tfsvh69-blip/Nav2_car/README.md

# carcar 四轮麦克纳姆导航巡检小车

ROS 2 Humble / Ubuntu 22.04项目。当前使用小泽WiFi覆盖内的平板随行建图：开机自动登录后网页待命，平板新建/续建、摇杆遥控、成对保存和结束任务；RGB为可选辅助，地图使用激光＋纯轮式里程计。相机到平板短时通路已有现场确认；新流程触控、真实场地建图、停车距离、重启自启及完整深度导航仍待验收。

长期目标是单层巡检：导航时固定相机角度，停车后俯仰拍RGB、本地保存并排队上传。第一版不做门状态或危险识别；[巡检应用](src/carcar_inspection/README.md)已新增网页点位示教、固定单角度采集、车端任务与最终停车代码，APP-001-R1先离线验证、默认配置模式，尚未实机验收，云端协议与上传程序待实现。

## 当前入口

| 入口 | 唯一职责 |
|---|---|
| [文档索引](docs/文档索引.md) | 当前与历史入口 |
| [项目现状与路线](docs/项目现状与路线.md) | 最新架构、开发阶段、关键决策与下一步 |
| [操作手册](docs/操作手册.md) | 有效构建、启动、观察、停止和恢复；历史专题保留编号索引 |
| [硬件台账](docs/硬件台账.md) | 实物、接线、尺度/标定与待确认事实 |
| [测试记录](docs/测试记录.md) | 当前结论与稳定编号、历史原始证据链接 |
| [工业级优化建议与学习路线](docs/工业级优化建议与学习路线.md) | 长期取舍与学习验收 |
| [归档索引](docs/archive/README.md) | 历史专题、失败过程、停用草稿与整理原文 |

平板建图使用[手册33节](docs/操作手册.md#33-平板随行建图nav-017)，深度/STVL使用[31节](docs/操作手册.md#31-stvl-深度导航主线nav-016)，主机RViz使用[19节](docs/操作手册.md#19-ubuntu-主机-rviz-联调)。完整命令不在README重复维护。

网页巡检与分步舵机确认使用[手册35节](docs/操作手册.md#35-网页巡检与逐步舵机示教app-001-r1)，独立端口8081，不替换8080建图入口。默认不启动或控制硬件；软件测试和现场结果分别登记。

## 维护

[项目清理技能](.agents/skills/project-cleanup/SKILL.md)默认先检查点和报告，再按已批准范围小批整理。2026-10-14[执行结果](docs/archive/2026-10-14-瘦身执行结果.md)记录前后指标与测试。现有功能、底层资产、地图/参数/标定和原始实验日志保留；瘦身批次没有自动提交或修改系统配置。平板用户服务变更另行登记。

系统级Ubuntu/Jetson变更登记桌面`/home/jetson/Desktop/系统配置维护记录.md`；瘦身阶段只整理项目文档与小缓存，后续平板用户服务独立登记。原README内容保留于[整理原文](docs/archive/项目README原文_20261014.md)。
