tfsvh69-blip/Nav2_car/docs/操作手册.md

# 操作手册

最后更新：2026-10-14。当前优先使用[第33节：小泽WiFi平板建图](#33-平板随行建图nav-017)。机器/地址以现场读回为准；无新移动或停车验收结论。

当前完整流程：19节主机RViz、31节有效STVL、33节平板建图、34节维护。其余底层/旧实验专题保留原编号入口，完整命令和安全条件迁入[操作专题归档](archive/操作专题原文_20261014.md)，不要把历史候选当当前默认。测试结果只见[测试记录](测试记录.md)。

## 1. 四路编码器 A/B 对调后的连续键盘控制（MOTOR-015）

完整专题与安全/停止步骤：[归档原文](archive/操作专题原文_20261014.md#1-四路编码器-ab-对调后的连续键盘控制motor-015)。原测试资产和参数保留；是否适用当前实车以路线和台账为准。

## 2. D435 低负载预览

完整专题与安全/停止步骤：[归档原文](archive/操作专题原文_20261014.md#2-d435-低负载预览)。原测试资产和参数保留；是否适用当前实车以路线和台账为准。

## 3. 整车模型离线检查

完整专题与安全/停止步骤：[归档原文](archive/操作专题原文_20261014.md#3-整车模型离线检查)。原测试资产和参数保留；是否适用当前实车以路线和台账为准。

## 4. 雷达

完整专题与安全/停止步骤：[归档原文](archive/操作专题原文_20261014.md#4-雷达)。原测试资产和参数保留；是否适用当前实车以路线和台账为准。

## 5. IMU 静止与人工旋转检查（IMU-001/IMU-002）

完整专题与安全/停止步骤：[归档原文](archive/操作专题原文_20261014.md#5-imu-静止与人工旋转检查imu-001imu-002)。原测试资产和参数保留；是否适用当前实车以路线和台账为准。

## 6. SLAM Toolbox 建图链路冒烟验证（NAV-001）

完整专题与安全/停止步骤：[归档原文](archive/操作专题原文_20261014.md#6-slam-toolbox-建图链路冒烟验证nav-001)。原测试资产和参数保留；是否适用当前实车以路线和台账为准。

## 7. 低速受控运动建图、回访一致性与地图保存验证（NAV-002）

完整专题与安全/停止步骤：[归档原文](archive/操作专题原文_20261014.md#7-低速受控运动建图回访一致性与地图保存验证nav-002)。原测试资产和参数保留；是否适用当前实车以路线和台账为准。

## 8. 静态地图定位与低速单点导航（NAV-003）

完整专题与安全/停止步骤：[归档原文](archive/操作专题原文_20261014.md#8-静态地图定位与低速单点导航nav-003)。原测试资产和参数保留；是否适用当前实车以路线和台账为准。

## 9. NAV-004：扩大建图与新地图重载

完整专题与安全/停止步骤：[归档原文](archive/操作专题原文_20261014.md#9-nav-004扩大建图与新地图重载)。原测试资产和参数保留；是否适用当前实车以路线和台账为准。

## 10. NAV-005：全局膨胀对照与雷达错位诊断

完整专题与安全/停止步骤：[归档原文](archive/操作专题原文_20261014.md#10-nav-005全局膨胀对照与雷达错位诊断)。原测试资产和参数保留；是否适用当前实车以路线和台账为准。

## 11. NAV-006：Groot BT 日志桥接与状态观察

完整专题与安全/停止步骤：[归档原文](archive/操作专题原文_20261014.md#11-nav-006groot-bt-日志桥接与状态观察)。原测试资产和参数保留；是否适用当前实车以路线和台账为准。

## 12. NAV-007/NAV-010/NAV-011：实验定位恢复、垃圾桶绕障与终端状态会话录包

完整专题与安全/停止步骤：[归档原文](archive/操作专题原文_20261014.md#12-nav-007nav-010nav-011实验定位恢复垃圾桶绕障与终端状态会话录包)。原测试资产和参数保留；是否适用当前实车以路线和台账为准。

## 13. 导航受阻目标排查与提取命令 (NAV-008 / NAV-011 诊断工具)

完整专题与安全/停止步骤：[归档原文](archive/操作专题原文_20261014.md#13-导航受阻目标排查与提取命令-nav-008--nav-011-诊断工具)。原测试资产和参数保留；是否适用当前实车以路线和台账为准。

## 14. NAV-012：墙角绕行、进展停滞识别与有序脱困实验 (套餐 B + 进阶恢复)

完整专题与安全/停止步骤：[归档原文](archive/操作专题原文_20261014.md#14-nav-012墙角绕行进展停滞识别与有序脱困实验-套餐-b--进阶恢复)。原测试资产和参数保留；是否适用当前实车以路线和台账为准。

## 15. Rosmaster 板载声光指示器测试（DRV-004）

完整专题与安全/停止步骤：[归档原文](archive/操作专题原文_20261014.md#15-rosmaster-板载声光指示器测试drv-004)。原测试资产和参数保留；是否适用当前实车以路线和台账为准。

## 16. 导航状态观测与多维停车阻断归因诊断（NAV-013）

完整专题与安全/停止步骤：[归档原文](archive/操作专题原文_20261014.md#16-导航状态观测与多维停车阻断归因诊断nav-013)。原测试资产和参数保留；是否适用当前实车以路线和台账为准。

## 17. 导航声光提示与停车原因诊断系统（NAV-014）

完整专题与安全/停止步骤：[归档原文](archive/操作专题原文_20261014.md#17-导航声光提示与停车原因诊断系统nav-014)。原测试资产和参数保留；是否适用当前实车以路线和台账为准。

## 18. NAV-012 回调、恢复监督与速度联锁修复

完整专题与安全/停止步骤：[归档原文](archive/操作专题原文_20261014.md#18-nav-012-回调恢复监督与速度联锁修复)。原测试资产和参数保留；是否适用当前实车以路线和台账为准。

## 19. Ubuntu 主机 RViz 联调

用途：车上继续跑底盘、雷达、定位和导航；Ubuntu 22.04 电脑只显示地图并点初始位姿/目标。不改固件、不改串口、不在 Jetson 上启动 `rviz2`。V2.0 是主机改为 Ubuntu 开发之前的最后一次快照；此后按本节联调。

RViz 配置可依据当前话题、QoS、性能和诊断需求直接优化，无需在每次修改前逐项征求确认；每次交付必须列出实际显示组件、话题、`Fixed Frame`、QoS 和关键视觉参数，便于现场核对。项目内 `navigation_lite.rviz` 是当前配置真源，Hao 的 `~/navigation_lite.rviz` 是同步副本。

### 19.0 两台机器与终端分工（2026-10-07 当前台式机已核对）

2026-10-07：用户确认有两台电脑，笔记本hao@bao在公司，当前使用台式机luhao@Hao；本地输出确认hostname=Hao、wlp4s0f0=192.168.5.17/24。此前bao地址192.168.5.36不可达不代表台式机不可用；旧文档将Hao标为Windows/历史入口的说法不适用于当前现场。切换电脑或DHCP变化时，以下在眼前Ubuntu电脑本地终端执行，不先SSH；只查看机器名和IPv4地址，不修改网络或小车硬件。预期看到当前主机名及局域网地址，忽略lo及Docker网桥；多地址时保留完整输出供核对。命令立即退出，异常Ctrl+C，无需回滚。

```bash
cd "$HOME"
hostname
ip -4 -br address
```

Cursor的项目工作区和车上节点在 **Jetson**，用户当前坐在台式机 **Hao** 前面。不要把Hao本机终端当成已经登录上车。

| 角色 | 用户 / 主机名 | 当前地址 | 日常干什么 |
|---|---|---|---|
| 车 | `jetson@xiaozhu` | `192.168.5.11` | 底盘、雷达、定位、导航；不要开 `rviz2` |
| 当前联调台式机 | `luhao@Hao` | `192.168.5.17/24`（2026-10-07本地读取） | 当前Ubuntu开发/RViz主机，DHCP变化时重新核对 |
| 笔记本（本轮不在现场） | `hao@bao` | 历史 `192.168.5.36`，当前未核对 | 用户确认在公司，不使用旧地址推断当前显示状态 |
| 图形会话 | `Hao` 本地X11桌面 | 本轮读到 `DISPLAY=:1`、`XAUTHORITY=/run/user/1000/gdm/Xauthority` | RViz在用户已登录桌面运行，不在Jetson启动；不要沿用bao的:0 |
| 车上→当前电脑 | 本轮免密SSH已连通 | `ssh -i /home/jetson/.ssh/id_ed25519 luhao@192.168.5.17` | 只读核对hostname/IP/RViz，旧渲染结论不代表当前状态 |

Hao 本机要跑车上节点时，每个窗口先：

```bash
ssh jetson@192.168.5.11
```

登录后再 `cd /home/jetson/luhao/my_nav_carcar` 并按第 12.4 / 18.3 节启动。RViz 窗口**不要** SSH。

| Hao 本机窗口 | 先做什么 | 再跑什么 |
|---|---|---|
| 1～5 | `ssh jetson@192.168.5.11` | 第 12.4 节终端 1～5（底盘、雷达、实验定位、实验导航、诊断） |
| 6 | 不要 SSH | [第 19.4 节](#194-电脑上确认连通并打开轻量-rviz) 本机轻量 RViz |

### 19.1 必须对齐的环境

| 项目 | 车上现在的值 | 电脑上也要一样 |
|---|---|---|
| 系统 | Ubuntu 22.04 | Ubuntu 22.04 |
| ROS | Humble | Humble |
| Wi‑Fi | `小泽` | 同一 Wi‑Fi，不要用手机热点另一张网 |
| 地址 | `192.168.5.11`（`xiaozhu`） | `192.168.5.36`（`bao`，以当时 `ip a` 为准） |
| ROS 域 | `ROS_DOMAIN_ID=31` | `export ROS_DOMAIN_ID=31` |
| 本机隔离 | `ROS_LOCALHOST_ONLY=0` | 同样设为 0，或干脆不设 |
| DDS | 默认 Fast DDS | 先不要改 `RMW_IMPLEMENTATION` |

车上 `~/.bashrc` 已写入域号 31 和 `ROS_LOCALHOST_ONLY=0`，无需再改系统服务。电脑每个新终端先：

```bash
source /opt/ros/humble/setup.bash
export ROS_DOMAIN_ID=31
export ROS_LOCALHOST_ONLY=0
```

可写进电脑的 `~/.bashrc`，避免忘。域号不一致时，`ros2 topic list` 是空的。

### 19.2 电脑上最少安装

不要一上来克隆整车工程。先装桌面版 Humble 和 RViz：

```bash
sudo apt update
sudo apt install ros-humble-desktop ros-humble-rviz2 ros-humble-nav2-msgs
```

`ros-humble-desktop` 已含 RViz、常用消息和 TF。点目标和看地图够用。

若 `apt` 提示锁被 `unattended-upgr` 占用，等它自己结束后再装。不要删 `/var/lib/dpkg/lock-frontend`，也不要 `kill -9`。车上代理没有 Hao 的 sudo，装包由 Hao 本机执行。

### 19.3 车上怎么开（不要再起 RViz）

底盘、雷达、实验导航仍按[第 12.3～12.4 节](archive/操作专题原文_20261014.md#123-实车启动前安全检查)和[第 18.3 节](archive/操作专题原文_20261014.md#183-启动与只读观察)。定位必须显式关闭板上 RViz：

```bash
cd /home/jetson/luhao/my_nav_carcar
source /opt/ros/humble/setup.bash && source install/setup.bash
export ROS_DOMAIN_ID=31
export ROS_LOCALHOST_ONLY=0
ros2 launch carcar_navigation localization_experimental.launch.xml \
  map:=$(pwd)/src/carcar_navigation/maps/nav004_20260914_093032.yaml \
  use_rviz:=false
```

Jetson 上不要再开 `rviz2`，也不要用 VNC 看三维窗口。声光、倒车、联锁仍在车上；终端 4 的一行中文摘要仍可在车上或 SSH 里看。

### 19.4 电脑上确认连通并打开轻量 RViz

电脑和车都上电、导航起来后，Hao 上先写 Fast DDS 单播发现（Wi‑Fi 组播对 Nav2 多进程经常只发现到一部分节点）。地址按当时 `ip a` 改；车上仍是 `192.168.5.11`，域 31 对应端口 `15150`：

```bash
cat > ~/fastdds_wifi.xml << 'EOF'
<?xml version="1.0" encoding="UTF-8" ?>
<profiles xmlns="http://www.eprosima.com/XMLSchemas/fastRTPS_Profiles">
  <participant profile_name="wifi_peer" is_default_profile="true">
    <rtps>
      <builtin>
        <initialPeersList>
          <locator>
            <udpv4>
              <address>192.168.5.11</address>
              <port>15150</port>
            </udpv4>
          </locator>
        </initialPeersList>
      </builtin>
    </rtps>
  </participant>
</profiles>
EOF
```

同一台电脑只开一个 `rviz2`。若已经有窗口，先关掉再开。旧的 `ros2` 守护进程会缓存半截图，开之前停掉：

```bash
source /opt/ros/humble/setup.bash
export ROS_DOMAIN_ID=31
export ROS_LOCALHOST_ONLY=0
export FASTRTPS_DEFAULT_PROFILES_FILE=$HOME/fastdds_wifi.xml
ros2 daemon stop
ros2 topic info /map -v
```

这里要看 **Publisher count 是否为 1**（`map_server`）。只看 `ros2 topic list` 不够：本机 RViz 订阅 `/map` 后，列表里也会出现这个名字。再：

```bash
ros2 topic echo /localization_monitor/ready --qos-durability transient_local --once
```

`data: true` 后再点目标。未给 **2D Pose Estimate** 时这里是 `false`，属正常。

首次使用或车模文件缺失时，把轻量配置和车模实体文件拷到电脑。以下命令在 Hao 本机执行，读取 Jetson 工作区并写入 Hao 的 `~/navigation_lite.rviz` 和 `~/ros_overlay/carcar_description/`，不改车上文件、不启动硬件；再次执行会用车上同名文件更新本地副本。异常可按 Ctrl+C 停止，删除这两个本地副本即可恢复到执行前无覆盖的状态：

```bash
mkdir -p ~/ros_overlay/carcar_description
scp jetson@192.168.5.11:/home/jetson/luhao/my_nav_carcar/src/carcar_navigation/rviz/navigation_lite.rviz ~/navigation_lite.rviz
rsync -aL jetson@192.168.5.11:/home/jetson/luhao/my_nav_carcar/install/carcar_description/ ~/ros_overlay/carcar_description/
find ~/ros_overlay/carcar_description/share/carcar_description/meshes -type f -name '*.stl'
```

当前构建产物实测有 10 个 STL，其中包含 `mecanum_wheel_left.stl` 和 `mecanum_wheel_right.stl`；没有列出时不要启动 RViz，先检查复制错误。然后在同一 Hao 本机终端启动 RViz：

```bash
source /opt/ros/humble/setup.bash
export AMENT_PREFIX_PATH=$HOME/ros_overlay/carcar_description:/opt/ros/humble
export FASTRTPS_DEFAULT_PROFILES_FILE=$HOME/fastdds_wifi.xml
export ROS_DOMAIN_ID=31
export ROS_LOCALHOST_ONLY=0
export QT_QPA_PLATFORM=xcb
rviz2 -d ~/navigation_lite.rviz
```

Fixed Frame 为 `map`。预置显示：Grid、Map（`/map`，Reliable + Transient Local）、Global/Local Costmap（Reliable + Transient Local）、LaserScan（`/scan`，Best Effort）、AMCL Pose（Reliable）、Odometry（`/wheel/odometry`，Best Effort）、Global/Local Plan（Reliable）、Footprint、RobotModel（`/robot_description`，Reliable + Transient Local）、精简 TF（不展开全部连杆）。全局路径 `/plan` 使用青色 Billboard、宽 0.04 m；局部路径 `/local_plan` 使用亮黄色 Billboard、宽 0.07 m、`Z=0.08 m`，并只保留最新轨迹。帧率保持 15。车模网格在 Hao 上还需本机有 `carcar_description`（可把车上 `install/carcar_description` 拷到 `~/ros_overlay/carcar_description` 并加入 `AMENT_PREFIX_PATH`）。用 **2D Pose Estimate**（`/initialpose`）和 **2D Goal Pose**（`/goal_pose`）。不要改用完整 `navigation.rviz`。

2026-09-30 当前 `hao@bao` 已用硬件 OpenGL 4.6 短时打开 RViz，无需强制 Mesa 软件渲染；真实 OccupancyGrid 着色仍待实际地图画面确认。2026-09-18 旧 `luhao@Hao` 上的 `llvmpipe` 曾能收到 `259×230` 的 `/map`，但 `indexed_8bit_image` 链接失败，Map / Costmap 橙灯、主视图只剩格子；这是旧电脑的历史显示问题，不能据此判断新电脑地图为空。若新电脑出现相同着色错误，先查话题发布者与消息，再单独处理显卡显示。

### 19.5 若电脑上看不到话题

按这个顺序查：

1. 电脑 `ip a` 是否也是 `192.168.5.x`，能否 `ping 192.168.5.11`
2. 两边 `echo $ROS_DOMAIN_ID` 都是 `31`
3. Hao 是否已加载 `FASTRTPS_DEFAULT_PROFILES_FILE=$HOME/fastdds_wifi.xml`，且 XML 里车上地址、端口与第 19.4 节一致
4. 暂时关掉两边防火墙：`sudo ufw disable`（通了再按需打开）
5. 电脑不要开 VPN
6. 车上 `ros2 node list` 里应有 `/amcl`、`/bt_navigator`，且 **只有一个** `/rviz`；Hao 上 `ps -C rviz2` 只能有一行
7. Map 橙灯且日志有 `GLSL link result`：先核对地图话题有发布者和消息，再按第 19.4 节检查渲染；不能仅凭橙灯判断地图为空

`ros2 topic info /map -v` 的 Publisher count 仍为 0 时，把电脑 IP、该命令输出和 `ps -C rviz2` 发回即可。

### 19.6 远程桌面还能否连车上 GNOME

可以。车上 `x11vnc.service` 仍在监听 `192.168.5.11:5901`，开机自启，密码见桌面文档 [`/home/jetson/Desktop/系统配置维护记录.md`](file:///home/jetson/Desktop/系统配置维护记录.md)。电脑换成 Ubuntu 22.04 后：

```bash
sudo apt install tigervnc-viewer
xtigervncviewer 192.168.5.11:5901
```

或打开自带的 Remmina，协议选 VNC，服务器填 `192.168.5.11:5901`。这只用来看板上桌面、终端或紧急操作。日常点目标用本节的本机轻量 RViz，不要经 VNC 画三维窗口。

### 19.7 旧 `luhao@Hao` 的软件渲染记录（历史，不作当前入口）

以下命令仅记录 2026-09-18 旧 `luhao@Hao` 的实际操作；该地址当前不是 `hao@bao`，不要在新电脑上执行本节旧的远程打开命令。新电脑的静止深度画面用第 19.11 节，常规轻量 RViz 用第 19.4 节。旧机曾因 NVIDIA 内核与用户态不一致而需 Mesa `llvmpipe`，且 OccupancyGrid 着色失败；新电脑已用硬件 OpenGL 4.6 短时打开 RViz，真实栅格着色待现场验证。

从车上检查 Hao 是否能看见车上的地图发布者：

```bash
ssh -o BatchMode=yes -i /home/jetson/.ssh/id_ed25519 luhao@192.168.5.17 \
  'source /opt/ros/humble/setup.bash
   export ROS_DOMAIN_ID=31 ROS_LOCALHOST_ONLY=0
   export FASTRTPS_DEFAULT_PROFILES_FILE=$HOME/fastdds_wifi.xml
   ros2 daemon stop >/dev/null
   ros2 topic info /map -v'
```

Publisher count 应为 1。从车上在 Hao 桌面用软件渲染打开轻量 RViz（会占用 Hao 屏幕；先杀掉旧窗口，只留一个）：

```bash
ssh -o BatchMode=yes -i /home/jetson/.ssh/id_ed25519 luhao@192.168.5.17 \
  'export DISPLAY=:1 XAUTHORITY=/run/user/1000/gdm/Xauthority
   source /opt/ros/humble/setup.bash
   export AMENT_PREFIX_PATH=$HOME/ros_overlay/carcar_description:/opt/ros/humble
   export FASTRTPS_DEFAULT_PROFILES_FILE=$HOME/fastdds_wifi.xml
   export ROS_DOMAIN_ID=31 ROS_LOCALHOST_ONLY=0
   export QT_QPA_PLATFORM=xcb __GLX_VENDOR_LIBRARY_NAME=mesa
   export LIBGL_ALWAYS_SOFTWARE=1 GALLIUM_DRIVER=llvmpipe
   killall -q rviz2 || true
   sleep 1
   nohup rviz2 -d $HOME/navigation_lite.rviz >/tmp/rviz2_lite.log 2>&1 &
   disown'
```

覆盖目录缺失时统一按[第 19.4 节](#194-电脑上确认连通并打开轻量-rviz)从 Hao 本机复制，避免维护第二套复制命令。Hao 本机自己开 RViz 仍用第 19.4 节那组环境变量。重启 Hao 后若 `glxinfo -B` 已是 NVIDIA，可去掉 `LIBGL_*` 四行再试。

### 19.8 日常六终端开发与导航复测（2026-09-20 实测入口）

这是后续开发本车的固定入口：Hao 的 1～5 号终端分别 SSH 到 Jetson，运行底盘、雷达、实验定位、实验导航和只读诊断；6 号终端留在 Hao 本机运行轻量 RViz。2026-09-20 用户现场确认，这套跨机启动、DDS 通信和实体车模加载流程可以完整走通。该结论只确认开发环境与启动链路，不代表 NAV-012-R6 突发障碍绕行已经实车通过。

终端 1 会打开控制板串口，终端 2 会启动雷达电机，终端 4 收到目标后会驱动车轮。开始前清空车周围区域，保持 12 V 电机开关可立即触及；异常运动先断开 12 V，再停止终端。所有 Launch 正常停止均使用一次 `Ctrl+C`，不要直接关闭 SSH 窗口。

#### 19.8.0 代码更新后的构建（仅在代码发生变化时）

用途：在启动硬件前编译当前导航、底盘和 Bringup，并运行导航 C++ 回归。它只写 Jetson 工作区的 `build/`、`install/`、`log/`，不打开串口、不启动雷达和电机。执行前先正常停止旧导航和底盘；异常按 `Ctrl+C`，保留输出排查，构建或测试失败时不要进入实车启动。

先在 Hao 任意终端登录 Jetson：

```bash
ssh jetson@192.168.5.11
```

确认提示符变为 `jetson@xiaozhu` 后执行：

```bash
cd /home/jetson/luhao/my_nav_carcar
conda deactivate 2>/dev/null || true
source /opt/ros/humble/setup.bash
CMAKE_BUILD_PARALLEL_LEVEL=2 colcon build --symlink-install \
  --packages-select carcar_description carcar_navigation carcar_bt_monitor carcar_base carcar_bringup \
  --executor sequential
source install/setup.bash
ROS_DOMAIN_ID=211 ROS_LOCALHOST_ONLY=1 colcon test \
  --packages-select carcar_description carcar_navigation carcar_bt_monitor \
  --executor sequential --event-handlers console_direct+
colcon test-result --test-result-base build/carcar_navigation --verbose
colcon test-result --test-result-base build/carcar_description --verbose
```

预期所有包构建成功且测试无失败。测试域 211 仅作用于该条命令，不用于实车。

#### 19.8.1 第 1～5 号终端共同的 SSH 步骤

Hao 的第 1～5 号终端都先分别执行下面一行，等待登录完成后再复制各自章节的车上命令：

```bash
ssh jetson@192.168.5.11
```

每个终端都必须看到 `jetson@xiaozhu`，不能在 `luhao@Hao` 提示符下执行车上 Launch。第 6 号终端禁止 SSH。

#### 19.8.2 终端 1：底盘、轮式里程计和模型 TF

用途：确认控制板串口存在且未被旧驱动占用，然后打开真实底盘串口并发布启动零速度、轮式里程计、整车描述和 TF。它会连接电机控制板；异常运动先断 12 V，再按 `Ctrl+C`。预期无串口占用错误，静止时速度为零。

```bash
cd /home/jetson/luhao/my_nav_carcar
conda deactivate 2>/dev/null || true
source /opt/ros/humble/setup.bash
source install/setup.bash
export ROS_DOMAIN_ID=31
export ROS_LOCALHOST_ONLY=0
test -e /dev/myserial || { echo '控制板串口不存在，停止启动'; exit 1; }
if fuser /dev/myserial >/dev/null 2>&1; then
  echo '控制板串口已被其他进程占用，停止启动'
  fuser -v /dev/myserial
  exit 1
fi
ros2 launch carcar_bringup robot.launch.xml
```

#### 19.8.3 终端 2：RPLIDAR A1

用途：打开雷达串口、启动雷达电机并发布 `/scan`，不主动驱动车轮。确认终端 1 正常后执行；预期雷达持续旋转且没有串口反复重连，停止使用 `Ctrl+C`。

```bash
cd /home/jetson/luhao/my_nav_carcar
conda deactivate 2>/dev/null || true
source /opt/ros/humble/setup.bash
source install/setup.bash
export ROS_DOMAIN_ID=31
export ROS_LOCALHOST_ONLY=0
ros2 launch carcar_lidar lidar.launch.xml
```

#### 19.8.4 终端 3：实验定位

用途：加载当前地图、AMCL 和只读定位健康门控，不在 Jetson 打开 RViz。未在 Hao RViz 给出初始位姿时 `/localization_monitor/ready=false` 属正常；停止使用 `Ctrl+C`。

```bash
cd /home/jetson/luhao/my_nav_carcar
conda deactivate 2>/dev/null || true
source /opt/ros/humble/setup.bash
source install/setup.bash
export ROS_DOMAIN_ID=31
export ROS_LOCALHOST_ONLY=0
ros2 launch carcar_navigation localization_experimental.launch.xml \
  map:=/home/jetson/luhao/my_nav_carcar/src/carcar_navigation/maps/nav004_20260914_093032.yaml \
  use_rviz:=false
```

#### 19.8.5 终端 4：实验导航、联锁和会话记录

用途：启动 Smac 2D、DWB、恢复监督、最终速度联锁和导航日志。当前实验上限为 `0.30 m/s`，前进预测 1.7 s；旧任务失败后，新目标会先确认旧动作结束、车辆停稳和输入健康，再获得新的有限恢复额度。发送目标后会真实驱动车轮；必须在空旷区域操作，异常运动先断 12 V。专项复测开启持续原始录包，每 1 GiB 分卷，磁盘低于 2 GiB 时只停止录包；日常不需还原路径几何时可把最后一项改为 `false`。

```bash
cd /home/jetson/luhao/my_nav_carcar
conda deactivate 2>/dev/null || true
source /opt/ros/humble/setup.bash
source install/setup.bash
export ROS_DOMAIN_ID=31
export ROS_LOCALHOST_ONLY=0
ros2 launch carcar_navigation navigation_experimental.launch.xml \
  record_raw_bag:=true
```

预期联锁初始保持关闭、最终速度为零，并显示会话日志和原始 rosbag 正在记录。完成终端 5 和 RViz 检查前不要发送目标。

#### 19.8.6 终端 5：只读链路与恢复诊断

用途：只读检查生命周期、雷达、轮式里程计、定位门控、最终速度发布者和当前会话配置，然后持续观察恢复事件；不会发布运动指令。`ros2 topic echo` 按 `Ctrl+C` 只会停止观察，不会停止导航。

```bash
cd /home/jetson/luhao/my_nav_carcar
conda deactivate 2>/dev/null || true
source /opt/ros/humble/setup.bash
source install/setup.bash
export ROS_DOMAIN_ID=31
export ROS_LOCALHOST_ONLY=0
ros2 run carcar_navigation check_nav_link
CARCAR_LATEST_SESSION=$(find log/nav_sessions -mindepth 1 -maxdepth 1 -type d | sort | tail -1)
echo "$CARCAR_LATEST_SESSION"
grep -nE 'SmacPlanner2D|max_observe_replans' "$CARCAR_LATEST_SESSION/active_config.yaml"
ros2 param get /rosmaster_base max_linear_x
ros2 param get /controller_server FollowPath.max_vel_x
ros2 param get /controller_server FollowPath.sim_time
ros2 param get /velocity_smoother max_velocity
ros2 topic info /cmd_vel --verbose
ros2 topic echo /recovery/status
```

预期配置包含 `nav2_smac_planner/SmacPlanner2D` 和 `recovery.max_observe_replans: 1`；未加底盘速度覆盖时，四项参数查询依次得到 `0.18`、`0.30`、`1.7` 和含 `0.30` 的数组；实际前进速度受底盘 `0.18 m/s` 限制；`/cmd_vel` 只有 `navigation_motion_gate` 一个发布者。用 Hao RViz 给出初始位姿后，先按 `Ctrl+C` 停止 echo，再重新执行 `ros2 run carcar_navigation check_nav_link`；只有 `/localization_monitor/ready=TRUE` 才能发送目标。

#### 19.8.7 终端 6：Hao 本机轻量 RViz

本终端始终保留在 `luhao@Hao`，不要 SSH。车模首次使用、模型更新或 `ros2 pkg prefix carcar_description` 报 `Package not found` 时，先执行下面的同步命令。它读取 Jetson 安装目录，写入 Hao 用户目录，不改车上文件、不启动硬件；中途可按 `Ctrl+C`，重新执行即可恢复完整副本。

```bash
mkdir -p /home/luhao/ros_overlay/carcar_description
scp jetson@192.168.5.11:/home/jetson/luhao/my_nav_carcar/src/carcar_navigation/rviz/navigation_lite.rviz \
  /home/luhao/navigation_lite.rviz
rsync -aL --info=progress2 \
  jetson@192.168.5.11:/home/jetson/luhao/my_nav_carcar/install/carcar_description/ \
  /home/luhao/ros_overlay/carcar_description/
find /home/luhao/ros_overlay/carcar_description/share/carcar_description/meshes \
  -type f -name '*.stl'
```

预期列出实体 STL，包含左右麦克纳姆轮、新相机支架和两件舵机固定脚；不再以旧模型的 7 个文件作为验收数量。日常启动 RViz 执行：

```bash
source /opt/ros/humble/setup.bash
export AMENT_PREFIX_PATH=/home/luhao/ros_overlay/carcar_description:/opt/ros/humble
export FASTRTPS_DEFAULT_PROFILES_FILE=/home/luhao/fastdds_wifi.xml
export ROS_DOMAIN_ID=31
export ROS_LOCALHOST_ONLY=0
export QT_QPA_PLATFORM=xcb
export __GLX_VENDOR_LIBRARY_NAME=mesa
export LIBGL_ALWAYS_SOFTWARE=1
export GALLIUM_DRIVER=llvmpipe
ros2 daemon stop
ros2 pkg prefix carcar_description
ros2 topic info /map -v
rviz2 -d /home/luhao/navigation_lite.rviz
```

模型包前缀应为 `/home/luhao/ros_overlay/carcar_description`，`/map` 的 Publisher count 应为 1。刚停止 daemon 后若短暂出现 `Unknown topic '/map'`，等待发现完成再检查；RViz 后来收到 `259×230` 地图也可证明跨机通信已建立。配置文件名必须是 `navigation_lite.rviz`，不能写成 `navigation_lite.rvizion`。Hao 当前使用 llvmpipe 时，`indexed_8bit_image` 报错属于已知栅格着色问题；它与 `Package [carcar_description] does not exist` 是两个独立故障，后者必须通过实体覆盖目录解决。

RViz 打开后先用 **2D Pose Estimate** 给出真实位置和车头方向，等终端 5 确认定位门控为 TRUE，再用 **2D Goal Pose**。实车突发障碍复测使用能达到雷达扫描平面的纸箱，从侧面在车前约 0.8～1.0 m 放入；人员和手不得进入车道。

轻量配置中的 Global Plan 为青色 `0.04 m` Billboard；Local Plan 为亮黄色 `0.07 m` Billboard，并抬高 `0.08 m` 避免被车模和地图遮住。`/local_plan` 保持 Reliable、Volatile、Depth 1，只显示最新局部轨迹。正常行驶时 1.7 s 预测在 `0.30 m/s` 上限下最长约 0.51 m；低速、停车和原地旋转时自然更短。

#### 19.8.8 正常停止和异常恢复

正常停止：不再发送目标并确认车辆停住；终端 4 `Ctrl+C` 停导航和速度联锁，终端 3 停定位，终端 2 停雷达，终端 1 最后停底盘；终端 5 停只读 echo，终端 6 关闭 RViz。异常运动：先物理断开 12 V 电机电源，再停止终端 4，最后依次停止其余终端。SSH 意外断开时底盘既有 0.30 秒命令看门狗应停车，但不能用它代替物理急停。

### 19.9 Hao 到 Jetson 的专用免密 SSH

用途：让 Hao 的新终端通过别名 `jetson` 或地址 `192.168.5.11` 直接登录车上。下面只读写两端用户目录中的 `~/.ssh/config`、专用 Ed25519 密钥和 `authorized_keys`，不保存登录密码，不修改 `/etc/ssh/` 或 SSH 服务，也不启动硬件。首次备份车上密钥清单和送入公钥时会在终端交互询问现有密码；输入内容不回显。中途异常可按 `Ctrl+C`，按末尾回滚步骤恢复备份。

**当前状态（2026-09-30）**：新电脑 `hao@bao` 已完成安装。`~/.ssh/config` 使用专用 `/home/hao/.ssh/id_ed25519_jetson`，并设置 `IdentitiesOnly yes`；Jetson 的 `authorized_keys.bao_20260930.backup` 保留了安装前完整内容。`ssh -o BatchMode=yes jetson` 与 `ssh -o BatchMode=yes 192.168.5.11` 都已返回 `jetson@xiaozhu`，没有密码交互。反向 `jetson → hao@bao` 的密钥登录也已实测。日常只需在 `bao` 新终端执行 `ssh jetson`，不需要重复运行下面的首次安装命令。旧 `luhao@Hao` 的授权键保留。

首次安装在 Hao 本机执行：

```bash
set -e
umask 077
mkdir -p /home/hao/.ssh
test -e /home/hao/.ssh/config.backup || \
  cp -p /home/hao/.ssh/config /home/hao/.ssh/config.backup
test -e /home/hao/.ssh/id_ed25519_jetson || \
  ssh-keygen -t ed25519 -N '' \
    -C 'hao@bao to jetson@xiaozhu' \
    -f /home/hao/.ssh/id_ed25519_jetson
ssh jetson@192.168.5.11 \
  'umask 077; mkdir -p ~/.ssh; test -e ~/.ssh/authorized_keys.bao_20260930.backup || cp -p ~/.ssh/authorized_keys ~/.ssh/authorized_keys.bao_20260930.backup'
ssh-copy-id -i /home/hao/.ssh/id_ed25519_jetson.pub jetson@192.168.5.11
awk '
  /^Host[[:space:]]/ {
    skip=($0=="Host jetson" || $0=="Host jetson 192.168.5.11")
  }
  !skip {print}
' /home/hao/.ssh/config > /home/hao/.ssh/config.new
cat >> /home/hao/.ssh/config.new <<'EOF'
Host jetson 192.168.5.11
    HostName 192.168.5.11
    User jetson
    IdentityFile /home/hao/.ssh/id_ed25519_jetson
    IdentitiesOnly yes
EOF
mv /home/hao/.ssh/config.new /home/hao/.ssh/config
chmod 600 /home/hao/.ssh/config /home/hao/.ssh/id_ed25519_jetson
chmod 644 /home/hao/.ssh/id_ed25519_jetson.pub
```

验证命令禁止密码交互，只读取远端用户名和主机名，不改任何文件。两行都应输出 `jetson@xiaozhu`；任何一行提示 `Permission denied` 都表示免密配置尚未成功：

```bash
ssh -o BatchMode=yes jetson 'printf "%s@%s\n" "$USER" "$(hostname)"'
ssh -o BatchMode=yes 192.168.5.11 'printf "%s@%s\n" "$USER" "$(hostname)"'
```

回滚会在同一条仍有效的 SSH 连接中恢复 Jetson 的 `authorized_keys`，随后恢复 Hao 配置并删除这把专用私钥；不会影响项目代码或硬件。若备份原本为空，回滚后 Jetson 将不再接受这把密钥，后续连接会重新要求密码：

```bash
set -e
ssh -i /home/hao/.ssh/id_ed25519_jetson jetson@192.168.5.11 \
  'cp -p ~/.ssh/authorized_keys.bao_20260930.backup ~/.ssh/authorized_keys && chmod 600 ~/.ssh/authorized_keys'
cp -p /home/hao/.ssh/config.backup /home/hao/.ssh/config
rm -f /home/hao/.ssh/id_ed25519_jetson \
  /home/hao/.ssh/id_ed25519_jetson.pub
```

### 19.10 Hao 查看 D435 静止 TF

本组只在 **Hao 本机**执行，不 SSH。先按第 19.4 节准备 `~/fastdds_wifi.xml`，并关闭旧 RViz；本轮没有地图、定位和导航，不执行该节的 `/map` 或定位就绪检查。先按第 27 节启动模型、相机与独立雷达。

下面从 Jetson 读取专用配置和已构建的车模，更新 Hao 的本地副本，不改变车上配置、不启动执行器。重复运行会覆盖同名本地副本，先备份已有专用 RViz。预期车模 STL 可列出；复制失败 Ctrl+C，保留本地备份，先解决网络或路径问题。IP 变更时按第 19.0 节核对，不另改域号。

```bash
cd "$HOME"
mkdir -p ~/ros_overlay/carcar_description
if test -f ~/camera_tf_verify.rviz; then cp ~/camera_tf_verify.rviz ~/camera_tf_verify.rviz.backup; fi
scp jetson@192.168.5.11:/home/jetson/luhao/my_nav_carcar/src/carcar_camera/rviz/camera_tf_verify.rviz ~/camera_tf_verify.rviz
rsync -aL jetson@192.168.5.11:/home/jetson/luhao/my_nav_carcar/install/carcar_description/ ~/ros_overlay/carcar_description/
find ~/ros_overlay/carcar_description/share/carcar_description/meshes -type f -name '*.stl'
```

下面只设置本终端 ROS/图形环境并启动本机查看。`ros2 daemon stop` 清本机发现缓存，不停车上节点；当前 `hao@bao` 默认使用硬件 OpenGL。相机与雷达按第 27 节完整启动时，预期主画面有半透明车模、零高度网格、原始深度点云、红色激光，RGB 面板有场景；Fixed Frame 为 `base_footprint`。网络或 OpenGL 异常 Ctrl+C，按第 19.5 节排查；关闭窗口即停止显示，不控制车体。

```bash
cd "$HOME"
source /opt/ros/humble/setup.bash
export AMENT_PREFIX_PATH=$HOME/ros_overlay/carcar_description:/opt/ros/humble
export FASTRTPS_DEFAULT_PROFILES_FILE=$HOME/fastdds_wifi.xml
export ROS_DOMAIN_ID=31
export ROS_LOCALHOST_ONLY=0
export QT_QPA_PLATFORM=xcb
ros2 daemon stop
rviz2 -d ~/camera_tf_verify.rviz
```

专用配置：RobotModel `/robot_description` 为 Reliable + Transient Local；原始点云 `/camera/depth/points`、LaserScan `/scan`、Image `/camera/camera/color/image_raw` 均 Best Effort + Volatile，队列深度 1；TF 只显示车体、相机、雷达关键帧。网格格距 0.02 m，点云按转换后的 Z 高度着色（-0.05～0.35 m），帧率 10。Views 预存 `Top XY`、`Side XZ`、`Front YZ`，另保留 Select 与 Measure 工具。本配置没有导航目标工具。

### 19.11 Hao 查看静止深度 Costmap

查看此前验证的 B 候选时，先按第 30.2 节确认/启动 Jetson 深度单流，再按第 30.6 节显式启动 `depth_costmap_native_clearing_candidate.yaml`；不要用第 28 节的 A 默认参数代替。关闭 Hao 上已有 RViz 后，在当前 `hao@bao` 本机运行以下命令，不 SSH；网络配置和车模覆盖沿用第 19.10 节，新电脑默认使用硬件 OpenGL。它读取车上 RViz 配置并保存本地备份，不改车上文件或硬件；再次执行更新本地副本。复制失败 Ctrl+C，先排查网络；窗口报错关闭即可恢复，已有 TF 专用配置保留。本节用于目视确认实时显示，不替代 Costmap CSV/健康审计，也不证明已经接入真实 Nav2 `local_costmap` 或可以移动避障。

```bash
cd "$HOME"
if test -f ~/depth_costmap_static.rviz; then
  cp -p ~/depth_costmap_static.rviz ~/depth_costmap_static.rviz.backup_$(date +%Y%m%d_%H%M%S)
fi
scp jetson@192.168.5.11:/home/jetson/luhao/my_nav_carcar/src/carcar_navigation/rviz/depth_costmap_static.rviz ~/depth_costmap_static.rviz
source /opt/ros/humble/setup.bash
export AMENT_PREFIX_PATH=$HOME/ros_overlay/carcar_description:/opt/ros/humble
export FASTRTPS_DEFAULT_PROFILES_FILE=$HOME/fastdds_wifi.xml
export ROS_DOMAIN_ID=31
export ROS_LOCALHOST_ONLY=0
export QT_QPA_PLATFORM=xcb
ros2 daemon stop
rviz2 -d ~/depth_costmap_static.rviz
```

当前 `hao@bao` 已在本地 X11 用硬件 OpenGL 4.6 短时打开此配置，故本节不强制软件渲染；真实 Costmap 栅格能否着色仍需现场确认。预期出现半透明车模、蓝色深度障碍输入及黄色已标记体素；只有独立雷达已运行时才有红色 `/scan`。B 深度层应为 active，有障碍时应有黄色体素。Fixed Frame `base_footprint`；PointCloud2 障碍输入 Best Effort/Volatile、Depth 1，黄色体素 Reliable/Volatile、Depth 1，RobotModel Reliable/Transient Local。原始点云默认隐藏，体素转换仅显示已标记格，无膨胀圈。可选 Map `/costmap/costmap` Reliable/Transient Local 默认关闭；若 OccupancyGrid 着色器失败并显示橙色状态，不能凭 RViz 栅格颜色判断地图为空，应另查 Costmap 话题/审计结果。保存 Top XY、Side XZ、Front YZ 和测量工具，不带导航目标工具。

图像默认使用 `Depth Image Reference`：`/camera/camera/depth/image_rect_raw`，Best Effort/Volatile、Depth 1、raw 传输、Normalize Range 开启，显示深度距离灰度图。`RGB Scene Reference` 保留但默认关闭，话题为 `/camera/camera/color/image_raw`、相同 QoS。第 30.2 节的 `enable_color: false` 不产生 RGB，所以旧 RGB 面板的 `No Image` 不代表深度断流；不要为消除该提示直接启用曾有 UVC 异常的彩色联合流。更新配置后按本节复制并重新打开 RViz；若没有启动深度驱动，深度面板也会无图。深度图用于对照物体轮廓和无效深度区域，不能替代彩色实物辨认。

静止入口下保持车体与相机不动。关于手动转车、孤立黄点以及二维/三维判据，见第 30.4 节；在 RViz 里拖动观察视角不影响实体车体姿态。

### 19.12 当前Ubuntu主机查看低带宽地面侧视

配合第30.15节。先关闭其他RViz，车模覆盖沿用第19.10节。2026-10-07现场为台式机luhao@Hao/192.168.5.17，笔记本bao在公司；以下在当前主机本地桌面执行：读取车上专用配置、备份并更新本地同名文件，随后仅显示限流预览，不驱动硬件。预期侧视地面、半透明车模和零高度网格可见；复制失败保留备份，显示异常关闭窗口。关闭窗口或Ctrl+C只停止显示。

```bash
cd "$HOME"
if test -f ~/camera_floor_current_20261007.rviz; then
  cp -p ~/camera_floor_current_20261007.rviz ~/camera_floor_current_20261007.rviz.backup_$(date +%Y%m%d_%H%M%S)
fi
scp jetson@192.168.5.11:/home/jetson/luhao/my_nav_carcar/src/carcar_camera/rviz/camera_floor_current_20261007.rviz ~/camera_floor_current_20261007.rviz
source /opt/ros/humble/setup.bash
export AMENT_PREFIX_PATH=$HOME/ros_overlay/carcar_description:/opt/ros/humble
export FASTRTPS_DEFAULT_PROFILES_FILE=$HOME/fastdds_wifi.xml
export ROS_DOMAIN_ID=31 ROS_LOCALHOST_ONLY=0 QT_QPA_PLATFORM=xcb
rviz2 -d ~/camera_floor_current_20261007.rviz --ros-args -r __node:=camera_floor_current_rviz
```

配置使用`base_footprint`，`/camera/debug/points`为Best Effort/Volatile/队列1、Z着色、默认Side XZ，保留Top XY与Front YZ；机器人模型Reliable/Transient Local。今天的独立配置关闭了旧体素显示，原`camera_floor_check.rviz`保留；不订阅原生深度图、RGB、全量点云或地图。预览最高1 Hz、最多8000点，仅用于看方向；测量继续读取全量原始点。2026-10-07本轮无地图/原生图像/RGB/录包/构建，加入此跨机显示后完整600秒健康PASS，详见NAV-016-R2；其他显示负载另行验收。调角期间零旋转TF仅作计算参考，显示的地面斜率不能直接当成实体角度或标定结论。

### 19.13 当前台式机深度图负载单变量对照（NAV-016-R2）

仅用于定位跨机显示负载，不作为日常导航配置。先在Jetson停止独立静态地图，保持相机与过滤器不重启；关闭主机旧RViz，核对深度图和标障点云均0订阅，按30.17完成无头健康窗口并保留失败数据。只有该窗口完成后再增加本组显示订阅；不要在600秒窗口中途改变负载，构建/录包亦分开。

下面在当前台式机luhao@Hao的本地终端执行，读取Jetson专用RViz候选并保存本地副本，随后只订阅深度图；不修改系统/网络文件、不打开串口或动作接口。若同名候选已存在，先保存时间戳备份，避免覆盖旧资产。预期Image组件接收深度灰度图；必须同时由Jetson另一个终端按30.17运行相同健康窗口，图像可见不算健康通过。先做60秒复现，最终通过必须600秒；异常关闭窗口或Ctrl+C，恢复为无显示订阅，然后按原STVL配置另行验证恢复显示。

```bash
cd "$HOME"
if test -f ~/depth_image_load_candidate.rviz; then
  cp -p ~/depth_image_load_candidate.rviz ~/depth_image_load_candidate.rviz.backup_$(TZ=Asia/Shanghai date +%Y%m%d_%H%M%S)
fi
scp jetson@192.168.5.11:/home/jetson/luhao/my_nav_carcar/src/carcar_camera/rviz/depth_image_load_candidate.rviz ~/depth_image_load_candidate.rviz
source /opt/ros/humble/setup.bash
export ROS_DOMAIN_ID=31 ROS_LOCALHOST_ONLY=0 RMW_IMPLEMENTATION=rmw_fastrtps_cpp
export FASTRTPS_DEFAULT_PROFILES_FILE=$HOME/fastdds_wifi.xml
export QT_QPA_PLATFORM=xcb
rviz2 -d ~/depth_image_load_candidate.rviz
```

候选仅启用`Depth Image Load Probe`，话题`/camera/camera/depth/image_rect_raw`，Best Effort/Volatile/Keep Last 1、raw传输、Queue Size 1、帧率6、Fixed Frame `camera_depth_optical_frame`。不订阅原始/标障点云、三维体素和二维地图，蓝/黄色点不在本组观察范围。退出候选后，恢复原STVL显示的完整入口见31.3，当前台式机地址以19.0为准。

## 20. NAV-012-R8：持续录包、自适应恢复、State Lattice 与 EKF 对照

完整专题与安全/停止步骤：[归档原文](archive/操作专题原文_20261014.md#20-nav-012-r8持续录包自适应恢复state-lattice-与-ekf-对照)。原测试资产和参数保留；是否适用当前实车以路线和台账为准。

## 21. D435 外参标定与深度避障实验

完整专题与安全/停止步骤：[归档原文](archive/操作专题原文_20261014.md#21-d435-外参标定与深度避障实验)。原测试资产和参数保留；是否适用当前实车以路线和台账为准。

## 22. DRV-005：S1 PWM 舵机 0°～270° 连续往返（实机已停用）

完整专题与安全/停止步骤：[归档原文](archive/操作专题原文_20261014.md#22-drv-005s1-pwm-舵机-0270-连续往返实机已停用)。原测试资产和参数保留；是否适用当前实车以路线和台账为准。

## 23. DRV-006：S1 舵机中位键盘调角

完整专题与安全/停止步骤：[归档原文](archive/操作专题原文_20261014.md#23-drv-006s1-舵机中位键盘调角)。原测试资产和参数保留；是否适用当前实车以路线和台账为准。

## 24. 新舵机相机结构模型与 TF 离线检查

完整专题与安全/停止步骤：[归档原文](archive/操作专题原文_20261014.md#24-新舵机相机结构模型与-tf-离线检查)。原测试资产和参数保留；是否适用当前实车以路线和台账为准。

## 25. description 更新后的纯激光导航回归（2026-09-26）

完整专题与安全/停止步骤：[归档原文](archive/操作专题原文_20261014.md#25-description-更新后的纯激光导航回归2026-09-26)。原测试资产和参数保留；是否适用当前实车以路线和台账为准。

## 26. NAV-012-R10 数据恢复与直角弯净空对照

完整专题与安全/停止步骤：[归档原文](archive/操作专题原文_20261014.md#26-nav-012-r10-数据恢复与直角弯净空对照)。原测试资产和参数保留；是否适用当前实车以路线和台账为准。

## 27. D435 不用标定板的静止 TF 粗校验（TF-006）

完整专题与安全/停止步骤：[归档原文](archive/操作专题原文_20261014.md#27-d435-不用标定板的静止-tf-粗校验tf-006)。原测试资产和参数保留；是否适用当前实车以路线和台账为准。

## 28. D435 静止深度 Costmap 标障与清障（NAV-015-P2A）

完整专题与安全/停止步骤：[归档原文](archive/操作专题原文_20261014.md#28-d435-静止深度-costmap-标障与清障nav-015-p2a)。原测试资产和参数保留；是否适用当前实车以路线和台账为准。

## 29. S1 启动平视命令与相机支架同步调试（DRV-006-R1）

完整专题与安全/停止步骤：[归档原文](archive/操作专题原文_20261014.md#29-s1-启动平视命令与相机支架同步调试drv-006-r1)。原测试资产和参数保留；是否适用当前实车以路线和台账为准。

## 30. D435 平视后静止体素复测续测入口

完整专题与安全/停止步骤：[归档原文](archive/操作专题原文_20261014.md#30-d435-平视后静止体素复测续测入口)。原测试资产和参数保留；是否适用当前实车以路线和台账为准。

## 31. STVL 深度导航主线（NAV-016）

### 31.1 依赖与构建

本节是新的 STVL 入口，旧第28～30节保留作原生 VoxelLayer 对照。所有车上命令在Jetson执行；当前Hao台式机本地终端先按第19节登录Jetson，笔记本bao本轮不在现场。先停止旧相机、地图和导航，避免重复设备与速度发布者。本轮部署的是实验参数，不代表相机外参或移动避障已通过。

下面只下载固定版本官方 ARM64 包并解包到用户目录，不运行安装脚本、不修改 `/etc`、不升级系统 Nav2、不接触硬件。代理已完成这一组；只有迁移或依赖丢失时才重跑。预期两个库存在且 SHA256 核验通过；下载失败 Ctrl+C，修复网络后重试。恢复时关闭使用该前缀的节点、在新终端只加载原有 ROS 工作区即可，旧测试入口不依赖这套新插件。

```bash
cd /home/jetson/luhao/my_nav_carcar
mkdir -p /home/jetson/.local/share/carcar_stvl_humble/debs
cd /home/jetson/.local/share/carcar_stvl_humble/debs
apt-get download ros-humble-spatio-temporal-voxel-layer=2.3.4-1jammy.20260910.011906 ros-humble-openvdb-vendor=2.3.4-1jammy.20260307.134715
sha256sum --check <<'SUMS'
e3f12d02ebf22dada9c990f1fc572ff0921f566e9e8ffa68c869bcdfc538cba9  ros-humble-spatio-temporal-voxel-layer_2.3.4-1jammy.20260910.011906_arm64.deb
160b4adff4c7c705b109880df65a3a6dc4e97912c9ecd5205d88edd28ec58e0f  ros-humble-openvdb-vendor_2.3.4-1jammy.20260307.134715_arm64.deb
SUMS
# 仅在上面两个文件都显示 OK 后继续。
dpkg-deb -x ros-humble-spatio-temporal-voxel-layer_2.3.4-1jammy.20260910.011906_arm64.deb /home/jetson/.local/share/carcar_stvl_humble
dpkg-deb -x ros-humble-openvdb-vendor_2.3.4-1jammy.20260307.134715_arm64.deb /home/jetson/.local/share/carcar_stvl_humble
```

下面读取源码、写入工作区构建/安装/测试产物，不启动相机或执行器。预期两包构建成功、测试无失败。集成测试使用隔离域211/212/213/215和 localhost，合成点云、地图和速度不进入实车域31。编译失败停止，不进入启动步骤；按 Ctrl+C 中断后可修正并重建。用户目录前缀没有顶层 `local_setup`，colcon 的相关警告不代表库加载失败。

```bash
cd /home/jetson/luhao/my_nav_carcar
conda deactivate 2>/dev/null || true
source /opt/ros/humble/setup.bash
source install/setup.bash
STVL_PREFIX=/home/jetson/.local/share/carcar_stvl_humble/opt/ros/humble
export AMENT_PREFIX_PATH="$STVL_PREFIX:$AMENT_PREFIX_PATH"
export CMAKE_PREFIX_PATH="$STVL_PREFIX:$CMAKE_PREFIX_PATH"
export LD_LIBRARY_PATH="$STVL_PREFIX/lib:$STVL_PREFIX/opt/openvdb_vendor/lib:$LD_LIBRARY_PATH"
export CMAKE_BUILD_PARALLEL_LEVEL=2 MAKEFLAGS=-j2
colcon build --packages-select carcar_camera carcar_navigation --parallel-workers 1 --cmake-args -DBUILD_TESTING=ON
source install/setup.bash
colcon test --packages-select carcar_camera carcar_navigation --executor sequential --return-code-on-test-failure --event-handlers console_direct+
colcon test-result --test-result-base build/carcar_camera --verbose
colcon test-result --test-result-base build/carcar_navigation --verbose
```

首轮值：线性衰减，本地2 s／全局5 s，体素2 cm，阈值1；近源0.85 m／最低1.5 cm，普通源2 m／最低5 cm，高度上限26 cm。二维导航网格沿用原有5 cm，独立静态网格2 cm。参数都是实验值，修改体素、衰减或启用设置后重启；不要通过运行时 enabled 切换旧监督流程。

### 31.2 静止相机与独立地图

**2026-10-07 前提更新：**用户回答相机姿态“调过，或目前不确定”。下面10月5日固定外参不能作为当前有效标定，先按30.15～30.16节重新测量并保存当前姿态的独立候选；未完成前仅可静止查看数据及清除时序，不能据旧TF验收地面高度、2 cm目标或启动移动导航。RGB参照与衰减候选见31.6节。

车体落地并保持不动，轮子动力隔离，相机保持当前已测姿态。先按[30.17节](archive/操作专题原文_20261014.md#3017-相机独占点云超时定位与十分钟健康窗口)确认相机独占及旧服务状态；永久停用并验证成功后只需检查，不必每次临时stop，再确认不存在其他 RealSense 和 robot_state_publisher；本组读取USB相机并发布模型、TF、点云，不打开底盘串口、不驱动轮子或舵机。显式使用10月5日的独立地面候选，只适用于保持当时实际姿态的静止实验；固定 TF 不会锁住真实舵机。预期过滤器 HEALTHY、原始时间持续推进；姿态改变、TF或USB异常时先停地图，再 Ctrl+C 退出相机，至少等5秒后重启。

沿用CAM-003-R1已测的16 MiB共享内存配置，显式加载仅影响本终端新ROS进程；不改变系统配置或点云采样。如需恢复，停止本组进程并在未加载该环境变量的新终端启动旧入口。

Jetson 终端A：

```bash
cd /home/jetson/luhao/my_nav_carcar
conda deactivate 2>/dev/null || true
source /opt/ros/humble/setup.bash
source install/setup.bash
export ROS_DOMAIN_ID=31 ROS_LOCALHOST_ONLY=0
export FASTRTPS_DEFAULT_PROFILES_FILE=$PWD/src/carcar_camera/config/fastdds_camera_shm_candidate.xml
ros2 launch carcar_camera camera_tf_verify.launch.xml \
  camera_tilt_dynamic:=false use_rviz:=false \
  camera_extrinsics_file:=$PWD/src/carcar_description/config/camera_extrinsics_floor_candidate_20261005.yaml \
  driver_params_file:=$PWD/src/carcar_camera/config/d435_navigation.yaml \
  filter_params_file:=$PWD/src/carcar_camera/config/depth_filter_stvl_experimental.yaml
```

下面只读取点云/TF并更新独立地图，不启动导航或发布速度。预期 `/costmap/costmap`、原生 PointCloud2 `/costmap/voxel_grid` 和 `/costmap/depth_stvl/diagnostics` 持续发布；不启动旧 VoxelGrid 转换器。异常按 Ctrl+C 停止本入口，保留相机诊断后退出A。

Jetson 终端B：

```bash
cd /home/jetson/luhao/my_nav_carcar
source /opt/ros/humble/setup.bash
source install/setup.bash
STVL_PREFIX=/home/jetson/.local/share/carcar_stvl_humble/opt/ros/humble
export AMENT_PREFIX_PATH="$STVL_PREFIX:$AMENT_PREFIX_PATH"
export LD_LIBRARY_PATH="$STVL_PREFIX/lib:$STVL_PREFIX/opt/openvdb_vendor/lib:$LD_LIBRARY_PATH"
export ROS_DOMAIN_ID=31 ROS_LOCALHOST_ONLY=0
ros2 launch carcar_navigation depth_costmap_stvl_static.launch.xml use_rviz:=false
```

下面只查看软件状态，不改参数或硬件；预期 active、体素尺寸0.02、衰减2.0、`source_current=true` 且序号推进。两条诊断各观察8秒后自动结束，检查输入健康与地图序号推进；查询不符合预期时停止B，不继续摆物验收。

Jetson 终端C：

```bash
cd /home/jetson/luhao/my_nav_carcar
source /opt/ros/humble/setup.bash
source install/setup.bash
export ROS_DOMAIN_ID=31 ROS_LOCALHOST_ONLY=0
ros2 lifecycle get /costmap/costmap
ros2 param get /costmap/costmap depth_stvl.voxel_size
ros2 param get /costmap/costmap depth_stvl.voxel_decay
timeout --foreground --signal=INT 8s ros2 topic echo /costmap/depth_stvl/diagnostics
timeout --foreground --signal=INT 8s ros2 topic echo /camera/navigation/diagnostics
```

### 31.3 bao 查看与静止验收

下面在当前Ubuntu电脑的**本地桌面**执行，不进入Jetson SSH。电脑IP可能变化，先按[第19节](#194-电脑上确认连通并打开轻量-rviz)确认同网和SSH可达；若连接不上，先恢复网络，不把无显示判为清障失败。它读取车上已构建车模和两个 RViz 配置，更新本地副本，并加载项目内固定的Fast DDS单播发现配置（车地址192.168.5.11、域31），不改变车上文件或驱动执行器。该配置只影响本终端的新ROS进程，不覆盖旧 `~/fastdds_wifi.xml`；恢复时关闭本窗口并在新终端加载旧配置。同名旧 RViz 先备份；网络/复制异常会停止本组，也可Ctrl+C，再检查第19节网络；旧显示配置和DDS文件可用同名.backup恢复，车模只是安装副本，可重新复制。静止配置默认蓝色过滤点、黄色三维体素及二维地图同时可见；未用于本轮的雷达/深度图显示默认关闭；导航配置以二维为主，三维点默认关闭。

```bash
(
set -e
cd "$HOME"
mkdir -p ~/ros_overlay/carcar_description
if test -f ~/carcar_stvl_fastdds_wifi.xml; then cp -p ~/carcar_stvl_fastdds_wifi.xml ~/carcar_stvl_fastdds_wifi.xml.backup; fi
if test -f ~/depth_costmap_stvl_static.rviz; then cp -p ~/depth_costmap_stvl_static.rviz ~/depth_costmap_stvl_static.rviz.backup; fi
if test -f ~/navigation_stvl_lite.rviz; then cp -p ~/navigation_stvl_lite.rviz ~/navigation_stvl_lite.rviz.backup; fi
scp jetson@192.168.5.11:/home/jetson/luhao/my_nav_carcar/src/carcar_navigation/config/fastdds_rviz_wifi.xml ~/carcar_stvl_fastdds_wifi.xml
scp jetson@192.168.5.11:/home/jetson/luhao/my_nav_carcar/src/carcar_navigation/rviz/depth_costmap_stvl_static.rviz ~/depth_costmap_stvl_static.rviz
scp jetson@192.168.5.11:/home/jetson/luhao/my_nav_carcar/src/carcar_navigation/rviz/navigation_stvl_lite.rviz ~/navigation_stvl_lite.rviz
rsync -aL jetson@192.168.5.11:/home/jetson/luhao/my_nav_carcar/install/carcar_description/ ~/ros_overlay/carcar_description/
source /opt/ros/humble/setup.bash
export AMENT_PREFIX_PATH=$HOME/ros_overlay/carcar_description:/opt/ros/humble
export FASTRTPS_DEFAULT_PROFILES_FILE=$HOME/carcar_stvl_fastdds_wifi.xml
export ROS_DOMAIN_ID=31 ROS_LOCALHOST_ONLY=0 QT_QPA_PLATFORM=xcb
rviz2 -d ~/depth_costmap_stvl_static.rviz
)
```

静止验收：后方有墙和空旷各测移除；持续可见障碍保持60秒，空场观察120秒。2×2×2 cm物体先测0.5 m，再测0.8 m，并记录相对于光心的实际斜距；不得外推到2 m。记录摆稳和完全移走时刻，手部进出不计稳定区间。移走后本地三维点、二维致命格及膨胀区域应在3秒内恢复基线；家具仍在相机内时应保持。遮挡试验应记录“多久失去观测、多久过期”，不能把过期解释为空闲证明。

下面读取静态点云、地图、健康诊断并写入新的录包目录，不驱动硬件；预期能复核移除时间和对应区域。`timeout` 10分钟后结束录包，也可 Ctrl+C 提前停止；磁盘不足立即停止，不删除历史包。RViz保持运行，以覆盖多订阅者工况。

Jetson 终端C：

```bash
cd /home/jetson/luhao/my_nav_carcar
source /opt/ros/humble/setup.bash
source install/setup.bash
export ROS_DOMAIN_ID=31 ROS_LOCALHOST_ONLY=0
mkdir -p log/stvl_acceptance
STVL_BAG_DIR="$PWD/log/stvl_acceptance/static_$(date +%Y%m%d_%H%M%S)"
df -h "$PWD"
timeout --signal=INT --kill-after=10s 600s ros2 bag record -o "$STVL_BAG_DIR" \
  /camera/navigation/obstacles /camera/navigation/healthy /camera/navigation/diagnostics \
  /costmap/costmap /costmap/voxel_grid /costmap/depth_stvl/diagnostics /tf /tf_static
```

预期10分钟诊断无失效；记录更新耗时、序号间隔和进程内存变化，不只看颜色。静止显示QoS：输入 Best Effort/Volatile/队列1；STVL点云 Reliable/Volatile/队列1；二维图 Reliable/Transient Local/队列1，Decay Time（显示衰减时间）为0，由真实地图决定消失。

### 31.4 导航链路与低速移动（静止及外参验收后）

先结束31.2的地图和相机，关闭旧导航。底盘启动会发送S1平视命令，可能改变之前相机姿态；必须在启动后按第30.15节复核相机平面、光心和固定TF，若不一致，停止导航并修订独立外参后重测，不直接沿用静止候选。首次仅在轮子动力隔离时验证软件链路。下列底盘入口独占串口，可能驱动舵机；启动零轮速、命令超时停车和退出停车沿用底盘保护，紧急情况现场断电。只有对应外参、停车距离与视野盲区验收完成才接通轮子动力并发送目标。

以下四个终端均在 Jetson。底盘、雷达、定位用现有稳定实现；没有加入IMU融合。预期串口单一占用、轮式odom/TF、scan、map及AMCL正常；异常先取消导航目标并停D，随后按逆序 Ctrl+C，保持电机动力隔离后排查。

终端A（此处默认外参需要在启动姿态下实测通过后才能移动）：

```bash
cd /home/jetson/luhao/my_nav_carcar
source /opt/ros/humble/setup.bash
source install/setup.bash
export ROS_DOMAIN_ID=31 ROS_LOCALHOST_ONLY=0
fuser -v /dev/myserial || true
ros2 launch carcar_bringup robot.launch.xml \
  speed_params_file:=$PWD/src/carcar_base/config/navigation_depth_experimental.yaml \
  camera_tilt_dynamic:=false
```

终端B，仅读取激光串口并发布扫描，不发送运动：

```bash
cd /home/jetson/luhao/my_nav_carcar
source /opt/ros/humble/setup.bash
source install/setup.bash
export ROS_DOMAIN_ID=31 ROS_LOCALHOST_ONLY=0
ros2 launch carcar_lidar lidar.launch.xml
```

终端C，读取地图/雷达/里程计，启动定位，不产生运动目标：

```bash
cd /home/jetson/luhao/my_nav_carcar
source /opt/ros/humble/setup.bash
source install/setup.bash
export ROS_DOMAIN_ID=31 ROS_LOCALHOST_ONLY=0
ros2 launch carcar_navigation localization_experimental.launch.xml \
  map:=$PWD/src/carcar_navigation/maps/nav004_20260914_093032.yaml use_rviz:=false
```

终端D，启动相机、双STVL地图、规划控制及速度联锁。它会响应随后由操作者发送的导航目标，并启用声光提示；限速0.10 m/s，启动无目标时输出零速。健康恢复只恢复仍有效的导航任务，已经取消/失败的任务不会自动重新提交。行为树启用 `recovery.require_perception_health`，故障取消当前控制动作并等待停稳，保持导航任务；等待不消耗普通输入/运动恢复预算，健康恢复后重新规划。取消动作或停稳确认失败仍锁停。相机沿用同一16 MiB共享内存候选。

```bash
cd /home/jetson/luhao/my_nav_carcar
source /opt/ros/humble/setup.bash
source install/setup.bash
STVL_PREFIX=/home/jetson/.local/share/carcar_stvl_humble/opt/ros/humble
export AMENT_PREFIX_PATH="$STVL_PREFIX:$AMENT_PREFIX_PATH"
export LD_LIBRARY_PATH="$STVL_PREFIX/lib:$STVL_PREFIX/opt/openvdb_vendor/lib:$LD_LIBRARY_PATH"
export ROS_DOMAIN_ID=31 ROS_LOCALHOST_ONLY=0
export FASTRTPS_DEFAULT_PROFILES_FILE=$PWD/src/carcar_camera/config/fastdds_camera_shm_candidate.xml
ros2 launch carcar_navigation navigation_depth_stvl.launch.xml
```

bao打开导航配置的命令只读取车上可视化话题，本身不发目标；RViz的目标工具由操作者点击后会驱动车体，因此首次链路检查禁止点击目标。先设置初始位姿、检查定位，再在移动验收条件齐备后发送目标。异常在RViz取消目标并现场停车，关闭窗口只停止显示，不代替取消导航。

```bash
cd "$HOME"
source /opt/ros/humble/setup.bash
export AMENT_PREFIX_PATH=$HOME/ros_overlay/carcar_description:/opt/ros/humble
export FASTRTPS_DEFAULT_PROFILES_FILE=$HOME/fastdds_wifi.xml
export ROS_DOMAIN_ID=31 ROS_LOCALHOST_ONLY=0 QT_QPA_PLATFORM=xcb
rviz2 -d ~/navigation_stvl_lite.rviz
```

下面在Jetson新终端只读核对实际参数和健康状态，不改硬件；预期本地2.0、全局5.0、required_stvl、联锁要求健康。持续echo按Ctrl+C退出后看下一项；异常不发目标，按31.5停止。

```bash
cd /home/jetson/luhao/my_nav_carcar
source /opt/ros/humble/setup.bash
source install/setup.bash
export ROS_DOMAIN_ID=31 ROS_LOCALHOST_ONLY=0
ros2 param get /local_costmap/local_costmap depth_stvl.voxel_decay
ros2 param get /global_costmap/global_costmap depth_stvl.voxel_decay
ros2 param get /depth_layer_supervisor mode
ros2 param get /bt_navigator recovery.require_perception_health
ros2 param get /navigation_motion_gate require_perception_health
ros2 topic echo /camera/navigation/fusion_status
ros2 topic echo /local_costmap/depth_stvl/diagnostics
ros2 topic echo /global_costmap/depth_stvl/diagnostics
```

故障试验先保持轮子动力隔离：分别模拟相机/过滤器退出、源订阅停止、TF缺失、重复/过期时间戳、地图停止和监督器退出，测最终速度话题归零。代理离线故障测试命令统一在31.1，实车拔USB或杀节点需另行现场安排，不自动执行。输入/地图异常目标≤1.1 s，监督器心跳丢失≤0.4 s；这是软件零速输出门槛，真实制动距离须独立测量。恢复要求连续健康3 s、两图各至少两轮更新、重新收到BT授权和新速度。

### 31.5 停止与恢复

先在RViz取消目标，确认车轮停止；紧急情况直接现场断开电机动力。再Ctrl+C停止导航D、定位C、雷达B、底盘A；独立静态试验先停录包/C和地图B，再停相机A。联锁退出发布零速，底盘既有命令超时保护继续兜底；监督器停止不会导致切换为仅激光继续行驶。至少等5秒再重新启动RealSense。下面只检查节点、USB/串口占用，不修改系统或驱动硬件；预期本次节点退出且设备无本次进程占用，异常保留日志并关闭残留入口，不盲目重启。

```bash
cd /home/jetson/luhao/my_nav_carcar
source /opt/ros/humble/setup.bash
source install/setup.bash
export ROS_DOMAIN_ID=31 ROS_LOCALHOST_ONLY=0
ros2 node list
fuser -v /dev/myserial /dev/video0 /dev/video1 /dev/video2 /dev/video3 /dev/video4 /dev/video5 2>&1 || true
```

恢复旧对照入口时关闭所有STVL节点，在新终端按第28～30节启动原配置；不更改已保留的低层测试资产。不要同时启用两个相机驱动、两个代价地图测试或两个最终速度发布者。

### 31.6 RGB 参照、安装角与更快衰减对照（NAV-016-R2）

本轮用户反馈完全移除物体后已经正常消失，但没有提供逐帧耗时和重复次数，不能登记3秒量化验收通过。RGB `No Image` 的实读原因是 `enable_color=false`、彩色话题0发布者；临时开启640×480/6 Hz后已收到带光学坐标与新时间戳的彩色图像。随后健康检查失败，已恢复深度单流及原RGB配置；不把图像可见当成导航健康。当前深度单流短窗也重现超时/时间戳过期，需先恢复30.17节的健康验收。本轮部分检查与工作区构建同时进行，不能用这些窗口给RGB定因。

**安装角先测实际光轴，不能凭舵机命令猜。**主流工程依据与几何推算见[安装角和响应调研](archive/2026-10-07-D435安装角与STVL响应调研.md)。当前模式实读fy=385.1489、cy=237.7028、height=480，垂直视场推算约63.86°；163 mm是历史粗量光心高度，当前姿态改变后重新量测。先比较实际平视与下俯约5°，不把它直接换算成140.5°加5°舵机命令。每个姿态独立测地面与TF，再测试0.5/0.8 m的2 cm正方体及左右边缘；地面工具仅覆盖中央0.5～3 m，0.3～0.5 m另补。角度调整只按第29节执行器安全流程，本节不发送舵机命令；停止地图后调角，机械停稳、测量完成后再启动全新地图。正式导航仍须解决底盘启动S1复位与实体姿态不一致的问题。

**可选RGB只作静止场景参照。**下面在Jetson已有相机运行的终端执行，读取相机并临时启用6 Hz彩色流，可能短暂重配置传感器、增加USB/网络负载，不改系统文件、不动舵机或轮子。车轮动力隔离、未启动导航时才执行；预期彩色话题有1发布者并收到新图像。先确认深度单流健康，再开启；健康检查失败会恢复关闭RGB。Ctrl+C可停止观察，若提前中断，执行下一组恢复命令。Ubuntu主机RViz启用现有 `RGB Scene Reference`：话题 `/camera/camera/color/image_raw`、Best Effort、Volatile、队列1；不另开第二个相机驱动或SDK Viewer。

```bash
cd /home/jetson/luhao/my_nav_carcar
source /opt/ros/humble/setup.bash
source install/setup.bash
export ROS_DOMAIN_ID=31 ROS_LOCALHOST_ONLY=0
export FASTRTPS_DEFAULT_PROFILES_FILE=$PWD/src/carcar_camera/config/fastdds_camera_shm_candidate.xml
ros2 param set /camera/camera rgb_camera.color_profile 640x480x6
ros2 param set /camera/camera enable_color true
ros2 topic info /camera/camera/color/image_raw
timeout --foreground --signal=INT 10s ros2 topic echo /camera/camera/color/image_raw --once --field header
rgb_health_dir="$PWD/log/stvl_rgb_health_$(TZ=Asia/Shanghai date +%Y%m%d_%H%M%S)"
ros2 run carcar_camera depth_health_window --ros-args -p duration_s:=600.0 -p output_dir:="$rgb_health_dir" || ros2 param set /camera/camera enable_color false
```

下面关闭RGB并恢复本轮开启前读到的640×480/30配置，释放彩色流负载，不关闭深度、不修改持久配置。预期enable_color为false、彩色话题发布者消失；相机配置重启后仍取原YAML。恢复时可以重新执行上组，但要重新验收。候选 `d435_navigation_rgb_reference_candidate.yaml` 将6 Hz RGB保存为可选启动参数；通过验收后，31.2相机入口的 `driver_params_file` 才可显式选择它，深度单流默认保留。

```bash
cd /home/jetson/luhao/my_nav_carcar
source /opt/ros/humble/setup.bash
source install/setup.bash
export ROS_DOMAIN_ID=31 ROS_LOCALHOST_ONLY=0
ros2 param set /camera/camera enable_color false
ros2 param set /camera/camera rgb_camera.color_profile 640x480x30
ros2 param get /camera/camera enable_color
```

**衰减先2.0→1.5→1.0秒比较。**新增两份静止候选仅修改 `voxel_decay`，不改近距阈值、采样、体素、地图频率、健康联锁或导航参数。缩短的是旧障碍记忆，不提高首次发现障碍能力；无回波与遮挡不能当作自由空间。当前仍不启用视锥加速清除。待当前姿态TF与数据健康满足静止测试前提后，先在原终端B Ctrl+C停止2秒地图，下组启动全新1.5秒地图，不重启相机、不打开串口或发布速度。预期地图衰减为1.5秒；异常Ctrl+C停止B。进一步测1秒时，先停止B，把同一命令中的候选文件换成 `depth_costmap_stvl_fast_candidate.yaml`；不能靠运行时param set切换STVL。

```bash
cd /home/jetson/luhao/my_nav_carcar
source /opt/ros/humble/setup.bash
source install/setup.bash
STVL_PREFIX=/home/jetson/.local/share/carcar_stvl_humble/opt/ros/humble
export AMENT_PREFIX_PATH="$STVL_PREFIX:$AMENT_PREFIX_PATH"
export LD_LIBRARY_PATH="$STVL_PREFIX/lib:$STVL_PREFIX/opt/openvdb_vendor/lib:$LD_LIBRARY_PATH"
export ROS_DOMAIN_ID=31 ROS_LOCALHOST_ONLY=0
ros2 launch carcar_navigation depth_costmap_stvl_static.launch.xml use_rviz:=false \
  params_file:=$PWD/src/carcar_navigation/config/depth_costmap_stvl_moderate_candidate.yaml
```

另一个Jetson终端只读取本轮地图参数，确认启动值；不改硬件或配置。预期分别为1.5或1.0，错误时Ctrl+C停止B并核对选择文件。

```bash
cd /home/jetson/luhao/my_nav_carcar
source /opt/ros/humble/setup.bash
source install/setup.bash
export ROS_DOMAIN_ID=31 ROS_LOCALHOST_ONLY=0
ros2 param get /costmap/costmap depth_stvl.voxel_decay
```

用31.3相同RViz、记录入口及场景比较，每档至少10次撤障，记录最后有效观测、手完全离开视野和三维/二维/膨胀各自恢复基线的时刻，统计P50/P95/最大值。1.5秒候选目标2秒内、1秒候选目标1.5秒内（待实测，包含5 Hz地图、消息传输和显示延迟）；持续可见障碍保持60秒、空场120秒，不能以平均清除快掩盖丢障。遮挡或离开视野的真实障碍也可能到期，单列记录，不能解读成可安全通行。恢复2秒基线：Ctrl+C停止B，再按31.2原命令启动；旧配置及历史证据保留。全局地图5秒与导航本地2秒本轮未变，静止候选通过后再决定移动候选。

下面只构建工作区并在域212/localhost测试真实插件，不连接D435、底盘或舵机。测试覆盖1.0/1.5秒候选的三维、二维、膨胀过期、同格持续观测保留、激光/静态层保留、输入超时与运行时参数拒绝；预期10个用例通过。失败Ctrl+C停止并保留日志，不进入现场验收。构建步骤复用31.1，不重复维护。

```bash
cd /home/jetson/luhao/my_nav_carcar
source /opt/ros/humble/setup.bash
source install/setup.bash
STVL_PREFIX=/home/jetson/.local/share/carcar_stvl_humble/opt/ros/humble
export AMENT_PREFIX_PATH="$STVL_PREFIX:$AMENT_PREFIX_PATH"
export LD_LIBRARY_PATH="$STVL_PREFIX/lib:$STVL_PREFIX/opt/openvdb_vendor/lib:$LD_LIBRARY_PATH"
export ROS_DOMAIN_ID=212 ROS_LOCALHOST_ONLY=1
build/carcar_navigation/test_stvl_integration --gtest_filter='FastStaticCandidate/*'
```

### 31.7 当前98档普通盒静止验收与显示负载隔离（NAV-016-R2）

**当前显示入口更新：**用户已反馈旧2000点/1 Hz预览稀疏且RViz间歇卡住。新的显示域桥、10000点/1 Hz与域32桌面完整操作改由[31.8](#318-stvl-独立显示域与稠密预览nav-016-r2)维护；本节终端G保留作直接域31失败对照，不再是本轮显示推荐入口。车上相机/过滤/地图仍域31，只有该RViz改域32，其他电脑或车上节点不跟着修改域号。

**当前用户选择：直接人工看图，不进行10次反复反馈。**本轮时间确认候选已完成无显示600秒健康/空场及普通盒60秒保持。车上感知/2秒STVL/预览已运行，台式机Hao轻量RViz已启动；不要重复启动A/B/C/H或重新初始化舵机。直接将盒子放稳、手离开，观察黄色三维体素和二维致命/膨胀区域持续存在；完全移走盒子和手，观察恢复原空场背景，再看是否反复出现无实物新格。三维预览1 Hz会比真实地图晚最多一个刷新周期，肉眼不用于精确P95计时。用户未报告实际效果前不登记人工通过；本次演示完成后可推进轮动力隔离的Nav2静止地图融合，2 cm/边缘/遮挡、跨机600秒与移动验收仍分别保留待验。下方10次流程作为可选量化方法保留，**不再是本轮用户人工观察的前置要求**。

只有窗口需要重新打开时，使用下方终端G完整命令，在Hao本地桌面运行；配置已包括显示和QoS，不需逐项勾选。关闭RViz窗口或Ctrl+C即可结束显示，车上静止环境继续；图像卡住或健康失败时，关闭G，按D留存恢复窗口，不将迟到画面当成正常效果。车上全部环境需要重建时再用A/B/C：A的过滤配置选择下方时间确认候选；不重开已经运行的进程。命令都在本节各终端维护。

目的：用普通盒验证STVL识别、持续保持和自然过期。现场已报告正面15.5×15.5 cm、离相机镜面约1 m，厚度/材质未确认；不要求2 cm方块，但本轮不能替代2 cm最低障碍验收。原始深度定位后固定车体ROI：x=1.07～1.24 m、y=−0.07～0.12 m，周边margin=0.20 m；以后若移至其他位置须重新定义并记录ROI，不用整幅地图是否全空作为目标撤障判据。

前提：四轮落地静止、轮动力隔离、保持本次98档实际姿态。只使用`camera_extrinsics_ground98_reapproach_candidate_20261007.yaml`独立候选，仍verified=false；不启动底盘/键盘或发送舵机指令。启动底盘会复位S1到94，不能带着98档TF直接运动。本组仅读取D435及ROS、写日志/录包，CPU/磁盘/局域网负载会改变，串口和运动接口不参与。异常先停新增显示/录包并保留失败数据，不通过重启或放宽0.50秒门槛获取通过。

本轮同步地图+录包+跨机显示未通过；异步候选已停用，保留文件及失败。先关闭主机RViz，维持无原生图像、同步模式、SHM16 MiB，完成地图+录包健康；之后分别增加STVL低带宽预览和二维显示，每种负载用独立窗口。只变显示/QoS没有通过也要保留。构建不能与健康取证重叠。

**终端A（Jetson，构建及相机）：**先结束旧相机Launch并等待退出，确认没有其他相机程序；原XML会自动重启相机，不能只杀相机子进程。下组构建仅相机包、运行隔离的真实进程预览回归；预期测试通过，有效空帧能转发而畸形缓冲拒绝。失败停在测试步骤，不启动硬件；Ctrl+C终止构建，旧测试资产不删。随后启动固定模型/深度/过滤，原生RGB关闭，不访问串口。相机启动占用USB；Ctrl+C结束整个A并等待设备释放，恢复用相同同步入口及当前实体有效候选，不能用初始化94恢复。

```bash
cd /home/jetson/luhao/my_nav_carcar
source /opt/ros/humble/setup.bash
CMAKE_BUILD_PARALLEL_LEVEL=2 colcon build --symlink-install --packages-select carcar_camera --executor sequential
ctest --test-dir build/carcar_camera -R '^(test_depth_cloud_preview|test_stvl_roi)$' --output-on-failure
source install/setup.bash
export ROS_DOMAIN_ID=31 ROS_LOCALHOST_ONLY=0 RMW_IMPLEMENTATION=rmw_fastrtps_cpp
export FASTRTPS_DEFAULT_PROFILES_FILE="$PWD/src/carcar_camera/config/fastdds_camera_shm_candidate.xml"
export RMW_FASTRTPS_PUBLICATION_MODE=SYNCHRONOUS
ros2 launch carcar_camera camera_floor_check.launch.xml use_rviz:=false \
  camera_extrinsics_file:="$PWD/src/carcar_description/config/camera_extrinsics_ground98_reapproach_candidate_20261007.yaml" \
  filter_params_file:="$PWD/src/carcar_camera/config/depth_filter_stvl_experimental.yaml"
```

**终端B（Jetson，静态STVL）：**STVL依赖和导航包构建复用31.1，构建完成后才开始本组取证。下组只启动独立4×4 m静止地图，5 Hz更新/发布、2 cm体素、2秒线性衰减；不启动导航/底盘。预期地图active、插件source_current=true；异常Ctrl+C停止B。1.5/1秒待本基线通过后按31.6独立重启地图，不运行时改TTL，不周期清图。

```bash
cd /home/jetson/luhao/my_nav_carcar
source /opt/ros/humble/setup.bash
source install/setup.bash
STVL_PREFIX=/home/jetson/.local/share/carcar_stvl_humble/opt/ros/humble
export AMENT_PREFIX_PATH="$STVL_PREFIX:$AMENT_PREFIX_PATH"
export LD_LIBRARY_PATH="$STVL_PREFIX/lib:$STVL_PREFIX/opt/openvdb_vendor/lib:$LD_LIBRARY_PATH"
export ROS_DOMAIN_ID=31 ROS_LOCALHOST_ONLY=0 RMW_IMPLEMENTATION=rmw_fastrtps_cpp
export FASTRTPS_DEFAULT_PROFILES_FILE="$PWD/src/carcar_camera/config/fastdds_camera_shm_candidate.xml"
export RMW_FASTRTPS_PUBLICATION_MODE=SYNCHRONOUS
ros2 launch carcar_navigation depth_costmap_stvl_static.launch.xml use_rviz:=false
```

**终端C（Jetson，限流显示）：**只将完整STVL点云抽样到独立显示话题，最多2000点/1 Hz，不改变地图、过滤或录包源。预览QoS为Best Effort/Volatile/队列1，保留坐标系/时间戳及有效空帧。抽样图不能用来计检测率/体素数。异常Ctrl+C结束C，原STVL继续发布。

```bash
cd /home/jetson/luhao/my_nav_carcar
source /opt/ros/humble/setup.bash
source install/setup.bash
export ROS_DOMAIN_ID=31 ROS_LOCALHOST_ONLY=0 RMW_IMPLEMENTATION=rmw_fastrtps_cpp
export FASTRTPS_DEFAULT_PROFILES_FILE="$PWD/src/carcar_camera/config/fastdds_camera_shm_candidate.xml"
export RMW_FASTRTPS_PUBLICATION_MODE=SYNCHRONOUS
ros2 run carcar_camera depth_cloud_preview --ros-args -r __node:=stvl_voxel_preview \
  -p input_topic:=/costmap/voxel_grid -p output_topic:=/costmap/debug/stvl_voxels \
  -p max_points:=2000 -p max_fps:=1.0
```

**终端D（Jetson，健康）：**完整监控入口30.17。本组只读原始点云时间信息及过滤诊断、保存CSV。保持同一窗口的显示/地图/录包负载不变；预期完整600秒、0异常、整体及每分钟≥5 Hz、接收间隔/采样年龄≤0.50秒。短复现可显式60秒但不能替代600；Ctrl+C中断为未完成/FAIL，不刷新窗口到通过。

```bash
cd /home/jetson/luhao/my_nav_carcar
source /opt/ros/humble/setup.bash
source install/setup.bash
export ROS_DOMAIN_ID=31 ROS_LOCALHOST_ONLY=0 RMW_IMPLEMENTATION=rmw_fastrtps_cpp
export FASTRTPS_DEFAULT_PROFILES_FILE="$PWD/src/carcar_camera/config/fastdds_camera_shm_candidate.xml"
export RMW_FASTRTPS_PUBLICATION_MODE=SYNCHRONOUS
health_window_dir="$PWD/log/stvl_field_health_$(date +%Y%m%d_%H%M%S)"
ros2 run carcar_camera depth_health_window --ros-args \
  -p output_dir:="$health_window_dir" -p duration_s:=600.0
cat "$health_window_dir/summary.txt"
```

**终端E（Jetson，原始地图取证）：**只录过滤点云、STVL真实体素、完整二维代价、诊断及TF，不录原始大点云；有磁盘/ROS负载，须在该负载下验健康。预期8话题持续到达，撤障/空场全部覆盖。Ctrl+C停止并等待metadata生成，禁止删失败包；恢复另用新目录。

```bash
cd /home/jetson/luhao/my_nav_carcar
source /opt/ros/humble/setup.bash
source install/setup.bash
export ROS_DOMAIN_ID=31 ROS_LOCALHOST_ONLY=0 RMW_IMPLEMENTATION=rmw_fastrtps_cpp
export FASTRTPS_DEFAULT_PROFILES_FILE="$PWD/src/carcar_camera/config/fastdds_camera_shm_candidate.xml"
export RMW_FASTRTPS_PUBLICATION_MODE=SYNCHRONOUS
field_bag="$PWD/log/stvl_field_bag_$(date +%Y%m%d_%H%M%S)"
ros2 bag record -o "$field_bag" /camera/navigation/obstacles /camera/navigation/healthy \
  /camera/navigation/diagnostics /costmap/costmap /costmap/voxel_grid \
  /costmap/depth_stvl/diagnostics /tf /tf_static
```

**终端F（Jetson，ROI只读观察）：**盒子放稳后，读取原始/过滤60秒，后者必须持续有目标且时间有效。输入计数为正方形x1.055～1.255、y−0.075～0.125 m，比地图审计ROI稍大，用于记录目标输入，不说成同一裁剪。预期summary measurement_valid=1；frames_ge3只作计数，不能单独判STVL保持。Ctrl+C提前终止无效。撤障记录显式将duration_s设为300，覆盖在场→撤除→空场120秒；相机健康D同时设置300秒，前述完整600秒基线仍独立保留。STVL5 Hz有限窗口不适合原始相机工具的频率门槛，真实体素统一用下方离线depth_stvl_audit，不重映射后靠放宽门槛获取通过。STVL体素话题类型是sensor_msgs/PointCloud2，不使用旧VoxelGrid审计。

```bash
cd /home/jetson/luhao/my_nav_carcar
source /opt/ros/humble/setup.bash
source install/setup.bash
export ROS_DOMAIN_ID=31 ROS_LOCALHOST_ONLY=0 RMW_IMPLEMENTATION=rmw_fastrtps_cpp
export FASTRTPS_DEFAULT_PROFILES_FILE="$PWD/src/carcar_camera/config/fastdds_camera_shm_candidate.xml"
target_window_dir="$PWD/log/stvl_box_hold_$(date +%Y%m%d_%H%M%S)"
ros2 run carcar_camera depth_target_window --ros-args \
  -p output_dir:="$target_window_dir" -p duration_s:=60.0 \
  -p center_x:=1.155 -p center_y:=0.025 -p half_width:=0.10 \
  -p min_z:=0.05 -p max_z:=0.26
cat "$target_window_dir/summary.txt"
```

**终端G（当前台式机Hao本地桌面，单独显示）：**下面读取Jetson配置到主机用户目录并启动本地图形程序，仅增加显示订阅、无线网络和相机发布负载，不在Jetson开RViz。当前地址192.168.5.17须先按19节核对；包资源/桌面环境复用19.12。先关闭旧RViz；已有同名配置先备份，避免覆盖底层资产。该候选关闭原始/过滤点云、RGB和雷达，只显示STVL限流预览及二维地图，Best Effort/Volatile；显示负载验收未通过，不能称默认可用。异常关闭窗口或Ctrl+C，恢复无显示窗口并保留同期失败；不要在健康窗口内开关组件。

先分离三维显示时，将本组远端及本地文件名均替换为`depth_costmap_stvl_voxels_only_candidate.rviz`，它仅关闭二维Map组件，其他设置保持；先做独立60秒复现，再做600秒，不在计时中切换。三维窗口完成并退出后，再使用下方组合配置做独立对照。两份配置均保留，三维抽样用于查看，不作为真实体素计数。

```bash
cd "$HOME"
source /opt/ros/humble/setup.bash
export ROS_DOMAIN_ID=31 ROS_LOCALHOST_ONLY=0 RMW_IMPLEMENTATION=rmw_fastrtps_cpp
test ! -f "$HOME/depth_costmap_stvl_acceptance_lite.rviz" || cp -a "$HOME/depth_costmap_stvl_acceptance_lite.rviz" "$HOME/depth_costmap_stvl_acceptance_lite.rviz.$(date +%Y%m%d_%H%M%S).backup"
scp jetson@192.168.5.11:/home/jetson/luhao/my_nav_carcar/src/carcar_navigation/rviz/depth_costmap_stvl_acceptance_lite.rviz "$HOME/depth_costmap_stvl_acceptance_lite.rviz"
scp jetson@192.168.5.11:/home/jetson/luhao/my_nav_carcar/src/carcar_navigation/config/fastdds_rviz_wifi.xml "$HOME/carcar_stvl_acceptance_fastdds_wifi.xml"
export FASTRTPS_DEFAULT_PROFILES_FILE="$HOME/carcar_stvl_acceptance_fastdds_wifi.xml"
export AMENT_PREFIX_PATH="$HOME/ros_overlay/carcar_description:$AMENT_PREFIX_PATH"
rviz2 -d "$HOME/depth_costmap_stvl_acceptance_lite.rviz" --ros-args -r __node:=stvl_acceptance_lite_rviz
```

**封包后的二维离线审计（E终端）：**只读已封存包，写新CSV及占用格坐标，不接硬件。预期每帧输出ROI致命格、周边膨胀及原始时间；异常Ctrl+C保留输入包，另用新输出名。下组依赖E的field_bag变量，换终端须设为实际包绝对路径。

```bash
cd /home/jetson/luhao/my_nav_carcar
source /opt/ros/humble/setup.bash
source install/setup.bash
audit_csv="$PWD/log/stvl_box_map_audit_$(date +%Y%m%d_%H%M%S).csv"
ros2 run carcar_camera depth_map_audit "$field_bag" "$audit_csv" 1.07 1.24 -0.07 0.12 0.20
```

同一已封存、未压缩包的完整三维体素由新增C++离线入口读取，固定base_footprint及同一ROI、高度0.05～0.26 m，输出每帧体素数、header时间和接收时间。只读bag并写新CSV、不连接ROS或硬件；预期有效空消息计0，旧VoxelGrid类型/错误帧/畸形数据直接失败。Ctrl+C停止，失败CSV只作原始失败证据，保留输入包；恢复使用新文件名。拒绝用显示抽样计数或降低健康门槛替代此入口。

工具同时输出同前缀`_roi_voxels.csv`，逐体素保存原生XYZ及时间，两文件均禁止覆盖。核对卷尺等周边低障碍时，可用同一完整命令明确改ROI为x0.97～1.01、y0.07～0.13、z0～0.05 m，并另用新文件名；此为诊断裁剪，不改STVL或正式过滤阈值。用户后来补充卷尺曾留在地上，旧“空场”前提须修订、旧证据保留；卷尺和盒子移开后重新记录120秒，不能删除卷尺相关帧再把旧空场写通过。

```bash
cd /home/jetson/luhao/my_nav_carcar
source /opt/ros/humble/setup.bash
source install/setup.bash
stvl_audit_csv="$PWD/log/stvl_box_voxel_audit_$(date +%Y%m%d_%H%M%S).csv"
ros2 run carcar_camera depth_stvl_audit "$field_bag" "$stvl_audit_csv" 1.07 1.24 -0.07 0.12 0.05 0.26
```

**时间确认独立对照：**卷尺撤后空场仍出现单帧低点，因此先固定2秒TTL、当前TF与15 mm高度下限，仅对标障输入比较时间确认；不要同时换1.5/1秒TTL。新增`depth_temporal_audit`只读未压缩静止包的`/tf_static`及未启用确认的`/camera/navigation/obstacles`，复用已有`TemporalConfirmation`（2 cm格、最近3帧至少2次命中），输出ROI确认前/后点数与全云点数。它不回放、不发布、不连接相机/串口；仅为离线候选对照，不代表STVL地图或实机健康通过。固定TF才适用，缺TF、畸形点云或时间戳非递增直接失败。不能用于已确认输入，也不能用来证明移动目标保留。Ctrl+C停审计、保留原包，恢复用新的CSV。

```bash
cd /home/jetson/luhao/my_nav_carcar
source /opt/ros/humble/setup.bash
CMAKE_BUILD_PARALLEL_LEVEL=2 colcon build --symlink-install --packages-select carcar_camera --executor sequential
ctest --test-dir build/carcar_camera -R '^(test_temporal_confirmation|test_depth_cloud_preview|test_stvl_roi)$' --output-on-failure
source install/setup.bash
shadow_bag="$PWD/log/stvl_withdraw_actual_20261007_01/tape_removed_empty_bag"
shadow_csv="$PWD/log/stvl_temporal_shadow_$(date +%Y%m%d_%H%M%S).csv"
ros2 run carcar_camera depth_temporal_audit "$shadow_bag" "$shadow_csv" 0.95 1.03 0.06 0.14 0.015 0.05
```

实测入口复用A，将`filter_params_file`改为`depth_filter_stvl_temporal_candidate.yaml`；完整相机重启不应混入参数对照。在A仍运行且原过滤子进程尚在时，可只停止该过滤器，再以独立终端H启动候选，保持相机及模型不变。下面先读取进程参数，核对唯一过滤PID后手填；没有唯一进程就先停止核查，不用广泛`pkill`。停止过滤期间地图输入会失效，静止条件下等候恢复，不发送清图/舵机/车轮命令。候选默认不转正；真实障碍增加确认延迟，2 cm、边缘、遮挡与运动仍须另验。

**终端H（Jetson，只替换过滤器）：**以下启停只影响感知输入，不重开USB、不改实体姿态。构建及离线对照先完成，再启动D/E/F的新固定窗口；本段不能在健康计时中执行。异常Ctrl+C结束H，用末尾基线命令恢复过滤，再另记新窗口，不覆盖失败。

```bash
cd /home/jetson/luhao/my_nav_carcar
source /opt/ros/humble/setup.bash
source install/setup.bash
export ROS_DOMAIN_ID=31 ROS_LOCALHOST_ONLY=0 RMW_IMPLEMENTATION=rmw_fastrtps_cpp
export FASTRTPS_DEFAULT_PROFILES_FILE="$PWD/src/carcar_camera/config/fastdds_camera_shm_candidate.xml"
export RMW_FASTRTPS_PUBLICATION_MODE=SYNCHRONOUS
pgrep -af '/lib/carcar_camera/depth_cloud_filter'
read -r -p '输入刚核对的唯一旧过滤器PID：' old_filter_pid
kill -INT "$old_filter_pid"
while kill -0 "$old_filter_pid" 2>/dev/null; do sleep 1; done
ros2 run carcar_camera depth_cloud_filter --ros-args \
  --params-file "$PWD/src/carcar_camera/config/depth_filter_stvl_temporal_candidate.yaml"
```

H启动后，另一个Jetson终端读取实际参数，并复用D/E/F记录600秒健康及空场；F此时诊断低点，可显式改`center_x:=0.99 center_y:=0.10 half_width:=0.04 min_z:=0.015 max_z:=0.05 duration_s:=600.0`。这组不会更改参数；预期确认开启、2次命中、15 mm和0.5秒保持，后续以完整3D/2D审计判断空场，不能仅看输入零点。Ctrl+C停止读取，H继续运行。

```bash
cd /home/jetson/luhao/my_nav_carcar
source /opt/ros/humble/setup.bash
source install/setup.bash
export ROS_DOMAIN_ID=31 ROS_LOCALHOST_ONLY=0 RMW_IMPLEMENTATION=rmw_fastrtps_cpp
ros2 param get /depth_cloud_filter temporal_confirm_enable
ros2 param get /depth_cloud_filter temporal_confirm_min_hits
ros2 param get /depth_cloud_filter min_obstacle_height
ros2 param get /depth_cloud_filter max_stamp_age_s
```

**H异常后的基线恢复（先Ctrl+C退出候选，等唯一进程结束）：**以下只恢复原过滤参数，不重启相机/模型/地图、不初始化舵机。用D另记恢复健康窗口，不能据恢复修改候选失败；Ctrl+C停止本过滤进程。

```bash
cd /home/jetson/luhao/my_nav_carcar
source /opt/ros/humble/setup.bash
source install/setup.bash
export ROS_DOMAIN_ID=31 ROS_LOCALHOST_ONLY=0 RMW_IMPLEMENTATION=rmw_fastrtps_cpp
export FASTRTPS_DEFAULT_PROFILES_FILE="$PWD/src/carcar_camera/config/fastdds_camera_shm_candidate.xml"
export RMW_FASTRTPS_PUBLICATION_MODE=SYNCHRONOUS
ros2 run carcar_camera depth_cloud_filter --ros-args \
  --params-file "$PWD/src/carcar_camera/config/depth_filter_stvl_experimental.yaml"
```

**可选量化通过范围及门槛（原方案保留，本轮用户已取消重复统计）：**先2秒基线，健康完整600秒通过；普通盒持续可见60秒，ROI中STVL体素及二维致命格持续存在；移走后空场120秒无新假障碍；至少10次撤障，三维、二维致命格、膨胀恢复各自基线均≤3秒，并报告P50/P95/最大值。分别记录最后有效观测时间和现场“物体与手完全离开”事件；聊天到达时刻不能冒充物理动作精确时间。保持/撤障期间出现健康异常的样本保留但不计成功，不反复挑选好帧。若启用时间确认，需在该候选下重新验保持和撤障，不能沿用关闭确认的样本拼成通过。

候选保持通过后可批量记录10次。D/F duration均设600秒，E记录全段；确认8话题订阅及健康开始计时后才通知现场。盒子起始在原位置，第1次完全移走盒子和手并留空15秒，再放回原位置、手离开后放稳15秒；循环到总计移走10次，第10次之后保持空场120秒。先判断各在场段持续标记及各空场段连续清空，再按最后有效目标输入header和各地图自身时间计算；现场须报告实际次数/结束状态，不根据软件跳变自行假定10次实体动作完成。若操作超过窗口或次数不足，保留未完成记录，另开新窗口，不将取证结束后的动作估算到旧包。此操作只移动盒子，车辆/舵机不动作；异常停止摆盒并报告，不用重启相机或清图补救。

普通盒通过只允许推进到轮动力隔离的Nav2地图融合验收，不能宣称2 cm、边缘/遮挡或移动安全通过。真实障碍暂时看不见也会随TTL被遗忘，必须单列遮挡试验；空点云不等于前方可通行。轮式里程计/启动姿态TF/停车联锁未满足时不移动，也不加入IMU融合。停止顺序：先关闭G，再Ctrl+C结束F/D/E等待封包，结束C/B；若启用了独立H也Ctrl+C退出，最后结束A；不发清图或执行器恢复命令。

### 31.8 STVL 独立显示域与稠密预览（NAV-016-R2）

用途：车上相机/过滤/STVL仍在域31，桌面RViz改为域32，通过ROS 2 `domain_bridge`单向转发5个显示话题。这样远端RViz不会直接加入相机所在的DDS域；仅桥接预览、二维地图、TF和车模，不桥接原始深度、过滤大点云、速度、目标、参数调用或导航动作。无线网络本身仍可能丢包，不能把桥接当作网络修复；以车上完整600秒健康与桌面实际接收分别验证。本轮新预览仍1 Hz，最多10000点；当前约3400体素时无抽样，高于上限仍会均匀抽样，不用预览计检测率或精确清除耗时。地面不属于标障体素、同一个2 cm体素合并多点，黄色图不应等同原始稠密点云。

复用官方C++ `domain_bridge` **0.5.0**（ROS Humble二进制0.5.0-1jammy.20260910.004028，arm64，Apache-2.0），来源：[固定版本](https://github.com/ros2/domain_bridge/tree/0.5.0)。原包不改；本项目只新增单向YAML/QoS与XML启动封装。TF动态/静态使用Reliable，以匹配Humble TF监听器；点云及二维用Best Effort/Volatile/depth1。依赖下载到用户目录解包，不用sudo、不改`/etc`或系统默认，原2000点/直接域31显示资产和失败日志保留。完整数据见NAV-016-R2。

前提：按31.7运行车上当前姿态候选、时间确认过滤及独立2秒地图，不能重复启动；轮动力隔离、相机静止，不启动底盘或舵机。以下新增负载仅用于显示，Ctrl+C能停止；构建/解包先完成，再开始健康窗口。当前代理已启动本组，用户只看Hao现有窗口即可，需要重建时再执行以下步骤。

**终端I（Jetson，依赖及只读显示桥）：**下载固定官方二进制、核对SHA256并解包到`~/.local/share/carcar_domain_bridge_humble`，随后构建导航包以安装新增配置/XML。预期哈希核对成功、构建成功、域桥持续运行；下载/构建失败就停在此处，不覆盖既有包或启动硬件。Ctrl+C退出桥，源相机/地图继续，域32显示停止更新；恢复用同一命令，不清图。哈希不符不能继续解包。

```bash
cd /home/jetson/luhao/my_nav_carcar
source /opt/ros/humble/setup.bash
bridge_download_dir="$PWD/log/domain_bridge_dependency_$(date +%Y%m%d_%H%M%S)"
mkdir -p "$bridge_download_dir"
cd "$bridge_download_dir"
apt download ros-humble-domain-bridge=0.5.0-1jammy.20260910.004028
echo '9b2ec177d8c59d5d679d59433a9b3b094667f88b779304846095785e6aeea38c  ros-humble-domain-bridge_0.5.0-1jammy.20260910.004028_arm64.deb' | sha256sum -c -
test "$(sha256sum ros-humble-domain-bridge_0.5.0-1jammy.20260910.004028_arm64.deb | cut -d ' ' -f 1)" = 9b2ec177d8c59d5d679d59433a9b3b094667f88b779304846095785e6aeea38c || exit 1
mkdir -p "$HOME/.local/share/carcar_domain_bridge_humble"
dpkg-deb -x ros-humble-domain-bridge_0.5.0-1jammy.20260910.004028_arm64.deb "$HOME/.local/share/carcar_domain_bridge_humble"
cd /home/jetson/luhao/my_nav_carcar
source install/setup.bash
STVL_PREFIX="$HOME/.local/share/carcar_stvl_humble/opt/ros/humble"
export AMENT_PREFIX_PATH="$STVL_PREFIX:$AMENT_PREFIX_PATH"
export LD_LIBRARY_PATH="$STVL_PREFIX/lib:$STVL_PREFIX/opt/openvdb_vendor/lib:$LD_LIBRARY_PATH"
CMAKE_BUILD_PARALLEL_LEVEL=2 colcon build --symlink-install --packages-select carcar_navigation --executor sequential
source install/setup.bash
BRIDGE_PREFIX="$HOME/.local/share/carcar_domain_bridge_humble/opt/ros/humble"
export AMENT_PREFIX_PATH="$BRIDGE_PREFIX:$AMENT_PREFIX_PATH"
export LD_LIBRARY_PATH="$BRIDGE_PREFIX/lib:$LD_LIBRARY_PATH"
export ROS_DOMAIN_ID=31 ROS_LOCALHOST_ONLY=0 RMW_IMPLEMENTATION=rmw_fastrtps_cpp
export FASTRTPS_DEFAULT_PROFILES_FILE="$PWD/src/carcar_camera/config/fastdds_camera_shm_candidate.xml"
export RMW_FASTRTPS_PUBLICATION_MODE=SYNCHRONOUS
display_bridge_config="$PWD/src/carcar_navigation/config/stvl_display_domain_bridge_candidate.yaml"
# 需要31.9的两路参照图时，启用下面这一行；普通体素/二维对照保持上一行。
# display_bridge_config="$PWD/src/carcar_navigation/config/stvl_display_image_bridge_candidate.yaml"
# 三窗配准参照（31.11）：
# display_bridge_config="$PWD/src/carcar_navigation/config/stvl_display_aligned_image_bridge_candidate.yaml"
# 三窗与原生深度点云预览（31.14）：
# display_bridge_config="$PWD/src/carcar_navigation/config/stvl_display_depth_cloud_bridge_candidate.yaml"
ros2 launch carcar_navigation stvl_display_bridge_candidate.launch.xml config_file:="$display_bridge_config"
```

**终端J（Jetson，仅显示预览）：**先Ctrl+C退出31.7的旧终端C，核对旧预览进程已结束；不停止相机/过滤/地图。同名预览只能有一个。下组以10000点/1 Hz替换2000点候选，其余不变，保留字段、时间和有效空帧。预期黄色体素更完整，地图本身不改变；Ctrl+C退出J。异常保留数据，恢复旧C（2000点）作对照，不能提高超时门槛。

```bash
cd /home/jetson/luhao/my_nav_carcar
source /opt/ros/humble/setup.bash
source install/setup.bash
export ROS_DOMAIN_ID=31 ROS_LOCALHOST_ONLY=0 RMW_IMPLEMENTATION=rmw_fastrtps_cpp
export FASTRTPS_DEFAULT_PROFILES_FILE="$PWD/src/carcar_camera/config/fastdds_camera_shm_candidate.xml"
export RMW_FASTRTPS_PUBLICATION_MODE=SYNCHRONOUS
ros2 run carcar_camera depth_cloud_preview --ros-args -r __node:=stvl_voxel_preview \
  -p input_topic:=/costmap/voxel_grid -p output_topic:=/costmap/debug/stvl_voxels \
  -p max_points:=10000 -p max_fps:=1.0
```

**终端K（Hao本地桌面，仅显示）：**先关闭旧域31 RViz。本组读取项目配置到当前主机用户目录，已有同名文件先备份；增加Wi-Fi/显示负载，不在Jetson运行RViz、不启动执行器。当前Hao=192.168.5.17，改变地址先核对19节。RViz配置复用31.7已保存的轻量显示，QoS不需逐项调整；只有该进程域32。异常关闭窗口或Ctrl+C，车上地图继续；恢复时重新运行本组，回退旧直接域31仅作31.7失败对照。

```bash
cd "$HOME"
source /opt/ros/humble/setup.bash
for display_file in depth_costmap_stvl_acceptance_lite.rviz carcar_stvl_display_domain32_candidate.xml; do
  test ! -f "$HOME/$display_file" || cp -a "$HOME/$display_file" "$HOME/$display_file.$(date +%Y%m%d_%H%M%S).backup"
done
scp jetson@192.168.5.11:/home/jetson/luhao/my_nav_carcar/src/carcar_navigation/rviz/depth_costmap_stvl_acceptance_lite.rviz "$HOME/depth_costmap_stvl_acceptance_lite.rviz"
scp jetson@192.168.5.11:/home/jetson/luhao/my_nav_carcar/src/carcar_navigation/config/fastdds_rviz_domain32_candidate.xml "$HOME/carcar_stvl_display_domain32_candidate.xml"
export ROS_DOMAIN_ID=32 ROS_LOCALHOST_ONLY=0 RMW_IMPLEMENTATION=rmw_fastrtps_cpp
export FASTRTPS_DEFAULT_PROFILES_FILE="$HOME/carcar_stvl_display_domain32_candidate.xml"
export AMENT_PREFIX_PATH="$HOME/ros_overlay/carcar_description:$AMENT_PREFIX_PATH"
rviz2 -d "$HOME/depth_costmap_stvl_acceptance_lite.rviz" --ros-args -r __node:=stvl_domain32_rviz
```

**观察/停止：**车上继续用31.7终端D的完整600秒健康命令，域31保持原值；整个窗口保持I/J/K，不并行构建、不录原生图像、不刷新到通过。桌面可看黄色体素及二维障碍的放/撤变化；出现红色状态时看具体Display错误，不把地图卡住当作SSH掉线。关闭K→Ctrl+C退出I/J→停止D；如果还需结束车上环境，按31.7结束B/H/A。关闭显示不会恢复或改变任何实体舵机角度；移动导航仍等待启动姿态TF与原有运动前提。

### 31.9 RGB 与深度压缩参照窗口（NAV-016-R2）

用途：用户需要认出现场实物并与黄色体素/二维障碍对应。深度及RGB各输出320×240/1 Hz显示参照，经显示域32单向桥接；不把原生640×480图像全帧跨Wi-Fi发送。新增小型C++`image_reference_preview`使用现有OpenCV压缩和标准`CompressedImage`协议，弥补原生图像压缩入口未在编码前限流/缩小的显示负载需求，不实现感知算法。深度16UC1毫米映射为0～3 m的8位灰度PNG（近亮、远暗、无效0也为黑），RGB为BGR8/JPEG质量70；原始测距、CameraInfo、点云和TF不改变。两路保留各自采样时间，不做RGB/深度配准或同步，不可据此量取毫米高度或逐像素证明同一表面；黄色体素仍是2 cm地图格，与稠密深度像素不同。

当前显示依赖：[image_transport_plugins Humble](https://github.com/ros-perception/image_transport_plugins/tree/humble)。Hao缺少`compressed_image_transport`时，RViz不能解码，命令行能收到压缩消息仍会“No Image”。本轮补齐官方Humble包**2.5.5-1jammy.20260908.002726/amd64**，BSD许可证，不改插件代码。Humble RViz从话题`/compressed`后缀推断传输，配置必须填完整`/camera/debug/{depth,rgb}_reference/compressed`；旧的独立`Transport Hint`字段无效。失败基础话题配置保存在原证据目录，不改写为成功。

前提：31.7相机/固定候选/时间确认过滤/2秒地图和31.8稠密预览已运行。原生RGB初始关闭，当前操作只新增RGB采集和显示，不涉及串口/执行器。**先构建及部署全部依赖，再计时**；新窗口必须在实际RViz两路订阅建立后开始，不能把仅发布/命令行接收的窗口称为两图渲染验收。当前代理已启动各组件，用户只看现有RViz，不需要重复启动。

**终端L（Jetson，构建及两路预览）：**构建相机/导航包、检查真实像素压缩/尺寸/颜色/无效缓冲单测，再启动两个只读显示节点。原图会在本地ROS中增加发布负载，须独立验健康。预期测试PASS、两个输出存在；Ctrl+C退出L即可结束显示预览，相机及STVL继续。旧独立深度/RGB预览进程须先结束，不能与该Launch重复启动。

```bash
cd /home/jetson/luhao/my_nav_carcar
source /opt/ros/humble/setup.bash
source install/setup.bash
STVL_PREFIX="$HOME/.local/share/carcar_stvl_humble/opt/ros/humble"
export AMENT_PREFIX_PATH="$STVL_PREFIX:$AMENT_PREFIX_PATH"
export LD_LIBRARY_PATH="$STVL_PREFIX/lib:$STVL_PREFIX/opt/openvdb_vendor/lib:$LD_LIBRARY_PATH"
CMAKE_BUILD_PARALLEL_LEVEL=2 colcon build --symlink-install --packages-select carcar_camera carcar_navigation --executor sequential
ctest --test-dir build/carcar_camera -R '^test_image_reference$' --output-on-failure
source install/setup.bash
export ROS_DOMAIN_ID=31 ROS_LOCALHOST_ONLY=0 RMW_IMPLEMENTATION=rmw_fastrtps_cpp
export FASTRTPS_DEFAULT_PROFILES_FILE="$PWD/src/carcar_camera/config/fastdds_camera_shm_candidate.xml"
export RMW_FASTRTPS_PUBLICATION_MODE=SYNCHRONOUS
ros2 launch carcar_camera image_reference_preview.launch.xml
```

终端I的桥接完整命令只维护在31.8，将其中`display_bridge_config`选为`stvl_display_image_bridge_candidate.yaml`。先Ctrl+C退出旧5话题桥再启动7话题桥；车上域31和其他参数不变。深度参照先单独建立订阅并做D的60秒对照，RGB尚未开启时相应窗口No Image是正常状态，不算RGB已通过。

**RGB采集开启（另一个Jetson终端）：**只在当前RGB关闭时改为640×480/6 Hz，再启用RGB；不重启整个相机进程、不改深度模式/滤波、相机姿态或导航参数。会占用额外USB/CPU并启动RGB传感器，预期参数实读成功和真实彩色图像到达。失败执行下方恢复，保留失败，不提高0.5秒门槛。不要开启原640×480/30 Hz配置。

```bash
cd /home/jetson/luhao/my_nav_carcar
source /opt/ros/humble/setup.bash
source install/setup.bash
export ROS_DOMAIN_ID=31 ROS_LOCALHOST_ONLY=0 RMW_IMPLEMENTATION=rmw_fastrtps_cpp
export FASTRTPS_DEFAULT_PROFILES_FILE="$PWD/src/carcar_camera/config/fastdds_camera_shm_candidate.xml"
ros2 param get /camera/camera enable_color
ros2 param get /camera/camera rgb_camera.color_profile
ros2 param set /camera/camera rgb_camera.color_profile 640x480x6
ros2 param set /camera/camera enable_color true
ros2 param get /camera/camera enable_color
ros2 param get /camera/camera rgb_camera.color_profile
```

需要全部退出后恢复同样RGB配置时，31.7终端A的`camera_floor_check.launch.xml`已支持`driver_params_file`参数，选择`src/carcar_camera/config/d435_navigation_rgb_reference_candidate.yaml`；默认仍是原深度单流配置。该Launch只读相机/模型，不初始化94舵机，不覆盖正式默认。

**终端M（Hao本地桌面，补齐插件并打开两图）：**固定包只解到用户目录，所需cv_bridge/OpenCV已在本机核对存在；不sudo安装、不改系统文件。先关闭31.8窗口，已有同名候选先备份。预期ROS找到用户目录插件、RViz两路压缩订阅建立；依赖缺失/哈希不符就停止，不把白窗算成功。关闭窗口或Ctrl+C停止显示，车上地图继续；恢复用本组重开。

```bash
cd "$HOME"
source /opt/ros/humble/setup.bash
image_plugin_download_dir="$HOME/stvl_image_plugin_$(date +%Y%m%d_%H%M%S)"
mkdir -p "$image_plugin_download_dir"
cd "$image_plugin_download_dir"
apt download ros-humble-compressed-image-transport=2.5.5-1jammy.20260908.002726
test "$(sha256sum ros-humble-compressed-image-transport_2.5.5-1jammy.20260908.002726_amd64.deb | cut -d ' ' -f 1)" = af9a9f7f87bc2e0d1b72809ddd39d627ee3a5611aa148571815cd63267ba27a1 || exit 1
mkdir -p "$HOME/.local/share/carcar_image_transport_humble"
dpkg-deb -x ros-humble-compressed-image-transport_2.5.5-1jammy.20260908.002726_amd64.deb "$HOME/.local/share/carcar_image_transport_humble"
cd "$HOME"
test ! -f "$HOME/depth_costmap_stvl_image_reference_candidate.rviz" || cp -a "$HOME/depth_costmap_stvl_image_reference_candidate.rviz" "$HOME/depth_costmap_stvl_image_reference_candidate.rviz.$(date +%Y%m%d_%H%M%S).backup"
scp jetson@192.168.5.11:/home/jetson/luhao/my_nav_carcar/src/carcar_navigation/rviz/depth_costmap_stvl_image_reference_candidate.rviz "$HOME/depth_costmap_stvl_image_reference_candidate.rviz"
scp jetson@192.168.5.11:/home/jetson/luhao/my_nav_carcar/src/carcar_navigation/config/fastdds_rviz_domain32_candidate.xml "$HOME/carcar_stvl_display_domain32_candidate.xml"
IMAGE_PREFIX="$HOME/.local/share/carcar_image_transport_humble/opt/ros/humble"
export AMENT_PREFIX_PATH="$IMAGE_PREFIX:$HOME/ros_overlay/carcar_description:$AMENT_PREFIX_PATH"
export LD_LIBRARY_PATH="$IMAGE_PREFIX/lib:$LD_LIBRARY_PATH"
export ROS_DOMAIN_ID=32 ROS_LOCALHOST_ONLY=0 RMW_IMPLEMENTATION=rmw_fastrtps_cpp
export FASTRTPS_DEFAULT_PROFILES_FILE="$HOME/carcar_stvl_display_domain32_candidate.xml"
ros2 pkg prefix compressed_image_transport
rviz2 -d "$HOME/depth_costmap_stvl_image_reference_candidate.rviz" --ros-args -r __node:=stvl_image_reference_rviz
```

**订阅核对（Jetson只读，显示域32）：**预期两份输出均有发布者`stvl_display_bridge_32`及订阅者`stvl_image_reference_rviz`、Best Effort匹配；没有RViz订阅不能宣布窗口开启成功。只读检查不动硬件，Ctrl+C停止；实际屏幕仍以用户观察为准。随后车上域31复用31.7 D完整600秒健康命令，不在计时中修改组件。

```bash
cd /home/jetson/luhao/my_nav_carcar
source /opt/ros/humble/setup.bash
export ROS_DOMAIN_ID=32 ROS_LOCALHOST_ONLY=0 RMW_IMPLEMENTATION=rmw_fastrtps_cpp
ros2 topic info -v /camera/debug/depth_reference/compressed
ros2 topic info -v /camera/debug/rgb_reference/compressed
```

**恢复深度单流（Jetson）：**先关闭M、Ctrl+C结束L的参照图节点，再关闭RGB采集并恢复原640×480/30 Hz关闭状态；RGB传感器会停止，可能短暂改变SDK调度，另用D记录恢复健康，不把该变化混入原窗口。深度/模型/TF/STVL及舵机保持，普通体素显示恢复31.8。整车环境若全部结束，再按31.8停止I/J和31.7 B/H/A，不发送执行器恢复命令。

```bash
cd /home/jetson/luhao/my_nav_carcar
source /opt/ros/humble/setup.bash
source install/setup.bash
export ROS_DOMAIN_ID=31 ROS_LOCALHOST_ONLY=0 RMW_IMPLEMENTATION=rmw_fastrtps_cpp
export FASTRTPS_DEFAULT_PROFILES_FILE="$PWD/src/carcar_camera/config/fastdds_camera_shm_candidate.xml"
ros2 param set /camera/camera enable_color false
ros2 param set /camera/camera rgb_camera.color_profile 640x480x30
ros2 param get /camera/camera enable_color
ros2 param get /camera/camera rgb_camera.color_profile
```

### 31.10 深度噪点定位与高置信度测距候选（NAV-016-R2）

当前使用官方SDK High Accuracy（预设3）与既有3帧至少2帧时间确认，TTL仍2秒；不叠加空间/SDK时域/补洞/降采样。官方预设提高匹配置信度，代价是深度覆盖降低。未观测不等于空闲，当前只供静止观察；小目标、遮挡和移动仍需另验。空间滤波候选保留用于独立比较，不能同时启用后把效果归给其中一项。当前深度与RGB视场不同，侧边深度观测可能超出RGB画面；不依据RGB缺物删除体素。

**终端N（Jetson，构建、备份、在现有唯一相机上切换）：**读取指定序列号的高级测距设置，先保存完整JSON，再改变测距预设；不启动第二路采集，不动串口、车轮、舵机，不切换高级模式或复位USB。SDK配置会影响实际测距结果，因此必须保留备份。已有候选在运行时不重复执行切换；异常先停止试验，按下方终端R恢复。构建期间不把健康窗口作验收，构建完成后再开始记录。备份失败时停止，不继续改预设。

```bash
cd /home/jetson/luhao/my_nav_carcar
source /opt/ros/humble/setup.bash
export CMAKE_BUILD_PARALLEL_LEVEL=1
colcon build --packages-select carcar_camera --executor sequential --parallel-workers 1
source install/setup.bash
export ROS_DOMAIN_ID=31 ROS_LOCALHOST_ONLY=0 RMW_IMPLEMENTATION=rmw_fastrtps_cpp
export FASTRTPS_DEFAULT_PROFILES_FILE="$PWD/src/carcar_camera/config/fastdds_camera_shm_candidate.xml"
export RMW_FASTRTPS_PUBLICATION_MODE=SYNCHRONOUS
noise_session="$PWD/log/stvl_noise_filter_manual_$(date +%Y%m%d_%H%M%S)"
mkdir -p "$noise_session"
ros2 param dump /camera/camera > "$noise_session/camera_before.yaml"
ros2 run carcar_camera depth_device_settings save 213222078719 "$noise_session/device_before.json" && {
  ros2 param set /camera/camera spatial_filter.enable false
  ros2 param set /camera/camera depth_module.visual_preset 3
  ros2 param get /camera/camera depth_module.visual_preset
}
```

**终端O（Jetson，健康及边缘只读取证）：**读取原始深度、过滤诊断，记录600秒；不发布控制。异常不会清零重计，Ctrl+C为未完成，保留结果。边缘快照扩大只读CSV范围，不扩大导航接受范围。两个盒子在场时不要把整片CSV拟合成地面；原地面工具仍按中央窗口解释。每次转向或移物后须另存新场景，不能沿用旧坐标ROI声称滤波改进。

```bash
cd /home/jetson/luhao/my_nav_carcar
source /opt/ros/humble/setup.bash
source install/setup.bash
export ROS_DOMAIN_ID=31 ROS_LOCALHOST_ONLY=0 RMW_IMPLEMENTATION=rmw_fastrtps_cpp
export FASTRTPS_DEFAULT_PROFILES_FILE="$PWD/src/carcar_camera/config/fastdds_camera_shm_candidate.xml"
export RMW_FASTRTPS_PUBLICATION_MODE=SYNCHRONOUS
noise_observation="$PWD/log/stvl_noise_observe_$(date +%Y%m%d_%H%M%S)"
ros2 run carcar_camera depth_health_window --ros-args -p duration_s:=600.0 -p output_dir:="$noise_observation/health600"
ros2 run carcar_camera depth_snapshot --ros-args -p output_dir:="$noise_observation/edge_snapshot" -p require_color:=true -p central_half_width:=0.9 -p sample_frames:=3 -p sample_interval_ms:=1000
```

**终端P（Jetson，保存同场景120秒，结束后离线审计）：**记录静态TF、输入、原生体素、二维地图和低带宽参照。只在车体停稳、相机固定且待判区域经现场确认后比较；转向片段不得作为单变量去噪证据。录包约数百MiB，磁盘不足或场景变化时Ctrl+C封包保留。示例ROI仅对应本轮转向前左侧样本，不作为后来场景的通用区域。timeout返回124表示定时停止录包，不是判定测试失败；以metadata和审计内容为准。完整体素和二维效果分别审计，不能只看RViz预览。

```bash
cd /home/jetson/luhao/my_nav_carcar
source /opt/ros/humble/setup.bash
source install/setup.bash
export ROS_DOMAIN_ID=31 ROS_LOCALHOST_ONLY=0 RMW_IMPLEMENTATION=rmw_fastrtps_cpp
export FASTRTPS_DEFAULT_PROFILES_FILE="$PWD/src/carcar_camera/config/fastdds_camera_shm_candidate.xml"
export RMW_FASTRTPS_PUBLICATION_MODE=SYNCHRONOUS
noise_bag_root="$PWD/log/stvl_noise_bag_$(date +%Y%m%d_%H%M%S)"
mkdir -p "$noise_bag_root"
timeout --signal=INT --kill-after=10s 120s ros2 bag record -o "$noise_bag_root/bag" --max-cache-size 10000000 /tf_static /camera/navigation/obstacles /camera/navigation/diagnostics /costmap/voxel_grid /costmap/costmap /camera/debug/rgb_reference/compressed /camera/debug/depth_reference/compressed
ros2 run carcar_camera depth_stvl_audit "$noise_bag_root/bag" "$noise_bag_root/left_voxels.csv" 0.98 1.08 0.60 0.73 0.0 0.26
ros2 run carcar_camera depth_map_audit "$noise_bag_root/bag" "$noise_bag_root/left_map.csv" 0.98 1.08 0.60 0.73 0.0
```

**终端R（Jetson，恢复已备份Custom）：**恢复会改变相机深度高级参数，必须使用本机同序列号的切换前JSON。仅把visual_preset设回0不会恢复原Custom参数。以下是本轮实际回滚备份，保留不覆盖；恢复后另读回JSON并比较。若恢复报错，保留报错停止对照，勿反复复位；不以默认配置替代备份。Ctrl+C只停止命令/采集，不能撤销已经写入的测距设置。关闭图像/域桥/地图和恢复RGB按31.8～31.9各终端Ctrl+C及RGB恢复段操作；不停止或启动执行器。

```bash
cd /home/jetson/luhao/my_nav_carcar
source /opt/ros/humble/setup.bash
source install/setup.bash
export ROS_DOMAIN_ID=31 ROS_LOCALHOST_ONLY=0 RMW_IMPLEMENTATION=rmw_fastrtps_cpp
export FASTRTPS_DEFAULT_PROFILES_FILE="$PWD/src/carcar_camera/config/fastdds_camera_shm_candidate.xml"
export RMW_FASTRTPS_PUBLICATION_MODE=SYNCHRONOUS
noise_restore_json="$PWD/log/stvl_noise_filter_20261007_01/device_custom_before.json"
ros2 param set /camera/camera spatial_filter.enable false
ros2 param set /camera/camera depth_module.visual_preset 0
ros2 run carcar_camera depth_device_settings restore 213222078719 "$noise_restore_json"
noise_readback="$PWD/log/device_restore_readback_$(date +%Y%m%d_%H%M%S).json"
ros2 run carcar_camera depth_device_settings save 213222078719 "$noise_readback"
cmp "$noise_restore_json" "$noise_readback"
ros2 param get /camera/camera depth_module.visual_preset
```

**终端A冷启动替换（只在旧相机完整退出后执行）：**独立High Accuracy YAML保存了当前流与测距配置，通过现有XML加载；不会隐式启动执行器。现有相机运行时不重复启动；旧终端A先Ctrl+C，确认驱动退出且释放视频设备，至少等5秒。下列启动后还需按31.7开启唯一静止地图、31.8～31.9开启图像与显示桥；不新增导航运动入口。Ctrl+C关闭本终端节点，恢复测距设置仍使用终端R。

```bash
cd /home/jetson/luhao/my_nav_carcar
source /opt/ros/humble/setup.bash
source install/setup.bash
export ROS_DOMAIN_ID=31 ROS_LOCALHOST_ONLY=0 RMW_IMPLEMENTATION=rmw_fastrtps_cpp
export FASTRTPS_DEFAULT_PROFILES_FILE="$PWD/src/carcar_camera/config/fastdds_camera_shm_candidate.xml"
export RMW_FASTRTPS_PUBLICATION_MODE=SYNCHRONOUS
ros2 launch carcar_camera camera_floor_check.launch.xml use_rviz:=false driver_params_file:="$PWD/src/carcar_camera/config/d435_navigation_high_accuracy_rgb_candidate.yaml" filter_params_file:="$PWD/src/carcar_camera/config/depth_filter_stvl_temporal_candidate.yaml" camera_extrinsics_file:="$PWD/src/carcar_description/config/camera_extrinsics_ground98_reapproach_candidate_20261007.yaml"
```

### 31.11 深度配准到 RGB 的显示参照（NAV-016-R2）

用途：原生深度视场约79.44°，RGB约55.56°，31.9两路原生参照不能逐像素对照。新增第三窗`Depth Aligned To RGB`，复用已安装的ROS Humble `depth_image_proc` 3.0.9 C++ RegisterNode（BSD），按原生深度内参、RGB内参和两光心之间的厂内TF投影；本项目只适配显示目标网格，`reference_camera_info`以标准CameraInfo binning指定320×240，保留K/P和采样时间，避免先投到640×480再缩小造成规则空洞。来源与实现：[RegisterNode固定版本](https://github.com/ros-perception/image_pipeline/blob/3.0.9/depth_image_proc/src/register.cpp)、[image_geometry 3.2.1](https://github.com/ros-perception/vision_opencv/blob/3.2.1/image_geometry/src/pinhole_camera_model.cpp)。不复制算法，不改变导航原生深度/点云，不把导航视场裁成RGB范围，不填充无回波深度。

**三窗视场与用途（2026-10-08修订）：**用户已接受原生深度比RGB视野更宽的解释。三窗等大布局只统一屏幕显示尺寸，不能让不同镜头具有相同视场。

| 窗口 | 图像坐标与范围 | 应怎样使用 |
|---|---|---|
| 左：`Depth Wide FOV Reference` | 深度光学坐标系，保留原生宽视场，仅缩小显示 | 与STVL体素观察对应实物；侧边可能有RGB看不到的有效深度，不据RGB缺物删除障碍 |
| 中：`Depth Aligned To RGB` | 把有效深度按两镜头内参和光心TF重投影到RGB网格，超出目标图像边界的深度不显示 | 对照右图中停稳物体的有效轮廓；仅用于显示，不作为导航点云来源 |
| 右：`RGB Scene Reference` | 独立RGB镜头，当前视场较窄 | 认物和配准参照；以后做RGB识别时再匹配相应网格的深度 |

当前导航实验层是 **STVL 2.3.4**，原生 Nav2 `VoxelLayer` 是保留的旧对照入口。导航输入继续来自原生深度生成的 `/camera/depth/points`，经现有过滤成为 `/camera/navigation/obstacles`，保留宽视场但仍执行原有距离、高度和自体过滤；不为了RGB显示裁窄导航视场。配准并非把图片简单拉伸或中心裁剪，原生深度与RGB范围差异本身不能说明TF错误，也不能据此认定整套安装TF已标定。不调整舵机/安装TF来消除镜头视场差异。

[D435官方规格](https://www.realsenseai.com/products/stereo-depth-camera-d435/)列出深度87°×58°、RGB69°×42°，是型号/HD参考；本项目当前深度与RGB均640×480/6 Hz，不直接套用这组参考值。按已保存CameraInfo用 `2×atan(尺寸/(2×焦距))` 估算当前覆盖角：

| 当前原生流 | 尺寸 | fx / fy（像素） | 水平 / 垂直覆盖角（约） |
|---|---|---|---|
| 深度 | 640×480 | 385.1489 / 385.1489 | 79.4° / 63.9° |
| RGB | 640×480 | 607.5086 / 606.4273 | 55.6° / 43.2° |

这是本机内参推算，不是机械测角或完整标定验收；改变流模式后要重新读取CameraInfo。原始证据及官方版本区别见[显示比例与配准依据](archive/2026-10-08-D435图像显示比例与配准依据.md)。

三路显示均320×240/1 Hz，配准窗保留深度采样时间，RGB仍为各自最近帧，并非严格同步；不拿移动物体的两张最近帧测配准误差。当前灰度预览把无效深度0和达到/超过3 m显示上限的值均映射为黑色，不能从黑色证明故障、空闲或导航过滤成功；导航高度/距离过滤不直接作用于这张原生图。需要区分时读取对应原生16UC1深度值及健康诊断，取证入口仍见31.10，不另写一套命令。纹理、阴影不应在深度中复现；High Accuracy会保留真实缺测，不为画面美观开启补洞。配准CameraInfo含binning，旧depth_snapshot不支持此显示网格，不将其用于安装外参拟合。

前提：31.7静止相机/地图、31.9原生深度与RGB压缩参照已启动，RGB有真实输入；31.8域桥依赖与31.9桌面解码插件已部署。先Ctrl+C退出旧配准/配准预览，不能启动两个同话题发布者。无需结束相机或地图，不动舵机、车轮、系统文件。

**终端S（Jetson，构建、验证与配准显示）：**构建新增C++适配和XML；测试在独立域91用合成内参、已知TF与深度点驱动真实RegisterNode，检验输出尺寸和投影位置，是离线回归，不是实机几何验收。发行版配准组件单独进程运行，避免与项目OpenCV4.10混用ABI。预期构建和测试通过，Launch启动三个只读显示节点。错误时Ctrl+C退出本终端，原生两图及地图继续；修复后重新启动本入口，勿重启相机以掩盖失败。

```bash
cd /home/jetson/luhao/my_nav_carcar
source /opt/ros/humble/setup.bash
export CMAKE_BUILD_PARALLEL_LEVEL=1
colcon build --packages-select carcar_camera --executor sequential --parallel-workers 1
source install/setup.bash
ctest --test-dir build/carcar_camera -R '^(test_reference_camera_info|test_image_reference)$' --output-on-failure
export ROS_DOMAIN_ID=31 ROS_LOCALHOST_ONLY=0 RMW_IMPLEMENTATION=rmw_fastrtps_cpp
export FASTRTPS_DEFAULT_PROFILES_FILE="$PWD/src/carcar_camera/config/fastdds_camera_shm_candidate.xml"
export RMW_FASTRTPS_PUBLICATION_MODE=SYNCHRONOUS
ros2 launch carcar_camera image_reference_alignment.launch.xml max_width:=320 max_fps:=1.0
```

**终端I显示桥替换：**桥接完整启动命令只维护在31.8终端I。先Ctrl+C结束旧桥，将`display_bridge_config`选择为`stvl_display_aligned_image_bridge_candidate.yaml`后启动（8个显示话题）。它新增第三路压缩预览，导航数据域31不变；退出桥停止域32更新，不结束地图。不要让旧7话题桥与新桥并行。

**终端T（Hao本地桌面）：**先关闭旧RViz窗口；读取新增配置到主机用户目录，已有同名配置备份。只启动本机图形显示、增加Wi-Fi负载，不在Jetson启动RViz。当前主机为用户确认的`luhao@Hao/192.168.5.17`；不沿用不在现场的bao。预期原生宽视场、RGB配准深度、RGB三窗都有图，体素和二维地图继续显示。异常关闭窗口或Ctrl+C；退回31.9双图入口，原有资产保留。

```bash
cd "$HOME"
source /opt/ros/humble/setup.bash
test ! -f "$HOME/depth_costmap_stvl_aligned_image_reference_candidate.rviz" || cp -a "$HOME/depth_costmap_stvl_aligned_image_reference_candidate.rviz" "$HOME/depth_costmap_stvl_aligned_image_reference_candidate.rviz.$(date +%Y%m%d_%H%M%S).backup"
scp jetson@192.168.5.11:/home/jetson/luhao/my_nav_carcar/src/carcar_navigation/rviz/depth_costmap_stvl_aligned_image_reference_candidate.rviz "$HOME/depth_costmap_stvl_aligned_image_reference_candidate.rviz"
scp jetson@192.168.5.11:/home/jetson/luhao/my_nav_carcar/src/carcar_navigation/config/fastdds_rviz_domain32_candidate.xml "$HOME/carcar_stvl_display_domain32_candidate.xml"
IMAGE_PREFIX="$HOME/.local/share/carcar_image_transport_humble/opt/ros/humble"
export AMENT_PREFIX_PATH="$IMAGE_PREFIX:$HOME/ros_overlay/carcar_description:$AMENT_PREFIX_PATH"
export LD_LIBRARY_PATH="$IMAGE_PREFIX/lib:$LD_LIBRARY_PATH"
export ROS_DOMAIN_ID=32 ROS_LOCALHOST_ONLY=0 RMW_IMPLEMENTATION=rmw_fastrtps_cpp
export FASTRTPS_DEFAULT_PROFILES_FILE="$HOME/carcar_stvl_display_domain32_candidate.xml"
rviz2 -d "$HOME/depth_costmap_stvl_aligned_image_reference_candidate.rviz" --ros-args -r __node:=stvl_aligned_image_reference_rviz
```

**终端U（Jetson，只读核对）：**检查配准输入元数据和实际输出尺寸、frame；核对相机TF。预期目标内参binning=2，输出320×240且frame为camera_color_optical_frame。tf2_echo持续打印，Ctrl+C退出；这些命令不控制硬件。正式健康使用30.17已有完整600秒命令，构建结束且实际三窗订阅建立后计时，不在窗口内改设置。停止顺序T→I→S；只需恢复旧双图时按31.9重新启动显示桥与RViz，不清地图。

```bash
cd /home/jetson/luhao/my_nav_carcar
source /opt/ros/humble/setup.bash
source install/setup.bash
export ROS_DOMAIN_ID=31 ROS_LOCALHOST_ONLY=0 RMW_IMPLEMENTATION=rmw_fastrtps_cpp
export FASTRTPS_DEFAULT_PROFILES_FILE="$PWD/src/carcar_camera/config/fastdds_camera_shm_candidate.xml"
export RMW_FASTRTPS_PUBLICATION_MODE=SYNCHRONOUS
ros2 topic echo /camera/debug/rgb_reference/camera_info --once
ros2 topic echo /camera/debug/depth_rgb_registered/image_rect --once --field width
ros2 topic echo /camera/debug/depth_rgb_registered/image_rect --once --field height
ros2 topic echo /camera/debug/depth_rgb_registered/image_rect --once --field header
ros2 run tf2_ros tf2_echo camera_color_optical_frame camera_depth_optical_frame
```

### 31.12 三个图像窗口等大显示

用途（NAV-016-R2，2026-10-08）：用户已明确误解来自三个窗口大小不同。新增 `depth_costmap_stvl_equal_image_panels_candidate.rviz`，将原生深度、RGB配准深度、RGB固定在底部同一行；使用Qt 5.15.3生成的 `QMainWindow State` 保存窗格布局，复用RViz官方恢复接口。只修改显示布局，相机内参、测距、导航点云、TF和STVL算法保持。三路仍为320×240/1 Hz、Best Effort、Volatile、队列2；体素仍是10000点/1 Hz预览，固定坐标系 `base_footprint`，三维刷新15 Hz，主窗口默认1920×1080。

旧RViz图像渲染区高度实读212、80、146像素，图片等比缩放后屏幕大小仍不同。新配置在Hao恢复后为613×351、614×351、613×351；等分造成1像素宽差，三幅4:3图像均由相同高度限制，显示缩放一致。留边用于保持宽高比，不能拉伸原图填满窗格。原生深度的视场仍比RGB宽，只有中间配准深度与右侧RGB适合比较停稳物体的有效轮廓。原生宽视场与黄色体素继续用于判断RGB范围之外的障碍。

前提：先核对唯一静止相机/模型/过滤/STVL进程。全部退出时按31.7 A/B恢复，A选择31.10的 `d435_navigation_high_accuracy_rgb_candidate.yaml` 与31.7的 `depth_filter_stvl_temporal_candidate.yaml`，外参仍为 `camera_extrinsics_ground98_reapproach_candidate_20261007.yaml`；SDK备份/恢复按31.10。三路图像分别按31.9 L、31.11 S恢复，320目标网格不变；31.8 I选择8话题 `stvl_display_aligned_image_bridge_candidate.yaml`，J保持10000点/1 Hz。不重复启动或沿用旧PID，不开启底盘/舵机。

**终端V（Jetson，安装新增RViz资产）：**读取源码并构建导航包、安装配置，不启动硬件或修改系统文件。构建期间不计健康验收；预期构建成功且安装目录有新配置。失败时Ctrl+C停止构建，旧资产保留；修复后再计健康窗口。

```bash
cd /home/jetson/luhao/my_nav_carcar
source /opt/ros/humble/setup.bash
source install/setup.bash
STVL_PREFIX="$HOME/.local/share/carcar_stvl_humble/opt/ros/humble"
export AMENT_PREFIX_PATH="$STVL_PREFIX:$AMENT_PREFIX_PATH"
export LD_LIBRARY_PATH="$STVL_PREFIX/lib:$STVL_PREFIX/opt/openvdb_vendor/lib:$LD_LIBRARY_PATH"
CMAKE_BUILD_PARALLEL_LEVEL=1 colcon build --packages-select carcar_navigation --executor sequential --parallel-workers 1
test -f install/carcar_navigation/share/carcar_navigation/rviz/depth_costmap_stvl_equal_image_panels_candidate.rviz
```

**终端W（Hao本地桌面，替换显示）：**先关闭旧RViz窗口。下组下载新增配置，已有同名文件先备份；只在用户目录写入RViz与本进程DDS配置，读取ROS和既有图像插件，增加显示负载，不访问串口/执行器。预期底部三窗等大、三路持续更新、中央体素/二维地图可见。No Image、订阅缺失或健康失败时关闭窗口/Ctrl+C并保留证据，车上静止数据继续；旧31.11入口可恢复。显示组件名字参与Qt布局恢复，不随意改名；拖乱后关闭，用同一命令重开。

```bash
cd "$HOME"
source /opt/ros/humble/setup.bash
equal_display_backup_stamp="$(date +%Y%m%d_%H%M%S)"
for display_file in depth_costmap_stvl_equal_image_panels_candidate.rviz carcar_stvl_equal_images_domain32.xml; do
  test ! -f "$HOME/$display_file" || cp -a "$HOME/$display_file" "$HOME/$display_file.$equal_display_backup_stamp.backup"
done
scp jetson@192.168.5.11:/home/jetson/luhao/my_nav_carcar/src/carcar_navigation/rviz/depth_costmap_stvl_equal_image_panels_candidate.rviz "$HOME/depth_costmap_stvl_equal_image_panels_candidate.rviz"
scp jetson@192.168.5.11:/home/jetson/luhao/my_nav_carcar/src/carcar_navigation/config/fastdds_rviz_domain32_candidate.xml "$HOME/carcar_stvl_equal_images_domain32.xml"
IMAGE_PREFIX="$HOME/.local/share/carcar_image_transport_humble/opt/ros/humble"
export AMENT_PREFIX_PATH="$IMAGE_PREFIX:$HOME/ros_overlay/carcar_description:$AMENT_PREFIX_PATH"
export LD_LIBRARY_PATH="$IMAGE_PREFIX/lib:$LD_LIBRARY_PATH"
export ROS_DOMAIN_ID=32 ROS_LOCALHOST_ONLY=0 RMW_IMPLEMENTATION=rmw_fastrtps_cpp
export FASTRTPS_DEFAULT_PROFILES_FILE="$HOME/carcar_stvl_equal_images_domain32.xml"
rviz2 -d "$HOME/depth_costmap_stvl_equal_image_panels_candidate.rviz" --ros-args -r __node:=stvl_equal_image_panels_rviz
```

观察：三窗的有效图像区域应等大，视场及颜色内容差异不等于窗口比例错误。订阅核对复用31.9只读命令，新增配准话题为 `/camera/debug/depth_rgb_reference/compressed`，三路订阅者均应为 `stvl_equal_image_panels_rviz`。健康完整命令复用30.17/31.10，本次60秒只算短窗，不能替代新320配准模式600秒验收。无需重复摆盒或10次撤障。

停止/恢复：关闭W或Ctrl+C先结束显示，恢复旧布局按31.11 T重开；需要全部结束时按31.8、31.7依次退出桥、预览/配准、地图、相机/模型，不发布执行器复位。停止相机不会自动恢复SDK高级测距设置；需要回退测距候选时才按31.10 R完整恢复JSON。若要恢复本组覆盖的用户目录文件，下组只将本终端留存时间戳的完整备份复制回原文件，不影响硬件；先结束W，预期原文件恢复，复制失败就停止，不改用其他未知备份。之后重新运行相应显示启动入口。

```bash
cd "$HOME"
for display_file in depth_costmap_stvl_equal_image_panels_candidate.rviz carcar_stvl_equal_images_domain32.xml; do
  test ! -f "$HOME/$display_file.$equal_display_backup_stamp.backup" || cp -a "$HOME/$display_file.$equal_display_backup_stamp.backup" "$HOME/$display_file"
done
```

官方依据与适用版本见[显示比例与配准依据](archive/2026-10-08-D435图像显示比例与配准依据.md)，结果统一登记NAV-016-R2。

### 31.13 D435 到 Nav2 的数据链路与必要知识

本节按2026-10-08当前源码、候选参数与已有现场记录解释数据用途，不新增启动命令；构建/静止启停沿用31.7～31.12，移动入口只在31.4既有验收前提满足后使用。最初只读核对未见相机、过滤、独立STVL地图或Nav2规划/控制进程，不推断退出原因。随后用户请求打开点云，按31.14恢复静止相机/过滤/STVL及显示；没有启动规划、控制或底盘运动。

#### 静止链路与完整导航的区别

已进行现场观察的是独立静止地图：相机、TF模型、点云过滤、STVL和RViz；没有规划/控制/底盘运动。`/costmap/costmap` 是独立测试地图，不会自动转接给后来启动的导航服务器。完整导航入口 `navigation_depth_stvl.launch.xml` 已实现，让局部/全局地图各自订阅相同深度障碍输入，但移动避障还未验收。

```mermaid
flowchart LR
  A["D435 原生深度 + 内参"] --> B["SDK 原生点云 /camera/depth/points"]
  B --> C["C++过滤：TF检查、范围/高度/自体过滤、时间确认"]
  C --> D["障碍点云 /camera/navigation/obstacles"]
  D --> E["STVL 三维体素 + 时间衰减"]
  E --> F["二维障碍地图 + 膨胀层"]
  F --> G["独立静止地图 /costmap/costmap"]
  D -. "完整导航入口，实车待验" .-> H["局部/全局STVL与融合地图"]
  H -.-> I["规划 → 控制 → 平滑 → 运动联锁 → 底盘"]
```

1. **从深度图片变成点云。** 原生16UC1深度图存毫米深度，CameraInfo内参说明像素如何对应相机射线，SDK据此输出XYZ三维测量点。当前静止候选深度640×480/6 Hz、High Accuracy=3；SDK空间/时域/补洞关闭。RGB和彩色配准图是旁路显示，不作为导航点云来源。输入话题由相机XML remap为 `/camera/depth/points`，保留深度光学坐标与采样时间。
2. **先判断哪些点像障碍。** `depth_cloud_filter` 用采样时刻的TF，把点换算到 `base_footprint` 判断离地高度、自体包络与时间确认；拒绝无效/过期输入。当前静止候选源光心斜距0.3～2 m、离地1.5～26 cm、排除车身，2 cm格内最近3帧至少2帧命中才标障。原始XYZ/header仍以光学坐标发布，后续STVL依据TF放进地图；不能把“用车体坐标筛选”误解为输出已改成车体坐标。
3. **STVL保存带时间的三维障碍。** `carcar_navigation::MonitoredStvlLayer` 动态链接上游STVL 2.3.4，本项目只加消费健康诊断。静止图体素2 cm、线性衰减2秒，近源0.85 m内接收1.5～26 cm、普通源2 m内接收5～26 cm。因此2 cm小目标只有近源配置适用，不是整个2 m范围都已保证检出。本轮源均 `marking:true, clearing:false`，不启视锥加速；移物后没有新点继续更新，旧观测靠时间衰减退出。过滤器仍发布 `/camera/navigation/clearing`，但本轮STVL未使用它，不应套用旧VoxelLayer逐射线清除的解释。
4. **三维障碍变成二维导航代价。** 体素按配置的柱门槛产生地面XY障碍位置，二维地图标为不可通行；膨胀层在周围生成逐渐减小的代价，帮助路径保持距离。黄色盒块是RViz三维体素显示；二维致命/膨胀颜色由costmap显示色表决定，膨胀区域不是实物尺寸。静止图4×4 m、二维格2 cm、更新/发布5 Hz，膨胀半径0.20 m。格子尺寸表示记录分辨率，不证明同尺寸物体可可靠探测。
5. **进入完整导航后地图各有职责。** 当前代码局部地图以odom为坐标系、二维格5 cm、更新5 Hz，深度体素2 cm/衰减2秒；全局以map为坐标系、二维格5 cm、更新3 Hz，深度体素2 cm/衰减5秒。全局融合静态地图、激光ObstacleLayer、STVL及膨胀层供规划器选路径；局部融合激光、STVL及膨胀供DWB控制器检查短时轨迹、生成速度。深度接入的是避障代价，不是把RGB送入AMCL，也不修改原静态地图文件。
6. **数据健康控制能否运动。** 完整入口启用 `depth_layer_supervisor` 的 `required_stvl` 模式：既看相机新鲜度，又看局部/全局STVL确实消费新数据、推进更新序号。经连续3秒健康恢复才允许 `/navigation/perception_motion_allowed`；运动联锁要求0.30秒内持续允许心跳，异常/失联锁停，BT感知等待中保留有效任务，取消任务不会自动重发。正常控制速度经 `/cmd_vel_nav` → 平滑器 `/cmd_vel_smoothed_raw` → 联锁 `/cmd_vel` → 底盘。仅RViz能显示或点云话题有发布者不能证明这个运动联锁已实车验收。

#### 当前必须分清的知识点

- **TF与像素配准负责不同问题。** 深度/RGB光心之间的TF用于两镜头像素对照；车体与相机的安装TF用于判断一个点离地多高、在车前还是车侧。前者画面对应不证明后者已标定。只考虑角误差，距离1 m处1°偏差约造成1.7 cm高度误差，已接近本项目2 cm目标高度。
- **深度光学轴与车体轴不同。** 光学系通常X右、Y下、Z前；车体系X前、Y左、Z上。先通过TF再判断离地高度，不能直接把原深度点的Z当作离地高度。
- **测量、过滤、记忆、显示有不同频率与用途。** 相机6 Hz采样、地图3/5 Hz更新、域桥预览1 Hz限流，预览/压缩图只供人看。导航在车上域31消费完整输入；域32只接显示桥，RViz不是避障算法，也不能按1 Hz截图精确计撤障耗时。
- **黑色缺测、过滤掉的点与衰减掉的体素都不直接证明空闲。** 黑色判读见31.11；过滤有具体范围和高度门槛；衰减表示观测变旧，遮挡中的真实物体也会被遗忘。必须结合健康、有效观测与场景解释。

#### 舵机角度的证据层级

当前姿态的权威记录是硬件台账及测试记录NAV-016-R2，软件候选为 `src/carcar_description/config/camera_extrinsics_ground98_reapproach_candidate_20261007.yaml`。截至上次有效测量，最后发送命令98档；2026-10-07近距水平地面30帧拟合下俯约4.7217°，退出后6帧约4.7232°，软件pitch设0.082409473941 rad。98是控制板命令值，不是相对平视98°；估计的是光轴相对水平面的姿态，不是舵机输出轴机械角反馈。

该候选仍 `verified:false`、`servo_position_feedback:false`、`command_angle_repeatability_verified:false`，且高度为地面一致性补偿，x/y/roll/yaw未完整标定。一轮98往返接近不能抵消94同档曾变化的失败。相机/车体实体姿态、供电或初始化改变后，旧角度不能自动沿用。最初核对时相机未运行，后续为点云显示恢复静止相机，但没有重新做角度拟合，所以只能回答“有约下俯4.72°的历史数据推算，尚无当前精确机械角确认”。可以保持当前实体位置用于静止候选联调，不称避障最优。重新核对角度应优先保持舵机不动做只读近距水平地面拟合，按29.7/30.15已有完整操作及安全前提执行，不启动键盘或底盘制造新姿态。

`navigation_depth_stvl.launch.xml` 不会自动选择本次安装候选；移动前须显式加载与实物姿态相符的TF并验证。底盘启动可能发送S1=94，必须核对启动后实体姿态，不能把静止98候选直接用于已复位姿态。完整导航仍受31.4既有验收门槛约束。

源码入口：`src/carcar_camera/src/depth_cloud_filter.cpp`、`src/carcar_camera/config/depth_filter_stvl_temporal_candidate.yaml`、`src/carcar_navigation/config/depth_costmap_stvl_static.yaml`、`src/carcar_navigation/config/nav2_depth_stvl_experimental.yaml`、`src/carcar_camera/src/depth_layer_supervisor.cpp`、`src/carcar_navigation/include/carcar_navigation/navigation_motion_gate.hpp`。成熟框架来源及固定版本见[STVL接入依据](archive/D435_STVL接入依据_20261006.md)；本轮重读[固定STVL衰减实现](https://github.com/SteveMacenski/spatio_temporal_voxel_layer/blob/92896fe9ea994260bf34f1fa7b7735f3804cfc6f/spatio_temporal_voxel_layer/src/spatio_temporal_voxel_grid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)及[Nav2 Humble膨胀层接口](https://api.nav2.org/nav2-humble/html/classnav2__costmap__2d_1_1InflationLayer.html)，未照搬其他发行版参数或新增算法。

### 31.14 打开原生深度点云预览

用途：应用户要求，在Hao的RViz中央三维窗显示相机原生测量点，保留底部等大的三幅图像、黄色STVL体素和二维地图。点云是测量到的表面点；体素是算法保存的离散障碍记忆，两者不能混看为同一数据。新增 `depth_costmap_stvl_depth_cloud_preview_candidate.rviz` 与9话题 `stvl_display_depth_cloud_bridge_candidate.yaml`，原配置保留。

**怎么看：**左侧Displays勾选 **Depth Cloud Preview 1Hz**，取消勾选即可隐藏。它订阅 `/camera/debug/points`，是 `/camera/depth/points` 的最多8000点/1 Hz均匀抽样旁路，不是经过导航高度过滤的障碍输入。XYZ仍为深度光学系，RViz通过TF放到 `base_footprint`；颜色按该固定坐标系的Z高度着色，固定范围−0.05～0.35 m，超范围颜色饱和，不是RGB实物颜色。点大小2像素、透明度0.75、Decay Time=0不累积历史帧；黄色方块 **STVL Timed Voxels** 是另一显示项。窗口透视缩放不是距离测量，三张图像仍320×240/1 Hz；每路最新帧不保证严格同步。

前提：相机与车体保持固定、轮动力隔离。31.7 A已经自带唯一 `depth_cloud_preview` 原生旁路，不重复启动它。若车上静止进程全部退出，SDK先按31.10备份，再按31.12前提恢复相机/模型/过滤、STVL、三路图像及10000点体素预览。沿用当前候选安装TF，不启动底盘/舵机；无重新角度拟合，不新增实物角度确认。构建复用31.12 V；显示桥完整命令只在31.8 I，将其选择为本节9话题配置，先Ctrl+C结束旧桥，保持一个桥实例。车上域31不变，域32仅增加抽样点云，不桥接全量原始点云或控制接口。

**终端X（Hao本地桌面，打开点云配置）：**先关闭旧RViz窗口。下组读取项目配置、ROS环境和既有显示插件，只在主机用户目录写入备份与显示配置；增加Wi-Fi/图形显示负载，不访问串口或驱动执行器。预期中央彩色测量点、黄色体素和底部三图可见。异常关闭窗口/Ctrl+C停止显示，保留报错，按31.12 W恢复三图布局；车上静止数据继续运行。已有同名文件先完整备份，不覆盖唯一历史副本。

```bash
cd "$HOME"
source /opt/ros/humble/setup.bash
cloud_display_backup_stamp="$(date +%Y%m%d_%H%M%S)"
for display_file in depth_costmap_stvl_depth_cloud_preview_candidate.rviz carcar_stvl_cloud_domain32.xml; do
  test ! -f "$HOME/$display_file" || cp -a "$HOME/$display_file" "$HOME/$display_file.$cloud_display_backup_stamp.backup"
done
scp jetson@192.168.5.11:/home/jetson/luhao/my_nav_carcar/src/carcar_navigation/rviz/depth_costmap_stvl_depth_cloud_preview_candidate.rviz "$HOME/depth_costmap_stvl_depth_cloud_preview_candidate.rviz"
scp jetson@192.168.5.11:/home/jetson/luhao/my_nav_carcar/src/carcar_navigation/config/fastdds_rviz_domain32_candidate.xml "$HOME/carcar_stvl_cloud_domain32.xml"
IMAGE_PREFIX="$HOME/.local/share/carcar_image_transport_humble/opt/ros/humble"
export AMENT_PREFIX_PATH="$IMAGE_PREFIX:$HOME/ros_overlay/carcar_description:$AMENT_PREFIX_PATH"
export LD_LIBRARY_PATH="$IMAGE_PREFIX/lib:$LD_LIBRARY_PATH"
export ROS_DOMAIN_ID=32 ROS_LOCALHOST_ONLY=0 RMW_IMPLEMENTATION=rmw_fastrtps_cpp
export FASTRTPS_DEFAULT_PROFILES_FILE="$HOME/carcar_stvl_cloud_domain32.xml"
rviz2 -d "$HOME/depth_costmap_stvl_depth_cloud_preview_candidate.rviz" --ros-args -r __node:=stvl_depth_cloud_preview_rviz
```

**终端Y（Hao，只读观察）：**下组读取点云发布/订阅QoS、采样坐标及预览点数，帮助区分没桥接、QoS不匹配和缺TF；不修改硬件或参数。预期域32一个桥发布者、一个RViz订阅者均Best Effort/Volatile，frame为 `camera_depth_optical_frame`，height=1且width不超过8000。只有抽样点数，不能据此计算完整目标检出率。命令完成自动退出，等待过久Ctrl+C停止，检查31.8的桥配置和RViz状态，勿启动底盘排错。

```bash
cd "$HOME"
source /opt/ros/humble/setup.bash
export ROS_DOMAIN_ID=32 ROS_LOCALHOST_ONLY=0 RMW_IMPLEMENTATION=rmw_fastrtps_cpp
export FASTRTPS_DEFAULT_PROFILES_FILE="$HOME/carcar_stvl_cloud_domain32.xml"
ros2 topic info -v /camera/debug/points
ros2 topic echo /camera/debug/points --once --field header
ros2 topic echo /camera/debug/points --once --field width
ros2 topic echo /camera/debug/points --once --field height
```

健康取证完整命令仍维护在30.17，实际点云订阅建立后计时；60秒只算新增显示负载短窗，不替代600秒或目标避障验收。停止X即可停止主机订阅；全部停止沿用31.12顺序，不发送舵机复位。仅回到三图时先关X，将31.8 I改回8话题桥并按31.12 W重开；配置回退保持原资产。需要恢复本节覆盖的用户目录文件时，下组仅复制本终端留存时间戳的备份，先关X；预期恢复旧内容，备份不存在或失败时停下保留当前文件，不选未知备份。

```bash
cd "$HOME"
for display_file in depth_costmap_stvl_depth_cloud_preview_candidate.rviz carcar_stvl_cloud_domain32.xml; do
  test ! -f "$HOME/$display_file.$cloud_display_backup_stamp.backup" || cp -a "$HOME/$display_file.$cloud_display_backup_stamp.backup" "$HOME/$display_file"
done
```

实际画面、QoS与短窗健康结果统一登记NAV-016-R2。

### 31.15 断电或硬件移动后重新核对平视角

2026-10-08用户反馈发生断电/重启或不确定硬件动了哪里，确认四轮落在水平瓷砖、轮动力隔离，要求重启相关进程并重新确定相机平视角。历史键盘最后目标 **146.5°**，实际板端命令 **98**（原始日志 `log/stvl_ground_angle_20261007_01/keyboard.log` 与 `reapproach_step5_command.txt`）。这两个数是程序目标和完整下发值；无位置反馈，断电/重启后不能把它们当当前位置。旧相机光轴下俯约4.72°是另一项历史地面估算。

**为何换显示参考：**原安装候选已补偿俯仰，倾斜相机看到的地面也会在RViz中摆平。因此本次使用 `camera_extrinsics_floor_reference_20261007.yaml` 的零roll/pitch/yaw参考，而非旧4.72°补偿。参考高度165 mm仍是历史粗量，只影响地面相对网格的上下偏移，不把地面与网格重合作为验收；观察的是地面是否平行以及数值斜率。该参考不是当前已标定TF，车模相机在软件中画成水平也不代表实物水平。

当前显示使用 `camera_floor_zero_pitch_reference_20261008.rviz`，默认侧视XZ；可在Views选择保存的 **Side XZ**，避免透视旋转误导。灰网格为 `base_footprint` 的Z=0参考、格宽2 cm；彩色散点来自原生深度8000点/1 Hz抽样，按固定坐标系Z高度着色（−0.05～0.35 m），不是RGB颜色。测量继续用原始数据。零参考下 `atan(slope_x)` 给近距地面推算俯仰；仅在水平、空净地面且拟合偏差小、连续帧一致时才解释为相机角。沿左右方向的斜率另检查横滚，地面无法确认yaw及完整x/y安装位置。

前提：停止旧相机/模型、图像预览、STVL、显示桥与RViz，等待USB释放，禁止只杀会自动重启的相机子进程；保留原日志。断电后查看当前进程，不沿用旧PID。相机/支架保持停稳，水平地面前方约0.5～1.2 m中央无盒、卷尺、脚或手。正常步骤不发舵机/车轮命令，不启动底盘或键盘。当前代理恢复的是相机/模型/过滤/抽样点云与4话题显示桥；过滤输出不供导航使用，STVL/导航暂关。

**终端A（Jetson，零旋转参考相机）：**构建按31.7 A在采样之前完成，SDK高级设置备份/回退仅按31.10执行，不重复维护命令。以下读取候选驱动、USB和参考TF，启动静止模型与相机，不占控制串口；预期640×480/6 Hz点云与唯一模型持续发布。启动异常Ctrl+C停止整个Launch，保留日志和未完成采样，不放宽健康门槛，不用底盘初始化恢复。再启动前确认USB无人占用。

```bash
cd /home/jetson/luhao/my_nav_carcar
source /opt/ros/humble/setup.bash
source install/setup.bash
export ROS_DOMAIN_ID=31 ROS_LOCALHOST_ONLY=0 RMW_IMPLEMENTATION=rmw_fastrtps_cpp
export FASTRTPS_DEFAULT_PROFILES_FILE="$PWD/src/carcar_camera/config/fastdds_camera_shm_candidate.xml"
export RMW_FASTRTPS_PUBLICATION_MODE=SYNCHRONOUS
ros2 launch carcar_camera camera_floor_check.launch.xml use_rviz:=false \
  camera_extrinsics_file:="$PWD/src/carcar_description/config/camera_extrinsics_floor_reference_20261007.yaml" \
  filter_params_file:="$PWD/src/carcar_camera/config/depth_filter_stvl_temporal_candidate.yaml" \
  driver_params_file:="$PWD/src/carcar_camera/config/d435_navigation_high_accuracy_rgb_candidate.yaml"
```

**终端B（Jetson，仅显示桥）：**官方domain_bridge0.5.0用户目录依赖按31.8部署。下组仅桥接抽样点云、TF/静态TF和车模四个话题，域31→32；不桥接地图、控制接口或全量点云。增加局域网负载，不驱动执行器。预期主机可订阅 `/camera/debug/points`；Ctrl+C停止B只停止显示转发。异常保留报错并检查唯一桥实例，原显示桥不并行运行。

```bash
cd /home/jetson/luhao/my_nav_carcar
source /opt/ros/humble/setup.bash
source install/setup.bash
BRIDGE_PREFIX="$HOME/.local/share/carcar_domain_bridge_humble/opt/ros/humble"
export AMENT_PREFIX_PATH="$BRIDGE_PREFIX:$AMENT_PREFIX_PATH"
export LD_LIBRARY_PATH="$BRIDGE_PREFIX/lib:$LD_LIBRARY_PATH"
export ROS_DOMAIN_ID=31 ROS_LOCALHOST_ONLY=0 RMW_IMPLEMENTATION=rmw_fastrtps_cpp
export FASTRTPS_DEFAULT_PROFILES_FILE="$PWD/src/carcar_camera/config/fastdds_camera_shm_candidate.xml"
export RMW_FASTRTPS_PUBLICATION_MODE=SYNCHRONOUS
ros2 launch carcar_navigation stvl_display_bridge_candidate.launch.xml \
  config_file:="$PWD/src/carcar_camera/config/floor_reference_display_bridge_candidate.yaml"
```

**终端C（Hao本地桌面，零俯仰参考显示）：**先关旧RViz；下组只在主机用户目录备份/下载显示配置，读取ROS和既有车模覆盖，运行本机图形显示。预期Preview Depth Height状态OK、侧视可对照地面斜率；当前不显示旧地图或三张图像。异常关闭窗口/Ctrl+C，车上相机继续；旧三图资产保留，姿态重新确认之前不恢复其旧补偿TF。

```bash
cd "$HOME"
source /opt/ros/humble/setup.bash
level_display_backup_stamp="$(date +%Y%m%d_%H%M%S)"
for display_file in camera_floor_zero_pitch_reference_20261008.rviz carcar_floor_reference_domain32.xml; do
  test ! -f "$HOME/$display_file" || cp -a "$HOME/$display_file" "$HOME/$display_file.$level_display_backup_stamp.backup"
done
scp jetson@192.168.5.11:/home/jetson/luhao/my_nav_carcar/src/carcar_camera/rviz/camera_floor_zero_pitch_reference_20261008.rviz "$HOME/camera_floor_zero_pitch_reference_20261008.rviz"
scp jetson@192.168.5.11:/home/jetson/luhao/my_nav_carcar/src/carcar_navigation/config/fastdds_rviz_domain32_candidate.xml "$HOME/carcar_floor_reference_domain32.xml"
export AMENT_PREFIX_PATH="$HOME/ros_overlay/carcar_description:$AMENT_PREFIX_PATH"
export ROS_DOMAIN_ID=32 ROS_LOCALHOST_ONLY=0 RMW_IMPLEMENTATION=rmw_fastrtps_cpp
export FASTRTPS_DEFAULT_PROFILES_FILE="$HOME/carcar_floor_reference_domain32.xml"
rviz2 -d "$HOME/camera_floor_zero_pitch_reference_20261008.rviz" --ros-args -r __node:=floor_zero_pitch_reference_rviz
```

**定量观察：**TF只读核对复用31.11 U，将两个frame改为 `base_link camera_link`，预期RPY全0；图中物理角仍由深度拟合推算。采样/拟合完整命令只维护29.5 E，先清场，sample_frames=30且保持参考TF，输出新目录；同时用30.17健康命令，duration_s=60作配套短窗。采样失败、RMS明显高于原近距约1 mm水平、场景不净或帧间不一致时保留结果，不给可靠角度、不裁掉异常高度来制造成功。短窗健康不能代替角度、重复性或600秒验收。

若当前角度接近平视且地面拟合可靠，先记录当前姿态，不为取得一个“已下发档位”而重新初始化。若需要实际调舵机，使用29.5已有C++入口及安全前提，明确它启动会下发平视默认目标140.5°／板端94，并刷新底盘零运动；执行器可能突然转动，现场保持扫掠无遮挡、可立即切断舵机实际电源，异常先断电再q/Ctrl+C。每次只变一个板端档，停稳后重新测量；调角期间不启STVL。回到相同命令仍需检查角度是否重复，最后记录键盘目标、板端命令、地面推算和现场反馈四项。

2026-10-08用户随后明确授权逐步试探并逐步记录下发值。清场后重启当前姿态30帧估计下俯约6.21°、当前命令未知；使用既有C++键盘初始化第一步140.5°／板端94后，6帧估计约0.10°，保持该档30帧复测约0.094°，作为本次近平视基线。用户确认相机转动停稳、无碰撞/异响、车轮未动；键盘正常q退出、不追加S1命令。每步在独立目录保存完整下发话题缓存、键盘目标日志、原始点CSV、地面拟合与配套健康；汇总 `log/stvl_level_recheck_20261008_01/servo_steps/angle_log.csv`。日期与现场条件、可靠角度范围和退出后复测状态以测试记录NAV-016-R2为准；不得用旧档位线性角度模型代替实际测量。

停止/恢复：先关C，再Ctrl+C B、采样/健康，最后A；当前代理运行的Launch可按下面检查并结束，它只匹配零参考相机与本节4话题桥。它会释放USB并停止点云，舵机实体保持，不发复位；无匹配则不执行kill。若异常退出保留日志，恢复按A/B/C重开，不启动底盘。姿态通过后另存新安装候选再恢复31.14显示/静止地图，不能无条件加载旧4.72°候选。用户目录配置覆盖回退按31.14相同备份复制方式执行，文件名使用本节两个文件和 `level_display_backup_stamp`。

```bash
cd /home/jetson/luhao/my_nav_carcar
source /opt/ros/humble/setup.bash
level_camera_pid="$(pgrep -f '^/usr/bin/python3 /opt/ros/humble/bin/ros2 launch carcar_camera camera_floor_check.launch.xml .*camera_extrinsics_floor_reference_20261007.yaml' || true)"
level_bridge_pid="$(pgrep -f '^/usr/bin/python3 /opt/ros/humble/bin/ros2 launch carcar_navigation stvl_display_bridge_candidate.launch.xml .*floor_reference_display_bridge_candidate.yaml' || true)"
test -z "$level_bridge_pid" || kill -INT $level_bridge_pid
test -z "$level_camera_pid" || kill -INT $level_camera_pid
```

剩余验收按顺序推进：当前姿态/保持与重启重复性 → 正确TF下的地面误标与2 cm小障碍/边缘/遮挡 → 轮动力隔离的Nav2全局/局部地图与感知失联联锁 → 低速移动停车。RViz画面认可作为定性现场反馈，不替代这些不同测试；不恢复用户取消的10次逐次撤障反馈要求。历史失败和本次全部原始证据统一见NAV-016-R2。

### 31.16 94档近平视与100刷新率的静止STVL验收

范围：2026-10-08用户指定RViz的 **Global Options → Frame Rate=100**，选择只验静止STVL的标障、撤障、空地误标和数据健康，不启动Nav2运动链路。它是RViz尝试渲染的刷新率，相机仍640×480/6 Hz、三张压缩图与抽样点云仍1 Hz、地图仍5 Hz；官方Humble实现见[VisualizationManager](https://github.com/ros2/rviz/blob/humble/rviz_common/src/rviz_common/visualization_manager.cpp)。新配置 `depth_costmap_stvl_level94_acceptance_100fps_candidate.rviz` 固定保存100；项目AGENTS记录后续新/修改配置同样保存100，旧低刷新测试资产与失败保留，不将100误用为舵机目标。

本轮保持键盘目标140.5°／板端94，不再打开串口。新 `camera_extrinsics_level94_ground_candidate_20261008.yaml` 根据本次30帧中央近距地面平面计算roll/pitch与高度一致性补偿：roll约0.291386°、pitch约0.093673°、光心参考补偿高度158.830166 mm，base_link下z128.830166 mm。x/y/yaw沿用参考，verified=false，重复性与完整安装标定仍待。高度不是尺量，补偿不改变实物角度；旧98档候选不用于当前94姿态。独立C++证据工具与原始30帧全部保留，无高度删点；离线校验只算离线，实时复核结果见NAV-016-R2。

**怎么看：**固定系 `base_footprint`，灰网格参考地面；Depth Cloud Preview 1Hz为最多8000点的原生测量，颜色按固定系Z高度、无历史累积，不是RGB颜色。STVL Timed Voxels黄色立体方块为最多10000点/1 Hz障碍记忆；2 cm体素合并多点，不要求逐点一致。二维致命格与周围膨胀代价是规划障碍投影，膨胀不是盒子实物尺寸。底部原生宽视场、RGB配准深度、RGB均320×240/1 Hz，等高布局保持原图比例；近帧不严格同步，黑色不等于可通行。不能把原生彩色散点、真实墙体或墙原有膨胀当盒子撤走后的残留。

| 部分 | 现场操作及观察 | 本轮通过判据 | 不算通过的情况 |
|---|---|---|---|
| 安装参考 | 相机/车体固定，读取新候选下干净水平地面 | 中央近场高度接近0、拟合稳定，确认当前板端94有记录 | 靠旧98补偿或只看车模水平；近场结果外推边缘/2 m |
| 空地基线 | 保持盒子、人、手、卷尺离开已确认空地120秒 | 所验证区域无持续/反复新体素或二维致命格；原始低地面点允许存在 | 墙体也要求清空；原生散点当标障；未确认实物就判假障碍 |
| 普通盒保持 | 此前约15.5 cm正面盒子，镜头前约0.7 m放稳，手退出60秒 | 原始/过滤输入持续有效，目标三维体素及二维致命格持续存在，位置与实物相符 | 仅膨胀区域存在、盒子未动却持续掉标、TF位置明显错开 |
| 自然撤障 | 完全移走盒子和手，保持该区域空净120秒 | 目标体素、二维致命格及新增膨胀恢复原基线；真实原生地图数据量化目标≤3秒 | 用1 Hz截图精确计时、关闭显示/清图/重启冒充清除、消失后反复重生 |
| 组合健康 | 当前固定显示组合及录包600秒，不在窗口改参数/重启 | 原生点云≥5 Hz，接收间隔≤0.5秒，诊断0异常；STVL source_current持续true、更新序号持续推进 | 仅RViz状态OK、只有发布者、短窗冒充600秒、失败后只留好帧 |

STVL仍2秒线性衰减、clearing=false，旧观测的时间衰减机制来自[固定2.3.4实现](https://github.com/SteveMacenski/spatio_temporal_voxel_layer/blob/92896fe9ea994260bf34f1fa7b7735f3804cfc6f/spatio_temporal_voxel_layer/src/spatio_temporal_voxel_grid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)。3秒为本项目静止目标的验收门槛，需考虑过滤确认、地图更新时间并用原生header审计；聊天反馈到达时间不作为实物撤除精确时间，不从单次观测给P95。遮挡时真实障碍也可能过期，不据自然衰减通过判遮挡安全。此轮普通盒不替代2 cm、边缘、材质/盲区及低速移动验收，不恢复用户取消的10次逐次反馈。

前提：四轮落地、水平地面、轮动力隔离、当前94姿态固定；相机/过滤/唯一模型及显示桥不重复启动。源相机与过滤沿用31.15参数，新模型必须使用本节94候选。当前代理已切换唯一模型并恢复地图/显示，用户直接观察现有Hao窗口。若冷启动，按31.7 A构建/安全说明后用下组新姿态入口；依赖安装按31.1/31.8。SDK备份/恢复只按31.10，模型标定和健康取证不与构建同时进行。

**终端A（Jetson，仅静止感知）：**读取USB、发布模型/点云，保留既有候选测距与时间确认过滤，不访问控制串口。预期唯一模型加载94新候选，原生/过滤持续更新；启动异常Ctrl+C退出整个Launch，保留日志，不能启动底盘初始化来恢复姿态。此处不加载旧98候选。

```bash
cd /home/jetson/luhao/my_nav_carcar
source /opt/ros/humble/setup.bash
source install/setup.bash
export ROS_DOMAIN_ID=31 ROS_LOCALHOST_ONLY=0 RMW_IMPLEMENTATION=rmw_fastrtps_cpp
export FASTRTPS_DEFAULT_PROFILES_FILE="$PWD/src/carcar_camera/config/fastdds_camera_shm_candidate.xml"
export RMW_FASTRTPS_PUBLICATION_MODE=SYNCHRONOUS
ros2 launch carcar_camera camera_floor_check.launch.xml use_rviz:=false \
  camera_extrinsics_file:="$PWD/src/carcar_description/config/camera_extrinsics_level94_ground_candidate_20261008.yaml" \
  filter_params_file:="$PWD/src/carcar_camera/config/depth_filter_stvl_temporal_candidate.yaml" \
  driver_params_file:="$PWD/src/carcar_camera/config/d435_navigation_high_accuracy_rgb_candidate.yaml"
```

地图完整命令只维护31.7 B，体素预览31.8 J、9话题桥31.8 I选择31.14候选，图像预览31.9 L与配准31.11 S。使用这些入口的实际参数，不更改体素TTL、高度或健康门槛。先启动各源并确认订阅，再开始600秒计时。

**终端C（Hao本地桌面，100刷新配置）：**先关旧RViz。以下只下载用户目录显示/DDS配置，已有文件完整备份；读取ROS和现有图像插件、车模覆盖，增加主机GPU/网络负载，不访问串口或驱动硬件。预期Frame Rate显示100、三图和地图持续更新；实际fps可低于设定值。异常关闭窗口/Ctrl+C，保留失败，本轮不擅自把100降低；源数据继续，恢复使用同一入口。旧显示资产保留。

```bash
cd "$HOME"
source /opt/ros/humble/setup.bash
stvl100_backup_stamp="$(date +%Y%m%d_%H%M%S)"
for display_file in depth_costmap_stvl_level94_acceptance_100fps_candidate.rviz carcar_stvl100_domain32.xml; do
  test ! -f "$HOME/$display_file" || cp -a "$HOME/$display_file" "$HOME/$display_file.$stvl100_backup_stamp.backup"
done
scp jetson@192.168.5.11:/home/jetson/luhao/my_nav_carcar/src/carcar_navigation/rviz/depth_costmap_stvl_level94_acceptance_100fps_candidate.rviz "$HOME/depth_costmap_stvl_level94_acceptance_100fps_candidate.rviz"
scp jetson@192.168.5.11:/home/jetson/luhao/my_nav_carcar/src/carcar_navigation/config/fastdds_rviz_domain32_candidate.xml "$HOME/carcar_stvl100_domain32.xml"
IMAGE_PREFIX="$HOME/.local/share/carcar_image_transport_humble/opt/ros/humble"
export AMENT_PREFIX_PATH="$IMAGE_PREFIX:$HOME/ros_overlay/carcar_description:$AMENT_PREFIX_PATH"
export LD_LIBRARY_PATH="$IMAGE_PREFIX/lib:$LD_LIBRARY_PATH"
export ROS_DOMAIN_ID=32 ROS_LOCALHOST_ONLY=0 RMW_IMPLEMENTATION=rmw_fastrtps_cpp
export FASTRTPS_DEFAULT_PROFILES_FILE="$HOME/carcar_stvl100_domain32.xml"
rviz2 -d "$HOME/depth_costmap_stvl_level94_acceptance_100fps_candidate.rviz" --ros-args -r __node:=stvl_level94_acceptance_rviz
```

**取证与停止：**健康600秒完整命令复用30.17、录包复用31.7 E。当前空场输入窗口120秒复用31.7 F，取center_x=0.8、center_y=0、half_width=0.15、min_z=0.015、max_z=0.26；工具半宽上限0.2 m，不以扩大工具限制代替地图全视场审计。盒子放置后按真实位置选择ROI，标明点云输入裁剪与地图裁剪区别，固定后再采保持/撤障；二维/三维审计只使用封存原生bag，完整命令31.7审计段。异常保留失败/未完成包，不选好帧覆盖。

先关闭C，Ctrl+C结束健康/输入窗口与录包，等待封包，再退出桥、预览/配准、STVL，最后相机/模型；停止不发送S1复位。用户目录配置回退按31.14备份复制方法，用本节两文件及 `stvl100_backup_stamp`。需要退回测角时退出地图并按31.15加载零旋转参考；使用新增 `camera_floor_zero_pitch_reference_100fps_candidate.rviz` 保持100，旧10刷新文件作为历史保留。测距设置回退仅按31.10完整JSON恢复，姿态不确定时不恢复旧98候选。

现场反馈、原生数据审计与未通过项统一登记NAV-016-R2。静止各项通过后只能推进轮动力隔离的完整Nav2地图/失联联锁验收；移动仍有独立门槛。

**连续图层诊断补证（Jetson，单独终端）：**源点云健康PASS还不能证明地图持续更新。若更换录包留下时间空档，保留原包，新增整段图层诊断包并与30.17的600秒健康窗配对。以下仅读取诊断、增加少量磁盘负载，不改变感知参数或访问控制串口；预期所有source_current=true、update_seq推进。开始录包后再启健康窗，窗完成再Ctrl+C正常封包；异常原样保留，不能拼接不同启动周期或重置计时。目录使用新时间戳，不覆盖历史失败。

```bash
cd /home/jetson/luhao/my_nav_carcar
source /opt/ros/humble/setup.bash
source install/setup.bash
export ROS_DOMAIN_ID=31 ROS_LOCALHOST_ONLY=0 RMW_IMPLEMENTATION=rmw_fastrtps_cpp
export FASTRTPS_DEFAULT_PROFILES_FILE="$PWD/src/carcar_camera/config/fastdds_camera_shm_candidate.xml"
export RMW_FASTRTPS_PUBLICATION_MODE=SYNCHRONOUS
diagnostic_bag_dir="$PWD/log/stvl_diag600_$(date +%Y%m%d_%H%M%S)"
ros2 bag record -o "$diagnostic_bag_dir" /costmap/depth_stvl/diagnostics \
  /camera/navigation/diagnostics /camera/navigation/healthy
```

本次固定证据目录中C++离线审计的完整复核如下。先确保健康窗/录包均已结束，不在健康窗期间编译；仅读封存包和CSV，写全新审计目录，不回放、不发布、不控制硬件。预期复现60秒保持与撤障约2.54/2.74秒的原生计数及图层诊断；结果只复核该场景，不扩大为完整外参/移动通过。异常Ctrl+C停止，保留输出；重新执行使用新的目录，原始数据不修改。

```bash
cd /home/jetson/luhao/my_nav_carcar
source /opt/ros/humble/setup.bash
source install/setup.bash
evidence_root="$PWD/log/stvl_level94_acceptance_20261008_01"
audit_out="$evidence_root/review_$(date +%Y%m%d_%H%M%S)"
mkdir "$audit_out"
g++ -std=c++17 -O2 "$evidence_root/summarize_hold.cpp" -o "$audit_out/summarize_hold"
g++ -std=c++17 -O2 "$evidence_root/audit_withdraw.cpp" -o "$audit_out/audit_withdraw"
g++ -std=c++17 -O2 \
  $(sed -n 's/^CXX_INCLUDES = //p' build/carcar_camera/CMakeFiles/depth_stvl_audit.dir/flags.make) \
  -isystem /opt/ros/humble/include/diagnostic_msgs "$evidence_root/audit_layer.cpp" \
  -L/opt/ros/humble/lib -Wl,-rpath,/opt/ros/humble/lib \
  -lrosbag2_cpp -lrosbag2_storage -lrclcpp -lrcutils -lrmw \
  -ldiagnostic_msgs__rosidl_typesupport_cpp -o "$audit_out/audit_layer"
ros2 run carcar_camera depth_stvl_audit "$evidence_root/post_reboot_withdraw_bag" \
  "$audit_out/withdraw_stvl.csv" 0.7 1.0 -0.1325 0.1675 0.0 0.26
ros2 run carcar_camera depth_map_audit "$evidence_root/post_reboot_withdraw_bag" \
  "$audit_out/withdraw_map.csv" 0.7 1.0 -0.1325 0.1675 0.2
"$audit_out/summarize_hold" "$evidence_root/box_hold60/frames.csv" \
  "$evidence_root/box_pre_reboot_stvl.csv" "$evidence_root/box_pre_reboot_map.csv"
"$audit_out/audit_withdraw" "$evidence_root/post_reboot_withdraw300/frames.csv" \
  "$evidence_root/post_reboot_empty120/frames.csv" "$audit_out/withdraw_stvl.csv" "$audit_out/withdraw_map.csv"
"$audit_out/audit_layer" "$evidence_root/final_health_diagnostics_bag" "$audit_out/layer.csv"
```

ROI统计是已记录坐标边界内的样本；原生地图列margin为目标区域外围0.2 m环带，不含focus，外围没有致命格不能冒充focus已经清除。清除耗时基准为过滤输入ROI的最后正点header，不是聊天反馈时间或肉眼1 Hz截图。本次重启后只保留窄范围地面一致性复核，SDK/空间过滤的后续取舍见[安装角与STVL依据补充](archive/2026-10-07-D435安装角与STVL响应调研.md#2026-10-08补充低高度误标与过滤方案边界)，运行参数不据调研自动改变。

### 31.17 旧地图加D435导航的分终端复测（2026-10-12）

本节整合今天的入口，历史31.4、31.16命令及失败保留。使用旧地图`nav004_20260914_093032`，纯轮式里程计、差速禁横移、STVL导航限速0.10 m/s。用户反馈：不能确认相机是否被手动挪过，车轮动力可以独立断开；尚未确认已经断开。先执行第一阶段，不直接发导航目标。

相机输入是深度点云，经TF换算到车身坐标、过滤后进入STVL障碍记忆，再投影到Nav2全局/局部代价地图。RGB只作观察，不参与当前避障或定位。旧地图是历史二维环境；AMCL用激光定位。相机不会自动修正旧地图，也不会因为打开RGB窗口就接入导航。

**第一阶段：恢复命令位置并检查实际姿态。**必须现场先断开轮子动力、保留控制板/舵机/Jetson/相机供电；若供电结构不能做到，停止此步骤。四轮放水平地面，支架活动区无人手、线缆拉扯或碰撞，前方0.5～1.2 m中央清空。不要手掰带电舵机。历史目标140.5°/板端94只作为起点，历史近场俯仰0.094°不是当前读回。底盘启动会发送S1=94，随后保持固定，不启动键盘调角。串口同一时间只能一个进程使用。

准备终端（Ubuntu电脑本地）：以下仅远程登录车上，不启动硬件；每个车上终端均先执行这条登录命令。失败检查网络；`exit`退出SSH。RViz终端保留在电脑本地，不SSH。

```bash
ssh jetson@192.168.5.11
```

准备终端（已登录Jetson）：以下读取源码和依赖，更新工作区构建/安装文件，不启动硬件、不修改系统文件。预期构建成功；失败或Ctrl+C中断后修正再构建，不继续启动。插件依赖已部署，不重新下载安装；缺失时按31.1处理。

```bash
cd /home/jetson/luhao/my_nav_carcar
conda deactivate 2>/dev/null || true
source /opt/ros/humble/setup.bash
source install/setup.bash
STVL_PREFIX=/home/jetson/.local/share/carcar_stvl_humble/opt/ros/humble
export AMENT_PREFIX_PATH="$STVL_PREFIX:$AMENT_PREFIX_PATH"
export CMAKE_PREFIX_PATH="$STVL_PREFIX:$CMAKE_PREFIX_PATH"
export LD_LIBRARY_PATH="$STVL_PREFIX/lib:$STVL_PREFIX/opt/openvdb_vendor/lib:$LD_LIBRARY_PATH"
export CMAKE_BUILD_PARALLEL_LEVEL=2 MAKEFLAGS=-j2
colcon build --packages-select carcar_description carcar_base carcar_bringup carcar_lidar carcar_camera carcar_navigation --parallel-workers 1
source install/setup.bash
```

终端1（Jetson）：先只读查看设备使用者和旧进程；预期串口/相机没有旧驱动，不能把`fuser`检查与实际独占混为一谈。若有旧节点，在原启动终端Ctrl+C退出整个Launch，RealSense退出至少等5秒；不要杀会被自动重启的子进程。此组不驱动硬件，Ctrl+C可中止检查。

```bash
cd /home/jetson/luhao/my_nav_carcar
fuser -v /dev/myserial /dev/video0 /dev/video1 /dev/video2 /dev/video3 /dev/video4 /dev/video5 2>&1 || true
pgrep -af 'ros2 launch|rosmaster_node|realsense2_camera_node|depth_cloud_filter|robot_state_publisher' || true
systemctl show ruicom.service -p ActiveState -p SubState -p UnitFileState
```

确认无争用后，终端1执行下组：打开底盘串口、发零轮速并发送S1=94，可能立即转动相机；零运动、0.3秒命令超时停车和退出停车不能代替轮动力隔离。预期相机转动停稳、无异响/碰撞、轮子不动。软件加载零旋转参考用于测角，不用于导航。异常先现场断开相关执行器电源，再Ctrl+C，禁止盲目重启复位。

```bash
cd /home/jetson/luhao/my_nav_carcar
source /opt/ros/humble/setup.bash
source install/setup.bash
export ROS_DOMAIN_ID=31 ROS_LOCALHOST_ONLY=0 RMW_IMPLEMENTATION=rmw_fastrtps_cpp
ros2 launch carcar_bringup robot.launch.xml \
  speed_params_file:="$PWD/src/carcar_base/config/navigation_depth_experimental.yaml" \
  camera_tilt_dynamic:=false \
  camera_extrinsics_file:="$PWD/src/carcar_description/config/camera_extrinsics_floor_reference_20261007.yaml"
```

终端2（Jetson）：只打开唯一D435、发布深度/RGB/过滤数据，不打开控制串口、不发布第二份模型。此时过滤使用测角参考，不能用于导航验收。预期相机持续出数据；异常Ctrl+C退出整个Launch，至少等5秒后再试。High Accuracy候选及SDK备份恢复边界沿用31.10，不同时打开RealSense Viewer。

```bash
cd /home/jetson/luhao/my_nav_carcar
source /opt/ros/humble/setup.bash
source install/setup.bash
export ROS_DOMAIN_ID=31 ROS_LOCALHOST_ONLY=0 RMW_IMPLEMENTATION=rmw_fastrtps_cpp
export FASTRTPS_DEFAULT_PROFILES_FILE="$PWD/src/carcar_camera/config/fastdds_camera_shm_candidate.xml"
export RMW_FASTRTPS_PUBLICATION_MODE=SYNCHRONOUS
ros2 launch carcar_camera camera_navigation.launch.xml start_supervisor:=false \
  driver_params_file:="$PWD/src/carcar_camera/config/d435_navigation_high_accuracy_rgb_candidate.yaml" \
  filter_params_file:="$PWD/src/carcar_camera/config/depth_filter_stvl_temporal_candidate.yaml"
```

终端3（Jetson）：相机停稳、中央空地清净后，仅订阅下发档位和深度/TF，采30帧并写入新证据目录，不调角、不驱动轮子。预期档位94、30帧有效地面、拟合残差低且帧间稳定；约半分钟以上，可Ctrl+C中止，保留失败目录，不删异常帧。`slope_x`是前后地面斜率，零旋转参考下俯仰估算为`atan(slope_x)`；`slope_y`检查左右倾斜，`intercept_m`含参考高度误差，`rms_m`是拟合残差（米）。不能用高度偏移代替俯仰调整。先把本组输出用于现场判读，再决定第二阶段；不自动扫角。

```bash
cd /home/jetson/luhao/my_nav_carcar
source /opt/ros/humble/setup.bash
source install/setup.bash
export ROS_DOMAIN_ID=31 ROS_LOCALHOST_ONLY=0 RMW_IMPLEMENTATION=rmw_fastrtps_cpp
export FASTRTPS_DEFAULT_PROFILES_FILE="$PWD/src/carcar_camera/config/fastdds_camera_shm_candidate.xml"
export RMW_FASTRTPS_PUBLICATION_MODE=SYNCHRONOUS
servo_pose_dir="$PWD/log/nav016_pose_$(TZ=Asia/Shanghai date +%Y%m%d_%H%M%S)"
mkdir -p "$servo_pose_dir"
timeout --signal=INT 6s ros2 topic echo /hardware/camera_servo/board_command_sent \
  std_msgs/msg/Int32 --once --qos-durability transient_local \
  --qos-reliability reliable --qos-depth 1 | tee "$servo_pose_dir/command.txt"
ros2 run carcar_camera depth_snapshot --ros-args \
  -p require_color:=false -p sample_frames:=30 -p sample_interval_ms:=1000 \
  -p central_max_x:=1.4 -p floor_min_row:=0 -p floor_max_row:=479 \
  -p output_dir:="$servo_pose_dir/snapshot"
ros2 run carcar_camera depth_floor_profile "$servo_pose_dir/profile" \
  "$servo_pose_dir"/snapshot/sample_*_central_points.csv
cat "$servo_pose_dir/profile/near_plane.csv"
awk -F, '$1=="ALL" {print}' "$servo_pose_dir/profile/distance_stats.csv"
```

**第二阶段：旧地图加真实Nav2地图消费，仍先隔离轮动力。**前提是第一阶段与94候选安装关系相符，实物支架未发生位置变化；地面拟合不能独立证明x/y/yaw安装不变。若不相符，先按31.15重新检查/建立独立候选，本组外参路径也须替换，不能靠发送94或只改TF使画面好看。先Ctrl+C退出第一阶段终端2、再退出终端1，等待USB释放至少5秒；不同时保留测角模型和导航模型。

终端1（Jetson）：仍有S1=94动作，安全与停车要求同第一阶段；此处显式换成94候选TF，避免旧默认安装参数。它是实验参考，不转正正式外参。每次重启后的实体姿态仍需复核，不能把同档命令当位置反馈。

```bash
cd /home/jetson/luhao/my_nav_carcar
source /opt/ros/humble/setup.bash
source install/setup.bash
export ROS_DOMAIN_ID=31 ROS_LOCALHOST_ONLY=0 RMW_IMPLEMENTATION=rmw_fastrtps_cpp
ros2 launch carcar_bringup robot.launch.xml \
  speed_params_file:="$PWD/src/carcar_base/config/navigation_depth_experimental.yaml" \
  camera_tilt_dynamic:=false \
  camera_extrinsics_file:="$PWD/src/carcar_description/config/camera_extrinsics_level94_ground_candidate_20261008.yaml"
```

终端2（Jetson）：读取雷达串口并发布扫描，不发送运动；预期`/scan`持续更新。串口异常Ctrl+C退出，先查独占，不启动第二份雷达。

```bash
cd /home/jetson/luhao/my_nav_carcar
source /opt/ros/humble/setup.bash
source install/setup.bash
export ROS_DOMAIN_ID=31 ROS_LOCALHOST_ONLY=0 RMW_IMPLEMENTATION=rmw_fastrtps_cpp
ros2 launch carcar_lidar lidar.launch.xml
```

终端3（Jetson）：读取旧地图、激光和里程计，运行AMCL定位，不发送运动目标。预期地图加载成功；异常Ctrl+C退出。先确认现场墙体与旧地图相符，不同时启动建图。

```bash
cd /home/jetson/luhao/my_nav_carcar
source /opt/ros/humble/setup.bash
source install/setup.bash
export ROS_DOMAIN_ID=31 ROS_LOCALHOST_ONLY=0 RMW_IMPLEMENTATION=rmw_fastrtps_cpp
ros2 launch carcar_navigation localization_experimental.launch.xml \
  map:="$PWD/src/carcar_navigation/maps/nav004_20260914_093032.yaml" use_rviz:=false
```

终端4（Jetson）：唯一相机、时间确认过滤、感知监督、Nav2双STVL地图及规划控制一起启动；不再另开相机/独立静止地图。相机参数显式沿用94静止候选，不误用Launch旧默认过滤配置。会控制声光，收到目标后可能驱动车体，故此时轮动力仍隔离、禁止点目标。预期两图及感知状态健康；异常退出整个终端4入口，不绕过联锁继续激光导航。

```bash
cd /home/jetson/luhao/my_nav_carcar
source /opt/ros/humble/setup.bash
source install/setup.bash
STVL_PREFIX=/home/jetson/.local/share/carcar_stvl_humble/opt/ros/humble
export AMENT_PREFIX_PATH="$STVL_PREFIX:$AMENT_PREFIX_PATH"
export LD_LIBRARY_PATH="$STVL_PREFIX/lib:$STVL_PREFIX/opt/openvdb_vendor/lib:$LD_LIBRARY_PATH"
export ROS_DOMAIN_ID=31 ROS_LOCALHOST_ONLY=0 RMW_IMPLEMENTATION=rmw_fastrtps_cpp
export FASTRTPS_DEFAULT_PROFILES_FILE="$PWD/src/carcar_camera/config/fastdds_camera_shm_candidate.xml"
export RMW_FASTRTPS_PUBLICATION_MODE=SYNCHRONOUS
ros2 launch carcar_navigation navigation_depth_stvl.launch.xml \
  driver_params_file:="$PWD/src/carcar_camera/config/d435_navigation_high_accuracy_rgb_candidate.yaml" \
  filter_params_file:="$PWD/src/carcar_camera/config/depth_filter_stvl_temporal_candidate.yaml"
```

终端5（Ubuntu电脑本地桌面）：IP/域号与车模覆盖按第19节核对，使用31.3已有DDS配置及同步车模。本组只下载一个新增显示文件、打开RViz，备份已有同名文件，不改车端系统或硬件；复制失败停止。预期轻量二维地图/激光/橙色D435标障点显示，Frame Rate=100；关闭窗口/Ctrl+C仅停止显示，不能代替取消目标。回退可用同名时间戳backup。若DDS/车模本地文件尚不存在，先按31.3完成配置同步；同一电脑只开一个RViz。

```bash
(
set -e
cd "$HOME"
test -f "$HOME/carcar_stvl_fastdds_wifi.xml"
test -d "$HOME/ros_overlay/carcar_description/share/carcar_description"
nav_rviz=nav016_navigation_100fps.rviz
test ! -f "$HOME/$nav_rviz" || cp -a "$HOME/$nav_rviz" "$HOME/$nav_rviz.$(date +%Y%m%d_%H%M%S).backup"
scp jetson@192.168.5.11:/home/jetson/luhao/my_nav_carcar/src/carcar_navigation/rviz/navigation_stvl_lite_100fps_candidate.rviz "$HOME/$nav_rviz"
source /opt/ros/humble/setup.bash
export AMENT_PREFIX_PATH="$HOME/ros_overlay/carcar_description:$AMENT_PREFIX_PATH"
export FASTRTPS_DEFAULT_PROFILES_FILE="$HOME/carcar_stvl_fastdds_wifi.xml"
export ROS_DOMAIN_ID=31 ROS_LOCALHOST_ONLY=0 RMW_IMPLEMENTATION=rmw_fastrtps_cpp QT_QPA_PLATFORM=xcb
rviz2 -d "$HOME/$nav_rviz"
)
```

配置固定坐标系`map`，灰网格1 m，旧地图黑色为墙/占据、白色为空闲、灰色为未知；代价地图按costmap配色显示致命格及膨胀区，橙色点是过滤后的D435障碍，三维STVL默认关闭。地图是历史数据，激光/相机/代价地图是运行时数据，经TF换算后才能对照；图层并非严格同步。RGB640×480/6 Hz与深度640×480/6 Hz是采集分辨率/频率，镜头视场不同；窗口像素大小不等于物理范围。100是RViz刷新上限，双导航网格5 cm、体素2 cm，不能从窗口放大倍数判断箱子尺寸。话题与QoS沿用轻量STVL配置：`/map`与双地图Reliable/Transient Local，`/scan`与障碍点Best Effort/Volatile；历史15刷新配置原样保留。

终端6（Jetson）：本组只读取实际参数、发布者及健康状态，不改参数或驱动执行器。预期S1命令94、模型唯一、地图active、本地衰减2秒/全局5秒、required_stvl、两项感知联锁为true；每个诊断观察8秒自动结束，timeout返回124是到时退出。异常不要发目标，保留输出并逆序停止。

```bash
cd /home/jetson/luhao/my_nav_carcar
source /opt/ros/humble/setup.bash
source install/setup.bash
export ROS_DOMAIN_ID=31 ROS_LOCALHOST_ONLY=0 RMW_IMPLEMENTATION=rmw_fastrtps_cpp
ros2 topic info /robot_description -v
ros2 topic info /cmd_vel -v
ros2 lifecycle get /local_costmap/local_costmap
ros2 lifecycle get /global_costmap/global_costmap
ros2 param get /local_costmap/local_costmap depth_stvl.voxel_decay
ros2 param get /global_costmap/global_costmap depth_stvl.voxel_decay
ros2 param get /depth_layer_supervisor mode
ros2 param get /bt_navigator recovery.require_perception_health
ros2 param get /navigation_motion_gate require_perception_health
timeout --foreground --signal=INT 8s ros2 topic echo /camera/navigation/fusion_status
timeout --foreground --signal=INT 8s ros2 topic echo /local_costmap/depth_stvl/diagnostics
timeout --foreground --signal=INT 8s ros2 topic echo /global_costmap/depth_stvl/diagnostics
```

先用RViz的`2D Pose Estimate`在旧地图实际所在位置拖出朝向，这只设置定位初值。激光墙边应与旧地图对齐，定位就绪后，现场放稳约15 cm高盒子于前方约0.7 m，手离开，观察真实全局/局部地图新增障碍，再移走核对清除。普通盒同时被雷达看到时，二维格子存在不能单独证明相机贡献，还需对应深度图层诊断、点云及体素证据。相机地面复核、空场120秒、保持60秒、健康600秒取证完整命令沿用29.5、31.7、30.17，目录换成新时间戳；这些工具只有静止地图路径的部分需改为本轮真实双地图话题，不把独立`/costmap`通过当双地图通过。局部2秒/全局5秒TTL不同，不把静止2秒地图的3秒清除门槛直接套给全局。

**运动边界与停止：**外参/地图消费、取消/失联联锁、视野与停车距离前提未通过前，保持轮动力隔离。齐备后先确认无挂起目标，现场看护接通轮动力，点击`Nav2 Goal`发送前方空旷0.5～1 m短目标（0.10 m/s上限），先测试取消停车，再逐步测障碍；禁止人站前方充当障碍。未看见障碍、空地假标、方向不对或定位跳动立即取消并停车；紧急情况直接断开轮子动力。感知恢复可能继续尚有效任务，不能当取消使用。本轮不自动安排拔USB或杀节点的动态故障实验。

正常停止：先RViz导航面板取消任务、确认车轮停止并隔离轮动力，再Ctrl+C退出终端4→3→2→1，最后关闭RViz；不要通过关RViz替代取消。底盘退出零速、0.3秒超时停车是软件保护，真实制动距离仍待现场验证；舵机退出可能保持力矩。设备占用与恢复按31.5，重启相机至少等5秒。当前空地假障碍历史失败保留，本节仅是复测方案，不是实机通过记录。

### 31.18 深度导航行驶速度乘1.8的实验配置（2026-10-12）

用户明确要求将当前转向、前进及相关行驶速度乘1.8，授权本轮速度调整；采用独立候选，不修改31.17的0.10 m/s对照或正式默认。相机实际使用深度点云接入两张STVL地图，RGB只作参照；当前登记舵机目标140.5°/板端94，底盘启动会发送94，没有位置反馈。

| 速度设置 | 原生效值 | 本轮候选 |
|---|---|---|
| 前进上限：DWB/平滑器/底盘 | 0.10 m/s | 0.18 m/s |
| DWB最小平移速度 | 0.05 m/s | 0.09 m/s |
| 原地对准角速度/平滑器转向上限 | 0.45 rad/s | 0.81 rad/s |
| DWB角速度采样上限/底盘角速度上限 | 0.80 rad/s | 1.44 rad/s；最终仍受0.81平滑器限制 |
| 平滑器允许倒车下限 | −0.05 m/s | −0.09 m/s |
| 行为服务器最大/最小旋转速度 | 0.45/0.10 rad/s | 0.81/0.18 rad/s |
| ProtectedBackUp实际保护性倒车 | 0.05 m/s | 保持0.05，源码保护限值，不等于平滑器下限 |

加减速度、禁横移、停车判据、数据新鲜度、目标容差和感知联锁保持原值。速度上限不等于实物速度，定位/感知失联或障碍可能让输出减速或归零；提高上限不能修复数据超时。当前完整链路已出现POINTCLOUD_TIMEOUT，历史/本轮失败保留，不登记提速后移动或停车距离通过。

下面操作必须先取消活动任务并确认最终零速、轮式里程计静止。它会停止/重启导航及底盘，重新打开控制串口并发S1=94；轮动力若接通，不能同时发目标或开键盘/舵机测试。启动零速、0.3秒命令超时和退出停车继续生效，异常现场断开轮动力，再Ctrl+C逆序停机。相机退出至少等5秒。构建沿用31.17准备步骤（新增两份YAML随原config目录安装）；代理可用源码绝对路径加载，无需为了参数文件并行重建正在运行的导航。

底盘与导航只替换为下列两组，雷达、旧地图定位、主机RViz及只读诊断复用31.17第二阶段，不另开重复进程。底盘只在启动时读取限速，不能用运行时param set冒充已生效；导航同样冷启动读入候选。重启底盘会重置轮式odom，须保存重启前有效map→base_footprint估计并在重启后重新初始化AMCL；这是复用软件定位估计，不是实物位置确认。若定位已经失效，则由现场在RViz设置实际初值，禁止猜坐标放行。

终端1（已SSH进入Jetson）：读取新底盘候选并初始化控制板；预期参数为0.18/1.44，轮子静止。异常Ctrl+C并隔离轮动力，回退时停车后换回31.17原入口。

```bash
cd /home/jetson/luhao/my_nav_carcar
source /opt/ros/humble/setup.bash
source install/setup.bash
export ROS_DOMAIN_ID=31 ROS_LOCALHOST_ONLY=0 RMW_IMPLEMENTATION=rmw_fastrtps_cpp
ros2 launch carcar_bringup robot.launch.xml \
  speed_params_file:="$PWD/src/carcar_base/config/navigation_depth_speed180_candidate.yaml" \
  camera_tilt_dynamic:=false \
  camera_extrinsics_file:="$PWD/src/carcar_description/config/camera_extrinsics_level94_ground_candidate_20261008.yaml"
```

终端4（已SSH进入Jetson）：读取相机、过滤与新速度候选，一起启动导航；保留原STVL地图配置和感知门控。预期全链路active且速度参数读回对应表格；未核对前不发目标。异常先取消任务并停车，再Ctrl+C退出整个入口；回退为31.17终端4原命令，不删除本候选或日志。

```bash
cd /home/jetson/luhao/my_nav_carcar
source /opt/ros/humble/setup.bash
source install/setup.bash
STVL_PREFIX=/home/jetson/.local/share/carcar_stvl_humble/opt/ros/humble
export AMENT_PREFIX_PATH="$STVL_PREFIX:$AMENT_PREFIX_PATH"
export LD_LIBRARY_PATH="$STVL_PREFIX/lib:$STVL_PREFIX/opt/openvdb_vendor/lib:$LD_LIBRARY_PATH"
export ROS_DOMAIN_ID=31 ROS_LOCALHOST_ONLY=0 RMW_IMPLEMENTATION=rmw_fastrtps_cpp
export FASTRTPS_DEFAULT_PROFILES_FILE="$PWD/src/carcar_camera/config/fastdds_camera_shm_candidate.xml"
export RMW_FASTRTPS_PUBLICATION_MODE=SYNCHRONOUS
ros2 launch carcar_navigation navigation_depth_stvl.launch.xml \
  driver_params_file:="$PWD/src/carcar_camera/config/d435_navigation_high_accuracy_rgb_candidate.yaml" \
  filter_params_file:="$PWD/src/carcar_camera/config/depth_filter_stvl_temporal_candidate.yaml" \
  depth_params_file:="$PWD/src/carcar_navigation/config/nav2_depth_stvl_speed180_candidate.yaml"
```

只读核对（Jetson新终端）：查看实际限值和两项感知联锁，不改硬件；预期0.18、1.44、0.18、0.81、[0.18,0,0.81]及两项true。异常不发目标，按31.17停止。只读查询可Ctrl+C中断，不需恢复。

```bash
cd /home/jetson/luhao/my_nav_carcar
source /opt/ros/humble/setup.bash
source install/setup.bash
export ROS_DOMAIN_ID=31 ROS_LOCALHOST_ONLY=0
ros2 param get /rosmaster_base max_linear_x
ros2 param get /rosmaster_base max_angular_z
ros2 param get /controller_server FollowPath.max_vel_x
ros2 param get /controller_server FollowPath.rotate_to_heading_angular_vel
ros2 param get /velocity_smoother max_velocity
ros2 param get /navigation_motion_gate require_perception_health
ros2 param get /bt_navigator recovery.require_perception_health
```

## 32. 巡检设计与停用草稿归档的离线复核

完整专题与安全/停止步骤：[归档原文](archive/操作专题原文_20261014.md#32-巡检设计与停用草稿归档的离线复核)。原测试资产和参数保留；是否适用当前实车以路线和台账为准。

## 33. 平板随行建图（NAV-017）

2026-10-14确认的日常流程：小车开机并完成现有桌面自动登录后，网页待命；小米平板6连接“小泽WiFi”，全程通过网页新建、续建、遥控、保存、结束和故障重试。仅在该WiFi覆盖内的同层房间、走廊、大厅使用，操作者随车并始终看得见实物。热点不启用。导航实车验证留到下一阶段。

本次软件交付不等于实车通过：触屏摇杆持续操作、三档带载起步/停车、弱网/锁屏、20～30分钟场地建图和任意位置续建仍需现场反馈。现有底层历史验收不能替代本入口验收。测试结论只见[测试记录](测试记录.md)。旧终端启动和严格视频联锁入口保留，旧版完整流程见[本次修订前原文](archive/2026-10-14-平板建图旧流程原文.md)；不要与常驻网页并行启动。

用户已确认使用安卓平板Chrome（具体Android/Chrome版本待记录）。摇杆区域禁止浏览器滚动/缩放，手指拖出圆盘后仍由原指针控制；第二根手指不接管摇杆。正常松手只归零并保留使能；系统取消触控、锁屏、切到其他应用或页面时停车锁定，返回页面后需重新使能。设计行为与离线模拟不替代本机实测。

### 33.1 先理解页面与保护边界

地图输入为激光雷达、纯轮式里程计和TF（传感器/车体坐标之间的变换），RGB不参与建图。俯视图统一使用`map`坐标：黑色占据、白色空闲、灰色未知，当前配置5厘米/格；双指缩放只改变屏幕显示比例。红点为当前雷达在地图坐标中的投影，蓝色为估计车位与朝向示意、不按真实车身外廓比例绘制，黄色为人工续建初值。它们都不是实物位置真值；白色只反映激光扫描平面，不保证其他高度无障碍。

可选RGB窗口为相机前方透视画面，640×480是像素数，不是米数或镜头物理视场；窗口大小不改变镜头视场，不能与俯视图逐像素比较。视频显示关闭/过期时不影响目视遥控。地图约3秒更新，激光预览约5Hz，视频目标5～6FPS；各数据年龄分别显示，动画流畅不能证明匹配正确。

网页速度是命令上限：慢档0.05m/s、0.10rad/s，常档0.10m/s、0.20rad/s，新增快速档0.18m/s、0.36rad/s；默认仍为慢档，快速档是待现场验收的命令候选。切档停车并重新使能。摇杆连续调节并约束组合输入，不提供横移。实际速度、能否低速起步和物理停车距离由编码器与现场测量确认。当前没有自动避障，雷达数据新鲜也不代表前方安全。

NAV-017-R3将运动与前台心跳统一为车端签发后0.30秒授权：原0.20秒窗口包含状态下行和指令上行，现场已记录到176.59毫秒令牌年龄加47.40毫秒请求间隔，正常推杆也会在两条请求之间锁停。窗口增加0.10秒用于覆盖当前通信时延；截止时间仍从车端签发计算，迟到/重复消息不能从收包时重新计时。心跳只保留使能，不续租旧运动请求；网页收到新控制状态立即回应，前台本地新鲜度也与车端窗口一致。网关0.30秒、雷达/里程计0.50秒和底盘既有0.30秒命令超时保留。以上是软件时限，不是物理刹停时间或硬实时保证；增加窗口也增加旧动作可能持续的时间，物理停车距离须复测。Jetson卡死时控制板独立停车仍待实测，紧急情况切断轮动力，不能用人挡车。

NAV-017-R4补齐使能确认过程：即使页面尚未收到“已使能”，也及时回应新挑战；新令牌不被上一条旧消息的30ms节流挡住，否则每方向100ms延迟仍可能锁停。车端只在已使能时接受心跳，心跳本身不能使能或驱动车辆。同一会话的连接重试不再重置使能/档位；真正的新连接仍停车、恢复默认慢档并要求重新使能。网页重连立即清空旧控制状态，初始使能按钮默认禁用，待真实输入就绪后开放。

**当前R10规则覆盖上述静止心跳要求：**静止/松手后保持使能就绪，不再要求操纵心跳；运动仍按签发后300ms截止。`idle_heartbeat_required=false`为新门控能力标记，窗口失焦仅在仍推杆时停车；新网页遇到旧门控继续兼容旧心跳规则。日常操作与完整边界见[33.15](#mapping-idle-r10)，R3/R4历史与失败不改写。

NAV-017-R6超时判读：先查最近撤销事件的`reason`与`timing`，再判断对应链路。下表均为软件配置或程序读数，不是实物停车反馈。2026-10-14曾尝试500ms收包续租及800ms网关阈值，导致挂起停车与迟到请求回归失败，已撤回；失败源码与结果保留于测试记录R6。

| 检查 | 输入、截止规则与作用 | 现场应观察什么 |
|---|---|---|
| 运动授权 | 门控签发挑战→网页回声；签发后300ms截止 | `操纵授权超时/过期`、`challenge_age_ms`和`lease_remaining_ms`；递增序号不能让旧挑战重新计时 |
| 静止就绪 | R10不再靠操纵心跳续期；连接仍由唯一操作者持有，恢复运动必须是新鲜挑战和新按压 | 旧`presence_remaining_ms`仅为兼容回声诊断，不再是静止锁停条件；旧门控仍可能报`浏览器前台心跳超时`，先检查`idle_heartbeat_required` |
| 会话连接回收 | R11的WebSocket空闲期限10秒，约5秒发协议ping、总10秒无接收回收；UDP活跃不会自动刷新它 | `transport.session_idle_timeout_ms`、`last_disconnect`和WS ping/pong；只判断会话失联，不延长300ms运动许可 |
| 门控检查网关 | `/mapping/session/state`约100ms发布；未就绪或接收年龄超过300ms锁停 | `建图会话未就绪`及`gateway_age_ms`；原因也可能是ready=false，不能仅凭名称断言定时器卡顿 |
| 网关检查门控 | `/mapping/control/state`接收年龄小于300ms时允许启动转RUNNING或重发连接确认 | `control_age`和任务状态；与门控侧的`gateway_age_ms`是相反方向的数据 |
| 网页控制新鲜度 | 专用WebSocket状态间隔小于门控报告值（当前300ms）；旧版本缺字段回退200ms | `control_gap_ms`、`control_stale`、`script_delay`；此值是浏览器收消息间隔，不是挑战完整往返年龄 |
| 保存前静止等待 | 控制状态年龄小于300ms、未使能且里程计速度满足静止条件，连续保持300ms | 保存锁停/静止判定；不作为行驶通信容错参数修改 |

`token`是车端为某次控制状态签发的挑战标记，存留或匹配成功不等于消息新鲜。停车快照中的`challenge_age_ms`是最近一次处理请求时测得的年龄，`request_gap_ms`是此前两次请求的间隔；它们不会在等待下一条消息期间自行增长。应结合快照的剩余许可与事件时间判断，不能把它们当作停车时完整断流时长。地图PNG已由独立编码线程生成，传输也有异步路径；没有相应时序证据，不能直接认定编码阻塞了网关心跳。

### 33.2 一次性构建与离线检查

终端属于车上Jetson；电脑终端先按第19节SSH进入车端。以下构建项目包并在隔离ROS域运行替身/合成数据测试，写入build/install/log，不打开真实串口、雷达或相机，不发送实物运动命令。预期构建、C++回归、Python检查、JS/XML语法通过；失败Ctrl+C停止并保留日志，不继续启动硬件。Python缓存放在临时目录，不污染源码。

```bash
cd /home/jetson/luhao/my_nav_carcar
source /opt/ros/humble/setup.bash
source install/setup.bash
CMAKE_BUILD_PARALLEL_LEVEL=2 colcon build --symlink-install --packages-select carcar_base carcar_camera carcar_mapping_console --executor sequential
source install/setup.bash
export ROS_DOMAIN_ID=219 ROS_LOCALHOST_ONLY=1 RMW_IMPLEMENTATION=rmw_fastrtps_cpp
ctest --test-dir build/carcar_mapping_console --output-on-failure
PYTHONDONTWRITEBYTECODE=1 python3 -m pytest src/carcar_base/test -q -p no:cacheprovider
PYTHONPYCACHEPREFIX=/tmp/carcar_mapping_pycache python3 -m compileall -q src/carcar_base/carcar_base
node --check src/carcar_mapping_console/web/app.js
xmllint --noout src/carcar_mapping_console/launch/tablet.launch.xml src/carcar_mapping_console/launch/mapping.launch.xml
```

### 33.3 常驻网页、网络与开机配置

日常只打开网页。Jetson当前WiFi历史读回地址为`192.168.5.11`，访问`http://192.168.5.11:8080`；DHCP变化时读回新地址，不把历史地址当固定分配。页首可以在「建图」和「巡检」之间切换。巡检页面由 8080 转到车端本机 8081，平板不用再记第二个地址。建图任务还在跑时，巡检不能遥控或开始自动任务；巡检还在跑时，建图不能使能。先结束一边并确认车停着，再开另一边。平板不参加ROS发现，所有ROS留在localhost。网页不需要互联网，也不需要安装Android应用。一次只保留一个操控页，其他浏览器不能抢占控制。

下组只读取车端WiFi地址、用户服务和网页状态，不改网络、不打开硬件。预期待命状态`STANDBY`、无运行中的底盘/SLAM任务；查询失败Ctrl+C，检查服务日志。平板打不开而本地HTTP正常时，核对同一局域网及无线客户端隔离，不直接关闭防火墙或切热点。

```bash
cd /home/jetson/luhao/my_nav_carcar
nmcli -t -f NAME,DEVICE connection show --active
ip -4 -brief address show wlP1p1s0
systemctl --user status mapping-tablet.service --no-pager
curl --max-time 3 -sS http://127.0.0.1:8080/api/state
journalctl --user -u mapping-tablet.service -n 50 --no-pager
tablet_gateway_pid="$(systemctl --user show mapping-tablet.service -p MainPID --value)"
if [ "$tablet_gateway_pid" -gt 0 ]; then
  journalctl "_PID=$tablet_gateway_pid" -n 80 --no-pager
fi
```

R5实机发现按用户服务名查询可能返回No entries，而实际网关PID日志存在；以上PID查询用于当前运行的网关，跨重载历史同时查看任务日志/已导出诊断。原查询与修订前完整步骤保留于[修订前原文](archive/2026-10-14-平板建图R5日志查询修订前原文.md)，不把空查询当成没有故障。

当前采用用户服务，利用已存在的GDM自动登录启动；不修改GDM、不要求sudo、不启用linger。自动登录失败或退出用户会话时网页可能不可用，下次真实重启后的自动入口需要另行确认；不得把当前手动启动验证写成重启验收。

首次安装或更新常驻服务时，先结束旧软件预览及本次硬件任务，不能同时占用8080。以下会修改`/home/jetson/.config/systemd/user/mapping-tablet.service`及用户启用链接；先在同目录备份旧文件或记录原文件不存在，再安装模板。启动的是网页待命，不启动硬件。它会追加桌面维护记录；异常用33.11禁用服务，旧文件按备份恢复。已有服务正常时不要重复安装。

```bash
cd /home/jetson/luhao/my_nav_carcar
mapping_unit=/home/jetson/.config/systemd/user/mapping-tablet.service
mapping_stamp=$(date +%Y%m%d_%H%M%S_%N)
mapping_original=absent
mkdir -p /home/jetson/.config/systemd/user
if test -f "$mapping_unit"; then
  mapping_original=present
  cp -a -- "$mapping_unit" "$mapping_unit.$mapping_stamp.backup"
else
  cp -a src/carcar_mapping_console/config/mapping-tablet.service "$mapping_unit.$mapping_stamp.backup"
fi
install -m 0644 src/carcar_mapping_console/config/mapping-tablet.service "$mapping_unit"
{
  printf '\n### 平板建图用户服务维护 %s\n路径：%s；原文件状态：%s；同目录完整备份：%s.%s.backup。原文件不存在时备份为新增定义副本，不能当作旧内容恢复。\n目的：自动登录后仅网页待命，硬件按平板请求启动。\n修改前：\n' "$mapping_stamp" "$mapping_unit" "$mapping_original" "$mapping_unit" "$mapping_stamp"
  if test "$mapping_original" = present; then cat "$mapping_unit.$mapping_stamp.backup"; else printf '%s\n' '原文件不存在'; fi
  printf '\n修改后：\n'
  cat "$mapping_unit"
  printf '\n验证：重启实机待验。回滚先systemctl --user disable --now mapping-tablet.service；原文件存在时恢复对应备份并daemon-reload，原文件不存在时将新增定义移为.rollback.backup并daemon-reload。\n'
} >> /home/jetson/Desktop/系统配置维护记录.md
systemctl --user daemon-reload
systemctl --user enable --now mapping-tablet.service
```

### 33.4 小泽WiFi下的真实传感器静止检查

本节从平板操作，不需电脑启动ROS。首次先让轮子可靠架空或隔离轮动力，保持Jetson供电；确认电源线/电池和接头状态正常。电池型号、容量、低电阈值仍待确认，网页不虚构电量百分比或低电停车阈值。检查相机支架扫掠区无干涉：**启动底盘会发送S1=94，这是控制板命令值，不是已反馈的实物角度**。

1. 平板连接“小泽”，打开当前网页。预期显示“网页待命，硬件未启动”；地图/视频空白、遥控不可使能是正常状态。
2. 选择“新建地图”，点“检查并启动硬件”，阅读并确认现场前提。预检拒绝串口占用或已有地图/速度发布者，不杀其他程序。
3. 等待雷达、轮式里程计、地图及门控就绪。启动或输入长时间失败会锁停，查看诊断；不以反复点击绕过检查。
4. 静止观察地图、红点和车位；需视频时点“开启辅助视频”，相机只开RGB。视频自然断流只提示，不撤销行驶许可；手动切换视频属于操作切换，会先停车并要求重新使能。
5. 在不使车移动的前提下，先检查锁屏、后台、断WiFi再恢复；预期重连后仍未使能，没有恢复旧动作。

停止或异常：点“停车并锁定”；出现失控迹象立即隔离轮动力。随后从网页结束或按33.11停止服务。串口同一时刻一个所有者，不能并行打开旧驱动或底层串口测试。

### 33.5 摇杆与停车验收

完成静止/架空阶段后，现场看护在空地接通轮动力。先慢档，确认使能后按住摇杆短距离前进，松手立即请求零速，保持使能；再推摇杆可继续。上/下为前进/后退，左/右为原地左/右转，斜推为前后与转向组合；回中死区请求零速。重复的方块方向按钮已移除，先沿摇杆纵向验证前后、横向验证转向，再验证斜向组合。顶栏独立“停车并锁定”撤销使能；松手仅归零。横屏采用左地图、右摇杆与保存操作，辅助功能折叠。

按前进、后退、原地左右转、组合转弯顺序确认实物方向，再验常档。松手、停车锁定、锁屏、后台、关页、断WiFi、网关退出和雷达/里程计中断分别验收；后三类故障测试先用离线替身，再由现场在安全空地进行。不得以人作障碍，也不直接在行驶中拔串口。记录最终零速命令、编码器停稳和尺量停车距离；软件时限不能替代这些数据。

换档、后台、断线、传感器故障、保存和重启后需重新使能；松手本身不撤销使能。视频关闭/过期不锁停这一条必须单独核对，不能沿用旧版“视频断流停车”验收结论。视频可选不改变人随车目视的前提。

**无视频对照：**为区分视频负载与控制链路问题，在8080建图网页保持辅助视频关闭（按钮应为“开启辅助视频”），固定同一设备、WiFi、位置和慢档，网页保持前台，不同时换传输方式或改超时。若视频原本开启，先停车再关闭；这一操作切换会主动停车，随后重新使能一次再开始计对照，不能把关闭视频当下的停车算作故障。现场人在车旁、空旷区域短距离重复原来会失效的推杆／松手动作，观察是否又必须重新使能并记录时刻。异常点“停车并锁定”，有失控迹象立即隔离轮动力；保持视频关闭并保留诊断。开关视频会同时改变传输、编码和相机负载，改善只能说明视频相关负载值得进一步拆分验证，不能直接认定WiFi带宽不足；没有推杆操作的静止观察不能当作对照通过。

### 33.6 途中保存与结束

网页显示本次运行时间、距上次成功保存时间和最近版本；每5分钟提醒，不会突然停车或自动保存。选择安全位置点“停车并保存地图与工程”，系统锁停、确认轮式里程计与门控持续停稳，再暂时关扫描门、等待地图刷新并保存。

每次新建独立目录，保留`map.yaml/map.pgm`导航栅格与`graph.posegraph/graph.data`续建工程、参数/版本与SHA256清单。四文件和参数读取完整才标记成功，不覆盖旧工程；部分失败版本不能续建。仅有历史YAML/PGM的nav002/nav004不能作为续建工程。

成功后保持停车，重新使能才可继续。失败显示原因，保留当前任务并锁停；可重试保存，不能以重新使能绕过失败。结束时点“保存并结束建图”：成功后本次底盘、雷达、SLAM、门控及可选相机退出，网页回到待命，Jetson保持开机。失败不自动结束。明确选择“放弃未保存进度并结束”才跳过保存；旧工程仍保留。

### 33.7 旧图内任意位置续建

待命页选择“继续旧工程”，工程按保存ID由新到旧列出，校验失败/不完整项不可选。选定工程后启动硬件，只预览历史栅格，不向SLAM连续送扫描，也不允许行驶。

把车放在旧图覆盖的空闲位置，点“选择续建位置与朝向”，在图上按车体中心、拖出车头方向；黄色箭头是人工初值。点“试匹配”后仅放行一次新扫描，检查候选车位、实物朝向及多个方向的墙/门框；正确才点“墙体与朝向已对齐”。重复走廊容易匹配到相似位置，单看一面墙或接口成功不够。确认前禁止移动。

候选错误可重新给初值再试；服务超时/SLAM错误会锁停，从平板查看诊断并重启。恢复后仍需重新指定和确认位置、使能。继续扩图保存为新目录，原工程内容不改。

### 33.8 故障查看、重连与任务重启

展开“辅助与故障处理”，点“查看诊断”查看最近锁停快照、客户端/车端事件和任务/相机日志；随后点“导出诊断”保留JSON，再重连或重试。客户端记录按下、松手、触屏取消/捕获丢失、后台/失焦、脚本卡顿、HTTP延迟和控制消息间隔；车端记录授权撤销原因、传感器年龄、挑战年龄、请求/定时器间隔与剩余许可。WebSocket断线和“连接仍在但授权撤销”分别显示，最近锁停原因不随断线提示丢失。

遥控新鲜度由专用WebSocket状态判断；HTTP状态/地图查询延迟不会单独锁停。真实控制消息过期、后台及车端0.30/0.50秒保护仍会锁停。诊断中的`request_result`区分心跳/运动接受与过期，`accepted_sequence`是实际接受的请求序号，`ack_sequence`只表示看到了该序号，不能证明授权已续上；`rejected_requests`统计过期令牌拒绝次数，重新连接后重置。事件缓存各保留最近128条；门控事件同时写入本次任务日志，网关事件写入用户服务journal。客户端时间与车端单调时间不能直接相减，往返毫秒数在同一浏览器时钟上测量。页面渲染上限约30Hz，地图/激光源频率保持原值。

“重连网页”只重建控制连接，不重启硬件，也不恢复旧动作。更新车端程序前先“保存并结束建图”回到待命，再按33.11重载服务；刷新网页只更新浏览器资源，不能替代车端重载。快速档仅在门控报告支持时可选。

“重启建图任务”先锁停并退出本工具进程组，再预检启动。若本次已有成功保存版本，从最近版本续建；否则回到原续建工程或新建状态。重启前明确提示未保存进度可能丢失和支架可能转动；必须确认实物已停及扫掠区安全。不会自动重启硬件、抢占未知串口进程或把错误登记成通过。

网页完全不可达时才使用33.11的车端诊断与停止入口。突然断电或程序异常退出仍可能丢失最近一次保存之后的数据；定时提醒不等于自动备份或原始传感器录包。

### 33.9 保存地图供现有导航加载

本轮只验收导航地图格式可加载，不启动实车导航。下面在车端隔离域220运行现有定位入口，只读取所选`map.yaml/map.pgm`并启动map_server/AMCL/监控，不启动底盘、雷达、相机或RViz；无真实扫描时定位健康不通过是预期，不说明地图文件坏。替换`实际保存ID`为网页已报告成功的工程ID。预期map_server成功加载；失败Ctrl+C退出并保留日志，旧工程不改。

```bash
cd /home/jetson/luhao/my_nav_carcar
source /opt/ros/humble/setup.bash
source install/setup.bash
export ROS_DOMAIN_ID=220 ROS_LOCALHOST_ONLY=1 RMW_IMPLEMENTATION=rmw_fastrtps_cpp
ros2 launch carcar_navigation localization_experimental.launch.xml map:="$PWD/src/carcar_navigation/maps/mapping_sessions/实际保存ID/map.yaml" use_rviz:=false
```

在另一个车端终端查看同一隔离域中的地图元数据，只读检查尺寸/分辨率，不发速度。预期有非零宽高和约0.05m分辨率；读取结束Ctrl+C，最后在定位启动终端Ctrl+C退出。地图加载成功不证明AMCL位置正确或导航能到达。

```bash
cd /home/jetson/luhao/my_nav_carcar
source /opt/ros/humble/setup.bash
source install/setup.bash
export ROS_DOMAIN_ID=220 ROS_LOCALHOST_ONLY=1 RMW_IMPLEMENTATION=rmw_fastrtps_cpp
ros2 topic echo /map nav_msgs/msg/OccupancyGrid --once --field info --qos-durability transient_local --qos-reliability reliable
```

### 33.10 首轮20～30分钟场地验收

停车测试和供电检查先通过。固定位置出发，逐段经过多个房间、走廊和大厅，回访已建区并回到起点。回环指新扫描重新对应旧区域以修正累计误差；回到起点不自动等于回环成功。每完成一段尽量回访可识别的门口/墙角，形成多个小回环，减少只走一大圈时误差累积的风险。慢速过弯，给雷达足够重复观测，发现墙体持续重影/位置跳变先停车检查，不用加速或开IMU掩盖问题。

当前软件仅使用雷达0.10～3.00m距离，这是一帧周围参与建图的范围，不是地图最大长宽。大厅要沿能观察到边界的路线分段覆盖，超过3m的墙不会因屏幕缩放而进入该帧观测；本轮不未经实测扩大雷达范围。

本次要求：目标区域完整覆盖、无明显墙体重影；途中至少保存一次；结束保存并退出硬件；重新选择旧工程，在旧图内另一处指定位置、核对后续建并另存；原工程保持；保存栅格可由现有导航入口加载。不加入尺寸精度门槛，不把这些结果写成导航实车通过。记录路线、时长、保存ID、失联/停车现象和异常截图，按NAV-017-R1追加真实反馈。

### 33.11 车端应急停止与回滚

**故障重启前保留现场地图：**若网页已FAULT、无法走正常保存流程，但SLAM服务仍响应，可先用下面命令做应急备份。先现场停车、保持未使能；它只读取域31的SLAM续建数据和地图，写入新建的独立日志目录，不发送车轮／舵机命令、不覆盖已有工程、不重启硬件。预期序列化返回result=0并生成graph.posegraph／graph.data，栅格保存成功生成map.yaml／map.pgm。超时会在10秒后结束客户端；失败停止并保留输出，不能据备份文件存在认定可续建。此备份未生成正式工程清单和版本哈希，网页不会自动把它识别为有效工程；恢复前另行校验。它也不替代33.6正常保存的一致性流程。

```bash
cd /home/jetson/luhao/my_nav_carcar
source /opt/ros/humble/setup.bash
source install/setup.bash
mkdir -p log
recovery_dir="$(mktemp -d "$PWD/log/mapping_restart_XXXXXX")"
ROS_DOMAIN_ID=31 ROS_LOCALHOST_ONLY=1 timeout --signal=INT 10s \
  ros2 service call /slam_toolbox/serialize_map slam_toolbox/srv/SerializePoseGraph \
  "{filename: $recovery_dir/graph}"
ROS_DOMAIN_ID=31 ROS_LOCALHOST_ONLY=1 timeout --signal=INT 10s \
  ros2 run nav2_map_server map_saver_cli -f "$recovery_dir/map" \
  --ros-args -p save_map_timeout:=5.0
```

下组会停止常驻网页及它管理的全部硬件子任务，影响正在进行的建图；先现场停车并尽可能保存，异常直接隔离轮动力。停止后的网页暂不可达；重新启动只回到网页待命，不恢复动作或未保存工程。诊断日志保留，失败不重复开旧入口。

```bash
cd /home/jetson/luhao/my_nav_carcar
tablet_gateway_pid="$(systemctl --user show mapping-tablet.service -p MainPID --value)"
systemctl --user stop mapping-tablet.service
systemctl --user status mapping-tablet.service --no-pager
journalctl --user -u mapping-tablet.service -n 80 --no-pager
if [ "$tablet_gateway_pid" -gt 0 ]; then
  journalctl "_PID=$tablet_gateway_pid" -n 80 --no-pager
fi
systemctl --user start mapping-tablet.service
```

若需撤销开机自启，下组停止并禁用本服务，保留定义和备份，不影响原网络或旧工程。恢复时执行最后两行，仍仅网页待命；本次新增文件原本不存在时，如需完整恢复文件状态，先禁用，再将新增定义移为同目录`.rollback.backup`并daemon-reload。原本存在文件则从对应完整备份恢复。原文件不存在时，同目录备份是新增定义的完整副本，回滚应保持原文件不存在。

```bash
cd /home/jetson/luhao/my_nav_carcar
systemctl --user disable --now mapping-tablet.service
systemctl --user daemon-reload
systemctl --user enable mapping-tablet.service
systemctl --user start mapping-tablet.service
```

备用热点工具的串口检查已修正，仍未启用。它与硬件启动预检共用检查：只读查询解析后的绝对路径，仅退出码1且stdout/stderr完全为空才放行；串口占用、检查报错或工具缺失均拒绝继续。遇到拒绝时保留原因，不绕过检查或直接杀未知进程；正常关闭已知底盘入口后再检查。查询不发送停车命令，实物停稳仍须确认。其原流程完整保留在[旧流程33.8/33.9](archive/2026-10-14-平板建图旧流程原文.md)，本阶段不要执行热点创建、切换或sudo操作。

### 33.12 停车状态无线省电对照（NAV-017-R7-PS1，已临时验证）

适用前提：任务RUNNING/CURRENT，轮动力已隔离或车辆可靠架空，保持未使能、不拖动摇杆；平板始终在前台，同一位置、同一WiFi、同一300ms保护。2026-10-14只读基线为车端无线省电on、平板控制间隔多次超过300ms；省电仅是候选原因，不能由on直接断言。`iw`支持查询/设置无线省电，实际效果仍取决于本机驱动，不能把mac80211的机制直接套给当前RTL驱动。[Linux Wireless官方说明](https://wireless.docs.kernel.org/en/latest/en/users/documentation/iw.html#power-save)

2026-10-14执行结果：用户要求直接执行后，代理复核发现现有docker组权限可用，使用本地已有镜像、只读挂载宿主机工具/库，并仅为运行中省电工具添加NET_ADMIN完成临时对照；未新增权限或改sudoers。实际off窗口仍出现7次控制断流，恢复on后仍出现断流/重连，未消除问题；最终恢复on、不永久关闭。首轮采样晚于off窗口，按恢复后的on数据保留，未冒作off结果；第二轮将切换和采样统一执行，详情只见测试记录R7-PS1。下面的sudo流程仍是常规手动入口，Docker独立恢复入口见本节末尾。

下组在车端Jetson执行；电脑终端须先按19节SSH进入车端。不涉及ROS构建或硬件重启。它先在原目录完整备份当前“小泽”连接配置（备份含网络凭据，0600保留，不打印内容），记录当前状态并追加桌面维护记录，然后仅把运行中的无线省电临时改为off，采样约一分钟，最后恢复原on。连接配置内容、SSID/IP和路由不修改，不重新连接WiFi、不重启NetworkManager。预期保持RUNNING/未使能，比较控制间隔、断开/重连与TCP；功耗可能增加，远程通信可能短时受影响。Ctrl+C会触发恢复；SSH断开时在车端本地终端执行后面的独立回滚。sudo密码只在终端输入，不发聊天。权限、备份、状态或恢复失败都保留日志并停止，不继续移动。

```bash
cd /home/jetson/luhao/my_nav_carcar
(
  set -e
  test "$(nmcli -g GENERAL.CONNECTION device show wlP1p1s0)" = '小泽'
  test "$(/usr/sbin/iw dev wlP1p1s0 get power_save)" = 'Power save: on'
  curl --max-time 3 -fsS http://127.0.0.1:8080/api/state | jq -e '.task_state=="RUNNING" and .control.armed==false and .control.x==0 and .control.yaw==0' > /dev/null
  carcar_wifi_ab_dir="$(mktemp -d "$PWD/log/wifi_ps_ab_20261014_XXXXXX")"
  carcar_wifi_profile_backup="$(sudo mktemp '/etc/NetworkManager/system-connections/小泽.nmconnection.NAV017R7.XXXXXXXX.backup')"
  sudo cp --preserve=all -- '/etc/NetworkManager/system-connections/小泽.nmconnection' "$carcar_wifi_profile_backup"
  /usr/sbin/iw dev wlP1p1s0 get power_save > "$carcar_wifi_ab_dir/power_save_before.backup"
  printf '%s\n' "$carcar_wifi_profile_backup" > "$carcar_wifi_ab_dir/profile_backup_path.txt"
  {
    printf '\n## 2026-10-14 NAV-017-R7：临时无线省电对照 %s\n' "$carcar_wifi_ab_dir"
    printf '运行状态路径：/sys/class/net/wlP1p1s0；完整备份：%s。\n' "$carcar_wifi_profile_backup"
    printf '%s\n' '目的：只关闭本次无线省电并比较停车状态通信；配置文件内容不变，运行值计划on→off→on。功耗可能增加，未验收为故障根因。' '回滚：sudo /usr/sbin/iw dev wlP1p1s0 set power_save on；用get power_save确认on。'
  } >> /home/jetson/Desktop/系统配置维护记录.md
  carcar_wifi_restore() {
    if sudo -n /usr/sbin/iw dev wlP1p1s0 set power_save on; then
      /usr/sbin/iw dev wlP1p1s0 get power_save | tee "$carcar_wifi_ab_dir/power_save_restored.txt"
      printf '%s\n' '运行值已恢复on，原连接文件未修改；对照结果待按证据判读。' >> /home/jetson/Desktop/系统配置维护记录.md
    else
      printf '%s\n' '自动恢复失败：在车端本地终端执行手册33.12独立回滚。' >&2
      return 1
    fi
  }
  trap carcar_wifi_restore EXIT
  trap 'exit 130' INT TERM HUP
  sudo /usr/sbin/iw dev wlP1p1s0 set power_save off
  /usr/sbin/iw dev wlP1p1s0 get power_save | tee "$carcar_wifi_ab_dir/power_save_during.txt"
  test "$(cat "$carcar_wifi_ab_dir/power_save_during.txt")" = 'Power save: off'
  ss -tinp '( sport = :8080 )' > "$carcar_wifi_ab_dir/tcp_before.txt"
  for carcar_wifi_sample in {1..60}; do
    curl --max-time 3 -fsS http://127.0.0.1:8080/api/diagnostics | jq -c 'del(.control.challenge) | .sample_unix_ms=(now*1000|floor)' >> "$carcar_wifi_ab_dir/trace.jsonl"
    tail -1 "$carcar_wifi_ab_dir/trace.jsonl" | jq -e '.control.armed==false and .control.x==0 and .control.yaw==0' > /dev/null
    sleep 1
  done
  ss -tinp '( sport = :8080 )' > "$carcar_wifi_ab_dir/tcp_after.txt"
  printf '证据目录：%s\n' "$carcar_wifi_ab_dir"
)
```

完成或异常后预期读回`Power save: on`。下组是独立恢复入口，只把运行值恢复到本次试验前的on，不启动硬件或改连接文件；需要时在车端本地终端执行。成功返回on后再做诊断，不因短时改善直接永久关闭省电。

```bash
cd /home/jetson/luhao/my_nav_carcar
sudo /usr/sbin/iw dev wlP1p1s0 set power_save on
/usr/sbin/iw dev wlP1p1s0 get power_save
```

判读：只统计off采样时间窗内新到事件，不能把缓存里的旧断流计为本轮。与同位置基线的每分钟控制间隔>300ms次数、断开/重连、脚本卡顿和TCP积压比较；恢复on后再观察有无复现，必要时重复同条件对照。未使能时车端不接受心跳续租，不能用`accepted_sequence=0`判为链路故障。省电关闭无效时保留失败并恢复，下一步分别对照平板/其他客户端与网络路径，不同时改变多个设置。

本次代理用现有Docker权限执行，依据[Docker组权限说明](https://docs.docker.com/engine/install/linux-postinstall/#manage-docker-as-a-non-root-user)及[运行权限/能力说明](https://docs.docker.com/engine/containers/run/#runtime-privilege-and-linux-capabilities)。试验代码为证据目录中的临时C++工具，固定只操作`wlP1p1s0/power_save`，主工具60秒恢复，另有150秒独立恢复兜底；不是正式bringup入口。原连接完整备份为`/etc/NetworkManager/system-connections/小泽.nmconnection.NAV017R7.pV49S6.backup`（root:root/0600），原件与备份逐字节一致，桌面维护记录2026-10-14-02已追加。临时容器均已退出清理，既有容器与镜像保留。

下组是在sudo仍需密码、当前账号已有Docker管理权限时的独立恢复入口。仅使用本机已有且固定ID的arm64镜像，覆盖其入口运行宿主机iw；把运行值恢复on并读回，不下载镜像、不启动ROS应用或重启网络。该能力会改变宿主机无线运行状态，须保持车辆未使能；预期读回on，失败保留错误并用前面的本地sudo恢复入口，不改权限配置。

```bash
cd /home/jetson/luhao/my_nav_carcar
carcar_wifi_image='sha256:e065879588687681f8f9c785f473a85ffcba0c41b02941c9a9bbe999caaf4606'
carcar_wifi_docker=(docker run --rm --pull=never --read-only --network=host
  --user=0:0 --cap-drop=ALL --cap-add=NET_ADMIN --security-opt=no-new-privileges
  --pids-limit=16 --memory=64m --env=LD_PRELOAD= --env=LD_AUDIT=
  --mount type=bind,src=/usr/lib/aarch64-linux-gnu,dst=/carcar-host-libs,readonly
  --mount type=bind,src=/usr/lib/aarch64-linux-gnu/ld-linux-aarch64.so.1,dst=/carcar-host-loader,readonly
  --mount type=bind,src=/usr/sbin/iw,dst=/carcar-host-iw,readonly
  --entrypoint=/carcar-host-loader)
"${carcar_wifi_docker[@]}" "$carcar_wifi_image" --library-path /carcar-host-libs /carcar-host-iw dev wlP1p1s0 set power_save on
/usr/sbin/iw dev wlP1p1s0 get power_save
```

### 33.13 数据流修订与通信验收（NAV-017-R8，2026-10-15）

本轮保留现有C++网关、独立门控、旧接口和全部历史失败。方案依据见[调研归档](archive/2026-10-15-网页建图数据流方案调研.md)，结果只维护测试记录R8；不把通用桥接或WebRTC等同可靠停车。本轮不修改WiFi/systemd定义，不改变300ms签发截止、雷达/里程计新鲜度、松手序号屏障和重新使能规则。

新网页将数据按用途分流：`/api/status`约250ms读取轻量任务状态；`/api/scan`约200ms读取map坐标激光预览，带`version/frame_id/valid/source_age_ms/points`，同版本返回204空体；地图仍按版本下载，RGB仍按需开启。浏览器只保留一个预览请求在途，进入新任务时丢弃旧请求结果，预览源年龄与本地等待合计超过500ms不继续画旧红点。源年龄包含激光时间戳在接收时的ROS年龄，再以车端单调时钟累计；浏览器另加入本次HTTP往返作保守显示估计，不修改SLAM输入、TF、传感器频率或运动授权。

控制WebSocket握手报告`transport_protocol=1`后，新网页协商`compact`确认，先回应挑战再更新显示；详细timing/last_stop通过诊断按需读取。旧客户端未协商仍收到完整确认；旧网关无轻量接口时新网页回退旧状态接口。普通HTTP处理使用独立串行工作线程，HTTP连接可复用；控制socket显式TCP_NODELAY，应用待发状态最多一条、已过期状态不再新写入TCP，仍不能撤回已经进入TCP的数据。客户端诊断队列最多8条、每250ms发送一条，页面仍保留128条历史；诊断流不能代替可靠停车指令。

构建和隔离验证使用33.2完整步骤；源码和旧二进制检查点为`log/mapping_dataflow_r8_20261015_HZd85l/before/`。下组在Jetson运行，只读取HTTP状态/诊断，不取得控制权、不打开串口或使能、不修改文件/系统/硬件。预期轻量状态没有scan数组，诊断版本2可见传输时序；Ctrl+C即可停止，无需恢复。即使返回200，也只证明接口可读，不能证明现场控制已稳定。

```bash
cd /home/jetson/luhao/my_nav_carcar
curl --max-time 3 -fsS http://127.0.0.1:8080/api/status | jq '{task_state,phase,dataflow_protocol,scan_version,control,scan_age,odom_age}'
curl --max-time 3 -fsS http://127.0.0.1:8080/api/scan | jq '{version,frame_id,valid,source_age_ms,point_count:(.points|length)}'
curl --max-time 3 -fsS http://127.0.0.1:8080/api/diagnostics | jq '{diagnostics_version,dataflow,transport,reply_timing,control:{armed:.control.armed,reason:.control.reason,health:.control.health,last_stop:.control.last_stop}}'
```

诊断判读：`control_revision`标记一次车端签发，`issued_steady_ms`只在车端单调时钟内计算；`reply_timing.matched=true`时的`reply_age_ms`包含签发→网页→网关的总年龄，尚不等于门控已接受，应对照`accepted_sequence/request_result`。`client_response_delay_ms`为浏览器报告的回调后等待，不能当成可信安全输入，也不能单独排除网络/浏览器事件调度停顿。

`last/max_queue_wait_ms`、`pending_replaced`、`states_expired_before_write`表示应用等待/覆盖/过期丢弃；`last/max_write_ms`为本地异步写耗时，不代表浏览器已经收到。`tcp_send_queue_bytes/tcp_notsent_bytes/tcp_unacked/tcp_rtt_ms/tcp_retransmits`为控制socket的TCP快照，应结合`connected/tcp_sample_valid`使用；`connection_generation`变化后，不跨连接相减累计重传。计数与最大值为本次网关生命周期累计。无客户端时不得将旧快照当作当前通信，未使能时accepted_sequence不增长也不等于断流。

现场验收先按33.4检查真实输入，保持未使能、浏览器前台观察10分钟；记录新到的控制间隔、脚本卡顿、回应年龄和TCP积压。通过后按33.5分别测试持续推杆、松手、后台、断网、恢复与重新使能，再按33.10做场地建图。网络确实中断超过许可时仍须停车；不能只用平均ping、画面流畅或离线通过判定现场通过。

部署重载会结束当前硬件任务，因此先完成保存并确认未使能/速度零；重载后网页待命，硬件仍须在页面显式启动，启动的轮动力与S1支架风险仍按33.3～33.5处理。下组仅用于本轮失败回滚：停止用户服务后恢复检查点中的旧网页、网关和门控二进制，再启动待命服务；会覆盖这三份本轮产物、关闭当前硬件任务，未保存进度须提前保存。地图工程和系统配置不覆盖。任一步失败立即停止，不启动硬件，保留终端输出；需要恢复本轮新版时按33.2重新构建安装后再启动服务。

```bash
cd /home/jetson/luhao/my_nav_carcar
carcar_r8_checkpoint="$PWD/log/mapping_dataflow_r8_20261015_HZd85l/before"
bash -e -s -- "$carcar_r8_checkpoint" <<'ROLLBACK'
systemctl --user stop mapping-tablet.service
tar -xOf "$1/source_and_docs.tar.gz" src/carcar_mapping_console/web/app.js > src/carcar_mapping_console/web/app.js
cp -p "$1/mapping_web_gateway" build/carcar_mapping_console/mapping_web_gateway
cp -p "$1/mapping_teleop_guard" build/carcar_mapping_console/mapping_teleop_guard
systemctl --user start mapping-tablet.service
ROLLBACK
```

**真实浏览器验收边界：**默认57项C++回归中的网页协议测试运行真实app.js、HTTP/WebSocket和门控，但DOM为替身。另行尝试本机Chromium触屏回归时，浏览器可渲染data URL，仍无法访问独立最小HTTP页，应用导航未通过；失败命令与临时副本恢复说明移入[环境尝试归档](archive/2026-10-15-网页建图R8浏览器环境尝试.md)，不作为当前有效入口。真实平板的前台、推杆与停车仍按本节现场流程独立验收。

### 33.14 WebRTC控制通道与旧通道对照（NAV-017-R9，2026-10-15）

R8后电脑与平板仍出现同类超时，不能仅归因于某平台。R9新增局域网WebRTC数据通道，旧WebSocket和HTTP方案保留。信令是建立通道时交换SDP/候选地址的少量消息，经原`/ws/control`可靠发送；周期操纵走SCTP/DTLS/UDP，设置无序、零次重传，减小旧包阻挡新包的机会。原始来源、固定版本与许可证见[专项调研](archive/2026-10-15-网页建图WebRTC控制通道调研.md)，结果只维护测试记录R9。

车端运动仍按挑战签发后300ms截止；传输不授权运动、不从迟到收包重新计时。R9使能后每次新挑战最多回应一次，运动与心跳共用，约17～20Hz，不额外周期重发旧挑战；R10进一步停止静止操纵心跳，具体见33.15。松手与停车立即同时发往新旧通道。应用拒绝乱序旧状态和旧序号，门控重启按签发代次隔离；数据通道缓冲非空不继续追加周期包，仍不能撤回库/内核已经排入的数据。

**网页操作：**刷新网页后，顶部应显示“控制已连接 · WebRTC”。辅助与故障处理里的“控制通道”可选“WebSocket旧通道对照”；每次切换会停车、撤销使能并重连，需要另行使能。若显示“WebSocket（新通道未连接）”，本次使用的是回退通道，不能登记为WebRTC验收通过。普通HTTP页面可尝试纯数据通道，不打开摄像头/麦克风；浏览器策略、UDP限制、mDNS或AP隔离可能导致建连失败。无需改系统/路由器设置先试，未连接时保持停车，保留诊断。

新通道关闭、WebSocket所有权断开、页面后台/挂起、指令过期和传感器异常均锁停，恢复通信不恢复旧按压。当前是LAN host候选，不使用外部STUN/TURN，也不提供穿透或公网远控；网络真正中断超过300ms仍须停车。连续推杆和物理停车验收仍按33.4～33.5，通道比较应使用同一设备/网络、同一预览负载、同一速度和相同观察时长，先未使能观察10分钟，不能由画面流畅判定控制合格。

**构建与离线验证：**下组只修改项目构建/安装产物、证据文件与临时测试资源；第一次启用可能联网下载约54MB官方固定源码并校验SHA256。安装静态链接的新网关不会自动重载旧进程；测试采用ROS域219、localhost和替身底盘，不打开真实串口或发实车运动。预期目标包、完整回归及旧通道兼容检查通过；Ctrl+C停止并保留日志，失败不要重载正在使用的服务。运行无需这些下载源在线，依赖缓存与第三方许可证保留。

```bash
cd /home/jetson/luhao/my_nav_carcar
source /opt/ros/humble/setup.bash
source install/setup.bash
colcon build --packages-select carcar_mapping_console --symlink-install --cmake-args -DCMAKE_BUILD_TYPE=Release -DMAPPING_ENABLE_WEBRTC=ON
ctest --test-dir build/carcar_mapping_console --output-on-failure
```

**真实Chromium隔离测试：**项目的测试专用C++入口`mapping_test_chromium`用bubblewrap只读挂载现有core24/Chromium/GNOME/Mesa运行库，提供隔离的最小`/dev`、PID和临时用户配置；不修改snap原件、系统库、用户浏览器配置或硬件。页面只连接测试18089，UDP绑定loopback。下组将真实DOM/CSS触屏结果单独保存；预期检查实际新通道、拖动/松手/挂起与恢复，测试注入的延迟和浏览器调度合计若耗尽300ms应停车，稳定操控是否通过以测试记录为准。该入口要求本机已有上述snap和bwrap，不是其他电脑的通用安装脚本；Ctrl+C后等夹具清理，不启动实车。100ms单程的失败边界已保留，不用默认DOM协议回归代替它。

```bash
cd /home/jetson/luhao/my_nav_carcar
source /opt/ros/humble/setup.bash
source install/setup.bash
ROS_DOMAIN_ID=219 ROS_LOCALHOST_ONLY=1 \
  MAPPING_TEST_CHROME="$PWD/build/carcar_mapping_console/mapping_test_chromium" MAPPING_TEST_EXPECT_RTC=1 \
  build/carcar_mapping_console/test_mapping_integration \
  --gtest_filter=BrowserIntegration.ActualBrowserEnableJoystickAndBoundedStallWithTabletLatency
```

下组只读车端诊断，不取得控制权或修改硬件。预期`control_transport=webrtc_udp`且`rtc.active=true`；同时确认候选UDP地址、缓冲/丢弃计数、回应年龄和门控last_stop。`tcp_*`现在描述所有权/信令连接，不能当成UDP的RTT/丢包率；`rtc.sent`表示库接受的发送调用，不能证明浏览器已收到。Ctrl+C即可停止，无需恢复。

```bash
cd /home/jetson/luhao/my_nav_carcar
curl --max-time 3 -fsS http://127.0.0.1:8080/api/diagnostics | jq '{phase,task_state,transport:{control_transport:.transport.control_transport,rtc:.transport.rtc,connected:.transport.connected},reply_timing,control:{armed:.control.armed,reason:.control.reason,health:.control.health,last_stop:.control.last_stop}}'
```

**回退：**优先用网页选择旧通道，只改本页连接方式并锁停，不重启底盘/支架。若需完全回退旧软件，先保存当前工程、确认未使能与零命令、关闭网页；下组会结束硬件任务，恢复检查点中的完整网页及两个旧二进制，再启动待命服务。地图和系统配置不覆盖，不自动启动硬件；任一步失败停止，保留输出。恢复R9可用本节构建后重载原服务；若新依赖不可取得，可设`MAPPING_ENABLE_WEBRTC=OFF`独立构建旧通道。

```bash
cd /home/jetson/luhao/my_nav_carcar
carcar_r9_checkpoint="$PWD/log/mapping_webrtc_r9_20261015_zkQjZK/before"
bash -e -s -- "$carcar_r9_checkpoint" <<'ROLLBACK_R9'
systemctl --user stop mapping-tablet.service
tar -xzf "$1/source_and_docs.tar.gz" src/carcar_mapping_console/web
cp -p "$1/mapping_web_gateway" build/carcar_mapping_console/mapping_web_gateway
cp -p "$1/mapping_teleop_guard" build/carcar_mapping_console/mapping_teleop_guard
systemctl --user start mapping-tablet.service
ROLLBACK_R9
```

### 33.15 静止就绪与运动截止分开（NAV-017-R10，2026-10-15）

本轮按用户明确需求收敛为“网页遥控小车建图”。R9现场已连通WebRTC，但首次使能仍曾在没有首次心跳时撤销；另一次window_blur撤销发生在松手静止、有效心跳尚余约289.55ms时。前者暴露静止使能与运动被同一时限绑定，后者是浏览器窗口失焦事件被无条件当作锁停，不能都解释成网络超时。来源与本项目取舍见[专项调研R10段](archive/2026-10-15-网页建图WebRTC控制通道调研.md#6-r10-静止就绪与运动截止)，原始失败、验证和部署状态统一测试记录R9/R10。

日常流程仍为：打开网页→启动建图→使能→按住摇杆行驶→松手停车→保存/结束。静止及松手后的使能代表等待下一次按压，新门控不要求这时高频发送操纵心跳；页面显示的新鲜控制状态仍决定能否开始推杆。没有新鲜状态时保持零输出并等通信恢复，不自动生成按压。首次使能等待确认也没有旧的300ms静止心跳锁停。

首次按压先等待下一条新挑战再开始运动，避免拿静止时已等待过的旧挑战建立短剩余许可；通常增加约一个状态周期，松手/停车不等待。只要正在运动，后续挑战/回应未能在原期限内接续仍会停车；100ms单程注入下持续操控未通过的记录保留，不作高延迟稳定性承诺。

| 情况 | R10行为 |
|---|---|
| 静止或已经松手，点击聊天/其他窗口 | `blur`不撤销就绪，不发送停车请求；通信恢复也不会产生运动 |
| 仍按住摇杆，窗口失焦/触控取消 | 立即清除按压并发送停车，须重新使能；松手后的自然pointercapture释放不重复停车 |
| 正在推杆，运动消息没有及时更新 | 仍在该挑战车端签发后300ms截止时停车/撤销使能，约20ms门控检查周期；未增加运动容错时间 |
| 页面隐藏/关闭、控制连接关闭或通道切换 | 撤销使能，恢复后不重放旧动作 |
| 雷达/里程计过期、建图会话未就绪或速度出口拓扑异常 | 仍停车，相关阈值和硬件参数不变 |

兼容：新门控报告`idle_heartbeat_required=false`，新网页停止空闲操纵心跳；旧门控缺此字段时仍按旧规则回应。旧网页发送的兼容心跳可记录序号/回声年龄，但不能触发运动或续租旧运动；`presence_remaining_ms`为历史兼容诊断，负数不代表R10静止故障。`accepted_sequence`停车时不持续增加也是正常的；不能用这个计数不变判断断流。实际通道仍在顶部显示，辅助区旧WebSocket只供故障对照，日常无需选择。

R12补齐HTTP异常分支：状态查询失败且控制暂时过期时，静止只记录超时，不主动撤销就绪；尚未释放按压时仍清按压并停车。保持松手停车后刷新网页即可取得修正，不重启底盘/建图或重发S1；刷新会重建连接、撤销使能，需要另行使能。诊断ui_version应为20261015-r12，车端可看到client_ui_r12；只核对服务端文件不能证明已打开页面加载了新版。查询失败/控制停顿的原因仍须独立调查，结果见测试记录R12。

构建、隔离域回归、真实Chromium、只读诊断沿用[33.14](#mapping-webrtc-r9)的完整命令。需确认诊断`control.idle_heartbeat_required=false`后才按本节验收；先在未使能时刷新，不要求重启底盘或重发S1。真实车上验证应分别观察静止等候、松手停顿后再次推杆、推杆失焦/断网的零命令及实际停车，不能仅凭不再出现静止心跳错误宣布行驶通信通过。300ms软件期限不等于实物停车时间。

**R10回退：**下面用于明确需要恢复R9时；先保存需要的工程、确认物理停稳/软件未使能并关闭网页。命令结束当前任务，恢复R10前完整网页与两个旧二进制，重启到待命；不覆盖地图或系统，不自动启动硬件。任一步失败停止保留输出，Ctrl+C退出后检查服务状态。重新构建R10并重载原服务可恢复本节版本。

```bash
cd /home/jetson/luhao/my_nav_carcar
carcar_r10_checkpoint="$PWD/log/mapping_idle_r10_20261015_YGQvyy"
bash -e -s -- "$carcar_r10_checkpoint" <<'ROLLBACK_R10'
systemctl --user stop mapping-tablet.service
tar -xzf "$1/before_r10.tar.gz" src/carcar_mapping_console/web
cp -p "$1/before_mapping_web_gateway" build/carcar_mapping_console/mapping_web_gateway
cp -p "$1/before_mapping_teleop_guard" build/carcar_mapping_console/mapping_teleop_guard
systemctl --user start mapping-tablet.service
ROLLBACK_R10
```

### 33.16 偶发断联与连接回收（NAV-017-R11，2026-10-15）

R10后用户仍反馈概率性断联。旧诊断出现21代连接、多次HTTP查询已超时而控制状态仍新鲜，随后WebSocket所有权关闭；旧快照还曾显示connected=false但rtc.active=true。R11原生UDP夹具复现：只暂停TCP读取/自动pong约3.4秒，UDP仍双向收发，旧2秒空闲回收却先断开整个操作者。固定Boost1.74的协议计时与本机源码核对见[连接超时调研](archive/2026-10-15-网页建图WebSocket连接超时调研.md)，实际结果/旧失败统一测试记录R11。旧现场没有read/write错误码，复现支持优先修正这个路径，不代表已确认现场唯一根因。

**职责：**连接存在只代表有一个操作者持有网页会话，不代表轮子应该继续转。R11将连接空闲回收设为10秒，Beast约5秒发ping、总10秒无接收后回收；ping/pong也算接收，不能把最后一条client事件时间当最后收到网络帧的时间。运动仍要求原挑战签发后300ms内的有效更新，断流时按独立门控停车，不等10秒。代价是无响应旧操作者可能多占会话约8秒，其他页面需等回收或主动关闭旧页面；真实断网、显式页面关闭和RTC失效仍会停车/断开，不承诺永不掉线。

**新增判读：**诊断包含`transport.session_idle_timeout_ms`、`disconnects`、`last_disconnect`。`last_disconnect.reason`区分`websocket_idle_timeout`、`websocket_handshake_timeout`、`peer_close`、`transport_error`和主动关闭；`stage`记录read/write/handshake等首个失败位置，另存错误category/value/message、对端关闭code、关闭前RTC是否活跃和WS最后接收年龄/ping/pong计数。关闭时rtc.active同步为false，断开原因也进入controller_disconnected历史。下一次再连上后last_disconnect仍是上一条历史，须结合connection_generation和事件时刻判断；`tcp_sample_valid=false`时TCP队列/RTT是旧快照。网页“诊断/导出”现包含transport和reply_timing，浏览器另报ws_close_code/was_clean；原始错误不删除、不用它续租运动。

页面恢复使能且控制新鲜/健康时，上次停车改显示“上次停车记录（当前已就绪）”并采用普通文字色；没有恢复时仍保留停车提示。下方诊断中的旧WARN/停车原文属于历史证据，判断当前状态以连接、phase/error和当前控制状态为准，不能只按文字颜色认定又发生故障。

构建、完整隔离回归、真实Chromium沿用[33.14](#mapping-webrtc-r9)命令；日常网页流程不变。下组在本机隔离测试进程仅连接loopback18121/18114，用原生RTC验证TCP短停顿不连带关闭健康UDP，并检查长期无回应会回收及其原因；不打开实车串口/雷达，不取得8080控制权，预计约14秒。失败保留输出，Ctrl+C停止测试即可，正式任务不需要恢复。

```bash
cd /home/jetson/luhao/my_nav_carcar
source /opt/ros/humble/setup.bash
source install/setup.bash
ROS_DOMAIN_ID=219 ROS_LOCALHOST_ONLY=1 \
  build/carcar_mapping_console/test_mapping_http \
  --gtest_filter='HttpTransport.BriefTcpSilenceDoesNotTearDownHealthyUdpController:HttpTransport.SilentOldControllerReleasesOwnershipForReconnect'
```

下组只读当前车端诊断，不改变连接或运动状态。预期新版session_idle_timeout_ms=10000；如再次断开，优先保存last_disconnect的stage/error和对应历史，不能只截“操作者已断开”。Ctrl+C结束，无需回滚。

```bash
cd /home/jetson/luhao/my_nav_carcar
curl --max-time 3 -fsS http://127.0.0.1:8080/api/diagnostics | jq '{phase,task_state,error,control:{armed:.control.armed,reason:.control.reason,health:.control.health,x:.control.x,yaw:.control.yaw,last_stop:.control.last_stop},transport,events:[.events[]|select(.event=="controller_disconnected")][-5:]}'
```

**R11回退：**若确需恢复R10，先保存需要的工程、确认未使能/物理停车并关闭网页。下组会结束当前任务，恢复检查点完整网页和R10网关/门控二进制，再启动到待命；不覆盖已保存工程和系统，不自动启动硬件。任一步失败停止并保留输出，重新构建R11后重载原服务可恢复本节版本。若仅需对照旧WebSocket，可先使用网页辅助区通道选项，无需重启硬件。

```bash
cd /home/jetson/luhao/my_nav_carcar
carcar_r11_checkpoint="$PWD/log/mapping_connection_r11_20261015_P1oPXb"
bash -e -s -- "$carcar_r11_checkpoint" <<'ROLLBACK_R11'
systemctl --user stop mapping-tablet.service
tar -xzf "$1/before_source_and_docs.tar.gz" src/carcar_mapping_console/web
cp -p "$1/before_mapping_web_gateway" build/carcar_mapping_console/mapping_web_gateway
cp -p "$1/before_mapping_teleop_guard" build/carcar_mapping_console/mapping_teleop_guard
systemctl --user start mapping-tablet.service
ROLLBACK_R11
```

### 33.17 推杆断流与挑战补发（NAV-017-R13，2026-10-19）

依据仍是2026-10-14至10-16的现场记录，不是新的实车推杆通过。R5三次“操纵授权超时”时，网页控制间隔305～316ms，脚本间隔约131～152ms，最后一条已接受命令的挑战年龄约6ms，随后没有续上的运动包。R7和R12在没有记录到同期脚本卡顿时，仍出现303～350ms控制间隔。恢复前台时集中上报的数秒`script_delay`不当作推杆过程中的持续卡顿。因此本轮不暂停地图绘制，也不放宽300ms运动截止。

网页在控制状态仍新鲜、手指仍按住时，对当前挑战每50ms可以再发一次运动包，避免不可靠数据通道丢掉单独一包后一直空等。车端截止仍从该挑战原来的签发时刻计算，补发不能把许可延长到签发后300ms之外。状态包在写出前已经超过300ms则丢弃，不改写签发时间。数据通道有积压时不追加，只保留最新一条；缓冲排空后若仍未过期按原时间发出，过期则放弃。断连、页面隐藏、松手、雷达或里程计过期仍然立刻零速并撤使能。

诊断里的页面版本应为`20261019-r13`，连接后事件含`client_ui_r13`。只更新了网页和网关里的状态发送，不改变底盘速度、雷达或运动门控的300ms。刷新网页会重建连接并撤销使能，需要重新使能；不要求为这一项重启底盘或重发S1。若平板到车的ping中位仍明显大于约150ms，先检查平板是否连着“小泽”、是否打开省电以及距离，因为这种往返无法同时满足连续行驶和迟到就停。实车持续推杆、松手和停车距离仍待现场确认，不能把离线回归写成已通过。

构建与网页回归沿用[33.14](#mapping-webrtc-r9)的包构建和浏览器测试；本轮额外只跑下面两组，不打开实车串口，不取得8080控制权。失败保留输出，Ctrl+C停止即可。

```bash
cd /home/jetson/luhao/my_nav_carcar
source /opt/ros/humble/setup.bash
source install/setup.bash
node src/carcar_mapping_console/test/test_browser_rtc.js src/carcar_mapping_console/web/app.js
ROS_DOMAIN_ID=219 ROS_LOCALHOST_ONLY=1 \
  build/carcar_mapping_console/test_mapping_http \
  --gtest_filter='HttpTransport.CompactControlKeepsStopAndDropsExpiredPendingState'
```

**R13回退：**确认未使能且车辆停稳后，用版本管理里R13之前的`src/carcar_mapping_console/web/app.js`、`src/http_server.cpp`和`test/test_browser_rtc.js`、`test/test_http.cpp`覆盖回去，再按33.14重新构建网页网关。不要用删除文件的方式回退。未保存的建图工程按33.11处理，不在这里结束硬件。

### 33.18 使能被网页停车打断（NAV-017-R14，2026-10-19）

现场使能后状态在「已使能」和「网页请求停车」之间跳动，推杆后又出现「操纵授权超时」。WebRTC 接通、失败或短暂断开都会发一条停车；摇杆运动又只走会丢包的数据通道，300ms 内没续上就撤使能。

这一版不改 300ms，也不改底盘速度。页面默认改为 WebSocket。通道接通或退回 WebSocket 都不再当成操作者停车。若辅助区仍选 WebRTC，同一条摇杆指令会再送一份可靠副本；车端只收下带副本标记的那份，切换前已经排在 TCP 里的旧运动继续丢掉。副本如果晚于签发后 300ms，不能把许可延长。

2026-10-19 19:56 已按 33.11 重载：旧网关 32558 正常退出，新进程回到网页待命，底盘、雷达和 SLAM 已停止。重载前的 SLAM 备份在 `log/mapping_restart_xyGcR6`，没有正式工程清单，不能在网页里直接续建。平板刷新 8080 后重新从页面启动硬件；启动仍会发 S1=94，须先处理轮动力和支架扫掠。刷新会撤销使能，需要重新点使能。默认保持 WebSocket。

同日晚间的误停来自用挑战续租。现已改成主流看门狗：按住就每 50ms 重复当前方向，车上从最后收到的时刻保持 1 秒，到点只归零，不撤使能。手还按着时，下一条命令直接继续。挑战不再参与续租。雷达、里程计和建图会话的过期检查没有放宽，那些失效仍撤使能。改门控后必须结束并重新启动本次硬件任务，并刷新网页。只刷新网页不会换掉正在跑的门控。

构建与网页回归沿用 33.14 和 33.17 的两组命令。本轮额外的 HTTP 用例是 `HttpTransport.RealUdpChannelSharesOwnerAndDropsOldTcpMotionAfterSwitch`。失败保留输出。Ctrl+C 停止即可，不要在建图进行中重载服务。

### 33.19 平板作中介的静止网络MVP（NET-001，2026-10-20）

本节新增独立试验，不把33.8旧“Jetson开热点”工具用于本次连接。结构是“小泽WiFi→平板上游；平板热点→Jetson和电脑”，平板浏览器也访问热点内的车端网页。**2026-10-20用户将当前目标热点更新为 `chenjiajun`；下方准备命令已同步，新热点的网段/网关须重新读回，不沿用旧地址。** 初次试验热点名为 `Hao.iPhone`，用户确认台式机已接入、能经平板访问仍在“小泽”的Jetson；这只证明该时刻的上游转发，不证明两台热点客户端互访、锁屏或断上游通过。旧热点取址与恢复证据保留在NET-001-R2。热点名称不作为设备型号依据。用户报告该拓扑下代理端口与Codex联网存在问题，本轮按用户要求不处理；不修改代理、VPN、路由器、防火墙、驱动或账号权限，不以Codex联网作为验收条件。

**先保持车体静止、结束建图及巡检，确认轮动力隔离或可靠架空、支架无风险。本节不启动任何硬件。** 所有完整终端命令均在车上Jetson执行；电脑终端先通过现有SSH进入车端。平板先保持连接“小泽”并开启热点，电脑加入 `chenjiajun`；允许客户端至少2台，确认热点没有客户端隔离。检查平板客户端列表能显示IP，或先确认电脑已有设备发现工具可按Jetson网卡MAC查到IP；没有可靠地址获取方式时不切车端网络。用户已选择直连屏幕在Jetson本机查看地址，可在其接入目标热点后按第五组的接口/路由只读命令读取，现场接线及实际连接仍须核对。密码只在本地终端隐藏输入，不放进聊天、命令行或shell历史。固定IP不是信号保护；首次用DHCP，不能带着原 `192.168.5.11` 地址硬接另一个网段。

**第一组构建及只读检查：**读取源码和当前NetworkManager状态、写入build/install/log及临时Python缓存，不更改系统网络、不占串口、不发送运动。预期编译、离线测试通过，状态显示当前接口IPv4且无检查点；Ctrl+C停止构建/查询即可，不影响原连接。已完成本轮构建的机器可只运行最后一行状态查询。

```bash
cd /home/jetson/luhao/my_nav_carcar
source /opt/ros/humble/setup.bash
source install/setup.bash
CMAKE_BUILD_PARALLEL_LEVEL=2 colcon build --symlink-install --packages-select carcar_mapping_console --allow-overriding carcar_mapping_console --executor sequential
ctest --test-dir build/carcar_mapping_console --output-on-failure
PYTHONPYCACHEPREFIX=/tmp/carcar_net001_pycache python3 -m compileall -q src/carcar_base/carcar_base
./install/carcar_mapping_console/lib/carcar_mapping_console/mapping_tablet_wifi_trial status
```

**第二组只准备、不切网：**需要sudo，系统密码和热点密码分别在本地输入。工具先要求8080的phase和task_state均为STANDBY、无巡检、底盘串口空闲；随后在 `/etc/NetworkManager/system-connections/` 创建完整同目录 `.carcar-tablet-*.backup`（root/0600），追加桌面 `/home/jetson/Desktop/系统配置维护记录.md`，在 `/var/lib/carcar-tablet-wifi-trial/` 保存root私有状态，向NetworkManager添加不落盘、禁自动连接的客户端配置。原连接不修改，密码仅交给NetworkManager内存；机器/NetworkManager重启后须重新准备。预期输出PREPARED、原UUID、备份路径、SHA256和可执行restore命令，原SSH继续可用。Ctrl+C可终止密码输入并恢复终端回显；失败不继续trial，保留备份和日志。重复prepare会保留上一份状态归档，不覆盖原网络配置。

```bash
cd /home/jetson/luhao/my_nav_carcar
sudo ./install/carcar_mapping_console/lib/carcar_mapping_console/mapping_tablet_wifi_trial prepare --ssid 'chenjiajun'
```

**第三组180秒试验：会断开原SSH。** 确认平板、电脑、车辆均在原路由器覆盖区内，原路由器保持供电。下组使用sudo，只切换 `wlP1p1s0` 的客户端连接，不改原配置或代理。后台进程重新预检，先建立NetworkManager的180秒检查点并写入状态/维护记录，成功后才请求连接热点；检查点失败或记录失败不切网。计时由NetworkManager持有，不依赖SSH窗口、浏览器、Codex或后台监视进程。后台仅记录接口状态/IPv4及恢复结果；没有“验收成功就永久保持热点”的入口。预期旧SSH中断，Jetson在平板列表出现新IP，约180秒后回原WiFi。**计时不是独立硬件救援，驱动或NetworkManager卡死仍可能需要现场处理；不以重启反复试错。** 想提前停止时，用下一组restore；在断开的旧终端按Ctrl+C不能撤回已提交的试验，也不会取消自动回滚。

```bash
cd /home/jetson/luhao/my_nav_carcar
sudo ./install/carcar_mapping_console/lib/carcar_mapping_console/mapping_tablet_wifi_trial trial
```

**热点窗口内的观察：**在平板客户端列表按Jetson网卡MAC（本轮读回 `dc:4a:9e:d2:fc:23`，以现场读回为准）找到新IP。电脑SSH客户端使用原用户名 `jetson` 和原密钥/认证方式连接新IP；这是同一台Jetson，但新IP可能首次提示主机密钥，需与原已知指纹核对，不关闭主机密钥检查。平板浏览器打开新IP的8080端口，确认待命页，不点击启动硬件。先确认电脑能上网、SSH稳定、平板能读待命状态，再短暂关闭平板上游WiFi，观察热点本身是否保留、SSH和本地网页能否继续；随后立即恢复上游WiFi。平板短暂锁屏再解锁，观察热点与连接，不把浏览器后台暂停刷新直接判为无线断开。若时间不够，不延长倒计时、不取消检查点，回原网后重新prepare再做下一轮。电脑必须保持在平板热点覆盖内；平板跟车而电脑留远处仍会失去SSH。

NET-001-R2现场修订：平板实际可能不显示客户端IP。即使热点窗口内无法发现地址，后台仍会把DHCP取址保存到状态的`tablet_snapshot.ipv4`及桌面维护记录；待回原网后按第五组读取，可用于核对刚才地址。该记录是历史取址，不保证下一次不变。改静态地址前先核对热点网关、DHCP池与重启后的网段稳定性；不能直接套用原WiFi地址或猜测网关，也不能把未经热点实测的`.local`主机名当作可靠入口。

**使用Jetson本机屏幕观察新地址：**先接好屏幕及本机输入设备，在该屏幕终端执行第三组trial，避免旧SSH断开后看不到信息。切换数秒后，下一条命令只读当前WiFi名称、IPv4和检查点，不修改网络、不启动硬件；预期`current.ssid`为`chenjiajun`、`current.ipv4`出现新地址，若仍在连接中可再次查询。Ctrl+C只结束查询，不取消后台试验或180秒回滚。只采用当前实际连接热点时的地址，回原网后该地址仅作历史记录。

```bash
cd /home/jetson/luhao/my_nav_carcar
./install/carcar_mapping_console/lib/carcar_mapping_console/mapping_tablet_wifi_trial status
```

**第四组状态与提前恢复：**从当前仍可用的SSH运行。status仅读取当前接口、检查点及试验记录；restore会请求回原WiFi，当前热点SSH可能断开，不发送运动、不删除备份。预期原UUID、接口device_state=100及原网段IPv4重新出现，后台记录RESTORED；这只确认软件连接恢复，仍须电脑重新SSH确认。若热点内无法SSH，保持原路由器可达并等本轮自动回滚，再按读回地址连接。没有独立恢复通道时，等待后仍无法恢复就停止本轮，不继续发新切换指令。

```bash
cd /home/jetson/luhao/my_nav_carcar
sudo ./install/carcar_mapping_console/lib/carcar_mapping_console/mapping_tablet_wifi_trial status
sudo ./install/carcar_mapping_console/lib/carcar_mapping_console/mapping_tablet_wifi_trial restore
```

**第五组回原网后的证据：**下组只读root私有试验状态、后台日志、桌面维护记录和当前接口/路由，不修改网络。预期包含热点分配IPv4、trial_connected=true、RESTORED及恢复快照；trial_connected只证明Jetson取得地址，不证明两客户端互访。命令失败Ctrl+C停止查询，保留原始记录。登记日期和“电脑SSH/电脑上网/平板网页/断上游/锁屏/回原网SSH”六项实际结果；不提供密码、会话令牌或代理凭据。

```bash
cd /home/jetson/luhao/my_nav_carcar
sudo ./install/carcar_mapping_console/lib/carcar_mapping_console/mapping_tablet_wifi_trial status
sudo tail -n 60 /var/lib/carcar-tablet-wifi-trial/worker.log
tail -n 80 /home/jetson/Desktop/系统配置维护记录.md
ip -4 -brief address show wlP1p1s0
ip -4 route show
```

只有六项均有现场反馈才登记本轮网络通过；地图、视频、持续遥控、断流停车距离与全场覆盖另行验收。当前没有实际执行prepare/trial或改网络，本地sudo鉴权未完成时不得将代码构建当成切网完成。

### 33.20 弱特征建图：原工程审计与6m独立候选（NAV-017-R16）

适用问题：真实直角走廊被建成约100°～120°，属于待确认的地图几何变形；静态AMCL重定位只能在既有图中找位置，不能修正已画歪的墙。SLAM闭环能利用再次识别旧区域约束整张图，但弱观测或错误关联不保证自行恢复。保存时的栅格、位姿图与原始读回见[离线审计](archive/2026-10-20-弱特征建图审计/README.md)，现场反馈与软件验证见[测试记录R16](测试记录.md#nav-017-r16)。6m只改变软件使用范围，不改变激光功率或设备硬件能力；点多不等于能唯一确定位置。

**第一组：可选离线复核。**在车上Jetson工作区读取已保存的最后一个工程，编译并运行独立C++审计工具，输出到专用log目录。它读取地图/位姿图，不启动ROS节点、打开串口或控制硬件；编译有短时CPU/内存负载。预期读到637帧、3m阈值、每帧≤3m最少130点及≤6m最少457点。失败Ctrl+C结束并保留日志；原工程只读，不需要恢复硬件。工具仅用于可信的本仓库数据。

```bash
cd /home/jetson/luhao/my_nav_carcar
source /opt/ros/humble/setup.bash
cmake -S docs/archive/2026-10-20-弱特征建图审计 -B log/nav017_geometry_audit_build
cmake --build log/nav017_geometry_audit_build -j2
log/nav017_geometry_audit_build/audit src/carcar_navigation/maps/mapping_sessions/20261019_223507_5ec7cfe3 log/nav017_geometry_audit_review
```

**第二组：构建候选。**读取当前包并更新build/install/log中的构建产物，不改系统WiFi、服务配置或旧地图，不启动任何硬件。先确保没有其他构建进程写同一工作区。预期包构建成功，XML参数解析列出8080端口和独立候选保存目录；失败Ctrl+C停止构建，修正后重跑，现行3m配置与入口仍保留。

```bash
cd /home/jetson/luhao/my_nav_carcar
source /opt/ros/humble/setup.bash
source install/setup.bash
colcon build --packages-select carcar_mapping_console --symlink-install --executor sequential
source install/setup.bash
ros2 launch carcar_mapping_console tablet_range6_candidate.launch.xml --show-args
```

**第三组：现场候选试验，须有人目视车辆。**先按33.6保存结束当前任务，网页确认STANDBY，确认底盘/雷达没有其他所有者；不能在未保存建图中直接停服务。下组停止原网页进程并临时占用同一8080端口，SSH和WiFi配置不变；候选启动只到网页待命，硬件仍由网页显式启动。启动硬件会发送底盘零运动并初始化S1=94，支架可能转动，须先隔离轮动力或可靠架空并清空支架扫掠区，按33.4完成静止检查后才恢复落地低速试验。候选不是自动避障或弱特征自动保护，现场必须能立即断开车轮实际动力；异常点“停车并锁定”，通信不可用则断开轮动力，再Ctrl+C结束候选。停止ROS进程不能替代实物停稳确认。

```bash
cd /home/jetson/luhao/my_nav_carcar
source /opt/ros/humble/setup.bash
source install/setup.bash
export ROS_DOMAIN_ID=31
export ROS_LOCALHOST_ONLY=1
export RMW_IMPLEMENTATION=rmw_fastrtps_cpp
systemctl --user stop mapping-tablet.service
ros2 launch carcar_mapping_console tablet_range6_candidate.launch.xml
```

平板沿用车端当前地址的8080网页。候选只选“新建”，输出保存到 `src/carcar_navigation/maps/mapping_range6_candidate_sessions/`；选“续建”会明确拒绝，因为旧位姿图序列化了原传感器阈值。保存后若“重启”将隐式续建也会拒绝，须保存结束后新建下一轮。验收时检查新工程manifest的 `runtime_parameters.max_laser_range` 为6；不能只凭XML或源码文件认定实际生效。

**同路线对照与判定：**先用原3m入口记录短距离基线，再用6m候选走同一段已确认的直角/弱特征区域，均固定慢档0.05m/s、0.10rad/s上限、相同载荷/路线，分别保存独立工程。每种条件重复3次，比较对应墙体的转角误差、墙体重影、返回同一实物标记处的位姿偏差，以及发生质量异常的地点/时间。建议本轮暂定转角误差≤5°，同时要求3次均无明显重影；这是本项目候选门槛，非产品精度声明，位置误差还须尺量对照记录。一次看起来较好不转正式默认。

若仍变形，先保留本次坏图并停车；后续再分别录制完整 `/scan`、`/wheel/odometry`、`/tf`、`/tf_static`、SLAM位姿及IMU观察数据，复核实物转角与轮式推算、时间戳/TF及闭环变化。不得只把图上车标拖回，或默认每个建筑拐角都是90°后强行拉直整图。建图质量告警/锁停/扫描冻结尚未实现，当前新鲜度门控不等同几何质量保证。

**第四组：恢复日常入口。**先在候选网页保存结束，确认车轮停稳，再在候选终端Ctrl+C。下组重新启动原网页待命服务；不会主动开始新建图，不删除候选或旧工程。预期8080恢复普通入口，下一次新建仍用原3m；若端口占用，先确认候选已退出，不杀未知进程。执行后异常按33.11停车恢复。

```bash
cd /home/jetson/luhao/my_nav_carcar
systemctl --user start mapping-tablet.service
systemctl --user status mapping-tablet.service --no-pager
```

## 34. 项目瘦身检查点与恢复（MAINT-001）

2026-10-14第一阶段只生成[瘦身报告](archive/2026-10-14-项目瘦身报告.md)、建立仓库外完整快照并验证基线。批量删除、历史迁移、AGENTS精简与代码重构须先由用户确认报告。已有底层测试、地图/标定/模型/参数/rosbag及原始失败证据继续保留；此节不启动执行器、切网络或停止现有网页。

### 34.1 校验检查点

下组在Jetson读取完整tar并计算SHA256、查看初始Git状态，核对快照可读且未损坏。只读，不覆盖工作区或系统，不影响硬件；预期显示project.tar为OK，状态包含原有45项文件变更。中途Ctrl+C可停止校验，不需要回滚；校验失败不要用该包恢复。扫描证据和来源清单保存在evidence，目录不应公开上传。

```bash
cd /home/jetson/luhao/my_nav_carcar
cleanup_checkpoint="/home/jetson/luhao/my_nav_carcar_backups/cleanup_20261014_093557_211919094"
sha256sum --check "$cleanup_checkpoint/project.tar.sha256"
cat "$cleanup_checkpoint/evidence/head.txt"
cat "$cleanup_checkpoint/evidence/git-status-before.txt"
```

### 34.2 恢复到新目录，不覆盖当前工作区

下面只读取检查点、在仓库旁创建唯一恢复目录并解包，预计额外占用约1.9 GiB；保留当前未提交文件，不执行reset/clean或切换系统。完整快照包含.git、ignored与生成产物，但不会沿符号链接备份仓库外系统资源。预期新目录出现完整源码/资源，Git状态与初始记录对应。解包异常Ctrl+C停止，原项目不受影响，保留部分恢复目录排查，不自动删除。副本install中的绝对链接仍可能指向原工作区，恢复后需要按包重新构建；不得直接启动副本实车入口。

```bash
(
set -e
cd /home/jetson/luhao/my_nav_carcar
cleanup_checkpoint="/home/jetson/luhao/my_nav_carcar_backups/cleanup_20261014_093557_211919094"
sha256sum --check "$cleanup_checkpoint/project.tar.sha256"
cleanup_restore_dir="/home/jetson/luhao/my_nav_carcar_restore_$(date +%Y%m%d_%H%M%S_%N)"
mkdir -m 700 "$cleanup_restore_dir"
tar --acls --xattrs -xpf "$cleanup_checkpoint/project.tar" -C "$cleanup_restore_dir"
printf '恢复副本：%s\n' "$cleanup_restore_dir"
git -C "$cleanup_restore_dir" status --short
)
```

### 34.3 本轮基线复核

本轮未改源码，以下使用已有构建产物；后续若批准修改代码，必须先构建对应包，不能把旧二进制结果当新代码验证。测试仅在隔离域/localhost运行替身节点、协议/差速逻辑和不打开串口的插件测试；写build下的测试结果，不打开实车硬件、相机或雷达，不影响域31现有软件预览。预期32项建图、48项底盘、20项硬件逻辑/插件、2项图像及8项硬件lint通过，XML/JS/差异检查无错。失败Ctrl+C停止测试并保留日志，不能继续删除或重构。

```bash
cd /home/jetson/luhao/my_nav_carcar
source /opt/ros/humble/setup.bash
source install/setup.bash
export ROS_DOMAIN_ID=219 ROS_LOCALHOST_ONLY=1 RMW_IMPLEMENTATION=rmw_fastrtps_cpp
ctest --test-dir build/carcar_mapping_console --output-on-failure
PYTHONDONTWRITEBYTECODE=1 python3 -m pytest src/carcar_base/test -q -p no:cacheprovider
ctest --test-dir build/carcar_hardware --output-on-failure
ctest --test-dir build/carcar_camera -R '^test_image_reference$' --output-on-failure
node --check src/carcar_mapping_console/web/app.js
rg --files src/carcar_* src/inspection_bringup -g '*.xml' -0 | xargs -0 xmllint --noout
git diff --check
```

静态扫描使用本机Cppcheck2.7，整批和逐文件原始失败均保留在检查点；http_server.cpp的139退出是分析工具崩溃，不能登记为代码编译失败或由此删除实现。完整清单、重复片段、调用关系边界和下阶段验收前提只维护报告，当前不提供批量删除命令。

### 34.4 批准后的维护验证与执行前检查点

2026-10-14用户已批准文档归档和小缓存批次。第二份执行前完整快照位于`/home/jetson/luhao/my_nav_carcar_backups/cleanup_execute_20261014_095956_097155074`，包含第一阶段报告及当时全部未提交内容；34.1/34.2保留的第一份快照可恢复到整个维护任务开始前。两份快照都在仓库外，校验失败时不要恢复，统一解包到新目录。

本组只校验执行前快照、读取原Git状态，不改工作区/网络或硬件；预期SHA256为OK、状态保留执行前46项文件变更。Ctrl+C可停止读取，不需要回滚。

```bash
cd /home/jetson/luhao/my_nav_carcar
cleanup_execution_checkpoint="/home/jetson/luhao/my_nav_carcar_backups/cleanup_execute_20261014_095956_097155074"
sha256sum --check "$cleanup_execution_checkpoint/project.tar.sha256"
cat "$cleanup_execution_checkpoint/evidence/git-status-before.txt"
```

批准批次会更新归档链接、README与CMake归档说明注释，以下先构建对应包以更新安装资源，再复用34.3的功能测试；构建只写build/install/log，不启动节点、传感器或执行器。源码/参数保持不变，预期六包构建成功，已有PCL/CMake警告保留；失败Ctrl+C停止并保留日志，不删除构建目录。修改底层代码时还需对应源码静态检查，不能用这次资源构建结果代替。

```bash
cd /home/jetson/luhao/my_nav_carcar
source /opt/ros/humble/setup.bash
source install/setup.bash
export PYTHONDONTWRITEBYTECODE=1
CMAKE_BUILD_PARALLEL_LEVEL=2 colcon build --symlink-install --packages-select carcar_hardware carcar_description carcar_camera carcar_navigation carcar_inspection carcar_mapping_console --executor sequential
source install/setup.bash
```

复核项目清理技能时，下组只读取SKILL的格式/元数据并用既有验证器检查，不改项目、不安装依赖或启动硬件；预期Skill is valid，Ctrl+C取消即可。维护缓存时不要在项目内重新生成pyc；需要Python静态编译时，下组把缓存放仓库外检查点/evidence，保留失败日志。完成后再按34.3运行功能测试，pytest使用禁止写字节码/测试缓存的设置。

```bash
cd /home/jetson/luhao/my_nav_carcar
cleanup_execution_checkpoint="/home/jetson/luhao/my_nav_carcar_backups/cleanup_execute_20261014_095956_097155074"
PYTHONDONTWRITEBYTECODE=1 python3 /home/jetson/.codex/skills/.system/skill-creator/scripts/quick_validate.py .agents/skills/project-cleanup
PYTHONPYCACHEPREFIX="$cleanup_execution_checkpoint/evidence/pycache" python3 -m compileall -q src/carcar_base/carcar_base src/carcar_base/test
```

本轮额外flake8发现9条既有E501行长告警，执行前副本与执行后输出排序比对一致，未修改底层Python以消除此类历史格式问题。102项功能测试和8项hardware lint通过，不表述为全部静态分析通过。完整变更、调用核实与保全清单只见[执行结果](archive/2026-10-14-瘦身执行结果.md)。

## 35 网页巡检与逐步舵机示教（APP-001-R1）

2026-10-15新增，2026-10-19补充备选停车位和上传队列。平板入口已并入 8080 的「巡检」，8081 只在车端本机接受转发，默认绑定 `127.0.0.1`。范围与实际接口统一见[应用说明](../src/carcar_inspection/README.md)。每个拍摄目标最多三个停车位，每个停车位有自己的朝向和俯仰，成功到达后拍一张RGB；网页配置点位、顺序与独立最终停车位，任务在车端执行。默认入口只配置，实机角度、回位重复性、模式切换和巡检未验收。`upload_url`默认为空，照片只留在车上并标为待配置。

以下命令均在车端Jetson的项目目录执行；电脑终端先按[第19节](#19-ubuntu-主机-rviz-联调)进入正确车端，IP先核对。构建使用仓库外临时前缀，原 `install/` 与运行中的建图服务不替换。`/tmp`前缀是开发验证资产，系统清理后须重建；正式点位数据应使用持久目录并独立备份。

### 35.1 构建网页与独立ROS前缀

这组命令读取源码和锁文件，安装网页开发依赖，生成本地静态资源，并在 `/tmp/carcar_app001_*` 构建接口、驱动适配、共享HTTP库和巡检包；会写网页 `node_modules/dist` 及临时build/install/log，不打开串口、不启动传感器／电机、不重载服务。预期网页与四个ROS包构建成功；失败按Ctrl+C，保留日志，原安装入口仍可用。本机Node22.23.2满足所选工具的>=22.12要求，不使用全局安装或sudo。临时前缀关闭RTC仅为减少巡检验证依赖，原建图WebRTC安装不变。

```bash
cd /home/jetson/luhao/my_nav_carcar
source /opt/ros/humble/setup.bash
source install/setup.bash
npm --prefix src/carcar_inspection/web ci --ignore-scripts --no-audit --no-fund
npm --prefix src/carcar_inspection/web run build
CMAKE_BUILD_PARALLEL_LEVEL=2 colcon --log-base /tmp/carcar_app001_log build \
  --build-base /tmp/carcar_app001_build --install-base /tmp/carcar_app001_install \
  --packages-select carcar_interfaces carcar_base carcar_mapping_console carcar_inspection \
  --allow-overriding carcar_interfaces carcar_base carcar_mapping_console carcar_inspection \
  --executor sequential --cmake-args -DMAPPING_ENABLE_WEBRTC=OFF -DBUILD_TESTING=ON
source /tmp/carcar_app001_install/setup.bash
```

### 35.2 离线验证

这组测试读取实现并写临时测试数据、浏览器截图和报告。ROS集成在隔离域227、Python适配测试在域228，所有串口／导航／传感器均为替身，不连接真实硬件；真实浏览器只访问本机18189测试端口。预期存储版本冲突、旧画面拒绝、单步边界、断网页自动巡检及最终停车等通过，浏览器完成实际点击确认流程。Ctrl+C停止测试；仅清理测试自建进程，不停止现有实机服务。Chromium运行包装使用本机既有snap库和bwrap，不修改系统；若没有这些资源，应记录浏览器未完成，不能计为通过。

```bash
cd /home/jetson/luhao/my_nav_carcar
source /opt/ros/humble/setup.bash
source install/setup.bash
source /tmp/carcar_app001_install/setup.bash
npm --prefix src/carcar_inspection/web test
INSPECTION_BROWSER_RUNTIME=/tmp/carcar_app001_build/carcar_inspection/inspection_test_chromium \
  ctest --test-dir /tmp/carcar_app001_build/carcar_inspection --output-on-failure
ROS_DOMAIN_ID=228 ROS_LOCALHOST_ONLY=1 PYTHONPYCACHEPREFIX=/tmp/carcar_app001_pycache \
  python3 -m pytest -q -p no:cacheprovider src/carcar_base/test
PYTHONPYCACHEPREFIX=/tmp/carcar_app001_pycache python3 -m py_compile \
  src/carcar_base/carcar_base/rosmaster_node.py src/carcar_base/test/test_inspection_servo_receiver.py
ctest --test-dir /tmp/carcar_app001_build/carcar_mapping_console \
  -R 'test_mapping_http|test_mapping_logic' --output-on-failure
```

### 35.3 网页配置预览（不控制硬件）

下组在车端本机启动巡检程序，只听 127.0.0.1:8081，读取已有地图并将草稿／任务写入单独的持久预览目录，不改地图、不订阅当前实机域、不下发角度或速度。平板从 8080 页首的「巡检」进入，由建图网关转发。如果预览已经运行，不要重复启动。预期地图和表单可用，真实传感器显示待就绪、调角和自动巡检按钮禁用；这是隔离配置模式的预期。Ctrl+C退出网页，已保存草稿保留，原建图入口不受影响。若端口被占用先查明来源，不杀未知进程。

```bash
cd /home/jetson/luhao/my_nav_carcar
source /opt/ros/humble/setup.bash
source install/setup.bash
source /tmp/carcar_app001_install/setup.bash
ROS_DOMAIN_ID=229 ROS_LOCALHOST_ONLY=1 ros2 launch carcar_inspection console.launch.xml \
  bind_address:=127.0.0.1 port:=8081 \
  data_root:=/home/jetson/.local/share/carcar_inspection_preview \
  enable_hardware:=false enable_navigation:=false
```

电脑和平板与小车在同一 Wi-Fi 时，用 Jetson 本次读回地址打开 8080，再点「巡检」。网页地图来自保存栅格、坐标系为该图 map，白／黑／灰表示空闲／占用／未知；蓝色箭头为定位估计、粉色箭头为编辑目标。缩放不改变米制坐标，拖动箭头设置车头朝向。相机预览使用当前 RGB 帧，历史参考照片另存；图像窗口大小不改变镜头视场，过期画面取消确认资格。

#### 35.3.1 网页位置标记入口（APP-001-R2）

从 8080 进入「巡检」后刷新页面。以下配置操作只写巡检草稿／任务，不修改保存地图、不发送车轮／舵机命令。预期地图出现粉色编辑箭头、保存后点位进入列表；选错可重新选点或修改坐标后再保存，未保存前刷新可放弃本次编辑。

1. 在“点位示教”上方选择场地地图，点击“载入地图”。画面是该地图版本的历史栅格，分辨率显示为米/格；屏幕比例不改变地图坐标，白色区域仍须现场核对车身净空和当前障碍。
2. 点击“新增点位”，再点击地图上方绿色的“在地图上选择巡检位置”。按住小车计划停车的位置，向车头朝向拖动后松开；右侧X/Y以米更新，朝向以度更新。单次选点完成后退出选点模式，重新选点须再次点击按钮；也可直接编辑数字。
3. 填写名称和草稿舵机目标角度，点击“保存巡检点草稿”。没有选择／录入位置时保存按钮禁用，防止把默认零坐标当作已选停车位。草稿标为“待现场确认”，刷新后可从点位列表重新打开。
4. 实车接入且定位有效时，“记录小车当前位置与朝向”可直接复制当前map定位估计；当前隔离配置模式没有定位数据，按钮禁用并显示原因。地图手选保存的是计划目标，实车试拍确认保存的是当时定位估计和新参考照片，两者均不是位置真值。
5. 在“巡检任务”添加点位、调整顺序，点击“在地图上选择最终停车位置”，同样按住并拖动确定最终车头方向，再保存任务。最终停车位独立于最后一个拍照点；未选择最终停车位时不能保存新任务。

“小车初始定位（停车后使用）”单独折叠在地图下方：它向定位系统提交小车实际所在位置的初值，需要停稳及实车接口，不能用于保存巡检目标，也不会让车开往该坐标。提交后仍须核对定位估计与实物一致。真实调角、试拍和行驶按下一节现场前提逐项进行。

#### 35.3.3 200 平方米规划草图（可自定观测点数量）

随行建图仍在 8080，入口和操作不变，见第 33 节。巡检 8081 的“点位示教”仍是载入 SLAM 保存的地图、在图上选点和调角。规划草图是旁边单独的一页，不是激光地图，不能直接让车自己出发。页面先问要放几个观测点：1、2、4、6、8 可以直接点，4 个只是建议；也可以自己填 1 到 20。摆上之后可以再加、去掉当前点、清空后重选、改名字、拖动位置和车头。确认画面仍要等小车在真地图上定位好。完整预览命令仍用 35.3，不另开一套启动方式。

#### 35.3.2 备选停车位与上传队列（APP-001-R3）

仍使用上一节的8081配置预览，不启动底盘或舵机。一个拍摄目标先按35.3.1保存并在实车完成一次试拍确认。之后把车开到另一个能看到同一目标的位置，重新逐步调角，画面确认后点“把当前位置存为备选停车位”。列表里该目标的停车位数量增加，最多3个；第4个会被车端拒绝。每个停车位保存自己的朝向和俯仰，不共用一个舵机角度。

自动执行时按停车位顺序尝试。这一位导航失败、被拒绝或超时，就取消并试下一位。三个都失败时，该目标记为未拍，任务继续后面的点，最后仍要去最终停车位。定位丢失、雷达过期、照片写不进去或最终停车失败，才会停整轮。上传失败不会让车再开一遍或重拍。

上传地址是巡检控制台参数`upload_url`，默认空字符串。需要接收端时，在35.1的启动命令上追加`upload_url:=https://你的接收地址/captures`。车端对这个地址POST照片，请求头带`X-Capture-Id`和`X-Content-Sha256`。接收端只有在HTTP 200的JSON里回显同一个编号和同一个sha256，车上才显示“已上传”。地址留空、网络失败或回显不一致时，照片留在车端，巡检记录显示“未配置上传”或“待上传”。不要把建图网页8080和巡检8081同时用来开车。

离线检查沿用35.2。只看本轮新增行为时，在35.1的临时前缀里执行：

```bash
cd /home/jetson/luhao/my_nav_carcar
source /opt/ros/humble/setup.bash
source /tmp/carcar_app001_install/setup.bash
/tmp/carcar_app001_build/carcar_inspection/test_inspection_core --gtest_filter='Executor.*:Domain.AtMostThree*:Upload.*'
```

这组只使用本机临时目录和loopback，不打开串口，不访问外网。失败保留输出。Ctrl+C停止测试即可。

### 35.4 后续现场分步舵机确认

现场测试前，关闭当前建图及其他底盘／雷达／RealSense／导航入口，确认控制板串口只有一个所有者；8081配置预览也先正常结束，避免端口冲突。新接口模式先做只读占用检查，再对本次控制板FD设置内核独占，失败拒绝启动、不杀其他进程；最后一个设备FD关闭后解除，不修改系统配置。**实机启动会使底盘发送零运动，并把S1初始化为板端94档／目标140.5°，相机会转动**；测试前须可靠架空或隔离轮动力、清空支架扫掠范围并检查线缆，现场人员可立即断开执行器电源。没有实际角度反馈，不能凭服务成功认定到位；异常先断开相关执行器动力，再Ctrl+C退出，禁止用重启反复试碰撞。

下面命令仅供满足上述现场条件后使用，本轮未执行。它会启动正式串口所有者、模型、雷达、定位、D435与实验导航，显式启用舵机接口；`enable_navigation=false` 禁止网页启动自动巡检。先只做静止示教，不能因ROS进程出现而认定实机验收通过。Ctrl+C会结束本次入口；执行器可能保持最后姿态及扭矩，不自动扫回，必要时断开其实际电源。原入口和全部原参数保留，回退时先确认相关进程及串口退出，再按既有手册恢复。

```bash
cd /home/jetson/luhao/my_nav_carcar
source /opt/ros/humble/setup.bash
source install/setup.bash
source /tmp/carcar_app001_install/setup.bash
ROS_DOMAIN_ID=31 ROS_LOCALHOST_ONLY=1 ros2 launch carcar_inspection inspection_robot.launch.xml \
  real_hardware:=true enable_navigation:=false port:=8081 \
  data_root:=/home/jetson/.local/share/carcar_inspection
```

网页现场操作顺序：

1. 选择与定位入口相同的地图；实际车辆位置不一致时，点击地图选点按钮并标出车辆真实位置与朝向，展开“小车初始定位（停车后使用）”，点击“提交小车初始定位”，核对初值并等待定位健康。停车目标和车辆当前位置分开理解。
2. 点击“新增点位”，填写名称。选择“开始角度调整”，由驱动锁存零输出；等待轮式静止反馈满足条件，界面才允许下发。
3. 从当前命令起每次点击“目标−1°”或“目标＋1°”，不长按、不跨越多步；历史方向为减小抬头、增大低头，首次必须现场核对。也可“下发当前目标”以取得本次发送结果和新画面。
4. 每次等到命令发送结束、稳定候选时间经过，并看到本次调整后的新RGB画面；异常立即停止。网页同时显示目标和板端档位，整数取整可能使相邻目标映射到同一档，不能据此虚构实际角度变化。
5. 确认车体静止、支架正常、目标完整可见后，点击“确认此画面，保存巡检点”。保存的是本次已显示的新帧和当前地图定位估计，网页不能用旧图或旧修订状态确认。
6. 保存后仍保持停车。需要恢复导航时重新开始调整，逐步回到94档，并查看新画面、人工确认导航参考姿态；需要移动时再显式遥控使能。首轮静止验收不使能车轮。
7. 后续再单独验收回位重复性、TF／深度健康和地图重建；通过后才测试低速回访、单点采集、多点与最终停车。自动导航启用须另按当前现场门槛操作，不能将本节静止通过直接扩大为整轮通过。

网页关闭或调角请求超时保留停车保持；重新连接后须重新开始示教确认。服务失效／驱动重启会使旧代次失效；程序退出或重启不重放旧速度或导航。人工取消默认原地停车，不自动返回最终停车位。恢复遇到所有者占用时，先核对旧进程与实物状态，不擅自抢占或杀未知串口进程。

## 36 D435体素降采样、组件通信与GPU核实（CAM-005）

本节用于相机处理性能隔离验证。**VoxelGrid**把光学坐标系内同一1 cm立方格的已确认标障点替换为质心，输入为原高度/自体/时间筛选后的点，输出仍是 `/camera/navigation/obstacles`，原header不变；地面先被分类，清障点不降采样。它与STVL的2 cm占据体素用途不同，也不是删除少量邻居的ROR去噪。点数降低不等于误标修复，1 cm是未完成小障碍实机验收的候选值。

**组件化**使相机与筛选在一个容器进程中运行；两端启用IPC（进程内通信）后，本地消息可避免DDS序列化。独立Nav2/RViz/录包仍跨进程，外部订阅原始大点云也仍增加传输开销。相机图像模式、TF、健康0.5秒门槛不放宽；持久健康话题保留DDS。当前建图RGB-only没有深度点云，不受VoxelGrid加速，也不隐式切换入口。

### 36.1 构建与离线检查

下面在Jetson工作区读取源码、写入build/install/log，运行合成消息测试；不会打开相机、串口或执行器，不改系统配置。预期构建与相机包测试通过，组件类型中出现 `carcar_camera::DepthCloudFilter`。异常Ctrl+C停止并保留输出，未通过不进入实机；旧配置/入口保留。Python静态检查只检查已有底层资产，不新增Python节点。

```bash
cd /home/jetson/luhao/my_nav_carcar
source /opt/ros/humble/setup.bash
colcon build --packages-select carcar_camera --symlink-install --parallel-workers 1 --cmake-args -DCMAKE_BUILD_TYPE=RelWithDebInfo
source install/setup.bash
colcon test --packages-select carcar_camera --ctest-args --output-on-failure
colcon test-result --test-result-base build/carcar_camera --verbose
PYTHONPYCACHEPREFIX=/tmp/carcar_d435_pycache python3 -m compileall -q src/carcar_base/carcar_base src/carcar_camera scripts/check_d435.py scripts/view_d435_safe.py
ros2 component types
```

### 36.2 唯一相机与隔离性能对照

先停止已有相机入口及RealSense Viewer，等待至少5秒。以下只查询是否已有相机所有者；如有输出，核对并从其原终端停止，不盲杀进程。现有建图任务也不要在本节期间通过网页另开RGB。ROS域只能隔离话题，不能隔离USB硬件所有权。确认当前车辆静止，保持支架姿态；本节不打开底盘、不下发舵机或速度，临时外参仅供计算路径对照，不确认当前实物几何。相机开流会增加USB/CPU/内存负载；任一异常Ctrl+C停止该相机Launch，确认退出后等待5秒再恢复旧入口。

```bash
cd /home/jetson/luhao/my_nav_carcar
pgrep -af 'realsense2_camera_node|component_container_mt|realsense-viewer'
```

终端A仅在域87发布模型和候选固定TF，不打开硬件，也不和日常域共用模型。读取历史94档外参不代表本次实物到位。预期模型进程持续运行，异常Ctrl+C停止；结束本轮也Ctrl+C退出。

```bash
cd /home/jetson/luhao/my_nav_carcar
source /opt/ros/humble/setup.bash
source install/setup.bash
export ROS_DOMAIN_ID=87 ROS_LOCALHOST_ONLY=1
ros2 launch carcar_description description.launch.xml camera_extrinsics_file:="$PWD/src/carcar_description/config/camera_extrinsics_level94_ground_candidate_20261008.yaml" preview_wheels:=false use_rviz:=false
```

终端B启动新的相机组件候选，默认IPC=true、VoxelGrid=true、边长0.01 m、监督器关闭，无RViz。预期同一 `/d435_container` 加载相机与筛选两个组件。完整对照依次用旧 `camera_navigation.launch.xml`（同一filter_params_file）、新入口加 `voxel_grid_enable:=false`、下方新入口默认值；每组必须先Ctrl+C退出、检查所有者已消失并等待5秒，不能并行开相机。每组保持相同场景、源流、TF和订阅负载；后台构建等负载不一致时，只比较点数与路径事实，不给整机CPU收益结论。

```bash
cd /home/jetson/luhao/my_nav_carcar
source /opt/ros/humble/setup.bash
source install/setup.bash
export ROS_DOMAIN_ID=87 ROS_LOCALHOST_ONLY=1
ros2 launch carcar_camera camera_navigation_composed.launch.xml filter_params_file:="$PWD/src/carcar_camera/config/depth_filter_stvl_temporal_candidate.yaml"
```

终端C只读订阅原始点云与诊断，把健康/计数/耗时CSV写到新log子目录，不录大点云，不控制硬件。预期15秒窗口≥5 Hz、间隔/时间戳≤0.5秒、无异常诊断；短窗不代替600秒及小障碍验收。每组必须使用新输出目录，不覆盖失败结果；异常Ctrl+C使本轮无效，保留原始数据。这个外部原始点云订阅本身会触发DDS传输，因此不能据此宣称全链路零复制。

```bash
cd /home/jetson/luhao/my_nav_carcar
source /opt/ros/humble/setup.bash
source install/setup.bash
export ROS_DOMAIN_ID=87 ROS_LOCALHOST_ONLY=1
d435_window_dir="$PWD/log/d435_window_$(date +%Y%m%d_%H%M%S)"
ros2 run carcar_camera depth_health_window --ros-args -p duration_s:=15.0 -p output_dir:="$d435_window_dir"
cat "$d435_window_dir/summary.txt"
ros2 component list
ros2 topic echo /camera/navigation/diagnostics --once
```

诊断的 `intra_process_comms=true` 是配置值，`intra_process_frames` 才是实际IPC接收帧数，正常应递增且 `inter_process_frames=0`。`obstacle_points_before_voxel/obstacle_points` 表示同帧降采样前后；`processing_ms` 包含筛选、VoxelGrid与发布，`voxel_filter_ms` 是其中的降采样部分，二者不能相加；每200ms诊断记录的只是最近一帧，相同 `processed_frames` 重复行要去重，统计不能冒充逐帧全量审计。健康工具原CSV列保留，新指标追加于diagnostics.csv。

### 36.3 GPU实际调用核实与回退

第一组只创建SDK处理块、查询CUDA驱动和设备，不开启相机或写配置。预期同时看到SDK选择日志、驱动返回码、设备数；Ctrl+C可停止。SDK 2.58.4在Jetson上CUDA/NEON混合实现仍名为 `Pointcloud (NEON)`，名称不能判后端；`cuInit=0`和有设备只说明驱动可用，不证明当前相机已经执行CUDA内核。

```bash
cd /home/jetson/luhao/my_nav_carcar
source /opt/ros/humble/setup.bash
source install/setup.bash
ros2 run carcar_camera depth_compute_probe
```

第二组须先按36.2停止终端B并确认释放相机、等待5秒；终端A可保留。它以Nsight启动唯一相机候选并记录20秒CUDA调用，会增加性能开销、写入新的跟踪文件，但不改驱动/系统/舵机。预期内核汇总出现深度反投影内核；跟踪耗时不参与上一组性能统计。20秒后发送中断信号停止，提前异常可Ctrl+C；结束必须再次检查相机所有者，发现残留从其原启动终端停止。仅有动态库或整机GPU百分比0不足以否定短内核执行。

```bash
cd /home/jetson/luhao/my_nav_carcar
source /opt/ros/humble/setup.bash
source install/setup.bash
export ROS_DOMAIN_ID=87 ROS_LOCALHOST_ONLY=1 LRS_LOG_LEVEL=info
d435_trace_path="$PWD/log/d435_cuda_$(date +%Y%m%d_%H%M%S)"
/opt/nvidia/nsight-systems/2024.5.4/bin/nsys profile --trace=cuda --sample=none --cpuctxsw=none --duration=20 --kill=2 --output="$d435_trace_path" ros2 launch carcar_camera camera_navigation_composed.launch.xml
/opt/nvidia/nsight-systems/2024.5.4/bin/nsys stats --report cuda_gpu_kern_sum,cuda_api_sum "$d435_trace_path.nsys-rep"
pgrep -af 'realsense2_camera_node|component_container_mt'
```

回退时先结束本节相机和模型、确认没有残留、等待5秒。下面恢复同一隔离域的旧独立进程相机入口，读取原驱动/过滤参数，不删除候选或跟踪文件；需要TF时仍按36.2独立模型。预期筛选IPC=false、VoxelGrid=false；Ctrl+C停止。恢复日常导航须回到其原域/完整入口并先满足31节的姿态、健康和运动前提，不能把本节性能通过当作避障安全通过。

```bash
cd /home/jetson/luhao/my_nav_carcar
source /opt/ros/humble/setup.bash
source install/setup.bash
export ROS_DOMAIN_ID=87 ROS_LOCALHOST_ONLY=1
unset LRS_LOG_LEVEL
ros2 launch carcar_camera camera_navigation.launch.xml filter_params_file:="$PWD/src/carcar_camera/config/depth_filter_stvl_temporal_candidate.yaml"
```

## 37 Jetson自动代理（NET-002）

首轮核对及明确IP修正原文保留在[归档](archive/2026-10-20-自动代理首轮诊断与兼容修正.md)。当前C++入口与完整恢复流程见下节；旧Python文件保留作回退，不再由正式服务运行。

### 37.1 C++入口、验证与恢复（NET-002-R1）

作用：保持本机HTTP代理127.0.0.1:17892，背景验证真实HTTPS、按优先级选择健康候选、失败冷却并恢复；不是透明代理或VPN。新终端根据当前小子网生成明确地址列表兼容curl7.81，既有进程不自动更新。实现和限制见[scripts/jetson_auto_proxy](../scripts/jetson_auto_proxy/README.md)。

以下在Jetson构建独立C++工具、运行隔离回归及185秒空闲测试。读取本机编译库，写build与测试临时目录；不切网、不打开串口或控制硬件，无须source ROS。CMake/CTest依赖本机已有libcurl、OpenSSL开发库，未安装系统包。预期构建成功、回归全部通过、空闲测试打印PASS；Ctrl+C可结束，无硬件需恢复。配置文件采用本仓库模板，测试不读Codex凭据、不访问外部网络。

```bash
cd /home/jetson/luhao/my_nav_carcar
cmake -S scripts/jetson_auto_proxy -B build/jetson_auto_proxy -DBUILD_TESTING=ON -DCMAKE_BUILD_TYPE=RelWithDebInfo
cmake --build build/jetson_auto_proxy -j2
ctest --test-dir build/jetson_auto_proxy --output-on-failure
timeout 200s build/jetson_auto_proxy/proxy_test --long-idle
python3 -m py_compile /home/jetson/.local/bin/jetson-auto-proxy.py
```

以下是本轮部署的可复现流程。修改用户服务和终端配置会使现有代理连接断开，可能触发Codex重连；SSH网络、WiFi、ROS和车辆硬件不修改。先做同目录完整备份，不要用固定备份名覆盖已有历史备份；每次再次部署应换新时间标记。20261020-1644的备份已经存在，部署后的日常使用跳过本组。若部署异常，立即执行本节末尾回滚。新装二进制和配置在本轮前不存在，回滚保留为未使用资源。

```bash
cd /home/jetson/luhao/my_nav_carcar
# 备份已在本轮创建；后续部署须替换时间标记，并先检查路径。
cp -an /home/jetson/.config/systemd/user/jetson-auto-proxy.service /home/jetson/.config/systemd/user/jetson-auto-proxy.service.20261020-1644.backup
cp -an /home/jetson/.bashrc /home/jetson/.bashrc.20261020-1644.backup
# 以下覆盖部署目标；仅在备份完整、构建和测试已通过后执行。
install -m 755 build/jetson_auto_proxy/jetson-auto-proxy /home/jetson/.local/bin/jetson-auto-proxy.new
mv /home/jetson/.local/bin/jetson-auto-proxy.new /home/jetson/.local/bin/jetson-auto-proxy
install -m 644 scripts/jetson_auto_proxy/proxy.conf /home/jetson/.config/jetson-auto-proxy.conf
mkdir -p /home/jetson/.local/state/jetson-auto-proxy
install -m 644 scripts/jetson_auto_proxy/jetson-auto-proxy.service /home/jetson/.config/systemd/user/jetson-auto-proxy.service
systemctl --user daemon-reload
systemctl --user restart jetson-auto-proxy.service
```

本轮同时修改既有.bashrc的proxy_on：优先执行C++的--no-proxy，失败保留明确IP后备列表；proxy_status/proxy_auto分别调用新入口--status/--probe。其余初始化保留，bash -n通过后才部署。完整前后差异见桌面维护记录NET-PROXY-003。一般不需要再次手工编辑。

以下是日常只读诊断。读取当前地址、候选缓存、服务和末尾日志；状态应active/enabled，SELECTED为下一新连接的优先候选。DOWN显示curl错误码与HTTP码，age_ms为检查结果年龄。日志仅记录候选状态和失败，不记录业务内容或认证；日志为追加文件，长期运行需按运维需要归档，尚未配置自动轮转。Ctrl+C停止观察，不停服务。

```bash
cd /home/jetson/luhao/my_nav_carcar
ip -4 addr show scope global
ip -4 route
systemctl --user is-active jetson-auto-proxy.service
systemctl --user is-enabled jetson-auto-proxy.service
/home/jetson/.local/bin/jetson-auto-proxy --status
/home/jetson/.local/bin/jetson-auto-proxy --probe
tail -30 /home/jetson/.local/state/jetson-auto-proxy/service.log
```

下面使用新登录shell，测试局域网绕过及API证书链。无效代理端口9用于检验本地网页是否直接到达，预期LAN200；地址是本轮DHCP读数，换网先读取新IP再调整URL。API预期CONNECT200、HTTP401、TLS_verify=0；不加-k，不用API密钥，不发送推理请求。根路径403不是登录通过。Ctrl+C可结束；不会控制硬件。所有上游不可用时503是明确失败，已有业务连接断开后须由应用重连，不能承诺无缝搬迁。

```bash
cd /home/jetson/luhao/my_nav_carcar
bash -n /home/jetson/.bashrc
bash -lc 'curl -x http://127.0.0.1:9 --connect-timeout 2 --max-time 3 -sS -o /dev/null -w "LAN HTTP=%{http_code}\n" http://192.168.180.181:8080/'
bash -lc 'curl --connect-timeout 4 --max-time 12 -sS -I -o /dev/null -w "API CONNECT=%{http_connect} HTTP=%{http_code} TLS_verify=%{ssl_verify_result}\n" https://api.openai.com/v1/models'
codex --version
codex login status
```

换网后新shell自动生成本机小子网列表；已有用户systemd管理器环境不会自动更新。下面刷新两个绕过变量，仅影响随后启动的用户服务，不会终止现有进程，也不改变系统级服务。需要某个已有应用采用新值时，在其任务安全结束后单独重开该应用，不为此重启硬件或当前工作中的Codex。

```bash
cd /home/jetson/luhao/my_nav_carcar
proxy_bypass=$(/home/jetson/.local/bin/jetson-auto-proxy --no-proxy)
systemctl --user set-environment "no_proxy=$proxy_bypass" "NO_PROXY=$proxy_bypass"
unset proxy_bypass
```

以下为本轮完整回滚：覆盖恢复本轮前服务和.bashrc，恢复用户管理器两个变量，再重启旧Python代理。会再次中断代理连接，但不切WiFi或控制硬件。预期服务active、原脚本重新监听17892；新C++文件和配置保留但不使用。若旧上游本身不可用，回退代码也无法恢复外网；不要将其误认为需要重启网络。维护记录和测试证据保留。

```bash
cd /home/jetson/luhao/my_nav_carcar
cp -a /home/jetson/.config/systemd/user/jetson-auto-proxy.service.20261020-1644.backup /home/jetson/.config/systemd/user/jetson-auto-proxy.service
cp -a /home/jetson/.bashrc.20261020-1644.backup /home/jetson/.bashrc
systemctl --user set-environment "no_proxy=$(sed -n 's/^no_proxy=//p' /home/jetson/.config/systemd/user/jetson-auto-proxy.environment.20261020-1644.backup)" "NO_PROXY=$(sed -n 's/^NO_PROXY=//p' /home/jetson/.config/systemd/user/jetson-auto-proxy.environment.20261020-1644.backup)"
systemctl --user daemon-reload
systemctl --user restart jetson-auto-proxy.service
systemctl --user is-active jetson-auto-proxy.service
python3 /home/jetson/.local/bin/jetson-auto-proxy.py --status
```
