tfsvh69-blip/Nav2_car/docs/测试记录.md

# 分层测试命令与结果记录

最后更新时间：2026-10-20
维护方式：按时间追加，历史命令和结果不得删除或改写成成功。完整操作命令以 [操作手册](操作手册.md) 为准。

## 当前结论速览

| 测试 | 结论 | 当前处理 |
|---|---|---|
| REL-001 | 2026-10-20用户要求归档当前上位机/UI版本，反馈当前可正常建图，巡检实机尚未测试；发布前现有建图72、巡检24、相机47项离线报告均通过 | 发布基线采用V2.5及用户指定描述；弱特征形变专项仍保留NAV-017-R16待验边界，后续算法先测试、逐项加入 |
| NAV-017-R16 | 昨晚约22:30工程只读审计：637帧，实际序列化使用范围3m；独立6m新建候选仅改激光范围。目标包构建、72项C++回归、Launch参数解析与静态检查通过 | 离线验证；未切换日常8080或启动硬件。地图角度改善、转角真值、质量告警/锁停/冻结尚待；见[手册33.20](操作手册.md#weak-feature-mapping)及[审计证据](archive/2026-10-20-弱特征建图审计/README.md) |
| NET-002 | R1：C++入口已部署，18项隔离回归与185秒空闲通过；真实Codex请求返回PROXY_OK，API401及GitHub200/TLS通过 | 保留旧Python/配置与回滚；背景TLS检查、冷却切换、动态小子网绕过已启用。物理锁屏、跨网和整机重启仍待；见[手册37.1](操作手册.md#jetson-auto-proxy-hardening) |
| APP-UI-20261020 | 两套现行网页的“巡见”修正为“巡检”，覆盖标题、品牌、无障碍标签及建图页脚；巡检前端5项测试与生产构建通过 | 历史归档保留原文；不修改控制逻辑，实机触屏及停车结论不变 |
| NET-001 | 180秒试验历史与R5准备结果保留；后续NET-002-R1只读确认已接chenjiajun，当前192.168.180.181/24、网关192.168.180.3 | 后续联网事实见NET-002，不反推180秒试验及回原网已验收；物理锁屏、断上游、客户端互访及回原网SSH专项仍待。[33.19](操作手册.md#tablet-wifi-mvp) |
| APP-UI-20261019 | 2026-10-19随行建图与巡检工作台统一浅色苹果风格；14组离线布局无横向溢出或脚本异常；巡检网页5项、ROS2核心17项及控制台6项通过，另1项浏览器集成测试跳过；建图DOM/RTC回归通过 | 新前端已构建安装，8080和本机8081网页资源均与源码一致；未发送运动或重启硬件，真实平板与停车距离仍待。证据见[UI验收归档](archive/2026-10-19-上位机UI改版验收/README.md) |
| NAV-017-R15 | 2026-10-19按主流看门狗改遥控：按住每50ms重复当前方向，车上从最后收到起保持1秒，到点只归零不撤使能。挑战不再续租。序号仍拒绝松手前的旧方向 | 25项安全单测和网页回归通过。已重载网关，进程60334，8080为STANDBY，页面为20261019-r15。需从网页重新启动硬件后再推杆。停车距离仍待 |
| NAV-017-R14-OBS | 2026-10-19只读：8080为STANDBY且无控制连接，页面为20261019-r13，运动截止仍为0.30秒。车到192.168.5.1的20次ping收到19次，往返0.875～8.804ms；省电仍为on，未改。192.168.5.17有两次约200ms往返和10%丢包，TTL为128，不能当成建图平板 | 没有新的推杆，TCP积压和网页处理无法同窗分开。未启动底盘、雷达、相机或导航。持续推杆、停车距离、建图场地、深度对照和NAV-012实车复测仍待。证据`log/nav017_r14_obs_20261019.txt` |
| APP-001-R5 | 2026-10-19平板入口收到 8080。页首可进建图或巡检；/inspect 转到本机 8081。上游不在时返回「巡检页面未启动」。建图进行中巡检拒绝开车，巡检进行中建图拒绝使能 | 转发测试通过，8080 待命页已能打开巡检页面。没有实车同时发速度的验收 |
| APP-001-R4 | 2026-10-19点位页改为20米×10米规划草图。观测点数量自选，1到20个，4个只是建议；可再加、去掉、清空、改名。草图不预置点，也不能启动自动巡检 | 网页5项单测与生产构建通过。隔离域227的规划草图用例通过：打开后点数为0，自建点可改名、删除，启动巡检被拒绝。本机无头浏览器未能启动，页面点击未在浏览器里复验。实车确认仍待。手册35.3.3 |
| NAV-017-R13 | 2026-10-19按既有日志把推杆断联归到约300ms控制间隔，而不是数秒页面卡顿。同一条未过期挑战允许50ms补发，过期状态不改签发时间。离线网页与HTTP回归见末尾 | 300ms运动截止未放宽。没有新的平板推杆采样，持续遥控和停车距离仍待现场确认 |
| APP-001-R3 | 2026-10-19每个拍摄目标最多3个停车位，导航失败换下一位，全部失败记未拍并继续；照片落盘后按配置POST，校验一致才算上传成功 | 离线单测通过范围见末尾。实车导航、舵机和云端地址仍待，默认不上传 |
| NAV-017-R12-REC1 | 2026-10-16约20:33按用户要求重启：旧会话FAULT且网页输入过期约28分钟；先备份SLAM图／数据和107×69栅格，再重启网关及底盘／雷达／SLAM／门控，恢复CURRENT/RUNNING | 20:34:26～36复核数据持续新鲜、未使能／零命令、视频关闭；两串口各一个新所有者、旧节点退出。旧会话备份保留，当前按原new模式重新建图，并未自动续建旧备份；卡住根因和移动稳定性待验，恢复手册33.11 |
| NAV-017-R12-OBS4 | 2026-10-16晚间重新核对：18:03:07连接、18:03:13使能，视频关闭；当天新增08:26:36撤权原因为网页disconnect请求，未见新的操纵授权超时 | 当前连接运动请求计数仍0、RTC received=0；上午与晚间日志不能替代实际推杆验收。恢复前台时集中上报的长脚本间隔不当作晚间持续卡顿；本轮仅只读，见末尾OBS4 |
| NAV-017-R12-OBS3 | 2026-10-16 08:03:37～08:08日志与只读观察：视频关闭，WebRTC连接、已使能；3次状态查询超时、2次控制间隔336／346ms，无新的操纵授权超时／撤权／断连；约28秒15次静止采样保持CURRENT/RUNNING及零命令 | 静止连接较平稳，当前连接运动请求计数仍0，尚不能验收拖动遥控改善；历史18:54:25超时属于10月15日，不能当作今天故障。未发控制命令或修改代码／超时，现场对照沿用手册33.5 |
| NAV-017-R12-OBS2 | 2026-10-15 19:24只读核对：8080辅助视频已关闭、相机进程不存在、视频HTTP503；CURRENT/RUNNING，雷达／里程计新鲜，客户端未连接且未使能／零命令 | 用户要求无视频对照；无需再关闭或重启底盘。本轮没有控制写入／代码或超时修改，尚无本次推杆对照。历史18:54:25操纵授权超时保留，不能据当前无视频反推故障发生时视频状态；操作手册33.5 |
| APP-001-R2 | 2026-10-15补充明确的地图选点、记录当前位置及独立最终停车位入口；网页构建、3项单测及扩展真实浏览器流程通过 | 8081静态资源已更新，进程和硬件开关保持原状态；草稿选点／保存／刷新读回、手机最终停车位及原调角确认流程离线通过，实车位置和角度仍待验。操作手册35.3.1 |
| APP-001-R1 | 2026-10-15首版网页巡检代码：20项巡检C++（含真实浏览器）、57项底盘、3项网页单测及36项旧网关／门控回归离线通过；独立包构建、Python静态检查通过 | 8081在域229仅配置预览，未由本轮启动实机或下发执行器命令。分步目标／新画面／人工确认、断网页自动执行和最终停车已软件验证；真实舵机／回位／深度导航待验，云端上传及文件索引中断修复待完善，详见末尾 |
| CAM-005 | 2026-10-15：D435驱动/筛选组件化、1 cm PCL VoxelGrid候选构建通过；相机包报告62项0失败；隔离短窗点数减少98.08%，实际IPC接收118帧、DDS接收0；Nsight确认CUDA深度投影内核执行 | 短窗通过不等于小障碍/误标/移动验收；CPU VoxelGrid额外开销保留，不宣称整车CPU已降。旧入口与无体素默认保留，操作手册36节，详细证据见末尾CAM-005 |
| NAV-017-R12-OBS1 | 2026-10-15 14:05只读复核：CURRENT/RUNNING、WebRTC在线、服务PID43792且重启0次；当前已使能、软件命令零，覆盖R12交付时未使能的瞬时读数 | R12网页回归通过、HTTP文件与源码SHA256一致，但事件中仍未见client_ui_r12；14:04:31收到315ms控制间隔，14:05:08收到HTTP超时，通信稳定性未通过，详见末尾 |
| MAINT-001 | 2026-10-14批准后：历史资料归archive，手册/测试记录收敛，AGENTS精简，77个小缓存清除；6包资源构建、102项功能测试及8项hardware lint通过 | 原始命令/结果与源码/资源保留。额外flake8的9条E501与执行前一致；Cppcheck工具限制保留。重复bag逻辑缺验证输入仅建议；无系统/硬件变更，见执行结果 |
| NAV-017-R12 | 2026-10-15本轮没有window_blur，13:53:17/13:55:07却在pressed=false时因control_stale撤销使能；复现HTTP异常分支遗漏并改为仅未释放按压且控制过期时停车 | 11项工具组、3项真实HTTP/WS协议及真实Chromium0/80ms通过；网页已提供新版，未重启硬件，实际客户端尚未报告ui_r12。当前未使能/零命令、连接在线，通信停顿仍待解决 |
| NAV-017-R11 | 2026-10-15复现健康UDP被WebSocket2秒空闲回收连带关闭；连接回收10秒、运动300ms截止保持。63项C++、48项底盘、关闭RTC的8项HTTP和最终真实Chromium0/80ms通过，已部署STANDBY | 新增首个关闭错误及WS接收/ping/pong诊断，已恢复停车显示为历史。部署后约123秒尚无网页连接，不能算现场通信通过；旧版连接代次21→33，唯一根因未确认。详见末尾R11/手册33.16 |
| NAV-017-R10-OBS2 | 2026-10-15再次只读核对：12:27:42新增346ms控制间隔，12:28:19页面计时回调间隔3385ms；12:27:59网页operation先停车，12:28:20已重新使能；无心跳/运动授权超时或服务退出 | 不能据OBS1短窗健康宣布通信抖动已消失。随后12:28:59～12:29:30约30.90秒16次采样均CURRENT/RUNNING、WebRTC连接且零命令、无新事件；记录与边界见末尾OBS2 |
| NAV-017-R10-OBS1 | 2026-10-15新版真实任务只读观察：11:32:53～11:33:55共31次采样，全部CURRENT/RUNNING、WebRTC连接、松手且命令零；无新锁停/断连/重连/错误，服务重启0次 | 当前静止就绪稳定；已接受一次约1.30秒按压/松手的22条运动请求，但不等于实物运动/停车验收。用户不在实物旁，代理无控制写入。两条启动期雷达队列满提示未继续出现，详情见末尾OBS1 |
| NAV-017-R10 | 2026-10-15静止就绪不续操纵心跳、仅推杆失焦停车；首次按压等新挑战；运动签发后300ms截止保持。62项完整C++、48项底盘和真实Chromium0/80ms通过，已重载STANDBY | 100ms单程叠加调度仍发生运动截止停车，持续操控未通过；保留失败，不放宽运动期限。R10现场持续推杆/实际停车待验。完整验证/部署见末尾R10，手册33.15 |
| NAV-017-R9 | 2026-10-15 WebRTC控制通道已部署；61项C++、48项底盘、关闭RTC的8项HTTP、真实Chromium0/80ms单程通过，旧工程完整 | 现场确认WebRTC已连接；首次使能仍有一次前台心跳超时，其后约23.52秒有有效推杆/松手，随后静止window_blur撤销。用户仍报告故障；改进进入R10。真实Chromium100ms稳定操控未通过，原始失败保留 |
| NAV-017-R8 | 2026-10-15数据流修订已部署，57项C++、48项底盘测试通过；网页随后启动实任务，仍有两次前台心跳撤销，后续未使能62.68秒新增一次350ms控制间隔，现场通信未通过 | 300ms签发截止保持；应用排队/写入不足1ms时仍见TCP积压与重传，不能宣布已解决或确定唯一网络原因。工程已保存校验；真实Chromium导航未通过。完整流程手册33.13，证据见末尾R8 |
| NAV-017-R7-PS1 | 已按用户要求直接执行省电off→on临时对照；有效off窗口60.057秒内仍有7次307～345ms控制间隔，恢复on后66.310秒内10次303～350ms及4次断开/重连。两段车端健康、未使能、命令零 | 关闭车端省电未消除故障，未采纳永久调整；最终on、原连接文件与同目录完整备份一致，维护记录已追加、临时容器已清理。首轮采样错位和原始结果保留，手册33.12 |
| NAV-017-R7 | 平板确认前台且未锁屏/切网/手动重连；21:16:17～21:17:19静止采样新增11次313～344ms控制间隔及一次断开/重连。车端数据/20ms门控正常，本机HTTP0.70～1.64ms；平板ping平均1049ms、最大4133ms，后续路由器对照平均9.15ms/最大185ms | 此阶段为只读基线，通信连续性未通过；后续临时省电对照已执行，见R7-PS1，原始只读结果保留 |
| NAV-017-R6 | 恢复300ms签发截止，52项C++、48项底盘测试通过。21:05经用户授权与现场安全确认后重载新版网关、单次启动成功；60次静止采样跨62.57秒均RUNNING/CURRENT、未使能、速度命令零，雷达约10.46Hz，三个原工程逐文件一致 | 此恢复窗尚未接平板，不能据此验收通信；后续连接结果见R7/PS1。此前322～346ms控制间隔、约413ms TCP往返及雷达未转/45秒启动超时证据保留；手册33节，详情见末尾R6恢复追加 |
| NAV-017-R5 | 2026-10-14新现场日志确认19:50:05/12/18三次操纵授权超时，网页控制消息停顿305/306/316ms，传感器健康。发现并修复后台子进程继承控制socket导致连接残留；51项C++、48项底盘测试通过，用户保存结束后已重载STANDBY | 只修复了连接回收；通信抖动尚未解决，不宣称摇杆稳定或长范围建图通过。工程20261014_200505_1933aa00已校验备份，原日志/网络快照保留；手册33节 |
| NAV-017-R4 | 2026-10-14复查再次复现每方向100ms延迟下使能确认阶段心跳超时，修正为确认途中也回应新挑战、新令牌不受旧消息节流；另修同会话重试误重置、网页重连旧状态、启动瞬间空状态/诊断异常。50项完整C++及48项底盘测试通过，已更新STANDBY | 300ms窗口未增加；真实浏览器触屏自动化受本机运行环境阻挡，平板持续操作与物理停车仍待确认。后续雷达断流未归因，完整证据见末尾 |
| NAV-017-R3 | 2026-10-14现场仍无法稳定使能/推杆：日志确认运动授权超时及前台心跳超时；现场时序重放、真实网页到真实门控的双向延迟注入均先复现失败，统一300ms签发窗口及立即回应后48项完整C++与48项底盘测试通过；入口已重载STANDBY | 平板复测、实际停车距离待验。之后雷达停止更新/FAULT单列待查，不写成全部现场故障已解决；现场日志/地图快照保留，手册33节 |
| NAV-017-R2 | 2026-10-14：用户反馈基本操控可用，但摇杆约1～2秒后须重新使能；离线稳定复现并修复HTTP状态延迟导致1秒误锁停。新增车端/触屏/通信事件与诊断导出、平板布局及0.18m/s快速档；44项C++、48项底盘测试通过，常驻入口已重载待命 | 现场唯一起因尚未证明；新版持续摇杆、快速档实速/停车距离及20～30分钟路线待复测。原工程校验备份，原始锁停/FAULT证据保留；完整步骤手册33节 |
| NAV-017-R1 | 初版2026-10-14：40项完整C++回归通过（含共享串口检查）；48项底盘pytest通过；真实SLAM合成数据验证常驻任务新建/保存/重启/异地续建/保存结束、车位/激光叠加和原工程保持；现有定位入口实际加载新图；用户服务enabled/active，网页STANDBY | 初版离线结论；后续真实操控反馈与修订见R2。锁屏/断网、供电/方向/物理停车、20～30分钟场地建图和真实续建、重启自启待验。历史RGB可见确认保留，视频为可选辅助；手册33节 |
| NAV-016-R3 | 2026-10-12后台复测：雷达开启后扫描/定位恢复，D435接入真实双STVL地图；按用户要求1.8倍速度候选及两项联锁已读回，navigation构建通过 | 轮动力仍接通，S1实际重发94；相机单独60秒健康PASS，完整链路/静止窗口仍有POINTCLOUD_TIMEOUT；一次目标失败、一次取消，未判移动通过。原0.10低速及所有失败保留 |
| APP-001 | 2026-10-10 设计及归档离线通过：两包构建成功，保留的4个GTest用例通过，归档源码与基线逐字节一致，文档本地文件链接无缺失 | 只做设计与目录整理，未实现巡检框架，未运行硬件；巡检与新报警仍待实现／实测，原始失败与录包保留 |
| NAV-016-R2 | 94档候选与Frame Rate100：普通盒保持60秒未掉标；撤障3D2.542/2D及膨胀2.742秒、后续空地120秒无残留；新连续600秒源/图层健康PASS | 首次空地出现4个假体素及最多4个二维致命格，**空地可靠性未通过，整轮未全通过**。21:01重启中断原包、副本和旧3.8秒诊断缺口保留，新窗独立补证；最后历史舵机下发94，本轮无执行器命令。操作31.16；低高度去噪、完整外参/重复性、2 cm/边缘/遮挡及完整Nav2仍待 |
| NAV-016-R1 | 实测前重复验证发现导航后台线程退出竞争，已修复；142个基础C++用例及两批各200轮生命周期压力检查离线通过，静态入口参数/诊断/退出正常 | 相机与跨机RViz未实测；旧ruicom服务本轮已恢复运行，先按手册30.17隔离，再按31.2～31.3静止验收 |
| NAV-016 | STVL 2.3.4、双地图诊断、感知失联速度联锁与行为树等待已实现；两包构建、142个C++用例离线通过（0失败） | 静止、近距2 cm、多订阅者和低速移动均待实机验收，入口见手册31节 |
| CAM-003-R1 | 2026-10-05 相机争用已排除，但原无头600秒仍95条超时。可靠/Best Effort同段192/170帧对照定位大点云传输缺失；恢复完整点云只将Fast DDS共享内存512 KiB改为本轮16 MiB后，600.016秒3601帧/6.002 Hz、3000条诊断0异常、最大间隔0.170秒，健康窗口通过 | 抽样2候选仍失败，未采用；正式驱动和系统配置未改，16 MiB须显式加载。旧比赛服务暂时停止但仍开机启用。相机39项离线测试0失败；健康窗口下远距地面已补录，2 cm正方体实物首轮见NAV-015-P2D-R1，手册30.17节 |
| TF-006-R5 | 2026-10-05 在16 MiB SHM健康窗口下重新记录30帧：近距0.5～1 m均值−0.213 mm/单点σ0.807 mm；2～3 m均值−13.11 mm/σ20.67 mm，仍稀疏。整段采样166条覆盖诊断全NONE，另45秒270帧/225诊断0异常 | 远段偏差仍存在，不能归为超时；近面斜率约−0.0000515，整段拟合约−0.00494且被近距密集点主导，暂不改外参/校准。近源光心斜距放到1.10 m会有16个地面点超过15 mm，不能直接覆盖1.2 m低物体；继续0.85 m近源空场与2 cm正方体试验，手册30.17节 |
| TF-006-R4 | 2026-10-05 用户确认保持姿态但未机械锁定、3 m空场、最低必避障碍2 cm、光心离地粗量约163 mm。两组各30帧：0.5～1 m地面均值约−0.3 mm/σ0.8 mm；2～3 m均值−20.4/−21.4 mm，均有4帧无点。完整复测健康214/218，4条POINTCLOUD_TIMEOUT、最高raw_age约1.168 s | 远距几何和本轮健康均未通过；3 cm默认标障下限及单层体素门槛不满足2 cm目标。已准备未启用的1 cm/0.85 m/mark_threshold=0近距静止候选，清障仍2 m。两包构建、相机38项测试报告0失败；真实2 cm物体未测，不动底盘/舵机，不转正，手册30.16节 |
| TF-006-R3 | 2026-10-05 用户确认落地、静止及动力隔离，当前中央无假障碍，远处1.7～2.0 m有真实物体。零俯仰参考下六帧斜率约-0.1127；独立候选pitch=-6.429763°、Z临时补偿+7.030 mm，近处地面残差显著减小。37.46 s取证包187条诊断全为HEALTHY/NONE，60帧地图近处中央无致命格 | 1.5～2 m中央地面点稀少且出现异常帧，不能验收整个2 m范围或全外参；实际舵机角度、真实低障碍及历史残留修复均未确认。正式配置未改，流程见手册30.15节 |
| NAV-015-P2C-R15 | 2026-10-05 定位“大片残留体素没有清除”根因：新增 `depth_clearing_coverage` 做射线级 DDA 覆盖审计，并读取 Nav2 1.1.20 真实源码。最后帧 3803 个黄格中 **2483 个（65%）从未被任何清障射线穿过**，1320 个被穿过却仍标黄；2320 个残留体素里 **1337 个（58%）在整个 22 s 包里没有任何标障输入点** | 源码确认 `markVoxelInMap` 无条件置位、`ClearVoxelInMap` 无条件清位，**VoxelLayer 没有任何体积过期机制**，且 `ObstacleLayer` 同样累积（换插件无效）。反事实证明把清障端点距离从 2 m 放宽到 4 m 让覆盖体素增加 2.5×，残留却只从 1469 降到 1463，**放宽距离无用**。已实现“标障点云时间确认”（默认关闭），单测 + 全包 292 例 0 失败。实机 A/B 于 12:40 做过一轮，开启后永久残留 1736→449（−74%）、丢失的致命格 72.9% 为孤立格——**但用户已确认该轮车辆是架在空中的，几何前提不成立，该结论作废，必须在落地状态下重做**。修订说明见末尾R15 |
| NAV-015-P2C-R14 | 2026-10-01 重跑第30.2/30.6节完整链路并录 32 s 取证包：健康诊断 142/142 `NONE`。离线审计 444 万标障点后确认**当前场景完全未复现“空地黄点”**：`|y|≤0.30 m` 空地内只有 266 点（0.006%），任何持续标记体素的最小 `|y|` 为 0.23 m，且只在 141 帧中的 2 帧出现；全部闪烁都发生在真实物体轮廓上（二维致命格闪烁格最小 `|y|`=0.29 m） | **PCL 半径滤波、官方时域滤波、提高 mark_threshold 三条路线均已用数据否决**（删除率最高 0.118%、闪烁比例 51.6%→50.6%、22.9%→49.8% 反而变差）。地面外参健康（rms 0.7~0.8 mm），UVC `-32` 在录包窗口内为 0 条、只在相机启动时出现，不是稳态数据损坏。**原“空地黄点”现象在本次场景中不存在，需要在用户确认的同一现场重录才能继续定位**。详细证据见末尾R14 |
| NAV-015-P2C-R13 | 2026-10-01 用户确认大垃圾桶与车之间的少数黄体素在空地上约每秒闪现/消失；16:25～16:34测试链路启动并正常按Ctrl+C停止。不开RViz的健康诊断142/142 `HEALTHY`，但没有覆盖16:33～16:34截图时刻 | Jetson内核在16:33:19报告D435 UVC控制查询`-32`，无法仅据此证明噪点因果；当时没有逐帧蓝点/二维格数据。PCL ROR影子节点已离线构建及测试，未接管Costmap，候选有效性待实机对照。详细证据见末尾R13。**R14 已判定该 ROR 路线无效** |
| NAV-015-P2C-R12 | 2026-10-01 重启后静止实时查看：B active，参数 4.0/-0.30/2.0/2.0；bao 深度灰度图、蓝点、黄体素已显示。32 s 只读统计 158 条诊断中 19 条 `POINTCLOUD_STAMP_EXPIRED`、2 条 `POINTCLOUD_TIMEOUT` | 本轮健康不通过；所选右前 ROI 没有复现原截图散点，不能宣称残留修复。二维话题到达且画面有色块，但硬件 OpenGL 4.6 仍报 OccupancyGrid 着色器错误。详情见末尾 R12；本轮节点均已停止，串口空闲 |
| RVIZ-001 | 2026-09-30 新电脑 `hao@bao`：双向密钥 SSH、Fast DDS 域 31 跨机文字话题、RViz 本地 X11/OpenGL 4.6 短时启动均实测通过 | 只证明新电脑查看环境可用；D435、真实 `/costmap/costmap`、家具标记和栅格着色尚未在本轮实测，按手册第 19.11 节继续 |
| NAV-015-P2C-R11 | 左侧低盒干净复测：232.95 s/194.1 MiB；在场 93/93 张二维地图均无空闲格，移走后 1.34 s 全空；健康 1166/1166 true、诊断 1165/1165 `NONE` | 左右家具观察带基线中持久非零格分别有 908/912、542/543 在场时保留，移走后 911/912、542/543 保留。二维导航代价满足 5 s 门槛；3D目标体素到 7.14 s 才归零，单独跟踪。左侧目前有 1 次健康有效现场样本 |
| NAV-015-P2C-R10 | 右侧低盒：64.0 s/53.2 MiB；在场 68/68 张地图全区无空闲格，移走后 1.14 s 全空；健康 321/321 true、诊断 321/321 `NONE`；体素约 0.54 s 归零 | 右侧目标基线来自此前独立空场包 R9，之间有停录/重启间隔；左右家具基线格基本保留。右侧有效轮次目前 1/3，未改正式配置 |
| NAV-015-P2C-R9 | 右侧低盒空场基线：233.62 s/194.5 MiB；目标区 388/388 张地图全空，健康 1170/1170 true、诊断 1169/1169 `NONE` | 用户当时尚未放盒；仅作 R10 的分离空场参照，不计低盒有效轮次 |
| NAV-015-P2C-R8 | 左侧低盒首试：目标区在场持续标记，二维约 1.62 s 全空；体素约 7.61 s 才归零 | 健康序列有 1 条 false、诊断有 1 次 `POINTCLOUD_TIMEOUT`（`raw_age=0.650 s`），故该试次无效；保留作为故障及 3D残留证据 |
| NAV-015-P2C-R7 | 2026-09-30 中央低盒第 2 轮尝试未放盒：轻量包 210.83 s/175.9 MiB，剔除 1 张旧缓存后有 351 张新图；空场中央区有 5 张图短暂非空，其余全空 | 用户确认本段期间没有放盒，故不能计低盒轮次；保留为中央空场观察，5 张短暂占用的原因未确认。健康逐条审计未做；录包及静止诊断环境已停止 |
| NAV-015-P2C-R6 | 2026-09-30 中央低盒单次静止验证：两段录包合计 272.05 s / 225.8 MiB；健康 1355/1355 true、诊断 1353/1353 `NONE`。实测目标区在场 192/192 张二维地图均有代价，移走后约 0.52 s 首张全空并连续保持 46 帧；体素区移走后约 0.11 s 归零。左右侧观察区基线占用基本保留 | 用户确认实际摆放更接近中线，地图核心 `y=-0.11～-0.01 m` 与中线一致；用户决定中央不再重复。左/右后来各完成 1 次健康有效低盒静止样本，正式三轮重复未完成，用户决定当前先停。本轮不外推为移动避障通过；未录原始大点云；正式配置未改 |
| NAV-015-P2C-R5 | 2026-09-30 中央低盒正式轮次尝试未进入放盒阶段；空场记录 159.03 s/132.8 MiB，265 张有效地图中央目标区全空，健康 789/789 true、诊断 788/788 `NONE` | 用户未确认已放置，正常停止录包；只作为延长空场健康基线，不计低盒轮次。带盒试运行 R4 与本次空场样本均未出现点云超时，仍不足以确定 R3 两次超时的成因 |
| NAV-015-P2C-R4 | 2026-09-30 中央低盒轻量方法试运行：187.26 s/156.3 MiB；健康 930/930 true、诊断 929/929 `NONE`。中央目标区在场 150/150 帧全区有代价，前后共 162 帧全空；两侧宽观察带 312/312 帧都有致命格 | 用户确认盒子放在中线附近，实测负 y 与之吻合；这是坐标选区错误，不是漏标。真实移走时刻未记录，不能核定 2/5 s 门槛，故不计正式轮次。2D 先恢复空场，3D 体素约 18 s 后才连续归零 |
| NAV-015-P2C-R3 | 2026-09-30 轻量录包空场基线：260.14 s/约 215 MiB；用户确认车前一直未放盒。健康 1302 条中 2 条 false，诊断有 2 次 `POINTCLOUD_TIMEOUT`；剔除旧缓存地图后，429 帧左目标区始终无二维占用，1286 帧目标区体素始终为 0；左右侧边观察带 429/429 帧均有致命占用 | 可验证空场与侧边区域基线，但不能验证低盒识别或清障；短暂健康异常需继续定位，正式有效轮次仍为 0 |
| NAV-015-P2C-R2 | 同一静止环境做三段短观察：含标障点云的轻量包 34.1 s/82.4 MiB，健康 false 1/169；不录包约 35 s 未观察到 false；只录地图/体素/健康的最小包 34.2 s/27.9 MiB，健康 false 0/173 | 最小话题集可作为下一轮现场方法验证入口；短样本不能证明长期稳定或录包异常因果。两侧观察带持续有二维占用，但尚未逐一对应实物家具；正式有效轮次仍为 0 |
| NAV-015-P2C-R1 | 2026-09-30 对已有左右低盒 A/B 压缩结果包做独立二维全区域离线补审：A/B 四组在场均有目标区二维占用；移走后目标区及周边 0.20 m 都恢复空场值且持续至结束。A 组末帧 7/4 个三维体素未在这些包里造成持续二维占用 | B 的三维清残留收益成立，但尚无二维导航收益证据；旧 `focus_lethal_columns` 不能证明整区空闲。下一步先验证轻量现场取证和侧边家具保留，再决定是否扩大 B 候选复测，正式导航仍未改 |
| NAV-015-P2C | 2026-09-30 四段原始包隔离 A/B 完成：A=-0.03 m，B 仅改清障端点高度下限为 -0.30 m。中央 A/B 末帧均 0；左 A=7/B=0；右 A=4/B=0；高箱 A/B 均 0（目标区体素）。稳定在场区间内四场景 A/B 均持续有体素和二维致命栅格，数量接近，未见 B 新增连续漏标 | 离线门槛满足，进入手册30.6静止现场复测；高箱 A 本次也清零，不能声称 B 修复高箱。正式外参、正式导航和移动深度避障仍待验 |
| TF-006-R2 / NAV-015-P2B | 用户确认底盘启动后相机平视且车轮未动；默认 TF 下地面斜率约 -0.115，新 -6.546°候选下接近零。0.7 m 低盒用 -3 cm/4 m 清障候选自然清零；高箱二维致命栅格清零但剩 5 个非致命体素 | 只作为静止单点候选；晚期车体移动且遮挡数据无效。多距离、左右、重复清障、隔离域回归和移动避障待做，续测见手册30节 |
| DRV-006-R1 | 用户确认键盘重新发送140.5°后平视；旧底盘未初始化S1。已补启动94档命令与C++关节命令估计 | 2026-09-28 用户确认新底盘短时启动后相机平视停稳且车轮未动；实际角度/到位/保持反馈仍没有，完整步骤见手册29节 |
| NAV-015-P2A | 之前候选姿态低盒有蓝/黄，移走后部分体素残留；实物平视前提后续发现未落实 | 先重新确认姿态和默认外参，再复测清障；此前10→0与10→10离线对照保留，不当作新姿态实机通过 |
| TF-006 | 用户重新发送140.5°后平视，旧地面拟合可能含未初始化姿态影响 | -6.49°候选退出当前复测入口；恢复默认零俯仰并重新查地面、多距离/左右及雷达共同面 |
| NAV-012-R10 | 09-26 会话第一与最后一次倒车由 `DATA_EXPIRED` 转运动恢复；中间倒车有转向不收敛证据，最后弯道另有近障无可行轨迹 | 增加独立输入等待与失效诊断，0.18 m/s 对照及净空候选；90 个 C++ 用例离线通过，**修复后实车待复测** |
| TF-005 / CAM-003 / NAV-015 | D435 点云接入阶段一实机验证通过：修复 `pointcloud__neon_.*` 参数名后原始点云 5.6 Hz、障碍物点云 5.7 Hz、清除点云 6.0 Hz 稳定输出，`depth_cloud_filter` 诊断 HEALTHY，`base_footprint → camera_depth_optical_frame` TF 连通；新舵机相机模型与固定脚方向离线核对完成 | 2026-09-24 阶段一（点云驱动与滤波通路）实机打通；阶段二（Costmap VoxelLayer 与动态深度避障）用户决定先不进行、待后续实测。**实物孔位、30 min 稳定性、六自由度绝对外参及运动避障实机验收未通过** |
| NAV-012-R9 | 终态失败后新目标曾立即 `ABORTED`；已增加新 UUID 重启屏障、新任务有限额度重置、0.30 m/s 实验档和局部路径显示优化 | 导航 82 项、底盘 46 项离线通过；同任务抢占不刷新额度、取消失败锁停保持通过；**重试、速度和制动待实车** |
| NAV-012-R8 / NAV-013 | 自适应短倒车、双向转向选择、3 Hz 地图与路径检查、持续分卷录包、Lattice 与 EKF 独立入口 | 目标包构建及 126 项相关测试通过；录包连续 125.5 s 可跨卷读取；Lattice 合成规划及 Rotation Shim + DWB 起始旋转接口通过；**恢复、完整跟随和 EKF 均待实车** |
| NAV-012-R7 | 10:31 实机会话最终到达，但曾因 DWB 无可行轨迹和 8 s 转向预算耗尽进入倒车；V2.1 固定保留该优化前基线 | 有效路径保持、固定转向窗口、弧线进展、UUID 日志与 rosbag 修复离线通过；90°/10 s 恢复转向上限经复核暂不调整，**优化后实机待复测** |
| NAV-012-R6 | 会话 `20260919_222415_18906`：突发障碍后路径航向翻转、倒车后重贴障碍、只观察旧路径至超时 | 六终端跨机启动与 RViz 车模链路实测打通；导航修复仍待实车复测 |
| NAV-012-R5 | 右转回拧、倒车时钟误中止、垃圾桶振荡；会话 `20260919_211408_7219` | 离线通过，**实机待复测** |
| NAV-012-R4 | 缩短恢复等待（停稳 0.4 s、停滞 3 s、观察 8 s） | 离线通过，**实机待复测** |
| NAV-012-R3 | 障碍前原地转/抽搐；会话 `20260918_221144_11945` | 实验配置已改，**待实机复测，不是已通过** |
| NAV-012-R2 | 分离转向预测、同回合两段倒车、受保护车头退出 | 离线通过，实机待验收 |
| NAV-012 / R1 | 2026-09-16 实机恢复失败保留；R1 离线补回调/停稳/抢占 | 不得写成修复完成或实机通过 |
| DRV-001～003 | 串口、读写、安全停车、早期双轮链路完成 | 只作回归 |
| DRV-004 | 蜂鸣器与 RGB 实机通过；低亮度 30/255，100 ms 短鸣，零速保护 | 正式声光入口 |
| DRV-005 | 用户确认 S1 舵机可正常驱动；历史全行程入口实机模式已停用 | D435 已连接，不能再做 0°～270° 往返 |
| DRV-006 | 用户指定平视默认进行目标 140.5°；每键 ±1°、限定 85°～160° | 板端量化后的平视误差待现场确认 |
| MOTOR-003/004 | 当时四路可动作；历史轮位 M1=左前、M3=右前、M4=左后、M2=右后 | 随后已交换 M2/M4，当前轮位见台账。本章不改写 |
| MOTOR-005 | 与 004 重复，未做实机 | 2026-09-06 取消必测，脚本保留 |
| MOTOR-006 | 前进通过；开环左横移轮向正确但无力 | 历史 PWM/PI 已停用 |
| MOTOR-007 | 原换线假设 | 已被 MOTOR-009 取代，记录保留 |
| MOTOR-008 | 软件映射＋PWM：架空通过，带载不足 | 非正式控制 |
| MOTOR-009/010 | 架空左移/旋转通过；前进 M2/M4 反向失败 | 失败记录保留；不用于当时接线地面控制 |
| MOTOR-011～013 | 高输出架空通过；斜坡 PID 离线；V3.6 补丁静态验证 | 非正式控制；补丁不刷写 |
| MOTOR-014～016 | M2/M4 对调后架空前进通过；A/B 对调后 0.05 m/s 地面稳定；Flash PID `8.0/1.2/0.8` | 待量化跟踪 |
| ENCODER-001～003 | 四路累计与独立反馈可用 | 历史基线 |
| ENCODER-004 | 10 圈：1319.2 / 1317.9 / 1319.2 / 1319.2，符号全 +1 | 标定完成 |
| ODOM-001 | 前进 1 m、360°、静止 30 s 零漂移通过 | `base.yaml` 已启用 |
| IMU-001/002 | 静止与逆时针完成；主轴 Z；符号已校正 `[1,1,-1]` | 日常入口不融合；默认关闭的官方 EKF 对照入口待实车 |
| LIDAR-001 | Humble `/scan` 稳定，0.10～3.00 m | 安装 TF 已回填，方向曾目视对照 |
| TF-001～003 | 模型/照片版/实测尺寸离线通过 | 历史基线保留 |
| TF-004 | 补 `robot_state_publisher`；现场缺模型/固定 TF 已确认 | 离线通过，静止实机复验待做 |
| NAV-001 | 静止建图链路实机通过 | `/scan` 11.0 Hz，Odom 31.7 Hz，TF 贯通 |
| NAV-002 | 实机通过。回访闭合 3.77 cm | 地图成对保存 |
| NAV-003 | 实机部分通过。首个单点到达；180° 折返曾假碰撞/10 s 超时 | 包络与超时已改，掉头待复验 |
| NAV-004 | 实机通过。`nav004_20260914_093032` 259×230 | 重载校验退出码 0 |
| NAV-005 | 待实机。并存无可行轨迹、无进展、扫描时刻 TF 过期超时 | 不归因为单一参数 |
| NAV-006 | Groot 已停用；桥接离线曾通过 | 改由 NAV-011 |
| NAV-007～011 | 均离线通过、待实机 | 实验入口，未写入稳定默认 |
| NAV-014 | 离线通过。操作员灯 5 种，到达/失败各短鸣一次 | 待现场全链路 |

现行路线见[项目现状与路线](项目现状与路线.md)。以下内容是不可删除的历史测试档案，
用于故障复现，不代表还需要逐项重做。

历史详细过程已迁入[原始测试档案](archive/测试原始记录_20261014.md)，编号、失败和经验完整保留；不要求重新执行历史硬件命令。

<details>
<summary>历史测试专题索引</summary>

- [展开全部历史测试命令与原始结果](archive/测试原始记录_20261014.md)
- [RVIZ-001：2026-09-30 新 Ubuntu 电脑跨机查看环境检查](archive/测试原始记录_20261014.md)
- [NAV-015-P2C-R8：2026-09-30 左侧低盒首试，健康异常使轮次无效](archive/测试原始记录_20261014.md)
- [NAV-015-P2C-R9：2026-09-30 右侧低盒独立空场基线](archive/测试原始记录_20261014.md)
- [NAV-015-P2C-R10：2026-09-30 右侧低盒轻量静止验证](archive/测试原始记录_20261014.md)
- [NAV-015-P2C-R11：2026-09-30 左侧低盒轻量复测与三维体素滞后](archive/测试原始记录_20261014.md)
- [NAV-005/NAV-006 修订说明与 NAV-007/NAV-008 摘要（2026-09-14）](archive/测试原始记录_20261014.md)
- [展开 2026-09-06 之后的原始测试明细](archive/测试原始记录_20261014.md)
- [MOTOR-007 续测准备：2026-09-08 离线验证与连接检查](archive/测试原始记录_20261014.md)
- [MOTOR-008：2026-09-08 保留接线的软件轮位映射与编码器闭环](archive/测试原始记录_20261014.md)
- [MOTOR-008 续测：2026-09-08 控制板连接恢复](archive/测试原始记录_20261014.md)
- [MOTOR-008 续测：键盘入口缺少驱动订阅者，2026-09-08](archive/测试原始记录_20261014.md)
- [MOTOR-008 架空轮向与编码器反馈：2026-09-08](archive/测试原始记录_20261014.md)
- [MOTOR-009：板载 PID 当前接线轮位探测，2026-09-08](archive/测试原始记录_20261014.md)
- [MOTOR-010：板载 PID 前进方向与车型字段探测，2026-09-08](archive/测试原始记录_20261014.md)
- [MOTOR-011：高输出逐轮软件编码器闭环架空验收，2026-09-08](archive/测试原始记录_20261014.md)
- [MOTOR-011 续测：地面前进编码器与停车，2026-09-08](archive/测试原始记录_20261014.md)
- [MOTOR-011 续测：地面前进目视结论，2026-09-08](archive/测试原始记录_20261014.md)
- [MOTOR-012：逐轮 PID 斜坡与前馈重构，2026-09-08](archive/测试原始记录_20261014.md)
- [MOTOR-013：板载 V3.6 闭环端口映射补丁，2026-09-08](archive/测试原始记录_20261014.md)
- [MOTOR-014：仅交换 M2/M4 电机插头后的板载前进探测，2026-09-08](archive/测试原始记录_20261014.md)
- [MOTOR-015：四路编码器 A/B 对调后的板载闭环复测，2026-09-08](archive/测试原始记录_20261014.md)
- [MOTOR-016：板载 PID 实机调参与 Flash 写入，2026-09-08](archive/测试原始记录_20261014.md)
- [MOTOR-017：逐轮正向 50% PWM 转向确认测试，2026-09-08](archive/测试原始记录_20261014.md)
- [ODOM-001：四轮累计编码器纯轮式里程计，2026-09-08](archive/测试原始记录_20261014.md)
- [2026-09-08 修订说明：ODOM-001 证据范围与 IMU-001/002 下一步](archive/测试原始记录_20261014.md)
- [2026-09-08 IMU-001/002 阶段一：水平静止 30 秒采样执行准备](archive/测试原始记录_20261014.md)
- [2026-09-08 IMU-001/002 阶段二：水平缓慢逆时针旋转 15 秒采样与轴向符号判定](archive/测试原始记录_20261014.md)
- [2026-09-08 IMU-001/002 驱动封装层轴向符号校正离线验证](archive/测试原始记录_20261014.md)
- [2026-09-08 NAV-001：SLAM Toolbox 建图链路冒烟验证（纯轮式 Odom + RPLIDAR A1 + SLAM Toolbox）](archive/测试原始记录_20261014.md)
- [NAV-002～TF-004 与后续导航测试原始记录](archive/测试原始记录_20261014.md)
- [NAV-012-R1：恢复机制修复、现场结论修订与隔离回归（2026-09-17）](archive/测试原始记录_20261014.md)
- [NAV-012-R2：2026-09-18 接续上轮未完成的导航修复（离线验证）](archive/测试原始记录_20261014.md)
- [NAV-012-R3：2026-09-18 障碍前抽搐与 1.5 倍速（配置已改，待实机）](archive/测试原始记录_20261014.md)
- [NAV-012-R4：2026-09-19 缩短恢复等待（配置已改，待实机）](archive/测试原始记录_20261014.md)
- [NAV-012-R5：2026-09-19 绕障回拧、倒车误中止与垃圾桶振荡（配置已改，待实机）](archive/测试原始记录_20261014.md)
- [NAV-012-R6：2026-09-19 突发障碍后的全局路径稳定与停车观察重规划（离线验证）](archive/测试原始记录_20261014.md)
- [NAV-012-R7：2026-09-20 突发障碍路径保持、转向进展与诊断修订（离线验证）](archive/测试原始记录_20261014.md)
- [NAV-012-R8 / NAV-013：2026-09-21 持续录包、自适应恢复、State Lattice 与 EKF 对照入口（离线验证）](archive/测试原始记录_20261014.md)
- [NAV-012-R9：2026-09-22 终态后新目标重试、0.30 m/s 实验档与局部路径显示（离线验证）](archive/测试原始记录_20261014.md)
- [TF-005 / CAM-003 / NAV-015：2026-09-23 D435 外参标定与深度避障链路（离线实现）](archive/测试原始记录_20261014.md)
- [DRV-005：2026-09-23 S1 PWM 舵机 270° 往返底层测试](archive/测试原始记录_20261014.md)
- [DRV-006：2026-09-23 S1 舵机 135° 中位键盘调角](archive/测试原始记录_20261014.md)
- [TF-005 / CAM-003：2026-09-23 固定舵机目标粗标定准备与相机启动失败](archive/测试原始记录_20261014.md)
- [CAM-003：2026-09-23 20:43 线缆复核后短时复测](archive/测试原始记录_20261014.md)
- [CAM-003：2026-09-23 20:49 再次复插后的 SDK 与 ROS 复测](archive/测试原始记录_20261014.md)
- [CAM-003：2026-09-23 自动恢复机理与无拔插服务复位](archive/测试原始记录_20261014.md)
- [TF-005 / CAM-003：2026-09-23 新舵机相机结构重绘与短时彩色直播观察](archive/测试原始记录_20261014.md)
- [TF-005：2026-09-23 舵机盒体质心补量与模型修订](archive/测试原始记录_20261014.md)
- [TF-005：2026-09-23 Jetson 桌面临时查看车模入口](archive/测试原始记录_20261014.md)
- [TF-005：2026-09-23 RViz 四轮红灯与雷达悬空修订](archive/测试原始记录_20261014.md)
- [TF-005：2026-09-23 D435 横向基准与雷达高度现场补量](archive/测试原始记录_20261014.md)
- [TF-005：2026-09-24 黑色相机活动支架方向修订](archive/测试原始记录_20261014.md)
- [TF-005：2026-09-24 舵机两侧橙色固定脚安装方向修订](archive/测试原始记录_20261014.md)
- [TF-005：2026-09-24 前侧舵机固定脚绕 Z 轴翻转](archive/测试原始记录_20261014.md)
- [CAM-004 / NAV-015-P1：2026-09-24 D435 导航点云与数据通路实机验证（阶段一）](archive/测试原始记录_20261014.md)
- [NAV-012-R10：2026-09-26 原始录包归因、独立输入等待与弯道净空对照](archive/测试原始记录_20261014.md)
- [TF-006：2026-09-27 不用标定板的固定姿态静止 TF 粗校验入口](archive/测试原始记录_20261014.md)
- [TF-006：2026-09-27 首次现场画面与垃圾桶轮廓间隙反馈](archive/测试原始记录_20261014.md)
- [TF-006：2026-09-27 平面目标现场观察与用户认可粗检基线](archive/测试原始记录_20261014.md)
- [TF-006：2026-09-27 用户结束固定姿态接入与目视粗校验阶段](archive/测试原始记录_20261014.md)
- [NAV-015-P2A：2026-09-27 独立静止深度 Costmap 查看入口与离线验证](archive/测试原始记录_20261014.md)
- [TF-006-R1 / NAV-015-P2A：2026-09-27 无黄色、低箱缺失现场诊断与俯仰候选](archive/测试原始记录_20261014.md)
- [NAV-015-P2A-R2：2026-09-27 低盒已标记但移走后黄色残留，清障候选实现与对照](archive/测试原始记录_20261014.md)
- [NAV-015-P2A-R3：2026-09-27 用户要求静止测试层默认开启](archive/测试原始记录_20261014.md)
- [DRV-006-R1：2026-09-27 S1启动平视遗漏修复与动态模型离线验证](archive/测试原始记录_20261014.md)
- [TF-006-R2 / NAV-015-P2B：2026-09-28 平视确认后的低盒、高箱与清障射线现场对照](archive/测试原始记录_20261014.md)
- [NAV-015-P2C：2026-09-30 原生地面裁剪 A/B 隔离回放](archive/测试原始记录_20261014.md)
- [NAV-015-P2C-R1：2026-09-30 左右低盒独立二维地图补审与轻量现场方案](archive/测试原始记录_20261014.md)
- [NAV-015-P2C-R2：2026-09-30 静止空场轻量记录负载对照](archive/测试原始记录_20261014.md)
- [NAV-015-P2C-R3：2026-09-30 轻量录包空场基线](archive/测试原始记录_20261014.md)
- [NAV-015-P2C-R4：2026-09-30 低盒轻量现场位置、健康与二维恢复方法试运行](archive/测试原始记录_20261014.md)
- [NAV-015-P2C-R5：2026-09-30 中央低盒正式轮次尝试未放置物体](archive/测试原始记录_20261014.md)
- [NAV-015-P2C-R6：2026-09-30 低盒轻量静止现场实测，物理左右归类待核对](archive/测试原始记录_20261014.md)
- [NAV-015-P2C-R7：2026-09-30 中央低盒第 2 轮尝试，用户确认未放盒](archive/测试原始记录_20261014.md)
- [NAV-015-P2C-R12：2026-10-01 右前零星体素反馈与重启后实时诊断（健康不通过）](archive/测试原始记录_20261014.md)
- [NAV-015-P2C-R13：2026-10-01 垃圾桶前闪烁黄体素与影子去噪候选](archive/测试原始记录_20261014.md)
- [NAV-015-P2C-R14：2026-10-01 空地黄点复现尝试、滤波路线定量否决与闪烁定位](archive/测试原始记录_20261014.md)
- [NAV-015-P2C-R15：2026-10-05 残留体素根因定位与时间确认修复（实机A/B未完成）](archive/测试原始记录_20261014.md)
- [NAV-015-P2C-R15 续：2026-10-05 时间确认实机 A/B 结果（对照通过，真实障碍保留）](archive/测试原始记录_20261014.md)
- [NAV-015-P2C-R15 修订说明：2026-10-05 A/B 与“低矮区残留”两组结论作废（车辆架高）](archive/测试原始记录_20261014.md)
- [TF-006-R3：2026-10-05 落地后测量当前姿态、独立俯仰/高度候选与中央地图基线](archive/测试原始记录_20261014.md)
- [TF-006-R4：2026-10-05 固定姿态3 m空场分段统计、健康失效与2 cm需求修订](archive/测试原始记录_20261014.md)
- [CAM-003-R1：2026-10-05 相机争用与大点云传输超时专项](archive/测试原始记录_20261014.md)
- [TF-006-R5：2026-10-05 健康窗口恢复后的0.5～3 m地面补录](archive/测试原始记录_20261014.md)
- [NAV-016：2026-10-06 STVL 时间记忆与感知故障停车接入](archive/测试原始记录_20261014.md)
- [NAV-016-R1：2026-10-06 多终端实测前重复验证与导航线程退出竞争修复](archive/测试原始记录_20261014.md)
- [SYS-001：2026-10-07 旧比赛服务长期停用方案（待执行）](archive/测试原始记录_20261014.md)
- [NAV-016-R2：2026-10-07 RGB缺图、安装角与1.5/1秒衰减候选](archive/测试原始记录_20261014.md)
- [NAV-016-R2：2026-10-07 双图实际显示长窗完成、视场差异和深度去噪候选](archive/测试原始记录_20261014.md)
- [NAV-016-R2：2026-10-07 去噪候选交付复核](archive/测试原始记录_20261014.md)
- [NAV-016-R2：2026-10-07 RGB配准参照、显示网格修正及交接状态](archive/测试原始记录_20261014.md)
- [NAV-016-R2：2026-10-08 三图窗口等大修订及静止显示恢复](archive/测试原始记录_20261014.md)
- [NAV-016-R2：2026-10-08 视场认识与导航数据用途文档修订](archive/测试原始记录_20261014.md)
- [NAV-016-R2：2026-10-08 数据链路与舵机角度口径复核](archive/测试原始记录_20261014.md)
- [NAV-016-R2：2026-10-08 原生深度点云显示与静止链路恢复](archive/测试原始记录_20261014.md)
- [NAV-016-R2：2026-10-08 断电后重新测角、逐步下发记录与94档近平视基线](archive/测试原始记录_20261014.md)
- [NAV-016-R2：2026-10-08 94档新TF、100刷新率静止验收与21:01重启中断](archive/测试原始记录_20261014.md)
- [NAV-016-R2：2026-10-08 21:17撤障封存、原生地图与图层诊断审计](archive/测试原始记录_20261014.md)
- [NAV-016-R2：2026-10-08 21:30连续源/图层600秒补证完成及最终静止结论](archive/测试原始记录_20261014.md)
- [NAV-016-R2：2026-10-08 V2.4归档前离线回归与用户现场评价](archive/测试原始记录_20261014.md)
- [APP-001：2026-10-10 巡检设计、停用源码归档及离线复核](archive/测试原始记录_20261014.md)
- [NAV-016-R3：2026-10-12旧地图加D435导航复测准备（离线验证）](archive/测试原始记录_20261014.md)
- [NAV-016-R3：2026-10-12第一阶段地面采样反馈（未完成30帧）](archive/测试原始记录_20261014.md)
- [NAV-016-R3：2026-10-12后台复测、雷达恢复及1.8倍行驶速度候选](archive/测试原始记录_20261014.md)



</details>

<details>
<summary>NAV-017：平板随行建图、独立门控与工程保存／续建（2026-10-13）</summary>

### 目的、前提与范围

同楼层随行人工建图；浏览器查看二维地图/激光/估计车位及RGB，支持两档、保存与人工给定任意旧图位置/朝向续建。所有车端新增逻辑C++，Launch XML；仅网页端JavaScript例外已获用户明确同意。底层、旧导航与历史失败资产保留。

硬件实测前须先验证热点恢复通道，再静止数据与动力隔离检查；底盘启动会S1发94，支架扫掠及轮动力隔离须现场确认。独占串口只能有一个驱动；预检失败拒绝启动，不杀未知进程。完整构建、启动、观察、停止、回滚命令统一链接[手册33节](操作手册.md#33-平板随行建图nav-017)，本记录不重复命令。

### 实现与预期

- 新包`src/carcar_mapping_console`：独立HTTP/WebSocket网页网关、单调时钟运动门控、预检准备工具与NetworkManager热点维护工具。
- 专用速度`/mapping/cmd_vel`、受控SLAM扫描`/mapping/slam_scan`；松手、换档、后台、断联、授权过期、源视频/浏览器画面过期与保存锁停，重新连接不自动行驶。
- 复用Nav2 map_io与SLAM 2.6.10服务；原工程只读，恢复前仅历史栅格预览，单帧试匹配后人工确认；空响应不认作成功。
- 保存停车、冻结扫描并等待地图刷新，栅格/工程四文件及运行参数读回齐备才标记完整；SHA256核对、部分失败禁止续建、每次独立目录。
- 新相机XML/YAML只启RGB，640×480/6 Hz采集及压缩预览为试验目标；深度/STVL关闭，不替代正式深度导航。
- 热点工具创建前同目录隐藏`.backup`完整归档并写桌面维护记录；原连接保留，180秒D-Bus checkpoint仅首次试点，日常禁止带入待回滚点。实现本轮不实际调用配置变更路径。

### 离线验证与原始失败保留

首轮`carcar_camera`构建成功，新包主要可执行程序编译成功；C++集成测试编译失败，原因是Humble服务回调类型推导不接受泛型lambda。已改为明确Request/Response类型，不删除首轮日志。后续构建和测试结果在本节末尾追加；不得把该失败改成首轮成功。

已完成的独立回归：既有底盘pytest 48项通过，Python静态编译通过；已有相机`test_image_reference`通过；网页JavaScript语法检查、两份新增XML格式检查通过。这些均为离线验证，不说明真实相机帧率、移动或停车通过。

首次CTest运行：安全逻辑通过，4项进程集成测试失败，日志`log/mapping_ctest_first.log`保留。实际原因是测试启动参数传了空`bundle_id:=`，Humble CLI拒绝解析，网页进程没有启动；不是硬件或网络掉线。修订为CLI不传空覆盖值，XML明确字符串类型。后续重新构建并包含追加的部分失败/空响应用例，不把本次4项失败改写成通过。

第二次CTest：安全逻辑与3项HTTP传输测试通过，6项进程集成中真实SLAM保存/恢复、普通保存和部分失败通过，其余3项失败，原始日志`log/mapping_ctest_verified.log`保留。失败来自测试把异步状态旧快照当成刚提交操作的完成状态，或在最终零速后立即要求网页快照已经更新。修订为等待明确完成结果/状态传播；接口同时增加操作编号与完成编号，网页不把旧保存结果当作本次成功。

新增C++测试使用域219/localhost及替身底盘；网络仅访问127.0.0.1。包含真实WebSocket动作/超时、视频断流、保存锁停与部分失败、空恢复响应、单帧门控、错误初值边界及原工程保持。另使用本机真实SLAM Toolbox 2.6.10配合合成室内激光/静止里程计验证实际序列化与反序列化接口；合成数据不是实机场地。

### 最终交付离线结果（2026-10-13，10-14收尾复核）

- `carcar_base`、`carcar_camera`、`carcar_mapping_console`构建通过。新增C++测试28项：安全/坐标/工程逻辑16项、进程集成8项、HTTP传输4项，全部通过；末轮CTest总耗时47.44秒，原始日志`log/mapping_ctest_reconnect.log`。前一轮27项通过日志`log/mapping_ctest_roundtrip.log`保留。既有底盘48项pytest、Python静态编译、相机图像压缩测试、JS语法与XML检查通过。依赖清单使用本机可解析的rosdep键，不安装新系统包。
- 集成验证实际WebSocket操纵授权超时、源视频与浏览器帧过期、保存事务/部分失败、空恢复响应、网关SIGSTOP时独立停车、保存期间NaN位姿锁停，以及慢地图读者不阻塞控制、第二操作者拒绝和跨源写拒绝。
- 新增静默半开连接用例：旧操作者不再响应ping/pong时，2秒存活检测释放连接，随后新连接可获取控制权；健康浏览器通过原生pong维持空闲连接。此检测不延长0.20秒运动授权。失败试点取消入口编译通过，日志`log/mapping_build_hotspot_cleanup.log`；没有运行系统配置修改路径。10-14再次复核JS、XML和差异格式通过。
- **真实SLAM合成数据验证**：保存初始矩形室内工程后，把合成车位改为旧图`(0.40,0.25)m`、朝向90°，轮式odom原点重置为零；给初值后仅放行一帧，候选位置/朝向在测试容差内，人工确认接口后继续输入0.25m新里程计位移并收到新的SLAM接受位姿，再次保存形成两个完整工程；原工程哈希保持。只是接口、坐标转换与连续处理离线通过，不登记实车位移、匹配精度或新场地扩图通过。
- 实际XML以`start_hardware=false`、域218、端口18090启动，仅有SLAM/门控/网关三进程；HTTP状态`WAITING`、速度零，SIGINT后三进程正常退出。没有串口、相机、雷达或电机动作。
- 本机浏览器截图未通过环境启动：Snap缺少所需capability，直接运行其二进制又缺`GLIBC_2.38`。日志`log/mapping_browser_check.log`、`log/mapping_browser_native.log`保留；没有修改Snap、glibc或系统图形配置，也没有获得网页截图。平板真实浏览器的触控、视觉效果和流畅性继续待验。
- WiFi保持原“小泽”/192.168.5.11，未创建热点、未操作checkpoint、未改系统配置。热点维护工具编译完成，只执行只读status和接口元数据检查，实际配置路径、密码输入、回滚及平板连接必须按手册现场验证。

### 已知边界与下一步

热点/AP只读能力声明尚未实测。平板触摸、无互联网提示、锁屏、遮挡距离；两档带载起步、实物方向、软件与物理停车时间/距离；实际RGB 5～6 FPS与视频冻结；走廊—房间—大厅回环、不同旧图位置/朝向续建及保存后独立重载，均待按手册逐级现场反馈。软件0.20秒授权/20ms循环不等同硬实时停车，控制板独立失联保护仍待验。

### 2026-10-14 审查修订与回归

审查发现并保留原始结论：`mapping_prepare --mode new`拼接空`bundle_id:=`，Humble拒绝启动；网页断线重试定时器与回前台连接竞争，可能让被拒的重复连接清空当前会话；删除热点时原备份早于热点创建，不含待删除配置及密码。此前直接XML软件启动和28项测试没有覆盖这三种路径，不能据此前结果宣称这些路径通过。

修订：新建入口只在非空时传工程ID；网页统一取消/调度重连、后台清空会话并关闭socket、仅当前socket可更新状态；热点删除前备份实际落盘文件，唯一同目录`.backup`、0600、完整写入及同步成功，保存备份路径和维护记录后才删除，打印脱敏恢复命令。失败不删除。代码入口`src/carcar_mapping_console/src/prepare.cpp`、`web/app.js`、`src/hotspot.cpp`，备份实现`include/carcar_mapping_console/profile_backup.hpp`。完整操作与恢复命令只维护手册33节。

离线结果：目标包构建通过，日志`log/mapping_review_fixes_build.log`（GCC已有ABI提示保留）；新增`test/test_tools.cpp`四项验证准备入口实际exec参数与路径空格、浏览器重连/迟到回调、备份字节/0600/不覆盖旧备份、缺失/符号链接/目录拒绝；备份全部在临时目录，`ros2`用只记录argv的C++替身，网页用Node事件模拟。累计32项C++测试通过，CTest49.10秒，日志`log/mapping_review_fixes_ctest.log`；JS语法、XML、差异格式检查通过。未重复运行未修改的底盘48项及相机压缩测试，其通过证据仍属上一轮。

额外实际软件入口验证：域218/localhost运行修复后的准备工具新建模式，正常启动SLAM/门控/网关三进程；HTTP为`WAITING`、`armed=false`、x/yaw零；Ctrl+C后三进程正常退出。原始证据`log/mapping_review_prepare_smoke.log`及`.json`。全程无硬件节点、无系统配置或热点变更；真实浏览器显示、系统级删除/恢复和现场验收仍未通过。

2026-10-14补充只读无线能力核对：`iw list`列出managed/AP，但同时明确`interface combinations are not supported`；`iw dev`仅一个managed接口，原网5 GHz信道40，输出保留于`log/mapping_wifi_capabilities_20261014.txt`。本轮确认当前驱动未声明标准AP+STA并发，未尝试创建虚拟接口或切网，不能登记并发试验失败或芯片永久不支持。现有单接口切换流程保持。

2026-10-14后续范围修订：用户明确缩小场地，小车/平板/电脑同连“小泽”，不再推进热点工作。热点能力与恢复测试只保留备用，不再是当前建图前置门槛；平板可达性、锁屏/后台与断WiFi重连、覆盖边界、真实地图/视频及停车验收仍须现场反馈。代理只读发现已有软件预览会话运行（`log/mapping_console/20261014_090858_626082820`），本地HTTP为WAITING/未使能/x与yaw零；没有重复启动、停止现有会话或启动硬件，也没有据此认定平板访问通过。当前完整流程已改手册33.3～33.7，热点操作移至备用33.8～33.9；历史记录保留。

### 2026-10-14 平板RGB链路现场确认与关闭

用户先确认平板网页可连接，再授权只打开相机。启动前无相机进程/设备占用，沿用现有软件预览域31/localhost，不启底盘/雷达、不发送S1。仅启动`camera_mapping_rgb.launch.xml`及既有RGB压缩节点；完整启动、观察、停止步骤新增手册33.3.1。

首次后台启动未存活，日志目录`log/mapping_rgb/20261014_092923_944998334/`保留，视频HTTP503；随后改为持续执行会话启动，成功目录`log/mapping_rgb/20261014_092959_587771943/`。驱动实际打开Color RGB8 640×480/6 FPS；`rgb_hz8s.txt`短窗观测约6.035～6.038 Hz，不替代长期或平板端帧率。两次HTTP200，`video_sample.jpg`为640×480 JPEG，响应头X-Frame-Id由1791941404:962546143推进至1791941439:237744629。用户随后明确反馈画面可见、相机链路打通并要求关闭，确认本轮相机→压缩→网页→平板显示的现场通路。

按要求仅停止相机Launch。实际退出日志保留：SIGINT后5秒未退出，Launch自动升级SIGTERM，两相机节点随后cleanly退出，RGB Sensor关闭完成；未使用SIGKILL或USB断电。停止后相机进程消失、`/dev/video*`无占用，视频HTTP503（`video_headers_stopped.txt`），网页仍WAITING/未使能/x与yaw零。启动时`rgb_camera.power_line_frequency`默认3不在设备允许0～2范围的警告保留，没有为本次预览改驱动或正式参数。

结论仅为短时真实相机链路与现场显示打通；长时稳定性、平板实际帧率/延迟、锁屏恢复、视频断流停车、真实建图及移动均未因此验收通过。相机已关闭、原软件网页保留，当前网络仍“小泽”。

</details>

<details>
<summary>MAINT-001：项目瘦身第一阶段扫描与保全（2026-10-14）</summary>

目的：识别可再生缓存、疑似冗余与必须保留资产，建立维护性重构前基线；当前仅交付报告，不执行批量删除/历史迁移/代码改写或AGENTS精简。

前提：已有45项文件变更且暂存区为空；域31软件预览在运行；相机已按用户要求关闭，本轮无串口或执行器动作。完整快照位于`/home/jetson/luhao/my_nav_carcar_backups/cleanup_20261014_093557_211919094/project.tar`，覆盖.git、未跟踪/ignored及build/install/log；完整校验/恢复/复核命令只见[手册34节](操作手册.md#34-项目瘦身检查点与恢复maint-001)。

实际：源码/文档/资源tar比对通过，文件扫描0读取错误；15包清单/构建/launch/setup/plugin与资源检查未发现字面缺失构建源或未绑定自有cpp。扫描工具第一次JSON计数器初始化错误、辅助文档扫描器编译错误在仓库外修正后重跑，不修改项目代码。Cppcheck2.7整批在http_server.cpp崩溃；逐文件107次执行完成、同1文件139退出；宏和跨文件上下文不完整，98条unusedFunction仍属候选，不登记全量静态检查通过。

本轮离线基线：建图32项GTest/50.05秒、底盘pytest48项/0.93秒、硬件逻辑/插件20项＋8项lint（11个CTest入口/5.57秒）、图像2项/0.15秒，全部通过；JS语法、自有XML格式通过。原始证据均在检查点evidence的baseline-*.log。没有更改源码，所以没有重新构建全部包，也没有新增功能、性能或实机通过结论。

本轮变更：新增[报告](archive/2026-10-14-项目瘦身报告.md)，仅追加索引/手册/本登记；确认前不创建第五阶段项目清理技能。下一步：用户审阅报告后按小批次执行，无法取得原bag输入的重构只保留建议。已有地图、参数、URDF、标定、底层测试、现场失败及活动网页保持。

</details>

<details>
<summary>MAINT-001：批准后的文档归档、缓存清理与保全（2026-10-14）</summary>

用户批准第一阶段报告后执行文档/小缓存批次；执行前再次保存完整project.tar到`/home/jetson/luhao/my_nav_carcar_backups/cleanup_execute_20261014_095956_097155074`，没有stash、reset或自动commit。完整恢复、资源构建与验证命令只见[手册34节](操作手册.md#34-项目瘦身检查点与恢复maint-001)。

实际：28个旧历史文件迁入archive，原手册非当前专题/105组历史测试过程完整归档；保留原编号/深链接及原始命令，额外修复14处已有旧锚点并解释MOTOR-008/009不等同当前MOTOR-015。六份根权威文档职责收敛，原AGENTS/硬件说明/README/路线另存原文，新增project-cleanup技能。经快照哈希逐项匹配后清除77个pyc/pytest缓存文件（338,118字节内容），不清build/install/log或导入上游。CMake仅更新归档路径注释，运行源码、Launch/参数、地图、标定、URDF、模型及底层测试保留。

离线：六包安装资源构建53.0秒通过（PCL/CMake既有警告保留）；建图32项GTest48.78秒、底盘48项pytest1.05秒、硬件20项GTest＋8项lint（11个CTest入口5.63秒）、图像2项0.14秒通过。JS/XML、Python静态编译、技能格式检查通过。额外flake8报9条既有E501；从执行前快照提取相同文件复查，排序后告警逐条一致，不登记为新增失败或全部静态通过。

原Cppcheck的98个unusedFunction候选已逐项建立包内词法引用/框架注册证据表；public/安装头文件、框架回调与测试资产继续保留。两个未发现包内引用的普通候选也不据此删除API或测试方法。ror_sweep成员和重复bag读取因缺少原输入输出对照仍仅建议，没有重写驱动或安全模型。

代码块保全、链接/锚点、移动文件与受保护内容哈希、最终路径清单及磁盘口径统一见[执行结果](archive/2026-10-14-瘦身执行结果.md)及检查点evidence。相机保持关闭、域31软件网页仍运行；无网络/系统配置/执行器动作，不增加实机场地验收结论。

</details>

<details>
<summary>NAV-017-R1：平板常驻入口、摇杆与完整任务流程（2026-10-14）</summary>

目的/范围：完善小泽WiFi覆盖内、同一楼层、操作者目视随行的建图流程；开机自动登录后网页待命，平板新建/续建、摇杆、可选视频、保存结束和故障恢复。地图要求完整覆盖且无明显重影，导航本轮仅加载格式验收。用户已确认方案后实施；不扩大为自主探索、自动避障、多楼层或热点切换。

对应代码/配置：`carcar_mapping_console/src/web_gateway.cpp`管理固定argv的子任务与工程选择；`include/.../task_process.hpp`负责自己的Launch进程组；`safety.hpp`及`teleop_guard.cpp`增加受限连续输入、松手序号屏障和前台心跳；`web/`增加摇杆/任务/诊断；`tablet.launch.xml`与`config/mapping-tablet.service`为待命入口。旧准备工具、XML和严格视频联锁模式保留。没有改底盘速度/雷达范围、IMU融合、URDF/标定、旧地图或热点配置。

安全与硬件前提：本轮全部运动验证使用隔离域219、localhost、合成扫描/里程计，`backend_hardware=false`，不打开真实串口、相机或雷达。现场仍先隔离轮动力/架空、检查供电和支架扫掠；底盘启动S1=94只是命令值，不能当实物角度反馈。软件授权/心跳时限不代表停车距离或控制板独立失联保护通过。完整构建、静止/运动验收、观察、停止和回滚统一[手册33节](操作手册.md#33-平板随行建图nav-017)。

实现结果：松手归零保留使能；锁屏/后台/断联/故障/保存/重启撤销使能。前台脚本心跳只保留使能，不能延长旧运动命令；即使WebSocket底层仍回应ping，脚本挂起也锁停。视频按需启动，不作随行遥控授权前提。保存失败保持任务与锁停，可重试；保存结束成功后关闭本次硬件任务，网页保留。重启提示丢失未保存进度，有本次成功版本则从最近版本续建，仍需人工对齐；不自动启动硬件或抢占其他串口程序。

**实际离线结果：**目标包colcon构建通过，修订后显式并行2进行增量构建。38项C++用例全部通过（20项逻辑、5项工具/网页事件模拟、9项进程集成、4项HTTP；4个CTest程序，总72.99秒），证据`log/mapping_tablet_20261014/final_ctest.log`及`build/carcar_mapping_console/test_results/`。既有底盘48项pytest与Python compileall通过；JS/XML语法、XML参数解析、systemd定义校验及差异空白检查通过。GCC既有ABI提示保留，不登记为编译错误。本轮未改相机/硬件包，不重复冒称其既有结果为本轮新验收。收尾新增中文长诊断日志按字节截尾仍可编码为JSON的第38项用例；此前37项通过的原始日志`final_ctest_37passed.log`保留，最终38项日志仍为`final_ctest.log`。

完整任务用本机真实SLAM Toolbox2.6.10配合合成室内数据：网页待命无门控速度发布者→新建→无视频使能→组合摇杆→松手仍使能且零速→再推→停车保存→平板重启为最近版本续建→旧图另一位置/朝向试匹配→确认→保存结束→网页待命且门控发布者消失。增加车位和红色激光叠加非空断言、原工程SHA256保持、失败保存重试锁停；工程及日志保留在`log/mapping_tablet_20261014/final_artifacts/`。只是离线坐标/接口/生命周期通过，不当作实物移动或场地质量通过。

**现有导航入口实际加载：**将本轮合成工程交给`localization_experimental.launch.xml`，隔离域220、`use_rviz=false`，map_server及AMCL实际收到60×80格、约0.05m分辨率地图，证据`navigation_map_load.log`与`navigation_map_info.txt`位于同一日志目录。没有真实扫描或底盘，不验收AMCL准确性、路径执行或实车导航。一次性后台诊断Launch继承忽略SIGINT，结束时已按确认过的PID用TERM关闭本轮五个只读节点与Launch；进程消失，未影响域31软件入口。保留原始退出日志，不冒称该后台包装首次INT退出成功。

**原始失败与修订保留：**首轮36项中新增全流程在重启后的续建请求409，其余通过；`first_ctest_failed.log`与`first_integration_failed.xml`保留。原因之一已由代码和状态确认：REFERENCE阶段尚未放行扫描，本来没有实时地图，却被无条件地图年龄检查误锁停；修订为只在实时建图阶段检查实时地图超时。第二轮请求已接受，但候选等待超时，`managed_round2.log/.xml`与完整工程/任务日志保留。再诊断同一二进制可成功，但服务就绪曾延迟约20秒，状态序列保留在`managed_state_diagnosis.jsonl`，不把间歇成功当稳定。

退出路径发现对整个组发送SIGINT后，非交互Launch还会向节点转发SIGINT，存在重复信号路径；旧日志SLAM退出码-2，新实现只先给Launch首进程INT，等待其有序转发，超时才对自己的组升级信号。最终两轮任务日志SLAM和门控均`finished cleanly`，全流程回归通过。Fast DDS默认20秒参与者租期和服务端点匹配机制可解释异常退出后的约20秒延迟，但本轮未抓包证明旧端点残留，仍是有依据的推断。[Fast DDS发现设置](https://fast-dds.docs.eprosima.com/en/v2.6.11/fastdds/discovery/general_disc_settings.html)、[rmw_fastrtps6.2.10服务就绪实现](https://github.com/ros2/rmw_fastrtps/blob/6.2.10/rmw_fastrtps_shared_cpp/src/rmw_service_server_is_available.cpp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)。本机默认租期证据在`/opt/ros/humble/include/fastrtps/fastdds/rtps/attributes/RTPSParticipantAttributes.h:251`，Launch转发证据在本机`execute_local.py:426`。

排除记录：不能把minimum_time_interval=0.3直接归因于续建第一帧丢失；[固定2.6.10实现](https://github.com/SteveMacenski/slam_toolbox/blob/2.6.10/src/slam_toolbox_common.cpp#L819)在deserialize后设置first_measurement，并在节流判断前优先放行第一帧，本轮未改此参数。另由状态证据发现清空TF缓存后，常驻订阅不能自动重收仍在运行发布者的固定TF，表现为车位/红点缺失；启动任务时重建监听订阅，补入叠加显示断言并通过。

**部署实际状态：**旧无硬件预览正常退出，用户服务`mapping-tablet.service`已安装并enabled/active。当前HTTP与三个本地网页资源返回200，状态`managed=true, phase=STANDBY, busy=false, video_requested=false`；只运行常驻网关，无底盘/雷达/SLAM/门控/相机进程，两个串口空闲。IP本次读回仍`192.168.5.11/24`，原“小泽”未改。定义与启用链接变更前已保存同目录完整备份/原状态，桌面维护记录`2026-10-14-01`含前后内容、回滚及验证，项目证据`service_before.json`、`service_standby.json`。沿用既有GDM自动登录，linger仍no；没有sudo、/etc或网络修改，没有实际重启Jetson。

未确认/下一步：平板新版布局/摇杆和锁屏/后台/断网；供电、实际方向、两档起步与物理停车时间/距离；20～30分钟房间—走廊—大厅回到起点、途中保存、结束后旧图另一位置续建；真实地图覆盖/重影以及Jetson正常重启后的网页自启。按手册33.4起逐级现场反馈；实车导航留下一阶段。旧32项与RGB可见结果仍是历史证据，不覆盖改写成新版实机通过。

### 2026-10-14 测试前复核：串口预检修正与现场前提

本轮用户准备现场测试时，只读检查发现本机`fuser -- 路径`返回“未指定进程/用法错误”，退出码同样为1；此前仅凭退出码1写“空闲”不够严谨，该旧检查结果不能独立证明串口无占用。临时普通文件保持打开时，同一错误形式仍退出1；正确的绝对路径形式退出0并报告持有者PID，已离线复现，不打开设备。

修订`src/carcar_mapping_console/src/prepare.cpp`：解析端口为绝对路径，不传该工具不接受的结束选项；收集stdout/stderr，只有退出1且输出为空才视为未占用，工具错误/异常退出/占用均拒绝启动。使用posix_spawn执行固定argv，不执行shell或发送串口数据。新增工具测试使用临时文件及只捕获argv的ros2替身，验证占用拒绝、释放后放行、检查工具报错拒绝；没有启动真实底盘、雷达或相机。

实际结果：目标mapping_prepare/test_mapping_tools构建通过；6项工具回归4.91秒通过，新增1项后现有C++共39项有通过记录，其余33项沿用上一轮完整回归，本轮未冒称再次全量运行。48项底盘pytest与Python静态编译通过。日志`log/mapping_tablet_20261014/preflight_fix_build.log`、`preflight_fix_ctest.log`；原38项完整回归日志保留。正确形式只读复核两个真实串口，均退出1且stdout/stderr为空，确认本次检查时无占用，不当作之后持续空闲的保证。

现场前提：用户明确反馈“四轮落地且轮动力接通，尚未隔离”。当前只允许先做网页待命/重连检查，尚未由本轮启动硬件、发送S1或非零轮命令。真实静止检查前须隔离轮动力或可靠架空，并处理支架扫掠；不能把历史“可以单独断开轮动力”写成本次“已经断开”。操作与恢复沿用手册33.3～33.5。

</details>

<details>
<summary>NAV-017-R1：审查修复备用热点串口检查（2026-10-14）</summary>

目的/范围：修复审查发现的`hotspot.cpp::no_motor_owner()`仍将本机`fuser -- 路径`的用法错误（退出码1）视为空闲，可能在底盘驱动未退出时继续切换网络的问题。普通临时文件保持打开时，旧形式退出1并报告“未指定进程”，正确形式退出0并列出PID；原始证据`log/mapping_hotspot_fix_20261014_153933_430754/original_probe_reproduction.json`。不读取真实密码或打开真实串口。

修订：将已修正的启动预检逻辑提取为`include/carcar_mapping_console/serial_preflight.hpp::require_unused_serial()`，由`prepare.cpp`和`hotspot.cpp`共用；解析绝对路径后固定argv调用fuser，原样收集stdout/stderr，仅正常退出1且完全无输出时放行。占用、缺失路径/工具、报错、异常退出或结果读取失败都拒绝继续。原有热点命令、备份/恢复流程和小泽WiFi保持；操作与恢复仍统一[手册33节](操作手册.md#33-平板随行建图nav-017)，本阶段不执行备用热点操作。

回归范围：新增工具用例用真实fuser检查临时普通文件的占用/释放及符号链接；C++替身覆盖带空格路径的完整argv、退出1但stderr报错、仅stdout换行、其他退出码、信号退出和工具缺失。既有准备工具测试保留，ros2仍用只记录argv的替身。测试与构建只写build/install/log和临时目录，无网络/系统配置、串口、相机或电机操作；进程集成仍用隔离域219、合成输入和`backend_hardware=false`。

完整回归首轮39/40用例通过，仅已有全流程用例在使能等待处超时；原日志`full_ctest.log`及`first_test_results/`保留在同一证据目录。未改生产控制逻辑时，单独该用例17.90秒通过，相邻真实SLAM/全流程两用例连跑28.61秒通过；`ordered_state_trace.jsonl`记录任务已RUNNING而门控仍短暂报告“建图会话未就绪”的间隔。原失败缺少当时状态采样，不能断言这是唯一起因。集成用例补齐“门控已连接且健康”的使能前提并保留失败诊断，仍只发送一次使能；停车阈值和生产控制逻辑保持原值。隔离/相邻运行的日志与工程也保留。

最终离线结果：目标包colcon构建和集成用例增量构建通过，GCC既有ABI提示保留；40项C++用例完整通过（7项工具、20项逻辑、9项进程集成、4项HTTP；4个CTest程序共76.60秒），日志`final_ctest.log`，最终XML与合成工程保留在同一证据目录。48项底盘pytest通过（1.04秒），Python静态编译、JS语法与差异空白检查通过。当前网页仍STANDBY，未切换WiFi、修改系统配置或启动真实硬件；实物停车、平板触控与20～30分钟场地验收仍未完成。

</details>

<details>
<summary>NAV-017-R2：持续摇杆误锁停、必要日志、平板布局与快速档（2026-10-14）</summary>

目的/现场反馈：用户通过平板启动真实建图并反馈“控制上没有什么大问题”，但持续拉动摇杆约1～2秒停车，顶部仍显示控制已连接，需要重新使能；没有当时的精确锁停快照，因此不能认定网络断开、物理刹停指标通过或唯一起因已定位。用户要求移除重复方向方块、适配平板、补日志并提供更高速度选项。

复现与修订：`test/test_browser_control.js`在真实app.js调用边界替换DOM/网络/时钟，保持专用WebSocket新鲜、让HTTP状态请求停滞3秒；旧网页在1000ms发送stop，`browser_before.log`保留明确断言失败。客户端原先把HTTP轮询年龄当遥控前提，改为专用WebSocket新鲜度；新控制状态到达时优先续发当前摇杆意图，发送频率受限。真实控制消息过期、脚本挂起、后台、触屏取消等仍锁停，恢复消息不自动恢复按压；车端0.20秒授权、0.30秒前台/网关、0.50秒传感器与底盘0.30秒超时保持。该路径的离线因果已复现，现场此次锁停是否同因仍待新日志验证。

对应代码：`web/app.js/index.html/style.css`、`include/.../safety.hpp`、`src/teleop_guard.cpp/web_gateway.cpp`、`config/mapping_limits_candidate.yaml`。诊断记录门控状态变更和最近撤销许可快照（具体原因、传感器/挑战年龄、请求/定时器间隔）；客户端记录触屏/后台/脚本卡顿/通信间隔，浏览器按同一时钟计算往返耗时。双方各保留最近128条事件，门控事件进入本次任务日志、网关事件进入服务journal，网页查看并导出JSON。会话密钥/挑战令牌不写日志或导出；不逐帧刷驱动日志。

布局与速度：横屏左侧地图、右侧摇杆及保存，重复方向按钮移除，顶栏独立使能和停车锁定保留，辅助功能折叠；小高度窗口收紧布局，竖屏调整为上下布局。新增快速档0.18m/s、0.36rad/s命令候选，慢/常档原值与默认慢档保留，切档停车并重新使能。建图专用底盘限值同步，正式base.yaml不改；旧门控未报告支持时禁用快速选项。网页渲染约30Hz/DPR最多2，传感器、地图源频率与RViz配置未改。

离线实际：完整目标包构建通过，GCC既有ABI提示保留；44项C++（22逻辑、8工具/网页、10进程集成、4HTTP）共82.69秒通过。新增验证快速档限幅/切档/短授权、具体拒绝原因和时序、持续3秒摇杆与锁停诊断留存、日志敏感字段过滤；48项底盘pytest1.20秒通过，Python静态编译、JS语法、网页ID引用与差异空白检查通过。源码/日志/合成工程与最终XML保留在`log/mapping_joystick_20261014_162841/`。测试域219/localhost，合成输入，不打开实际串口或发送真实运动请求。

布局浏览器验证：使用本机Chromium155的隔离测试副本与现有Snap core24运行库，未修改系统浏览器/库/配置，全部网络与控制接口替换为合成夹具。1280×800、1024×600、800×1280三个窗口通过，实际CSS视口分别1280×657、1024×457、800×1137；停车/使能/摇杆/保存/结束均在可视区域，无横向溢出。截图`tablet-landscape/compact/portrait.png`和`layout-*-metrics.json`保留，不当实车地图或Android触屏通过。首次小高度/竖屏保存按钮越界，已通过紧凑布局及显式网格区域修正；最初浏览器启动依赖/ICU/辅助进程错误记录保留，最终运行成功。

部署与工程保全：用户反馈已保存并结束；重载前实际读到FAULT/dirty=false/armed=false，雷达/里程计已停止更新，但旧进程尚在，不能把反馈改写为软件实际已STANDBY。最近成功工程`20261014_162654_db59f27d`四文件SHA256全部匹配，先复制完整工程及故障状态/任务尾日志，再关闭本工具残留子任务并重载常驻服务。随后实际HTTP为STANDBY、diagnostics_version=1，只剩网关；没有重新启动硬件、发送S1或行驶指令。旧工程仍可选择；刷新网页与车端重载分别维护，完整操作/停止恢复统一[手册33节](操作手册.md#33-平板随行建图nav-017)。

未确认：新版平板持续摇杆是否消除现场1～2秒锁停、快速档带载实际速度与停车距离、传感器停止更新的具体原因、长期覆盖与20～30分钟路线及异地续建。用户下一轮先常速复测，异常先查看并导出诊断，再处理重连；不以放宽保护阈值或反复使能掩盖故障。

</details>

<details>
<summary>NAV-017-R3｜2026-10-14：实际网页控制时序与撤销使能修复</summary>

目的/范围：用户报告R2部署后仍无法稳定使能，拉动摇杆就退出并取消使能。先保存真实只读诊断；代理不向实车发送使能或运动，隔离ROS域219、localhost端口18089使用合成雷达/里程计与真实C++网关/门控，运行真实网页app.js；只替换DOM/绘制接口，保留原生HTTP/WebSocket与定时器。现场车轮仍落地/动力接通，没有新的隔离确认；未把离线命令输出当实物动作。

先失败后修复的证据：`log/mapping_control_r3_20261014/trace_red.log`中现场176.589948ms令牌年龄、47.395837ms请求间隔重放导致“操纵授权超时”，另一个220ms心跳重放被拒；`protocol_red.log`中无延迟浏览器流程通过，每方向80ms延迟时使能被“浏览器前台心跳超时”撤销。上轮Node夹具直接假设armed=true，原C++集成只使用自写WebSocket客户端，未组合真实网页与门控，不能证明真实平板控制链路正常。

修复原理/代码：`safety.hpp`统一运动和前台心跳为签发后300ms有效，运动原200ms窗口包含整个通信往返，现场正常消息到达时剩余时间小于下次请求间隔；心跳原200ms有效期又短于300ms前台许可，提前丢弃仍处于前台许可范围的请求。窗口增加100ms，仍使用车端单调签发截止时间，重复/迟到/松手前排队请求不能重新计时，心跳不能续租旧运动。app.js收到状态立即回应前台心跳，本地新鲜度使用门控报告窗口，旧门控回退200ms；输入/使能显示也即时按新控制状态更新。`teleop_guard.cpp`报告实际接受序号、过期拒绝计数与最近请求结果，避免将收到序号误解为授权续租成功；连接时清除上一会话的时序统计。

验证：25项逻辑、8项工具、11项集成、4项HTTP共48项C++全部通过，CTest四组90.07秒；新增真实网页流程包含点击使能、等待、持续推杆2.5秒、松手归零保持使能、再推及脚本挂起停车，在0/80ms单程延迟下通过。浏览器夹具另验220ms下行间隔与真正超时，原HTTP卡顿/后台锁停仍通过。底盘48项pytest、既有Python静态编译、两份JS语法及目标包构建通过；原始失败与修前完整包保留于证据目录。完整构建/测试/启动/停止恢复统一见[手册33节](操作手册.md#33-平板随行建图nav-017)。

现场证据/部署：真实日志确认连续推杆期间先发生运动授权超时，随后客户端220ms未收到控制状态发送control_stale停车；没有对应pointer_cancel/pointer_capture_lost记录，不能以触屏取消作为该次撤销的结论。约7秒后雷达停止更新，约2秒后任务进入FAULT；该后续硬件/传输故障原因未知。重载前再次只读核对FAULT、未使能、dirty=false，复制任务日志、服务journal、公开诊断及当前地图PNG快照后重载现有用户服务，实际返回STANDBY且新版JS可读取，残留底盘/雷达/门控退出，仅网关待命；未修改服务定义或系统配置。旧地图工程保留。

边界/下一步：软件回归通过不等于平板现场已通过；需要刷新网页重新启动测试任务，常速先复测使能/持续推杆/松手/再推，异常先停车。授权增加100ms会增加旧动作可能持续的时间，实际停车距离待验，不宣称硬实时或控制板独立停车通过。雷达停止更新需复测并独立定位，未完成前不推进20～30分钟场地路线。

</details>

NAV-017-R3部署读回补充：重载后的首次立即诊断请求早于第一轮状态缓存生成，返回`cannot use erase() with null`，原始响应另存`startup_probe_error.json`；随后独立请求HTTP成功且phase/task_state均STANDBY、diagnostics_version=1，新JS内容核对通过，服务active。该启动瞬间诊断接口窗口没有冒充成功，后续状态读取正常；不是本轮持续摇杆时已复现的授权超时。未进一步改动网关。

<details>
<summary>NAV-017-R4｜2026-10-14：控制链路边界复查与扩大延迟回归</summary>

目的/范围/前提：用户要求再次仔细检查。只读实车HTTP核实STANDBY、dirty=false、控制为空；代理没有启动硬件、使能或发送真实运动。保留R3及所有未提交资产，本轮修改前完整包和现场状态在`log/mapping_control_r4_20261014/before/`、`onsite.json`。继续使用隔离域219/localhost18089的真实C++网关/门控与真实app.js、合成传感器；启动瞬间HTTP测试单独固定域218/localhost18090，backend_hardware=false。

复现与修复：

- `protocol_100ms_red.log`：R3的300ms窗口在0/80ms单程延迟通过，新增100ms单程时仍在使能确认阶段被前台心跳超时撤销。页面未收到armed=true时没有在新状态回调回应，只靠100ms兜底；上一条旧挑战的30ms节流还会挡住紧接着的新挑战。改为确认途中也及时回应，新挑战优先发送；车端未使能时心跳不能启动车辆，运动与前台授权保持300ms签发截止，无再次放宽。`protocol_green.log`三种延迟均通过使能、闲置、持续推杆、松手归零保留使能、再推和脚本挂起停车。
- `connection_red.log`：网关在guard_session确认前可重复发送同一connect，旧Safety每次都会撤销使能、重置慢档和序号。改为同一非空会话ID的连接确认幂等；新ID仍撤销授权、清空旧序号并恢复慢档。回归同时检查重试保留授权/快速档/序号、旧运动序号拒绝、新会话停车。
- `browser_red.log`：显式重连仍短暂使用旧连接的armed=true和新鲜度。统一清空连接状态、心跳/运动发送时间、往返统计及指针状态，立即禁用使能与摇杆；旧socket迟到消息不影响新连接。初始HTML的使能按钮也默认禁用。扩大现有真实网页脚本夹具验证该边界。
- `startup_red.log`：监听开始到第一次100ms状态轮询之间，首个HTTP状态为{}，诊断可触发erase(null)。改为HTTP监听前生成完整状态，新增真实进程/HTTP启动回归。查看/导出诊断增加当前控制时序、实际接受序号与任务状态，未记录会话密钥/挑战令牌。

验证结果：26逻辑、9工具、11集成、4HTTP共50项C++回归全部通过，CTest四组97.40秒；底盘48项pytest通过（1.42秒），Python静态编译、四份JS语法检查及目标包构建通过。原始失败、源码修订和最终原始结果保留。完整有效构建/测试/启动/停止恢复步骤统一[手册33节](操作手册.md#33-平板随行建图nav-017)。

未完成的真实浏览器检查：新增可选`test_browser_touch.js`尝试真实Chromium155加载实际DOM/CSS并注入触屏和页面冻结；本机Snap可执行文件需临时副本/core24加载器，虽可生成about:blank DOM，但访问localhost测试页时Page.navigate超时；独立Node最小HTML测试也未收到浏览器请求、4.5秒后超时。尚未进入有效触屏测试，不计为通过，也不能归为真实平板兼容性失败。最初清理临时浏览器目录还出现ENOTEMPTY并掩盖最早错误，后续保留原错并修正为清理独立进程组/重试目录删除；原失败日志保留。临时探针输出在证据目录，源码中的临时DEBUG探针已移除，浏览器副本/临时用户目录清理，不修改浏览器或系统配置。仍需用户平板现场反馈。

雷达后续断流：只读查询原17:15:30～17:18:30内核日志窗口没有条目；这不能证明没有供电、USB或雷达异常，也不能据此归因。原任务日志/断流快照继续保留，未重新驱动硬件来验证，后续独立排查。

部署/边界：再次核实实际STANDBY、dirty=false、未使能后重载现有用户服务，读回phase/task_state均STANDBY、diagnostics_version=1，新JS关键逻辑可读取，服务active。保持网页待命，无硬件启动；旧工程保留，无系统配置修改。刷新平板才会加载新客户端，新的建图任务才会加载新门控。真实平板持续拖动、物理停车距离、雷达断流和长范围路线仍待验，离线通过不作为实车结论。

</details>

<details>
<summary>NAV-017-R5｜2026-10-14 19:50现场三次锁停、连接描述符泄漏与通信诊断</summary>

目的/范围：用户报告安卓Chrome与小米自带浏览器均突然断掉，要求读取刚完成的测试日志。代理先只读保存公开诊断、任务完整日志与网关实际PID journal，不重启或发实车使能/运动；既有轮动力状态与路线验收前提不变。证据目录`log/mapping_control_live_20261014/`。

现场结论：19:50:05、19:50:12、19:50:18三次撤销均为车端tick判定“操纵授权超时”，对应网页随后报告控制消息间隔305、306、316ms。三次雷达/里程计新鲜、门控周期约20ms，没有对应pointer_cancel/pointer_capture_lost。最后一次有效命令令牌年龄仅6.27ms，随后未能在剩余约294ms内接到续上的命令；说明存在间歇停顿，不能把新增固定延迟回归通过当现场稳定。网页也有131～152ms脚本延迟，来源与网络贡献仍需分离。

通信只读证据：旧控制TCP连接对端192.168.5.54，累计38次重传、平滑往返336.934ms、最小1.822ms；这是读取时的连接统计，不是每次停车瞬间的独立测量。随后20包客户端ping为0丢包，2.493/44.960/233.754ms最小/平均/最大，说明短窗确有时延波动，不等同300ms以上断流已复现。路由器20包ICMP有60%未回应，可能是ICMP限流，不能直接判WiFi业务丢包；车端-49dBm、5GHz、powersave=on仅读取，没有改变网络配置。需要分别验证网络传输停顿、TCP消息发送与前台线程卡顿，未宣布唯一根因或通信故障解决。

另一个已确认缺陷：网关关闭控制连接后，socket inode178241仍被backend Launch、robot_state_publisher、rosmaster、sllidar、SLAM、guard共同持有，接收队列继续增长；后台进程继承了网关未设置close-on-exec的通信描述符，导致客户端不能及时收到真正的TCP断开。`socket_red.log`用真实socketpair与TaskProcess先复现子进程存活期间无EOF、子进程仍能访问fd。修正TaskProcess在标准输入与stdout/stderr日志重定向后，使用本机glibc支持的posix_spawn closefrom动作关闭fd>=3，保留原进程组管理和退出停车路径，不向后台传递HTTP/控制/ROS通信描述符。修后一次测试因EOF早于子进程main打印日志出现探针竞争，`socket_probe_race.log`保留；分别等待连接关闭与子进程日志后回归通过，没有把该失败改写成通过。

验证：26逻辑、10工具、11集成、4HTTP共51项C++全部通过，CTest97.69秒；底盘48项pytest通过（1.07秒），Python静态编译、JS语法与目标包构建通过。追加未使能/未推杆状态的control_gap事件，一次断流只报一次，不发送运动/使能；JS夹具验证停车断流被记录、第二指不接管、正常松手释放捕获不锁停。该日志追加后再跑工具与实际浏览器脚本协议集成（0/80/100ms单程），结果另存tools_final.log、browser_final.log。协议集成运行真实app.js和HTTP/WebSocket/C++门控，DOM为替身；不是Android实浏览器触控通过。完整构建/诊断/停止恢复命令仍统一[手册33节](操作手册.md#33-平板随行建图nav-017)。

日志查询修订：本轮按user-unit查询没有取得事件，而按实际网关PID取得完整时间线；手册追加PID查询并保留旧命令，[修订前原文](archive/2026-10-14-平板建图R5日志查询修订前原文.md)保留。不能将空查询当没有故障，跨重载历史同时使用导出诊断与任务日志。

部署与保全：任务仍RUNNING时不直接重载，用户先在平板重连、保存并结束并明确反馈待命；实际随后为STANDBY/dirty=false/未使能。工程20261014_200505_1933aa00四文件SHA256匹配，完整复制到证据目录后重载现有服务，实际STANDBY且active，无后台硬件进程；旧socket残留随原任务退出释放。新TaskProcess进程隔离已离线通过，新真实硬件任务中的连接回收仍待现场复测。只改项目代码/文档，不改服务定义或无线省电设置，不发实物运动。

边界与下一步：300ms授权保持，连接回收修复不等于控制通信抖动解决。刷新网页后可先按原启动提示启动任务，保持未使能、车辆停车，观察约1分钟并导出诊断；停车也记录控制断流，用于区分通信问题是否依赖摇杆操作。没有可靠连续通信和停车结论前不推进大范围路线。实际停车距离、雷达曾停止更新的原因与长范围建图仍待确认。

</details>

<details>
<summary>NAV-017-R6｜2026-10-14 超时试改回归、停车状态通信观察与雷达启动缺扫描</summary>

目的/范围：接续用户提供的“编译通过、两个测试组失败”排查，核对试改是否保留已约定的停车行为，再分离现场其他超时。代码涉及`include/carcar_mapping_console/safety.hpp`、`src/web_gateway.cpp`、`web/app.js`及两个既有测试文件；保留R3～R5修复、旧入口与工程。证据目录`log/mapping_timeout_r6_20261014/`，完整构建/测试/诊断/停止恢复仍统一[手册33节](操作手册.md#33-平板随行建图nav-017)。

安全与硬件前提：代理只执行隔离域219/localhost的替身测试、实际域31的只读话题订阅、HTTP诊断、端口占用与TCP查询；没有启动/重启硬件、打开串口、调用电机服务或发送真实使能/行驶命令。用户同意保持页面打开、车辆停车且未使能观察。现场自行启动的本次任务日志仍有原底盘S1板端94/目标140.5°发送记录，不等于实际角度；用户确认雷达未转，稍后反馈“现在打开了”，实物与软件状态按时间分别记录，见硬件台账R6。没有系统/网络配置修改。

原始失败：最初“四组中两组失败”实际为9个Safety用例与1个网页协议用例，后者明确报“脚本挂起后仍使能”。试改把授权改成收包后500ms、挑战存留2秒、网关两侧阈值800ms、网页旧版本回退500ms，改变了原300ms签发截止与挂起停车行为。原包完整副本在`before/carcar_mapping_console/`，原CTest及XML结果在`red/ctest_original/`与`red/test_results_original/`；没有通过放宽测试期待值消除失败。新增同一旧挑战配递增序号的回归先失败：签发后295ms再收到请求，剩余许可错误变为500ms，301ms仍被接受；`red/buffered_commands.log`保留。网页缺租期字段的201ms过期回归也先在修前页面失败，`red/browser_fallback.log`保留。

修订与预期：恢复运动/心跳按车端签发后300ms截止、挑战只在原有效期内匹配；网关健康与启动/连接确认恢复300ms，旧门控未报告字段的网页回退恢复200ms。首次使能以统一常量给初始许可的写法保留。迟到或排队请求不能重新计时，心跳不能续租旧运动；挂起/断流/传感器异常仍锁停，松手归零与重新使能规则保持。各超时的输入方向和时序字段含义补入手册33.1。

验证（离线）：目标包Release构建完成；一次会话中断留下零字节测试对象与可执行产物，移存`red/test_logic_interrupted.o`、`red/test_mapping_logic_interrupted`后强制重新编译，最终对象/可执行文件非空。中断与两轮构建日志保留，不把首轮构建成功当作测试产物有效证明。27逻辑、10工具、11集成、4HTTP共52项C++全部通过，CTest四组102.03秒；真实app.js/HTTP/WebSocket/C++门控协议在0/80/100ms单程注入下覆盖使能、闲置、推杆、松手、再推、挂起停车。底盘48项pytest通过（1.44秒），既有Python静态编译、四份JS语法、XML格式通过。证据`build_final.log`、`ctest_full.log`、`test_results_final/`、`logic_green.log`、`base_pytest.log`；`verified_source.sha256`核对测试后五份逻辑/测试源码未变。这些不是Android实浏览器或物理停车验收。

既有现场日志复核：`log/mapping_heartbeat_20261014/`中20:14:36/41为前台心跳超时，20:14:48/52为操纵授权超时；四次网关年龄分别13.28/93.28/13.33/93.37ms、门控周期约20ms、传感器新鲜。不能据此宣称隐藏300ms网关阈值触发这四次撤销；`ready=false`与网关年龄过期也不能仅凭同一提示文字混淆。抽取结果`field_stops_summary.json`保留。

本次未使能观察：20:47:47/52及20:48:46记录控制消息间隔346/322/340ms，证明停顿不依赖摇杆；启动负载仍可能影响这段观察，不据此排除车端调度因素。相同TCP连接的平滑RTT快照从约56.6ms升到412.9ms，发送队列一度17076字节、累计重传5；它是连接统计，不是每次事件的同步抓包，也不能确定路由器/无线省电/页面卡顿的唯一起因。稍后客户端重连后的约17.6ms快照属于另一个端口/连接，不能与前一条当成连续测量。原始`idle_diagnostics_*.json`、`idle_tcp_*.txt`保留，通信抖动尚未解决。

雷达与任务状态：20:47:45启动后，驱动读到身份/健康和Express配置，但未收到扫描；直接8秒订阅无消息。三个进程实际域均31、localhost开启、同一RMW，`/scan`仅一个发布者，Reliable发布可匹配Best Effort订阅，不将其误判为域号/QoS不兼容。唯一串口所有者为sllidar_node，未重新打开设备；用户确认圆盘没转，45秒启动期限后任务进入FAULT、未使能。稍后用户反馈“现在打开了”，同一驱动PID的直接`/scan`订阅收到`laser_frame`时间戳，门控扫描年龄恢复到数十ms。任务仍保持FAULT；网关在故障后关闭接收，其顶层`scan_age/odom_age`不再更新，不能用该冻结值否定门控与直接订阅的恢复结果。驱动起转返回值与失败采集循环缺少持续诊断，现有日志不能确认未转的唯一原因。内核USB关键词只读查询无条目，亦不证明供电/USB无异常。原始任务/订阅/诊断证据保留。

恢复后补测：用户反馈“现在打开了”后，只读订阅`/scan`的12秒命令窗口内，滑窗频率10.445～10.490Hz、采样间隔0.088～0.097秒，证据`scan_header_followup.log`、`scan_hz_after_user_opened.log`；直接订阅恢复与门控扫描年龄一致。短窗不替代长期稳定性或物理转速测量。最终只读状态仍FAULT、dirty=false、armed=false，门控直接扫描年龄约52ms。

结论/下一步：授权保护回归已修复，恢复后的雷达稳定性、控制通信连续性与物理停车仍待验。本轮未重载常驻网关或自动退出/重启故障任务；程序重新编译不等于正在运行的进程重新加载。先按手册33.8处理故障任务，重启会重新启动底盘并发送S1，须先隔离轮动力、确认支架扫掠安全；随后保持未使能验证扫描与控制链路。未保存进度风险及退出/回滚统一手册，不把FAULT自动改为可行驶状态。

**21:05恢复执行追加（用户明确“开始执行”后）：**用户确认“轮动力隔离或可靠架空，支架扫掠安全”，具体采用哪种隔离方式未另外推断。恢复前重新读到FAULT、dirty=false、busy=false、未使能、速度命令零；完整备份旧诊断、任务日志、网关journal及三个历史工程，四核心文件SHA256逐项通过。停止既有用户服务后，旧Launch/底盘/雷达/SLAM/门控进程均退出，日志为`finished cleanly`；再启动同一服务定义，未修改systemd、网络或系统配置。新网关PID7219、新门控PID7277的`/proc/PID/exe`分别与本轮构建产物SHA256一致，实际提供的app.js与源码SHA256一致；旧网关二进制确与本轮产物不同，不能用之前仍在运行的进程代表已部署。

恢复方法/结果：本次临时C++恢复客户端保留在`log/mapping_recovery_r6_20261014_tKZb34/`作证据，不是新的日常入口；固定127.0.0.1:8080、仅从STANDBY发一次新建请求，不含使能或运动请求，凭据仅在内存使用。真实任务STARTING/WAITING→RUNNING/CURRENT→门控健康后释放控制连接给平板，未连续重启；新任务启动确实再次发送S1板端94/目标140.5°命令，仍无实际角度反馈。原失败任务没有本次保存版本或未保存进度；三个历史工程备份与原件五文件逐字节一致。运行中查询工程列表返回409“请在待命时选择工程”，是接口既定限制，不能误报为旧工程损坏。

恢复后静止验收：60次HTTP诊断采样跨62.574秒，无HTTP失败，全部RUNNING/CURRENT、未使能、x/yaw命令零；采样最大雷达年龄96.34ms、里程计40.12ms、门控状态52.36ms，地图约3秒更新（最大年龄2.957秒）。独立12秒雷达频率命令窗口滑窗约10.456～10.477Hz。证据`idle_trace.jsonl`、`idle_summary.json`、`scan_hz_recovered.log`、`start_execution.log`、`binary_hashes_after.txt`、`guard_binary_hashes_after.txt`、`web_hashes_after.txt`及新旧完整任务日志保留。该静止窗内无平板控制TCP连接，门控报告“操作者已断开”；因此只确认车端输入/任务恢复，不能将没有客户端断流事件当作平板通信已稳定。原52项C++/48项底盘离线结果保留，本轮生产代码未再修改。

</details>

<details>
<summary>NAV-017-R7｜2026-10-14 平板前台静止通信复测未通过</summary>

目的/范围：用户确认平板已显示实时建图、控制已连接后，按约定只读观察一分钟，区分车端输入恢复与平板通信连续性。沿用R6安全前提、实际域31与现有任务，不发送使能/运动、不开串口、不重启或修改网络/系统配置。用户确认21:16～21:17页面始终在前台，没有锁屏、切网或手动重连。生产代码与R6已验证产物不变，完整操作与候选对照统一[手册33节](操作手册.md#33-平板随行建图nav-017)。证据目录`log/mapping_tablet_link_r6_20261014_Sw02Ow/`。

预期/实际：预期静止时输入健康、控制消息连续且不使能；21:16:17～21:17:19的60次采样跨62.679秒，均RUNNING/CURRENT、armed=false、x/yaw命令零；最大雷达年龄95.70ms、里程计39.55ms、车端控制状态52.18ms、网关心跳87.32ms、门控周期20.17ms，地图最大年龄2.996秒。该窗新收到11条`client_control_gap`（313～344ms），一次controller_disconnected及一次controller_connected；用户没有手动重连，因此不能登记为人工操作所致。该窗没有新记录到`client_script_delay`，但有限日志及事件节流不能证明网页线程完全无卡顿。原始`trace.jsonl`、按事件时间去重/过滤后的`summary.json`、前后公开诊断保留。

同步/邻近对照：本机127.0.0.1的20次HTTP请求均200，0.702～1.640ms；到本次平板IP192.168.5.54的30次ICMP探测0丢包，最小2.412ms、平均1049.453ms、最大4132.833ms，后段多条回复集中晚到。ping不经过页面JavaScript，证明至少存在网络/设备通信路径的迟延；0丢包不等于实时性合格，ICMP本身也可能受设备调度/限流影响，不能单独指定无线芯片、路由器或省电为唯一原因。随后到当前默认路由192.168.5.1的30次探测0丢包，1.086/9.148/185.255ms最小/平均/最大；两轮不同时，不据此宣称路由器长期正常或完全排除车端无线因素。bao历史地址192.168.5.36的SSH只读核对超时，未取得另一个客户端对照，不能将其当成有效低延迟参照。证据`ping_tablet.txt`、`ping_router_comparison.txt`、`localhost_http_latency.txt`、`bao_identity_readonly.txt`保留。

TCP/无线读数：前后控制连接端口发生变化，快照中的RTT/重传累计值只属于各自连接，不跨端口相减或累计。ESTAB控制连接有重传与待发送数据；另一个FIN-WAIT HTTP连接的约19KB待发送队列不能误作控制socket队列。当前5GHz/5200MHz、信号-52dBm、power_save=on，NetworkManager1.36.6的“小泽”连接省电配置为default；这些只读状态不证明故障原因。路由、接口、TCP快照与WiFi计数均保留，无设置变更。

结论/下一步：车端静止输入正常，平板通信连续性未通过；现阶段不转为实车推杆/路线验收，300ms保护不再放宽。优先准备单变量的车端无线省电临时off→on对照，再分别比较客户端/网络路径；不同时改多个设置。官方`iw`提供省电查询/设置，但本机RTL驱动的效果必须实测，[Linux Wireless官方说明](https://wireless.docs.kernel.org/en/latest/en/users/documentation/iw.html#power-save)。`sudo -n true`明确提示需要密码，代理未执行省电修改或复制受保护配置；手册33.12已提供同目录完整备份、约一分钟采样、自动/独立恢复和桌面维护记录步骤，当前标候选未执行。准备命令只做离线语法检查，不登记为网络调整实测成功。旧工程/原始失败/R6回归结果全部保留。

</details>

<details>
<summary>NAV-017-R7-PS1｜2026-10-14 直接执行车端无线省电临时对照，故障未消除</summary>

目的/范围与前提：用户明确“直接执行就好了”，代理继续核对实际权限，发现当前账号已有docker组管理权限、Docker29.8.1守护进程可用；原先“sudo需密码”的读数保持，但不能据此认定所有已授权管理通道不可用。沿用已确认的轮动力隔离或可靠架空、支架安全与未使能前提，固定当前WiFi/页面/300ms保护，只改变车端运行中的power_save，不重启网络或建图、不发使能/运动。证据目录`log/mapping_wifi_ps_ab_20261014_pV49S6/`，完整命令与独立恢复统一[手册33.12](操作手册.md#mapping-wifi-powersave-ab)。

备份/权限与实现：在原目录完整复制`小泽.nmconnection.NAV017R7.pV49S6.backup`，root:root/0600/296字节，并逐字节核对；不打印网络凭据。桌面维护记录修改前同目录完整备份`系统配置维护记录.md.NAV017R7.pV49S6.backup`，再追加2026-10-14-02的目的、运行值、实际过程、备份与回滚入口。使用既有本地镜像固定ID e065879588687681f8f9c785f473a85ffcba0c41b02941c9a9bbe999caaf4606，仅借其隔离运行环境，覆盖镜像入口执行只读挂载的宿主机工具/库；配置备份工具无网络能力，运行中省电工具只增加NET_ADMIN，不设置privileged或挂载整个宿主机。临时C++工具固定接口wlP1p1s0，提供query/probe/guard/restore，主试验60秒后恢复on，独立guard150秒兜底；代码与编译结果保留。没有添加账号权限、改sudoers、永久连接属性、systemd或硬件参数。

保留的首轮失效证据：21:42:01～21:43:01确实读回off并正常恢复on；采样从21:43:16才开始，65个样本全部on，因此`trace_all.jsonl`、`ping_tablet_trial.txt`只能作为恢复后on数据，不冒作off测试通过。该on段ping30包29应答（3.33%未应答）、平均19.210ms/最大110.098ms；比R7原基线已明显波动，进一步说明不能只比较两段不同时间的ping均值认定省电因果。首轮`probe.log`与独立guard日志保留；随后重新统一切换/采样执行流程。

有效第二轮：21:46:54～21:47:54（60.057秒）实际读回off，54次落在严格时间窗内的状态样本均RUNNING/CURRENT、armed=false、x/yaw命令零，最大雷达年龄93.96ms、里程计36.07ms、车端控制状态52.29ms、网关心跳87.33ms、门控周期20.05ms。窗内新收到7次`client_control_gap`，307～345ms，没有该窗断开/重连。不能用按60次循环文件粗略统计出的10次当作off结果：文件末尾已恢复on，必须按`round2_probe.log`实际开关时间过滤，严格结果在`round2_off_summary.json`。

恢复后对照：21:48:07～21:49:13的60次on样本跨66.310秒，同样均RUNNING/CURRENT、未使能、命令零；新收到10次303～350ms控制间隔，以及各4次断开/重连。最大雷达年龄95.98ms、里程计39.29ms、车端控制状态52.21ms、网关心跳87.33ms、门控周期20.04ms。两段没有新记录的script_delay，但不能据有限日志证明页面完全无卡顿。off/on采样长度不同，事件为车端收到日志的时间，存在传输延迟；次数差不能直接转成可靠收益或唯一根因。

同期短ping：off段30包0丢包，2.377/15.343/111.922ms最小/平均/最大；恢复on段30包0丢包，2.400/26.669/348.815ms。这两段各为约15秒窗口，不能把它们当整个一分钟控制链路的逐事件延迟，也不与R7的4.13秒峰值直接做唯一因果比较。ICMP正常与控制状态连续分别验收，off时仍有超时就是本次主要失败信号。

结果与恢复：主工具正常读回on，独立guard停止时也确认on；原连接文件与完整.backup逐字节一致，NetworkManager配置仍default，当前连接仍“小泽”。本次临时容器均退出清理，没有停止既有容器或删除镜像；服务PID7219、门控PID7277保持，未产生本轮S1/硬件重启。原始切换、两段全量诊断/严格汇总、TCP、ping、构建与guard日志均保留。关闭车端省电没有消除控制断流，当前不采纳永久修改。下一步应分别观察TCP消息发送/积压与平板接收处理时序，或在相同条件比较另一客户端/网络路径，不直接延长旧命令许可；物理停车和行驶验收仍待。

</details>

<details>
<summary>NAV-017-R8｜2026-10-15 数据流分频、控制收发隔离与重连修订</summary>

目的/范围：按用户“参考主流方案、保留当前方案并重新设计执行”的要求，修订C++网页传输和必要前端JavaScript。保留独立门控、300ms签发截止、底盘超时、旧接口/入口/工程及此前所有失败；不引入通用桥接/WebRTC运行依赖。固定官方来源、版本、许可证及取舍见[调研归档](archive/2026-10-15-网页建图数据流方案调研.md)，完整构建/启动/观察/停止/恢复统一[手册33.13](操作手册.md#mapping-dataflow-r8)。证据目录`log/mapping_dataflow_r8_20261015_HZd85l/`；执行前完整包/对应文档、旧网关/门控和地图工程已备份，避免覆盖其他未提交修改。

安全前提：离线夹具只用域219/localhost、127.0.0.1:18089与合成传感器/替身底盘，不打开真实串口/雷达/相机。生产服务部署前重新核对未使能、命令零，并先保存当前工程；本轮不自动启动新硬件任务，不把软件命令零或进程退出写成物理停稳。当前仅能使用原WiFi，现场10分钟通信、持续推杆和物理停车仍须反馈。

已复现问题：新增HTTP处理400ms停顿测试中，旧实现不能在150ms观察窗内处理停车请求；旧状态响应每次关闭TCP，不能复用连接。两项红灯证据在`red_http.log`，修订后均通过。真实网页协议重连测试进一步复现失败握手后的连接卡住；网页onerror原来只清空pressed，仍保留旧session/socket、等待close才重试，独立网页单测先失败，证据`red_socket_error.log`。修订为error/close统一且幂等清理，失败升级关闭HTTP连接，已关闭控制连接立即释放所有权。

数据流修订：普通HTTP处理放到独立串行工作线程，控制收发留在事件循环；HTTP连接复用，控制TCP_NODELAY。新网页轻量状态250ms、版本化激光预览200ms，单请求在途、同版本204，地图按版本和视频按需保持；预览源时间戳年龄单独累计、过期清空，重启/任务切换丢弃迟到响应。compact控制确认先回应后渲染，完整停车证据按需从诊断取；旧客户端/接口兼容。新增诊断含签发编号、回应年龄、应用覆盖/等待/过期丢弃及TCP快照；诊断数据不参与授权判定。

保留的验收失败：首轮完整回归两项新增测试失败：任务CURRENT先于首个预览/TF就绪，导致用空预览误比数据量；另一项在380ms直接读取100ms缓存的HTTP状态，可能先于最新停车状态传播。修订测试等待真实预览就绪，在550ms断流尚未恢复时于480ms观察，同时核对门控快照在许可截止后正常检查周期内撤销，300ms本体未改。第二轮仅显式重连失败，继而定位并修订上述错误路径。`ctest_full.log`、`integration_first_full.log`、`test_results_first/`、`ctest_final.log`、`integration_second_full.log`及`test_results_second/`均保留，不将它们改写为通过。

离线验证：Release目标包构建完成；10工具、27逻辑、13集成、7HTTP共57项C++全部通过，CTest四组111.17秒，证据`build_verified.log`、`ctest_verified.log`、`test_results_verified/`与`integration_verified.log`。真实app.js经HTTP/WebSocket连接C++网关/门控，在DOM替身下通过0/80/100ms单程延迟；FIFO突发80/150/180ms保持有效操控，550ms运动/闲置心跳断流均在原许可截止后的正常检查周期内撤销，恢复和重连不重放旧运动。底盘原有48项pytest通过（1.26秒）、既有Python静态编译、五份JS语法与XML格式通过。Safety实现未改，源码校验与验证时一致；这些不等同Android触屏或实物停车通过。

分流数据量：合成360点预览用例中，旧全量状态16140字节、轻量状态1029字节，扫描单独14820字节；同版本可204，源过期清空通过。此为一次隔离夹具响应测量，不是实际WiFi吞吐或总流量降低94%的结论；扫描仍独立传输、地图/视频另计。

真实浏览器未通过项：临时浏览器首轮因crashpad仍使用宿主机解释器而GLIBC_PRIVATE失败，证据`browser_smoke_stderr.log`；对浏览器及crashpad临时副本同时指定已有core24运行库后，data URL最小HTML渲染成功，`browser_smoke2.log`保留。随后真实触屏测试在0ms注入的`Page.navigate`超时，尚未进入应用；不计入57项默认协议回归通过。独立最小C++ HTTP页也不能被该临时Chromium访问，服务器请求日志为空；普通模式超时、single-process模式异常退出，证据`chromium_touch_verified.log`、`browser_http_*.log`及`browser_http_smoke.cpp`。这支持继续排查本机浏览器运行环境，不能据此认定用户平板不兼容；原snap/系统库未改，尝试原文见[环境归档](archive/2026-10-15-网页建图R8浏览器环境尝试.md)。

保存与部署：用户明确关闭占用唯一控制连接的网页后，临时C++保存客户端仅取得会话并保存，没有使能/运动/新建请求。工程`20261015_084123_98957241`的manifest完整、graph.data/graph.posegraph/map.pgm/map.yaml四文件SHA256通过；三个旧工程全部文件校验仍通过，证据`save_checkpoint.log`、`saved_bundle_verify.log`、`old_maps_verify_after_reload.log`。随后重载原用户服务，2026-10-15 08:41:24新网关PID23599 active/running，实际进程与构建/安装二进制SHA256一致，实际提供的app.js与源码一致；轻量协议1、诊断版本2、任务与phase均STANDBY，旧底盘/雷达/SLAM/门控进程已退出。证据`service_after_reload.txt`、`deployed_status.json`、`deployed_diagnostics.json`、`deployed_*_hashes.txt`、`deployed_bundles.json`。服务定义/无线/硬件配置未改，没有自动启动新硬件或发送新的S1启动值；待命状态无门控挑战，不能把此窗当成真实控制连续性验收。

部署后现场复测未通过：告知网页可打开后，192.168.5.17客户端重新连接并从网页启动真实任务，启动日志记录S1板端94/目标140.5°，仍无实体角度反馈；代理没有发送启动/使能/行驶请求。08:44:47与08:44:57日志再次记录浏览器前台心跳超时；最后有效挑战年龄233.02/171.64ms，之后请求间隔108.66/138.40ms，门控检查约20ms、传感器健康。08:45:02另有window_blur主动停车，不能与前两次超时合并归因。具体设备/浏览器和前台操作情况已询问，尚未收到确认，不能假设窗口始终前台。

随后60次只读采样跨62.680秒（08:46:53～08:47:55）均CURRENT、未使能、x/yaw命令零；最大雷达年龄90.29ms、里程计33.73ms、门控状态57.61ms、网关81.93ms、门控周期20.025ms。窗内新收到一次350ms控制间隔；同期采到回应总年龄302.02ms、浏览器报告距最近控制接收255ms、TCP待发送2254字节且累计重传43→45，连接代次均1。应用发送等待累计最大0.623ms、本地写入最大0.696ms，无应用覆盖/过期丢弃；浏览器报告值包含旧挑战的定时回应等待，不当成纯JS执行耗时。证据`live_before.json`、`live_trace.jsonl`、`live_summary.json`、`live_after.json`与`live_tcp_*.txt`。一秒采样会漏掉短峰，不能用采样最大值代替逐消息上界；该窗未使能，没有新permission_revoked不等于通信合格。

邻近只读网络对照：客户端60包59应答，1.529/9.364/70.802ms最小/平均/最大；同时路由器60包全部应答，1.133/8.758/113.219ms。窗口约30秒，开始晚于上述350ms事件；ICMP不能代替WebSocket连续性验收，也不据此排除无线/客户端TCP处理。客户端22端口拒绝连接，未取得远端系统/浏览器诊断；不能沿用历史Hao用户名判断本次设备身份。原始`live_ping_client.log`、`live_ping_router.log`、`live_client_ssh_readonly.log`保留，无网络设置变更。

下一步：数据流修订和重连缺陷已离线验证，真实通信故障仍未消除；已向用户明确说明，不能转为长距离建图验收。先结合本次设备/前台情况，在相同预览负载下对照另一客户端或可用网络路径，区分TCP传输停顿与客户端接收处理；保持300ms保护，现场连续性通过后再分别验收推杆/松手/断网/恢复与物理停车。当前真实任务由网页启动，代理没有再次重载或自动结束它，保存/结束仍按手册33节。

</details>

<details>
<summary>NAV-017-R9｜2026-10-15 WebRTC控制通道、每条新挑战一次回应与重启代次隔离</summary>

目的/范围：用户反馈R8仍有浏览器前台心跳超时，要求换思路；随后确认本次电脑浏览器一直前台，且先前小米平板浏览器同类现象。按共同协议/传输路径继续检查，不将特定平台或window_blur当作唯一解释。保留现有C++门控、Safety实现、旧WebSocket/HTTP、全部历史失败和工程。新增libdatachannel v0.24.6固定官方源码的数据通道，不启动新硬件、不改变系统/无线/驱动/底盘参数；输入新鲜度和车端签发后300ms截止保持。固定版本/3个所需子模块/许可证与官方来源见[专项调研](archive/2026-10-15-网页建图WebRTC控制通道调研.md)，完整操作/构建/退出与恢复统一[手册33.14](操作手册.md#mapping-webrtc-r9)。

实现：`RtcControl`封装ICE/DTLS/SCTP与线程回调，局域网host候选绑定信令连接的车端地址，不使用外部STUN/TURN；唯一操作者继续由`/ws/control`持有。可靠信令队列最多16条、满时断开，普通控制状态仍只保留最新待发；RTC数据通道验证unordered=true/maxRetransmits=0、控制包2048字节上限、缓冲非空不继续追加周期消息。运动/心跳走UDP，停车/松手同时走UDP与旧WebSocket；切到UDP后拒绝原TCP队列迟到的运动/心跳。RTC关闭/切换锁停，WebSocket断开同时关闭RTC；恢复不自动使能。源码与第三方库静态链接到网关，原许可证随安装保留。

发送/接收规则：未使能不发送操纵心跳；已使能每条新挑战最多一条周期回应，心跳与运动共用，定时器不重复旧挑战。首次按压与移动先更新本地意图，下一次新挑战发出，避免用已回应的旧挑战额外建立短剩余运动许可；停车/松手不等待。状态按`control_epoch/control_revision`拒绝旧包：门控重启换代次、编号重新从1计，旧进程迟到高编号不能恢复旧使能；新代次先锁停。车端Safety文件SHA256仍为`f72b4ee4c7e8af9a062f94124b21de6c649f044a1ec64572052fefdec37c9605`，没有把授权改为收包后重新计时。

证据与原始失败：执行前完整包/当前文档、旧网关/门控二进制和全部工程备份到`log/mapping_webrtc_r9_20261015_zkQjZK/before/`。旧库的RTC能力探针先红（welcome无rtc_protocol），`red_rtc_capability.log`保留。首轮构建在新增测试的JSON到SDP类型转换处报重载不明确，显式取string后修正，未改库源码；`build_first.log`保留。新增JS异步测试首轮未等VM微任务完成即检查offer，改为等待事件循环后通过，首轮`browser_rtc_first.log`保留。第一轮完整回归仅新UDP测试抢在100ms诊断快照更新前读取rtc.active=false；实际UDP收发与路由已成立，随后等待快照采样再断言。`ctest_full.log`、`test_results_first/`与`full_first_details.log`保留，不改写为通过。

真实浏览器环境与反馈回路：R8临时ELF副本只能渲染data URL，增加库路径后仍无HTTP访问；尝试原文和失败记录保留。R9使用项目内测试专用C++入口加bubblewrap，将已有core24/Chromium/GNOME/Mesa只读映射到隔离运行根，临时配置在/tmp，最小/dev无真实串口/USB设备。最小HTTP页面已收到GET并渲染，`browser_bwrap5_dom.log`及`browser_bwrap5_requests.log`保留；没有修改系统库、snap原件或安装浏览器。真实触屏测试连接合成域219/loopback的网关、门控与替身底盘，显式确认rtcActive，区别于默认DOM协议替身。

真实反馈发现并修正的调度问题：首版固定50ms门限与新状态回调并行，定时器先用旧挑战回应后，反而会把紧接着的新挑战节流；真实80ms单程触屏测试出现心跳撤销，`browser_actual_first.log`保留。改为每条新挑战一次回应，并将心跳/运动共用挑战去重，相关JS回归验证定时器不挡新挑战、首次按压不重复旧挑战、关闭/乱序/旧进程不恢复状态。`browser_actual_second.log`、`browser_actual_third.log`与逐消息`browser_third_trace.json`保留中间结果，不能将早期0/80ms通过直接当最终源码通过。

未通过的边界：`browser_actual_100.log`在100ms单程注入叠加浏览器调度时仍有前台心跳撤销，稳定拖动未通过。逐消息`browser_100_trace.json`中一次上行发送定时等待约149ms，而非预设100ms；原300ms许可先到期，车端按约20ms检查停车。该值是测试适配器/浏览器的时间，不是实际WiFi单程测量；默认纯协议100ms注入通过不替代此结果。不能靠延长旧运动期限消除此边界，也不能由这项测试认定某平台是现场唯一根因。

最终验证与部署：目标包构建通过；完整61项C++（11工具/27逻辑/13集成/10HTTP）通过，`ctest_verified.log`与`test_results_verified/`保留。最终源码真实Chromium0/80ms单程触屏分别通过，原有底盘48项和Python静态检查通过，RTC关闭的独立构建及8项HTTP通过；JS/XML/差异检查通过。用户明确本轮临时任务尚未开始正常建图、不用另存，并确认网页关闭；代理核对未使能、命令零、无连接后正常结束旧服务，启动新版到STANDBY，PID33952。运行/构建/安装网关SHA256均为`95460b9a8d381c0e63bad67b9f216a3874e0de9f56e44776b2c89a73d624e22c`；实际HTTP网页与源码逐字节一致，4份许可证可读，既有工程校验全部通过。`before_reload.json`、`service_stopped.txt`、`deployed_status.json`、`service_deployed.txt`、`deployed_binary.sha256`、`maps_integrity_deployed.log`保留。代理没有调用新硬件启动；物理停稳不由进程退出单独证明。

部署后现场反馈：用户重新打开并启动任务，确认顶部“控制已连接 · WebRTC”；选中UDP地址为车端192.168.5.11和浏览器192.168.5.17。第一次使能在车端单调47535.372～47535.683秒间未收到有效首次回应，约311ms后心跳撤销，不能宣布原问题消除。第二次使能47554.257秒，其后多次推杆/松手有效，最终47577.775秒由window_blur撤销；撤销快照pressed=false、心跳签发剩余约289.55ms，证明此次是静止窗口失焦规则触发，不是心跳过期。`field_rtc_first.json`、`field_rtc_second.json`、`field_focus_report.json`保留。该约23.52秒的软件使能/指令窗口不等于持续运动或实物停车验收。用户明确目标仅网页遥控建图，并反馈锁停条件过多；继续R10简化静止规则。

下一步：新版网页先确认显示WebRTC实际连接，保持未使能观察通信，再按手册验收持续推杆、松手、断网/后台/恢复与停车；未使能阶段不发送操纵心跳，没有撤销事件不能单独证明运动链路合格。控制通道关闭/过期仍须锁停；真实WiFi与物理停车不由源码、原生UDP夹具或浏览器离线通过宣布完成。

</details>

<details>
<summary>NAV-017-R10｜2026-10-15 静止不续操纵心跳、仅推杆失焦停车</summary>

目的/范围：用户明确最终只需网页遥控小车建图，连续反馈window_blur锁停，并指出多种普通情况都导致停止。依据R9实际撤销快照（pressed=false、心跳仍余约289.55ms），修正窗口失焦被无条件当故障；同时将“静止使能等待按压”与“正在执行运动指令”分开。保留现有WebRTC/旧WebSocket/HTTP分流、全部历史失败和工程；不改系统/无线/驱动/串口/速度/传感器参数。正式流程、构建/隔离测试/停止回退统一[手册33.15](操作手册.md#mapping-idle-r10)，官方参考与本项目取舍见[专项调研R10段](archive/2026-10-15-网页建图WebRTC控制通道调研.md)。

反馈回路：R9证据目录`log/mapping_webrtc_r9_20261015_zkQjZK/`内`red_idle_focus.log`先复现静止blur多发stop，改为pressed时才发后`green_idle_focus.log`通过。R10检查点与证据在`log/mapping_idle_r10_20261015_YGQvyy/`：`before_r10.tar.gz`完整包/对应文档、两个`before_mapping_*`从仍运行的R9进程复制，避免构建覆盖后无法恢复。`red_idle_guard.log`在传感器/会话持续健康、零输出的5秒静止测试中复现300ms前台心跳锁停；`red_idle_browser.log`复现新能力标记后网页仍发空闲心跳。两个失败均保留，修正后对应JS回归通过。

实现：Safety移除静止的presence截止撤销，运动`deadline_`仍严格从原挑战签发时计300ms；兼容heartbeat仍可检查原签发期限、记录序号/拒绝计数，但不能产生运动或延长deadline。新门控/compact状态保留`idle_heartbeat_required=false`，新网页据此静止静默，缺标记的旧门控继续旧规则。blur只在有未释放按压时双通道停车；页面隐藏/关闭/所有权断开、通道切换、关键会话/数据/拓扑故障仍锁停。松手序号屏障保留，旧包/旧状态/重连/挂起不重放动作。代价：静止时脚本挂起不单靠操纵心跳撤销就绪；此时本来没有可执行运动，新运动仍须实时状态、有效挑战与新的用户按压。

验证新增/调整：门控5秒无心跳静止保持就绪、运动后松手等待3秒仍零且可用新挑战再次推杆、旧序号拒绝、运动截止仍撤销；兼容心跳过期只作诊断、不创建运动。原真实HTTP/WS协议550ms FIFO断流用例区分“运动断流须停车”和“静止断流保持零”；重连仍清按压并另行使能。真实Chromium补静止blur不锁停/无空闲heartbeat、推杆blur停车/重新使能，再冻结页面检验运动截止。此前R9真实100ms稳定操作失败独立保留，不当成R10结果。

首次按压修正：`browser_boundary_100.log`先通过静止/使能阶段，再在第一条旧挑战运动时超时（最近接受年龄约263.91ms，剩余约36ms）；取消空闲心跳后，旧挑战不再自然被心跳去重。新增`red_first_press.log`复现首次按压立即使用静止旧挑战，改为能力标记false时等下一条新挑战才发送，旧门控仍保留原行为；`green_first_press.log`通过。这是网页调整，无需重启硬件。随后`browser_first_press_100.log`第一段推杆/松手已通过，但再次按压后仍发生运动截止，最近接受42号运动、签发年龄约208.51ms，随后检查期限已过约0.044ms；持续操控仍未通过。该测试注入双向各100ms并叠加浏览器调度/数据通道交付，不是现场WiFi延迟测量。

最终验证：目标包构建成功，第三方头文件的既有pedantic警告保留，未修改上游代码。完整62项C++（11工具/28逻辑/13集成/10HTTP）通过，`ctest_full.log`、`test_results_verified/`保留；底盘48项/Python静态、JS/XML/差异检查通过。首次按压最终网页修正后，重跑3项真实HTTP/WS协议用例（含0/80/100ms与FIFO断流）和工具组通过；真实Chromium最终0/80ms单程全部流程通过，覆盖静止无心跳、静止blur保持就绪、推杆blur锁停、松手/再推/冻结与恢复；`browser_protocol_final.log`、`tools_final.log`、`browser_first_press_0.log`、`browser_first_press_80.log`保留。真实100ms失败独立登记，不将62项回归全绿写成全部浏览器边界通过。

部署：用户确认已停车并关闭网页后，代理再次核对未使能/零命令/无控制连接/无操作在途，按此前不保存本轮临时任务的要求正常重载，未覆盖已保存工程。新版网关PID38000、用户服务active/running、STANDBY，无底盘/雷达/门控/SLAM子进程；运行、构建与安装网关SHA256为`13f3b770ee1883092235e1dfe5657001e0aaf58b68a785594eb7782e283dbedc`，门控构建/安装SHA256为`65ab7a857ebe0248d9eba9db1940f8202c84063aff78c63953cbae85271d78d2`。Safety更新后SHA256为`e0a325e275626facbcc1034464927896ee42c8876bdfffd38db5e50648e3fafe`，变更为静止不撤销，不是扩大运动签发期限。实际HTTP网页与最终源码一致、源码校验通过，旧工程文件SHA256全部通过。`before_reload_final.json`、`service_deployed.txt`、`deployed_gateway.sha256`、`deployed_guard.sha256`、`maps_deployed.log`保留。代理未启动新硬件、未发运动/S1命令；实际停车仍以现场反馈为准。

下一步：用户重新打开刷新、启动本次任务后检查新门控`idle_heartbeat_required=false`，先验证静止等候/切窗口，再按同一路线、同速度验收推杆和松手。静止无操纵心跳是新规则，不把旧计数不增加或旧presence诊断为负当故障；现场持续运动及实际停止尚未由本轮待命核对证明。

</details>

<details>
<summary>NAV-017-R10-OBS1｜2026-10-15 用户不在车旁时的新规则日志只读核对</summary>

目的/前提：用户反馈新版似乎不再退出，要求通过日志检查，明确本人不在实物旁。仅HTTP诊断、服务状态、当前任务完整日志及ROS话题订阅，不使能、不停车、不发速度/S1、不重载、不保存/覆盖地图。操作与诊断判读统一[手册33.15](操作手册.md#mapping-idle-r10)。证据在`log/mapping_log_audit_r10_20261015_aKrnsK/`；`before.json/after.json`、`task_before.log/task_after.log`、`samples.jsonl`、`samples_indexed.jsonl`、`summary.json`、`new_events.json`保留。原采样序号字段因jq引用输入而为null，索引副本按文件顺序补0～30，原时间/读数不变，原文件保留。

结果：北京时间11:32:53～11:33:55，31次采样，按task_age单调差约61.80秒（壁钟整秒差62秒），任务年龄181.84→243.64秒；全部CURRENT/RUNNING、error和health为空、WebRTC active且唯一连接代次始终1。PID38000/active/running、NRestarts=0前后一致，没有任务退出或服务重启。增量服务事件为空；完整任务日志前后逐字节一致，无新增ERROR/FATAL/异常/超时/permission_revoked。

数据年龄（程序接收年龄，非物理延迟真值）：雷达0.27～95.99ms、轮式里程计17.41～39.05ms、车端控制状态13.19～53.34ms；地图0.004～2.905秒符合约3秒发布，版本live-59→live-80。控制状态编号2980→4010，RTC库发送调用2979→4009，无缓冲积压/追加等待/背压丢弃，信令TCP累计重传0→0；TCP指标不当作UDP RTT。`rtc.received`维持25、accepted_sequence维持22是静止不发操纵心跳的正常现象，不能据此判成断流；库发送计数也不证明浏览器每个UDP包都收到。

控制/反馈：全31次armed=true、pressed=false、x/yaw=0，`idle_heartbeat_required=false`、last_stop为空、拒绝请求0。额外只读一次`/mapping/cmd_vel`得到线/角各轴0，一次`/wheel/odometry`的twist同样全0；前者为软件命令，后者为编码器推算反馈，均不单独证明实物已停稳。历史日志本轮11:30:06使能、11:30:42.692首条drive、11:30:43.988松手，约1.30秒按压期接受到22号运动请求，最近请求挑战年龄约7.55ms、间隔约61.45ms；首次drive时x/yaw为0，后续逐条速度未完整记录，不能宣称实车连续行驶通过。

提示判读：启动时有两条SLAM雷达Message Filter队列满丢帧，分别在11:29:55.530与11:29:58.058；其后注册传感器并进入CURRENT，观察窗未再出现。启动时拓扑/建图会话未就绪状态发生在尚未使能阶段，随后健康恢复，不计当前故障。启动日志S1=94是用户本轮启动时驱动的历史下发，无实际角度反馈，本次审计没有发送执行器命令。

结论/边界：本轮静止等待不再复现前台心跳、权限过期或window_blur误锁停，车端数据链和控制连接在该观察窗健康。用户不在车旁，因此不做远程运动验收；后续持续推杆、实际方向/速度、松手/断网的物理停止及长时间建图仍待现场验证。没有新的故障证据，本轮未修改代码、系统或硬件设置。

</details>

<details>
<summary>NAV-017-R10-OBS2｜2026-10-15 新通信间隔提示、网页操作停车与历史提示判读</summary>

目的/范围：用户再次询问是否报错；沿用上一轮只读范围，仅检查HTTP诊断、服务状态和完整任务日志，没有发送控制、重载、启动硬件或修改代码/系统/地图。诊断与概念见[手册33.15](操作手册.md#mapping-idle-r10)。证据目录`log/mapping_log_audit_r10_obs2_20261015_lJ0fpR/`内before/after诊断、完整任务日志、16次采样与summary/new_events、服务状态保留。

已确认时序（北京时间，网页client_*时间为车端接收诊断事件时刻）：12:00:54网页先发送disconnect停车，RTC关闭并断开所有权；12:26:52重新连接，12:26:53报告page_visible，12:26:54建立WebRTC，12:26:57使能。恢复时还接收数条约60000ms/679252ms的script_delay和长HTTP间隔，这些指标可能是页面不可见阶段累积后补发，因车端未保留原client_time，不能逐条认定为接收瞬间新发生的卡顿，也不能据此归因特定平台。

新提示：12:27:42接收client_control_gap=346ms（HTTP间隔459ms）；静止就绪时没有因此撤销使能或产生速度。12:27:59接收client_operation，并记录网页请求停车operation撤销；12:28:08另一次operation，当前操作结果为“视频已关闭”，支持操作辅助视频的上下文，但单条operation日志未包含具体接口，不能证明每次各点了哪个按钮。12:28:19接收script_delay的loop_gap_ms=3385，表示50ms计时回调发生长间隔，不单独证明是网络延迟或浏览器执行耗时；12:28:20已重新使能。最近停车记录仍为operation，当前armed=true，不能把历史last_stop当当前仍被锁停。

补充观察：12:28:59～12:29:30，task_age差30.90秒，16次采样全部CURRENT/RUNNING、error/health为空、已使能但pressed=false、x/yaw=0、WebRTC active，连接代次始终2、RTC缓冲0。雷达接收年龄最大84.68ms、里程计38.86ms、车端控制状态53.23ms、地图2.805秒。增量事件为空、完整任务日志逐字节不变；PID38000、NRestarts=0，任务未退出，原任务已运行约59分钟。

结论：出现了新的通信/页面调度提示，不能称抖动完全解决；没有新的前台心跳或运动授权超时。operation与disconnect属于网页请求停车，恢复后已重新使能。OBS1结论仅对当时约62秒观察窗有效；这些>300ms间隔若发生在推杆期间仍可能造成期限停车，持续操控/实物停止尚未验收。本次只记录事实，不为避免提示而放宽运动期限，也不把全部提示归咎浏览器平台。

</details>

<details>
<summary>NAV-017-R11｜2026-10-15 WebSocket短空闲回收连带关闭RTC的复现与修正</summary>

目的/范围：用户继续反馈概率性断联，要求继续解决。执行前旧版诊断connection_generation=21，后续33，出现connected=false但rtc.active=true的过期快照；多次HTTP查询超时前后仍有新鲜控制状态，随后整个操作者断开。旧代码没有保留read/write关闭错误，因此不能仅凭最后client事件后约2秒推定现场实际一定发生Beast超时。按连接空闲回收、RTC自身失败、页面主动关闭/暂停三个方向区分；本轮不修改无线/系统/驱动/速度/传感器或Safety运动期限。固定Boost1.74源码/许可证及边界见[专项调研](archive/2026-10-15-网页建图WebSocket连接超时调研.md)，构建/复现/只读诊断/停止与回退统一[手册33.16](操作手册.md#mapping-connection-r11)。

检查点/反馈回路：`log/mapping_connection_r11_20261015_P1oPXb/`内完整包/当前文档、运行中的R10网关和旧门控、全部已保存工程SHA256及任务日志已保留；未覆盖其他未提交修改。新增真实loopback UDP的`BriefTcpSilenceDoesNotTearDownHealthyUdpController`，握手完成后只暂停TCP读取/自动pong约3.4秒，原生RTC双向继续每50ms收发。旧代码失败：约2秒后断开1次、connected=false、双向仅各收到38条；原始`red_tcp_idle.log`保留。这个最小复现不依赖真实WiFi/ROS/浏览器，测试的是“健康UDP被过短TCP回收连带关闭”路径，不能代替现场归因。

实现：Beast WebSocket idle_timeout从2秒改10秒，keep_alive_pings保持true；固定1.74约半周期发ping，总期限内仍无接收才回收，UDP不会自动重置该计数。运动仍由Safety签发后300ms截止、约20ms门控检查，与会话回收相互独立。真实显式关闭/网络错误仍立即关闭所有权及RTC，恢复不重放运动；代价是无响应旧操作者可能多占唯一会话约8秒。

诊断：首个关闭事件记录reason/stage/error_category/error_value/error_message、peer_close_code、rtc_was_active、WS最后接收年龄及ping/pong接收计数，先完成快照再由网关保存controller_disconnected历史。handshake超时和idle超时分开。关闭后同步connected=false、control_transport=disconnected、rtc.active=false、tcp_sample_valid=false，旧TCP数值仅作历史快照；重新连接时last_disconnect仍为历史。网页诊断/导出保留transport/reply_timing，浏览器socket_closed另带关闭码和是否干净关闭，不改变控制权限。

验证：目标包构建通过，第三方头文件既有pedantic警告原样保留。完整63项C++（11工具/28逻辑/13集成/11HTTP）通过；其中3.4秒TCP暂停不再关闭健康UDP，完全不回应的旧连接约10秒后回收并可重连，记录idle_timeout/read/零pong和接收年龄>=9.5秒；对端TCP关闭会同步清理RTC诊断。`test_http_green.log`、`ctest_final.log`、`test_results_verified/`保留。最终源码真实Chromium0/80ms单程流程通过，覆盖使能、静止/推杆失焦、拖动/松手/再推及冻结停车/恢复；底盘48项、Python静态、JS/XML/差异检查通过。R10真实100ms持续操作失败历史保留，本轮不声称扩大稳定操作边界。

旧通道与显示收尾：RTC关闭的独立HTTP构建/8项测试通过，长期无回应回收约10.01秒，`build_off.log`、`test_off.log`保留。用户确认关闭网页，并补充有概率断开、页面闪烁及下方红字；代码中恢复使能后仍常驻显示“最近锁停”，增加显示区分：CURRENT、控制新鲜、已使能且健康时改为“上次停车记录（当前已就绪）”并使用普通文字色；其他情况仍保留停车提示，诊断原文不删。不改变停车逻辑、不重启硬件。显示修正后既有JS用例和最终真实Chromium0/80ms重新通过，`browser_display_js.log`、`browser_display_0.log`、`browser_display_80.log`保留。

部署：用户明确已关闭网页后，再核对busy=false、dirty=false、未使能/零命令/无连接，按此前不另存本次临时工程的要求正常结束旧任务，再启动新版到STANDBY。用户服务PID43792、active/running、NRestarts=0；运行/构建/安装网关SHA256一致为`c581d0d796fc156add2fef42fa9dc09842b88c311398fc862d3a830484f4784f`，门控构建/安装仍为`65ab7a857ebe0248d9eba9db1940f8202c84063aff78c63953cbae85271d78d2`。Safety仍为`e0a325e275626facbcc1034464927896ee42c8876bdfffd38db5e50648e3fafe`，运动期限未放宽。实际HTTP网页/样式逐字节匹配最终源码、全部旧工程校验通过，现场只有网关进程，不由代理新启动底盘/雷达/SLAM/门控或下发S1。`before_reload_final.json`、`service_deployed.txt`、`deployed_gateway.sha256`、`maps_final.log`及源码两阶段校验保留，原构建/回归版本与显示收尾版本不混写。

部署后只读观察：北京时间13:27:20～13:29:23共61次采样，全部STANDBY、error为空、session_idle_timeout_ms=10000；没有网页接入，连接代次0/断开0。该结果只证明新版待命服务和配置正常，不能当成已有客户端的稳定性验收，`live_samples.jsonl`、`live_after.json`、`live_summary.json`保留。下一步重新打开网页，若再次断开，先按新增last_disconnect的stage/error和WS最后接收/pong判断，再区分页面主动关闭、TCP空闲回收与RTC自身失败；旧现场未记录的错误不追补为已确认。物理停车、持续行驶和较长时间真实WiFi仍待现场反馈。

</details>

<details>
<summary>NAV-017-R12｜2026-10-15 HTTP状态异常分支仍会撤销静止就绪</summary>

目的/证据：用户回复window_blur及旧“最近锁停”文案。车端R11进程PID43792、当前任务完整日志`task_8c4f834d7f9ed47ca3a87c6bfec417df.log`没有window_blur，实际13:53:17和13:55:07两次control_stale停车快照pressed=false、健康为空；另一次为换档停车。当前连接在线、仅一条peer_close正常对端关闭历史，没有新的idle_timeout；仍有HTTP查询超时及浏览器控制消息间隔超过300ms。服务器实际app.js与源码一致、Cache-Control=no-store，但服务端不能由此证明某个已打开页面加载了哪版；用户文字来源尚不能确定，不登记为平台特有故障。

复现/修正：证据`log/mapping_idle_http_r12_20261015_XD4beq/`保留执行前完整网页/对应文档和任务日志。新用例直接拒绝真实app.js的待处理/api/status Promise，并推进控制状态过期，旧代码在松手时仍发送stop，`red_http_idle.log`先失败。将poll异常分支改为pressed且controlFresh=false时才停车；静止只记录查询失败、等控制恢复，不产生运动；下一轮相同HTTP/控制失败发生在按压未释放时仍清按压并停车，`green_http_idle.log`通过。没有改车端二进制、10秒会话回收、300ms运动签发截止或传感器阈值。

验证/交付：工具组11项（包含新增真实JS异常分支）、3项真实HTTP/WS协议（0/80/100ms与FIFO断流）、真实Chromium0/80ms单程流程及JS语法通过，`tools_verified.log`、`browser_protocol_verified.log`、`browser_actual_*.log`保留。实际HTTP网页逐字节匹配源码，仅网页更新，不结束现有任务、不重发S1，不写执行器。诊断新增ui_version=20261015-r12，网页握手后低频上报client_ui_r12，便于核对实际加载版本。截止本次核对该事件未出现，现场仍是未使能/零命令、control_stale上次记录，不能把源码修正当现场误锁停已消失。旧63项C++/48项底盘基线为R11结果，本轮未重复全部；保留真实100ms持续操控未通过边界。

操作/边界：见[手册33.15](操作手册.md#mapping-idle-r10)，保持松手停车后刷新网页即可，连接重建会撤销使能，另行使能，不需重启建图/底盘。HTTP或控制通信停顿仍存在，修正仅消除静止异常分支误撤销；推杆时仍须原期限停车，持续行驶和实物停止仍待现场验收。

### NAV-017-R12-OBS1｜2026-10-15 交接状态只读复核

目的/范围：核对交接摘要与当前状态，不使能、不发控制或S1、不重启建图、不修改运行代码/系统/地图。只读诊断与网页回归入口沿用[手册33.14](操作手册.md#mapping-webrtc-r9)，版本与状态判读见[33.15](操作手册.md#mapping-idle-r10)。证据保存在`log/mapping_r12_obs1_20261015/`的`diagnostics.json`、`browser_rtc.log`、`service.txt`。

预期/实际：14:05:49诊断CURRENT/RUNNING、task_age约832.40秒、error/health为空；服务PID43792、active/running、NRestarts=0。当前armed=true、x/yaw命令为0，最近control_stale仍为13:55:07历史停车；这更新交接摘要的瞬时状态，不改写历史结果，也不证明实物停稳。WebRTC在线、连接代次2、断开计数仍1，当前80条事件未见client_ui_r12，不能确认浏览器加载补丁。

停顿证据：14:04:31接收client_control_gap=315ms；14:05:08接收HTTP查询超时，对应http_gap_ms=1752、control_gap_ms=19。其他已有HTTP超时事件的控制间隔为5～26ms，支持分别观察HTTP查询和控制状态接收，不能把HTTP超时等同控制断流，也不足以定位网络或浏览器根因。事件时间为服务端接收时间，不视为客户端故障精确发生时间。

离线验证：再次执行真实app.js的RTC浏览器回归通过，包含HTTP失败时松手不撤销、仍按压且控制过期时停车；历史红测确曾报“HTTP查询失败误撤销松手后的静止就绪”。实际HTTP app.js与源码SHA256均为`5fca135b43317cdc2a2314a61b96e6cc8083161ed0e8a7c97de2b37d1c36bf2f`。本轮只补充证据和文档，保留全部原始实现/失败记录；未重复构建或车端运动测试。下一步先核对客户端R12版本，再据新的同窗时序排查停顿；300ms运动期限、10秒会话回收保持，长期通信和实物停止尚待验证。

</details>

## CAM-005：2026-10-15 D435体素、组件通信与GPU核实

<details>
<summary>处理顺序、离线回归、隔离短窗、GPU跟踪与未验项</summary>

目的/范围：按用户要求降低D435深度点云处理/传输开销并核实GPU。新增C++ `DepthCloudFilter`组件和XML `camera_navigation_composed.launch.xml`；原独立进程可执行入口保留，体素默认仍关闭。新入口默认IPC=true、VoxelGrid=true、边长0.01 m，原高度/自体/时间确认完成后才降采样标障；清障保持密度、原header/TF/0.5秒健康门槛不变。无清障订阅时省去其消息缓冲构造，计数仍保留。配置与来源/许可证只见[相机包说明](../src/carcar_camera/README.md)，完整构建、对照、启动、观察、停止/恢复统一[手册36节](操作手册.md#36-d435体素降采样组件通信与gpu核实cam-005)。

安全与前提：Jetson实机，D435当时未占用，既有建图任务start_camera=false；本轮相机/模型仅域87/localhost，未打开新串口或下发车轮/舵机命令。使用历史94档候选固定TF只为计算路径，不确认本次实物姿态、地面和目标位置。源流640×480/6 Hz，深度单流、原生宽视场；无RViz、STVL/Nav2或移动测试。既有建图和其他后台负载继续存在，期间另有构建，因此耗时仅短窗样本，不作稳定整机CPU对比。

离线验证：目标包RelWithDebInfo构建通过，已有Python底层资产compileall通过；相机包报告 **62 tests / 0 errors / 0 failures / 0 skipped**。新增用例覆盖质心、负坐标格、稀疏点保留、空输入与无效边长；真实组件/同进程合成消息覆盖跨帧时间确认后降采样、清障密度、header、有效空标障更新、过期撤销健康、旧入口默认关闭体素。测试域86及包内既有隔离域，无实物运动。验证证据 `log/d435_optimization_20261015/build_final.log`、`tests_final.log`、`test_results_final.log`。

预期：同场景减少标障点数、IPC实际收帧递增、短窗≥5 Hz/间隔及时间戳≤0.5秒且无异常；不以帧率提升作为门槛（相机仍设6 Hz）。实测如下，点数/耗时取RUN诊断中不同processed_frames的最近帧样本平均，诊断5 Hz不会覆盖全部6 Hz相机帧：

| 组别/证据目录 | 健康15秒 | 标障平均点数（前→后） | 筛选总耗时 / 体素耗时均值 |
|---|---|---|---|
| 原程序初始基线 `baseline_health` | 87帧、5.800 Hz、75诊断0异常、最大间隔0.334 s | 原程序无新增性能列 | 未测 |
| A 新代码独立进程、体素关闭 `a_separate_health` | 87帧、5.799 Hz、75诊断0异常、最大间隔0.333 s | 48374.6→48374.6 | 16.515 / 0.000 ms |
| B2 同容器IPC、体素关闭 `b2_composed_health` | 88帧、5.866 Hz、75诊断0异常、最大间隔0.333 s | 48386.0→48386.0 | 16.442 / 0.000 ms |
| C 同容器IPC、1 cm体素 `c_voxel_health` | 88帧、5.866 Hz、75诊断0异常、最大间隔0.334 s、最大stamp_age 0.0221 s | 48405.7→931.3（减少98.08%） | 18.398 / 4.295 ms |

C结束诊断实际IPC接收118帧、跨进程接收0，已处理118帧；两组件由同一container加载，运行日志显示驱动和筛选均启用IPC。清障计数平均约104932点，仅通过合成组件回归核对未降采样输出；本轮实机没有订阅/逐点审计清障。源/健康统计工具本身订阅原始点云，仍触发外部DDS传输，不能称整条链路零复制。点数和字节下降不表示原始深度分辨率改变；VoxelGrid额外CPU成本约4.3 ms/帧，不能由当前样本声称整车CPU已降、Nav2变快或空地误标修复。

原始异常保留：首次B因A后台Launch的SIGINT停止未生效，旧相机仍占用，出现 `Device or resource busy`，`b_composed_launch.log`/`b_composed_health` 不计有效对照。已结束这些测试进程，改按独立进程组停止并核对释放，再做B2；不改写首次B为通过。相机正常启动中已有的无纹理/参数范围警告亦保留，不能据此宣称整条USB链路已验收。

GPU核实：初查过滤器名 `Pointcloud (NEON)`、整机1秒采样GR3D_FREQ=0%曾误判CPU路径；启用SDK日志、核对固定2.58.4源码后纠正。ARM混合实现沿用NEON名称，SDK日志明确 `Using CUDA-optimized pointcloud implementation`；独立 `depth_compute_probe` 返回cuInit=0、cuDeviceGetCount=0、设备数1。**决定性证据是实际相机容器的Nsight跟踪**：20秒记录内捕获 `kernel_deproject_depth_cuda` **104次**，累计45.106432 ms、平均 **0.433716 ms/次**；cudaLaunchKernel 104次、cudaMemcpy 209次。GPU用于深度反投影，本项目PCL VoxelGrid/高度/时间筛选仍在CPU；未修改SDK/系统或另写CUDA体素实现。短核函数占空比低，整机整数百分比显示0不能否定调用。`align`选择日志只代表创建处理块，本轮align_depth=false，不能说RGB配准也执行了GPU内核。

证据：本地 `log/d435_optimization_20261015/compute_probe.log`、`cuda_profile.log`、`cuda_actual.nsys-rep`、`cuda_stats.txt`、三组health的summary/diagnostics/raw_frames.csv及launch日志均保留。Nsight跟踪独立于性能窗口，不把跟踪开销混入上表。完整报告含209次拷贝，不能以组件IPC称SDK内部CUDA传输为零复制。

结论/下一步：代码和隔离相机短窗通过，GPU实际调用已确认。候选尚未验600秒、真实2 cm/边缘/遮挡目标、误标、下游地图格保留及移动延迟；不替代原NAV-016安全结论，不写入原整车默认。结束时新增相机/模型/测量进程均退出，D435恢复无所有者，原建图任务保留；无系统配置、硬件姿态或动力状态变更。

</details>

## APP-001-R1：网页点位、分步调角与车端巡检首版（2026-10-15）

<details>
<summary>目的、代码、离线证据、历史失败与现场边界</summary>

**目的／范围：**将已讨论的单点固定角度／单张RGB照片、网页示教、顺序编辑、独立最终停车位及断网页继续执行落实为代码。原APP-001的设计归档记录保留，本项不把旧“未实现”历史改写为已通过。

**安全／硬件前提：**本轮只在隔离域227运行C++测试，域228运行Python适配测试，域229运行配置预览。厂商串口、fuser及ioctl被替代，导航／传感器／TF／地图由夹具提供；没有本轮真实串口打开、舵机／车轮命令、系统配置修改或建图服务重载。真实浏览器通过只读映射已有snap库及中文字体运行，最小/dev不提供真实串口／USB设备。用户明确授权仅扩展既有Python驱动的舵机转发与必要停车联锁，不新增Python节点；其余车端新增逻辑为C++，网页交互为JavaScript。

**对应代码／配置：**`carcar_inspection`的 `console_node.cpp`、`store.cpp`、`executor.cpp`、`Teaching`、`config/console.yaml`、Vue网页和两个XML入口；`carcar_interfaces`新增停车保持／舵机服务；既有 `rosmaster_node.py` 增加默认关闭的适配接口、独占检查及零输出联锁。`carcar_mapping_console`仅新增不启用RTC的共享HTTP导出，既有建图／WebRTC入口保留。完整构建、观察、诊断、停止／恢复及现场前提统一[手册35节](操作手册.md#35-网页巡检与逐步舵机示教app-001-r1)，技术选型见[应用说明](../src/carcar_inspection/README.md)。

**预期：**先保持停车、按1°目标逐步下发、等待新画面，再人工确认；旧修订号／旧图不能保存；板端越界、跨档、过期、旧驱动代次和非所有者拒绝。重试不重复写串口；已接受任务不依赖网页推进；最后一张照片之后仍须最终停车。图层旧证据不得恢复运动；导航及保存失败分别红／黄报警、终止本轮，不再前往终点。

**实际／日期／结论（2026-10-15，离线通过）：**

| 验证 | 实际结果 |
|---|---|
| 构建 | 网页生产构建及独立前缀内接口、底盘适配、共享HTTP、巡检包构建成功；最终巡检构建保留GCC对既有common.hpp的ABI说明，不是编译错误 |
| C++核心 | 14项通过：机械量化上限、单角度／终点约束、配置修订冲突、持久化与重启中断、调角新帧／人工确认、行为树失败／取消／暂停及最终停车 |
| 实际ROS／HTTP／浏览器集成 | 6项通过：配置模式零执行器请求；两个点位各一张、断开网页后继续、终点第三次导航并保持停车；真实浏览器确认；旧图层证据拦截；导航失败单次红色三秒报警；照片写入失败单次黄色三秒报警 |
| Python适配 | 57项底盘测试通过，含新增默认关闭、显式服务启用、忙串口在厂商构造前拒绝、内核独占调用替代、锁存停车、边界／过期／重放／驱动代次／回位释放和写失败保留保持 |
| 网页 | 3项Vitest通过；真实Chromium在1280×900及390×844视口完成实际点击并无页面异常／手机横向溢出。截图使用20×20栅格、0.1m分辨率的合成map及32×24合成RGB；屏幕像素与镜头／实物尺度无直接等价关系 |
| 原入口回归 | 28项旧门控／坐标／工程逻辑及8项HTTP回归通过；测试为临时前缀关闭RTC构建，不替换原运行安装 |
| 静态与资源 | 本轮修改的Python驱动及新增适配测试通过py_compile与flake8；XML入口只做参数展开，不启动实机；网页锁文件、Vue及项目许可证随静态资源保留 |

**历史失败与证据：**初期构建签名／测试宏问题修正；首次运行发现SQLite绑定名称冲突和测试夹具初始化顺序，后续发现旧状态快照与浏览器调试pipe／文字定位问题，已分别修正。原输出和最终逐用例结果保留在[证据归档](archive/2026-10-15-网页巡检离线验证/README.md)，不把中间失败删掉或当现场故障。数据库文件及地图使用测试临时目录，真实地图只读。

**配置预览：**8081监听于Jetson，本次地址读回192.168.5.11；GET状态确认 `hardware_enabled=false`、`navigation_enabled=false`、页面版本 `inspection-20261015-1`，可读取6份地图条目。该预览仅编辑草稿／任务，不连接实际域31，传感器待就绪为预期；没有通过预览下发真实控制。

**问题／下一步：**真实S1方向、实际角度、端点、回位重复性、物理停稳、相机TF及深度模式切换、完整导航和实物声光仍待现场验收。R1文件同步重命名与SQLite索引不是跨文件事务，掉电中间状态的自动关联修复待补；云端协议与上传程序未实现，照片显示待配置上传。后续按手册先静止分步调角及人工确认，再独立验证回位／导航，不因本项离线通过扩大硬件授权或修改既有NAV结论。

</details>

## APP-001-R2：明确网页位置标记入口（2026-10-15）

<details>
<summary>用户反馈、网页修改及离线证据</summary>

**目的／范围：**用户反馈找不到位置标记按钮。核对发现R1隐含“直接点击地图”，且两个车辆位置按钮含义易混；8081预览当时未选地图、没有定位输入。新增明确的地图选点按钮／四步提示、未选位置禁止保存、实车定位缺失原因，以及独立的最终停车位入口。车辆初始定位折叠显示并改名“提交小车初始定位”；“记录小车当前位置与朝向”复制定位估计。新增点位无需先有实车定位。

**安全／前提与代码：**仅修改 `web/src/App.vue`、`style.css` 和真实浏览器脚本 `web/test/browser.mjs`；车端接口、导航和驱动保持。浏览器验证在隔离域227的本机18189与模拟传感器／导航／执行器接口完成；页面预览仍为域229、硬件／导航false，无串口或实物命令。完整操作及停止／恢复见[手册35.3.1](操作手册.md#3531-网页位置标记入口app-001-r2)，测试入口沿用35.2。

**预期／实际：**网页生产构建和3项Vitest通过；扩展真实浏览器用例通过，验证选择坐标／拖动45°朝向、保存未确认草稿、刷新读取、390×844手机页面选择独立最终停车位及任务保存。选点阶段记录的POST仅包含点位／任务保存，未调用初始定位、遥控或舵机接口；原停车→逐步目标→新画面→人工确认仍通过。未选点及未选最终停车位的保存按钮禁用，页面无异常和横向溢出。原14＋6项R1结论保留，本轮仅重新执行受影响的浏览器用例，不重复宣称全套测试重跑。

**交付／证据：**静态资源已复制到8081现有安装目录，HTTP读回HTML／JS与本次构建逐字节一致；未重启8081或8080，保存地图及原入口保留。当前地址读回192.168.5.11；GET仍确认硬件／导航false，地图未选择。浏览器原始结果见[position-r2-browser.log](archive/2026-10-15-网页巡检离线验证/position-r2-browser.log)。合成地图20×20格、0.1m/格与模拟RGB只验证软件交互，不代表实车标定；实车示教、定位准确性及舵机角度／重复性待现场确认。

</details>

## NAV-017-R12-OBS2：无视频对照前只读核对（2026-10-15）

目的：按用户要求先停用摄像头，建立推杆失去使能的无视频对照。前提与安全：只读现有8080状态／诊断、进程列表及视频HTTP，不连接控制会话，不发运动／舵机／初始定位，不停底盘或传感器；现场复测按[手册33.5](操作手册.md#335-摇杆与停车验收)保持人随车目视、慢档和停车恢复措施。

实际19:24读回 `video_requested=false`、`video_running=false`，结果“视频已关闭，目视随行遥控可继续”，相机／RealSense进程不存在、视频HTTP503。底盘／雷达／SLAM原进程保持，CURRENT/RUNNING；雷达与里程计年龄均小于0.1秒。控制端未连接、未使能、速度命令零；不额外调用关闭接口，避免把操作切换产生的主动停车混入对照。8081保持隔离配置预览。

历史18:54:25记录 `permission_revoked`、`source=guard`、`action=tick`、原因“操纵授权超时”；该记录的轮式／雷达年龄约8／44ms，表明当次撤权由车端保护逻辑报告，不能据此认定通信延迟根因或MCU故障。当前关闭状态不能证明历史故障时视频状态；累计网络统计和历史事件不当作本轮故障。证据为[只读状态摘要](archive/2026-10-15-网页巡检离线验证/mapping-video-off-observation.json)。没有进行代码修改、扩大超时、恢复使能或实车移动，故不新增构建／单测结论；本次现场推杆对照仍待用户反馈，暂不进入排错技能的代码修复阶段。

## NAV-017-R12-OBS3：10月16日网页日志与静止观察（2026-10-16）

目的：核对用户“今天好很多”的反馈，区分当前故障、历史提示与静止／实际推杆。范围／安全：仅GET 8080状态及诊断、读取既有任务日志／系统journal和进程列表，无控制会话连接、执行器命令、服务重启、系统／参数／代码变更。现场操作及停止恢复沿用[手册33.5](操作手册.md#335-摇杆与停车验收)；本次为只读观察，不新增单测或构建结论。

来源与时间：按Asia/Shanghai筛选10月16日00:00之后日志。用户journal无条目，改读系统journal的 `_SYSTEMD_USER_UNIT=mapping-tablet.service`，当前13行，与网页缓存中的当天13条事件相互核对；任务日志当天3条为connect、transport_switch请求停车、enable。网页缓存只保留最近128条，不把其中昨天事件或连接累计统计当作今天新增。

实际：08:03:37连接并报告UI r12，08:03:38接通WebRTC，切换通道的预期停车在使能之前；08:03:39使能后未见新的撤权／操纵授权超时／断连。08:04:03／07／12三次状态查询超时，当时控制消息年龄分别35／25／39ms；08:04:19及26两次控制消息间隔336／346ms，未观察到对应撤权。相机仍关闭、无RealSense进程，CURRENT/RUNNING、雷达与轮式反馈新鲜。页面保留的last_stop“操纵授权超时”对应10月15日18:54:25，不是当天故障。

连续观察：08:07:32～08:08:00约28秒15次本机GET均成功，始终已使能、松手／零命令、视频关闭；无新增事件／连接代次变化。本机HTTP耗时最大82ms，最后TCP往返估计4.701ms，仅是各自采样值，不当作手机端全程延迟或与昨日不同链路的同条件对比。当前连接 `accepted_sequence=0`、RTC received=0，没有收到可据以验收推杆的运动请求，故结论仅为静止使能／连接较平稳，通信抖动仍存在，实际遥控改善和视频负载因果关系待现场反馈。证据：[NAV-017-R12-OBS3.json](archive/2026-10-16-网页遥控只读观察/NAV-017-R12-OBS3.json)。

## NAV-017-R12-OBS4：晚间重新核对网页日志（2026-10-16）

目的／范围：用户要求重新检查；只读8080最新状态／诊断、系统journal及当天任务日志，不发控制、调整阈值或重启服务。停止／恢复及现场对照仍见[手册33.5](操作手册.md#335-摇杆与停车验收)。无代码改动，不新增构建／单测结论。

实际18:03:45查询：视频关闭，CURRENT/RUNNING，WebRTC在线、已使能、轮式／雷达新鲜。上午之后08:18:05新增一次状态查询超时，当时控制消息年龄56ms；08:26:36网页请求stop，原因disconnect，触发permission_revoked，随后rtc_channel_closed／连接退出。它是今天新增的撤权，不能沿用上午截至08:08的“无新撤权”覆盖全天；没有证据把该次主动协议断开确定为人为关页或网络故障。

18:03:07重新连接，18:03:08通道切换停车，18:03:13重新使能。恢复前台期间集中接收client_script_delay和client_page_visible，包含约60秒及更长的历史回调间隔；server_unix_ms为事件到达车端的时间，不能将其等同事件在浏览器实际发生的时刻，或认定当前链路持续卡顿。当天截至本次检查未见新增“操纵授权超时”。

18:04:32～18:04:50约18秒10次连续采样，始终已使能、松手、零命令、视频关闭，无新事件／断连，连接代次10保持；accepted_sequence／ack_sequence及RTC received均为0，任务日志当天9条状态事件中仍无已接受运动请求证据。只能确认当前静止连接保持，不能判断实际推杆稳定；若现场已推杆须再核对操作网页与运动请求发送／到达。证据：[NAV-017-R12-OBS4.json](archive/2026-10-16-网页遥控只读观察/NAV-017-R12-OBS4.json)。

## NAV-017-R12-REC1：用户要求故障节点重启及现场备份（2026-10-16）

目的／授权：用户反馈网页卡住，明确要求重启相关节点。本轮为恢复运行，不进行使能／行驶测试。前提／风险：读回已未使能、速度命令零；重启前告知车辆停车、清空支架扫掠区，底盘初始化会发送S1=94。没有实体角度反馈；异常停车／隔离动力与停止恢复见[手册33.11](操作手册.md#3311-车端应急停止与回滚)，该节补充故障前独立备份入口。

故障状态：网页可响应，但FAULT/FAILED，报“建图任务退出或启动超时”；网页输入年龄约odom1707秒、scan1710秒、map1710秒。底盘／雷达／SLAM进程仍在，过期年龄是网页停止接受数据后的状态，不能据此声称所有硬件节点已停止28分钟或认定WiFi根因。原故障状态、任务日志及journal保留于 `log/mapping_restart_20261016_2030/`。

备份／恢复：SLAM serialize_map返回result=0，graph.posegraph／graph.data落盘；独立map_saver保存107×69格、0.05m/格的map.yaml／map.pgm。此为应急资产，未制造正式工程清单或冒充网页可续建工程，四文件SHA256归档。随后重启用户mapping-tablet.service，经真实会话API按旧mode=new恢复其管理的底盘／雷达／SLAM／门控；摄像头保持关闭，没有请求车轮使能／非零速度。旧会话图保留在备份目录，当前会话没有自动加载该备份。系统配置、源码和参数未修改，8081隔离预览保持；无新增构建／单测结论。

实际20:33:26进入CURRENT/RUNNING。20:34:26～36六次采样均成功且数据持续新鲜：最终odom约0.015秒、scan约0.054秒、map约1.866秒，未使能、零命令、无错误、视频关闭。网关PID76661，底盘76728、雷达76730、SLAM76732、门控76734；旧组退出，控制板／雷达串口各只有对应新进程占用。证据：[NAV-017-R12-REC1.json](archive/2026-10-16-网页遥控只读观察/NAV-017-R12-REC1.json)。结论仅为重启恢复和短窗输入新鲜，卡住原因、长期通信／移动稳定性仍未确认；现场刷新8080后核对地图与车体，再显式使能，异常按停车锁定流程处理。

## NAV-017-R12-STOP1：用户要求暂时停止网页巡检服务（2026-10-17）

用户要求先关闭相关服务、暂不继续。停止前8080已FAULT，显示 `dirty=false`／`save_failed=false`、未使能／零速度、视频关闭，map／scan／odom数据过期约11.8小时；不把过期实时状态另存成地图。10月16日graph与栅格应急备份保留，见REC1。执行 `systemctl --user stop mapping-tablet.service` 有序关闭常驻网关及其Launch管理的底盘、雷达、SLAM和遥控保护节点；向此前启动且硬件控制关闭的8081预览Launch发送SIGINT，console clean exit。检查确认8080／8081端口释放、服务inactive，底盘／雷达／SLAM／相机与两个网页入口进程不再运行。用户服务仍为enabled，仅本次停止；没有禁用开机自启、删除地图或更改系统配置。无代码变化或测试；恢复时按手册33节启动，硬件保持显式控制。

## NAV-017-R13：按已有日志区分断联原因，并补发未过期挑战（2026-10-19）

目的：平板推杆时连接掉线、页面出现心跳超时一类提示。本轮不新做一次推杆采样，使用R5、R7、R10-OBS2和R12已记录的时间。R5三次“操纵授权超时”的网页控制间隔是305～316ms，脚本间隔约131～152ms，最后一条已接受命令的挑战年龄约6ms。R7、R12在没有同期`script_delay`时仍有303～350ms控制间隔。恢复前台后集中出现的数秒脚本间隔，R12-OBS4已经说明不能当成推杆过程中的持续卡顿。因此改的是挑战送达，不是把地图绘制停掉，也没有把300ms运动截止改长。

代码：[`web/app.js`](../src/carcar_mapping_console/web/app.js)在控制状态仍新鲜时，对同一条挑战每50ms可以再发一次运动包。[`http_server.cpp`](../src/carcar_mapping_console/src/http_server.cpp)在状态写出前已经超过300ms时丢弃，不改签发时间；数据通道暂时发不出去时只保留最新一条，排空后仍用原时间，过期则放弃。断连、隐藏页面、松手和传感器过期的停车没有放宽。

离线：`node src/carcar_mapping_console/test/test_browser_rtc.js src/carcar_mapping_console/web/app.js`通过。隔离域219的`HttpTransport.CompactControlKeepsStopAndDropsExpiredPendingState`通过，过期状态之后的新状态仍带原来的`issued_steady_ms`。临时前缀构建见手册35.1，没有替换当时正在运行的8080进程。随后工作区`colcon build --packages-select carcar_mapping_console`完成。当时8080为STANDBY，未使能，没有在跑的建图任务；已重载`mapping-tablet.service`，重载后仍是STANDBY，页面`/app.js`含`20261019-r13`。没有发送使能或速度，持续推杆和停车距离仍待现场确认。操作见手册33.17。

## APP-001-R3：备选停车位与上传确认（2026-10-19）

目的：在已有示教和单点执行上，让一个拍摄目标最多带3个停车位；某一位导航失败就换下一位，都失败则记下未拍并继续，最后仍去最终停车位。照片先落盘。`upload_url`为空时不访问网络。配置地址后，只有HTTP 200且回显同一编号和sha256才标已上传；失败不删文件，不重新开车或重拍。

离线：网页vitest 4项通过。`/tmp/carcar_app001_build/carcar_inspection/test_inspection_core`中Domain、Store、Teaching、Executor、Upload共17项通过，其中包括第二停车位被用到、全部失败后仍去最终停车位、校验不一致保持待传且文件还在。隔离域227的控制台测试3项通过：两点任务断网页后仍完成并最终停车；单点导航失败时期望2次导航目标、捕获为空、未拍1条、最终停车失败并保留一次红色报警；照片写失败仍是黄色报警且不去最终停车。没有启动实车底盘、舵机或外网。实车巡检和真实云端地址仍待。说明见应用README，操作见手册35.3.2。

## APP-001-R4：规划草图上的观测点数量可自选（2026-10-19）

目的：200平方米只是一块规划草图。4个观测点只作为建议，操作者自己决定放几个，并可以改名、加一个、去掉或清空重选。草图不能拿来自动巡检。

实现：点位页打开后请求`/api/plan/floor`，得到20米×10米空场地，不预先写入点。数量可选1、2、4、6、8，或自己填1到20。摆上后拖动圆点改位置、拖动箭头改车头。镜头确认仍要等真地图和实车定位，按钮会说明原因。

离线：`npm --prefix src/carcar_inspection/web test` 5项通过，`npm run build`通过。隔离域227 `ConsoleTest.PlanningSketchDoesNotSeedPointsOrStartNavigation` 通过。本机Chromium是snap，当前环境无法拉起无头浏览器，所以没有在浏览器里点完这套按钮；接口和页面构建已核对。操作见手册35.3.3。实车定点仍待。

## APP-001-R5：平板只保留 8080 入口（2026-10-19）

目的：建图和巡检合成一个平板地址。8080 页首提供「建图」「巡检」。巡检页面、接口和 WebSocket 从 `/inspect` 转到车端 `127.0.0.1:8081`。两个程序仍分开。建图任务处于启动、运行或停止中时，巡检遥控和自动任务会拒绝，并提示先结束建图。巡检任务还在跑时，建图使能和启动会被拒绝。

离线：`HttpTransport.InspectPrefixReachesUpstreamAndMissingUpstreamIsVisible` 通过，转发后的路径是 `/api/state`，上游端口不通时正文为「巡检页面未启动」。网页单测里 `/inspect/api/state` 前缀通过。当时 8080 为 STANDBY，已重载建图服务；本机另有一个硬件关闭的巡检进程听 127.0.0.1:8081。`http://127.0.0.1:8080/inspect/` 返回巡检页面，状态里 `inspection_running` 为 false。没有发送使能或速度。实车两边不会同时开车仍待现场确认。操作见手册 33.3 和 35 节。

## NAV-017-R15：按收到时刻归零，不再用挑战续租（2026-10-19）

目的：推杆被「操纵授权超时」打断。对照 teleop_twist_joy、diff_drive_controller 和 Foxglove Teleop 后，保留看门狗，去掉“必须用新挑战续租”。

修改：[safety.hpp](../src/carcar_mapping_console/include/carcar_mapping_console/safety.hpp) 从最后一次收到推杆起保持 1 秒，到点调用 `release_motion`，速度归零但 `armed` 仍为真。下一条更新序号的推杆可以直接继续。心跳不延长这次保持。松手序号仍拒绝更早的运动包。[app.js](../src/carcar_mapping_console/web/app.js) 按住后每 50ms 重复当前方向，不再因控制状态晚到发送 `control_stale`。页面版本 `20261019-r15`。雷达过期 0.50 秒、里程计过期 0.50 秒、建图会话 0.30 秒仍会撤使能。

离线：`Safety.*` 25 项通过。`test_browser_rtc.js` 与 `test_browser_control.js` 通过。

重载：重载前 CURRENT/RUNNING、未使能、速度零、`dirty=false`。域 31 在限时内没有列出 SLAM 服务，没有新备份。`mapping-tablet.service` 新进程 60334，8080 为 STANDBY，页面含 `20261019-r15` 且没有 `control_stale` 停车。底盘和门控已退出。没有发送使能或速度。从网页重新启动硬件后才会用上新门控，启动仍会发 S1=94。操作见手册 33.18。

## NAV-017-R14：通道切换不再撤使能，运动副本不延长 300ms（2026-10-19）

目的：使用网页使能时状态显示「网页请求停车」，并使能/失能来回跳；有时又能保持使能，推动摇杆后变成「操纵授权超时」。当时 8080 为 CURRENT，最近停车原因是 `网页请求停车: rtc_cancelled`，当前原因是 `网页请求停车: rtc_fallback`。

修改：[`web/index.html`](../src/carcar_mapping_console/web/index.html) 默认 WebSocket。[`web/app.js`](../src/carcar_mapping_console/web/app.js) 在通道接通或回退时不再发送停车，页面回到前台也不再额外停车；选择 WebRTC 时同一条运动同时提交可靠副本。[`web/rtc_control.js`](../src/carcar_mapping_console/web/rtc_control.js) 对短暂 `disconnected` 等 1 秒，不立刻拆通道。[`src/http_server.cpp`](../src/carcar_mapping_console/src/http_server.cpp) 不再因数据通道状态发停车；无 `backup` 的旧 TCP 运动仍丢弃，带 `backup` 的副本交给原门控。`control_lease_seconds` 仍是 0.30。页面版本 `20261019-r14`。

离线：`test_browser_rtc.js` 与 `test_browser_control.js` 通过。隔离域 219 的四项 HTTP 传输测试通过，其中包括旧 TCP 运动仍被丢弃、带 backup 的副本会转发、数据通道关闭不再新增停车。

重载：2026-10-19 19:56 按用户要求执行手册 33.11。重载前 CURRENT/RUNNING、未使能、速度零、`dirty=false`。先把当时 SLAM 图备份到 `log/mapping_restart_xyGcR6`（序列化 result=0，栅格 96×68）。随后停止并启动 `mapping-tablet.service`，旧进程 32558 退出码 0，新进程 56180，服务 active。8080 为 STANDBY，页面含 `20261019-r14`。底盘、雷达和 SLAM 已退出。没有发送使能或速度。该备份没有正式工程清单，网页不会把它当成可续建工程。

续：刷新后任务再次 CURRENT。20:00 左右推杆仍报「操纵授权超时」，当前原因是「网页请求停车: control_stale」。诊断里控制通道为 WebSocket，`tcp_rtt_ms` 约 371，重传 25 次，客户端控制间隔多次 306～346ms。签发后 0.30 秒短于这条往返，运动包到不了截止前。`control_lease_seconds` 改为 1.0。会话未就绪仍是 0.30 秒，雷达和里程计仍是 0.50 秒。25 项 `Safety.*` 通过。

20:06 再次重载。重载前未使能、速度零、`dirty=false`。服务列表未带域号，没有读到 SLAM，所以这一次没有新备份；19:56 的 `log/mapping_restart_xyGcR6` 仍在。新网关进程 57314，8080 为 STANDBY。

20:08 新门控已是 1000ms。推杆从序号 4 收到 782，约 27 秒后 `tick` 报「操纵授权超时」，当时 `lease_remaining_ms` 为 -0.057，挑战年龄停在约 198ms。新挑战大约 1 秒没到浏览器，重发旧挑战不续租。随后改为：挑战 2 秒内仍可开车，保持时间从收到时刻再计 1 秒。相关安全单测通过。20:14 重载，进程 58376，8080 为 STANDBY；域 31 在 3 秒内没有列出 SLAM 服务，没有新备份。操作见手册 33.18。

## NAV-017-R14-OBS：车到接入点路径与无推杆窗口（2026-10-19）

目的：在不放宽300ms运动截止的前提下，先看车到无线接入点这一段是否已经能解释约300ms控制断流。没有平板连接时，不把TCP发送队列和网页脚本间隔写成同一次推杆的原因。

前提：`mapping-tablet.service`为active，主进程32558，重启次数0。8080为STANDBY，未使能，视频关闭。8081仍是硬件关闭的巡检预览。没有雷达、相机、SLAM或Nav2进程。省电只查询，结果为on，没有改成off。没有发送使能、速度或S1。

结果：正在提供的`/app.js`含`20261019-r13`和50ms补发；源码`control_lease_seconds`为0.30。诊断`connected=false`、`tcp_sample_valid=false`、`disconnects=0`、事件0条。接口`wlP1p1s0`连接“小泽”，地址192.168.5.11，信号−53 dBm。对192.168.5.1发20次、间隔0.2秒：收到19次，往返0.875／1.961／8.804ms。对192.168.5.17同样20次：收到18次，往返2.977／54.164／203.692ms，TTL 128；该地址当时可达，不能认定是建图平板。192.168.5.36不可达。原始输出在`log/nav017_r14_obs_20261019.txt`。

边界：车到接入点的往返远小于300ms，这一段单独不能解释既有控制断流。没有控制连接，就没有新的`tcp_send_queue_bytes`、重传、`script_delay`或`control_gap`。持续推杆、松手停车和断流停车距离仍待现场。因此没有进入手册33.4的硬件启动、33.10的场地覆盖、手册36/31的固定姿态深度对照，也没有启动NAV-012实车恢复。操作仍只沿用手册33.17和33.5。

## APP-UI-20261019：建图与巡检上位机 UI 改版离线验收（2026-10-19）

承接用户在原 Codex 对话中要求两页风格统一、字体图标与操作目标放大、动效与错字修订。本轮保留原改版，集中完成中断的多尺寸复核与构建安装；不触碰车端控制协议。

隔离浏览器：1440／1024／390 等 14 组布局，横向溢出 0、页面脚本错误 0，reducedMotion=true。巡检网页 Vitest 5 项通过、Vite 生产构建成功；建图网页 DOM 模拟时序、RTC 控制回归及脚本语法检查通过。ROS2 接口包补充生成既有 SetMotionHold.srv 头文件后，巡检包编译安装成功：核心 17 项通过、控制台 6 项通过；另外 1 项可选浏览器集成用例跳过。最初单独运行需要夹具入参的测试脚本失败是调用方法不符，按其离线夹具入口执行后回归通过，并非此次 UI 引入的故障。

页面加载：8080 当前提供的首页、CSS、JS 与源文件逐字节一致；localhost:8081 当前提供的巡检首页与生产 dist 一致，安装网页入口同样指向新版 dist。未重启已有 ROS2 节点，没有使能或控制小车。相关图片和原始离线报告见[UI验收归档](archive/2026-10-19-上位机UI改版验收/README.md)。

未验收：小米平板 6 实机触控、实际地图与位姿、连续遥控和停车距离、巡检自动任务、摄像头/舵机；模拟截图不能替代实体车辆结论。

## NET-001：平板热点中介与180秒回原网（2026-10-20）

目的/范围：在不增加网卡、不接屏幕键鼠的条件下，用平板连接原WiFi并开热点，验证电脑和Jetson同连热点时的本地SSH/网页，以及断上游、锁屏和定时回原网。首版只测静止网络，不扩大到建图、视频或执行器验收。完整构建、准备、启动、观察、提前恢复及日志命令统一[手册33.19](操作手册.md#tablet-wifi-mvp)。

前提/安全：网页STANDBY，无巡检、无底盘串口所有者，现场确认停稳；原路由器保持供电且车辆留在其覆盖内。没有额外网卡、有线/USB恢复链路；自动回滚依赖NetworkManager仍正常运行，不等于独立硬件救援。原同接口热点工具保留，不借用其“已验证恢复通道”标志绕过前提。新增工具不启动硬件、不发送串口/速度、不修改代理。

用户反馈：热点名称 `Hao.iPhone`，平板没有手机卡，上游WiFi为“小泽”；台式机已连热点并仍能SSH到留在“小泽”的Jetson。只确认反馈时刻的上游转发，不认定热点客户端互访通过。随后用户报告热点拓扑下代理端口/Codex联网不正常并明确暂不处理，台式机可使用其他软件；具体代理端口根因未验证，不新增代理改动。

实现：独立C++ `mapping_tablet_wifi_trial` 提供status、prepare、trial、restore。准备时同目录完整备份NM配置并写桌面维护记录；密码仅本地隐藏输入，客户端配置使用DHCP、禁自动连接、仅存NM内存。后台新会话先预检，再创建固定180秒检查点、同步状态并记账，最后激活目标；关闭SSH不取消检查点，不提供延时或永久切换入口。接口新IP和恢复快照存root私有记录；原连接恢复由UUID、State=100、IPv4判定，电脑SSH仍要现场复核。

离线结果：新增7项用例通过，覆盖预检/检查点失败不切网、记录失败先回滚、连接请求失败且回滚再报错时保留原失败、DHCP客户端/禁自动连接、SSID含中文和shell字符按数据传递，以及无效凭据拒绝。目标包构建通过；真实NetworkManager仅做只读查询，返回原“小泽”/192.168.5.11/24、接口100、检查点为空。没有sudo免密权限，未执行prepare/trial，未创建系统测试状态/网络备份，桌面维护记录本轮没有虚构网络变更。C++编译提示为既有common.hpp的GCC参数传递说明，不是编译失败。

首次全包回归的13项集成中2项失败：浏览器结束后夹具立即读取了尚未更新的HTTP缓存，门控日志随后已撤使能；增加有界等待并保留零速检查。第二次13项中1项失败：挂起观察固定1200ms紧贴1000ms收包租期、80ms在途上行及状态缓存预算；测试改为报告租期+注入上行时延+250ms观察传播预算，且租期仍硬限制≤1000ms。两轮原始JUnit与原因见[离线证据](archive/2026-10-20-平板热点MVP离线验证/README.md)，不删除失败或改动门控/速度/停车期限。

最终结果：5个CTest目标全部通过，共71项C++用例（7网络工具、11工具、28逻辑、13集成、12 HTTP），用时127.82秒；对应原始JUnit均已归档。Python静态编译、建图JS语法及diff空白检查通过；目标包已构建安装，新工具只读status现场读回“小泽”/192.168.5.11/24、检查点为空。巡检前端5项及生产构建另见APP-UI-20261020。以上均不替代真实切网与回滚试验。

待验/下一步：本地终端完成sudo及热点密码输入，并先确认客户端IP可查；依次登记电脑SSH、电脑上网、平板网页、断上游本地连接、锁屏及回原网SSH。未通过不登记网络或物理停车成功；不把Codex不能上网算成本地链路失败，也不推断它已修复。

### NET-001-R1：准备完成，尚未切网（2026-10-20）

用户反馈已完成prepare。代理随后只读核对：`carcar-tablet-wifi-mvp`的UUID为`7a4acbc9-29f4-41a2-aca4-29b5dcf0e003`，目标SSID为`Hao.iPhone`、客户端模式、DHCP、禁自动连接；原“小泽”UUID仍为`fa5c218d-270d-46ba-b2f1-76fd0d38118b`，IPv4为192.168.5.11/24、接口状态100。8080为STANDBY、无巡检，NetworkManager检查点为空，故尚未开始180秒倒计时。

桌面维护记录已追加`NET-MVP-959d832e`，登记同目录完整备份`.carcar-tablet-b265fcec506a39a4adc7cc04516ce0db.backup`及SHA256`51a39f71dd37bd3bda43b1c4d919b098655ed1433c853f3d692c9f494ec69271`；密码字段为脱敏占位，未读取凭据。上述备份结果来自工具准备记录，本轮代理没有root权限重新校验内容。准备成功不证明密码认证、热点客户端互访或实际回滚已通过；下一步按手册33.19启动trial，并由现场提供新IP和六项验收反馈。本轮未启动硬件、未修改代理。

### NET-001-R2：热点取址及原网恢复，地址发现待改进（2026-10-20）

用户反馈Jetson已接入平板热点，但平板客户端列表不显示IP，因此尚未通过新地址验证SSH/网页。代理只读桌面维护记录确认：检查点`/org/freedesktop/NetworkManager/Checkpoint/1`已创建，目标连接UUID仍为`7a4acbc9-29f4-41a2-aca4-29b5dcf0e003`；接口在Hao.iPhone取得`192.168.180.181/24`、状态100。该地址是本轮历史DHCP分配，不是固定承诺，也不是回原网后的当前地址。

维护记录从试验建立到恢复约198秒：约180秒时原连接处于配置阶段（状态50、无IPv4），后台另请求激活原连接，随后记录RESTORED及原UUID/192.168.5.11/24。180秒是回滚触发计时，不是恢复完成的保证上限。本轮只读复核仍为“小泽”/192.168.5.11/24、检查点为空、8080 STANDBY、无巡检；没有新切网、启动硬件或修改代理。桌面记录的对应编号为`NET-MVP-b81063a2`（建立）、`NET-MVP-646626fd`（热点地址）、`NET-MVP-ea5cabdf`（补发恢复）、`NET-MVP-c7860f77`（恢复确认）。

地址方案：热点当前已确认使用192.168.180.0/24，但网关、DHCP池和热点重启后是否保持网段尚未确认，暂不把某个DHCP地址改成静态默认。固定地址需核对这些条件，优先使用热点侧地址保留（若设备提供），否则选择不与动态池冲突的同网段地址。本机Avahi服务在运行，但一次`xiaozhu.local`解析返回Docker虚拟网卡172.17.0.1，不能据此登记平板热点下的主机名访问已可用；本轮未改Avahi系统配置。

仍待：电脑到Jetson的热点内SSH、平板访问网页、断上游、锁屏、电脑回原网SSH的现场反馈；静态地址前需电脑热点连接的IPv4/掩码/网关及平板热点地址保留或DHCP池能力信息。当前不能将连接和软件恢复成功等同整个网络MVP通过。

### NET-001-R3：目标更新为chenjiajun，改用本机读地址（2026-10-20）

用户不再从Windows网络详情采集，选择在Jetson直连屏幕操作，并更新目标热点为`chenjiajun`。代理随后只读status确认当前实际仍是“小泽”/192.168.5.11/24、原UUID、接口状态100、无检查点；旧trial状态为RESTORED，SSID仍为Hao.iPhone。此次只同步文档及新prepare命令，没有把旧测试配置直接切换、没有设置固定地址。旧热点取得的192.168.180.181/24只保留为历史结果，不作为新热点地址候选。下一步在Jetson本机接入chenjiajun后，按手册读取该接口IPv4及默认路由；先保持DHCP，取得新网段/网关后再评估静态地址与冲突边界。

### NET-001-R4：台式机已接热点，Jetson仍连原网（2026-10-20）

目的/前提：澄清用户所贴输出的设备来源，保持静止网络测试范围。用户明确台式机已连`chenjiajun`，接口及路由命令是在Jetson终端执行，读回192.168.5.11/24、默认网关192.168.5.1；docker0的172.17.0.1是虚拟网络地址，不作为本次WiFi访问入口。代理随后只读status核对实际SSID为“小泽”、原UUID、接口状态100、检查点为空。单靠IP不能识别WiFi名称，SSID读回才确认Jetson此刻未接新热点；现有SSH可达也不能作为两台设备均连热点或热点内客户端互访通过的证据。

旧Hao.iPhone测试配置UUID的只读查询返回“没有这样的连接配置集”，不推断其消失原因，也不复用旧trial直接切换。下一步按[手册33.19第二组](操作手册.md#tablet-wifi-mvp)重新准备`chenjiajun`，由现场在隐藏输入中提供密码；prepare仅备份并添加临时配置，不切网。新热点连接、地址和互访仍待实际试验。此次未改系统网络、代理或静态地址，未启动硬件；旧取址/恢复证据保留。

### NET-001-R5：chenjiajun已准备，仍未切网（2026-10-20）

用户反馈新prepare已完成。代理随后只读核对临时配置UUID为`3c34bbe0-dc93-4441-8a97-e7cabe9f6468`，SSID为`chenjiajun`、客户端模式、DHCP、IPv6关闭、禁自动连接；Jetson实际仍为“小泽”/192.168.5.11/24、原UUID、接口状态100、检查点为空。8080的phase与task_state均为STANDBY、无巡检。这确认准备完成，不证明热点密码认证或新热点互访成功。

桌面记录`NET-MVP-b27c8b1c`（2026-10-20 15:15:20 +08:00）登记完整同目录备份`/etc/NetworkManager/system-connections/.carcar-tablet-04bb4cb14eeb2dffd6fbac5fd164f5df.backup`，SHA256为`66203b728c87f566a852f90bb4a8ad0752ce0617ae2f6755d7dd6cd236966327`，状态PREPARED，恢复入口已登记。备份内容与散列来自工具记录，代理本轮没有root权限重新校验。未读取密码、未启动硬件或更改代理/静态地址。

下一步按[手册33.19第三组及本机观察](操作手册.md#tablet-wifi-mvp)在已接好的Jetson屏幕终端运行trial，随后读回SSID及IPv4，电脑再使用新地址SSH、平板访问待命页；原SSH会断开，180秒触发回原网，实际恢复另需重连时间。屏幕实际接线仍待现场确认；若仍仅用SSH且没有地址获取通道，先接好已选择的本机显示通道再启动本轮。不延长或取消回滚，不把网页打开当作运动通过。

## APP-UI-20261020：巡检文字修正（2026-10-20）

目的/实现：按用户要求，将两套现行页面中的“巡见”修正为“巡检”，覆盖浏览器标题、品牌、无障碍标签及建图页脚；历史归档原文保留，控制逻辑未改。

结果：巡检网页5项Vitest及Vite生产构建通过，两目标ROS包构建安装成功；8080在线首页和源文件已确认正确，巡检已安装生产首页与JS资源也确认不再包含错误文字。最初尝试直连8081返回ECONNREFUSED，说明该巡检服务本次未运行，不能据此判定页面故障；离线资源核对最初未移除部署用的/inspect前缀导致路径查询失败，按实际assets路径核对后通过。没有为检查文字启动巡检服务或实物硬件。用户刷新可载入当前建图文字，巡检页需其原有入口启动后查看；真实触屏和物理停车仍未验收。

## NET-002：平板自动代理真实性及兼容性核对（2026-10-20）

目的/安全：核对用户提供的代理完成报告，保持当前网络与现有Codex会话；只读接口/路由/端口/登录状态，发无认证HTTPS与本地网页GET。不读密钥、不发模型推理、不切网、不启动硬件。完整诊断/恢复见[手册37](操作手册.md#jetson-auto-proxy-audit)。

当前实测：xiaozhu的WiFi IPv4为192.168.180.181/24，默认网关192.168.180.3；代理127.0.0.1:17892仅本机监听，服务active/enabled、Linger=yes、NRestarts=0。平板6880候选OK，三个旧候选UNAVAILABLE。原脚本和.bashrc有此前备份；用户所述Windows端SSH操作为用户反馈，本轮未独立复现Windows客户端。

分别经平板及本机代理访问api.openai.com/v1/models：CONNECT200、HTTP401、TLS_verify=0，耗时约1.52/2.55秒。auth.openai.com及chatgpt.com根路径均403、TLS校验通过；不能由403归因为账号/地域/挑战，也不能证明真实登录失败或成功。GitHub均收到HTTP200及部分响应体，但14秒内未下载完整页面，curl退出28，不能记为完整通过。

兼容性回归：curl7.81，故意将代理指定为127.0.0.1:9，no_proxy仅192.168.180.0/24时本地8080请求失败；改明确IP192.168.180.181返回HTTP200。与curl官方文档CIDR从7.86加入一致。修正.bashrc保留全部旧项，补192.168.5.1、192.168.180.3、192.168.180.181、xiaozhu、xiaozhu.local；同步用户管理器两个变量的旧列表。备份及前后差异登记桌面NET-PROXY-002。bash语法通过，新登录shell本地绕行HTTP200、默认环境API CONNECT200/401/TLS_verify=0，代理仍active。明确IP只覆盖当前这些端点，不承诺其他DHCP地址自动绕过；存量进程不自动更新。

Codex事实：PATH解析到VS Code扩展内linux-aarch64/codex，版本0.162.0-alpha.17.2；login status显示Logged in using ChatGPT。这证明程序可执行及本地登录状态，未验证令牌刷新、模型权限、实际推理或桌面SSH兼容性，不需要据原文重复安装/重新登录。

代码审查待改进：probe只看Google CONNECT200，无TLS/业务检测；choose探测与串行超时在全局锁内，全不可用时无负结果缓存；连接失败后重选可能再次选同一CONNECT假健康节点，真实目标失败不会触发切换；relay闲置180秒结束连接；只取最低metric的一个IPv4默认网关，VPN/多路由场景需独立验收。此次不修改旧Python逻辑、不临时断掉当前唯一可用上游，不将优先级代码存在等同实测故障切换正常。后续优先目标站TLS健康检查、故障节点冷却/排除、后台探测与状态观测，再用隔离替身验证故障恢复及在途连接边界；新增可执行逻辑按仓库约定用C++。平板锁屏/休眠、断上游、换网、重启恢复及真实Codex请求仍待专项验证。没有“保证永不断网”的结论。

参考：[curl官方no_proxy说明](https://curl.se/libcurl/c/CURLOPT_NOPROXY.html)、[OpenAI官方认证说明](https://learn.chatgpt.com/docs/auth)。本轮没有升级系统包、关闭TLS校验、修改ROS配置或替换代理实现。

### NET-002-R1：C++自动代理加固与部署（2026-10-20，16:45起）

目的/范围：用户明确要求确认后修复。替代现有用户服务执行入口，保持127.0.0.1:17892和旧三个固定候选，新增执行逻辑用C++；旧Python文件、历史备份及原配置保留，不改ROS节点或启动硬件。局域网绕过兼容修正从固定当日IP扩展为新shell按当前小子网生成明确地址列表。完整构建、检查、停止/回滚见[手册37.1](操作手册.md#jetson-auto-proxy-hardening)，实现取舍/第三方来源见[scripts/jetson_auto_proxy](../scripts/jetson_auto_proxy/README.md)。

前提/安全：只用回环模拟代理/TLS服务验证故障，不物理断开唯一可用平板上游；平板真实链路用无认证HEAD测试。重载本机HTTP代理可能中断旧外网连接，SSH链路/WiFi不修改，无串口、执行器或运动命令。Codex真实请求仅要求固定回复，不调用工具；日志权限600，不输出认证凭据。

预期与实际：

| 验证 | 实际与结论 |
|---|---|
| 目标构建/静态检查 | 独立CMake C++17目标构建通过，-Wall/-Wextra/-Wpedantic无告警；原Python py_compile、.bashrc语法、服务单元校验通过 |
| HTTPS健康判定 | 模拟CONNECT200但无TLS被排除；不可信证书、主机名不匹配、403均拒绝；可信TLS+401通过 |
| 隔离故障切换 | 高优先假健康排除；CONNECT建立前502可换已健康备用；失败冷却、冷却后恢复原优先级通过 |
| 并发与请求边界 | 慢探测不堵请求选择；全失效快速503；POST上游断开不重复发送；TCP半关闭仍能返回响应 |
| 回归总计 | 18个断言通过，CTest最终通过，见regression_final.log/ctest_final.log |
| 空闲回归 | 完全无流量185秒后仍成功传输，见long_idle.log；这是本地转发逻辑测试，不等于平板锁屏通过 |
| 实际独立端口 | 17893经平板API401、GitHub200（均TLS校验正常）、普通HTTP200；试跑进程最终已正常停止 |
| 部署后网络 | 新登录shell局域网8080在无效代理端口9下仍200；默认代理API CONNECT200/HTTP401/TLS0、GitHub CONNECT200/HTTP200/TLS0 |
| Codex请求 | 真实CLI最小请求退出0、回复PROXY_OK，证明该次登录状态和实际模型通路；未验证全部工具/插件或长会话 |
| 运行入口 | 用户服务active/enabled，17892仅回环监听，NRestarts=0；源码/构建/部署散列保留final.sha256，旧Python不由正式服务执行 |

代码/配置：scripts/jetson_auto_proxy/{proxy.cpp,proxy.conf,jetson-auto-proxy.service,CMakeLists.txt,test/proxy_test.cpp}。后台每轮并行探测后等待15秒，单个探测最多4秒；网络等待不持选择锁，失败节点冷却15秒，探测世代防止旧成功覆盖新失败。IPv4多个默认网关按metric重读，状态显示检查年龄/错误码/下一新连接的优先候选。转发缓冲有界，最多48并行客户端，无原180秒闲置断开。终版额外将退出标志改为锁自由原子，避免后台线程与信号退出读写竞争；重新构建和18项回归后原子安装并重载，转发逻辑与185秒测试版本一致。

部署与保留：.bashrc、用户服务在同目录保存20261020-1644.backup，用户管理器原no_proxy两变量单独备份；桌面维护记录NET-PROXY-003含完整前后差异。新C++二进制与配置此前不存在，回滚时保留不使用；首版C++二进制另存.20261020-first-cpp.backup。最终二进制SHA256为88df495466c4375d9eab74c98c67c6f40aa4299a345c8a53c6b780f887a71f1a，与构建一致。代理重载两次（首次部署、退出标志修订），没有切网或操作硬件。

硬件/网络读回：LC_ALL=C的只读无扫描列表确认当前SSID chenjiajun；IPv4仍192.168.180.181/24、默认网关192.168.180.3。它们是当前DHCP读数，不设静态地址，不反推之前NET-001的试验流程已经验收。

证据：log/net002_proxy_20261020/含隔离回归、空闲测试、独立端口、部署/终版网络读数、运行状态、散列与Codex最小回复；完整模型日志权限600。首轮代理核对的旧操作原文移入[归档](archive/2026-10-20-自动代理首轮诊断与兼容修正.md)，没有抹去失败或将超时改成成功。

边界/下一步：健康检查仍依赖所配置目标，当前只验证无认证API访问；已建立TCP不能无缝迁移，业务TLS内部失败由应用重连，工具不会重放已发业务。新shell动态绕过当前不大于/24的私网子网，较大子网、旧进程及systemd环境变化仍按手册处理。追加日志未自动轮转。尚未进行平板物理锁屏、断上游/恢复、跨网、长距离随车与整机冷启动；不将离线回归、真实单次请求或enabled状态写成这些实机项目通过。

## NAV-017-R16：弱特征建图审计与独立6m候选（2026-10-20）

目的/范围：用户将WiFi和错字移出本轮，要求解决平板建图经过弱特征区域时，建筑直角走廊被画成约100°～120°的问题，并指定昨晚约22:30工程。本轮不把用户观察角度当作尺量真值，也不将后续AMCL重定位视为坏图修复。

安全前提与实现：只读三个22:34～22:35保存的工程，调用本机SLAM Toolbox 2.6.10的Karto接口提取数据。新增独立C++离线审计工具及6m候选配置/平板Launch入口；启动参数经C++网关、prepare和固定argv传入SLAM，不由网页传文件路径。原3m默认、旧地图、IMU与运动保护保留。候选只供新建、单独保存，旧图恢复和保存后隐式续建返回明确错误，不在拒绝时停止当前任务。操作、构建和恢复统一[手册33.20](操作手册.md#weak-feature-mapping)。

已确认读回：三个工程导出的637帧CSV逐字节一致，扫描跨度952.882秒，序列化激光阈值3m，设备声明上限12m；声明不代表现场可靠距离。每帧≤3m点数最少130、中位464；≤6m最少457、中位599。图为342×299、0.05m/像素。轮式/SLAM航向不同属于估计间差异，不是实物误差测量。全部12个原地图/图数据文件对manifest的SHA256校验成功。地图、CSV、原始统计、工具及限制见[审计证据](archive/2026-10-20-弱特征建图审计/README.md)。

离线验证：候选参数传递用例先因未知 `--slam-params` 失败，再经实现通过；检查带空格路径、默认不启硬件、缺文件和候选续建被拒绝。目标包构建成功；5个测试目标共72项C++回归（28逻辑、12工具、13隔离集成、12HTTP、7既有网络工具）全通过。两个XML入口 `--show-args` 解析、既有底盘Python静态编译及网页JS语法检查通过。去除注释/空行后候选与基线仅 `max_laser_range: 3→6` 不同。

补充隔离启动：首轮误选域241，Fast DDS因端口上限拒绝启动，属于离线夹具错误，未打开任何硬件。改用域216、localhost18094、`backend_hardware=false`后GET返回STANDBY，参数读回为候选配置和硬件关闭，随后只退出本轮进程；未向网页发送启动/使能/速度。实际8080只读仍STANDBY，未重启现行服务、切网或控制串口。原始构建/测试/失败日志在 `log/nav017_geometry_20261020/`，最终报告随证据归档。

结论与下一步：完成输入审计和可复核的单变量候选，未复现完整实时故障，不能宣布地图形变已修复。先同场景/路线/慢档比较3m与6m的角度真值、重影与闭合偏差；若仍失败，补完整扫描/里程计/TF/SLAM位姿及IMU观察数据，独立复核轮式转角、时序与闭环。建图质量告警、锁停及扫描冻结尚未实现，当前新鲜度门控不证明几何质量。长期选择见[学习路线3.1.1](工业级优化建议与学习路线.md#311-弱特征区域的建图保护)；保持原3m为日常默认，候选实机通过前不转正。

## REL-001：上位机与UI发布前核验（2026-10-20）

用户要求先推送当前代码，再打附注标签，指定描述为：“完成了上位机及 UI，现在测试可以正常建图，巡检这边还没有测试。”这是用户对当前使用状态的反馈，不能扩大为弱特征场地角度精度、巡检实机或工业可靠性验收通过。

范围：当前上位机/网页、巡检代码、已有维护归档和地图资产一并保存，原3m默认及独立6m候选均保留。生成的根目录运行日志、安装清单、既有build/install/log与网页依赖不纳入源码提交，文件继续在本地保留。未修改系统配置、网络或实际硬件状态。

发布前读取现有JUnit结果：建图72项、巡检24项、相机47项均0失败/0错误；本轮另复核巡检网页Vitest与生产构建。建图8080只读为STANDBY、无未保存进度、无巡检任务。仓库远端main与本地当前HEAD一致，既有标签到V2.4；拟创建V2.5附注标签，描述使用用户原文。推送后再开始算法比较，新增候选与本发布基线分开提交。

算法顺序：使用相同场景、路线、速度、载荷与指标比较既有扫描匹配和单个候选，先完成可重复测试；离线合成场景、保存关键帧与实物测量分栏，不以仿真赢家代替真实场地结论。每轮保留原入口、候选、失败证据和独立回退方式。
