tfsvh69-blip/Nav2_car/docs/硬件台账.md

# 硬件台账

**2026-10-20 NAV-017-R16现场反馈：**用户确认错字已改、WiFi问题暂不再处理，当前问题集中在平板建图经过弱特征区域时，实物约90°走廊被画成约100°～120°。角度来自用户现场观察，不是本轮尺量、轮式读回或IMU真值；约22:30保存工程已找到。无新增接线、传感器、驱动或系统网络变更，离线测距统计及候选状态统一[测试记录R16](测试记录.md#nav-017-r16)。

**2026-10-20 NET-002-R1网络状态追加（无接线/驱动变更）：**只读确认当前WiFi为`chenjiajun`，Jetson接口`wlP1p1s0`取得`192.168.180.181/24`、默认网关`192.168.180.3`。平板网关6880及本机17892代理实际HTTPS可达，真实Codex最小请求通过；用户服务已换C++入口，旧Python保留。地址为本次DHCP读数，不固定；不反推NET-001试验流程或锁屏/断上游/冷启动已验收。配置备份、证据与待验项统一见测试记录NET-002-R1、手册37.1及桌面维护记录NET-PROXY-003。

**2026-10-20 NET-001-R5新热点准备完成：**用户执行新prepare后，只读核对`chenjiajun`临时客户端配置已存在、DHCP、禁自动连接；Jetson仍连“小泽”，没有开始新一轮切换。备份及维护记录已由工具生成，详细证据见测试记录R5；无新增硬件、驱动、代理或静态IP变更，外接屏幕实际接线仍未收到现场确认。

**2026-10-20 NET-001-R4连接对象澄清：**用户确认台式机已接入`chenjiajun`，所贴接口/路由输出来自Jetson终端。车端随后只读核对实际仍连“小泽”，不是两台设备均已接入新热点；无网络或硬件变更。新热点准备与连接待执行，具体读回和判定边界见[测试记录R4](测试记录.md#net-001-r4台式机已接热点jetson仍连原网2026-10-20)。

**2026-10-20 NET-001-R3目标热点更新：**用户将当前目标热点名称更新为 `chenjiajun`，并选择用Jetson直连显示器在本机查看网络信息；尚未把显示器接线或新热点连接写成已实测。代理本次只读仍为“小泽”/192.168.5.11/24、无检查点，原测试记录仍对应Hao.iPhone及历史地址192.168.180.181/24。仅更新试验目标与手册命令，未改系统WiFi配置、未切网或设置静态IP；chenjiajun的网段、网关及热点内互访待实际读回。

**2026-10-20 NET-001-R2实测网络追加：**用户完成首次trial并反馈Jetson接入平板热点，但平板不显示客户端IP。工具记录Hao.iPhone下获得192.168.180.181/24，随后恢复“小泽”/192.168.5.11/24；现有检查点为空，网页STANDBY。热点网关/DHCP池、网段跨重启稳定性、热点内SSH/网页及锁屏/断上游仍待，尚未设置固定IP。没有新增接线、系统代理或Avahi配置变更；完整证据与恢复耗时见测试记录NET-001-R2。

**2026-10-20 NET-001-R1准备结果追加：**用户本地执行prepare后，代理只读确认Hao.iPhone客户端测试配置已存在、禁自动连接；Jetson仍在“小泽”/192.168.5.11/24，未切网、无检查点、网页STANDBY。工具已在桌面维护记录登记完整网络备份，详细证据统一测试记录NET-001-R1；热点密码认证、客户端互访、断上游/锁屏及回滚仍待实测。无新增接线、网卡、驱动或代理变更。

**2026-10-20 NET-001网络事实追加（无接线/驱动变更）：**用户提供平板热点名称 `Hao.iPhone`，确认无手机卡、上游连接“小泽”，台式机已接其热点且仍能SSH到处于“小泽”的Jetson；热点名称不作为iPhone或其他硬件型号证据。当前车端只读仍为 `wlP1p1s0`/RTL8822CE（驱动rtl88x2ce）、`192.168.5.11/24`、原网络默认网关 `192.168.5.1`；驱动配置读回 `CONFIG_IFACE_NUMBER=1`，未声明接口组合支持，不安排车端同时连WiFi并开热点。没有新增网卡或接入有线/USB恢复链路。新增180秒客户端切换工具仅离线验证，尚未实际切换、创建网络配置/备份或更改代理。用户报告热点拓扑下代理端口/Codex联网问题并要求暂不解决，作为用户反馈保留，未确认具体端口根因。硬件移动、锁屏/断上游与本地互访结论仍待现场；流程见[手册33.19](操作手册.md#tablet-wifi-mvp)。

**2026-10-15 CAM-005相机软件链路读回：**现有D435序列号 `213222078719`、固件 `5.12.7.150`、USB类型3.2；RealSense ROS 4.58.3、运行librealsense 2.58.4，CUDA驱动查询成功且可见1个设备。本轮未更换接线/端口、修改固件/SDK/系统配置或发送底盘/舵机命令；在隔离域87短时打开相机完成计算检查，结束后相机关闭。GPU实际执行证据与性能只维护[测试记录CAM-005](测试记录.md#cam-0052026-10-15-d435体素组件通信与gpu核实)，既有建图进程保留。历史94档外参仅用于处理路径，不确认本次实际姿态、尺寸或避障效果。

**2026-10-15 NAV-017-R9客户端反馈：**用户确认本次是电脑浏览器、页面一直前台，并补充先前小米平板浏览器与台式机电脑浏览器现象基本一样。两平台同类报错支持继续检查共同协议、车端和通信路径，不登记为某平台特有故障；window_blur历史事件单独保留，不据此否定用户对本次前台状态的反馈。R9新增局域网WebRTC数据控制路径与旧通道对照，不改硬件/系统/无线设置；部署与实机反馈统一测试记录R9，物理停车仍待现场确认。

**2026-10-15 NAV-017-R10反馈追加：**用户确认已显示WebRTC，随后仍报告`window_blur`停车，并明确目标仅网页遥控建图、希望减少不必要停止。车端该次撤销快照为松手静止（pressed=false）、有效心跳尚余约289.55ms，确认为窗口失焦规则触发；此前首次使能无有效心跳的失败单独保留。R10仅修改控制状态规则，不修改电机/串口/舵机/无线/系统设置；软件运动期限仍300ms，实际停止距离仍待反馈。

**2026-10-15 NAV-017-R10-OBS1追加：**用户反馈新版似乎不再退出，明确本人不在实物旁。代理只读日志和话题；约61.80秒31次采样均松手、软件速度命令零，额外一帧轮式里程计推算速度全零，当前保持已使能就绪。没有本次控制写入、重载或硬件配置变更；这些读数不替代实物停稳/方向/运动验收，完整时序和边界统一测试记录OBS1。

**2026-10-15 NAV-017-R11反馈追加：**用户仍报告概率性断联。旧版车端连接代次曾从21增加至33，操作者所有权断开会撤销使能；静止观察和软件回归不等于现场长期通信通过。隔离复现旧WebSocket2秒空闲回收连带关闭仍健康UDP，R11仅调整连接回收与诊断，Safety运动300ms截止/底盘/无线/系统配置保持；旧现场未记录关闭错误，不登记为硬件故障唯一原因。部署/后续现场证据统一测试记录R11。

**2026-10-15 NAV-017-R8软件部署状态追加：**用户确认关闭建图网页后，代理保存当前工程并重载现有用户服务；先由原硬件任务运行转为网页STANDBY，旧底盘/雷达/SLAM/门控进程退出，部署过程没有自动启动新硬件。随后网页客户端重新连接并启动真实任务，启动日志再次记录S1板端94/目标140.5°，没有实体角度反馈；代理未发本次启动/使能/行驶请求。车端地址读回192.168.5.11，客户端192.168.5.17，设备/浏览器身份尚待确认；真实连接仍有心跳撤销和350ms控制间隔。未改接线、串口参数、执行器配置或系统/无线配置，不把软件零命令当成实物停稳反馈。工程保全与部署/通信证据统一测试记录R8；支架实际姿态和物理停车仍待现场确认，启动安全流程仍见手册33节。

**2026-10-14 NAV-017-R7-PS1临时省电对照追加：**用户要求直接执行后，代理使用当前账号已有Docker管理权限完成车端运行中power_save的on→off→on对照，未扩大账号权限。原“小泽”连接已同目录完整备份、root:root/0600，桌面维护记录2026-10-14-02已追加；原连接内容逐字节不变、NM属性仍default，最终独立读回on。有效off60.057秒仍有7次控制断流，恢复on约66秒10次，车端输入健康、未使能、速度命令零；不采纳永久关闭，不把省电开关读回当成唯一硬件故障反馈。第一轮采样错位保留，严格时序/结果只维护测试记录R7-PS1。没有网络或硬件重启、实车使能/运动、新S1命令；临时容器已清理，旧工程保留。

**2026-10-14 NAV-017-R7平板前台通信追加：**用户确认平板已显示实时建图、控制已连接，并确认21:16～21:17始终前台、未锁屏/切网/手动重连。该静止窗仍有11次313～344ms控制消息间隔及一次断开/重连；车端输入与门控正常，未使能、速度命令零。当前客户端IP读回192.168.5.54（DHCP）、5GHz/5200MHz、车端信号-52dBm、省电on；平板ICMP探测平均约1.05秒/最大4.13秒，后来路由器对照平均9.15ms/最大185ms，两轮不同时。说明通信存在迟延，不指定唯一硬件原因。代理只读观察、未动系统/无线/执行器；省电对照因sudo需要密码尚未执行，备份/恢复步骤统一手册33.12，数据只维护测试记录R7。当前轮动力隔离或可靠架空、支架安全沿用用户R6确认，不推断具体隔离方式。

**2026-10-14 21:05 NAV-017-R6授权恢复追加：**用户明确要求开始执行，并确认“轮动力隔离或可靠架空，支架扫掠安全”；不推断具体隔离方式。代理保全FAULT/dirty=false/未使能现场后，正常退出旧任务、重载现有网页服务并单次启动新硬件任务。底盘启动日志再次记录S1板端94/目标140.5°发送值，未获得实际角度反馈；未发送真实使能或行驶命令。新雷达进程PID7273独占本次`/dev/ttyUSB1`，只读频率短窗约10.46Hz；约一分钟车端静止样本均RUNNING/CURRENT、未使能、速度命令零。三个旧工程已校验备份且原件逐文件保持，系统/服务定义/网络配置不变；平板重连、通信连续性与物理停车仍待。本次恢复与此前未转/FAULT按时间区分，详见测试记录R6恢复追加。

**2026-10-14 NAV-017-R6现场追加：**20:47启动日志读到雷达S/N `C1969A86C0E09CC4A2E09DF753443074`、固件1.28、硬件Rev5，健康回复OK；Express/10Hz为驱动模式与配置输出，不是转盘实测转速。用户随后确认圆盘没有转，ROS域31中只有sllidar_node占用本次解析的`/dev/ttyUSB1`，8秒扫描订阅无消息，45秒启动超时后任务FAULT且未使能。用户后来反馈“现在打开了”，直接扫描订阅已恢复，详细频率与时间证据统一测试记录R6；不把前后状态混为同一时刻，也不据此确认供电/接线/启动控制的唯一起因。代理仅只读订阅与查询，未重启硬件、打开串口或发送执行器命令；本轮启动日志中的S1板端94/目标140.5°仍只是原程序发送值，无实物角度反馈。网络停顿另列R6，不与雷达未转混为一因。

**2026-10-14 NAV-017-R5现场追加：**用户确认安卓Chrome换为小米自带浏览器后仍突然锁停。19:50:05/12/18原始日志均为操纵授权超时，雷达/轮式里程计当时新鲜；没有对应触控取消记录。当前网页客户端TCP对端读回192.168.5.54（DHCP，不作为固定地址），连接快照累计38次重传、TCP平滑往返约336.9ms；随后20次独立ping为0丢包、2.493/44.960/233.754ms最小/平均/最大。车端5GHz信号-49dBm、无线省电on为只读当前值，未修改网络。路由器20次ICMP有60%未应答，可能涉及ICMP限制，不能直接当作WiFi业务丢包率。另确认旧控制socket被后台Launch和硬件进程继承，已修复文件描述符隔离；通信抖动与页面卡顿贡献未完全区分。用户保存并结束后，工程20261014_200505_1933aa00四文件校验通过并备份，再重载网页待命；无代理实车使能/运动/硬件启动，物理停车与稳定拖动仍待。

**2026-10-14 NAV-017-R4平板环境确认：**用户明确日常浏览器为安卓平板的Chrome；Android和Chrome具体版本未提供。当前使用Pointer Events、指针捕获和摇杆区域touch-action:none；平台文档核对与离线事件模拟不等于该平板持续触控、锁屏/后台与实物停车已通过，现场兼容性仍待反馈。未改浏览器/系统设置，未启动硬件。

**2026-10-14 NAV-017-R3现场追加：**用户反馈R2后仍“使能后拉摇杆立即退出、取消使能”。原始车端日志确认撤销原因包含“浏览器前台心跳超时”和“操纵授权超时”；后者快照令牌年龄176.589948ms、请求间隔47.395837ms，雷达/里程计当时新鲜。随后雷达停止更新，约2秒后任务进入FAULT，具体硬件/链路原因未确认；不能将这个后续故障混同为触屏取消事件。软件将运动授权从签发后200ms改为300ms并同步网页心跳/新鲜度；这是软件配置变更，物理停车距离、实速与平板现场是否恢复仍待反馈。未由代理发送真实使能或行驶命令，原工程、现场状态和任务日志保留，证据见测试记录NAV-017-R3。

**2026-10-14 NAV-017-R2现场反馈与候选：**用户反馈平板操控基本可用，但持续拉动摇杆约1～2秒停车、顶部仍“控制已连接”，需要重新使能；这不是网络断开的现场确认。用户要求平板布局精简并增加更高速度。新增快速档命令候选0.18m/s、0.36rad/s，慢/常档保留、默认慢档；真实速度、方向逐项、物理停车距离及快速档未验收。测试期间已产生两份完整工程，最近`20261014_162654_db59f27d`四文件校验通过并额外备份；用户反馈已保存结束，代理随后实际读到FAULT/dirty=false/未使能而非STANDBY，先保全工程与故障日志，再关闭残留任务并重载网页待命。传感器停止更新的具体原因未确认，未重新启动硬件或发送行驶命令。详情见测试记录NAV-017-R2。

**2026-10-14 NAV-017-R1测试前现场反馈：**用户明确当前四轮落地、轮动力接通，尚未隔离；没有本轮架空或断轮动力的现场确认。当前网页待命，尚未启动真实硬件；先做页面/重连检查，隔离轮动力或可靠架空后再做静止检查。端口占用检查已纠正工具参数并重新只读核实，详情与证据见测试记录NAV-017-R1追加修订；不把早先用法错误的退出码当成空闲证据。

**2026-10-14 开机网页前提只读核对（NAV-017-R1，无硬件/登录配置变更）：**车端GDM配置`AutomaticLoginEnable=true`、`AutomaticLogin=jetson`；实际本地X11会话来自`gdm-autologin`，用户systemd/default.target运行中，`Linger=no`。因此本轮网页用户服务依赖现有桌面自动登录，不等于无需登录的系统服务；未执行Jetson重启。旧`ruicom.service`当前inactive/dead/disabled，两个串口链接存在且本次检查无人占用。仅软件流程完善，不新增实物方向、支架角度、供电阈值或停车结论；硬件现场验收前提见手册33节。

**2026-10-14 NAV-017 RGB链路现场确认：**用户确认平板可访问“小泽”局域网页面，并在独立RGB相机启动后确认画面可见，随后要求关闭。D435序列号213222078719，本轮驱动打开Color/RGB8/640×480/6 FPS；短窗源话题观测约6.035～6.038 Hz，网页JPEG为640×480、HTTP200且源帧ID推进。由此确认本轮“相机→压缩→网页→平板显示”链路打通，不扩展为长时间稳定性、端到端帧率/延迟、视频断流停车或移动通过。只启RGB，不发S1、不启底盘/雷达/深度；已按用户要求停止相机，设备文件无占用，网页保留。退出与启动警告原样保留于测试记录NAV-017。

**2026-10-14 使用范围调整（用户确认，无硬件/网络配置变更）：**用户缩小建图场地，限定在现有“小泽WiFi”覆盖内，小车、平板及电脑都连接“小泽”；本阶段取消热点创建、切换及恢复验收，已有热点资产只保留备用。当前只读网络仍为“小泽”/`192.168.5.11/24`，IP是DHCP读回而非固定承诺。平板实际连接/可互访及覆盖边界待现场验证，不能把用户选定的接法写成无线覆盖测试通过；地图/视频/停车保护与保存续建要求保持。

**2026-10-14 单网卡并发只读核对（NAV-017）：**当前RTL8822CE，驱动绑定名`rtl88x2ce`、模块`rtl8822ce`，内核`5.15.148-tegra`。`iw list`列出`managed`和`AP`，但明确返回`interface combinations are not supported`；当前只有一个无线接口`wlP1p1s0`，连接“小泽”的5 GHz信道40。已确认的是当前驱动未通过标准接口声明AP+STA并发，不能把支持两个单独模式解释为能同时运行；不是对该芯片所有驱动或未来配置作绝对否定。现入口在同一接口切换模式，仍会中断原WiFi。没有创建虚拟接口、切换网络或更换驱动，热点稳定性仍待现场试点。原始输出`log/mapping_wifi_capabilities_20261014.txt`，完整操作仍见手册33节。

**2026-10-13 平板随行建图需求与只读核对（NAV-017，未实施硬件/系统变更）：**用户选择小米平板6随车、保持可视，覆盖同一楼层走廊/房间/大厅；浏览器同时查看二维地图、当前激光、估计车位和RGB。已确认软件环境网卡RTL8822CE/rtl88x2ce、接口`wlP1p1s0`声明支持AP，现网为`192.168.5.11/24`，NetworkManager 1.36.6；网口`eno1`声明千兆能力但未接通。上述只证明能力声明，不证明热点启动、距离、遮挡稳定性或平板兼容。采用现有网卡的独立热点试点，固定地址10.42.0.1/24及2.4GHz/WPA2均为候选，未创建或启用。新增慢/常档命令上限与RGB-only 640×480/6 Hz候选，不写成实测速率；停车距离、实际方向及新组合稳定性待现场反馈。用户已明确同意仅网页交互使用必要JavaScript，车端新逻辑保持C++。完整流程见[手册33节](操作手册.md#33-平板随行建图nav-017)，结果见测试记录NAV-017。

2026-10-12现场状态补充（未实施硬件变更）：用户不能确认相机是否被手动挪过，当前安装姿态及外参有效性列为待确认；用户确认车轮动力可以单独断开，仍需现场确认实际已隔离，不能把“可以断开”记为“已经断开”。计划以底盘已有S1=94初始化、零旋转参考地面采样复核；历史140.5°目标/94下发及约0.094°近场推算均保留为历史证据，无位置反馈。影响范围为D435安装TF与深度避障；当前没有新的舵机动作、尺寸尺量或导航实机通过结论。完整操作见[手册31.17](操作手册.md#3117-旧地图加d435导航的分终端复测2026-10-12)。

**2026-10-08 V2.4现场认可：**用户反馈目前效果较好，能实现基本深度障碍识别、体素及局部地图显示，要求归档推送。这是现有场景的定性实物反馈，不新增机械角度/高度、物体尺寸、接线或运动结论；本轮发布不改变硬件、舵机命令或正式外参。空地误标、2 cm/边缘/遮挡与完整Nav2移动边界继续见NAV-016-R2。

**2026-10-08 21:01重启后的现场前提：**系统启动时间实读21:01:37，原因与是否整车掉电未确认。用户确认盒子仍在原位、相机支架没动、四轮落地且轮动力隔离；恢复静止感知后，按要求完全移走盒子、手和人，确认车与支架没动。盒子正面约15.5 cm沿用此前尺寸，镜头前约0.7 m为本次摆放要求与粗略距离，不新增尺量结论。代理未打开控制串口、未发送舵机或车轮命令；最后历史下发94不能充当重启后位置读回。窄范围地面快照仅作软件TF参考复核，不确认执行器重复性。原始结果/失败与撤障统一NAV-016-R2，操作31.16。

**2026-10-08 静止体素复测配置：**用户要求的是RViz Frame Rate=100（渲染刷新），舵机仍保持已下发目标140.5°／板端94，本轮未重新打开控制串口或发送执行器命令。用户选择只验静止STVL。软件新候选由本次30帧近场地面计算roll约0.291386°、pitch约0.093673°和光心一致性高度158.830166 mm；高度不是机械尺量，x/y/yaw与完整外参仍未确认。实时中央近场高度均值约−0.215 mm，仅证明该范围参考一致，旧98候选保留不沿用。本轮过程/结果统一NAV-016-R2，操作31.16。

**2026-10-08 当前近平视基线：**用户反馈发生断电/重启或不确定硬件动了哪里，确认四轮落在水平瓷砖、轮动力隔离及中央清场。旧146.5°／板端98与约4.72°候选只作历史。用户授权小步调角并逐步记录后，既有C++键盘实际下发 **目标140.5°／板端94**，30帧估计下俯 **0.093674°**、范围−0.000719～0.188361°，作为本次中央近距近平视基线；初始命令未知姿态清场30帧估计6.2083°，旧混合场景6帧拟合失败保留。用户确认相机转动停稳、无碰撞/异响、车轮未动；键盘q退出、不再发S1，执行器仍可能保持力矩。无位置反馈，机械精确角、重启/往返重复性、x/y/yaw和边缘/低障碍仍未确认。相机/零旋转参考/点云及4话题桥保持，STVL/导航暂关；每步命令与原始数据保存，退出后读数及健康结果以NAV-016-R2为准，操作手册31.15。

**2026-10-08 当前角度口径复核：**最后有效记录为S1命令98；2026-10-07水平地面近距30帧估算相机光轴下俯4.7217°，退出后6帧约4.7232°。这是相对水平面的数据推算，不是舵机输出轴位置反馈；候选 `camera_extrinsics_ground98_reapproach_candidate_20261007.yaml` 仍verified=false，无位置反馈，完整档位重复性未通过。最初相机未运行，随后按用户点云显示请求恢复静止相机和旧候选TF，没有重新拟合角度或发送执行器命令，不确认当前机械角仍精确等于该值。对“现在位置差不多吧”的建议是保持用于静止联调，不登记最优避障姿态；未改变实物或正式TF。角度复核优先保持实体不动、只读拟合，说明及索引见手册31.13，点云显示操作31.14，结果NAV-016-R2。

**2026-10-07 对照期间整车转向修订：**用户确认整车连相机一起转向，相机与车体固定关系未变；不登记支架变更，不因此重设安装TF。转向前后的盒子/侧边观测坐标已变化，先前左侧区域不能作为后来场景同一物理ROI，High Accuracy去噪效果暂不判通过。原安装候选仍verified=false，不因这条反馈变为完整六自由度标定。当前只观察静止双盒场景、未由代理发送执行器命令；软件候选和原Custom备份可恢复，数据仅维护NAV-016-R2。

**2026-10-07 左侧假障碍现场对应：**用户明确确认按当前TF定位的镜头前约0.9 m、左侧约0.65 m处是空瓷砖。该独立小块可作为本轮假障碍样本；坐标来自软件候选TF，不登记为尺量几何或绝对高度。对应原生深度图左边缘、超出RGB主要视场；不能用两幅未配准图逐像素对应。保持现有姿态、轮动力隔离和双盒场景，去噪只调整深度软件配置，不访问执行器。

**2026-10-07 双图与当前场景现场反馈：**用户提供RGB、深度及STVL截图，确认两路参照已实际显示；画面中两只盒子可见，另一只尺寸和材质未量测。用户反馈移动正方形盒子后旧体素能正常消失，同时空地仍有小体素；撤障耗时和次数未量化，不登记完整验收。当前未改变相机支架、车体或执行器。软件取证发现镜头左侧边缘一个独立小块，其位置是否真为空瓷砖仍待现场对应；RGB与深度原生视场不同，不按RGB图中无物体直接判深度边缘为空场。实测结果只维护NAV-016-R2，操作31.10。

**2026-10-07 双图参照当前配置：**用户请求同时开启深度/RGB窗口用于认出实物。当前D435进程实读RGB enable_color=true、640×480/6 Hz（原关闭/30 Hz状态及失败保留），深度640×480/6不改；只启RGB传感器，无相机姿态或执行器动作。软件显示各320×240/1 Hz压缩参照，Hao用户目录补齐官方解码插件，域32 RViz实际订阅两路。该反馈只说明用户需要图像，未确认本次屏幕效果、像素配准或几何；组合健康与证据集中NAV-016-R2，完整开启/停止/恢复31.9。

**2026-10-07 当前显示现象确认：**用户截图并明确RViz体素/地图间歇消失、卡住或报错，未报告SSH掉线；当前桌面仍Hao/192.168.5.17。镜头/车体/执行器未由代理调整。只读网络短测存在丢包和百毫秒延迟，不作为USB/相机硬件故障已确认；软件显示候选现单向域31→32桥，车上保持原域31。当前显示密度上限10000点/1 Hz，屏幕改善仍由用户观察，健康与证据集中NAV-016-R2，完整操作31.8。

**2026-10-07 时间确认候选盒子复位：**用户已按要求将原正面15.5×15.5 cm盒子立起放回镜头前约1 m原位置，反馈“盒子已放稳”。此为当前盒子在场的现场确认，精确距离/厚度/材质仍不新增确认；代理只记录保持，不改变执行器或相机姿态。旧空场已结束，后续保持/撤障结果见NAV-016-R2，命令31.7。

**2026-10-07 卷尺移走后续测：**场景沿用用户最新反馈，盒子和手此前已移出视野、卷尺现在已拿开；代理未改变车体/相机或执行器。卷尺当时尺寸/精确位置仍待确认，不能把全部低格归给卷尺。新的只读记录仍复现少量低点标障，当前独立候选仅增加时间确认，不改变高度/TF或实体姿态；实机结果及未验事项集中NAV-016-R2，命令31.7。

**2026-10-07 卷尺现场更正：**用户随后补充此前有卷尺放在地上、忘记移走，现在已拿开。卷尺存在及现已撤除为“已确认”；尺寸/材质/当时精确位置、是否解释全部周边低点为“待确认”。此前关于该处始终空瓷砖的反馈已更正，旧空场不能直接验收；不能继续将单格确定为地面误标。需在卷尺及盒子都撤除后的新记录中核对同一位置，车体/相机和执行器不改变。旧记录与失败保留，数据NAV-016-R2，命令31.7。

**2026-10-07 18:11普通盒首次撤除确认：**用户已确认盒子和手完全移出相机视野，车体/相机/执行器未由代理改变；盒子尺寸和初始位置沿用正面15.5×15.5 cm、镜头前约1 m。新录包覆盖该动作并配对健康通过，目标清除已量化；周边另有低高度单格，按当前候选TF约在镜头前0.84 m、左7～10 cm，是否有脚/实物进入待现场确认，不将软件坐标或低高度判为实物根因。该点状态暂为“待确认”，空场周边与整轮未通过。实测NAV-016-R2，完整命令31.7。

**2026-10-07 普通盒续测末状态：**保持用户已报告的盒子及98档实体姿态，代理未打开控制串口、未发舵机或车轮命令。无跨机显示下相机+2秒STVL+录包600秒健康通过，三维/二维在场未发现丢标；本次等待撤除的300秒记录全段仍有目标、未收到现场撤除反馈，不能登记实物撤障通过。采样/录包正常结束，桌面RViz关闭（仅1 Hz显示也使本轮健康失败），车上只读静止环境保留，末次串口无占用。下一段先收到现场就绪再开启取证并通知移走；尺寸/材质/机械高度状态不因软件数据自动转正。结果NAV-016-R2，命令31.7。

**2026-10-07 STVL普通障碍物续测：**用户现有盒子立起后，从深度相机看正面为约15.5×15.5 cm的正方形；用户已放到离相机镜面约1 m的位置。厚度、材质、尺量起点精度、实际左右偏移及落地方式尚未逐项确认，不把盒子当作2 cm最低目标。当前沿用本次98档固定姿态，代理启动独立STVL静止地图及记录，不访问串口/执行器；新显示负载下出现健康失败，先保持盒子不动、撤掉新RViz显示做负载对照。实物保持/撤除尚未判通过，详细数据集中NAV-016-R2；当前操作见手册31.7。

**2026-10-07 空场选角结束状态：**已完成本轮实际逐档及一次往返，保留98档本次重新测量的静止近场候选，未改变正式外参/导航默认。键盘正常q退出，退出后短时地面复测一致、控制串口无人占用；最后发送98，舵机可能保持力矩，无实体位置反馈。只读相机/过滤/预览与唯一固定模型保持，模型使用`camera_extrinsics_ground98_reapproach_candidate_20261007.yaml`（verified=false）。先前95及首次98候选只作为对应姿态历史证据，不能替代当前复测；启动底盘/键盘再初始化94、断电或实体变动后须重新测量。一次98往返一致不抵消94同档变化，完整重复性仍待验；具体数据只维护NAV-016-R2，恢复模型见手册29.5/29.7。

**2026-10-07 空场选角范围更新：**用户询问是否可以不使用2 cm方块继续，当前先按水平瓷砖空场进行实际角度、中央地面覆盖和噪声对照，无需摆放方块。先前“等待方块后继续”只适用于目标检测，不能阻止空场选角。实体条件沿用用户已确认且说明基本未动的条件；前方约1.6 m之后有墙，不按3 m空地计算。用户提供台式机RViz截图并反馈点云目测非常贴近平面，当前实际显示已得到确认；斜视截图仍不能验收毫米级高度或完整TF。空场只能筛选安装角候选，2 cm目标检测、边缘与实物撤障仍待后续另验；不把无点解释为空闲。数据集中在NAV-016-R2，完整操作见手册29.5/29.7。

**2026-10-07 14:52等待目标摆放：**95档近平视候选已完成停稳多帧地面补偿及目标位置空场基线，真实方块摆放/实际距离尚未反馈；软件观测不代替物体在场确认。代理已正常q退出键盘、核对串口空闲，最后命令95，仍可能保持力矩，无实体位置反馈，不当作机械锁定。后续保持该姿态先只读测方块；禁止为恢复读数启动底盘或键盘初始化94。约5°、边缘及目标保持/撤障仍待对照，数据仅维护NAV-016-R2。

**2026-10-07 14:33继续实测：**用户补充“硬件基本都没有动”，要求沿用现场条件直接继续，不逐步重复确认。代理按此前已授权的轮动力隔离、扫掠/线缆及看护条件执行小步S1对照，俯仰由停稳多帧地面推算；实体异常由现场反馈，板端命令不视为位置反馈。当前uptime仍13:44:03，但前一轮相机/模型进程均已退出；按同一参数恢复静止链路并做短窗预检，不将历史PID当成运行状态。随后C++键盘初始化94，分两次目标步发同档94、下一档95；当前保持95，模型显式使用本次独立近平视候选verified=false，未发非零轮运动、未启底盘/地图/导航。等待2 cm陶瓷类方块的实际摆放及距离反馈，尚未计检测通过。执行/恢复见手册29.5～29.6，实际数据追加NAV-016-R2；所有原外参候选只保留相应姿态证据，实际调角后须另测另存。

**2026-10-07 13:44 手动重启续测：**用户确认本次Jetson重启为手动操作，不登记为自行掉电；uptime读到13:44:03，上一次运行节点均已退出。代理恢复同一静止相机/过滤/参考模型/1 Hz预览，未访问控制串口，ruicom仍inactive/dead/disabled；Hao的SSH短时不可达后恢复，低带宽RViz进程可见。重启前600秒窗口未完成、无summary且CSV末行截断，失败证据保留；新600秒窗口已通过，完整结果只见NAV-016-R2。墙前30帧另存当前独立地面一致性候选，verified=false；仅软件TF补偿，不证明舵机位置、机械高度或全部外参。重启后的实体安全/看护条件复核待回复，暂未发送S1。用户确认待测物为边长2 cm正方体、类似陶瓷材质；尺寸精度、表面是否有釉、目标实际摆放位置和检测率待确认。

**2026-10-07 启动后当前环境：**只读uptime确认Jetson本次启动于12:21:38，重启原因及执行器供电/姿态是否变化未确认；不能继续使用此前运行PID或历史94档作为当前位置证明。相机/过滤/模型进程已退出，D435仍USB3/5000M，视频与串口检查时无占用；ruicom在本次启动后仍inactive/dead/disabled。代理只恢复不访问串口的相机/模型/1 Hz预览，深度640×480/6 Hz、RGB关闭，主机Hao低带宽RViz仍在。当前光轴姿态由墙前地面重新估计，不沿用重启前候选。

**2026-10-07 当前场景范围修订：**用户最新明确“前方1.6米空旷，之后一堵墙”，并指出地面水平。本轮当前可见地面范围按这一事实收窄，先前0.5～3 m全部空地的前提不再用于当前窗口；墙距起点和尺量精度未提供。地面推算角度优先使用墙前中央0.5～约1 m，不将墙面或墙后异常深度当成地面。用户希望代理依据地面自动反馈仰俯变化，后续不逐步要求肉眼辨别亚度动作；现场仍需确认安全、车体静止、支架停稳及实物摆放。命令29.5/30.15，数据NAV-016-R2。

**2026-10-07 12:08 往返复测：**用户确认能连续观察，原看护/轮动力隔离条件继续保持。94初始化反馈“向上抬，正常”；重复94后增至95反馈“没有明显动作”；95→94回退明确反馈“相机镜头实际朝向地面更多”。与软件地面角变化方向不一致，原因待核对，不能把用户反馈改写为支架位移。键盘已q正常退出/串口释放，最后发94、可能继续保持力矩，暂不再转动；当前停稳/车体未动/线缆条件和空场需现场确认。模型为零旋转计算参考，回退98候选已失效；不启底盘/地图/导航。命令及停止29.5，实测仅NAV-016-R2。

**2026-10-07 调角重复性待确认：**S1逐档采样后，相同98档首次地面推算下俯4.863°，99→98回退后30帧7.106°，退出键盘后6帧7.115°；差值超出帧间波动。键盘已正常退出并释放串口，最后发送98档，可能继续保持力矩；用户随后确认当前“正常”，补充回退方向“没看清”，未确认是否有人触碰。现场可准备2×2×2 cm方块，材质/摆放未确认。暂不继续转舵机或选定最优角度，机理和实物检测待验；实测数据仅维护NAV-016-R2，完整命令29.5。151.367 mm仅为当前近距地面一致性补偿高度，不登记为机械尺量。

**2026-10-07 用户授权当前姿态调角对照：**用户要求代理逐步调S1并依据数据反馈寻找相对较优姿态，确认现场可看护、扫掠无碰撞/线缆拉扯、舵机可正常供电并能立即断开舵机实际电源；车轮动力保持隔离。现有C++键盘入口初始化94档后，用户确认相机停稳、支架线缆正常、车轮未动；94→95档用户进一步确认“向下俯，现场正常”，后续允许小步采样。档位仅表示已发送命令，无位置反馈；本轮测得95档约下俯1.04°，不能沿用1.5°/档命令估计作为实际TF。调角前的−6.606°候选不能继续作为新姿态有效外参。用户补充中央1～3 m为瓷砖、无明显反光、没有低物体，未确认具体光照条件。用户说明手量光心高度不稳定，165 mm仅保留调角前粗量，不据它声称毫米级机械高度；后续多帧地面一致性高度补偿单独标记，不能混为尺量。完整调角操作见手册29.5，数据追加NAV-016-R2。

**2026-10-07 当前查看电脑：**用户确认有笔记本和台式机，笔记本hao@bao在公司，当前用台式机luhao@Hao开发。本地只读输出为hostname=Hao、wlp4s0f0=192.168.5.17/24、docker0=172.17.0.1（DOWN）。当前RViz主机使用192.168.5.17，不能因笔记本历史192.168.5.36不可达而判断当前电脑失联；原“旧Hao为Windows”的记录不适用于本轮Ubuntu现场。Jetson免密SSH已连通，gnome-shell进程环境读到DISPLAY=:1、XAUTHORITY=/run/user/1000/gdm/Xauthority；当前屏幕实际显示效果仍需现场确认。完整主机命令集中在操作手册19节。

**2026-10-07 接手续测现场前提：**用户本轮确认四轮落地、车体静止、车轮动力隔离、相机支架停稳，中央前方0.5～3 m为平整空地；当前左红外光心离地粗量为165 mm。相对10月5日163 mm记录新增当前读数，不据2 mm差异判定安装改动或测量精度；当前机械角度、全六自由度外参及保持重复性仍待测。健康先行，暂不把165 mm写入正式外参。主机IP待现场读取，完整命令见操作手册19.0，数据结果追加至NAV-016-R2。

**2026-10-07 STVL现场反馈：**用户反馈完全移走物体后当前障碍可正常消失，未提供量化时间或重复次数；并回答相机相对10月5日姿态“调过，或目前不确定”。当前真实舵机角度及安装姿态待重新测量，10月5日固定外参不再作为当前已有效标定。代理本轮未打开控制板串口、未发送舵机/车轮命令；只读确认旧ruicom服务为inactive/dead/disabled，仍需正常重启复查。RGB临时开启已收到图像，但短时健康未通过，已恢复关闭；当前深度单流也存在时间戳/接收间隔异常。详见NAV-016-R2与手册31.6，不能据“能消失”进入移动导航验收。

**2026-10-06 STVL测试前只读复核：**旧比赛 `ruicom.service` 已恢复为 `active/running`，仍运行此前比赛程序；本轮未停止/重启该服务、未改服务文件或开机状态。相机设备在本轮短时检查未显示占用者，不能据此保证运行中的旧程序随后不会再次打开相机。独占实测前先按手册30.17临时停止旧业务；10月5日的 `inactive` 是当次状态，不作为今天启动前提。Jetson Wi-Fi地址本轮仍为 `192.168.5.11`；此前记录的bao `192.168.5.36` 本轮连接失败，当前RViz电脑IP待现场核对，不推断设备已损坏。

最后更新：2026-10-07

**2026-10-05 当前姿态落地确认：**用户确认四轮落在平整地面、车体静止、充电线断开、车轮动力隔离、前方中央空地无遮挡，并说明相机平视尚需调节；随后反馈中央常用有效范围内目前没有假障碍。本轮保持相机原姿态，没有发送舵机或车轮指令。零俯仰参考TF下地面斜率约-0.1127，独立候选pitch约-6.429763°、Z临时补偿+7.030 mm；这不是实际舵机反馈或尺量安装尺寸，不能据此确认机械平视。正式外参未改，候选及范围限制见[TF-006-R3](测试记录.md)。

**2026-10-05 远处场景补充：**用户进一步确认车体前方约1.7～2.0 m、中央线左右约15 cm的所问区域有真实物体。因此“中央空地”不代表整个2 m视野均为空地；该区域黄色体素不能直接归为假障碍。每个格子的具体实物对应仍需配准，不能从这一答复证明所有残留标记均正确。

**2026-10-05 本轮续测条件：**用户确认“保持当前姿态，暂未机械锁定”，随后确认“现在3m内是空的”。这代表新一轮场景已改变，不改写上一轮远处有实物的记录。用户进一步确认必须避开的最低障碍离地2 cm，粗量左红外镜头中心到地面垂直高度约163 mm；此高度与候选TF的162.03 mm近似一致，尺量精度未提供，不能据此写成毫米级外参已通过。仍无实际舵机位置反馈，支架保持能力待验。软件复核发现底盘`rosmaster_node`启动会无条件向S1发送94档，模型的固定TF选项不能阻止该动作；当前只运行不访问控制板的静止测量链路，尚未修改该底盘行为或接入导航。现有3 cm标障下限不满足2 cm需求，已准备未启用的近距1 cm阈值/单体素标记候选；正式默认保留。策略和入口见[手册30.16节](archive/操作专题原文_20261014.md#3016-保持当前舵机姿态分距离地面验收与转正门槛)。

**2026-10-05 超时专项补充：**相机实测为D435、固件5.12.7.150，当前USB3.2/5000 Mbps；这不证明供电或线材绝对正常。发现系统旧比赛`ruicom.service`反复重启并争用D435，用户已临时停止，状态`inactive/dead/enabled`；服务文件和开机设置未改，重启后可能恢复。停止争用后的原参数无头600秒仍有95条点云超时，可靠点云订阅同时可收到连续6 Hz帧，继续按传输链路定位，不归为外参错误。用户准备的最低目标为**2×2×2 cm正方体**，不是大面积低盒；用户报告22:09:45放稳、22:18:54移走；尺寸仍为用户反馈，实际量距起点/距离未回报。原始点云实测目标约x=0.51 m、y=−0.02～0 m，表面z约15～24 mm。识别与地图残留结论见NAV-015-P2D-R1，不按尺量50 cm或完整清障通过登记。入口与恢复边界见[手册30.17节](archive/操作专题原文_20261014.md#3017-相机独占点云超时定位与十分钟健康窗口)。

**2026-10-05 健康对照结果：**USB接线、固件和姿态未变；恢复原完整点云、仅加载进程内16 MiB共享内存后，连续600秒/6.002 Hz/3000条诊断0异常通过。本轮缺失定位于大点云传输，不将原默认3 cm阈值或外参改成已验收；正式默认保持。

只保留当前实物事实与未确认项。测试过程见 [测试记录](测试记录.md)。2026-09-08 过程明细见 [历史/2026-09-08-硬件变更明细](archive/2026-09-08-硬件变更明细.md)。两机联调命令只在 [操作手册第 19 节](操作手册.md#19-ubuntu-主机-rviz-联调)。

## 已确认

**2026-10-01 现场反馈：**用户反馈右前方零星黄体素，手动缓慢转动车体后仍不消失、可能增加，随后确认设备已重启。本轮再次确认相机平视固定、车轮动力隔离、充电线断开及所问右前地面无实物后，仅静止重开相机和独立 B 地图，未操作底盘或舵机。原截图的精确格坐标与具体家具部件未配准；新启动的右前观察区未复现原散点。bao 实际深度图/点云可见，但二维显示有着色错误，深度数据有短时健康异常，详见[测试记录 R12](测试记录.md)。本轮没有新增安装尺寸、外参或硬件可靠性确认值。

**2026-09-30 静止深度测试环境：**用户说明小车位于宽约 2 m 的走道，两侧有桌子和椅子；所附现场照片可见中央地面通道及两侧桌柜、椅脚和椅轮。宽度是用户估计值，照片不能用于量取实际净宽、相机覆盖范围或点云坐标。此前“残留射线后方 2～4 m 是连续平地”仅指相应方向的地面，不代表整个视野没有侧边障碍。B 候选的地面清障射线是否误清椅脚、椅轮等真实障碍，尚未现场验证。

**2026-09-30 远处地面现场反馈：**用户确认本轮左右残留射线后方、距相机约 2～4 m 的区域为连续平地。此项是现场地面条件反馈，不等于远端深度点的高度测量准确；射线端点低于地面的原因仍待区分外参残差与深度误差。静止测试期间相机平视停稳、未启动导航或车轮；正式外参和清障配置未据此改变。

**2026-09-28 S1 平视复核：**用户在确认扫掠空间安全、车轮动力隔离和舵机可紧急断电后，确认新底盘短时启动使相机平视停稳、车轮未动。日志发出板端94档；没有独立实际角度/扭矩/到位反馈，重复定位精度仍待测。用户随后把车放回平整地面、断开充电线做静止深度测试，结束前又移动车体且镜头前出现遮挡；那段深度不代表空地。默认零俯仰外参下地面仍有约 -0.115 斜率，2026-09-28 的 -6.546°仅为独立静止候选，正式外参不改。详见[现场交接](archive/2026-09-27-D435舵机与残留问题/2026-09-28-现场复测交接.md)。

**2026-09-27 S1 姿态修订（历史）：**用户重新启动键盘入口时相机明显转动，随后确认140.5°目标确实平视。旧底盘入口未发送 S1 初始化命令，此前相机姿态未先落实；不能据此确认当时电气扭矩状态。软件已补底盘启动平视命令及 C++ 关节命令估计；当时的实机自动初始化待验状态已由上方 2026-09-28 现场结果更新，重复定位仍待测。之前地面拟合-6.49°候选退出当前复测入口、保留证据。动态模型无实际反馈，仅限静止调试。问题归档见[本轮记录](archive/2026-09-27-D435舵机与残留问题/问题与下一步.md)，完整操作见手册第29节。

| 类别 | 当前事实 |
|---|---|
| 计算平台 | Jetson Orin NX，主机名 `xiaozhu`，Ubuntu 22.04 / ROS 2 Humble，原装电源。 |
| 两机联调（2026-10-01 当前） | 车 Wi‑Fi `小泽`。车：`jetson@xiaozhu` `192.168.5.11/24`，工程 `/home/jetson/luhao/my_nav_carcar`。当前查看主机：`hao@bao` `192.168.5.36/24`（DHCP 地址以 `ip a` 为准），本地 X11 `DISPLAY=:0`；原 `luhao@Hao` `192.168.5.17` 是另一台 Windows 主机。两端使用域31、`ROS_LOCALHOST_ONLY=0`、Fast DDS；`bao` 已配置单播文件、双向免密 SSH 和实体车模覆盖。真实深度图/点云可见；2026-10-01 当前硬件 OpenGL 4.6 启用 OccupancyGrid 时同样报着色器错误，详见 R12。车上不运行 RViz、正式导航或底盘。 |
| 控制板 | Yahboom Rosmaster，固件 V3.6，Python 库 V3.3.9，`car_type=1`（X3）。 |
| 控制板串口 | 稳定别名 `/dev/myserial`，115200，CH340/CH341；`ttyUSB` 编号随设备枚举变化，2026-09-23 实测指向 `/dev/ttyUSB0`，当前用户有读写权限。 |
| 声光 | 实机通过。蜂鸣器 `FUNC 0x02`（`set_beep`：0 关，≥10 ms 十倍数定时，常鸣值 1 禁用）；RGB `FUNC 0x05`（`set_colorful_lamps`）。低亮度 `30/255` 可用。C++ `navigation_indicator` 经 `/hardware/indicator/command` 由 `rosmaster_node.py` 隔离转发。 |
| PWM 舵机与 D435 | 舵机电气接控制板 S1，照片可见“20KG”标贴，为比 SG90 大的常规尺寸数字舵机；具体型号与外廓待量。用户粗量盒体质心相对 `base_footprint=(82,-30,145) mm`，输出轴中心为 `(90,0,145) mm`；模型暂以质心作为盒体几何中心。机械上通过黑色支架带动 D435 抬头/低头，橙色左右锁底板件固定舵机。标称舵机行程 0°～270°，与普通 180° 舵机使用相同控制脉宽范围，2026-09-23 用户反馈可正常驱动。相机安全命令范围为 **85°～160°**：约 85° 仰头接近竖直，160° 已低头到底，**严禁大于 160°**，否则碰撞。用户指定 **140.5° 为平视默认进行目标**；板端整数角量化后实际可达角及平视误差待测。端点精度与供电开关位置待现场确认。 |
| 舵机固定脚安装 | 用户照片确认两件橙色固定脚前后夹住舵机盒，双螺孔沿车体 Y 轴排列，带孔平底贴蓝色顶板。用户进一步圈定靠相机的前件绕车体 Z 轴翻转 180°；模型保持两件底面离地 135 mm，前件底面中心候选为 `base_footprint=(107,-30,135) mm`。模型孔位、前端外缘和螺钉装配尚未尺量复核，不作为已确认实物尺寸。 |
| 电机供电 | 板载闭环用 12 V 电机主供电；开关必须可触及。 |
| 轮位 | 已整体交换 M2/M4 一体插头：M1=左前、M2=左后、M3=右前、M4=右后。各通道电机与编码器仍属同一轮。四路编码器 A/B 已对调。 |
| 编码器 | 10 圈：M1=1319.2、M2=1317.9、M3=1319.2、M4=1319.2 count/rev；前进 Δ 均为正，符号全 `+1`。已写入 `wheel_odometry.yaml`。 |
| 板载 PID | `drive_mode=board_motion_pid`，`set_car_motion(vx,vy,wz)`。Flash：`Kp=8.0, Ki=1.2, Kd=0.8`。V3.6 映射补丁保留但不刷写。 |
| 临时验收接口 | 软件映射＋`set_motor()`：架空轮向/编码器/停车通过；PWM／临时 PI 带载不足，非正式控制。 |
| 运动模型 | 锁定差速：`holonomic=false`，`max_linear_y=0.0`。正式地面线速度确认值仍为 `0.15 m/s`；日常导航可显式加载 `navigation_fast_experimental.yaml`，把底盘上限临时覆盖为 `0.30 m/s`，**待分档实机确认**。默认 `base.yaml` 保持 0.18 m/s，`rosmaster_node` 用四路累计编码器发布 `/wheel/odometry` 与 `odom -> base_footprint`。 |
| 纯轮式 Odom | 前进 1 m、原地 360°、静止 30 s 零漂移通过。`base.yaml` 已启用。 |
| IMU | 板载 MPU9250。静止零偏 \|mean\|<0.0005 rad/s，std≈0.005 rad/s。驱动层 `imu_gyro_signs`/`imu_accel_signs`=`[1,1,-1]`。不参与当前融合。安装位暂估 `base_footprint=(-40,-15,75) mm`。 |
| 底盘几何 | 轮径 60 mm，轮宽 31 mm，轴距 120 mm，轮距 185 mm。 |
| 整车外廓 | 235 mm 长、230 mm 高属旧固定相机姿态；建模宽 216 mm、最小离地 10 mm。新相机平视时光心约 x=150 mm，车长和俯仰扫掠外廓待重测，旧尺寸不得作为当前净空依据。顶板 `220×130×10 mm`，用户复核顶面离地 **135 mm**（替代旧 140 mm）。 |
| 雷达 | RPLIDAR A1，`/dev/ttyUSB0`，115200，CP2102。扫描中心相对 `base_footprint=(-50,0,217) mm`。入口 `carcar_lidar/launch/lidar.launch.xml`。 |
| 模型 TF | 入口 `carcar_description/launch/description.launch.xml`；`robot.launch.xml` 与底盘组合。 |
| D435 | 2026-09-23 用户粗量舵机轴心相对 `base_footprint=(90,0,145) mm`，复核银色相机外壳左右中心线与舵机轴横向对齐；先前相对轴心 `(60,40,10) mm` 指的是用户正面观看时最左圆孔。依据[官方 D435 机械图](https://realsenseai.com/wp-content/uploads/2025/09/Intel-RealSense-D400-Series-Datasheet-October-2025.pdf)，深度原点为正面左起第三个的左红外光心，距外壳中心线 17.5 mm；当前平视候选为 `base_footprint=(150,17.5,155) mm`，横向值由用户外壳对齐量与厂家机械偏置推算，未完成六自由度标定。顶板顶面离地 135 mm。`camera_tilt_joint` 默认固定在平视候选姿态，`roll=0` 为照片/直播推断；无角度反馈时动态 TF 只按已发送命令估计、仅限静止调试，正式导航仍使用固定平视 TF。D435 正面从观看者左到右为右红外、投射器、左红外、RGB 彩色镜头；车上驱动的 `camera_link → camera_color_frame` 横向约 `+15 mm` 与机械图一致。序列号 `213222078719`；librealsense 当前为 2.58.4，realsense-ros 4.58.3。**2026-09-24 实机验证：**排查发现当前驱动内部将点云滤镜命名为 `Pointcloud (Neon)`，ROS 参数前缀为 `pointcloud__neon_.*`；在 `d435_navigation.yaml` 修正后成功启用点云输出。实测 `camera_navigation.launch.xml` 启动后原始点云 `/camera/depth/points`（~5.6 Hz）、障碍物点云 `/camera/navigation/obstacles`（~5.7 Hz，单帧约 2.2 万点）、清除点云 `/camera/navigation/clearing`（~6.0 Hz，单帧约 7.2 万点）均正常发布，`depth_cloud_filter` 健康诊断持续为 HEALTHY（延迟 ~14 ms），`base_footprint → camera_depth_optical_frame` TF 正常连通（平移 `[0.150, 0.018, 0.155] m`）。阶段一数据通路打通；阶段二（Costmap 深度层与动态导航）暂未进行，30 min 稳定性仍待长测。 |
| ChArUco 标定板 | 7×5 格，方格边长 30 mm，黑色标记边长 22 mm，字典 `DICT_4X4_50`；棋盘区域 210×150 mm。编码排列、打印尺度和平整度须在 TF-005 采集前复核。 |
| Groot | 已停用。改由 `nav_event_logger` / `nav_log_tool`。 |

**2026-09-27 固定姿态粗校验约定：**用户确认相机继续固定原约 140.5° 平视目标，全程不调舵机；这是本轮测试约定，不是实际角度或几毫米精度实测。现有普通尺量无法支撑毫米级绝对外参，改用地面、墙面、纸箱和雷达共同观察厘米级一致性。安装尺寸、正式外参和硬件接线本轮未改。入口见[操作手册第 27 节](archive/操作专题原文_20261014.md#27-d435-不用标定板的静止-tf-粗校验tf-006)。

## 待确认

1. NAV-003 原地定位、1 m / 90° 单点精度、取消停车、超时与障碍阻断的完整实机验收。
2. NAV-012-R9 的 0.22、0.25、0.30 m/s 分档峰值、停止时间/距离、定位偏差与最小净空；实验线加减速 0.45 m/s² 的带载响应和起步死区。
3. MOTOR-017 逐轮 50% PWM 正转的完整观察记录（10 圈计数已完成）。
4. 纯轮式 Odom 量化转角重复性复核。
5. D435 绝对深度与高帧率长时稳定性；Jetson UVC `-32/-71` 暂不作高负载通过。
6. 电池化学类型、容量、充电判据与低电阈值。
7. NAV-007 定位恢复成功率；NAV-010 左右绕行各五次等现场项。
8. 当前 `hao@bao` 的 `/costmap/costmap` 栅格着色正确性：2026-10-01 实际消息可到达、部分色块可见，但硬件 OpenGL 4.6 仍报着色器链接错误，显示验收未通过。旧机 `llvmpipe` 问题独立保留为历史；不能将任一显示异常解释为地图为空。
9. DRV-006 的 140.5° 平视默认进行目标对应的实际画面误差、85°/160° 附近机械间隙、重复定位误差和供电来源；旧 DRV-005 全行程实机入口已停用。
10. D435 当前 USB/UVC `-32/-71` 与 `RT IC2 Config error` 的连接或供电原因；先恢复稳定出帧，再进行 TF-005 粗标定。用户反馈无法用现有工具准确测出四轮轮心基准到标定板角点的毫米级位置；现仅有普通尺子，三点车体基准的绝对测量误差待评估。此反馈不改变已确认的轮心几何参数，也不构成新外参实测值。
11. 新相机平视前伸和 85°～160° 扫掠包络。现有 Nav2 footprint 前缘为 `x=0.14 m`，新模型平视镜头面粗量约 `x=0.15 m`；在实测扫掠包络并复核安全余量前，不把旧 footprint 当作新结构的净空保证。

## 最近变更

| 日期 | 变更前或现场反馈 | 变更后、影响范围与验证状态 |
|---|---|---|
| 2026-10-11（相机使用方案确认，非硬件变更） | 用户选择 A + C：导航固定相机角度，到点停稳后抬头拍照、保存并上传云端；第一版不做门状态或危险识别 | 仅更新[巡检设计](../src/carcar_inspection/README.md)及路线。未改硬件、接线、固件或正式参数，未发送舵机／轮速命令；导航角度、拍摄角度、回位重复性与模式切换仍待实现和实机验收。 |
| 2026-10-10（巡检声光需求，非硬件变更） | 用户确认使用 RGB 灯区分导航与采集／保存故障，并要求限时闪烁报警 | 仅更新[巡检设计](../src/carcar_inspection/README.md)，未改接线、固件、驱动或正式参数，未发送任何声光／舵机／轮速命令。现有基础声光实机记录保留；新的配色、闪烁及三秒蜂鸣整体效果待实现和实机验收。 |
| 2026-10-07（同档重复性续测） | 用户确认94初始化正常、95实体向下俯；当前无实际位置反馈，手量高度不稳定 | 小步上行及回退采样发现相同98档地面角不一致，正常停键盘/释放串口，最后发98；用户确认当前正常，回退方向没看清。未改接线/固件/系统文件，未发非零轮速或导航命令，正式外参保留；最优姿态、重复性、保持和实物检出率待验。 |
| 2026-10-07（授权调角对照） | 调角前姿态近距候选−6.606°；光心粗量165 mm，用户说明手量不稳定；中央瓷砖无明显反光、无低物体 | 用户授权并确认现场看护/断电条件；S1初始化94档后用户确认停稳、线缆正常、车轮未动。仅舵机姿态改变，车轮动力隔离，接线/固件/正式外参未改；每姿态重新测量并独立保存，不能沿用前一姿态标定。 |
| 2026-10-07（当前台式机） | 此前操作指向笔记本hao@bao/192.168.5.36，本轮该地址不可达 | 用户确认笔记本在公司，当前为Ubuntu台式机luhao@Hao；本地输出确认192.168.5.17/24。更新当前查看主机与手册19.0，不修改网络、系统文件或小车硬件；SSH/桌面显示待本轮核对。 |
| 2026-10-07（接手续测，NAV-016-R2） | 相机相对10月5日姿态调过或不确定；历史左红外光心粗量163 mm | 用户重新确认落地、静止、动力隔离、支架停稳及中央0.5～3 m平整空地，当前光心粗量165 mm。仅新增本轮现场前提，不修改正式外参、舵机命令或硬件；健康窗口仍失败，当前姿态TF待重测。 |
| 2026-10-05（固定姿态续测，TF-006-R4） | 用户确认保持当前姿态但未机械锁定；改为3 m空场；最低必避障碍2 cm，左红外光心离地粗量约163 mm | 未动舵机、接线或正式参数。两组各30帧分段统计确认近距残差小，2～3 m稀疏且偏低约2 cm；完整健康复测出现4条超时，不能验收。准备未启用的近距低障碍配套候选，真实2 cm物体、全视野、保持能力及运动仍待测；见手册30.16节、测试记录R4。 |
| 2026-10-05（落地测量，TF-006-R3） | 用户确认四轮落地、车体静止、充电线断开、动力隔离且无遮挡；机械平视尚待调节，当前中央无假障碍 | 保持实体相机姿态，未动舵机/底盘。新增独立外参候选pitch=-6.429763°、Z临时补偿+7.030 mm；只验证当前姿态近距地面，不作为安装尺寸或实际舵机反馈。正式外参不改。之前“四项门禁唯一证明落地平视”的规则停用，改为现场物理确认、地面几何测量及数据新鲜度分别验收，见手册30.15节。远距中央标记仍需实物对应。 |
| 2026-10-05（当天第三次记录，**并回溯作废 12:40 那轮**） | 用户确认：**12:40 做时间确认 A/B 时车辆同样是架在空中的** | 该轮 A/B 的几何前提不成立，全部绝对结论作废（含“永久残留 1736→449”“二维致命格 907→498”“丢失的 417 个致命格中 304 个为孤立格”）；仅“两臂在同一架高状态下对照、覆盖面素数 81002/80904 差 0.1%”说明两臂几何一致，因此“时间确认能减少无输入支撑的残留”在机制上仍可能成立，但**不能替代落地验收**。已按规则在[测试记录 R15](测试记录.md)追加修订说明而非改写原记录。**流程修订：四项判据（`中央区域≈3万`/`低于3cm≈3万`/`高度3~26cm=0`/`slope≈0.005~0.006`且有输出）确立为所有深度测试的开测门禁**，同时客观证明“车辆已落地且相机平视”。接线、外参、正式配置未改。 |
| 2026-10-05（当天第二次记录，**结论已更正**） | 用户反馈“比较低矮的区域没有比较好的消除体素”，随后补充**车子当时是架在空中的** | 离线审计：最低高度带 z=0.02~0.04 m 未覆盖率 52.8% 为各档最高；16:04 与 16:18 两次 `depth_snapshot` 分别为 `中央区域=62`、`中央区域=0`，`低于3cm` 均为 0，均无地面拟合输出（平视落地时应分别为约 3 万、约 3 万、有 slope≈0.005）。**更正：这些特征不能归因于相机俯仰角。** `base_footprint` 定义为地面接触投影，车被架高 Δ 后相机实际离地 `0.155+Δ`，最近可见地面距离从 0.375 m 变为 `(0.155+Δ)/tan22.45°`（Δ=1 m 时约 2.79 m），**单靠抬高就会让近处地面掉出视野并产生完全相同的三项特征**；深度图无法区分“抬头”与“架高”。因此上述 53 s 取证包与两次拟合结果**在车落地前都不作为俯仰、外参或清障算法的判据**。相机本轮只启动一次并正常退出，USB 未再卡死；未改接线、外参或正式配置。正确顺序：先落地 → 再确认舵机在 140.5° → 再按[操作手册第30.14节](archive/操作专题原文_20261014.md#3014-标障点云时间确认候选已完成-1-组静止-ab未推广)四项判据复核。 |
| 2026-10-05 | **用户反馈 S1 舵机当前不在平视位置**；相机此前因连续多次启停进入无帧状态，节点能初始化并上报 `RealSense Node Is Up`，但 `/camera/depth/points` 与 `/camera/navigation/obstacles` 均无数据（`Frames didn't arrive within 5 seconds`），反复重启无效 | 用户插拔相机 USB 线后 D435 恢复出帧（USB 从 `Bus 002 Device 035` 重新枚举为 `036`），复测 5.98/6.00 Hz、诊断 `HEALTHY`、帧超时 0。**舵机不在平视时，现有 `camera_extrinsics_floor_candidate_20260928.yaml`（按 140.5° 平视标定）失效，地面高度映射不成立，任何深度/清障测试都不能用该状态的数据。** 恢复平视按[操作手册第 23.2 节](archive/操作专题原文_20261014.md#232-实机按键测试)，恢复后用 `depth_snapshot` 的地面拟合斜率客观复核（平视时 slope 应接近 0，见[第30.3节](archive/操作专题原文_20261014.md#303-参数空场和箱子时间对照jetson-终端-c)）。接线、外参文件与正式导航配置本轮未改。 |
| 2026-10-01 | 用户报告手动转车时黄点残留，并确认已重启设备 | 登记物理运动与重启事实；独立地图没有车体运动 TF，不能将手动转车片段当静止清障验收。重启后静止复查有深度健康异常，未复现所选右前区残留；只修改 RViz 深度图显示，未改接线、外参、驱动或正式导航参数。 |
| 2026-09-30 | 用户改用新 Ubuntu 主机 `hao@bao`；旧手册的 `luhao@Hao` 与 `192.168.5.17` 不对应当前屏幕 | 确认新主机 `192.168.5.36/24`、Ubuntu 22.04、ROS Humble/RViz；配置双向免密 SSH、Fast DDS 单播和车模/RViz 副本，跨机文字话题通过，RViz 硬件 OpenGL 4.6 启动通过。相机、真实 Costmap 和栅格着色尚未实测；小车硬件及正式导航配置未改。 |
| 2026-09-30 | 现场走道宽度及两侧布置此前未进入清障验收边界 | 用户说明走道约 2 m 宽、两侧有桌椅；照片可见椅脚、椅轮和桌柜。仅更新环境台账与静止验收观察区；实际净宽、障碍坐标和 B 候选对侧边障碍的影响待测，硬件与正式配置未改。 |
| 2026-09-30 | 左右残留射线远端点低于当前 -3 cm 清障高度下限；远处地面条件待核实 | 用户确认对应 2～4 m 区域为连续平地；仅更新场景前提。端点负高度成因和 -30 cm 独立诊断候选的安全性仍待验证，硬件、正式 TF 与正式导航配置未改。 |
| 2026-09-28 | 上轮仅知键盘重发140.5°可平视，新底盘启动自动平视未验；旧俯仰候选可能受未初始化姿态影响 | 用户现场确认新底盘短时启动后相机平视停稳、轮子未动；恢复平地与断充电线后，默认TF地面仍倾斜，新增 -6.546°独立候选，不改正式外参。0.7m低盒与高箱静止对照已做；结束前车体被移动且镜头前有遮挡，后段地图无效。舵机实际角度/重复性、正式外参与移动避障仍待验收。 |
| 2026-09-27 | 用户反馈相机截至目前继续运行无问题，明确结束这部分并推进后续任务测试 | 按现场反馈记录固定平视相机接入与目视粗校验阶段通过，保留当前基线；没有明确计时，不记为完整 30 min 测试或毫米级外参通过。下一步只做独立静止深度 Costmap 标障/清障；移动导航仍待验收。 |
| 2026-09-27 | 用户首次静止深度地图反馈：垃圾桶有蓝点但始终无黄色，矮盒无明显蓝点 | 实时诊断发现测试层 false，开启后车上 voxel_marked_cloud width=2818；相机 HEALTHY。Hao 黄色显示、低箱原始深度/过滤原因仍待确认，不记为低障碍或自然清除通过。未修改硬件、TF 或生产阈值。 |
| 2026-09-27 | 用户同意放回低盒作只读采样；采集彩色、原生深度及实时 TF，三帧确认目标在场 | 原生深度可见低盒；当前 TF 中正前方 ROI 最高约 1.9 cm（3～26 cm 点数为 0），地面约 -5～-13 cm 随距离降低。这修订此前目视粗检的高度/俯仰结论，不否定接入成功。仅新增 pitch≈-6.49° 外参实验候选，位置及实际舵机保持，未加载或替换默认配置；候选必须现场复测，verified:false。 |
| 2026-09-27 | 用户加载俯仰候选后反馈低盒有蓝点/黄色，但移走后 voxels 不清除；截图 Raw Depth Height 位于 Camera TF 下方 | 实读光学TF四元数(-0.470894,0.470894,-0.527502,0.527502)，位置仍(0.15,0.0175,0.155)m；空场中央地面点29901/29923低于z=0，平均-8.64mm。追加独立清障候选，未改硬件/舵机/标障范围或默认外参；自然清除现场未通过。 |
| 2026-09-27 | 用户重启后再次无黄色，明确要求代理立即开启，今后默认开启 | 实读测试层 false，设置 true 后 get=True、体素width=2509。两个独立静止地图配置改为enabled:true，操作手册同步；未改硬件或外参，清障候选现场验收继续。 |
| 2026-09-27 | 用户补充显示器平面多视角截图，反馈“感觉差不多，感觉可以用” | 原始深度点云与激光在该平面目视基本对应，接受当前固定姿态作静止实验粗检基线。未测定量误差、完整九场景或移动避障；实际加载外参须保留记录，正式参数本次未改，仍未精确验收。 |
| 2026-09-27 | 用户提供 Hao RViz 截图：彩色图、车模、深度点云及雷达可见，垃圾桶附近轮廓有小间隙；用户判断可能只需微调 | 只确认静止查看已有现场画面，尚未测出偏差数值或确定来源。曲面桶不同高度截面与俯视投影可能造成间隙；需对比 Z≈0.217 m 的共同面及多距离平面。毫米级精度、外参修正量与雷达测距偏差均待确认，正式参数未改。 |
| 2026-09-27 | 用户选择固定原平视姿态，不用标定板进行静止 TF 粗校验 | 补齐专用 RGB/深度查看入口与 Hao RViz；不改变安装尺寸、正式外参或接线。用户估计仅余毫米级偏差仍待测，本轮现场厘米级一致性尚未验收。 |
| 2026-09-26 | 用户反馈本轮导航大部分正常，有前方空旷倒车与最后直角弯贴近倒车；接线、固件、安装未提供变更 | 会话 `20260926_222051_8376` 确认两处倒车前 `DATA_EXPIRED`，最后弯道另有近障无可行轨迹；软件新增同速 0.18 m/s 对照与净空候选，不改硬件默认参数。后续复测入口见[操作手册第 26 节](archive/操作专题原文_20261014.md#26-nav-012-r10-数据恢复与直角弯净空对照)。原始录包分析；修复后实车待确认。激光到软件包络距离非实物尺量，不能宣称已碰撞或外廓已验收 |
| 2026-09-24 | D435 导航点云接入阶段一实机验证：排查修复 `pointcloud__neon_.*` 参数名；验证原始/标障/清障点云发布与 TF 贯通 | 当前 realsense-ros 4.58.3 将点云滤镜识别为 `Pointcloud (Neon)`，旧参数前缀 `pointcloud.` 被静默忽略；在 `d435_navigation.yaml` 修正后成功出点云。实机测得 `/camera/depth/points` ~5.6 Hz、`/camera/navigation/obstacles` ~5.7 Hz、`/camera/navigation/clearing` ~6.0 Hz，`depth_cloud_filter` HEALTHY（延时 ~14 ms），`base_footprint → camera_depth_optical_frame` 正常贯通。阶段一数据通路打通，阶段二（Nav2 Costmap 与动态避障）待实测。 |
| 2026-09-24 | 用户圈出靠相机一侧橙色舵机固定脚，明确要求绕车体 Z 轴旋转 180° | 已只翻转前侧固定脚，并平移 STL 原点使其顶板平面中心仍为 `base_footprint=(107,-30,135) mm` 的底面中心；后件、舵机轴心和相机粗量 TF 未动。方向经离线模型和 RViz 核对，实物孔位仍待复核。 |
| 2026-09-24 | 用户提供舵机两侧橙色锁件的顶视 RViz 截图和实物照片，确认两个螺孔应横向并排、平底贴在蓝色顶板上，前后各固定一件 | 已把两件 STL 分别旋转并贴至顶板顶面离地 135 mm，竖边靠舵机盒前后端；独立固定 link 使 RViz 正确显示橙色。前件外缘按模型约超出顶板前缘 2 mm，螺孔中心仍在板内；真实孔位、外缘和紧固件待实物复核。 |
| 2026-09-24 | 用户提供黑色相机活动支架的 RViz 截图与实物照片，确认小端插入舵机转轴、大平面连接 D435 背面 | 发现此前 URDF 把支架 STL 绕竖直轴放反 180°；已修正视觉与碰撞外形，轴心和相机粗量 TF 不变。安装面的螺钉、实际接触间隙和俯仰扫掠仍待实物复核。 |
| 2026-09-23 | 用户复核 D435 银色外壳横向中心线与舵机轴对齐，先前 `Y=+40 mm` 实际指正面最左圆孔；另量得雷达黑色下底板底面比蓝色顶板顶面高 39 mm | D435 深度原点改按官方左红外偏置 `Y=+17.5 mm` 推算，旧 `Y=+40 mm` 保留在历史记录；相机外壳横向中心回到舵机轴。雷达蓝色支柱按 `39-5=34 mm` 放置，扫描中心高度 217 mm 不变；模型待 RViz 与实物复核。 |
| 2026-09-23 | RViz 车模截图显示四轮 TF 缺失、雷达支架疑似悬空；用户要求粉色舵机和蓝色雷达架 | 四轮缺失由当前无 `/joint_states` 发布者导致；模型检查发现雷达底板比已确认的顶板顶面高 5 mm，已修正几何和视觉颜色。雷达黑色底板到蓝色顶板的真实垂直高度待用户尺量，40 mm 蓝色支柱为临时模型值；未改变已确认的扫描中心 `(-50,0,217) mm`。 |
| 2026-09-23 | 用户补充舵机盒体质心 `base_footprint=(82,-30,145) mm`；原模型盒体视觉中心约 `(80,0,150) mm` | 已按质心修正舵机盒视觉与碰撞中心，并把橙色固定脚向车体右侧移 30 mm；输出轴 `(90,0,145) mm` 和相机粗量 TF 不变。盒体外廓及固定脚精确安装位仍待量。 |
| 2026-09-23 | 用户提供 IMG_8557～8562、黑色活动支架与两件橙色固定脚 STL，并复核轴心 `(90,0,145) mm`、平视光心相对轴心 `(60,40,10) mm`、顶板顶面 135 mm | 已更新模型与粗量默认外参；旧外参 `(130,33,170) mm`、旧顶板 140 mm、旧 `roll=pi` 保留于本变更记录。新 `roll=0` 来自照片/直播推断，舵机实际停位、支架位姿、外廓和动态 TF 均待实机验证。 |
| 2026-09-23 | 用户重新复插 D435；SDK 60 s 联合流与 ROS 约 2 min 复测 | 低负载彩色/深度持续出帧，SDK 超时 0；ROS 冷启动设备忙/USB 重置仍在，30 min 稳定性待验收。未动舵机或正式 TF。 |
| 2026-09-23 | 用户表示 D435 线缆应该已插好；再次试启同一低负载彩色＋深度配置 | USB 3 5000M 可枚举，启动后约 1 s 再次硬件复位，随后可重新连上并短时发布彩色帧；连接状态和持续稳定性仍待确认，未动舵机或正式 TF。 |
| 2026-09-23 | 用户确认 TF-005 固定 S1 进行目标 140.5°，目前只有普通尺子；同日试启确认 D435 能枚举，但 RGB＋深度启动约 1 s 后复位断流 | 粗标定须记录目标角与无反馈事实；CAM-003 稳定性未通过，未移动舵机、未更新正式相机 TF，先排查 USB/供电。 |
| 2026-09-23 | 用户指定 D435 平视默认进行目标 140.5°，并统一对接用语为“进行目标” | DRV-006 启动值改为 140.5°，键盘仍每键 ±1°、限制 85°～160°；板端只接受整数角，140.5° 会量化发送，实际平视误差待测。 |
| 2026-09-23 | D435 现由 S1 舵机带动俯仰；用户给出 85° 仰头、160° 低头碰撞边界和 135° 平视候选 | DRV-005 全行程实机入口停用，DRV-006 键盘入口收紧至 85°～160°、每键 1°；旧相机固定 TF 不适用于运动中的相机，平视与端点仍待实测。 |
| 2026-09-23 | 用户反馈 S1 舵机可正常驱动；新增 135° 中位键盘测试入口 | 接线未再变更。基本动作得到现场确认；端点精度、方向和供电开关位置待量化。 |
| 2026-09-23 | 用户新增 S1 PWM 舵机接线，确认 270° 舵机与 180° 舵机共用脉宽范围 | 仅登记实物反馈；新增独立 C++ 底层测试入口。未改控制板固件或正式底盘配置，实际行程待验收。 |
| 2026-09-23 | 新增 D435 外参标定与 Nav2 深度避障实验软件入口 | 未改相机固件、内核、USB 或实物安装；默认仍用尺量外参，VoxelLayer 启动关闭，待健康后动态启用；实机全待验收。 |
| 2026-09-22 | 新增导航专用 0.30 m/s 底盘覆盖；DWB 与平滑器同步 0.30 m/s、0.45 m/s² | 未改接线、固件或 PID；默认底盘参数保留，82 项导航与 46 项底盘测试离线通过，制动距离与定位待实车。 |
| 2026-09-18 | Hao Fast DDS 单播与 OccupancyGrid 着色失败 | 未改接线。组播时常看不到 `/map` 发布者；单播后地图能到，`llvmpipe` 画不出栅格。命令见手册第 19 节。 |
| 2026-09-18 | 登记 Hao：`luhao@Hao` / `192.168.5.17`，车上免密 SSH | 未改接线。RViz 用软件 OpenGL。命令见手册第 19 节。 |
| 2026-09-18 | 实验底盘 `max_linear_x` 临时 0.15→0.18 | 未改接线/固件/IMU。正式地面确认值仍为 0.15，待实机。 |
| 2026-09-17 | 板上默认 `use_rviz:=false` | 未改硬件。V2.0 为改用 Ubuntu 主机前最后快照。 |
| 2026-09-17 | NAV-012-R1 离线修复与 09-16 现场结论修订 | 未改硬件。`watchdog_stopped` 与红灯不能单独归因。修复版待实机。 |
| 2026-09-16 | NAV-012 实机恢复失败 | 未改硬件。电压 12.40 V，定位门控 true；失败在自定义恢复回调。原始记录保留。 |
| 2026-09-16 | TF-004 补 `robot_state_publisher` 与实验定位配套 | 未改接线/尺寸。离线 167 项通过，静止实机复验待做。 |
| 2026-09-16 | NAV-014 声光 5 模式落地 | 纯软件。离线通过，待实机。 |
| 2026-09-15 | DRV-004 声光协议与独立测试节点 | 实机蜂鸣/RGB 已通过（见测试记录）。 |
| 2026-09-15 | NAV-013 停车归因升级 | 纯软件。离线通过。 |
| 2026-09-14 | NAV-007～012 实验入口、膨胀校准、Groot 停用 | 纯软件。实验值待实机。NAV-004 地图实机通过。 |
| 2026-09-10 | 稳定入口膨胀 `0.18 m / 8.0`；速度上限 `0.18 m/s`、`±0.36 rad/s` | 写入 `nav2.yaml`，带载效果待验收。 |
| 2026-09-09 | NAV-002 实机通过；NAV-003 离线底座就绪 | 见测试记录。 |
| 2026-09-08 | A/B 对调、Flash PID、差速锁定、Odom 三项、IMU 符号校正、NAV-001 | 见上表「已确认」。过程明细见历史文件。 |
| 2026-09-07 | D435 倒装 roll=`pi`；底盘改板载闭环 | 闭环随后由改线与 PID 完成。 |

2026-10-07补充现场反馈：用户三窗截图确认原生深度、Depth Aligned To RGB及RGB参照可见，但仍认为不匹配，中间窗存在规则网格；不能登记配准精度实物验收通过。软件将配准目标改为320×240（原生RGB640×480内参binning=2），未改变实体安装关系/测距流。新屏幕效果待用户确认。交接前软件核对车上相关节点已退出、Hao RViz仍运行，退出原因待确认；不视为相机硬件故障。

2026-10-08现场反馈与显示修订：用户明确问题为“窗口大小不同”，同时确认只看范围最广的深度相关画面时体素基本匹配、STVL效果比较理想。已确认的是定性观察，不扩展为2 cm目标、完整外参或移动验收。SSH重新确认本轮现场桌面为 `luhao@Hao/192.168.5.17`，Jetson为 `192.168.5.11`，不沿用不在现场的bao。变更前旧三窗高度212/80/146像素，新增候选实际渲染区613×351、614×351、613×351；变更范围仅显示布局，实体安装、接线、舵机姿态、原生深度视场及STVL参数保持，当前轮动力隔离仍按交接安全前提使用。新视觉满意度待用户反馈，数据健康与证据见NAV-016-R2，操作见手册31.12。

2026-10-08视场认识补充（无硬件变更）：用户接受D435原生深度比RGB视场宽属于正常设计，继续保留原生宽视场点云供STVL，RGB配准图作实物参照。变更前为三窗含义仍有疑问，变更后为显示用途与导航数据用途已明确；不因该差异改舵机姿态、接线、流模式或安装TF。已确认的是用户接受此解释和已有内参记录；相机整体健康、完整TF标定与配准精度不由视场差异单独证明，原待验项保持。当前640×480参数与官方HD规格区别统一见手册31.11，修订记录见NAV-016-R2。

2026-10-12测角反馈补充：用户贴出depth_snapshot第5/6帧，实时第5帧有效深度112956点、中央626点，3～26 cm点为0、拟合RMS约0.5 mm。代理读取`log/nav016_pose_20261012_212758/`，下发档位记录94；保存27帧而非计划30帧，26帧近面拟合有限值、1帧NaN，有限值俯仰推算均值−0.190249°、范围−0.433235～+0.051219°（零旋转参考、按atan(slope_x)定义，不是位置反馈）。近面RMS0.349～0.522 mm，中央0.5～1 m共7222点、均高+4.804 mm；1 m外仅33点至1.024 m。未确认当前场地/供电隔离实际状态，采样结束及进程退出原因待用户确认；不判30帧完成、完整安装外参、全视野或导航通过，不调整舵机/正式TF。

2026-10-12后台复测及速度调整补充：用户明确轮动力未断开，要求由代理后台检查，并按已登记角度下发；本轮底盘实际发送S1=94，目标140.5°，仍无实体位置反馈。用户随后确认刚才雷达忘记开启、现已开启；恢复后收到laser_frame扫描，map→odom和定位门控恢复，不把原无扫描问题写成RViz按钮Bug。当前在线显示电脑实测为luhao@Hao/192.168.5.17，hao@bao/192.168.5.36本次不可达；软件已同步车模及100刷新轻量STVL配置到Hao，不改系统文件。用户反馈导航慢并明确要求当前行驶速度乘1.8，新增独立底盘/导航候选：前进上限0.10→0.18 m/s、平滑器/原地对准0.45→0.81 rad/s；这是软件配置与读回，不是实测速率或停车距离通过。保护倒车仍0.05 m/s，限速/联锁未转正；操作与回退见手册31.18。期间导航收到非代理发送的目标，记录有恢复倒车约0.09 m（里程计推算），不能当尺量实物位移；代理已取消任务。相机近场30帧窗口及后续遮挡/运动污染窗口、点云处理超时失败全部保留，见NAV-016-R3。

2026-10-12继续复测现场反馈：用户确认雷达当前没有旋转；软件驱动可读取型号、固件及health OK，但限时探针未收到扫描，不能推断旋转供电正常。已调用雷达start_motor服务并收到Empty响应，该响应不含实体转速或供电反馈。未改接线、供电配置或车轮控制；旋转恢复及扫描恢复须另行核对。相机恢复后60秒仍有一次POINTCLOUD_TIMEOUT，不登记全链路通过。
