tfsvh69-blip/Nav2_car/docs/待办事项.md

# 待办事项

最后更新时间：2026-09-06

只列仍会影响产品目标的工作。旧实验和已完成项见[测试记录](测试记录.md)。

## P0：机器人描述与 TF（现在做）

- [ ] 测量整车最大外廓：长、宽、高，以及离地间隙；用实测多边形更新 Nav2 footprint。
- [ ] 以 `base_link` 为原点，测量 `imu_link`、`laser_frame` 和 D435 `camera_link` 的
  `x/y/z/roll/pitch/yaw`。位置用米，角度记录时用度，同时注明安装照片观察方向。
- [ ] 确认雷达 0° 指向和旋转方向；在 RViz 用车前/左/右三个固定物体核对点云方位。
- [ ] 确认 D435 是否已到货、具体为 D435 还是 D435i、USB 接口和安装方式；接入后只由
  官方 `realsense-ros` 发布相机内部 TF。
- [ ] 更新 Xacro 后执行 `TF-002`：模型、TF 唯一性、雷达方位和相机光学坐标联合验收。

测量表：

| 对象 | x 向前/mm | y 向左/mm | z 向上/mm | roll/° | pitch/° | yaw/° |
|---|---:|---:|---:|---:|---:|---:|
| IMU 原点 | 待测 | 待测 | 待测 | 待测 | 待测 | 待测 |
| 雷达扫描平面中心 | 待测 | 待测 | 待测 | 待测 | 待测 | 待测 |
| D435 `camera_link` 安装基准 | 待测 | 待测 | 待测 | 待测 | 待测 | 待测 |

## P1：四轮运动与里程计

- [ ] 用同一个安全组合运动入口完成三项低速测试：前进、左横移、逆时针旋转；每项只确认
  方向、四轮编码器符号和停车，不再做 `MOTOR-005` 这类重复逐轮复测。
- [ ] 精确测量四轮输出轴每圈编码计数；可用每轮连续 10 圈一次完成，不要求堆叠实验。
- [ ] 将 `carcar_hardware` 的四个轮关节接入标准 `velocity` 状态/命令，并使用
  `mecanum_drive_controller`，轮位映射为 M1/M3/M4/M2。
- [ ] 地面只做直行 1 m、横移 1 m、旋转 360° 三项标定；达到导航所需误差后停止调参。
- [ ] 先使用纯四轮反馈完成里程计和唯一 `odom -> base_footprint`，验收前进、横移、
  旋转和静止漂移；此阶段 IMU 只发布和观察，不参与融合。

## P1.5：IMU 后置评估（不阻塞首次导航）

- [ ] 水平静止数十秒，采集 `angular_velocity.z` 并计算均值和标准差，分别记录零偏与噪声。
- [ ] 按 X 前、Y 左、Z 上固定车体坐标，人工逆时针旋转小车；必须观察到
  `angular_velocity.z > 0`。不满足时先修驱动轴映射或 `imu_link` 安装 TF，不改 EKF 参数。
- [ ] 水平静止检查 `ax≈0`、`ay≈0`、`az≈+9.81 m/s²`。当前仅有
  `|a|≈9.174 m/s²`，因此加速度标定尚未通过。
- [ ] 上述检查通过且纯轮式里程计、基础导航稳定后，建立第一版 `robot_localization`
  配置：只融合四轮里程计与经过零偏、单位、坐标轴和符号校正的 `gyro_z`；关闭 IMU
  姿态、全部线加速度和磁力计输入。
- [ ] 二维地面导航默认不融合线加速度；只有实测显示明确收益时才单独立项。
- [ ] Madgwick、线加速度和磁力计均作为后置独立实验；每次只增加一种信息源并与上一版
  对比，不一次性全部启用。

## P2：导航巡检

- [ ] 使用 RPLIDAR A1 建图，障碍/射线范围按实测最大 3.0 m 设置。
- [ ] 验收重启定位、单点导航、动态避障，然后用 Waypoint Follower 完成多点循环。
- [ ] 在巡检点执行等待、拍照和状态记录；任务失败支持暂停、跳过或返回充电点。

## P3：D435 自主充电

- [ ] 确认充电桩机械触点、对接方向、容许横向/角度误差和硬件防反接。
- [ ] 标定实际电池类型、满电/低电电压和负载压降；当前电压可读，但百分比和充电状态
  仍不能仅靠默认的 9.6～12.6 V 推算。
- [ ] 接入 D435 彩色/深度数据和 AprilTag 桩位姿；在 0.3～1.5 m 近场验证识别稳定性。
- [ ] 基于 `opennav_docking` Humble 分支实现预停靠、视觉精对准、接触、充电确认和重试。

## P4：Web 产品化

- [ ] 定义受限 API：遥控、急停、任务、位置、电压、充电状态、告警、相机预览。
- [ ] 使用 `rosbridge_suite + roslibjs` 接入；WebSocket 不直接暴露公网，加入登录、HTTPS、
  权限、命令频率限制和断线停车。
- [ ] 手机竖屏完成遥控和状态页，再增加地图点位编辑、巡检历史和设备管理。

## 已取消的低收益工作

- `MOTOR-005` 不再作为进入下一阶段的门槛；`MOTOR-004` 已足够确认轮位和机械方向。
- 不继续发展双轮差速正式架构。
- 不在 2D 导航完成前引入 3D SLAM、复杂视觉规划或完整 Web 平台。
- 旧脚本、配置和测试记录保留，用于故障回归，不由正式 bringup 启动。
