tfsvh69-blip/Nav2_car/docs/硬件实测记录.md

# 硬件实测记录

> 已停用（2026-09-06）：这是旧工作空间和 ROS 2 Jazzy 阶段的雷达专题，正文中的
> `/home/hao/luhao/ros2/my_nav2_car`、`/dev/ttyUSB0` 和 Jazzy 命令不得用于当前 Jetson。
> 当前硬件事实已合并到[硬件台账](硬件台账.md)，Humble 完整命令见
> [激光雷达 Humble 迁移与测试](激光雷达Humble迁移与测试.md)。保留以下原文只为追溯，
> 不再继续维护。

本文档长期记录巡检小车各硬件模块经用户确认的实际能力、限制和兼容性结论。理论规格、软件配置和实体实测必须分开描述，避免后续开发误用未经验证的数据。

## 记录状态

- **用户确认**：用户依据实体硬件测试明确给出的结论，可用于当前工程设计。
- **软件配置**：从驱动、参数或日志读取的信息，不代表实体性能已经验证。
- **待验证**：已有线索但尚未得到明确实体测试结论。

## 激光雷达

### 设备与连接信息

| 项目 | 当前记录 | 状态 |
| --- | --- | --- |
| 设备系列 | 早期 SLAMTEC/RoboPeak RPLIDAR A1 | 待完成精确型号确认 |
| USB 转串口 | Silicon Labs CP210x，USB ID `10c4:ea60` | 用户环境日志确认 |
| 默认设备 | `/dev/ttyUSB0` | 软件配置，可能随插拔变化 |
| 串口波特率 | `115200` | 通信实测可用 |
| 固件版本 | `1.28` | 驱动日志确认 |
| 硬件版本 | `5` | 驱动日志确认 |
| 设备序列号 | `C1969A86C0E09CC4A2E09DF753443074` | 驱动日志确认 |
| 健康状态 | `OK` | 驱动日志确认 |

### 性能结论

| 日期 | 结论 | 测试条件 | 状态 |
| --- | --- | --- | --- |
| 2026-09-01 | 当前雷达稳定读数范围为 **0.10～3.00 m** | 场地、目标材质、照明和扫描模式待补充 | 用户确认 |
| 2026-09-01 | 驱动在扫描模式信息中报告最大量程 `12.0 m` | 这是驱动/固件声明值，不代表稳定实测范围 | 软件配置 |
| 2026-09-01 | `Standard` 模式可启动，采样率约 `2 kHz`，`/scan` 约 `12 Hz` | ROS 2 Jazzy、`sllidar_ros2` SDK 2.1.0 | 实际运行日志确认 |
| 2026-09-01 | 固件支持 `Standard`、`Express`、`Boost`、`Stability`，不支持 `Sensitivity` | 由驱动枚举扫描模式得到 | 实际运行日志确认 |

当前工程默认选择 `Express` 模式以提高每圈采样密度，但其稳定距离和长期运行表现仍需单独复测。

## 常用命令速查

以下命令均从工作空间根目录执行：

```bash
cd /home/hao/luhao/ros2/my_nav2_car
```

### 检查雷达连接

```bash
./scripts/check_lidar.sh
ls -l /dev/ttyUSB*
lsusb | grep -Ei 'CP210|Silicon Labs|RoboPeak|SLAMTEC'
```

如果 `/dev/ttyUSB0` 存在但当前用户没有权限，长期解决方法为：

```bash
sudo usermod -aG dialout "$USER"
```

执行后注销并重新登录。仅用于临时测试时可以执行：

```bash
sudo chmod a+rw /dev/ttyUSB0
```

不要使用 `sudo` 启动 ROS 节点或 RViz。

### 构建与启动

```bash
./scripts/build.sh
./scripts/run_lidar.sh
```

雷达不是 `/dev/ttyUSB0` 时，显式传入实际设备：

```bash
./scripts/run_lidar.sh /dev/ttyUSB1
```

### 加载 ROS 2 环境

新终端执行 ROS 2 命令前先运行：

```bash
cd /home/hao/luhao/ros2/my_nav2_car
source /opt/ros/jazzy/setup.bash
source install/setup.bash
export ROS_LOG_DIR="$PWD/log/ros"
```

### 检查扫描数据

```bash
ros2 topic list
ros2 topic info /scan --verbose
ros2 topic hz /scan
ros2 topic echo /scan --once
```

预期 `/scan` 类型为 `sensor_msgs/msg/LaserScan`。查看雷达当前参数：

```bash
ros2 param get /sllidar_node frame_id
ros2 param get /sllidar_node scan_mode
ros2 param get /sllidar_node angle_compensate
ros2 param get /sllidar_node scan_frequency
```

### 检查坐标变换

```bash
ros2 run tf2_ros tf2_echo base_link laser
ros2 topic info /tf_static
```

RViz2 的 Fixed Frame 应为 `base_link`，LaserScan Topic 应为 `/scan`。

### 手动选择扫描模式

停止已有雷达进程后启动 `Express` 模式：

```bash
ros2 launch inspection_bringup lidar_test.launch.py \
  serial_port:=/dev/ttyUSB0 \
  serial_baudrate:=115200 \
  scan_mode:=Express \
  use_rviz:=true
```

需要排查兼容性时切换到 `Standard`：

```bash
ros2 launch inspection_bringup lidar_test.launch.py \
  serial_port:=/dev/ttyUSB0 \
  serial_baudrate:=115200 \
  scan_mode:=Standard \
  use_rviz:=true
```

若只验证数据、不启动 RViz：

```bash
ros2 launch inspection_bringup lidar_test.launch.py use_rviz:=false
```

### 构建与测试检查

```bash
colcon test
colcon test-result --verbose
```

## 待补充测试

- 分别记录白墙、黑色物体、玻璃和高反光表面的有效距离与丢点比例。
- 确认 `Express` 模式下的稳定发布频率、有效点数和连续运行温度。
- 测量雷达实际安装高度、朝向以及相对 `base_link` 的变换。
- 确认稳定范围测试时的供电方式、电机转速、环境光和目标尺寸。

## 维护规则

1. 用户给出明确实测反馈后，当次更新对应模块、日期和复现命令。
2. 不确定的测试条件填写“待补充”，不根据经验猜测。
3. 理论规格不得替代实体实测结果；两者不一致时同时保留并说明用途。
4. 结论变化时增加新记录，不静默删除旧结论。
5. 实测中确认有效的命令同步维护在“常用命令速查”，失效命令应及时修订并说明替代方式。
6. 后续底盘、深度相机、电池和计算平台均在本文档新增独立章节。

## 变更记录

| 日期 | 变更 |
| --- | --- |
| 2026-09-01 | 建立硬件实测记录；录入激光雷达稳定读数范围 0.10～3.00 m。 |
| 2026-09-01 | 增加雷达连接、权限、构建、启动、话题、TF、扫描模式和测试命令速查。 |
