tfsvh69-blip/Nav2_car/docs/历史/2026-10-01-深度离群点与清障机制调研.md

# D435 深度离群点与清障机制调研

日期：2026-10-01。性质：官方资料与固定版本源码调研；不是新增实机通过记录。本文不作为启动入口，操作仍以[操作手册](../操作手册.md)为准。

## 1. 本轮可作出的判断

深度噪点可以成为错误标障的输入来源，因此值得检查。但“当前深度有误点”和“历史体素没有清除”是两个问题；仅凭黄色体素截图，无法确认原始深度是否仍在同一位置输出误点。需要将同一时间、同一空间区域的深度、标障点、清障观测、体素和二维代价关联起来。本文的滤波选择均为候选，不修改正式参数，不据此宣布右前散点根因已确认。

厂商确认 D400 每帧深度独立计算，输入图像的传感器噪声、照明、运动等会造成深度随时间变化；厂商提供后处理，且要求权衡主机计算与延迟。这里说明“有噪声机制”，不能证明本车某簇黄点来自其中哪一种。[RealSense D400 后处理白皮书](https://dev.realsenseai.com/docs/depth-post-processing-for-intel-realsense-depth-camera-d400-series/)

## 2. 调研版本、来源与复用边界

| 项目 | 固定版本 | 适配与来源 |
| --- | --- | --- |
| librealsense | `v2.58.4` | 本轮按此 SDK 标签核对 C++ 后处理。官方发布页标题标为 beta；本次不作升级或降级决定。[发布页](https://github.com/realsenseai/librealsense/releases/tag/v2.58.4)；[Apache-2.0 许可证](https://github.com/realsenseai/librealsense/blob/v2.58.4/LICENSE) |
| realsense-ros | `4.58.3` | 标签文档列出 Ubuntu 22.04 / ROS 2 Humble，并通过 `<filter>.enable` 提供滤波开关；发布标题亦为 beta。源码直接复用 SDK 滤波块，无需为比较另写相机驱动。[README](https://github.com/realsenseai/realsense-ros/blob/4.58.3/README.md#post-processing-filters)；[发布页](https://github.com/realsenseai/realsense-ros/releases/tag/4.58.3)；[Apache-2.0 许可证](https://github.com/realsenseai/realsense-ros/blob/4.58.3/LICENSE) |
| PCL | `pcl-1.12.1` | 本机 `libpcl-dev=1.12.1+dfsg-3build1` 已只读核对。以下为其 C++ 滤波 API，不假设 ROS 1 的 nodelet 命令可直接用于本项目。[固定标签](https://github.com/PointCloudLibrary/pcl/tree/pcl-1.12.1)；[BSD 三条款许可证](https://github.com/PointCloudLibrary/pcl/blob/pcl-1.12.1/LICENSE.txt) |

此次只作调查，没有复制上游实现、安装软件、改固件或启用节点。若后续集成，优先使用现有库接口；项目自定义部分限定为输入选择、参数校验、诊断统计和输出接口，仍使用 C++。

其他地图层按 Nav2 `1.1.20`、STVL `2.3.4` 核对，见第6节。它们的作用层次不同，不作为同一轮输入滤波的附加开关。

## 3. RealSense 自带滤波：分别处理不同问题

| 处理块 | 固定版本已确认机制 | 对当前问题的适用边界 |
| --- | --- | --- |
| Spatial | 按深度变化保留边缘，在单帧内沿横纵方向平滑；`alpha`、`delta`、迭代数控制效果。内部还另有 `holes_fill`，默认 0。[源码](https://github.com/realsenseai/librealsense/blob/v2.58.4/src/proc/spatial-filter.cpp) | 候选用于表面抖动。它没有“邻居太少就删点”的规则，不能保证删除孤立飞点；过强平滑可能影响细腿轮廓。做试验时必须显式关闭内部补洞，不能只看独立 `hole_filling_filter.enable=false`。 |
| Temporal | 跨帧平滑；无效像素可由历史值补上，默认 persistence=3，即过去四帧中有两帧有效时允许持久化。[源码](https://github.com/realsenseai/librealsense/blob/v2.58.4/src/proc/temporal-filter.cpp) | 当前正排查拖影与残留，首轮保持关闭。之后若单独评估，应先关闭历史补洞，并分别验证移动目标退出时的延迟；不能把该滤波当成“连续多帧确认新障碍”。 |
| Hole filling | 利用邻近有效深度填空洞。[SDK 说明](https://github.com/realsenseai/librealsense/blob/v2.58.4/doc/post-processing-filters.md#holes-filling-filter) | 生成的是估计深度，不能视作新的真实自由空间观测；本轮不启用。 |
| Decimation | 每轴缩小 2～8 倍；2/3 倍采用有效像素中值，更大倍数用均值，并重新计算内参。[SDK 说明](https://github.com/realsenseai/librealsense/blob/v2.58.4/doc/post-processing-filters.md#decimation-filter) | 主要降低后续数据量，不是保证保留细障碍的离群点剔除。当前 640×480 已是有限分辨率，首轮不叠加降采样；若负载确有瓶颈，再单独验证椅脚、椅轮是否丢失。 |

厂商建议双目深度平滑在视差域进行，并指出一般导航与避障应用可以保留无效深度空洞；滤波过强会删除场景细节。这支持本项目先保留真实观测边界，不以“画面填满”为验收目标。[RealSense 白皮书](https://dev.realsenseai.com/docs/depth-post-processing-for-intel-realsense-depth-camera-d400-series/)

SDK 文档明确提示时间滤波可造成模糊或拖影，主要适于静态场景。`realsense-ros 4.58.3` 的实现把空间、时间等处理放在点云生成之前，所以启用它们会影响下游标障和清障两条分支，不能描述成“仅去掉蓝色障碍点”。[SDK 时间滤波说明](https://github.com/realsenseai/librealsense/blob/v2.58.4/doc/post-processing-filters.md#temporal-filter)；[ROS 包处理顺序源码](https://github.com/realsenseai/realsense-ros/blob/4.58.3/realsense2_camera/src/base_realsense_node.cpp)

## 4. PCL：显式删除邻域支持不足的点

### 4.1 RadiusOutlierRemoval（半径离群点滤除）

机制：检查一个三维半径内是否有足够邻点，邻点不足则移除。对“空地上偶发出现、与真实表面分离的蓝色点”比较直接。PCL 1.12.1 对有序云使用有序邻域搜索，对无序云使用 KdTree；有效稠密输入使用有限近邻搜索判断半径，其余情况走半径搜索。[固定版本实现](https://github.com/PointCloudLibrary/pcl/blob/pcl-1.12.1/filters/include/pcl/filters/impl/radius_outlier_removal.hpp)

本项目推断与候选边界：

- 细桌脚、椅轮边缘、远处物体也可能邻点少；没有一组未经本场景测量就保证安全的半径与点数。
- 如在标障分支试用，可保留光学坐标和原始时间戳，先不改变现有 4 m 清障分支，使一次试验只回答“新误标是否减少”。仍须验证清障可靠性。
- 邻域支持应考虑高度/距离裁剪边界；不能先把一根细腿裁得只剩少量点，再把缺邻居直接认作噪声。
- 它不会改正整片地面因外参偏差而落入障碍高度带的问题；密集的错误表面也可能通过邻域检查。

### 4.2 StatisticalOutlierRemoval（统计离群点滤除）

机制：计算各点到近邻的平均距离，再按整份输入的平均值和标准差设门槛，剔除距离异常大的点。[固定版本实现](https://github.com/PointCloudLibrary/pcl/blob/pcl-1.12.1/filters/include/pcl/filters/impl/statistical_outlier_removal.hpp)

本项目推断：走道内同时有近处密集面、远处稀疏面和细腿，统一的全局统计门槛会受场景构成影响；对当前“特定位置稀疏假点”的诊断，半径及最小邻点数更容易对应物理尺度。因此将 SOR 作为次选比较，不作为第一轮默认。两者都需邻域搜索，不能未经 Jetson 实测宣称实时性能足够。

### 4.3 VoxelGrid 降采样不能自动等同于去噪

PCL VoxelGrid 将同一三维格内的点汇成重心；该版本 `min_points_per_voxel_` 默认 0。仅启用降采样时，只有一个噪点的格子仍可能输出一个点。显式提高最少点数才增加稀疏格筛选，同时也可能删掉细小真实物体。[固定版本定义](https://github.com/PointCloudLibrary/pcl/blob/pcl-1.12.1/filters/include/pcl/filters/voxel_grid.h)

此处 PCL VoxelGrid 是单帧点云处理，与 Nav2 保存占用历史的 VoxelLayer 是不同组件。

## 5. 当前推荐的验证决策

本轮不指定未经测量的滤波数值。首先以车体静止、现有 B 候选、相同桌椅场景获得有效基线；输入超时或时间戳失效的观察不能当作健康清障验收。无须摆盒、录 bag 或改变正式导航配置。

| 同一位置的观测 | 下一项候选 |
| --- | --- |
| 原始深度/蓝色标障点确实反复出现孤立误点 | 对标障点单独比较保守 ROR，核对每一处真实细腿/椅轮是否仍保留 |
| 连续表面主要表现为小幅深度抖动 | 单独比较 SDK Spatial，内部补洞关闭；记录对清障背景观测的影响 |
| 当前标障点已无误点，旧黄色仍在 | 先查清障覆盖、数据健康与地图记忆，不把增加前端滤波当作已验证修复 |
| 空地出现连续低矮面，邻域支持充分 | 先检查外参、地面高度分布与高度裁剪；ROR 无法识别“很密的错误地面” |

每个候选分别记录：已确认空地中新误标点/格的出现率、同一区域二维残留与三维残留时间、真实细桌脚/椅轮的可见帧比例、清障背景覆盖、输入时间戳年龄、处理耗时 p95/p99、超时计数以及 CPU/内存。6 Hz 对应约 167 ms 帧间隔，但不能据此假定增加处理不会积压；端到端延迟仍须满足本项目现有新鲜度约束。

通过条件是减少错误新标记，同时保留真实障碍、不中断有效清障、不恶化健康；“截图变干净”或“重启后没有旧黄点”均不足以证明通过。涉及物理运动的验证须另有真实运动 TF，不能在固定姿态链路中手动转车后将拖影归咎于深度滤波。

实施次序建议：先增加仅用于对照的 ROR 影子输出/统计，不给现有 Costmap 供数，不改变清障支路；验证被删点确实来自已确认空地，且可见真实细障碍保留后，再考虑独立标障候选接入。空间平滑作为另一项独立对照，不与 ROR 同时启用；本轮仅形成建议，尚未实现或实测该候选。

## 6. Nav2 与 STVL：去二维噪声、管理三维记忆是不同层次

### 6.1 当前 Nav2 VoxelLayer 的历史标记

固定版本 `1.1.20` 的 `VoxelLayer::updateBounds()` 先对清障观测射线追踪，再标记新的障碍，随后发布包含历史占用的体素网格；这些体素没有按等待秒数自动过期。新输入滤波可以减少后续误标，但不会直接删除此前网格中的旧标记。这是“可能存在噪点输入，同时仍需检查清障”的机制依据，不是本车原截图根因证明。[VoxelLayer 1.1.20 源码，文件为 BSD 许可证](https://github.com/ros-navigation/navigation2/blob/1.1.20/nav2_costmap_2d/plugins/voxel_layer.cpp)

### 6.2 Nav2 DenoiseLayer

本机 `ros-humble-nav2-costmap-2d=1.1.20-1jammy.20260910.004026` 的 `costmap_plugins.xml` 已列出 `nav2_costmap_2d::DenoiseLayer`，不需要假定只有较新 ROS 发行版才有。固定标签也包含该插件；其文件许可证为 Apache-2.0。[固定版本插件清单](https://github.com/ros-navigation/navigation2/blob/1.1.20/nav2_costmap_2d/costmap_plugins.xml)

`updateCosts()` 直接处理二维 `master_grid`，按4/8邻接关系移除小障碍组；默认 `minimal_group_size=2` 可以去掉孤立障碍格。它不修改 VoxelLayer 内部三维网格，因而不能保证黄色显示消失。[DenoiseLayer 1.1.20 源码](https://github.com/ros-navigation/navigation2/blob/1.1.20/nav2_costmap_2d/plugins/denoise_layer.cpp)

本项目取舍：仅当问题明确落到二维孤立假障碍且小实物保留得到验证后，再作为膨胀层前的独立候选；当前2 cm格中真实细脚也可能只有少数格，不能按面积小就认定是假障碍。它不是当前黄色体素问题的首选输入修复。

### 6.3 Spatio-Temporal Voxel Layer（STVL）

STVL 使用 OpenVDB 保存三维占用，并以时间衰减和传感器视场内加速衰减管理旧体素。核对固定标签 `2.3.4`；官方 Humble 发行清单对应 `2.3.4-1`、源码分支 `humble`、维护状态 `maintained`，许可证 LGPL-2.1。[2.3.4 README](https://github.com/SteveMacenski/spatio_temporal_voxel_layer/blob/2.3.4/README.md)、[包元数据](https://github.com/SteveMacenski/spatio_temporal_voxel_layer/blob/2.3.4/spatio_temporal_voxel_layer/package.xml)、[Humble 发行清单](https://github.com/ros/rosdistro/blob/master/humble/distribution.yaml)

本项目取舍：这是更换地图记忆策略的后续候选，不能证明传感器本身已去噪。衰减会遗忘一段时间未观测的真实障碍，单台前向D435在遮挡、转弯和掉线时的覆盖需重新验收；当前不以“黄色自动消失”为由切换。README 中仍有 ROS 1 历史命令，不直接复制到 Humble；采用时须另审固定 ROS 2 接口与许可证。本次未安装、加载或做性能验证。

## 7. 与本项目已有证据的对应关系

本轮软件只读核对得到：

- `src/carcar_camera/config/d435_navigation.yaml` 明确设置 Spatial、Temporal 和独立 Hole filling 开关为 false。
- `src/carcar_camera/include/carcar_camera/depth_logic.hpp` 的 `classify_point()` 按单点有效性、距离、高度与车身包络筛选，没有邻域支持或连续帧新障碍确认；`depth_cloud_filter.cpp` 将通过标障条件的点直接加入蓝色输出。因此孤立误点只要满足范围条件，就有进入体素层的通路。
- 标障和清障保留原光学坐标及时间戳，通过 TF 使用测量原点；候选不应为了实现滤波改变这一语义。
- 本机 PCL 1.12.1 的开发包、过滤库与 ROR/SOR 头文件已存在，说明具备离线接入条件，不等于候选已构建或性能通过。

上述事实证明目前缺少专门的离群点筛选，不能证明用户截图中的孤立黄色格就是孤立原始点。一个黄色体素可能由许多深度点形成；地面被错误投影成低矮面时，也可能拥有很多邻居。

原截图状态已因重启丢失；R12 仅在16个定时统计时刻未见所选右前区域持续残留，区域没有与原图逐格对应，且出现时间戳失效/超时。详细数值仅在[测试记录 R12](../测试记录.md)维护。当前缺少同一位置“误点进入 → 被标记 → 射线能否清除”的可重复证据，故不能将文献机制写成实机根因或修复通过。

当前判断：噪点是有依据、值得优先验证的输入候选；同时保留地面外参误差、射线覆盖、固定地图下车体运动和数据新鲜度异常等解释。先在健康静止场景中获得同一批点的过滤前后对照；若只剩旧黄色而没有新的蓝色误点，应转查地图清障，不继续叠加滤波。

## 2026-10-07 适用于当前STVL场景的补充决策

| 方案 | 成熟接口与适用问题 | 本项目边界 |
| --- | --- | --- |
| PCL RadiusOutlierRemoval | 继续固定1.12.1/BSD-3-Clause，删除缺少邻点支持的点 | 复用既有C++影子/离线入口；稠密错误匹配也有许多邻点，不能凭黄色体素少就认为会被删除；不改变清障分支 |
| RealSense Spatial | 固定SDK2.58.4/ROS4.58.3、Apache-2.0，边缘保持深度平滑 | 独立候选2次、alpha0.5、delta20、内部holes_fill0；影响整个深度及标障/清障，不是只修改显示 |
| RealSense High Accuracy | SDK2.58.4的RS400枚举3；官方针对高置信度、低填充率，列出避碰与机器人用途 | 独立测距候选，不叠加Spatial；提高输入匹配置信度不等于已验证工业产品能力，减少无效深度不能作为空闲判断 |
| Nav2 DenoiseLayer | 本机Humble1.1.20插件清单及固定源码均存在，BSD；二维连通小簇过滤 | 可放在STVL后、膨胀前；不能去掉三维黄色体素，小簇门槛会删除真实2 cm目标，因此本轮未部署到地图 |

官方依据：[PCL固定实现](https://github.com/PointCloudLibrary/pcl/blob/pcl-1.12.1/filters/include/pcl/filters/impl/radius_outlier_removal.hpp)、[SDK固定滤波说明](https://github.com/realsenseai/librealsense/blob/v2.58.4/doc/post-processing-filters.md)、[官方D400预设说明](https://dev.realsenseai.com/docs/d400-series-visual-presets/)、[固定SDK预设枚举](https://github.com/realsenseai/librealsense/blob/v2.58.4/include/librealsense2/h/rs_option.h)、[Nav2 1.1.20 Denoise源码](https://github.com/ros-navigation/navigation2/blob/1.1.20/nav2_costmap_2d/plugins/denoise_layer.cpp)。调用既有库和设备SDK，没有复制上游算法或预设JSON。C++工具仅保存/恢复本机设备实际高级配置；不切换高级模式、不启动流、不复位USB，完整命令仅[手册31.10](../操作手册.md#3110-深度噪点定位与高置信度测距候选nav-016-r2)。

当前决策：深度与RGB原生视场不同，两幅未配准图不作逐像素对应；RGB中无物体不是深度侧边噪点证据。用户确认期间整车转向、相机与车体关系未变，因此原坐标滤波前后不满足同场景，效果只能待复验。当前独立High Accuracy候选供静止观察，时间确认/TTL/TF与原正式默认不改，数值和失败只记录NAV-016-R2。不能将补洞、提高高度、过滤小簇或周期清图用作绕过真实小目标验收的方法。
