tfsvh69-blip/Nav2_car/docs/历史/待办事项.md

# 待办事项

2026-09-07 最新修订：用户已决定建模宽统一为 216 mm，原 213 mm 差异不再作为待办。
IMU 已采用用户估计位置：相对 base_footprint 为 (-40,-15,75) mm，相对 base_link 为
(-40,-15,45) mm；位置为近似值、轴向待验证。无需拆车，按
[已装配整车传感器对照步骤](已装配整车传感器对照步骤.md)
执行；以下涉及拆车找芯片或等待宽度复核的旧说明由本修订替代。

最后更新时间：2026-09-07

只列仍会影响产品目标的工作。旧实验和已完成项见[测试记录](../测试记录.md)。

## P0：机器人描述与 TF（现在做）

- [x] 依据当前实车照片建立底盘、上层车体、Jetson、雷达、RealSense 和支架的参数化
  description；所有照片估算值集中标为临时值，未冒充实测尺寸。
- [x] 将用户导出的 5 个毫米制 STL 接入整车 visual，并保留轻量 collision 和原始源文件。
- [x] 测量整车最大外廓、离地间隙和蓝色顶板；已回填长 `235 mm`、宽 `213 mm`、高
  `230 mm`、间隙 `10 mm`。其中宽度与轮组理论外宽 `216 mm` 冲突，待复核；Nav2
  footprint 后续采用不小于 `216 mm` 的宽度；当前 Nav2 配置尚未更新。
- [ ] 以 `base_link` 为原点完成 `imu_link`、`laser_frame` 和 D435 `camera_link` 的
  `x/y/z/roll/pitch/yaw`。雷达和相机位置已测，安装角待验证；IMU 按 `IMU-002` 先测芯片
  物理中心，再用四阶段动作确定板轴。
- [ ] 确认雷达 0° 指向和旋转方向；在 RViz 用车前/左/右三个固定物体核对点云方位。
- [x] USB 枚举和另一台电脑联合出流已确认具体为 D435；相机内部 TF 后续只由官方
  `realsense-ros` 发布。
- [ ] Jetson 侧按 `CAM-001` 从单彩色低帧率短测重新接入；此前 Viewer 触发非正常重启，
  在 USB/UVC 链路稳定前不启动正式相机节点。
- [ ] 更新 Xacro 后执行 `TF-003`：离线模型和 TF 数值已复测；仍待桌面 RViz
  与实物并排检查，以及雷达方位和相机光学坐标现场验收。

测量表：

| 对象 | x 向前/mm | y 向左/mm | z 向上/mm | roll/° | pitch/° | yaw/° |
|---|---:|---:|---:|---:|---:|---:|
| IMU 原点 | 待测 | 待测 | 待测 | 待测 | 待测 | 待测 |
| 雷达扫描平面中心 | `-50` | `0` | `187` | 待验证 | 待验证 | 待验证 |
| RealSense 左红外镜头中心（`camera_link`） | `130` | `33` | `140` | 待验证 | 待验证 | 待验证 |

## P1：四轮运动与里程计

- [ ] 用同一个安全组合运动入口完成三项低速测试：前进、左横移、逆时针旋转；每项只确认
  方向、四轮编码器符号和停车，不再做 `MOTOR-005` 这类重复逐轮复测。现已准备
  `chassis_motion_keyboard`；前进已通过且符号为 `[-,+,-,+]`，只剩左横移和逆时针旋转。
  左横移的四轮转向组合已正确，但直接 PWM 无力；现已改为四轮编码器速度 PI，待闭环复测
  左横移、停车和编码器日志。
- [ ] 精确测量四轮输出轴每圈编码计数；可用每轮连续 10 圈一次完成，不要求堆叠实验。
  使用同一键盘入口的数字键记录起止值，待执行 `ENCODER-004`。
- [ ] 将 `carcar_hardware` 的四个轮关节接入标准 `velocity` 状态/命令，并使用
  `mecanum_drive_controller`，轮位映射为 M1/M3/M4/M2。
- [ ] 地面只做直行 1 m、横移 1 m、旋转 360° 三项标定；达到导航所需误差后停止调参。
- [ ] 先使用纯四轮反馈完成里程计和唯一 `odom -> base_footprint`，验收前进、横移、
  旋转和静止漂移；此阶段 IMU 只发布和观察，不参与融合。

## P1.5：IMU 后置评估（不阻塞首次导航）

- [ ] 断电露出控制板，拍含车头标记、IMU 芯片/板轴丝印和毫米尺的垂直俯视图；以轮心
  矩形中心量芯片封装中心 X/Y，并用离地高度减 `30 mm` 得相对 `base_link` 的 Z。
- [ ] 用只读 `imu_axis_observer` 按静止角速度→逆时针→水平加速度顺序完成基线，再进行
  车头和左侧分别抬高约 20～30°后的静止采样，
  确认三轴排列和符号后再写入驱动映射或 `imu_link` TF。
- [ ] 水平静止数十秒，采集 `angular_velocity.z` 并计算均值和标准差，分别记录零偏与噪声。
- [ ] 按 X 前、Y 左、Z 上固定车体坐标，人工逆时针旋转小车；必须观察到
  `angular_velocity.z > 0`。不满足时先修驱动轴映射或 `imu_link` 安装 TF，不改 EKF 参数。
- [ ] 水平静止检查 `ax≈0`、`ay≈0`、`az≈+9.81 m/s²`。当前仅有
  `|a|≈9.174 m/s²`，因此加速度标定尚未通过。
- [ ] 上述检查通过且纯轮式里程计、基础导航稳定后，建立第一版 `robot_localization`
  配置：只融合四轮里程计与经过零偏、单位、坐标轴和符号校正的 `gyro_z`；关闭 IMU
  姿态、全部线加速度和磁力计输入。
- [ ] 二维地面导航默认不融合线加速度；只有实测显示明确收益时才单独立项。
- [ ] Madgwick、线加速度和磁力计均作为后置独立实验；每次只增加一种信息源并与上一版
  对比，不一次性全部启用。

## P2：导航巡检

- [ ] 使用 RPLIDAR A1 建图，障碍/射线范围按实测最大 3.0 m 设置。
- [ ] 验收重启定位、单点导航、动态避障，然后用 Waypoint Follower 完成多点循环。
- [ ] 在巡检点执行等待、拍照和状态记录；任务失败支持暂停、跳过或返回充电点。

## P3：D435 自主充电

- [ ] 确认充电桩机械触点、对接方向、容许横向/角度误差和硬件防反接。
- [ ] 标定实际电池类型、满电/低电电压和负载压降；当前电压可读，但百分比和充电状态
  仍不能仅靠默认的 9.6～12.6 V 推算。
- [ ] 接入 D435 彩色/深度数据和 AprilTag 桩位姿；在 0.3～1.5 m 近场验证识别稳定性。
- [ ] 基于 `opennav_docking` Humble 分支实现预停靠、视觉精对准、接触、充电确认和重试。

## P4：Web 产品化

- [ ] 定义受限 API：遥控、急停、任务、位置、电压、充电状态、告警、相机预览。
- [ ] 使用 `rosbridge_suite + roslibjs` 接入；WebSocket 不直接暴露公网，加入登录、HTTPS、
  权限、命令频率限制和断线停车。
- [ ] 手机竖屏完成遥控和状态页，再增加地图点位编辑、巡检历史和设备管理。

## 已取消的低收益工作

- `MOTOR-005` 不再作为进入下一阶段的门槛；`MOTOR-004` 已足够确认轮位和机械方向。
- 不继续发展双轮差速正式架构。
- 不在 2D 导航完成前引入 3D SLAM、复杂视觉规划或完整 Web 平台。
- 旧脚本、配置和测试记录保留，用于故障回归，不由正式 bringup 启动。
