tfsvh69-blip/Nav2_car/docs/历史/2026-09-27-D435舵机与残留问题/2026-09-28-现场复测交接.md

# 2026-09-28 D435 静止 Costmap 现场复测交接

操作入口统一见[操作手册第 30 节](../../操作手册.md#30-d435-平视后静止体素复测续测入口)。本文件保留证据和明天的判断顺序；测试编号为 TF-006-R2、NAV-015-P2B。**本日全部节点已停止，`/dev/myserial` 无占用；没有启动导航或发送车轮运动指令。**

## 已确认

1. 用户在清空支架活动范围、隔离车轮动力后，确认短时启动底盘驱动使相机到达平视并停稳，车轮未动。驱动日志显示先发零运动，再发 S1 板端 94 档（140.5°软件目标）。当时 ROS daemon 异常，未独立捕获 `/hardware/camera_servo/board_command_sent`；日志及实物反馈不等于实际角度/扭矩反馈。
2. 车恢复平整地面且前方空场时，默认零俯仰 TF 下，三帧中央地面斜率为 -0.11428、-0.11479、-0.11518，随距离增加而变低；因此旧 -6.49°候选的量级**并非仅由未初始化姿态造成**。独立新候选 `camera_extrinsics_floor_candidate_20260928.yaml` 只把 pitch 设为 -0.1142503 rad（-6.546°），保留原 xyz、roll、yaw 和 `verified:false`。加载后空地斜率接近零，地面仍约 -6～-7 mm；车体绝对水平和舵机真实角度未测量，不能将它写为正式绝对外参。
3. 第一次低盒因距车体约 0.36 m、距镜头约 0.21 m，低于 0.30 m 深度使用下限，不用于低盒验收。随后用户把同一低盒放在**距镜头约 0.7 m**，候选 TF 下原始点云每帧约 2100～2300 个 3～26 cm 点、盒顶约 11 cm；移走后该高度点为 0，空地地面斜率约 0、最高约 0.004 m。低盒成像、TF 和标障链路在这一位置成立。
4. 只把清障高度下限从 0 改为 -0.03 m、清障点仍限 2 m 的现场对照中，移走低盒后约 17 s，盒子区域 `x=0.78～0.96 m, y=-0.12～0.12 m` 仍有 **185 个标记体素、49 个二维致命栅格**；蓝点同格为 0，清障话题持续更新。高度放宽**单独不足以清净**。
5. 标障仍限 2 m、只把有效清障背景点上限扩到 4 m，Costmap 射线仍裁剪 2 m、清障高度下限仍 -0.03 m：同一低盒在场时上述区域稳定有约 **55～60 个标记体素、14～15 个二维致命栅格**；移走后原始盒高点为 0，最后非零体素时刻 `1790606756474169983 ns`、首个持续零时刻 `1790606756674633595 ns`，相差 0.20 s；相对首个空场原始点约 0.39 s。该区域之后持续为 0。两轮箱子手工放置且 Costmap 重启，支持“需要更远有效背景射线”的判断，但不是严格同场 A/B 或全部位置验收。
6. 高箱静止超过 20 s 时，宽区域 `x=0.5～1.3 m, y=-0.3～0.3 m` 持续约 **412～428 个体素、54～58 个二维致命栅格**，原始点云有约 9400 个 3～26 cm 点，顶部约 0.30 m。移走后原始盒高点为 0、二维致命栅格为 0，12 s 后仍有 **5 个单层非致命黄色体素**（约 `x=0.89～0.99 m, y=-0.09～0.17 m, z=0.07～0.09 m`），空场基线同区域为 0。不能宣称高箱黄色已彻底清净；这些单层体素也不能等同二维致命障碍。
7. 更晚的轻量地图包里体素再次大增，但随后的原始深度有效点从约 27 万骤降到约 1.7 万，几乎看不到地面。用户随后确认**已移动车体，镜头前有遮挡**。这段超出固定姿态/空场前提，**不得作为清障失败或传感器故障证据**；明天先恢复可比场景，不用它调参。

## 证据与实现

- 原始 bag、快照、构建日志和 CSV 均在 `log/depth_retest_20260928/`；重点看 `audit_candidate_tf_default_clear_occupancy`、`audit_candidate_tf_clear_minus3cm`、`audit_candidate_tf_clear4m_minus3cm`、`audit_high_box_clear4m` 和对应的 `grid_frames.csv`、`marked_voxels.csv`、`cloud_frames.csv`。晚期无效场景为 `high_box_after_wait_map_bag`、`unexpected_late_map`。
- 新增 C++ `depth_costmap_audit`，离线读取 rosbag 的静态 TF、点云、`/costmap/voxel_grid`、`/costmap/costmap`，输出逐帧体素、同格当前蓝点、二维 OccupancyGrid 值与消息时间差。二维发布值 **100** 对应致命栅格；工具无法证明某条清障射线穿过某个单独体素。同格蓝点为 0 也不等于该空间没有障碍。工具只适用固定 TF 的 bag。
- `depth_snapshot` 新增 `require_color:=false`，使深度单流可输出原始点云与地面斜率。RGB+深度联合启动本轮出现 USB/UVC `-32/-71`、断流；深度单流短时稳定，USB 联合流原因仍待查。
- `carcar_camera` 构建通过、12 项测试 0 失败。没有对实车域播放 bag 或速度；本轮尚未做新候选的隔离 ROS 域端到端回放。

## 明天先做

1. 确认车在原平整地面、充电线断开、相机实际平视停稳、镜头与前方 0.3～1.2 m 无遮挡；若需重新发送平视目标，先按手册第 29.2 节核实车轮隔离和舵机活动空间，底盘/独占键盘不可同时占串口。
2. 按手册第 30 节启动**深度单流 + 2026-09-28 独立外参候选 + 4 m 清障候选 + 独立静止 Costmap**。先空地取三帧确认原始有效点约 27 万、中央盒高点 0、地面接近水平；不符先查姿态/遮挡，不调阈值。
3. 对同一低盒至少再做两次 0.7 m 放置/移走，增加左右与不同距离；每轮同时记录原始深度、蓝点、清障点、黄色体素和二维代价。高箱边缘的 5 个非致命残留需定点复测：检查有无清障射线穿过及邻近有效背景，不以定时清图掩盖。
4. 在**隔离 ROS 域**做可重复的 2 m 与 4 m 清障背景对照，不播放 `/cmd_vel`、不连接底盘；再核对消息时间、TF 和 QoS。多位置及雷达共同平面未通过前，不把 -6.546°和清障候选写入正式导航默认配置，也不宣称移动深度避障通过。
