tfsvh69-blip/Nav2_car/src/carcar_mapping_console/README.md

# 平板随行建图控制台

NAV-017：独立的离线网页建图入口。车端 C++、XML Launch；用户于2026-10-13明确同意仅网页交互使用必要的 JavaScript。所有网页资源本地提供，无 CDN。

2026-10-20 NAV-017-R16新增独立 `tablet_range6_candidate.launch.xml`，仅新建地图对照，将SLAM使用范围由3m改为6m，原默认与旧工程保留。车端配置路径由启动参数经网关/预检固定argv传入SLAM，不接受网页传文件路径；旧图及保存后隐式续建在候选入口拒绝，避免把序列化原阈值冒充新配置。候选单独保存，网页待命不自动启动硬件。本轮只离线验证，尚不能宣称走廊变形已修复或弱特征已受保护；完整操作、安全与回退见[手册33.20](../../docs/操作手册.md#weak-feature-mapping)，输入证据见[审计](../../docs/archive/2026-10-20-弱特征建图审计/README.md)。

2026-10-20新增 `mapping_tablet_wifi_trial`：平板连接原WiFi并提供热点，Jetson与电脑都作热点客户端。该独立C++入口只提供只读状态、隐藏密码准备、固定180秒试验和提前恢复；不修改旧热点入口、不启动硬件、不修改代理。试验配置仅存NetworkManager内存，禁用自动连接，使用DHCP；回滚由NetworkManager独立计时，后台观察进程不依赖SSH终端，记录新地址和原连接恢复情况。当前仅离线验证，真实热点与客户端互访待验；完整命令、风险及恢复见[手册33.19](../../docs/操作手册.md#tablet-wifi-mvp)，结果见测试记录NET-001。接口复用本机NetworkManager 1.36.6的 `AddConnectionUnsaved`、`CheckpointCreate`、`CheckpointRollback`，不用新发行版功能；原理见[NetworkManager官方接口](https://networkmanager.dev/docs/api/1.36.0/gdbus-org.freedesktop.NetworkManager.html)及[Android并发说明](https://source.android.com/docs/core/connect/wifi-sta-ap-concurrency?hl=zh-cn)。

2026-10-14用户缩小场地，当前小车、平板和电脑同连“小泽WiFi”，只在覆盖区内随行建图；热点工具保留备用，本阶段不创建或切换热点。使用Jetson当前WiFi地址访问网页，本次核对为`http://192.168.5.11:8080`，DHCP变化后重新读回。完整构建、预检、启动、保存、续建、观察、停止及备用热点命令只维护于[操作手册第33节](../../docs/操作手册.md#33-平板随行建图nav-017)。当前不宣称平板兼容、停车距离或场地地图已实机通过。

依赖固定依据：Boost/Beast 1.74（BSL-1.0）、nlohmann JSON 3.10.5（MIT）、Nav2 map_io 1.1.20（Apache-2.0/BSD-3-Clause）、SLAM Toolbox 2.6.10、realsense-ros 4.58.3（Apache-2.0）、GIO/GLib 2.72.4（LGPL-2.1-or-later）、OpenCV与OpenSSL。热点工具通过D-Bus操作既有NetworkManager 1.36.6；配置尚未实际更改。使用安装库接口，没有复制上游实现；版本事实来自本机包。来源：[Beast](https://www.boost.org/doc/libs/1_74_0/libs/beast/)、[JSON](https://github.com/nlohmann/json/tree/v3.10.5)、[Nav2 Humble](https://github.com/ros-navigation/navigation2/tree/1.1.20/nav2_map_server)、[SLAM 2.6.10](https://github.com/SteveMacenski/slam_toolbox/tree/2.6.10)、[RealSense](https://github.com/realsenseai/realsense-ros/tree/4.58.3)、[GIO](https://docs.gtk.org/gio/)、[NetworkManager 1.36接口](https://www.networkmanager.dev/docs/api/1.36.0/gdbus-org.freedesktop.NetworkManager.html)。

常驻入口为`tablet.launch.xml`或用户服务`config/mapping-tablet.service`：仅网页待命，平板选择新建/续建后，由C++任务管理启动受预检的硬件子任务。旧`mapping_prepare`与`mapping.launch.xml`保留作终端/严格视频联锁入口，不与常驻入口并行运行。

网关提供固定接口：GET `/api/status`（轻量状态）、`/api/scan`（版本化激光预览）、`/api/state`（保留完整旧接口）、`/api/map.png`、`/api/video.jpg`、`/api/bundles`、`/api/diagnostics`；WebSocket `/ws/control`；POST `/api/start`、`/api/end`、`/api/restart`、`/api/video`、`/api/resume`、`/api/confirm`、`/api/save`、`/api/finish`。写操作绑定当前操作者会话，禁止任意ROS话题、参数、shell或文件路径。工程ID由平板列出并校验，校验失败/部分保存不可续建。

按住摇杆时网页每 50ms 重复当前方向，松手立即发零。车上从最后一次收到推杆起保持 1 秒，到点只把速度归零，不撤使能；下一条新命令可以直接继续。挑战不再用来续租。序号仍丢掉松手之前排队的旧方向。会话未就绪仍是 0.30 秒，雷达和里程计仍是 0.50 秒，这些失效会撤使能。断联后慢档最多再走约 5cm，快档约 18cm。这不是物理刹停或硬实时保证。摇杆支持前后/转向组合，有限值、归一化输入和档位上限在车端检查，不提供横移。松手归零并保留使能，使用递增序号拒绝松手前的排队请求；停车锁定、换档、后台、断联、故障、保存和重启后重新使能。视频默认按需开启，不参与建图或常驻入口运动授权；旧严格模式`require_video=true`仍检查源帧与浏览器绘制帧。雷达、里程计、网关与短授权检查保留。所有运动经专用`/mapping/cmd_vel`，底盘0.30秒软件超时保留；Jetson卡死/控制板独立停车仍需实机验证。

任务使用固定argv与独立进程组，不执行网页提供的shell。结束先停车并保存，成功后退出本工具底盘/雷达/SLAM/门控及可选相机，网页回待命；保存失败锁停等待重试，不自动退出。重启提示未保存损失，有本次成功版本时从最近版本续建，仍须人工对齐。不自动启动/重启硬件，不杀未知串口进程。用户服务沿用当前GDM自动登录，系统设置不改，真正重启后入口与平板效果仍须现场验收。

网关与Safety补齐仓库缺少的浏览器会话、前台授权、任务生命周期、受控恢复和成对保存事务，复用既有门控的单调时钟、短租约与默认零输出思路。独立包避免引入导航专用STVL依赖，维护范围集中在有限接口与版本适配；SLAM、底盘驱动和编解码继续复用成熟实现。

任意位置续建限制在旧图覆盖区。SLAM输入`/mapping/slam_scan`默认关门，恢复前只预览历史栅格；给定初值后放行一次扫描，候选须人工核对。不能用SLAM Pause代替扫描门，也不能把空服务响应或首帧位姿当匹配质量保证。保存采用新目录与清单校验，旧工程不覆盖。

WebSocket用2秒存活检测释放失联的旧控制连接，浏览器原生ping/pong维持健康的空闲查看；它与0.30秒行驶授权分别维护。失败热点试点可先恢复原WiFi，再取消本工具checkpoint，保持“未验收”状态；无需把失败登记成成功才能撤销。完整操作仍只在手册33节维护。

2026-10-14审查修订：新建入口省略空工程ID参数；页面后台关闭连接并取消重试，回前台只建立一个连接，旧socket的迟到回调不影响新会话。删除热点前对实际配置生成同目录、唯一名称、0600权限的完整`.backup`，输出不激活网络的恢复命令并写维护记录；失败则不删除。新增C++工具回归使用临时目录、替身`ros2`及Node事件模拟验证网页，不读取真实密码或修改系统配置。Node仅用于测试已授权的网页交互，车端节点与网络工具仍为C++。

串口检查由`include/carcar_mapping_console/serial_preflight.hpp`统一供硬件启动预检和备用热点工具使用：固定argv传入解析后的绝对路径，保留stdout/stderr，仅退出码1且完全无输出时放行；占用、工具缺失、报错或异常退出均拒绝继续。只读占用检查不打开串口，也不等同实物已经停稳；热点仍未启用。

NAV-017-R2：平板横屏左地图、右摇杆，重复方向按钮移除，顶栏保留独立停车锁定。专用控制连接的新鲜度独立于HTTP状态查询，HTTP延迟不再触发错误锁停；控制消息真实超时与原车端保护保持。新增快速档0.18m/s、0.36rad/s候选，映射入口底盘上限同步，默认慢档，切档需重新使能；旧运行门控未报告支持时禁用快速选项。

门控输出`MAPPING_EVENT`状态变更日志和最近撤销许可快照（具体原因、传感器/挑战年龄、请求/定时器间隔）；任务日志保留，网关事件同时进入用户服务journal。客户端记录触屏、后台、通信和脚本卡顿；诊断界面提供最近各128条事件及JSON导出，不记录会话密钥/挑战令牌。车端新日志需要保存结束后重载服务，浏览器资源刷新可独立进行。现场1～2秒锁停的唯一起因尚未由原始现场日志证明；离线已复现并修正HTTP状态延迟导致1秒锁停的路径，仍需平板复测。

NAV-017-R3追加：现场事件已确认一次连续推杆被运动授权超时撤销（令牌年龄176.59ms、后续请求间隔47.40ms），并出现前台心跳超时；原200ms令牌有效期同时用于运动与心跳，短于现场完整通信周期。新增真实app.js通过原生HTTP/WebSocket连接真实C++网关/门控的隔离域219测试，先复现每方向80ms延迟下撤销使能，再验证300ms统一窗口和收到状态即回应。浏览器本地窗口同步采用门控报告值；旧门控仍按200ms处理。新增`accepted_sequence`、`request_result`与过期拒绝计数，避免把收到序号误当成功续租。断流/挂起仍须锁停；该软件验证不替代平板实测与停车距离验收。稍后现场雷达停止更新并进入FAULT是另一待查问题，原日志保留。

NAV-017-R4复查：实际JS/网关/门控在每方向100ms延迟下再次复现使能确认阶段心跳超时，修正为确认途中也回应新状态，新挑战不受旧消息节流影响，300ms窗口不再增加。同一ID的connect重试改为幂等，防止网关确认重试撤销使能/重置档位/序号；新会话仍锁停。重连清空旧状态并忽略旧socket回调；HTTP开始监听前生成完整状态，修复启动瞬间空状态/诊断null异常。诊断导出增加当前控制时序与任务状态。新增0/80/100ms单程延迟、重连、重复连接、启动瞬间真实HTTP回归；可选Chromium触屏脚本本机因浏览器运行环境无法访问最小localhost测试页而未完成，不计为通过，也不代表真实平板兼容性失败。

NAV-017-R5：2026-10-14用户反馈Chrome和小米自带浏览器均出现突然锁停。19:50:05/12/18三次由操纵授权超时撤销，随后网页报告控制状态间隔305/306/316ms；当时传感器/门控健康，没有对应触控取消事件。网络连接累计重传与短时延迟波动是已观察事实，网络与页面卡顿的贡献尚未完全分离。另实测发现后台Launch/硬件子进程继承了控制socket，网关关闭后连接仍留存；TaskProcess在重定向标准输入/日志后使用当前glibc支持的closefrom spawn动作关闭全部fd>=3，防止后台任务持有网页与ROS通信描述符。隔离socket回归先复现不能收到EOF，再验证修复；该修复不等于通信抖动已解决，300ms保护未改变。

NAV-017-R6：撤回按收包时刻续租500ms及网关800ms阈值试改，恢复按签发时刻300ms截止；已证明递增序号不能为同一条旧挑战重新计时，旧门控缺租期字段仍回退200ms。保留R3～R5已有修复和全部失败证据，52项C++回归通过。未使能状态仍观察到通信停顿，雷达未转造成的启动超时独立记录；现场稳定性不据离线通过转正。各类超时职责与有效操作统一[手册33节](../../docs/操作手册.md#33-平板随行建图nav-017)，原始结果与当前边界见测试记录R6。

NAV-017-R8（2026-10-15）：参考rosbridge/Foxglove的有界队列、按用途分流与小包及时发送，保留现有C++网关、独立门控及旧接口，不新增通用桥接或WebRTC依赖。普通HTTP处理移到单独串行工作线程，网络控制事件循环独立处理收发；HTTP支持连接复用，控制socket显式TCP_NODELAY。新网页协商compact控制确认，详细timing/last_stop仍从诊断获取，未协商客户端继续收到完整状态。网页先回应挑战再更新显示，客户端诊断改为有界低频发送。

新网页任务状态间隔250ms；激光预览间隔200ms、单请求在途，同版本204空响应；地图仍按版本下载、RGB仍按需开启。`/api/scan`返回`version/frame_id/valid/source_age_ms/points`，坐标为map，过期预览在浏览器清除，任务切换丢弃迟到响应。旧网关缺轻量接口时回退原状态读取。`diagnostics_version=2`增加控制签发编号、回应总年龄、应用发送等待/覆盖、TCP队列与重传快照；TCP写入完成不证明浏览器收到，浏览器报告耗时也不作为安全输入。来源与取舍见[调研归档](../../docs/archive/2026-10-15-网页建图数据流方案调研.md)，完整操作/恢复和结果分别见手册33.13与测试记录R8；离线通过不等同当前WiFi、真实浏览器及物理停车通过。

NAV-017-R9（2026-10-15）：R8现场仍超时，新增WebRTC局域网控制通道作对照，保留全部WebSocket/HTTP入口与300ms车端签发截止。`/ws/control`继续持有唯一操作者并可靠交换SDP/ICE信令；新数据通道使用`ordered=false,maxRetransmits=0`，不等待旧控制包重传，发送缓冲非空时不继续追加周期包。WebSocket断开同时撤销新通道；通道关闭/切换先锁停，不能自动恢复运动。运动、心跳走数据通道，停车/松手另向原WebSocket发送；切换后旧TCP队列的运动/心跳被拒绝。

前端未使能时不发送无用操纵心跳；使能后每条新挑战最多一条周期回应，心跳与运动共用这一规则，定时器不重发旧挑战；按压更新本地意图，随下次新挑战发送，松手/停车立即发送。控制状态按签发编号拒绝乱序，门控重启需按签发代次区分；地图/预览路径保持R8分流。网页显示实际连接通道，在辅助区可选择旧WebSocket作对照；新通道不可用时锁停并回退，不改变停车期限。

依赖为官方`libdatachannel v0.24.6`固定提交、仅数据通道及其3个固定子模块；首次构建可联网取源码，运行不访问外部STUN/TURN。第三方原许可证随安装保留，自有代码保持Apache-2.0；构建可关闭`MAPPING_ENABLE_WEBRTC`，旧通道仍可独立构建。来源、许可证和适用边界见[专项调研](../../docs/archive/2026-10-15-网页建图WebRTC控制通道调研.md)，完整操作统一手册33.14，实际结果见测试记录R9。无线中断、浏览器挂起或总往返耗尽300ms仍须停车，换协议不等于现场已通过。

NAV-017-R10（2026-10-15，当前规则）：用户指出目标仅网页遥控建图且停止过多。使能代表等待下一次按压的就绪状态，静止及松手后不靠操纵心跳续期；首次使能等待状态返回也不再触发300ms静止心跳锁停。新门控报告`idle_heartbeat_required=false`，新网页停止空闲操纵心跳；旧门控缺此字段时仍沿用旧网页回应，旧网页连接新门控仍可发送兼容心跳。兼容心跳期限只作诊断，不触发运动、不延长运动期限。窗口失焦只在仍按住摇杆时停车，页面隐藏/关闭/断开与关键传感器/会话故障仍锁停；运动仍必须在车端签发后300ms内更新，松手序号屏障和恢复不重放旧动作不变。来源与取舍见专项调研R10段，操作/恢复和验证统一手册33.15与测试记录R10；软件零命令不等于实物停止反馈。

NAV-017-R11（2026-10-15）：针对偶发断联，隔离测试复现UDP仍健康时原WebSocket的2秒空闲回收连带关闭RTC。连接空闲回收调整为10秒（Beast约5秒发ping、总10秒无接收回收），不改变Safety的300ms运动签发截止；代价是无响应旧操作者占用会话更久，实际网络中断仍可能断开。断开诊断保留首个read/write/handshake等阶段、错误类别/值/消息、对端关闭码、最近WS接收年龄和ping/pong接收计数，并写入网关断开历史；关闭时同步清除RTC活跃标记。网页诊断导出包含transport/reply_timing和浏览器关闭码。固定Boost1.74原理与证据边界见[专项调研](../../docs/archive/2026-10-15-网页建图WebSocket连接超时调研.md)，构建/回退与结果统一手册33.16和测试记录R11；旧现场没有底层关闭错误，不能把该复现当现场唯一原因已经确认。

NAV-017-R12（2026-10-15）：R11现场又在松手时由control_stale撤销；修正HTTP poll异常分支，仅未释放按压且控制过期时主动停车，静止只记录查询失败、不产生运动。车端运动期限与连接回收不改。诊断ui_version=20261015-r12，握手上报client_ui_r12，区分实际加载页面和服务端源码；刷新即可更新，不重启硬件。真实异常分支先失败后通过，流程/结果见手册33.15及测试记录R12；通信停顿本身未因此消失。

NAV-017-R14（2026-10-19）：现场使能后出现「网页请求停车: rtc_fallback / rtc_cancelled」，使能状态来回跳；推杆后另出现「操纵授权超时」。原因是 WebRTC 接通、回退和短暂断开都会发停车，运动包又只走不可靠数据通道。现在页面默认使用 WebSocket。通道接通或回退不再撤销使能；若仍选择 WebRTC，同一条运动同时送一份可靠副本，车端只接受带 backup 的副本，切换前排队的旧 TCP 运动继续丢弃。300ms 仍从签发时刻计算，副本迟到不能续租。页面版本 `20261019-r14`。刷新网页即可加载；网关进程要等本次建图结束后重载，才不再因数据通道状态自行停车。操作见手册 33.18。

NAV-017-R13（2026-10-19）：按既有现场记录，推杆撤使能对应约300ms控制间隔，页面脚本间隔只有约130ms，恢复前台时补报的数秒脚本间隔不作为持续卡顿。网页在控制状态仍新鲜时，对同一条挑战按50ms补发一次运动包，用来覆盖不可靠通道丢单包；车端仍从原签发时刻起300ms截止。状态在写出前已经超过该期限则丢弃，不改签发时间。数据通道暂时发不出去时只保留最新一条，缓冲排空后仍按原时间补发，过期则放弃。页面版本`20261019-r13`，握手事件`client_ui_r13`。操作见手册33.17。实车持续推杆仍待现场确认。
