tfsvh69-blip/Nav2_car/docs/历史/README.md

# 历史资料

早期专题、旧命令、调研与审计，只供追溯，不作当前启动入口。
当前操作以 [操作手册](../操作手册.md) 和 [项目现状与路线](../项目现状与路线.md) 为准。

- [2026-09-19 导航三类异常接手说明](2026-09-19-导航三类异常接手说明.md)（NAV-012-R5 未完成项；不是启动入口）
- [2026-09-08 硬件变更明细](2026-09-08-硬件变更明细.md)
- [当前整车软硬件与导航系统架构审计 (2026-09-12)](当前整车软硬件与导航系统架构审计.md)
- [导航算法与系统架构 (早期方案)](导航算法与系统架构.md)
- [底盘板载闭环配置与验收](底盘板载闭环配置与验收.md)
- [底盘编码器与里程计方案调研](底盘编码器与里程计方案调研.md)
- [激光雷达 Humble 迁移与测试](激光雷达Humble迁移与测试.md)
- [已装配整车传感器对照步骤](已装配整车传感器对照步骤.md)
- [整车模型与测量说明](整车模型与测量说明.md)
- [架构设计](架构设计.md)
- [待办事项](待办事项.md)
- [硬件实测记录](硬件实测记录.md)
- [硬件配置](硬件配置.md)
- [电机测试](电机测试.md)
- [D435 维修后检测](D435维修后检测.md)
