tfsvh69-blip/Nav2_car/src/carcar_algorithms/README.md

# carcar_algorithms

预留给可复用算法：目标检测、异常检测、覆盖路径规划、点云/图像处理等。每类成熟算法应继续拆成独立 ROS 包；本包不访问串口，也不承载巡检任务状态机。
