tfsvh69-blip/Nav2_car/src/carcar_navigation/maps/README.md

# Maps

将 `map_saver_cli` 生成的 `.yaml` 与 `.pgm` 地图成对放在这里。地图属于现场数据，示例框架不附带虚假占位地图。
