tfsvh69-blip/Nav2_car/docs/文档索引.md

# 文档索引

最后更新：2026-10-15。当前入口为以下六份文档；历史资料仅供追溯。完整命令只在操作手册维护。

| 文档 | 用途 |
|---|---|
| [项目现状与路线](项目现状与路线.md) | 当前结论、待验项、唯一下一步与推进顺序 |
| [硬件台账](硬件台账.md) | 已确认实物、端口、尺寸、变更与待确认项 |
| [操作手册](操作手册.md) | 构建、启动、观察、停止和回滚的唯一完整命令入口 |
| [测试记录](测试记录.md) | 当前结论表与按时间追加的折叠历史，区分离线／实机 |
| [工业级优化建议与学习路线](工业级优化建议与学习路线.md) | 长期优先级、架构取舍与学习验收 |
| 本索引 | 入口导航与资料归属 |

## 当前工作入口

- **D435计算优化（CAM-005）**：[手册36节](操作手册.md#36-d435体素降采样组件通信与gpu核实cam-005)。组件IPC、1 cm VoxelGrid候选和GPU实际调用已检查；结果与待验边界见测试记录，旧入口保留。

- **项目维护（已批准实施）**：[第一阶段报告](archive/2026-10-14-项目瘦身报告.md)、[执行结果](archive/2026-10-14-瘦身执行结果.md)、[项目清理技能](../.agents/skills/project-cleanup/SKILL.md)。文档归档、可再生小缓存、前后统计及未实施代码建议；检查点恢复命令只见手册34节。
- **平板随行建图 NAV-017-R1**：[手册第33节](操作手册.md#33-平板随行建图nav-017)、[独立包说明](../src/carcar_mapping_console/README.md)。小泽WiFi覆盖内随行；开机自动登录后网页待命，平板新建/续建、摇杆、可选RGB、保存结束及故障重试。离线回归通过，用户服务已启用；新版平板操作、重启和实车场地验收另行登记，不沿用深度导航结论。
- **网页巡检 APP-001-R1**：[应用说明](../src/carcar_inspection/README.md)、[手册35节](操作手册.md#35-网页巡检与逐步舵机示教app-001-r1)。Vue网页＋C++任务，单角度／单张采集、分步调角和人工确认；默认只配置，不启动硬件，完整实机验收待做。云端协议与上传程序后续实现。
- **下一步深度导航验证**：计划与门槛见[项目路线](项目现状与路线.md#当前唯一下一步)，操作沿用[手册第31节](操作手册.md#31-stvl-深度导航主线nav-016)。计划不等于实机通过。
- **当前静止证据入口**：[手册31.16](操作手册.md#3116-94档近平视与100刷新率的静止stvl验收)。NAV-016-R2 的保持、撤障、健康分项通过，空地误标失败保留；完整移动尚未通过。
- **姿态不确定后的复核**：[手册31.15](操作手册.md#3115-断电或硬件移动后重新核对平视角)。舵机命令、估计角和实物反馈分开，不能沿用旧外参假设当前姿态。
- **RGB与深度视场／配准判读**：[手册31.11](操作手册.md#3111-深度配准到-rgb-的显示参照nav-016-r2)及[31.13链路讲解](操作手册.md#3113-d435-到-nav2-的数据链路与必要知识)。
- **Ubuntu主机RViz联调**：[手册第19节](操作手册.md#19-ubuntu-主机-rviz-联调)。主机地址先核对，轻量 RViz 在用户桌面运行；本轮未改 RViz。
- **本轮归档离线复核**：[手册第32节](archive/操作专题原文_20261014.md#32-巡检设计与停用草稿归档的离线复核)，结果登记 APP-001，仅验证文档与目录整理。

## 来源与历史

- [巡检行为树框架调研](archive/2026-10-10-巡检行为树框架调研.md)：官方来源、固定版本、许可证与本项目取舍。
- [停用代码归档](archive/停用代码/2026-10-10/README.md)：原路径、停用原因、替代关系及保留测试。
- [历史资料索引](archive/README.md)：旧专题、旧命令和阶段记录，不作为当前启动入口。
- [整理前项目路线](archive/2026-10-10-项目路线整理前快照.md)、[整理前文档索引](archive/2026-10-10-文档索引整理前快照.md)：保留原结论，避免多个日期的“当前”并列误导操作。

系统级配置仍维护在桌面 `/home/jetson/Desktop/系统配置维护记录.md`，本轮没有系统配置变更。历史录包仍在本机 `log/`，未清除、未迁移，也不意味着已随 Git 上传。
