tfsvh69-blip/Nav2_car/docs/项目现状与路线.md

# 项目现状与路线

最后更新：2026-10-20。当前优先任务为**平板弱特征建图的几何变形（NAV-017-R16）**：用户确认错字已改，WiFi问题暂不再处理。已审计昨晚保存工程并准备独立6m新建候选，实际地图改善及质量保护尚待验收；现场始终目视车辆。此前网络MVP和恢复记录保留在NET-001/NET-002，不据其早期地址推定当前网络状态。长期目标仍为单层室内巡检，导航停车后俯仰相机拍RGB、本地保存并排队上传；第一版不做门状态/危险识别。网页巡检已有离线MVP，见[应用说明](../src/carcar_inspection/README.md)。

NET-001：首次trial已取得平板热点地址并恢复原网，软件观测细节统一测试记录R2；平板不显示IP，静态地址仍待热点网关/地址池信息，不直接改默认。热点内客户端互访、断上游、锁屏和回原网SSH现场反馈尚待。独立C++工具仅提供DHCP客户端准备、固定180秒回滚及恢复，不修改旧Jetson热点工具或代理。用户报告平板热点下代理/Codex联网问题，本轮明确不处理，不作为本地网络验收条件。步骤见[手册33.19](操作手册.md#tablet-wifi-mvp)，结果统一测试记录NET-001。

## 当前架构

| 模块 | 实际职责与边界 |
|---|---|
| rosmaster_vendor / carcar_base | 厂商通信封装、正式串口所有者、底盘限速/超时停车、纯轮式里程计；现有Python资产保留 |
| carcar_hardware | 独立ros2_control协议/硬件插件及底层测试，不与正式驱动并行占串口 |
| carcar_description / carcar_lidar | URDF/固定TF/模型资源与RPLIDAR A1编排 |
| carcar_camera | D435采集、C++图像/点云处理与诊断；建图RGB-only和深度导航入口分开 |
| carcar_navigation | SLAM/AMCL/Nav2编排、受保护恢复、动态插件、速度联锁及会话证据 |
| carcar_mapping_console | C++常驻网页/任务进程组管理、独立运动门控、准备/网络工具；网页JS只作已授权交互，ROS节点在车端localhost |
| carcar_inspection / carcar_algorithms | 前者新增Vue网页、C++任务／示教、SQLite存储及RGB采集代码，默认配置模式；后者保留算法预留，状态见[应用说明](../src/carcar_inspection/README.md) |

随行建图的数据流：激光＋轮式里程计/TF→SLAM；地图/激光/估计车位→网页，RGB按需辅助；平板摇杆请求→独立门控→专用mapping速度→底盘。开机自动登录后网页待命，平板选择新建或旧工程并显式启动硬件；结束保存成功后关闭本次任务，网页保留。松手停车保留使能，后台/断联/故障/保存后重新使能；视频新鲜度不作随行遥控前提。续建初值须人工核对候选。具体接口、候选参数和完整步骤统一见[手册33节](操作手册.md#33-平板随行建图nav-017)。

## 当前结论与关键决策

| 范围 | 已有证据 | 保留的边界 |
|---|---|---|
| NAV-017-R16弱特征建图 | 用户反馈直角走廊被画歪；约22:30工程已有离线审计，独立6m新建候选保留原3m入口 | 用户将WiFi及错字移出本轮；地图几何改善、质量告警/冻结与转角真值尚待验证，详见[测试记录R16](测试记录.md#nav-017-r16) |
| 底盘/状态估计 | 四轮麦克纳姆，软件差速、禁横移；纯轮式基线有实机记录 | IMU暂不融合；后续先稳定基础导航，再只评估校正gz |
| NAV-017-R6/R7/R14-OBS | 恢复300ms签发截止。R7-PS1关闭省电仍断流，已恢复on。2026-10-19只读时8080为STANDBY、无控制连接；车到192.168.5.1的往返约0.9～8.8ms，不能单独解释约300ms断流 | 省电保持on，300ms未放宽。没有新的推杆样本，TCP积压与网页处理仍待同窗分开；物理停车和扩图仍待 |
| 平板RGB | 历史已确认原WiFi网页可达、RGB可见；640×480源短窗约6.04Hz | 当前按需开启，不作遥控授权前提；新版长时/延迟与锁屏恢复待验 |
| 地图 | 已有nav002/nav004导航地图，NAV-004有保存重载记录 | 只有YAML/PGM不能当可续建工程；新工程需配套posegraph/data |
| 深度/STVL | NAV-016-R2保持/撤障/600秒源与图层健康分项通过 | 空地误标失败，2cm/边缘/遮挡及完整移动仍未通过 |
| CAM-005相机优化 | 新增D435/筛选同容器IPC与1 cm标障VoxelGrid候选；构建、相机包回归和隔离短窗完成，CUDA实际执行已取证 | 旧入口保留；体素是CPU处理，整车负载收益及小障碍/边缘/移动待验，命令统一手册36节 |
| NAV-016-R3 | 10-12雷达最初未开，现场开启后扫描/定位恢复；1.8倍候选参数读回 | 一次目标失败、一次取消，完整链路仍有POINTCLOUD_TIMEOUT；速度配置不是实测提速 |
| 相机姿态 | 历史S1=94和近平视采样证据保留，无位置反馈 | 当前实际姿态/完整TF、往返与重启重复性仍需复核 |
| 巡检APP-001-R3 | 在R1/R2示教和单点执行之上，每个目标最多3个停车位；到不了就换下一位，都失败则记未拍并继续。照片落盘后可配置HTTPS/HTTP上传，校验一致才确认 | 离线逻辑见测试记录。实车角度、回位、导航避障和真实云端仍待；`upload_url`默认空，不访问网络 |
| MAINT-001维护 | 用户批准文档归档/缓存批次，完整检查点已建立 | 地图/标定/模型/参数、底层测试和原始实验数据保留；代码候选须先具备验证输入 |

当前事实与反馈只见[硬件台账](硬件台账.md)，原始失败、日期、测量与验收只见[测试记录](测试记录.md)。本页不重复操作命令。

## 当前唯一下一步

2026-10-20当前优先处理弱特征建图的地图几何变形：先按[手册33.20](操作手册.md#weak-feature-mapping)完成原工程审计及相同路线3m/6m独立对照，再由实物转角决定是否复核轮式航向、另建已校正gz融合候选。长期质量保护选择见[学习路线3.1.1](工业级优化建议与学习路线.md#311-弱特征区域的建图保护)。以下既有停车与深度验收门槛继续保留。

用户随后明确确认逐项优化：每轮只改变一个因素，固定其余参数、路线、速度与载荷，保留原入口及成功/失败证据；当前先完成3m/6m对照，再按证据选择下一项。扫描匹配算法替换、逐束运动补偿、IMU融合和质量保护分别立项验证，不同轮叠加后才比较整体效果。

2026-10-19现场使能会被 WebRTC 回退打成「网页请求停车」，推杆后则是「操纵授权超时」。R14 让页面默认走 WebSocket，通道接通或回退不再发停车；WebRTC 运动另有可靠副本，300ms 仍从签发时刻计算。19:56 与 20:06 两次重载后 8080 为 STANDBY。遥控已改为按住重复当前方向，车上按最后收到时刻保持 1 秒，到点只归零、不撤使能。挑战不再续租。雷达、里程计和会话过期未改。步骤见[手册33.18](操作手册.md#3318-使能被网页停车打断nav-017-r14)。持续推杆、松手停车和断流停车距离确认前，不开始20～30分钟场地建图。

CAM-005的组件、1 cm体素候选和CUDA证据已经记入测试记录。切换实验导航入口之前，仍须在固定实物姿态、相同TF和场景下补600秒健康、2 cm/边缘目标保留及真实Nav2负载对照；不由点数下降推定避障安全。步骤见[手册36节](操作手册.md#36-d435体素降采样组件通信与gpu核实cam-005)和[31.16](操作手册.md#3116-94档近平视与100刷新率的静止stvl验收)。巡检网页离线验证已通过；现场从停车保持、单步调角、新画面及人工确认开始，不直接启动整轮自动巡检，流程见[手册35节](操作手册.md#35-网页巡检与逐步舵机示教app-001-r1)。

使能、持续推杆、松手、断流停车及雷达停更分开确认后，再按[手册33.4](操作手册.md#334-小泽wifi下的真实传感器静止检查)做真实输入、分档起停、锁屏／后台和断网重连，然后做20～30分钟覆盖、保存和异地续建。地图以完整覆盖和无明显重影为门槛。启动底盘会发S1=94，须处理轮动力与支架扫掠前提；遥控不带自动避障。NAV-012的恢复和取消先做实车复测，通过前不改状态估计、规划器或速度。

随后依次稳定基础导航/取消与数据健康，复测深度输入/TF及空地/低障碍，再接入实车巡检。网页、配置和任务逻辑可先独立离线开发与验证，不提升现有实机结论。EKF、规划器对照、识别或回充按实际需求单独推进，不同时改变状态估计、规划器与速度参数。

## 操作、历史与长期路线

2026-10-15按用户要求实施并部署NAV-017-R8数据流修订：保留现有网关和门控，普通HTTP处理与控制收发分开，轻量状态/版本化激光预览分频获取，增加积压诊断。来源与取舍见[调研归档](archive/2026-10-15-网页建图数据流方案调研.md)；离线与现场验证状态只维护测试记录R8，操作/恢复统一手册33.13。部署后真实连接仍出现心跳撤销和控制断流，通信验收未通过；继续区分传输与客户端处理，不推进长距离路线验收。

R9按用户“换一种思路”新增局域网WebRTC数据控制路径，原WebSocket继续持有唯一操作者并交换信令，旧通道可选对照；未使能静默、每条新挑战一次周期回应，切换/关闭锁停，保持300ms车端截止。固定依赖与许可证见[专项调研](archive/2026-10-15-网页建图WebRTC控制通道调研.md)，构建/验证/部署结果只维护测试记录R9，操作统一手册33.14。传输替换不等于无线连续性已验收。

R10按用户“只需网页遥控建图、停止条件过多”收敛：静止就绪与运动有效期分开，静止/松手后不依赖操纵心跳，blur仅在仍按住摇杆时停车；运动签发后300ms截止不变，断开/页面隐藏/关键数据故障仍锁停。依据与本项目取舍见同一专项调研R10段；实施结果只维护测试记录R10，操作统一手册33.15。

R11针对仍偶发断联，隔离复现旧WebSocket2秒空闲回收连带关闭健康RTC；连接回收调整10秒，运动300ms截止不改，新增首个关闭错误及WS收帧/ping/pong诊断。固定原理与适用边界见[连接超时调研](archive/2026-10-15-网页建图WebSocket连接超时调研.md)，验证/部署只维护测试记录R11，流程手册33.16；旧现场未记录底层错误，不能将该路径当作唯一原因已经确认。

- [手册19节](操作手册.md#19-ubuntu-主机-rviz-联调)：电脑本地轻量RViz、车端SSH与地址核对。
- [手册31节](操作手册.md#31-stvl-深度导航主线nav-016)：现行STVL实验与31.16/31.17/31.18现场边界。
- [手册34节](操作手册.md#34-项目瘦身检查点与恢复maint-001)：检查点、维护验证与恢复。
- [维护执行结果](archive/2026-10-14-瘦身执行结果.md)：文件清单、前后指标、规则映射与未实施建议。
- [历史索引](archive/README.md)、[整理前路线原文](archive/项目路线原文_20261014.md)：保留原结论，不作为并列的“当前下一步”。
- [工业级优化建议与学习路线](工业级优化建议与学习路线.md)：成熟方案取舍与学习验收；长期目标不跳过当前门槛。
