tfsvh69-blip/Nav2_car/docs/历史/2026-09-19-导航三类异常接手说明.md

# 2026-09-19 导航三类异常接手说明

本文给下一个 AI / 开发者接手用，不是日常启动入口。当前操作仍以 [操作手册](../操作手册.md) 第 18、19 节为准；当前阶段以 [项目现状与路线](../项目现状与路线.md) 为准。测试编号与结论表在 [测试记录 NAV-012-R5](../测试记录.md)。

**不要把本文写成实机已通过。** 实验栈防守已落地，2026-09-19 离线 CTest 已通过（7/7，68 tests）。实车未复测；为编译测试，车上实验导航与实验定位已停止，复测前按手册第 18、19 节重新启动。

---

## 1. 你现在该做什么

离线部分已完成。下一步只做实车复测，不要一上来改稳定 `nav2.yaml` 或提交 git：

1. 读本文第 3～6 节（现象、日志证据、运行时配置 vs 当前工作区）。
2. 按手册第 18 节在车上重启实验定位和实验导航、第 19 节在 Hao 开 RViz。旧的 21:14 进程已停；不重启会继续用旧覆盖。
3. 验收口径见路线文档「当前唯一下一步」。
4. 用户没有明确说 commit 时不要提交。

---

## 2. 本对话做了什么、停在哪里

| 时间（约） | 事件 |
|---|---|
| 21:21 | 用户描述三类异常，要求对照完整日志定位模块/参数，并给规避方案。当时 Cursor 处于 Multitask，父代理把排查交给后台子代理。 |
| 21:21～21:41 | 后台子代理 [导航异常诊断](07a656da-66a5-4a97-baa3-40b7bb3a7a08) 已读会话日志并改实验栈、补测试、起草 R5 文档；离线回归未跑完。 |
| 21:41 | 用户说「继续执行」，已退出 Multitask。父代理打断子代理，自己核对 21:14 会话日志与工作区 diff。 |
| 21:43 | 用户改口：先把当前对话已知信息写成文档，方便下一个 AI 接手。**本对话此后只写文档，不再继续改代码或跑测试。** |

子代理自述（打断时）：主证据会话 `20260919_211408_7219`；三类根因已有推断；实验栈防守已落地；CTest 当时 6/7，卡在「同一轮两段倒车」；冷却语义刚改完未重跑。父代理随后用日志原文核对过根因，与子代理方向一致，细节以本文第 4 节为准。

相关对话：本会话 transcript `3b230a2b-51a9-4603-ab74-c734f7ad32f3`。不要依赖子代理未完成的口头结论，以仓库文件和下列日志为准。

---

## 3. 工程与联调前提（已确认）

代理工作区在车上 Jetson，不是用户眼前的 Ubuntu。

| 项 | 值 |
|---|---|
| 车 | `jetson@xiaozhu`，`192.168.5.11`，工程 `/home/jetson/luhao/my_nav_carcar` |
| 用户本机 | `luhao@Hao`（`Hao.local`），2026-09-18 为 `192.168.5.17`（DHCP 变了以 `ip a` 为准） |
| 代理查 Hao | `ssh -i /home/jetson/.ssh/id_ed25519 luhao@192.168.5.17` |
| 实车 ROS | `ROS_DOMAIN_ID=31`，`ROS_LOCALHOST_ONLY=0`，Wi‑Fi `小泽`，默认 Fast DDS |
| 导航入口 | 实验：`navigation_experimental.launch.xml` + `nav2.yaml` **再叠加** `nav2_experimental.yaml`；稳定对照不要改 |
| RViz | 只在 Hao 本机开 `navigation_lite.rviz`；不要 SSH、不要在 Cursor 远程终端或 VNC 开三维 |
| 里程计 | 本阶段纯轮式，不融合 IMU |
| 语言约束 | 文档中文；新逻辑 C++；Launch XML；完整命令只维护在操作手册 |

协作总规则：仓库根目录 `AGENTS.md`。

---

## 4. 用户三类现象与日志证据

主证据（必须先打开）：

- 会话目录：`/home/jetson/luhao/my_nav_carcar/log/nav_sessions/20260919_211408_7219/`
  - `events.log` / `events.jsonl`：行为树与恢复事件
  - `active_config.yaml`：**当晚实车真正加载的实验覆盖**（与当前工作区不完全相同）
  - `behavior_trees/navigate_to_pose_active.xml`：当晚 BT
- 对照会话：`.../20260919_211029_6448/`（21:10 启动，21:11:43～21:13:54）
- ROS：`/home/jetson/.ros/log/controller_server_7198_1789823648125.log`
- ROS：`/home/jetson/.ros/log/behavior_server_7206_1789823648131.log`
- ROS：`/home/jetson/.ros/log/bt_navigator_7208_1789823648135.log`

当晚导航任务：

1. `f73ec48a` 21:14:14～21:14:39，从约 `(-1.88,-0.35)` 到 `(-1.48,0.45)`，先倒车再到达。
2. `29e61dfe` 21:16:17 向 `(-4.13,1.80)` 行驶中。
3. `65c5c6d3` 21:16:34 抢占到 `(0.22,0.19)`，在约 `(-2.2,1.0)` 垃圾桶附近振荡后 **ABORTED**。用户说的三类现象主要在第 3 段，第 1 段可作对照。

### 4.1 右转约 45° 后又左转回障碍，再倒车

**不是**「局部规划已经选出可行右绕、全局却禁止」。全局 1 Hz 重规划当晚一直成功。

第 3 段时间线（`events.log`）：

- 21:16:51 前向障碍从约 0.97 m 掉到 0.49 m，随后贴到 0.27～0.28 m；后方仍有 1.1～2.4 m。
- 21:16:59.463 `PROGRESS_GUARD: ROTATION_BUDGET_EXCEEDED`（文案：单次转向总预算耗尽）。当时指令 `nav(vx=0.07,wz=0.73)`，车体 `(-2.26,0.91)`，前 0.28 m、后 1.10 m。
- 21:17:00.525 `CONTROL_FAILED`（FollowPath 失败）。
- 21:17:00.967 `REAR_CLEAR_PASSED`，后 1.14 m。
- 21:17:01 开始受限倒车 0.20 m / 0.05 m/s。

第 1 段对照：21:14:17 起 DWB `No valid trajectories out of 599!`，原因 `ObstacleFootprint/Trajectory Hits Obstacle` 与 `Oscillation/Trajectory is oscillating`。21:14:18.278 `PROGRESS_GUARD: ANGULAR_CONVERGENCE_FAIL`（3 s 内朝向改善 `-0.026 rad`）。车体几乎没动就进了倒车；倒车后最终到达。

**本项目推断（待实机复测）：**

1. **RotationShim**：当晚 `angular_dist_threshold=1.05`（约 60° 才强制原地对准）、`angular_disengage_threshold=0.40`（约 23° 才交回 DWB）。用户看到的「先右转约 45°」更像 DWB/Shim 正在对路径航向，还没到可前进的脱离角。
2. **DWB GoalAlign 过重**：当晚 `GoalAlign.scale=12.0`，`PathAlign.scale=6.0`。右绕起步后 GoalAlign 会把车头拽回**目标点朝向**（常常正对障碍），看起来就是「刚转开又转回去」。这是工业上常见的 critic 权重问题，不是 Nav2 官方把倒车当第一选择。
3. **ProgressGuard 8 s 转向总预算**：BT 当晚已是 `max_rotation_budget=8.0`，**没有**航向翻转重置。路径左右绕行导致参考航向翻转时，左右两段对准被合成一次 8 s 失败，然后 BT 按恢复树**立刻倒车**，而不是沿已转出的 45° 继续前进。
4. 排除项：不是 AMCL 丢定位（当晚多次「定位健康就绪」）；不是全局规划失败。

### 4.2 倒车提前取消（后方雷达约 1.5 m）

**直接证据（ROS `behavior_server`）：**

```
[WARN] [ProtectedBackUp] 扫描数据过期 (stamp_age=0.10s, recv_age=-0.00s > 0.50s)，安全中止倒车
backup failed
[backup] [ActionServer] Aborting handle.
```

时间 21:17:16.921。同一时刻会话日志后方约 **2.45～2.52 m**，前向约 0.30 m。用户目视的 1.5 m 与日志同量级，**不是 40 cm 安全距触发**。

ProtectedBackUp 当晚配置（启动时 INFO）：`最大数据年龄=0.50s, 后方安全间隙=0.080m, 车体半长=0.140m`。真正的后方急停阈值是 `half_length + rear_clearance_limit ≈ 0.22 m`，且只看车体后方近处扇区。

**本项目推断（待实机复测）：**

- 取消条件是**时钟新鲜度误判**，不是膨胀、footprint、激光残留点、也不是 40 cm 碰撞距。
- `recv_age=-0.00s` 表示「刚收到、年龄略负」，旧逻辑把负年龄当成 `> 0.50s`。ROS 时钟与回调采样差几毫秒就会出现。
- RViz 后方红色区域：局部膨胀半径当晚就是 **0.20 m**，膨胀可视化会把障碍「涂厚」。那是显示，不是这次 abort 的原因。不要把红区当成倒车取消判据。

当晚第二次倒车还出现过「先 SUCCEEDED 日志、随即 ABORTED」的交错，属于 Action 状态回放/所有权问题，R2 已记为未拆完项，本轮不要顺手重写 Action 生命周期。

### 4.3 垃圾桶旁反复倒车→前进→再倒车

同一任务 `65c5c6d3`：

| 时刻 | 事件 | 位置 / 前后障碍 |
|---|---|---|
| 21:17:01～05 | 第一段倒车成功 | `(-2.26,0.91)` → `(-2.27,1.13)`，前 0.27→0.42 m，后约 1.16 m |
| 21:17:06 | 立刻回到跟随，`nav(vx=0.03,wz=0.80)` | 又朝障碍转 |
| 21:17:08～14 | 全局重规划持续成功（30 s 内曾 20 次） | 前向重新贴到 0.24 m，后向 2.52 m |
| 21:17:14 | 再次 `ROTATION_BUDGET_EXCEEDED` | 未走出绕行 |
| 21:17:15～16 | 第二段倒车开始，约 1.7 s 后因 `recv_age` 中止 | 后 2.45 m |
| 21:17:17 | 改走 ControlledSpin | |
| 21:17:22 | FollowPath 再失败 | 前 1.37 m、后 0.50 m（自旋后扇区对调） |
| 21:17:23 | `REAR_CLEAR_DENIED`：`BUDGET_EXHAUSTED`（后退距离无效或本次受阻额度不足） | 失败倒车**未释放额度**（当晚运行代码） |
| 21:17:32 | 再次预算耗尽 + 拒绝倒车 → `ABORTED` | 前 0.24 m、后 1.38 m |

**本项目推断：**

- 全局路径已经在绕，局部没有稳定跟上（GoalAlign/Shim/8 s 转向预算把车拧回障碍）。
- ProgressGuard 把「还在转向」判成无进展，BT 优先倒车。倒车只有 0.20 m，回到跟随后立刻再转、再贴障碍，形成振荡。
- 第二次倒车被时钟误杀后额度未释放，后续即使后方空也无法再倒，只能转/观察/失败。
- Nav2 自带 `PoseProgressChecker` 当晚 `movement_time_allowance=12 s`，本段主要触发源是自研 ProgressGuard 的 8 s 转向预算，不是 12 s 平移检查。

---

## 5. 当晚运行配置 vs 当前工作区（必须分清）

`active_config.yaml` 是 21:14 启动时拷贝的实验覆盖。当前工作区又在那之上做了 R5 防守，**尚未实车加载**。

| 参数 | 21:14 实车已加载 | 当前工作区（未提交、未复测） |
|---|---|---|
| `FollowPath.angular_dist_threshold` | 1.05 | 1.20 |
| `FollowPath.angular_disengage_threshold` | 0.40 | 0.70 |
| `GoalAlign.scale` | 12.0 | 3.0 |
| `PathAlign.scale` | 6.0 | 5.0 |
| `PathDist.scale` | 14.0 | 18.0 |
| `recovery.backup_cooldown` | 无 | 12.0 |
| ProgressGuard 航向翻转 | 无（仅 8 s 预算） | `heading_flip_threshold=0.35`，`max_heading_flips=3` |
| ProtectedBackUp 负年龄 | 负 `recv_age` 当过期 | `ros_age_fresh()`，抖动 50 ms 内的负年龄视为新鲜 |
| 失败倒车释放额度 | 当晚未释放（见 BUDGET_EXHAUSTED） | `SafeBackUp::failed/rejected` 调用 `release_backup` + `note_backup(false)` |

以下在 21:14 **已经在跑**，不是本轮新发明（属于更早的 R3/R4 未提交实验栈）：

- DWB 最高 0.18 m/s、`sim_time=1.2`、SplitHorizon 轨迹生成
- 局部膨胀 0.20 m、全局 0.30 m、footprint `0.28×0.26 m`
- 倒车限额单次 0.20 m、速度 0.05 m/s、6 s；停稳 0.4 s、停滞 3 s、观察 8 s
- 插件 `carcar_navigation/ProtectedBackUp`

稳定 `src/carcar_navigation/config/nav2.yaml` **不要改**。

---

## 6. 工作区里已经落下的防守改动

只改实验栈。关键文件：

- `src/carcar_navigation/config/nav2_experimental.yaml`
- `src/carcar_navigation/behavior_trees/navigate_to_pose_experimental_recovery.xml`
- `src/carcar_navigation/behavior_trees/navigate_through_poses_experimental_recovery.xml`
- `src/carcar_navigation/src/protected_backup.cpp`
- `src/carcar_navigation/include/carcar_navigation/protected_backup.hpp`
- `src/carcar_navigation/src/nav012_nodes.cpp`（ProgressGuard 翻转、RearClear 冷却、SafeBackUp 失败释额度）
- `src/carcar_navigation/src/recovery_runtime.cpp` / `include/carcar_navigation/recovery_runtime.hpp`（`ros_age_fresh`、`backup_cooling`、`note_backup`、预算 0.20/0.40）
- `src/carcar_navigation/test/test_nav012_regressions.cpp`

意图（不是已验证效果）：

1. Shim 更晚才原地对准、更早交回 DWB（约 69° / 40°），降低「转到 45° 仍被 Shim 锁死」。
2. 压低 GoalAlign、略降 PathAlign、提高 PathDist，让局部跟着绕行路径而不是目标朝向。
3. 路径参考航向翻转时重置 8 s 转向窗口，左右绕不算同一次失败；翻转超过 3 次才报 `PATH_HEADING_OSCILLATION`。
4. 倒车新鲜度允许约 −50 ms 抖动；锁内取 `now`，避免回调写入更新 recv 后用旧 now 算出负年龄。
5. 倒车成功或失败后 12 s 冷却：`RearClear` 报 `BACKUP_COOLDOWN`，改走跟随或受控转向。失败倒车释放额度。冷却期内不再允许同回合第二段 0.20 m 倒车（与垃圾桶振荡对打的旧测试已改为 `FullTreeUsesBackupThenSpinDuringCooldown`）。

---

## 7. Git 雷区：不要把全部未提交都当成 R5

`git status` 里有大量更早会话的未提交改动（R3 1.5 倍速、R4 缩短等待、escape/split_horizon/wheel_imu_ekf、文档、RViz、底盘 launch 等）。**R5 只是叠在这座未提交山上。**

不要：

- 把整个 working tree 打成一个 commit
- 为「统一语言」删除旧 Python 测试
- 改 `navigation_lite.rviz`（约定：改 RViz 前必须向用户确认组件/话题/Fixed Frame/QoS）
- 把未实机验证的参数写入稳定 `nav2.yaml`
- 本阶段把 IMU 送进 EKF（`wheel_imu_ekf` 相关未跟踪文件不是当前验收项）

用户未要求 commit，不要提交。

---

## 8. 文档入口已有的交叉引用

- [测试记录](../测试记录.md) 顶部结论表已有 NAV-012-R5 行；折叠详情已起草，但「实际结果」在本对话结束时仍写成「离线验证见本轮构建/CTest 记录」，**不准确**。
- [项目现状与路线](../项目现状与路线.md) 唯一下一步已是复测 R5 三类现象。
- [操作手册](../操作手册.md) 第 18 节是唯一完整启停命令；第 19 节是 Hao RViz。不要在对话或本文再抄一套。

离线测试入口（命令本身以手册 18.2 为准）：`test_nav012_regressions`、`test_protected_backup_execution`、`test_nav_escape_logic`、`test_nav_bt_nodes`。子代理曾在约 21:36 跑过一轮，`test_nav012_regressions` 日志在 `/home/jetson/.ros/log/test_nav012_regressions_10662_1789824999674.log`，当时冷却语义随后又改过，**不能当作最终结果**。

---

## 9. 建议的验收观察（实车，待做）

不另写启动命令。重启底盘和导航后再看：

1. 空地巡航指令速度是否约 0.18 m/s（R3 遗留，顺带看，不是本轮新问题）。
2. 前方突发障碍：右转到约 45° 后是否继续沿该侧前进，而不是 8 s 内拧回障碍再倒车。会话里应少见紧挨着的 `ROTATION_BUDGET_EXCEEDED` → `BACKUP_ACTION_STARTED`。
3. 倒车时雷达后方约 1.5 m：不应再出现 `recv_age=-0.00s > 0.50s`。若中止，新日志格式含 `stamp_age/recv_age/steady_age/limit`，用这四个数判断。
4. 垃圾桶旁：第一段 0.20 m 倒车成功后，12 s 内是否不再立刻倒车；全局绕行路径是否被局部跟上。若再次 `BUDGET_EXHAUSTED`，检查失败倒车是否已 `release_backup`。
5. 后方 RViz 红区单独记为膨胀可视化，不与第 3 条混为一谈。

安全：12 V 可立即断开；串口同时只能一个进程；改速度后必须重启底盘和导航。

---

## 10. 已知未决问题（接手后优先）

1. **离线测试已收口。** 冷却语义定为：任何倒车后 12 s 内挡住再倒。`FullTreeUsesBackupThenSpinDuringCooldown` 期望 1 次倒车后走转向。2026-09-19 按手册 18.2：7/7 CTest、68 tests、0 失败。
2. **GoalAlign 从 12 降到 3、Shim 脱离角到 0.70 都未实车。** 可能让终点对准变慢，或中小角度几乎不再原地转。若空地晃，优先回调 GoalAlign/PathAlign，不要先加倒车。
3. 假倒车成功加迟到 ABORTED 仍属 R2，本轮不要扩 scope。
4. 本阶段不融合 IMU，不把 `wheel_imu_ekf` 当当前任务。

---

## 11. 分类标签（避免下一个 AI 把推断写成事实）

| 陈述 | 类别 |
|---|---|
| 21:17:16 `recv_age=-0.00s` 导致 backup abort；当时后方约 2.5 m | 日志已确认 |
| 21:16:59 / 21:17:14 / 21:17:32 三次 `ROTATION_BUDGET_EXCEEDED` 后进恢复 | 日志已确认 |
| 全局重规划当晚成功、局部未跟上绕行 | 日志已确认 |
| GoalAlign=12 造成「转开又转回」 | 本项目推断 |
| 8 s 预算把左右绕行合成一次失败 | 本项目推断 |
| 负年龄时钟修复、冷却 12 s、GoalAlign=3 能消掉三类现象 | 待实机验证 |
| 膨胀过大/footprint 不合理导致提前停倒车 | 被当晚 abort 原文否定；红区仍可能误导操作员 |
