tfsvh69-blip/Nav2_car/docs/archive/2026-10-07-D435安装角与STVL响应调研.md

# D435 安装俯仰角与 STVL 响应时间调研

日期：2026-10-07。本文记录一手资料与本项目几何推断，不作为当前启动入口。完整操作命令统一维护在[操作手册](../操作手册.md)，当前实物前提见[硬件台账](../硬件台账.md)，实机结果见[测试记录](../测试记录.md)。本专题不修改配置、不操作串口或舵机；用户反馈“完全移除物体后已正常消失”属于当前现场反馈，不等于持续障碍、故障停车或导航验收全部通过。

## 2026-10-08补充：低高度误标与过滤方案边界

本轮软件实读RealSense ROS4.58.3、librealsense2.58.4，PCL1.12.1；以下按该版本核对，不能用最新文档未落地的新接口替换Humble入口。当前实机结论只维护NAV-016-R2，不把此处调研等同去噪通过。

“地面平均接近零”与“没有假障碍”是不同指标：前者反映大部分近地测量与TF一致，后者必须检查少数越过最低高度门槛的点。时间确认要求多帧命中，也会接受连续数帧噪点；STVL按观测存储/过期，过期功能正常仍可能短暂把噪点投影成二维障碍。这是本项目对已捕获链路的解释，不能据此确定反光、低纹理、温漂或匹配错误是哪一种物理原因。

下一轮优先只比较两种成熟空间方案，保持原生宽视场、同一实体姿态、测距/高度/健康门槛和场景：

| 方案与来源 | 输入输出/工作原理 | 本车代价与验证边界 |
|---|---|---|
| SDK保边空间滤波，librealsense2.58.4，Apache-2.0；[固定版说明](https://github.com/realsenseai/librealsense/blob/v2.58.4/doc/post-processing-filters.md)、[源码](https://github.com/realsenseai/librealsense/blob/v2.58.4/src/proc/spatial-filter.cpp) | 对深度/视差图沿行列平滑，利用差异门槛保留边界；输出过滤深度，随后正常生成点云 | 本项目先保持填洞关闭；观察孤立高点是否减少，同时量化2 cm目标点数、保持率、边缘/近距漏检和6 Hz健康。未经同场景实测不称修复 |
| PCL半径离群点过滤，1.12.1，BSD-3-Clause；[固定版实现](https://github.com/PointCloudLibrary/pcl/blob/pcl-1.12.1/filters/include/pcl/filters/impl/radius_outlier_removal.hpp) | 输入XYZ点云，按指定半径内邻居数判断保留，输出剩余点；复用项目已有影子/离线扫描资产 | 密集噪点可能保留，真实稀疏小物体也可能被删；邻居数随距离/采样密度改变。先离线/影子比较，再以真实2 cm实测决定；历史不同姿态/场景扫描不直接当本轮通过 |

SDK时间滤波利用历史像素并可在缺测时复用旧值，官方明确可能拖影、偏向静态场景；[2.58.4实现](https://github.com/realsenseai/librealsense/blob/v2.58.4/src/proc/temporal-filter.cpp)。它与本项目“2 cm格子最近3帧命中2次才标障”的确认输入/输出不同，不能因两者都叫时间处理就直接叠加。确认帧数增加也会增加首次识别延迟，6 Hz下每增加一帧约增加0.167秒等待；实际因丢点更久，需实测。填洞生成邻近像素推断值，深度缺测本身不证明空闲，当前不将填洞值作为避障可靠性的证明。

验收同时报告假致命格事件/持续时间、真实小目标保持/漏检、标障与撤障延迟、源/图层数据新鲜度。保持率/清除时间与空地误标分别判断，不能用缩短TTL或抬高到2 cm以上的高度阈值代替去噪。SDK文档的处理顺序是参考示例，当前不在固定健康窗口修改处理链，也不复制上游实现。

## 1. 结论与适用版本

优先继续使用 STVL 2.3.4 的线性时间衰减和独立健康停车。建议在独立静态入口比较 2.0、1.5、1.0 秒记忆，先以 1.5 秒作为较温和候选；尚未通过实物保持与遮挡测试时，不直接替换正式导航默认。缩短记忆改善撤障响应，不能提高相机首次看到障碍的能力。

安装角按“目标高度、最近可靠测量范围、当前内参、真实光心高度、支架遮挡、地面实测”决定。暂以实际光轴平视和下俯约 5°为首组比较；没有依据给本车一个通用的“最佳舵机角”。140.5°是历史舵机命令目标，与相机相对地面的真实俯仰角是不同量。

Nav2 官方把 STVL 作为外部三维代价地图插件，并提供衰减与视锥参数示例；示例使用旧 R200 点云与示例 FOV，并未指定本车的安装角。[Nav2 官方教程](https://docs.nav2.org/rolling/tutorials/general_tutorials/navigation2_with_stvl/)属于 Rolling 文档；本项目行为必须对照[STVL 固定提交 92896fe9](https://github.com/SteveMacenski/spatio_temporal_voxel_layer/tree/92896fe9ea994260bf34f1fa7b7735f3804cfc6f)，不能照抄全部示例。

## 2. 主流工程做法的依据

[Clearpath 官方 D435 接入文档](https://docs.clearpathrobotics.com/docs_robots/accessories/sensors/cameras/realsense_d435/)把传感器安装的 `parent`、`xyz`、`rpy` 与 ROS 驱动参数统一纳入机器人配置。可借鉴的是安装外参与数据配置可追溯，页面的零位示例不是对所有车推荐水平安装，也不是本车最佳角度。

[RealSense 官方深度调优说明](https://dev.realsenseai.com/docs/tuning-depth-cameras-for-best-performance/)建议通过平面拟合检查误差，并指出曝光、纹理、距离会影响有效深度；厂商推荐 D435 的精度模式为 848×480。项目当前 640×480/6 Hz 属于低负载实验，不能把减小记忆时间当作弥补测距精度。官方文章针对重复纹理提到倾斜相机的办法，其上下文是匹配歧义，不是给低矮机器人推荐统一 20°～30°下俯。

长期导航优先保持固定、可复现的安装姿态，实测后把外参写入固定 TF。若要边运动边转动相机，需要同步的真实关节姿态与采样时刻 TF；本车当前只有已发送舵机命令估计，没有到位反馈，不能把动态模型当作实际角度证据。此项是根据现有接口能力作出的本项目取舍。

## 3. 当前内参与近地覆盖推算

厂商产品页的 D435 深度标称 FOV 为 87°×58°，理想距离约 0.3～3 m，最大分辨率 Min-Z 约 28 cm；RGB 的视场另为 69°×42°。[D435 官方规格](https://www.realsenseai.com/products/stereo-depth-camera-d435/)。历史 0.105 m 的 Min-Z 对应较低分辨率，不能笼统用作当前可靠避障范围；[D400 Rev013 数据手册的表 4-11](https://docs.clearpathrobotics.com/assets/files/clearpath_robotics_017103-TDS2-80efb31ac3e573ef412db1cbfe285e63.pdf)列出了各深度分辨率的 Min-Z。

本轮主代理实读深度 `camera_info`：width=640、height=480、fx=fy=385.14886475、cx=319.99456787、cy=237.70277405。这里只确认读取值，不宣称绝对标定精度已通过。应使用对应深度流的内参，不使用 RGB 内参或产品宣传视场替代；ROS 的 K 与 P 分别定义原始和校正图像投影，改变 ROI、抽样或流模式后要重新核对。[Humble CameraInfo 定义](https://github.com/ros2/common_interfaces/blob/humble/sensor_msgs/msg/CameraInfo.msg)。

对无畸变或已校正图像，以像素边界 -0.5 与 479.5 计算：

`下半视角 β = atan((479.5 - cy) / fy) ≈ 32.1207°`

`上半视角 = atan((cy + 0.5) / fy) ≈ 31.7355°`

合计约 63.8562°。若按像素中心 0/479，则合计约 63.7490°，差别来自边界定义。该结果更新了历史按 44.9°估算的当前模式覆盖；不能用不同模式的历史视场判断本轮机械俯仰。

设真实深度光心离地 h=0.163 m（现有粗量值）、实际光轴向下俯 θ 为正、目标顶面离地 H，则中央下边缘命中平面的水平距离为 `d=(h-H)/tan(θ+β)`。这是相机正前方相对光心的水平距，不是车体 `base_footprint` 的 x 或相机斜距；忽略 roll、畸变、支架遮挡和深度有效率。

| 实际光轴俯仰假设 | 几何地面最近距离 H=0 | 2 cm 目标顶面几何最近距离 |
|---|---:|---:|
| 仰头 6.429763° | 0.339 m | 0.297 m |
| 平视 | 0.260 m | 0.228 m |
| 下俯 5° | 0.215 m | 0.189 m |
| 下俯 10° | 0.180 m | 0.158 m |

首行只是对当前候选 TF `pitch=-6.429763°` 的几何解释；该 TF 来自历史拟合，本轮机械姿态仍需确认，不能据它发送舵机动作。

项目过滤器实际采用欧氏斜距 `sqrt(x²+y²+z²)`，下限 0.30 m，见[depth_logic.hpp](../../src/carcar_camera/include/carcar_camera/depth_logic.hpp)。因此上述光心高度下，地面点的斜距过滤对应中央水平下限约 0.252 m，2 cm 顶面对应约 0.264 m。几何可见不等于会进入过滤点云，更不等于小物体可靠被识别；平视已接近本轮有效近距下限，大幅低头的收益可能很小，并可能改变远处目标、车体遮挡与地面噪声分布。

## 4. 如何实测确定安装角

1. 先确认四轮落地、平整地面、充电线和其他遮挡移开、车轮动力隔离；重新粗量左红外光心到地面的高度。架高车体会改变覆盖，不能当作地面俯仰验收。
2. 保持当前舵机不动，保存当前内参、TF 和原始点云，使用已有 `depth_snapshot` 与 `depth_floor_profile`；中央空地的分段高度应接近真实地面。现有 profile 按 `base_footprint` 的 x 分组，仅统计 0.5～1、1～1.5、1.5～2、2～3 m，故额外近距 0.3～0.5 m 与两侧区域必须另测，不能凭中央统计验收全视野。
3. 平面模型 `z=ax+by+c` 分别观察纵向斜率、横向斜率、截距、RMS 与 P99/P99.9；检查每段点数、覆盖及无点帧。只有现场空地和可靠几何前提成立时，斜率才可用于修订外参；地面本身坡度、距离偏差和稀疏点会干扰结果，不能让软件自动宣称相机平视。
4. 首组实物对比使用机械光轴平视和下俯约 5°，每个姿态各保存独立外参；由现场确认安全后再调整舵机，保持历史 85°～160°安全命令边界，禁止越界。不要把“真实下俯 5°”简单加到 140.5°命令上：须先核实板端角度映射、方向和量化。
5. 同一背景、曝光、过滤、速度限制下，把真实 2×2×2 cm 目标放在 0.5/0.8 m，再测左右边缘、0.3～0.5 m和更远处。每档记录检测率、最长连续漏检、出现到二维致命格的延迟、撤障时间及空场误障。至少验证持续 60 s 不丢障、空场 120 s和重启后的姿态复现。最终角度由这些结果决定。

地面工具只反映输入数据，不能证明机械保持能力、yaw、全部平移或所有侧边覆盖。正式导航前要处理底盘启动 S1 重置的问题，确保实体姿态与测试外参一致。

## 5. 更快的残留消除如何验证

[固定版体素源码](https://github.com/SteveMacenski/spatio_temporal_voxel_layer/blob/92896fe9ea994260bf34f1fa7b7735f3804cfc6f/spatio_temporal_voxel_layer/src/spatio_temporal_voxel_grid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)在线性模式用 `voxel_decay - 距离最近标记时间` 判到期，并在更新循环退出过期体素；重观测会刷新记忆。视锥加速依据几何范围加快遗忘并修改保存时间，未作逐像素遮挡检查。[固定版测量缓存](https://github.com/SteveMacenski/spatio_temporal_voxel_layer/blob/92896fe9ea994260bf34f1fa7b7735f3804cfc6f/spatio_temporal_voxel_layer/src/measurement_buffer.cpp)的 clear-only 分支甚至跳过点云内容。[RealSense 官方投影说明](https://dev.realsenseai.com/docs/projection-in-realsense-sdk-2-0/)定义深度零为无法确定深度；因此视锥中的无点、空场、低纹理和遮挡不能仅凭此插件区分为已证实自由空间。

| 独立候选 | 用途 | 需要额外检查 |
|---|---|---|
| 2.0 s，本地基线 | 保留当前对照 | 实测撤障至体素、二维障碍、膨胀各自消失的时间 |
| 1.5 s，本地候选 | 先减少 0.5 s记忆 | 持续障碍和轻微晃动时是否断标，最长单体素重观测间隔 |
| 1.0 s，本地候选 | 1.5 s通过后比较 | 低纹理小目标、遮挡、出视野后返回、断流停车期间的地图行为 |

先固定其他参数，以每档至少多次撤障统计 P50/P95/最大值；时间起点记录最后一次有效标记或手和物体完全离开视野的时刻，不能混用。当前点云约 6 Hz、局部地图 5 Hz，观察显示还受地图发布、传输与 RViz 更新影响；TTL 减少多少，不保证肉眼测到的消失时间精确减少多少。

故障健康门限、连续健康恢复门限、全局地图 5 s记忆和运动许可本轮保持独立，不随局部 TTL 缩短。地图遗忘真实但暂时看不见的障碍是短 TTL 的代价；数据持续新鲜也不能证明每个小目标每帧可见。暂不优先新增视锥清除：先通过纯 TTL 对照，随后用真实遮挡和空洞场景验证，再确定是否需要几何加速。

`voxel_decay` 在固定版动态回调中没有重新构造网格的实现，候选通过独立启动参数和重启生效，不能仅凭 `ros2 param set` 返回成功判断行为已变化。[固定版参数回调](https://github.com/SteveMacenski/spatio_temporal_voxel_layer/blob/92896fe9ea994260bf34f1fa7b7735f3804cfc6f/spatio_temporal_voxel_layer/src/spatio_temporal_voxel_laye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)。

## 6. RGB No Image 的解释边界

RGB 是独立彩色流，当前静态入口如 `enable_color:false`，其 Image 显示没有发布者就会正常显示 No Image；这不证明深度链路失败。若启用 RGB 后仍无图，再检查正确的 `image_raw` 话题、消息频率、RViz QoS与主机 ROS 域。不要另开 SDK/Viewer 争抢当前 ROS 相机。若需要 RGB 仅用于位置参考，保持本机 RViz 默认关闭、在 Ubuntu 主机查看，单独验收彩色＋深度＋点云多订阅的健康。

本轮主代理只读核对到当前 RGB 关闭、无对应图像发布者、深度约 6 Hz，并出现一次 `POINTCLOUD_STAMP_EXPIRED`；这表示还要量化传输健康，不能立即提高采集频率或改为运动验收。完整采样结果由主代理追加测试记录。

## 7. 接手续测：跨机显示与采集回调的边界

2026-10-07当前安装读数为Fast DDS 2.6.12、rmw_fastrtps_cpp 6.2.10，未在进程环境中设置发布模式。该固定版[RMW官方README](https://github.com/ros2/rmw_fastrtps/blob/6.2.10/README.md)说明默认同步发布；同步写入在调用线程执行，异步发布则先入队、由后台线程发送。异步能隔离部分发送等待，但引入队列/线程和积压风险，不能凭环境变量已设置就宣称数据新鲜度解决，也不在本轮观测完成前改默认。

本地realsense-ros 4.58.3与[固定版官方源码](https://github.com/realsenseai/realsense-ros/blob/4.58.3/realsense2_camera/src/base_realsense_node.cpp)一致：frame_callback中处理滤镜并发布深度/点云，publishFrame只在图像有订阅时构造并发布图像。因此RViz启用原生图像会改变相机发布工作量，不只是远端渲染。当前工程推断是跨机原生深度图发送可能拖慢共同回调；须由同一相机进程无头→仅深度图→退出图像的对照证实，不能据源码将所有历史USB超时归为DDS，亦尚未测出publish内部阻塞耗时。

优先测试关闭显示与逐项加回，是因为本车首先需要保住点云新鲜度和可靠停车，改动可逆、无需升级驱动或固件；代价是调试时暂时少看画面。若确认图像负载有影响，再比较低带宽显示与显式异步候选，用同一600秒/0异常/至少5 Hz/0.50秒门槛验证，而非放宽导航时效或不断重启。测试结果只追加NAV-016-R2，完整操作在手册19.13与30.17。

当日静止STVL+录包+跨机体素/二维显示实测未通过，改Best Effort仍失败；显式异步候选更差，已停用保留，恢复同步。该结果否定“异步必然改善当前链路”的假设，不证明SDK或USB根因。另发现显示预览误拒绝空点云，修复仅解决预览更新，不改变真实STVL过期。当前优先恢复无跨机显示的同组负载基线，再分别加回显示；详细数值及原始证据只见NAV-016-R2。

RViz Humble的[PointCloud2显示源码](https://github.com/ros2/rviz/blob/humble/rviz_default_plugins/src/rviz_default_plugins/displays/pointcloud/point_cloud2_display.cpp)将结构匹配、保留XYZ字段的空消息传入公共显示器；[公共显示源码](https://github.com/ros2/rviz/blob/humble/rviz_default_plugins/src/rviz_default_plugins/displays/pointcloud/point_cloud_common.cpp)中Decay Time=0只在新帧到达时移除旧显示。因此预览层必须传递有效空帧，不能把它作为畸形数据丢弃。这是显示行为依据；本项目合成消息只验证预览接口，实际主机视觉仍需现场确认。显示断流时旧图也可能留住，不据此判断地图仍有体素。
