tfsvh69-blip/Nav2_car/docs/archive/2026-10-14-平板建图旧流程原文.md

# 2026-10-14 平板建图旧流程原文

以下保留本次完善前的完整第33节，包括终端启动、严格视频停车和备用热点步骤。用于历史复现，当前有效入口见[操作手册第33节](../操作手册.md#33-平板随行建图nav-017)。

## 33. 平板随行建图（NAV-017）

### 33.1 范围、画面与安全边界

终端归属：本章ROS与维护命令在车上Jetson执行，预备电脑用于SSH，平板用于浏览器。电脑新开的终端仍在电脑上，未登录车端前不要直接执行Jetson工作目录命令；原局域网SSH入口沿用第19节。

适用：当前小米平板6、小车与电脑都连接“小泽WiFi”，操作者随车、始终看得见车辆，仅在现有WiFi覆盖内的同一楼层走廊、房间和大厅低速人工建图。终端负责出发前的新建/续建选择；网页负责实时看图、遥控、任意位置续建提示与保存。2026-10-14用户取消本阶段热点工作，热点资产仅保留备用。平板兼容、实际覆盖、实物方向、相机帧率、起步和停车距离必须由现场反馈确认。

地图来自雷达与纯轮式里程计，统一在`map`坐标系俯视显示；黑色占据、白色空闲、灰色未知，5 cm/格，双指缩放只改变显示比例。白色只反映激光扫描平面的观测，不代表各高度都无障碍。红点为当前激光经TF转换后的投影，蓝色车位图标是软件估计和朝向示意，不是实物外廓或定位真值；黄色箭头为人工续建初值。RGB独立窗口是相机前方透视视场，640×480是像素数，不是物理范围，不能与俯视地图逐像素对照。地图约3秒更新，车位/扫描预览目标10/5 Hz，视频目标5～6 FPS；分别显示年龄，动画顺畅不等于匹配质量合格。

本入口无Nav2、AMCL、STVL、IMU融合或自动避障；SLAM仍使用软件截取的3 m激光，不是雷达硬件极限。大厅无固定结构或重复走廊匹配异常时先停车，不直接放大参数。所有旧底层入口保留。本次底盘仅订阅`/mapping/cmd_vel`，旧键盘公共`/cmd_vel`不进入该底盘。

初始零速、松手/换档/保存/断联/后台/视频过期停车，重连后重新使能。慢档命令上限0.05 m/s、0.10 rad/s，常档0.10 m/s、0.20 rad/s，均为独立试验参数。门控20 ms检查、0.20 s授权和既有底盘0.30 s看门狗只是软件保护，不是物理停车距离/硬实时保证。异常运动直接断开12 V轮动力；退出网页不能代替确认车轮停止。底盘启动会发送S1=94，支架可能旋转，须先清空扫掠空间并观察实物，不能把命令94当实际角度。

### 33.2 离线构建与验证

下面读取源码、ROS和既有依赖，写入`build/ install/ log/`，测试在独立域219/localhost使用替身底盘，不连接串口、相机或执行器。既有Python资产只做回归和静态编译，不新增Python节点。预期构建成功、C++测试与底盘回归通过；失败Ctrl+C停止，保留日志，修复后重跑本节，不进入硬件阶段。

```bash
cd /home/jetson/luhao/my_nav_carcar
conda deactivate 2>/dev/null || true
source /opt/ros/humble/setup.bash
source install/setup.bash
CMAKE_BUILD_PARALLEL_LEVEL=2 colcon build --symlink-install --packages-select carcar_base carcar_camera carcar_mapping_console --executor sequential
source install/setup.bash
ROS_DOMAIN_ID=219 ROS_LOCALHOST_ONLY=1 ctest --test-dir build/carcar_mapping_console --output-on-failure
ctest --test-dir build/carcar_camera -R '^test_image_reference$' --output-on-failure
python3 -m pytest src/carcar_base/test -q
python3 -m compileall -q src/carcar_base/carcar_base
node --check src/carcar_mapping_console/web/app.js
xmllint --noout src/carcar_mapping_console/launch/mapping.launch.xml src/carcar_camera/launch/camera_mapping_rgb.launch.xml
ros2 launch carcar_mapping_console mapping.launch.xml --show-args
```

只查看网页布局时，下组启动无硬件的软件入口，读取SLAM配置并写独立时间戳会话日志/PID，只更新`current`运行指针，不覆盖旧日志；不会打开串口、相机或电机。默认`start_hardware=false`，画面应提示等待传感器，不能把它当成建图成功。通过后台方式启动，预备SSH断开也不结束节点。异常按33.7停止，不能盲目重复启动占用8080端口。

```bash
cd /home/jetson/luhao/my_nav_carcar
source /opt/ros/humble/setup.bash
source install/setup.bash
export ROS_DOMAIN_ID=31 ROS_LOCALHOST_ONLY=1 RMW_IMPLEMENTATION=rmw_fastrtps_cpp
mapping_run_dir="log/mapping_console/$(date +%Y%m%d_%H%M%S_%N)"
mkdir -p "$mapping_run_dir"
nohup "$PWD/install/carcar_mapping_console/lib/carcar_mapping_console/mapping_prepare" \
  --mode new > "$mapping_run_dir/session.log" 2>&1 < /dev/null &
echo "$!" > log/mapping_console/current.pid
cp log/mapping_console/current.pid "$mapping_run_dir/launch.pid"
printf '%s\n' "$mapping_run_dir" > log/mapping_console/current.dir
ip -brief address show wlP1p1s0
tail -n 30 "$mapping_run_dir/session.log"
```

当前平板连接“小泽”，用Jetson实际WiFi地址加`:8080`访问；2026-10-14读回地址对应`http://192.168.5.11:8080`，IP变化时以重新读回为准。网页本身无需外网和Android安装包；电脑及Jetson保留原网络出口，实际互联网可用性仍取决于“小泽”上游。所有ROS数据保留localhost，平板不参加DDS发现。双开页面时仅一个控制WebSocket可占用遥控，其他连接不能抢占。

### 33.3 当前入口：小泽WiFi与平板网页检查

2026-10-14用户缩小场地，当前仅在“小泽”覆盖内随行建图；Jetson、平板和电脑都连接“小泽”。不执行热点创建、试点、激活或恢复，不要求为网络切换准备额外有线通道。热点功能保留备用，入口见33.9；原网络配置保持。以下检查只用于当前局域网通信，不说明场地覆盖或停车实机通过。

先在平板系统设置中连接“小泽”，电脑也保持原网络。Jetson地址由当前DHCP分配；本次只读核对为192.168.5.11，重启或地址变化后重新查看，不把它当固定保留地址。本组在Jetson终端读取连接名/地址与本地网页状态，不读密码、不改网络、不控制硬件；预期连接名“小泽”，软件预览为WAITING、armed=false、x/yaw为零。curl报连接失败时，先查33.2是否已经启动及日志；Ctrl+C停止查询，无需回滚。服务已在运行时不要重复启动。

```bash
cd /home/jetson/luhao/my_nav_carcar
nmcli -f GENERAL.CONNECTION,IP4.ADDRESS device show wlP1p1s0
curl --max-time 3 http://127.0.0.1:8080/api/state
```

在平板浏览器打开`http://192.168.5.11:8080`（地址以读回为准），检查中文布局与连接状态。仅软件预览时，地图/视频为空、遥控不能使能是预期，不能据此判相机或雷达故障。依次锁屏约10秒再解锁、切后台再回来3次、断平板WiFi约5秒再连回；预期控制连接自动恢复，不持续提示其他操作者，不自动使能、不恢复旧动作。一次只保留一个操控页面，电脑不用再打开控制页面占用会话。

若Jetson本地curl正常而平板打不开，先核对平板是否确实连接“小泽”而非访客网络，再检查路由器是否隔离无线客户端；仅同名SSID并不能证明设备间可互访。不要因此切热点或关闭全部防火墙。软件预览关闭按33.7；网络不需要恢复。页面可达后进入33.4真实传感器静止检查，接入传感器前必须先结束软件预览。

#### 33.3.1 只接RGB相机到现有网页（不启动底盘）

本入口用于软件预览已运行、平板页面可达后，单独查看D435真实RGB画面。当前只读检查相机未被占用后再启动；禁止与RealSense Viewer、其他相机入口或33.4整套入口同时运行。它只打开相机和JPEG压缩节点，使用RGB-only候选640×480/6 Hz；不打开底盘/雷达串口、不发S1、不启深度/点云/STVL。视频窗口是相机前方透视图，640×480表示像素数，窗口大小不改变镜头视场；地图仍为空是因为没有雷达/里程计，不代表视频故障。

下面在Jetson独立终端执行，加载与网页相同的域31/localhost环境，记录独立日志及PID，只更新相机运行指针。预期启动RealSense与RGB压缩两节点；该终端持续运行是正常现象，日志在下一组观察。重复启动前先停止本入口。失败Ctrl+C停止并查日志，不操作驱动/USB电源；退出后至少等5秒，原网页服务继续保留。

```bash
(
cd /home/jetson/luhao/my_nav_carcar
source /opt/ros/humble/setup.bash
source install/setup.bash
export ROS_DOMAIN_ID=31 ROS_LOCALHOST_ONLY=1 RMW_IMPLEMENTATION=rmw_fastrtps_cpp
mapping_rgb_run_dir="log/mapping_rgb/$(date +%Y%m%d_%H%M%S_%N)"
mkdir -p "$mapping_rgb_run_dir"
printf '%s\n' "$BASHPID" > log/mapping_rgb/current.pid
cp log/mapping_rgb/current.pid "$mapping_rgb_run_dir/launch.pid"
printf '%s\n' "$mapping_rgb_run_dir" > log/mapping_rgb/current.dir
exec ros2 launch carcar_camera camera_mapping_rgb.launch.xml > "$mapping_rgb_run_dir/session.log" 2>&1
)
```

另开Jetson终端只读取相机日志、HTTP状态和视频响应头，不发布速度或修改硬件。预期日志只有RGB Camera、Color 640×480/6配置，网页video_age保持新鲜，视频HTTP200且X-Frame-Id持续变化；返回的帧是源帧标识，不代表平板实际已显示，后者仍需现场观察。curl异常Ctrl+C停止读取，先查相机日志；不因为没有地图而使能或启动底盘。

```bash
cd /home/jetson/luhao/my_nav_carcar
mapping_rgb_run_dir=$(cat log/mapping_rgb/current.dir)
tail -n 50 "$mapping_rgb_run_dir/session.log"
curl --max-time 3 http://127.0.0.1:8080/api/state
curl --max-time 3 --silent --show-error --dump-header - http://127.0.0.1:8080/api/video.jpg --output /dev/null
```

平板保持当前网页，RGB应自动出现，未出现时刷新一次。静止查看时可让场景内的物体移动，确认视频持续更新；只有本地HTTP200不能证明平板显示、帧率或端到端延迟合格。此时仍无雷达/里程计，页面WAITING、遥控禁用属于预期。

停止时在相机启动终端Ctrl+C；代理启动或原终端不可用时，以下仅向记录的相机Launch发SIGINT，先核对命令行避免误停；关闭相机不会关闭网页，不改网络或原工程。等待至少5秒后检查退出日志。进入33.4前，必须先停这个独立相机入口及33.2软件预览，再启动整套入口，避免相机争用。

```bash
cd /home/jetson/luhao/my_nav_carcar
mapping_rgb_pid=$(cat log/mapping_rgb/current.pid)
ps -p "$mapping_rgb_pid" -o pid=,args=
if ps -p "$mapping_rgb_pid" -o args= | rg -q 'ros2 launch carcar_camera camera_mapping_rgb.launch.xml'; then
  kill -INT "$mapping_rgb_pid"
else
  echo 'PID不是本次RGB相机Launch，停止操作并检查日志'
fi
sleep 5
mapping_rgb_run_dir=$(cat log/mapping_rgb/current.dir)
tail -n 30 "$mapping_rgb_run_dir/session.log"
```

### 33.4 小泽WiFi下的真实传感器静止检查

先按33.7结束软件预览，保持全部设备连接“小泽”。本组在电脑上建立到Jetson当前WiFi地址的SSH会话，不修改配置、不启动硬件；预期看到车端提示符，Ctrl+D退出会话。若地址变化，先按33.3重新核对；已经登录Jetson的终端跳过本组。连接失败先检查原网络，不切换车端模式。

```bash
cd "$HOME"
ssh jetson@192.168.5.11
```

以下在刚登录的Jetson终端执行。预检后启动底盘、模型、雷达、唯一RGB采集、SLAM、网页和门控，会打开两个独占串口并发送S1=94，可能带动相机支架；初次检查须隔离轮动力并留出支架扫掠空间。关闭旧底盘/雷达/相机/SLAM入口，不能与RealSense Viewer争用相机。预检发现占用拒绝启动，不自动杀进程。异常先现场断执行器动力，再33.7正常停止；退出相机后等待至少5秒。预期轮速为零、传感器状态连续、地图逐步出现、RGB真实更新；未满足前提不得使能行驶。

```bash
cd /home/jetson/luhao/my_nav_carcar
conda deactivate 2>/dev/null || true
source /opt/ros/humble/setup.bash
source install/setup.bash
export ROS_DOMAIN_ID=31 ROS_LOCALHOST_ONLY=1 RMW_IMPLEMENTATION=rmw_fastrtps_cpp
mapping_run_dir="log/mapping_console/$(date +%Y%m%d_%H%M%S_%N)"
mkdir -p "$mapping_run_dir"
nohup "$PWD/install/carcar_mapping_console/lib/carcar_mapping_console/mapping_prepare" \
  --hardware --mode new > "$mapping_run_dir/session.log" 2>&1 < /dev/null &
echo "$!" > log/mapping_console/current.pid
cp log/mapping_console/current.pid "$mapping_run_dir/launch.pid"
printf '%s\n' "$mapping_run_dir" > log/mapping_console/current.dir
tail -n 40 "$mapping_run_dir/session.log"
```

下组仅订阅与检查已有话题、进程和日志，用于核对专用速度出口与传感器输入，不发布速度，不改变硬件或配置。额外订阅会增加少量负载；`timeout`返回124表示到时结束。异常Ctrl+C停止观察并保存日志，再按33.7停链路。

```bash
cd /home/jetson/luhao/my_nav_carcar
source /opt/ros/humble/setup.bash
source install/setup.bash
export ROS_DOMAIN_ID=31 ROS_LOCALHOST_ONLY=1 RMW_IMPLEMENTATION=rmw_fastrtps_cpp
ros2 topic info /mapping/cmd_vel -v
ros2 topic info /mapping/slam_scan -v
timeout 3 ros2 topic echo /mapping/control/state
timeout 3 ros2 topic echo /mapping/session/state
curl --max-time 2 http://127.0.0.1:8080/api/state
mapping_run_dir=$(cat log/mapping_console/current.dir)
tail -n 40 "$mapping_run_dir/session.log"
```

### 33.5 平板操作、保存与场地验收

平板保持连接“小泽”，打开`http://192.168.5.11:8080`（以33.3实际读回地址为准），建图限定在原WiFi有效覆盖内。静止数据有效后，在确认安全的空地接通轮动力，先慢档使能，短暂按住一个方向、松手并确认实物停止；每次松手后重新使能。之后分别验收前进、后退、原地转向，再验常档。网页上的速度为命令值，不当实际速度。分别记录松手、关页面、锁屏、断WiFi、视频断流、网关退出后的最终零速时刻、编码器停稳与尺量停车距离。必须先完成架空/静止阶段，再由现场看护进行地面故障试验；异常直接断12 V轮动力，不用人作障碍。

确认两档停车与显示可靠后，再逐段走走廊—房间—大厅边缘并回到已建区域，观察红点贴墙、墙体无明显重影和回环一致性。5分钟提醒不会突然停车；选择安全位置点击“停车并保存地图与工程”。保存期间禁行，结果明确指出成功目录或失败；完成后保持停车，重新使能才能继续。每次建立新的时间戳目录，不覆盖旧地图。两类文件和运行参数读回全部成功才写完整清单；部分失败目录不允许续建。

### 33.6 任意位置续建

先按33.7停止旧会话。把小车放在旧图已建、可辨认、能看到固定结构的区域，先隔离轮动力。下组读取已保存工程，检查四文件SHA256及版本，启动硬件与软件，仍会发送S1=94；SLAM扫描门初始关闭，网页显示历史参考图而非实时定位。必须把`BUNDLE_ID`替换为33.5实际成功返回的目录名，只有PGM/YAML的老地图不能使用。校验失败停止检查，不修改原工程；退出及恢复按33.7。

```bash
cd /home/jetson/luhao/my_nav_carcar
source /opt/ros/humble/setup.bash
source install/setup.bash
export ROS_DOMAIN_ID=31 ROS_LOCALHOST_ONLY=1 RMW_IMPLEMENTATION=rmw_fastrtps_cpp
BUNDLE_ID=替换为实际完整工程目录名
mapping_run_dir="log/mapping_console/$(date +%Y%m%d_%H%M%S_%N)"
mkdir -p "$mapping_run_dir"
nohup "$PWD/install/carcar_mapping_console/lib/carcar_mapping_console/mapping_prepare" \
  --hardware --mode resume --bundle "$BUNDLE_ID" \
  > "$mapping_run_dir/session.log" 2>&1 < /dev/null &
echo "$!" > log/mapping_console/current.pid
cp log/mapping_console/current.pid "$mapping_run_dir/launch.pid"
printf '%s\n' "$mapping_run_dir" > log/mapping_console/current.dir
tail -n 40 "$mapping_run_dir/session.log"
```

平板点击“选择续建位置与朝向”，在历史图上按车体中心位置，拖出车头方向；黄色箭头是人工初值，不是实际反馈。点击试匹配后仅放行一次新扫描，核对候选车位、实际朝向和多个方向的墙/门框。正确才点“墙体与朝向已对齐”，随后进入实时建图；仍须重新使能才能移动。候选错误可重新给初值、从原工程重载再试；服务超时、SLAM错误或首帧超时则锁停，按33.7终端重启后再试。接口回包、地图有消息、TF存在都不能独立证明对齐正确。续建后仍保存新目录，原工程不改。

### 33.7 正常停止

先在网页停车，现场确认车轮停止并隔离轮动力；紧急情况直接断轮动力。下组只向记录中的本次ROS Launch发SIGINT，使其正常退出节点，检查PID命令行以免误停其他进程；不删除工程或日志，不改变网络。相机等待至少5秒再重启。失败保留日志，核对本次残留节点和串口占用，不盲目反复启动。

```bash
cd /home/jetson/luhao/my_nav_carcar
mapping_pid=$(cat log/mapping_console/current.pid)
ps -p "$mapping_pid" -o pid=,args=
if ps -p "$mapping_pid" -o args= | rg -q 'ros2 launch carcar_mapping_console mapping.launch.xml'; then
  kill -INT "$mapping_pid"
else
  echo 'PID不是本次建图Launch，停止操作并核对日志'
fi
sleep 5
mapping_run_dir=$(cat log/mapping_console/current.dir)
tail -n 40 "$mapping_run_dir/session.log"
fuser -v /dev/myserial /dev/serial/by-id/usb-Silicon_Labs_CP2102_USB_to_UART_Bridge_Controller_0001-if00-port0
```

### 33.8 原WiFi恢复与应急回滚（备用，当前不执行）

当前始终使用“小泽”，正常停止只执行33.7，不需要网络恢复。本节只供未来明确启用33.9热点后的恢复/撤销使用，不能作为当前建图前置步骤。

回到原WiFi覆盖区，先按33.7关闭底盘。预备电脑连车载热点并SSH车端，或使用先前验证的本地/有线终端。下组需sudo，会让NetworkManager激活预先保存的原连接UUID，热点SSH预计中断；不会删除原WiFi、修改Polkit或驱动。预期原网络重新出现，DHCP地址须重新核对。若失败，从本地/有线查看维护状态和日志，不重置整套网络。

```bash
cd /home/jetson/luhao/my_nav_carcar
sudo ./install/carcar_mapping_console/lib/carcar_mapping_console/mapping_hotspot restore
./install/carcar_mapping_console/lib/carcar_mapping_console/mapping_hotspot status
```

只在失败或中止的180秒试点恢复原WiFi后，用下组结束本工具的计时点。它需要sudo、检查原连接UUID与设备已连接状态100，只取消自己的checkpoint，追加维护记录；不会假报平板成功，也不会设置日常启用许可。异常停止检查，不使用`--tablet-tested`绕过失败。日常模式恢复不需要此命令。

```bash
cd /home/jetson/luhao/my_nav_carcar
sudo ./install/carcar_mapping_console/lib/carcar_mapping_console/mapping_hotspot cancel-trial
```

若创建热点后需要撤销本次新增配置，下面工具只删除维护状态中登记的热点UUID；必须先恢复原WiFi并清理本次checkpoint，不触碰其他配置。需要sudo，会修改系统连接列表。删除前读取实际热点文件，在同目录生成唯一名称的完整`.backup`，权限0600，包含密码但不在屏幕或维护记录显示密码；原创建前备份也保留。备份、状态保存或维护记录失败均拒绝删除；成功时输出恢复命令，自动追加桌面维护记录，并把维护状态改名保留以便追溯。若创建阶段未完成，会核对该UUID确实不存在后只归档维护状态。异常停止检查，不删除其他连接。

```bash
cd /home/jetson/luhao/my_nav_carcar
sudo ./install/carcar_mapping_console/lib/carcar_mapping_console/mapping_hotspot remove
./install/carcar_mapping_console/lib/carcar_mapping_console/mapping_hotspot status
```

误删后只需恢复热点配置时，下组读取工具输出的删除前备份，恢复其对应原文件并让NetworkManager重新加载；需要sudo，会写回该热点配置但不激活热点，当前原WiFi保持。备份路径可从上述输出或桌面维护记录查到，不要输入创建前的目录归档。命令先拒绝覆盖已存在文件，并追加本次恢复记录；预期连接列表重新出现`carcar-mapping`且不自动连接。失败停止检查，不再次切换网络；恢复后不要直接继续旧维护流程，先核对已归档状态。此过程不会在屏幕显示密码，也不要把备份内容发到聊天。

```bash
(
set -e
cd /home/jetson/luhao/my_nav_carcar
read -r -p '输入删除前热点备份的完整路径：' mapping_profile_backup
case "$mapping_profile_backup" in
  /etc/NetworkManager/system-connections/*.backup) ;;
  *) echo '路径不是同目录热点文件备份，停止'; exit 1 ;;
esac
mapping_profile_file=${mapping_profile_backup%.backup}
mapping_profile_file=${mapping_profile_file%.*}
sudo test -f "$mapping_profile_backup"
sudo test ! -e "$mapping_profile_file"
sudo tee -a /home/jetson/Desktop/系统配置维护记录.md > /dev/null <<EOF

## MAPPING-RESTORE-$(date +%Y%m%d_%H%M%S_%N)：恢复误删的热点配置

涉及文件：$mapping_profile_file
目的与机理：从同目录完整备份恢复文件并交由NetworkManager重新加载，不激活网络。
修改前：该热点文件不存在；修改后：与 $mapping_profile_backup 完整内容一致，权限0600，密码不展开。
验证状态：待核对；当前连接状态由下方只读命令检查。
恢复撤销：保持原WiFi，重新执行本节删除前备份流程后再撤销，不直接删除其他配置。
EOF
sudo cp -p -- "$mapping_profile_backup" "$mapping_profile_file"
sudo chmod 600 -- "$mapping_profile_file"
sudo nmcli connection load "$mapping_profile_file"
nmcli -f NAME,UUID,AUTOCONNECT connection show
./install/carcar_mapping_console/lib/carcar_mapping_console/mapping_hotspot status
)
```

上述撤销和33.8的`restore`为可直接执行的应急恢复入口；本工具保留原连接，正常恢复不需要提取备份，禁止删除所有连接或覆盖整个`/etc`。

### 33.9 热点创建、试点与日常启用（备用，当前不执行）

必须先验证Jetson本地显示器/键鼠或有线SSH恢复通道，并在原WiFi覆盖区操作。本阶段只运行33.2软件页面，**底盘串口不得被打开**。同一网卡切热点会断开当前SSH，属于预期行为。

2026-10-14只读核对：当前驱动列出`managed`与`AP`单独模式，但`iw list`返回`interface combinations are not supported`，没有声明AP+STA并发。本工具仍在同一个`wlP1p1s0`切模式，不会维持原WiFi；不能靠再建一个NetworkManager连接实现并发。原始证据及边界见硬件台账。Linux对单独模式与并发组合分别描述，依据[内核5.15 cfg80211文档](https://www.kernel.org/doc/html/v5.15/driver-api/80211/cfg80211.html)。

先运行只读状态查询：它读取NetworkManager的设备、连接名和IPv4地址，不读取密码，也不更改系统，用于确认操作的是车上网卡；Ctrl+C可停止，无需恢复。

```bash
cd /home/jetson/luhao/my_nav_carcar
./install/carcar_mapping_console/lib/carcar_mapping_console/mapping_hotspot status
```

下组需要sudo：创建独立WPA2热点配置、同目录隐藏`.backup`完整归档、维护状态，并追加桌面系统维护记录。原WiFi配置保持；`prepare`不启用热点。密码只能在本地交互输入且不回显，不写聊天、命令行或维护日志。候选地址10.42.0.1/24，2.4 GHz自动信道，关闭热点自动连接；网段冲突、已有同名连接或维护状态会拒绝覆盖。异常先停止；若密码输入被中断后终端不回显，执行`stty echo`恢复显示，再按33.8检查，不删除原WiFi。

```bash
cd /home/jetson/luhao/my_nav_carcar
sudo ./install/carcar_mapping_console/lib/carcar_mapping_console/mapping_hotspot prepare
```

确认恢复通道后执行下组。它通过本机NetworkManager 1.36.6的D-Bus建立180秒checkpoint再切热点，不使用本机不支持的`nmcli checkpoint`。风险是SSH及代理网络中断，工具会预先记下原连接UUID和回滚点。平板连接`carcar-mapping`，在“无互联网”提示后保留该连接，打开本地页面。等待180秒应恢复原WiFi；失败从已验证的本地/有线通道执行33.8恢复。没有恢复通道时不要执行。

```bash
cd /home/jetson/luhao/my_nav_carcar
sudo ./install/carcar_mapping_console/lib/carcar_mapping_console/mapping_hotspot trial --recovery-ready
```

回滚后重新SSH进入车上Jetson。仅在现场已确认平板页面可达、无互联网仍保留连接、原WiFi自动恢复后，登记反馈并清理本工具checkpoint。该命令会写维护状态和桌面记录，工具并不能替人观察；异常停止并保留失败，不登记通过。

```bash
cd /home/jetson/luhao/my_nav_carcar
sudo ./install/carcar_mapping_console/lib/carcar_mapping_console/mapping_hotspot verify-trial --tablet-tested
./install/carcar_mapping_console/lib/carcar_mapping_console/mapping_hotspot status
```

未来明确恢复热点方案后，先按33.7停止软件预览。仅在本节试点通过、原WiFi覆盖区且本地/有线恢复通道仍可用时执行以下日常激活；底盘串口须空闲。此操作切换网络并断SSH，没有180秒定时回滚，异常从已验证的恢复通道按33.8恢复。

```bash
cd /home/jetson/luhao/my_nav_carcar
sudo ./install/carcar_mapping_console/lib/carcar_mapping_console/mapping_hotspot activate --recovery-ready
```

随后电脑连接车载热点，本组只建立SSH、不启动硬件或改系统；预期进入Jetson，Ctrl+D退出。热点网页为`http://10.42.0.1:8080`，此地址仅用于热点模式。确认后复用33.4中Jetson端硬件启动与观察步骤；不要执行该节原WiFi地址的SSH命令。网络退出和恢复见33.8。

```bash
cd "$HOME"
ssh jetson@10.42.0.1
```
