tfsvh69-blip/Nav2_car/docs/archive/2026-10-20-自动代理首轮诊断与兼容修正.md

# 自动代理首轮诊断与兼容修正原文

下列为NET-002首轮的历史命令与结果上下文，后续C++服务入口以操作手册37.1为准。

## 37 Jetson自动代理核对与局域网兼容修正（NET-002）

2026-10-20：当前入口为用户服务`jetson-auto-proxy.service`、本机HTTP代理`127.0.0.1:17892`。现有Python脚本保留，不新增或改写其逻辑；无需构建。候选按优先级为默认网关6880、192.168.5.17:23292、192.168.5.17:7892、192.168.5.36:7892。地址为当日读数，DHCP换址后先重新读取。

下面在Jetson终端检查接口、默认路由、服务及候选。只读，不切网、不打开串口或启动硬件；预期本地监听且至少一个候选OK。OK仅表示对Google的CONNECT响应200，不代表TLS/目标服务通过。Ctrl+C停止检查，不影响代理服务；不要在当前唯一远程链路上关WiFi或故意断代理。

```bash
cd /home/jetson/luhao/my_nav_carcar
ip -4 addr show scope global
ip -4 route
systemctl --user is-active jetson-auto-proxy.service
systemctl --user is-enabled jetson-auto-proxy.service
loginctl show-user jetson -p Linger
python3 /home/jetson/.local/bin/jetson-auto-proxy.py --status
```

下面读取新登录shell的代理环境，访问本地网页和无密钥API；不发送模型调用或运动命令。本地测试故意指定未监听的代理端口9，若HTTP200则证明当前IP被no_proxy直接绕过；若连接端口9失败，说明绕过无效。API预期CONNECT200、HTTP401、TLS_verify=0；不加-k，不关闭证书验证。HTTP403不能记作登录成功。网络请求最多10秒，可Ctrl+C结束，无需恢复硬件。

```bash
cd /home/jetson/luhao/my_nav_carcar
bash -n /home/jetson/.bashrc
bash -lc 'curl -x http://127.0.0.1:9 --connect-timeout 2 --max-time 3 -sS -o /dev/null -w "LAN HTTP=%{http_code}\n" http://192.168.180.181:8080/'
bash -lc 'curl --connect-timeout 4 --max-time 10 -sS -o /dev/null -w "API CONNECT=%{http_connect} HTTP=%{http_code} TLS_verify=%{ssl_verify_result}\n" https://api.openai.com/v1/models'
codex --version
codex login status
```

本机curl7.81不支持no_proxy的CIDR网段格式；保留网段兼容其他客户端，补充当日明确IP与主机名。其他热点客户端IP和后续DHCP变化仍需补充，不能声称整网段跨客户端兼容。新shell生效，已有进程不会自动更新。用户systemd管理器已同步本次no_proxy/NO_PROXY，仅影响后续新启动的用户服务，不等于所有系统服务已配置代理。

如修正引起异常，下面覆盖恢复本轮前的.bashrc，并将用户管理器的两个变量恢复到本轮前读数；不会重启网络/代理/硬件。先关闭尚未开始工作的受影响程序再开新终端；正在工作的Codex不为刷新变量强制结束。完整备份同目录保留，回滚不会删文档或历史证据。

```bash
cd /home/jetson/luhao/my_nav_carcar
cp -a /home/jetson/.bashrc.20261020-1630.backup /home/jetson/.bashrc
systemctl --user set-environment 'no_proxy=localhost,127.0.0.1,::1,192.168.5.0/24,192.168.5.11,192.168.5.17,192.168.5.36' 'NO_PROXY=localhost,127.0.0.1,::1,192.168.5.0/24,192.168.5.11,192.168.5.17,192.168.5.36'
bash -n /home/jetson/.bashrc
```
