tfsvh69-blip/Nav2_car/docs/archive/协作约定原文_20261014.md

# 导航巡检小车项目协作约定

本文件是当前仓库的长期开发约束。后续参与本项目的开发者和智能编码代理都必须遵守。

## 一、语言与文档

1. 项目文档必须使用中文编写。
2. 代码标识符、ROS 包名、节点名、话题名和参数名继续使用规范英文。
3. 新增功能时必须同步更新对应中文文档，不能只提交代码。
4. 命令必须提供可直接复制执行的完整版本，至少包含工作目录、环境加载、构建、启动、观察和停止步骤。

## 一点五、文档收敛规则

1. `docs/` 根目录只保留当前入口：文档索引、项目路线、硬件台账、操作手册、测试记录，以及面向长期产品目标的《工业级优化建议与学习路线》。优化建议只维护优先级、架构取舍和学习验收，不重复维护当前实机结论与操作命令。旧专题、旧命令和早期调研移入 `docs/历史/`，不作为当前启动入口。
2. 只记录可执行的决策、已确认的事实、参数、测试结果、风险与下一步；不重复记录推测、中间现象、已过期命令或一事多写。
3. 同一操作的完整命令只能在 `docs/操作手册.md` 维护；其他当前文档只链接到该手册。
4. 测试记录仍必须保留历史失败和原始结果，但详细区域默认使用 Markdown `details` 折叠，顶部只保留一张当前结论表。

## 一点六、代码、Launch 与 RViz 约定

1. 后续新增的脚本、ROS 节点及其他可执行逻辑统一使用 C++ 实现；不再新增 Python 可执行脚本或 Python 节点。确需使用其他语言时，必须先取得用户明确同意，并在对应中文文档中记录原因和适用范围。
2. 已有 Python 底层测试资产仍按“底层测试资产只增不删”规则保留，不得仅为统一语言而删除或覆盖；需要替代时，应新增 C++ 入口，并将旧入口标记为“已停用”及记录替代关系。
3. 后续新增和修改的 ROS 2 Launch 文件统一使用 XML 格式，文件扩展名为 `.launch.xml`，不使用 Python Launch 文件。
4. 需要图形化调试时，应协助用户启动 RViz，并提供可直接使用的 RViz 配置文件；不得只给出让用户自行逐项配置的说明。
5. 应把显示组件、话题和 QoS 设置保存到项目内的 RViz 配置，并在交付时向用户列出相关配置。实车联调默认不在 Jetson 上启动 `rviz2`：实验定位 Launch 的 `use_rviz` 默认为 `false`。日常在同一局域网的 Ubuntu 22.04 主机上用 `navigation_lite.rviz` 打开；禁止把完整 `navigation.rviz` 或 VNC 三维窗口当作日常操作。确需在板上临时打开时，必须显式传入 `use_rviz:=true`。
   用户指定后续提供或修改的 RViz 配置将 `Global Options → Frame Rate` 固定保存为100；它是渲染刷新上限，相机、点云预览和地图频率分别维护。显示负载异常时保留证据并说明，不擅自降低此值。历史测试配置及其原始失败参数保留。
6. Cursor / 智能代理的工作区在车上 Jetson（`jetson@xiaozhu`，`192.168.5.11`），不是用户眼前的 Ubuntu 主机。当前用户电脑是 `hao@bao`（2026-09-30 实测 `192.168.5.36`，DHCP 地址变动时先核对）；旧 `luhao@Hao` / `192.168.5.17` 是另一台电脑的历史记录。本机新开终端默认还在 `bao` 上，没有进 Jetson；车上节点必须先 SSH 登录 Jetson。RViz 在 `bao` 已登录的本地桌面运行。代理若要检查 `bao`，使用车上已授权密钥连接 `hao@192.168.5.36`。IP、域号、图形渲染与车模覆盖的完整命令只维护在 [操作手册第 19 节](../操作手册.md#19-ubuntu-主机-rviz-联调)。

## 二、自底向上的开发顺序

项目严格按以下层次逐步推进：

1. 控制板、串口、电机、编码器和 IMU 等底层硬件驱动。
2. 底盘运动学、里程计、坐标轴方向与安全保护。
3. URDF、TF 和状态估计。
4. 雷达、建图、定位和 Nav2。
5. 感知、规划等通用算法。
6. 巡检任务、状态机、告警和数据上传等应用逻辑。

在下层没有形成明确测试结论前，不把上层问题混入下层测试脚本。

## 三、底层测试资产只增不删

1. 已经使用过的底层测试节点、脚本、配置和命令不得因为新增高层功能而删除。
2. 新实现不能直接覆盖旧测试入口。确需替代时，保留旧文件并标记“已停用”，同时记录替代原因和新入口。
3. 正式节点和测试节点必须分开，测试节点不得被正式 bringup 隐式启动。
4. 串口同一时间只能由一个进程打开。涉及串口的测试文档必须明确提醒关闭其他驱动节点。
5. 每个执行器测试都必须提供启动零输出、命令超时停车、退出停车和紧急断电说明。

## 四、测试记录维护规则

所有测试统一登记在 `docs/测试记录.md`，每项测试分配稳定编号，例如：

- `DRV-001`：串口与驱动层。
- `MOTOR-001`：电机层。
- `IMU-001`：惯导层。
- `ODOM-001`：里程计层。
- `TF-001`：TF 层。
- `NAV-001`：导航层。
- `APP-001`：应用层。

每个测试记录至少包含：

1. 测试目的与适用范围。
2. 当前硬件前提和安全条件。
3. 完整构建命令。
4. 完整启动命令。
5. 话题发布、查看和诊断命令。
6. 停止与恢复命令。
7. 预期结果。
8. 实际结果、测试日期和结论。
9. 对应代码与配置文件路径。
10. 已知问题和下一步。

后续测试按时间顺序追加新章节，不删除旧命令，不把历史失败结果改写成成功。修正错误时保留原记录，并追加“修订说明”。

## 五、硬件台账维护规则

硬件信息统一维护在 `docs/硬件台账.md`。

1. 用户每次反馈实物、接线、端口、型号、方向、尺寸、固件或测试结果后，都要更新硬件台账。
2. 信息分为“已确认”“待确认”“已停用”，不得把推测写成已确认事实。
3. 电机端口、编码器通道、轮子位置和正方向必须逐项记录。
4. 硬件变更必须追加变更记录，包含日期、变更前、变更后、影响范围和验证状态。
5. 与硬件相关的默认参数只有在实机确认后才能写入正式配置；未确认值应显式标注为临时值。

## 六、提交与验证要求

1. 修改底层代码后，至少执行对应单元测试、Python 静态检查和目标 ROS 包构建。
2. 没有实物参与的验证必须写成“离线验证”，不能表述为“实机通过”。
3. 实机测试结果必须由现场操作反馈确认，智能编码代理不能自行假定电机方向或传感器轴向正确。
4. 每次交付应说明：改了什么、保留了什么、验证了什么、还有什么未确认。

## 七、优先复用成熟开源方案

1. 设计和实现功能时，应优先调研并参考活跃维护、文档完善、许可证兼容的主流开源框架、算法或项目，避免在已有成熟方案可用时重复造轮子。
2. 引入或借鉴开源实现时，必须记录项目来源、固定版本或提交、许可证及本项目所做的适配，不得无来源复制代码或资产。
3. 只有在现有方案不能满足硬件约束、实时性、安全性或维护要求时才自行实现，并在对应中文设计或测试文档中说明取舍依据。

## 七点五、面向主流工业应用的 AI 引导要求

1. AI 在讨论设计、排错、算法选择、行为树和应用层开发时，必须结合当前项目阶段，参考当前主流、维护活跃且有可靠工程依据的工业移动机器人、家用清扫机器人和送餐机器人方案进行引导。既要解决眼前问题，也要说明该选择如何帮助形成可靠、可维护的设备。
2. 提出重要建议时，必须用通俗中文解释：当前问题是什么、为什么现在要改、推荐方案的工作原理与收益、代价和适用边界、为什么优先于其他候选，以及如何用可观测指标验证。不得只给算法名称、参数或“工业上都这么做”的结论。
3. 涉及维护状态、版本支持或工业应用情况时，应查阅官方文档、维护者仓库或可信的一手工程资料，标明来源与适用版本；区分“官方支持”“公开工程案例”“本项目推断”和“待实机验证”。不得把开源可用、单次演示或离线测试通过等同于工业成熟或产品认证。
4. 学习路线只安排有明确工程价值的成熟方案对比。每次优先选 2～3 个解决同一问题的代表方案，使用相同场景、速度限制、地图和评价指标，让用户观察优势、代价与失败边界；不为凑算法数量安排缺乏维护、适配或应用价值的实现，也不把“没有选用”直接说成算法差。
5. 对底盘、定位、规划、控制、行为树和应用层按依赖关系排序；可靠停车、数据新鲜度、取消/抢占、可复现验收优先于叠加复杂算法。遵守纯轮式里程计与基础导航先稳定、再只融合 IMU 角速度 Z 的既有顺序。
6. 优先复用 ROS 2、Nav2、BehaviorTree.CPP 等成熟框架的稳定接口与插件；自研部分必须说明现有能力缺口及长期维护成本。不能以追求工业级为由一次性重写全部代码、照搬最新发行版配置，或把暂未通过的方案写入正式默认配置。
7. 引导时参考 [工业级优化建议与学习路线](../工业级优化建议与学习路线.md)，当前实机状态仍以项目路线、硬件台账和测试记录为准。用户改变产品目标或提供新证据时，应更新建议及其理由；不把长期路线当作跳过当前验收门槛的授权。

## 八、状态估计推进顺序

1. 四轮底盘首次形成里程计时，只使用编码器或控制板运动反馈，不立即引入 IMU 融合。
2. 必须先单独完成轮式里程计的前进、横移、旋转、静止漂移和 TF 验收，使问题来源可独立定位。
3. IMU 数据可以继续发布和观察，但在轮式里程计基线通过前，不接入 `robot_localization` 或其他状态估计器。
4. 轮式里程计和基础导航稳定后，状态估计的第一版只允许把经过零偏、单位、坐标轴和符号校正的 `angular_velocity.z` 与四轮里程计送入 `robot_localization`；IMU 姿态、线加速度和磁力计均保持关闭。
5. 只有上述链路实测稳定且存在明确需求时，才分别评估线加速度、Madgwick 姿态解算和磁力计；不得把它们一次性加入同一轮调试。
6. IMU 首次调试固定按以下顺序：水平静止数十秒统计角速度均值和标准差；人工逆时针旋转确认 `angular_velocity.z > 0`；最后检查水平静止时 `ax≈0`、`ay≈0`、`az≈+9.81 m/s²`。轴向或符号错误必须在驱动映射或安装 TF 中修正，不得用 EKF 参数掩盖。

## 九、系统级配置维护约定

1. 每次更改系统级文件时（包括但不限于 `/etc/` 下的系统配置文件、systemd 守护服务、Xorg/图形环境、网络/防火墙、udev 串口规则、驱动配置等），必须在桌面维护文档 [`/home/jetson/Desktop/系统配置维护记录.md`](file:///home/jetson/Desktop/系统配置维护记录.md) 中同步追加更新记录。
2. 记录必须包含变更序号、变更日期、涉及文件绝对路径、变更目的与机理、修改前内容、修改后内容以及实机验证状态。
3. 修改任何系统级配置前必须在同目录下创建 `.backup` 完整备份文件，并提供可执行的应急回滚命令。
