tfsvh69-blip/Nav2_car/docs/archive/操作专题原文_20261014.md

# 操作专题历史原文

2026-10-14按批准的维护报告从当前手册迁出；完整命令、风险、失败参数与经验保留，历史时态不改写成新验收。现行入口见[操作手册](../操作手册.md)。

## 整理前入口说明

# 操作手册

最后更新：2026-10-13

同一操作的完整命令只在本文维护。硬件事实见 [台账](../硬件台账.md)，结论见 [路线](../项目现状与路线.md) 与 [测试记录](../测试记录.md)。

**当前入口**：阶段结论和唯一下一步只见[项目路线](../项目现状与路线.md)。深度主线使用[第31节](../操作手册.md#31-stvl-深度导航主线nav-016)，当前静止证据对应[31.16](../操作手册.md#3116-94档近平视与100刷新率的静止stvl验收)；早期独立 B／原生 VoxelLayer 命令保留作历史对照。完整移动仍待验收。本轮巡检设计与目录归档的离线复核见[第32节](#32-巡检设计与停用草稿归档的离线复核)，没有新增巡检启动入口。

**历史相机粗校验入口**：固定平视姿态、不用标定板的静止粗校验见[第 27 节](#27-d435-不用标定板的静止-tf-粗校验tf-006)，早期 Hao 专用 RViz 见[第 19.10 节](../操作手册.md#1910-hao-查看-d435-静止-tf)。当前姿态与显示入口按项目路线核对，不直接沿用历史候选。

**当前专项复测**：09-26 数据误倒车与直角弯净空优先使用[第 26 节](#26-nav-012-r10-数据恢复与直角弯净空对照)，按 0.18 m/s 做对照与候选，不把候选当作已实车通过。

**日常导航参考**：代码更新、车上多终端、主机 RViz 和停止顺序见[第 19.8 节](../操作手册.md#198-日常六终端开发与导航复测2026-09-20-实测入口)，主机地址先按19.0核对；NAV-012 恢复细节见[第 18 节](#18-nav-012-回调恢复监督与速度联锁修复)。该节保留当时分工与实验参数，优化后的突发障碍绕行仍待复测，当前阶段以项目路线为准。历史命令见 `历史/`。

## 1. 四路编码器 A/B 对调后的连续键盘控制（MOTOR-015）

轮位与 A/B 对调见台账。`chassis_direct_keyboard`：按一次方向键持续运行，空格/`k` 停车，`q` 停车退出。不写 PID/Flash。改线前曾持续升速，首次必须架空确认能停后再落地。横移键仍在键盘上，但底盘已锁定差速，`j`/`l` 不应作为正式验收。

### 1.1 构建

用途：只构建底盘厂商库和 `carcar_base`，确认当前测试入口可运行。它只读取源码并更新工作
区的 `build/`、`install/`、`log/` 构建产物，不访问串口、不驱动电机、不修改控制板。预期
两个包构建成功；若失败，停止在此处，不进行硬件动作。

```bash
cd /home/jetson/luhao/my_nav_carcar
conda deactivate 2>/dev/null || true
source /opt/ros/humble/setup.bash
/usr/bin/colcon build --symlink-install \
  --packages-select rosmaster_vendor carcar_base
source install/setup.bash
```

### 1.2 启动板载 PID 驱动

风险与恢复：四轮先可靠架空，轮胎附近不得有人、线缆或松动物体，不得带电插拔 A/B 线。
12 V 电机开关必须始终可立即触及。突然升速、持续加速、抖动、尖叫、反向或软件停车无效
时，立即关闭 12 V 电机主电源；关闭电源可中止硬件运动，之后保持断电并退出两个节点。

终端 1 独占串口并启动板载 PID 驱动。启动会重复发送零速度；命令超过 `0.3 s` 未刷新也会
停车。命令会先检查设备存在和串口未被其他进程占用，异常时不会启动。

```bash
cd /home/jetson/luhao/my_nav_carcar
conda deactivate 2>/dev/null || true
source /opt/ros/humble/setup.bash
source install/setup.bash
test -e /dev/myserial || { echo "控制板未连接，停止启动"; exit 1; }
if fuser /dev/myserial >/dev/null 2>&1; then
  echo "串口已占用，请正常关闭其他驱动后重试"
  exit 1
fi
ros2 launch carcar_base board_closed_loop_test.launch.py
```

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
