tfsvh69-blip/Nav2_car/实车照片以及相关的模型文件/IMG_8561.jpg

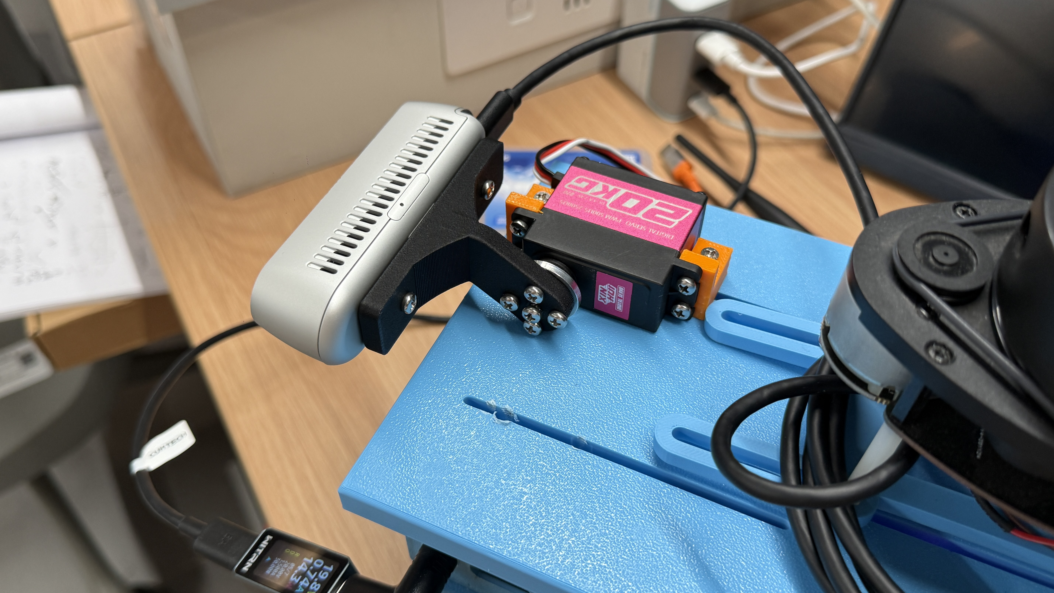
实车照片以及相关的模型文件/IMG_8561.jpg
