tfsvh69-blip/Nav2_car/实车照片以及相关的模型文件/微信图片_20260907091748_69_2.jpg

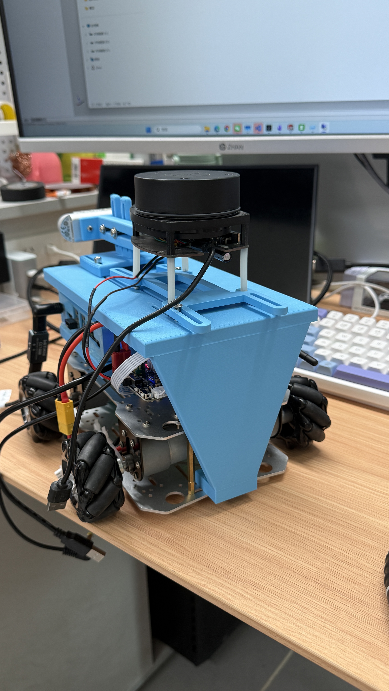
实车照片以及相关的模型文件/微信图片_20260907091748_69_2.jpg
