tfsvh69-blip/Nav2_car/src/carcar_description/meshes/mecanum/mecanum_wheel_right.stl

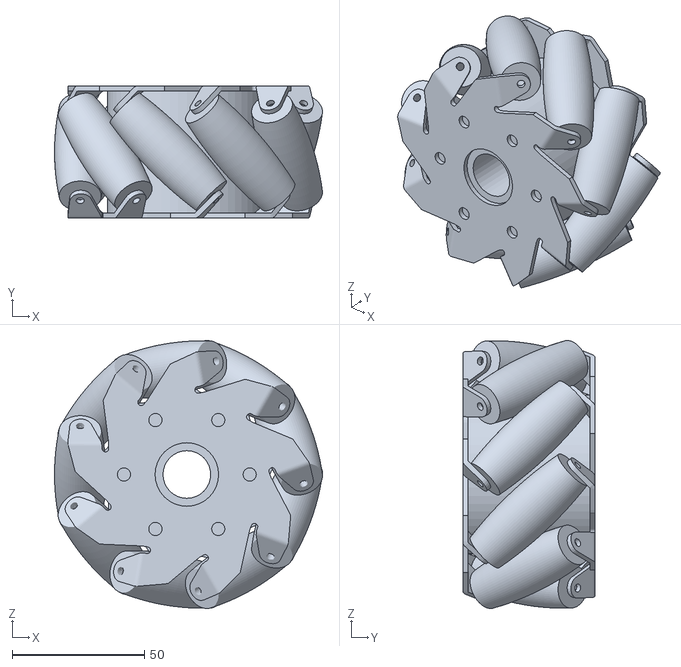
[picture p11: CAD file, 2026-09-06]
src/carcar_description/meshes/mecanum/mecanum_wheel_right.stl
101.2 x 50.0 x 101.3
