tfsvh69-blip/Nav2_car/src/carcar_description/meshes/vehicle/camera_servo_left_foot.stl

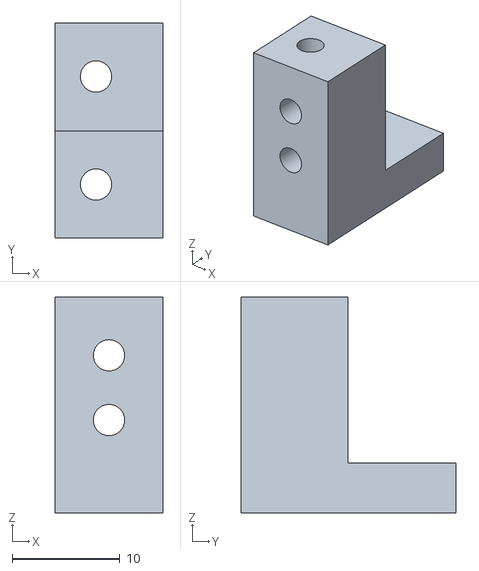
[picture p12: CAD file, 2026-10-01]
src/carcar_description/meshes/vehicle/camera_servo_left_foot.stl
10.00 x 19.9 x 20.0
