tfsvh69-blip/Nav2_car/实车照片以及相关的模型文件/舵机相机支架.STL

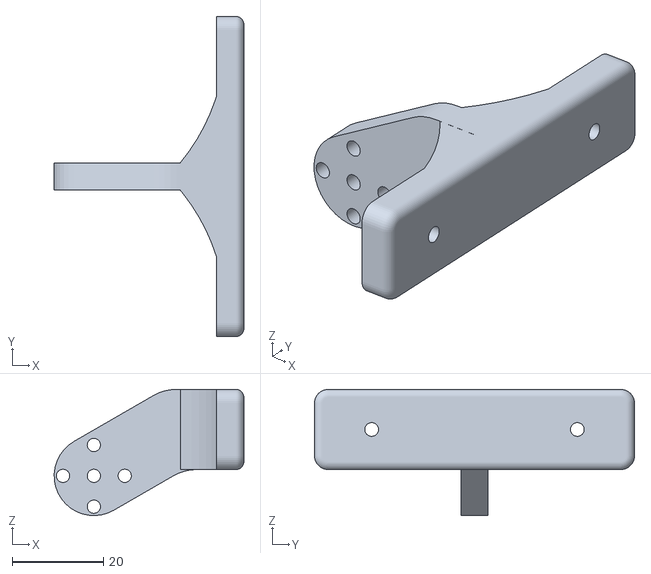
[picture p13: CAD file, 2026-10-01]
实车照片以及相关的模型文件/舵机相机支架.STL
41.5 x 70.0 x 27.6
