tfsvh69-blip/Nav2_car/src/carcar_description/meshes/vehicle/camera_direct_mount.stl

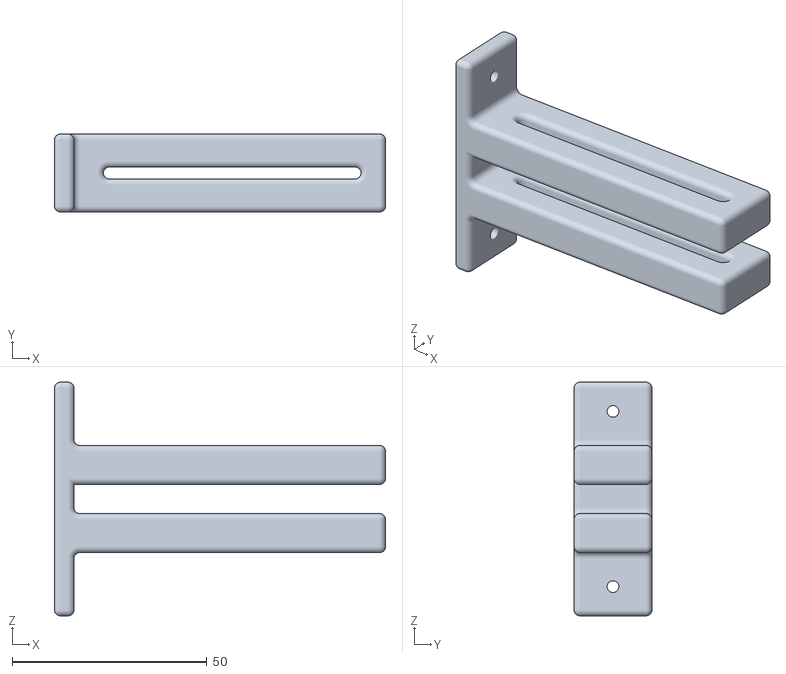
[picture p14: CAD file, 2026-09-08]
src/carcar_description/meshes/vehicle/camera_direct_mount.stl
85.0 x 20.0 x 60.0
