tfsvh69-blip/Nav2_car/实车照片以及相关的模型文件/激光雷达底板.STL

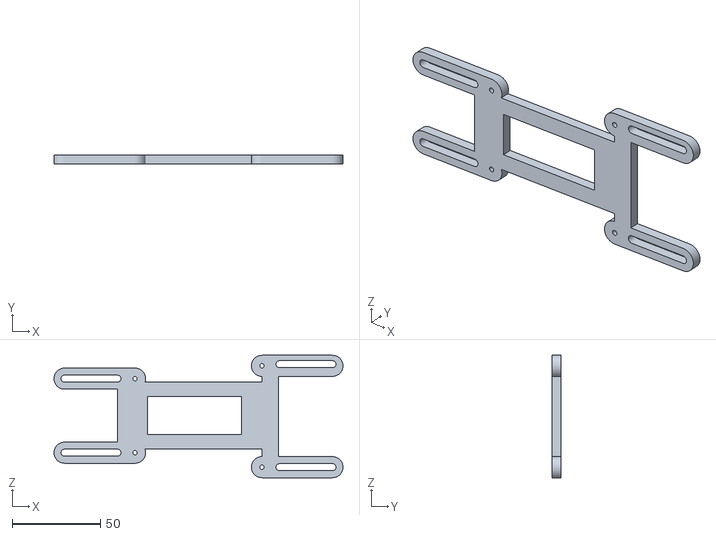
[picture p15: CAD file, 2026-09-08]
实车照片以及相关的模型文件/激光雷达底板.STL
164.0 x 5.00 x 69.5
