tfsvh69-blip/Nav2_car/src/carcar_description/meshes/vehicle/carcar_upper_structure.stl

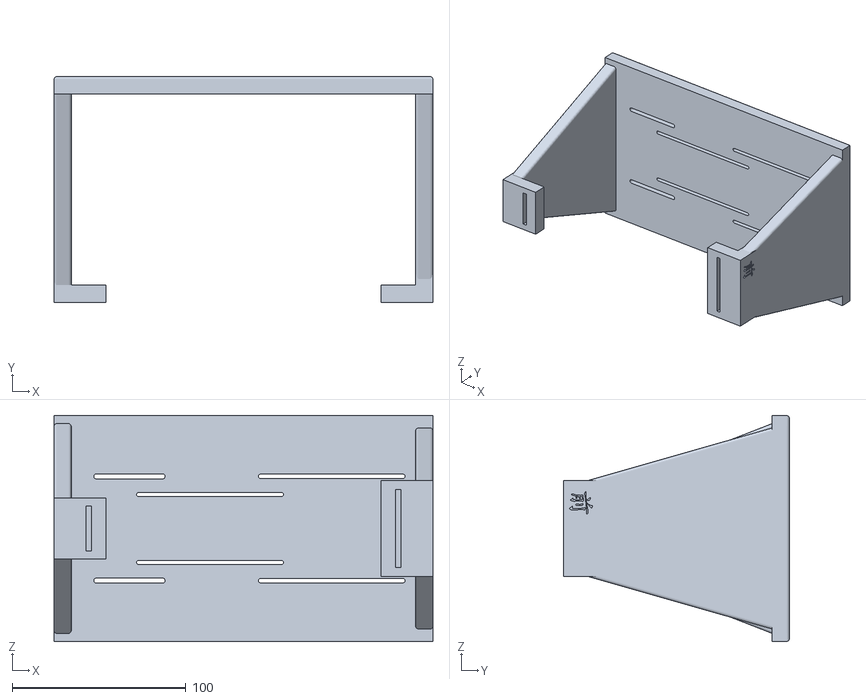
[picture p16: CAD file, 2026-09-08]
src/carcar_description/meshes/vehicle/carcar_upper_structure.stl
218.0 x 130.0 x 130.0
