tfsvh69-blip/Nav2_car/src/carcar_description/meshes/vehicle/camera_lower_mount.stl

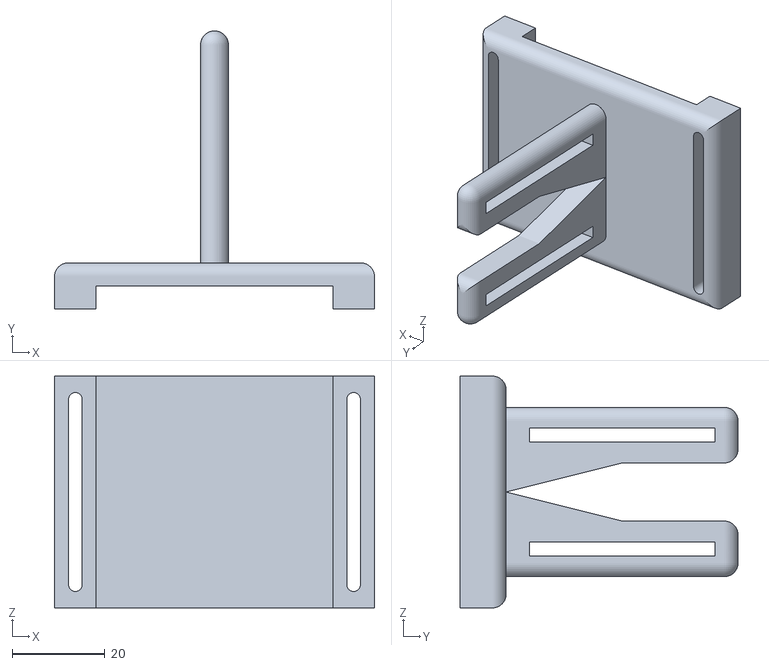
[picture p17: CAD file, 2026-09-08]
src/carcar_description/meshes/vehicle/camera_lower_mount.stl
69.0 x 60.0 x 50.0
