tfsvh69-blip/Nav2_car/实车照片以及相关的模型文件/英伟达的下置底板.STL

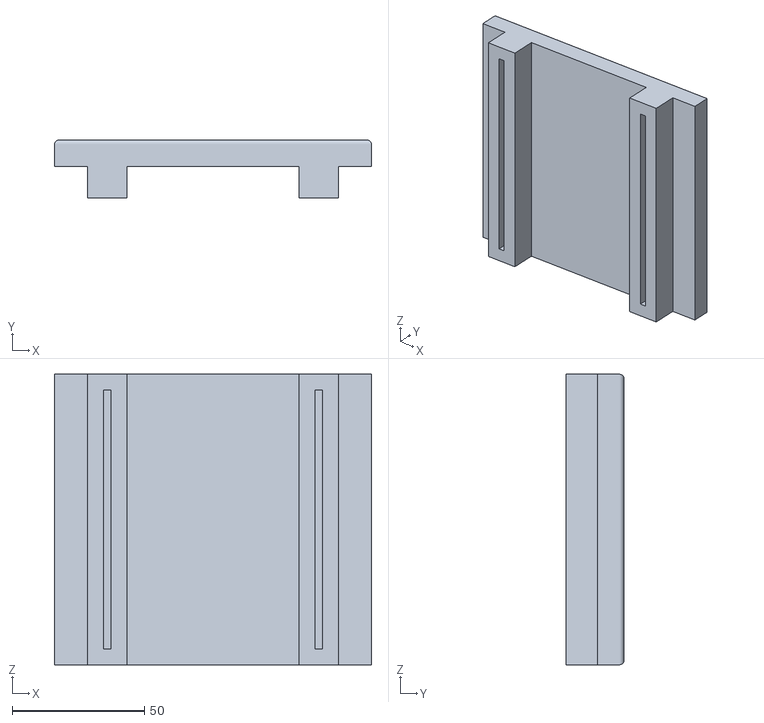
[picture p18: CAD file, 2026-09-08]
实车照片以及相关的模型文件/英伟达的下置底板.STL
120.0 x 22.0 x 110.0
