tfsvh69-blip/Nav2_car/(list of files, cad)

Other CAD files:
src/carcar_description/meshes/mecanum/mecanum_wheel_left.stl
src/carcar_description/meshes/vehicle/camera_servo_right_foot.stl
实车照片以及相关的模型文件/舵机右侧锁底板零件.STL
