tfsvh69-blip/Nav2_car/docs/archive/2026-10-14-平板建图R5日志查询修订前原文.md

# 平板建图R5日志查询修订前原文

保留R5修改前原文。本轮按用户服务名查询未取到网关事件，按实际网关PID查询取得；后续当前手册补充PID查询，原命令不作为本轮成功证据。

### 33.3 常驻网页、网络与开机配置

日常只打开网页。Jetson当前WiFi历史读回地址为`192.168.5.11`，访问`http://192.168.5.11:8080`；DHCP变化时读回新地址，不把历史地址当固定分配。平板不参加ROS发现，所有ROS留在localhost。网页不需要互联网，也不需要安装Android应用。一次只保留一个操控页，其他浏览器不能抢占控制。

下组只读取车端WiFi地址、用户服务和网页状态，不改网络、不打开硬件。预期待命状态`STANDBY`、无运行中的底盘/SLAM任务；查询失败Ctrl+C，检查服务日志。平板打不开而本地HTTP正常时，核对同一局域网及无线客户端隔离，不直接关闭防火墙或切热点。

```bash
cd /home/jetson/luhao/my_nav_carcar
nmcli -t -f NAME,DEVICE connection show --active
ip -4 -brief address show wlP1p1s0
systemctl --user status mapping-tablet.service --no-pager
curl --max-time 3 -sS http://127.0.0.1:8080/api/state
journalctl --user -u mapping-tablet.service -n 50 --no-pager
```

当前采用用户服务，利用已存在的GDM自动登录启动；不修改GDM、不要求sudo、不启用linger。自动登录失败或退出用户会话时网页可能不可用，下次真实重启后的自动入口需要另行确认；不得把当前手动启动验证写成重启验收。

首次安装或更新常驻服务时，先结束旧软件预览及本次硬件任务，不能同时占用8080。以下会修改`/home/jetson/.config/systemd/user/mapping-tablet.service`及用户启用链接；先在同目录备份旧文件或记录原文件不存在，再安装模板。启动的是网页待命，不启动硬件。它会追加桌面维护记录；异常用33.11禁用服务，旧文件按备份恢复。已有服务正常时不要重复安装。

```bash
cd /home/jetson/luhao/my_nav_carcar
mapping_unit=/home/jetson/.config/systemd/user/mapping-tablet.service
mapping_stamp=$(date +%Y%m%d_%H%M%S_%N)
mapping_original=absent
mkdir -p /home/jetson/.config/systemd/user
if test -f "$mapping_unit"; then
  mapping_original=present
  cp -a -- "$mapping_unit" "$mapping_unit.$mapping_stamp.backup"
else
  cp -a src/carcar_mapping_console/config/mapping-tablet.service "$mapping_unit.$mapping_stamp.backup"
fi
install -m 0644 src/carcar_mapping_console/config/mapping-tablet.service "$mapping_unit"
{
  printf '\n### 平板建图用户服务维护 %s\n路径：%s；原文件状态：%s；同目录完整备份：%s.%s.backup。原文件不存在时备份为新增定义副本，不能当作旧内容恢复。\n目的：自动登录后仅网页待命，硬件按平板请求启动。\n修改前：\n' "$mapping_stamp" "$mapping_unit" "$mapping_original" "$mapping_unit" "$mapping_stamp"
  if test "$mapping_original" = present; then cat "$mapping_unit.$mapping_stamp.backup"; else printf '%s\n' '原文件不存在'; fi
  printf '\n修改后：\n'
  cat "$mapping_unit"
  printf '\n验证：重启实机待验。回滚先systemctl --user disable --now mapping-tablet.service；原文件存在时恢复对应备份并daemon-reload，原文件不存在时将新增定义移为.rollback.backup并daemon-reload。\n'
} >> /home/jetson/Desktop/系统配置维护记录.md
systemctl --user daemon-reload
systemctl --user enable --now mapping-tablet.service
```

### 33.11 车端应急停止与回滚

下组会停止常驻网页及它管理的全部硬件子任务，影响正在进行的建图；先现场停车并尽可能保存，异常直接隔离轮动力。停止后的网页暂不可达；重新启动只回到网页待命，不恢复动作或未保存工程。诊断日志保留，失败不重复开旧入口。

```bash
cd /home/jetson/luhao/my_nav_carcar
systemctl --user stop mapping-tablet.service
systemctl --user status mapping-tablet.service --no-pager
journalctl --user -u mapping-tablet.service -n 80 --no-pager
systemctl --user start mapping-tablet.service
```

若需撤销开机自启，下组停止并禁用本服务，保留定义和备份，不影响原网络或旧工程。恢复时执行最后两行，仍仅网页待命；本次新增文件原本不存在时，如需完整恢复文件状态，先禁用，再将新增定义移为同目录`.rollback.backup`并daemon-reload。原本存在文件则从对应完整备份恢复。原文件不存在时，同目录备份是新增定义的完整副本，回滚应保持原文件不存在。

```bash
cd /home/jetson/luhao/my_nav_carcar
systemctl --user disable --now mapping-tablet.service
systemctl --user daemon-reload
systemctl --user enable mapping-tablet.service
systemctl --user start mapping-tablet.service
```

备用热点工具的串口检查已修正，仍未启用。它与硬件启动预检共用检查：只读查询解析后的绝对路径，仅退出码1且stdout/stderr完全为空才放行；串口占用、检查报错或工具缺失均拒绝继续。遇到拒绝时保留原因，不绕过检查或直接杀未知进程；正常关闭已知底盘入口后再检查。查询不发送停车命令，实物停稳仍须确认。其原流程完整保留在[旧流程33.8/33.9](archive/2026-10-14-平板建图旧流程原文.md)，本阶段不要执行热点创建、切换或sudo操作。

## 34. 项目瘦身检查点与恢复（MAINT-001）

2026-10-14第一阶段只生成[瘦身报告](archive/2026-10-14-项目瘦身报告.md)、建立仓库外完整快照并验证基线。批量删除、历史迁移、AGENTS精简与代码重构须先由用户确认报告。已有底层测试、地图/标定/模型/参数/rosbag及原始失败证据继续保留；此节不启动执行器、切网络或停止现有网页。

### 34.1 校验检查点

下组在Jetson读取完整tar并计算SHA256、查看初始Git状态，核对快照可读且未损坏。只读，不覆盖工作区或系统，不影响硬件；预期显示project.tar为OK，状态包含原有45项文件变更。中途Ctrl+C可停止校验，不需要回滚；校验失败不要用该包恢复。扫描证据和来源清单保存在evidence，目录不应公开上传。

```bash
cd /home/jetson/luhao/my_nav_carcar
cleanup_checkpoint="/home/jetson/luhao/my_nav_carcar_backups/cleanup_20261014_093557_211919094"
sha256sum --check "$cleanup_checkpoint/project.tar.sha256"
cat "$cleanup_checkpoint/evidence/head.txt"
cat "$cleanup_checkpoint/evidence/git-status-before.txt"
```

### 34.2 恢复到新目录，不覆盖当前工作区

下面只读取检查点、在仓库旁创建唯一恢复目录并解包，预计额外占用约1.9 GiB；保留当前未提交文件，不执行reset/clean或切换系统。完整快照包含.git、ignored与生成产物，但不会沿符号链接备份仓库外系统资源。预期新目录出现完整源码/资源，Git状态与初始记录对应。解包异常Ctrl+C停止，原项目不受影响，保留部分恢复目录排查，不自动删除。副本install中的绝对链接仍可能指向原工作区，恢复后需要按包重新构建；不得直接启动副本实车入口。

```bash
(
set -e
cd /home/jetson/luhao/my_nav_carcar
cleanup_checkpoint="/home/jetson/luhao/my_nav_carcar_backups/cleanup_20261014_093557_211919094"
sha256sum --check "$cleanup_checkpoint/project.tar.sha256"
cleanup_restore_dir="/home/jetson/luhao/my_nav_carcar_restore_$(date +%Y%m%d_%H%M%S_%N)"
mkdir -m 700 "$cleanup_restore_dir"
tar --acls --xattrs -xpf "$cleanup_checkpoint/project.tar" -C "$cleanup_restore_dir"
printf '恢复副本：%s\n' "$cleanup_restore_dir"
git -C "$cleanup_restore_dir" status --short
)
```

### 34.3 本轮基线复核

本轮未改源码，以下使用已有构建产物；后续若批准修改代码，必须先构建对应包，不能把旧二进制结果当新代码验证。测试仅在隔离域/localhost运行替身节点、协议/差速逻辑和不打开串口的插件测试；写build下的测试结果，不打开实车硬件、相机或雷达，不影响域31现有软件预览。预期32项建图、48项底盘、20项硬件逻辑/插件、2项图像及8项硬件lint通过，XML/JS/差异检查无错。失败Ctrl+C停止测试并保留日志，不能继续删除或重构。

```bash
cd /home/jetson/luhao/my_nav_carcar
source /opt/ros/humble/setup.bash
source install/setup.bash
export ROS_DOMAIN_ID=219 ROS_LOCALHOST_ONLY=1 RMW_IMPLEMENTATION=rmw_fastrtps_cpp
ctest --test-dir build/carcar_mapping_console --output-on-failure
PYTHONDONTWRITEBYTECODE=1 python3 -m pytest src/carcar_base/test -q -p no:cacheprovider
ctest --test-dir build/carcar_hardware --output-on-failure
ctest --test-dir build/carcar_camera -R '^test_image_reference$' --output-on-failure
node --check src/carcar_mapping_console/web/app.js
rg --files src/carcar_* src/inspection_bringup -g '*.xml' -0 | xargs -0 xmllint --noout
git diff --check
```

静态扫描使用本机Cppcheck2.7，整批和逐文件原始失败均保留在检查点；http_server.cpp的139退出是分析工具崩溃，不能登记为代码编译失败或由此删除实现。完整清单、重复片段、调用关系边界和下阶段验收前提只维护报告，当前不提供批量删除命令。

### 34.4 批准后的维护验证与执行前检查点

2026-10-14用户已批准文档归档和小缓存批次。第二份执行前完整快照位于`/home/jetson/luhao/my_nav_carcar_backups/cleanup_execute_20261014_095956_097155074`，包含第一阶段报告及当时全部未提交内容；34.1/34.2保留的第一份快照可恢复到整个维护任务开始前。两份快照都在仓库外，校验失败时不要恢复，统一解包到新目录。

本组只校验执行前快照、读取原Git状态，不改工作区/网络或硬件；预期SHA256为OK、状态保留执行前46项文件变更。Ctrl+C可停止读取，不需要回滚。

```bash
cd /home/jetson/luhao/my_nav_carcar
cleanup_execution_checkpoint="/home/jetson/luhao/my_nav_carcar_backups/cleanup_execute_20261014_095956_097155074"
sha256sum --check "$cleanup_execution_checkpoint/project.tar.sha256"
cat "$cleanup_execution_checkpoint/evidence/git-status-before.txt"
```

批准批次会更新归档链接、README与CMake归档说明注释，以下先构建对应包以更新安装资源，再复用34.3的功能测试；构建只写build/install/log，不启动节点、传感器或执行器。源码/参数保持不变，预期六包构建成功，已有PCL/CMake警告保留；失败Ctrl+C停止并保留日志，不删除构建目录。修改底层代码时还需对应源码静态检查，不能用这次资源构建结果代替。

```bash
cd /home/jetson/luhao/my_nav_carcar
source /opt/ros/humble/setup.bash
source install/setup.bash
export PYTHONDONTWRITEBYTECODE=1
CMAKE_BUILD_PARALLEL_LEVEL=2 colcon build --symlink-install --packages-select carcar_hardware carcar_description carcar_camera carcar_navigation carcar_inspection carcar_mapping_console --executor sequential
source install/setup.bash
```

复核项目清理技能时，下组只读取SKILL的格式/元数据并用既有验证器检查，不改项目、不安装依赖或启动硬件；预期Skill is valid，Ctrl+C取消即可。维护缓存时不要在项目内重新生成pyc；需要Python静态编译时，下组把缓存放仓库外检查点/evidence，保留失败日志。完成后再按34.3运行功能测试，pytest使用禁止写字节码/测试缓存的设置。

```bash
cd /home/jetson/luhao/my_nav_carcar
cleanup_execution_checkpoint="/home/jetson/luhao/my_nav_carcar_backups/cleanup_execute_20261014_095956_097155074"
PYTHONDONTWRITEBYTECODE=1 python3 /home/jetson/.codex/skills/.system/skill-creator/scripts/quick_validate.py .agents/skills/project-cleanup
PYTHONPYCACHEPREFIX="$cleanup_execution_checkpoint/evidence/pycache" python3 -m compileall -q src/carcar_base/carcar_base src/carcar_base/test
```

本轮额外flake8发现9条既有E501行长告警，执行前副本与执行后输出排序比对一致，未修改底层Python以消除此类历史格式问题。102项功能测试和8项hardware lint通过，不表述为全部静态分析通过。完整变更、调用核实与保全清单只见[执行结果](archive/2026-10-14-瘦身执行结果.md)。
