tfsvh69-blip/Nav2_car/src/carcar_navigation/src/recovery_runtime.cpp

#include "carcar_navigation/recovery_runtime.hpp"
#include <algorithm>
#include <cmath>
#include <iomanip>
#include <limits>
#include <sstream>
#include <unordered_set>
#include <utility>
#include <thread>
#include <tf2/utils.h>
#include <tf2_geometry_msgs/tf2_geometry_msgs.hpp>
#include <nav2_costmap_2d/costmap_2d.hpp>
#include <nav2_costmap_2d/footprint.hpp>
#include <nav2_costmap_2d/footprint_collision_checker.hpp>

namespace carcar_navigation {
namespace {
template<class UUID> std::string uuid_text(const UUID & uuid) {
  std::ostringstream s;
  for (auto b : uuid) {s << std::hex << std::setw(2) << std::setfill('0') << unsigned(b);}
  return s.str();
}
double parameter(rclcpp::Node::SharedPtr node, const std::string & key, double fallback) {
  if (node->has_parameter(key)) {
    const auto value=node->get_parameter(key);
    if (value.get_type()==rclcpp::ParameterType::PARAMETER_INTEGER) {
      return static_cast<double>(value.as_int());
    }
    return value.as_double();
  }
  return fallback;
}
bool point_in_polygon(double x, double y, const nav2_costmap_2d::Footprint & polygon) {
  bool inside=false;
  for (size_t i=0,j=polygon.size()-1;i<polygon.size();j=i++) {
    const auto & a=polygon[i];const auto & b=polygon[j];
    const double cross=(x-a.x)*(b.y-a.y)-(y-a.y)*(b.x-a.x);
    const double dot=(x-a.x)*(x-b.x)+(y-a.y)*(y-b.y);
    if (std::abs(cross)<1e-9 && dot<=0) {return true;}
    if (((a.y>y)!=(b.y>y)) &&
      x<(b.x-a.x)*(y-a.y)/(b.y-a.y)+a.x) {inside=!inside;}
  }
  return inside;
}
}  // namespace

BackupDistanceSelection select_backup_distance(
  double requested, double remaining_budget,
  const std::function<SafetyResult(double)> & check,
  double minimum, double step, double stopping_clearance)
{
  BackupDistanceSelection selection;selection.requested=requested;
  if (!std::isfinite(requested) || !std::isfinite(remaining_budget) ||
    !std::isfinite(minimum) || !std::isfinite(step) || !std::isfinite(stopping_clearance) ||
    requested<=0 || remaining_budget<=0 || minimum<=0 || step<=0 || stopping_clearance<0 || !check)
  {
    selection.result={false,"INVALID_PARAMETER","自适应倒车参数无效"};return selection;
  }
  const double limit=std::min({requested,remaining_budget,kMaxSingleBackupDistance});
  const int count=static_cast<int>(std::floor((limit-minimum+1e-9)/step));
  if (count<0) {
    selection.result={false,"BUDGET_EXHAUSTED","剩余倒车预算不足最短脱困距离"};return selection;
  }
  SafetyResult last{false,"NO_SAFE_DISTANCE","后方没有满足停车余量的短距离"};
  for (int i=count;i>=0;--i) {
    const double distance=minimum+i*step;
    auto result=check(distance+stopping_clearance);
    if (result.ok) {
      selection.ok=true;selection.selected=distance;
      selection.swept_distance=distance+stopping_clearance;selection.result=std::move(result);
      return selection;
    }
    last=std::move(result);
  }
  selection.result=std::move(last);return selection;
}

bool better_spin_candidate(
  const SpinCandidateEvaluation & candidate,
  const SpinCandidateEvaluation & current,
  int preferred_direction)
{
  if (!candidate.valid) {return false;}
  if (!current.valid) {return true;}
  const int candidate_bucket=static_cast<int>(std::floor((candidate.forward_clearance+1e-9)/0.05));
  const int current_bucket=static_cast<int>(std::floor((current.forward_clearance+1e-9)/0.05));
  if (candidate_bucket!=current_bucket) {return candidate_bucket>current_bucket;}
  if (std::abs(candidate.path_error-current.path_error)>1e-6) {
    return candidate.path_error<current.path_error;
  }
  if (std::abs(std::abs(candidate.angle)-std::abs(current.angle))>1e-6) {
    return std::abs(candidate.angle)<std::abs(current.angle);
  }
  const int candidate_direction=candidate.angle>=0?1:-1;
  const int current_direction=current.angle>=0?1:-1;
  if (candidate_direction==current_direction) {return false;}
  if (preferred_direction!=0) {return candidate_direction==preferred_direction;}
  return candidate_direction>0;  // 首次完全同分固定选左（正角）。
}

SensorCache::SensorCache(rclcpp::Node::SharedPtr node, rclcpp::CallbackGroup::SharedPtr group,
  const std::string & scan, const std::string & costmap, const std::string & footprint)
{
  rclcpp::SubscriptionOptions options;
  options.callback_group = group;
  costmap_sub_ = node->create_subscription<nav2_msgs::msg::Costmap>(costmap,
    rclcpp::QoS(1).reliable().transient_local(), [this](nav2_msgs::msg::Costmap::ConstSharedPtr msg) {
      std::lock_guard<std::mutex> lock(mutex_);
      data_.costmap = msg; data_.costmap_received = Steady::now(); ++data_.costmap_count;
    }, options);
  scan_sub_ = node->create_subscription<sensor_msgs::msg::LaserScan>(scan,
    rclcpp::SensorDataQoS().keep_last(1), [this](sensor_msgs::msg::LaserScan::ConstSharedPtr msg) {
      std::lock_guard<std::mutex> lock(mutex_);
      data_.scan = msg; data_.scan_received = Steady::now(); ++data_.scan_count;
    }, options);
  // Nav2 published_footprint 是 volatile 发布者，不要求 transient_local。
  footprint_sub_ = node->create_subscription<geometry_msgs::msg::PolygonStamped>(footprint,
    rclcpp::QoS(1).reliable().durability_volatile(), [this](geometry_msgs::msg::PolygonStamped::ConstSharedPtr msg) {
      std::lock_guard<std::mutex> lock(mutex_);
      data_.footprint = msg; data_.footprint_received = Steady::now(); ++data_.footprint_count;
    }, options);
}
SensorSnapshot SensorCache::snapshot() const {
  std::lock_guard<std::mutex> lock(mutex_); return data_;
}
bool fresh_stamp(const builtin_interfaces::msg::Time & stamp, const rclcpp::Time & now,
  TimePoint received, double age)
{
  if (received == TimePoint{} || !std::isfinite(age) || age <= 0) {return false;}
  const double elapsed = (now - rclcpp::Time(stamp, now.get_clock_type())).seconds();
  return ros_age_fresh(elapsed, age) && seconds(received) <= age;
}
HeadingReference heading_reference(const geometry_msgs::msg::PoseStamped & pose,
  const nav_msgs::msg::Path & path, const geometry_msgs::msg::PoseStamped & goal, double lookahead)
{
  HeadingReference ref;
  if (path.poses.empty() || path.header.frame_id != pose.header.frame_id) {return ref;}
  const double x=pose.pose.position.x, y=pose.pose.position.y;
  double best=std::numeric_limits<double>::infinity(), projection=0;
  size_t index=0;
  // 最近线段投影，避免采样到机器人身后的旧路径起点。
  for (size_t i=0; i+1<path.poses.size(); ++i) {
    const auto & a=path.poses[i].pose.position;
    const auto & b=path.poses[i+1].pose.position;
    double dx=b.x-a.x, dy=b.y-a.y, len2=dx*dx+dy*dy;
    double t=len2>1e-12 ? std::clamp(((x-a.x)*dx+(y-a.y)*dy)/len2,0.0,1.0) : 0;
    double d=std::hypot(x-a.x-t*dx,y-a.y-t*dy);
    if (d<best) {best=d; projection=t; index=i;}
  }
  auto target=path.poses.back().pose.position;
  double remaining=lookahead;
  for (size_t i=index; i+1<path.poses.size(); ++i) {
    const auto & a=path.poses[i].pose.position;
    const auto & b=path.poses[i+1].pose.position;
    double t=i==index ? projection : 0.0;
    double len=std::hypot(b.x-a.x,b.y-a.y);
    if (len*(1-t)>=remaining && len>1e-9) {
      t += remaining/len;
      target.x=a.x+t*(b.x-a.x); target.y=a.y+t*(b.y-a.y); break;
    }
    remaining -= len*(1-t);
  }
  ref.valid=true; ref.segment=index;
  if (std::hypot(path.poses.back().pose.position.x-x,path.poses.back().pose.position.y-y)<0.10 &&
    goal.header.frame_id==pose.header.frame_id) {
    ref.yaw=tf2::getYaw(goal.pose.orientation);
  } else {
    ref.yaw=std::atan2(target.y-y,target.x-x);
  }
  ref.error=normalize(ref.yaw-tf2::getYaw(pose.pose.orientation));
  ref.valid=std::isfinite(ref.yaw) && std::isfinite(ref.error);
  return ref;
}
bool scan_points_in_base(const sensor_msgs::msg::LaserScan & scan, tf2_ros::Buffer & tf,
  const std::string & base, std::vector<geometry_msgs::msg::Point> & points)
{
  if (scan.header.frame_id.empty() || scan.ranges.empty() ||
    !std::isfinite(scan.angle_min) || !std::isfinite(scan.angle_increment) ||
    scan.angle_increment==0 || !(scan.range_max>scan.range_min)) {return false;}
  try {
    auto transform=tf.lookupTransform(base,scan.header.frame_id,
      tf2_ros::fromRclcpp(rclcpp::Time(scan.header.stamp)));
    bool usable=false;
    for (size_t i=0;i<scan.ranges.size();++i) {
      double r=scan.ranges[i];
      if (std::isinf(r) && r>0) {usable=true;}
      if (!std::isfinite(r) || r<scan.range_min || r>scan.range_max) {continue;}
      usable=true;
      double a=scan.angle_min+i*scan.angle_increment;
      geometry_msgs::msg::PointStamped in,out;
      in.point.x=r*std::cos(a); in.point.y=r*std::sin(a);
      tf2::doTransform(in,out,transform); points.push_back(out.point);
    }
    return usable;
  } catch (const tf2::TransformException &) {return false;}
}
SafetyResult swept_pose_clear(const SensorSnapshot & d, tf2_ros::Buffer & tf,
  const rclcpp::Time & now, const std::string & base,
  double start_x, double start_y, double start_yaw,
  double end_x, double end_y, double end_yaw, double age)
{
  if (!d.scan || !d.costmap || !d.footprint || d.footprint->polygon.points.size()<3) {
    return {false,"DATA_MISSING","等待扫描、原始代价地图及真实包络"};
  }
  if (!fresh_stamp(d.scan->header.stamp,now,d.scan_received,age) ||
    !fresh_stamp(d.costmap->header.stamp,now,d.costmap_received,age) ||
    !fresh_stamp(d.footprint->header.stamp,now,d.footprint_received,age)) {
    return {false,"DATA_EXPIRED","消息时间戳或本地接收时间过期"};
  }
  const auto & md=d.costmap->metadata;
  if (!std::isfinite(md.resolution) || md.resolution<=0 || md.size_x==0 || md.size_y==0 ||
    md.size_x>10000 || md.size_y>10000 ||
    size_t(md.size_x)*md.size_y!=d.costmap->data.size() ||
    !std::isfinite(md.origin.position.x) || !std::isfinite(md.origin.position.y) ||
    !std::isfinite(start_x) || !std::isfinite(start_y) || !std::isfinite(start_yaw) ||
    !std::isfinite(end_x) || !std::isfinite(end_y) || !std::isfinite(end_yaw)) {
    return {false,"DATA_MISSING","代价地图元数据或扫掠参数无效"};
  }
  try {
    auto foot_tf=tf.lookupTransform(base,d.footprint->header.frame_id,
      tf2_ros::fromRclcpp(rclcpp::Time(d.footprint->header.stamp)));
    nav2_costmap_2d::Footprint footprint;
    double half_l=0,half_w=0;
    for (const auto & p : d.footprint->polygon.points) {
      geometry_msgs::msg::PointStamped in,out; in.point.x=p.x; in.point.y=p.y;
      tf2::doTransform(in,out,foot_tf);
      if (!std::isfinite(out.point.x) || !std::isfinite(out.point.y)) {
        return {false,"DATA_MISSING","包络包含非有限坐标"};
      }
      half_l=std::max(half_l,std::abs(out.point.x));
      half_w=std::max(half_w,std::abs(out.point.y));
      footprint.push_back(out.point);
    }
    if (half_l<0.01 || half_w<0.01 || half_l>2 || half_w>2) {
      return {false,"DATA_MISSING","包络尺寸无效"};
    }
    // Nav2 已经发布 padded footprint；增加半格余量避免离散步长漏掉格边障碍。
    nav2_costmap_2d::padFootprint(footprint,md.resolution*0.5);
    auto pose=tf.lookupTransform(d.costmap->header.frame_id,base,tf2::TimePointZero);
    if (pose.header.stamp.sec!=0 &&
      (now-rclcpp::Time(pose.header.stamp,now.get_clock_type())).seconds()>age) {
      return {false,"TF_UNAVAILABLE","车体 TF 已过期"};
    }
    // Costmap2D 为轴对齐格网，先把世界坐标转换到地图原点的局部坐标。
    double origin_yaw=tf2::getYaw(md.origin.orientation);
    if (!std::isfinite(origin_yaw)) {origin_yaw=0;}
    nav2_costmap_2d::Costmap2D map(md.size_x,md.size_y,md.resolution,0,0,0);
    std::copy(d.costmap->data.begin(),d.costmap->data.end(),map.getCharMap());
    nav2_costmap_2d::FootprintCollisionChecker<nav2_costmap_2d::Costmap2D*> checker(&map);
    const double yaw=tf2::getYaw(pose.transform.rotation);
    const double translation=std::hypot(end_x-start_x,end_y-start_y);
    const double rotation=std::abs(end_yaw-start_yaw);
    const int steps=std::max({1,int(std::ceil(translation/(md.resolution*0.5))),
      int(std::ceil(rotation/0.025))});
    // 倒车时忽略当前包络已压住的前方格子，只拦新进入的后方体积。
    const bool escape_rear=std::abs(start_x)<1e-9 && std::abs(start_y)<1e-9 &&
      std::abs(start_yaw)<1e-9 && end_x<0 && std::abs(end_y)<1e-9 && std::abs(end_yaw)<1e-9;
    std::unordered_set<uint64_t> start_cells;
    for (int i=0;i<=steps;++i) {
      double t=double(i)/steps;
      const double rx=start_x+(end_x-start_x)*t;
      const double ry=start_y+(end_y-start_y)*t;
      const double relative_yaw=start_yaw+(end_yaw-start_yaw)*t;
      double wx=pose.transform.translation.x+std::cos(yaw)*rx-std::sin(yaw)*ry;
      double wy=pose.transform.translation.y+std::sin(yaw)*rx+std::cos(yaw)*ry;
      wx-=md.origin.position.x; wy-=md.origin.position.y;
      double mx=std::cos(origin_yaw)*wx+std::sin(origin_yaw)*wy;
      double my=-std::sin(origin_yaw)*wx+std::cos(origin_yaw)*wy;
      nav2_costmap_2d::Footprint transformed;
      nav2_costmap_2d::transformFootprint(
        mx,my,yaw+relative_yaw-origin_yaw,footprint,transformed);
      std::vector<nav2_costmap_2d::MapLocation> polygon,cells;
      for (const auto & p : transformed) {
        nav2_costmap_2d::MapLocation loc;
        if (!map.worldToMap(p.x,p.y,loc.x,loc.y)) {
          return {false,"COSTMAP_OUT_OF_BOUNDS","完整包络扫掠越出局部地图"};
        }
        polygon.push_back(loc);
      }
      double outline=checker.footprintCost(transformed);
      map.convexFillCells(polygon,cells);
      if (i==0) {
        for (const auto & cell : cells) {
          // 只豁免车头边缘的既有致死格；车腹、后半部和未知格不可豁免。
          double cx,cy;map.mapToWorld(cell.x,cell.y,cx,cy);
          const double bx=std::cos(yaw-origin_yaw)*(cx-mx)+std::sin(yaw-origin_yaw)*(cy-my);
          if (escape_rear && bx>=half_l-md.resolution && map.getCost(cell.x,cell.y)==254) {
            start_cells.insert((uint64_t(cell.x)<<32)|cell.y);
          }
        }
      }
      for (const auto & cell : cells) {
        if (escape_rear && start_cells.count((uint64_t(cell.x)<<32)|cell.y)) {continue;}
        auto cost=map.getCost(cell.x,cell.y);
        if (cost==255) {return {false,"COSTMAP_UNKNOWN","扫掠区包含未知格"};}
        if (cost==254) {return {false,"COSTMAP_OBSTACLE","扫掠区包含致命障碍"};}
      }
      if (!escape_rear && outline>=254) {return {false,"COSTMAP_OBSTACLE","包络轮廓碰撞"};}
    }
    std::vector<geometry_msgs::msg::Point> points;
    if (!scan_points_in_base(*d.scan,tf,base,points)) {
      return {false,"TF_UNAVAILABLE","扫描格式或扫描时刻安装 TF 不可用"};
    }
    if (escape_rear) {
      for (const auto & p : points) {
        const bool in_y=p.y>=-half_w-0.02 && p.y<=half_w+0.02;
        if (in_y && p.x< -half_l+md.resolution && p.x>=end_x-half_l-0.02) {
          return {false,"SCAN_OBSTACLE","扫描点进入包络扫掠区"};
        }
      }
    } else {
      for (int i=0;i<=steps;++i) {
        const double t=double(i)/steps;
        const double rx=start_x+(end_x-start_x)*t;
        const double ry=start_y+(end_y-start_y)*t;
        const double relative_yaw=start_yaw+(end_yaw-start_yaw)*t;
        const double c=std::cos(relative_yaw),s=std::sin(relative_yaw);
        for (const auto & p : points) {
          const double px=c*(p.x-rx)+s*(p.y-ry);
          const double py=-s*(p.x-rx)+c*(p.y-ry);
          if (point_in_polygon(px,py,footprint)) {
            return {false,"SCAN_OBSTACLE","扫描点进入旋转或前进包络扫掠区"};
          }
        }
      }
    }
    return {true,"NONE","数据新鲜、TF 有效、完整包络扫掠通过"};
  } catch (const tf2::TransformException & e) {return {false,"TF_UNAVAILABLE",e.what()};}
}

SafetyResult swept_clear(const SensorSnapshot & d, tf2_ros::Buffer & tf,
  const rclcpp::Time & now, const std::string & base, double dx, double dy, double age)
{
  return swept_pose_clear(d,tf,now,base,0,0,0,dx,dy,0,age);
}

std::shared_ptr<RecoveryRuntime> RecoveryRuntime::get(const BT::NodeConfiguration & config)
{
  std::shared_ptr<RecoveryRuntime> runtime;
  if (config.blackboard->get("carcar_recovery_runtime",runtime)) {return runtime;}
  auto node=config.blackboard->get<rclcpp::Node::SharedPtr>("node");
  // 单目标/多目标是两个不同的 blackboard 节点；回调组不能跨节点复用。
  const std::string key=node->get_fully_qualified_name()+
    std::to_string(reinterpret_cast<uintptr_t>(node->get_node_base_interface().get()));
  static std::mutex registry_mutex;
  static std::map<std::string,std::weak_ptr<RecoveryRuntime>> registry;
  std::lock_guard<std::mutex> lock(registry_mutex);
  runtime=registry[key].lock();
  if (!runtime) {runtime=std::make_shared<RecoveryRuntime>(node); registry[key]=runtime;}
  config.blackboard->set("carcar_recovery_runtime",runtime);
  return runtime;
}
RecoveryRuntime::RecoveryRuntime(rclcpp::Node::SharedPtr n) : node(n),tf(n->get_clock())
{
  node->get_parameter_or("robot_base_frame",base_frame,base_frame);
  node->get_parameter_or("global_frame",global_frame,global_frame);
  node->get_parameter_or("odom_topic",odom_topic,odom_topic);
  if (!node->has_parameter("recovery.require_perception_health")) {
    node->declare_parameter("recovery.require_perception_health",false);
  }
  node->get_parameter_or("recovery.require_perception_health",require_perception_,false);
  response_timeout=parameter(node,"recovery.response_timeout",1);
  cancel_timeout=parameter(node,"recovery.cancel_timeout",1);
  settle_timeout=parameter(node,"recovery.settle_timeout",1);
  still_duration=parameter(node,"recovery.still_duration",0.4);
  data_age=parameter(node,"recovery.max_data_age",0.5);
  input_wait_timeout=parameter(node,"recovery.input_wait_timeout",3.0);
  input_healthy_duration=parameter(node,"recovery.input_healthy_duration",0.4);
  recovery_timeout=parameter(node,"recovery.total_timeout",90);
  backup_cooldown=parameter(node,"recovery.backup_cooldown",12);
  auto observe_replans=parameter(node,"recovery.max_observe_replans",1);
  for (double v : {response_timeout,cancel_timeout,settle_timeout,still_duration,data_age,
      recovery_timeout,input_wait_timeout,input_healthy_duration}) {
    if (!std::isfinite(v) || v<=0) {throw std::invalid_argument("恢复时限必须为正有限数");}
  }
  if (input_healthy_duration>=input_wait_timeout) {
    throw std::invalid_argument("输入连续健康时长必须小于等待上限");
  }
  if (!std::isfinite(backup_cooldown) || backup_cooldown<0) {
    throw std::invalid_argument("倒车冷却必须为非负有限数");
  }
  if (!std::isfinite(observe_replans) || observe_replans<0 || observe_replans>3 ||
      std::floor(observe_replans)!=observe_replans) {
    throw std::invalid_argument("停车观察重规划次数必须是 0 到 3 的整数");
  }
  max_observe_replans=static_cast<unsigned>(observe_replans);
  group=node->create_callback_group(rclcpp::CallbackGroupType::MutuallyExclusive,false);
  executor_=std::make_shared<rclcpp::executors::SingleThreadedExecutor>();
  executor_->add_callback_group(group,node->get_node_base_interface());
  listener_=std::make_unique<tf2_ros::TransformListener>(tf);
  rclcpp::SubscriptionOptions options; options.callback_group=group;
  health_sub_=node->create_subscription<std_msgs::msg::Bool>("/localization_monitor/ready",
    rclcpp::QoS(1).reliable().transient_local(),[this](std_msgs::msg::Bool::ConstSharedPtr msg) {
      std::lock_guard<std::mutex> lock(mutex_);
      ready_.received=true; ready_.value=msg->data; ready_.received_at=Steady::now();
    },options);
  perception_sub_=node->create_subscription<std_msgs::msg::Bool>(
    "/navigation/perception_motion_allowed",rclcpp::QoS(1).reliable().transient_local(),
    [this](std_msgs::msg::Bool::ConstSharedPtr msg) {
      std::lock_guard<std::mutex> lock(mutex_);
      perception_.received=true;perception_.value=msg->data;perception_.received_at=Steady::now();
    },options);
  recovery_allowed_sub_=node->create_subscription<std_msgs::msg::Bool>("/localization_monitor/recovery_allowed",
    rclcpp::QoS(1).reliable().transient_local(),[this](std_msgs::msg::Bool::ConstSharedPtr msg) {
      std::lock_guard<std::mutex> lock(mutex_);
      recovery_allowed_.received=true; recovery_allowed_.value=msg->data;
      recovery_allowed_.received_at=Steady::now();
    },options);
  odom_sub_=node->create_subscription<nav_msgs::msg::Odometry>(odom_topic,
    rclcpp::QoS(1).best_effort(),[this](nav_msgs::msg::Odometry::ConstSharedPtr msg) {
      std::lock_guard<std::mutex> lock(mutex_);
      bool gap=odom_received_==TimePoint{} || seconds(odom_received_)>data_age;
      odom_=msg; odom_received_=Steady::now();
      const auto & v=msg->twist.twist;
      bool stopped=std::hypot(v.linear.x,v.linear.y)<0.01 && std::abs(v.angular.z)<0.02;
      if (!stopped || gap) {still_since_=TimePoint{};}
      if (stopped && still_since_==TimePoint{}) {still_since_=Steady::now();}
    },options);
  pose_feedback_=node->create_subscription<nav2_msgs::action::NavigateToPose_FeedbackMessage>(
    "/navigate_to_pose/_action/feedback",rclcpp::QoS(1).best_effort(),[this](nav2_msgs::action::NavigateToPose_FeedbackMessage::ConstSharedPtr msg) {
      observe_uuid(uuid_text(msg->goal_id.uuid),false);
    },options);
  through_feedback_=node->create_subscription<nav2_msgs::action::NavigateThroughPoses_FeedbackMessage>(
    "/navigate_through_poses/_action/feedback",rclcpp::QoS(1).best_effort(),[this](nav2_msgs::action::NavigateThroughPoses_FeedbackMessage::ConstSharedPtr msg) {
      observe_uuid(uuid_text(msg->goal_id.uuid),true);
    },options);
  permit_pub_=node->create_publisher<std_msgs::msg::UInt64>("/navigation/motion_permit",rclcpp::QoS(1));
  diag_pub_=node->create_publisher<diagnostic_msgs::msg::DiagnosticStatus>("/recovery/status",rclcpp::QoS(10));
  sensors();
  diag_timer_=node->create_wall_timer(std::chrono::seconds(1),[this] {
    publish_recovery_status();
  },group);
  thread_=std::make_unique<nav2_util::NodeThread>(executor_);
  // Humble NodeThread 的 cancel 可能先于 spin()；后启动的 spin 会重新置
  // spinning=true，使立即析构的 join 永久等待。构造完成前确认执行器已进入运行。
  while (rclcpp::ok(node->get_node_base_interface()->get_context()) &&
    !executor_->is_spinning()) {
    std::this_thread::sleep_for(std::chrono::milliseconds(1));
  }
}
RecoveryRuntime::~RecoveryRuntime() {
  permit(false);
  if (motion) {motion->cancel();}
  for (auto & session : retiring) {session->cancel();}
  thread_.reset(); // 回调彻底停止后，才允许成员缓存与订阅析构。
  motion.reset(); retiring.clear();
}
std::shared_ptr<SensorCache> RecoveryRuntime::sensors(const std::string & scan,
  const std::string & costmap,const std::string & footprint)
{
  const std::string key=scan+"|"+costmap+"|"+footprint;
  auto it=caches_.find(key);
  if (it==caches_.end()) {
    it=caches_.emplace(key,std::make_shared<SensorCache>(node,group,scan,costmap,footprint)).first;
  }
  return it->second;
}
bool RecoveryRuntime::healthy() const {return localization_ready().healthy();}
HealthSample RecoveryRuntime::localization_ready() const {
  std::lock_guard<std::mutex> lock(mutex_); return ready_;
}
HealthSample RecoveryRuntime::recovery_allowed() const {
  std::lock_guard<std::mutex> lock(mutex_); return recovery_allowed_;
}
void RecoveryRuntime::note_tick() {
  std::lock_guard<std::mutex> lock(mutex_); last_bt_tick_=Steady::now();
}
bool RecoveryRuntime::odom_fresh() const {
  std::lock_guard<std::mutex> lock(mutex_);
  return odom_ && fresh_stamp(odom_->header.stamp,node->now(),odom_received_,data_age);
}
bool RecoveryRuntime::still(double duration) const {
  std::lock_guard<std::mutex> lock(mutex_);
  return odom_ && fresh_stamp(odom_->header.stamp,node->now(),odom_received_,data_age) &&
    still_since_!=TimePoint{} && seconds(still_since_)>=duration;
}
void RecoveryRuntime::restart_stillness() {
  std::lock_guard<std::mutex> lock(mutex_); still_since_=TimePoint{};
}
nav_msgs::msg::Odometry::ConstSharedPtr RecoveryRuntime::odom() const {
  std::lock_guard<std::mutex> lock(mutex_); return odom_;
}
void RecoveryRuntime::observe_uuid(const std::string & id,bool through) {
  std::lock_guard<std::mutex> lock(mutex_);
  auto & current=through ? through_uuid_ : pose_uuid_;
  if (std::find(retired_ids_.begin(),retired_ids_.end(),id)!=retired_ids_.end()) {return;}
  if (id!=current) {
    if (!current.empty()) {retired_ids_.push_back(current);}
    current=id;
  }
}
std::string RecoveryRuntime::goal_uuid(bool through) const {
  std::lock_guard<std::mutex> lock(mutex_); return through ? through_uuid_ : pose_uuid_;
}
bool RecoveryRuntime::pose(geometry_msgs::msg::PoseStamped & result,const std::string & frame) {
  try {
    auto t=tf.lookupTransform(frame.empty()?global_frame:frame,base_frame,tf2::TimePointZero);
    if (t.header.stamp.sec!=0 && (node->now()-rclcpp::Time(t.header.stamp)).seconds()>data_age) {return false;}
    result.header=t.header; result.pose.orientation=t.transform.rotation;
    result.pose.position.x=t.transform.translation.x; result.pose.position.y=t.transform.translation.y;
    return true;
  } catch (const tf2::TransformException &) {return false;}
}
bool RecoveryRuntime::perception_ready() const {
  std::lock_guard<std::mutex> lock(mutex_);
  return !require_perception_ || (perception_.fresh(0.30) && perception_.value);
}
SafetyResult RecoveryRuntime::inputs_ready() {
  auto failure=[&](const std::string & code,const std::string & topic,
      const std::string & detail,double stamp_age=-1,double receive_age=-1) {
    std::lock_guard<std::mutex> lock(mutex_);
    failed_input_topic_=topic;failed_input_reason_=code;
    failed_stamp_age_=stamp_age;failed_receive_age_=receive_age;
    return SafetyResult{false,code,detail};
  };
  auto stale=[&](const auto & msg,TimePoint received) {
    return !msg || !fresh_stamp(msg->header.stamp,node->now(),received,data_age);
  };
  auto age=[&](const auto & msg) {
    return msg?(node->now()-rclcpp::Time(msg->header.stamp)).seconds():-1.0;
  };
  auto received_age=[](TimePoint received) {return received==TimePoint{}?-1.0:seconds(received);};
  if (!perception_ready()) {
    return failure("PERCEPTION_UNHEALTHY","/navigation/perception_motion_allowed",
      "深度感知未就绪或心跳过期");
  }
  if (!healthy()) {
    const auto health=localization_ready();
    return failure("LOCALIZATION_UNHEALTHY","/localization_monitor/ready",
      "定位门控未就绪或过期",-1,received_age(health.received_at));
  }
  nav_msgs::msg::Odometry::ConstSharedPtr odom_msg;TimePoint odom_received;
  {std::lock_guard<std::mutex> lock(mutex_);odom_msg=odom_;odom_received=odom_received_;}
  if (stale(odom_msg,odom_received)) {
    return failure("ODOM_EXPIRED",odom_topic,"轮式里程计缺失或过期",
      age(odom_msg),received_age(odom_received));
  }
  auto d=sensors()->snapshot();
  for (const auto & result : {
      std::make_pair(stale(d.scan,d.scan_received),std::string("/scan")),
      std::make_pair(stale(d.costmap,d.costmap_received),std::string("/local_costmap/costmap_raw")),
      std::make_pair(stale(d.footprint,d.footprint_received),std::string("/local_costmap/published_footprint"))}) {
    if (!result.first) {continue;}
    bool missing=false;double stamp_age=-1,receive_age=-1;
    if (result.second=="/scan") {
      missing=!d.scan;stamp_age=age(d.scan);receive_age=received_age(d.scan_received);
    } else if (result.second=="/local_costmap/costmap_raw") {
      missing=!d.costmap;stamp_age=age(d.costmap);receive_age=received_age(d.costmap_received);
    } else {
      missing=!d.footprint;stamp_age=age(d.footprint);receive_age=received_age(d.footprint_received);
    }
    return failure(missing?"DATA_MISSING":"DATA_EXPIRED",result.second,
      missing?"恢复输入尚未齐备":"恢复输入已过期",stamp_age,receive_age);
  }
  geometry_msgs::msg::PoseStamped p;
  if (!pose(p)) {return failure("TF_UNAVAILABLE","/tf","导航车体 TF 不可用");}
  std::vector<geometry_msgs::msg::Point> points;
  if (!scan_points_in_base(*d.scan,tf,base_frame,points) ||
    d.footprint->polygon.points.size()<3 || d.costmap->metadata.resolution<=0 ||
    size_t(d.costmap->metadata.size_x)*d.costmap->metadata.size_y!=d.costmap->data.size() ||
    d.costmap->data.empty()) {
    return failure("DATA_INVALID","/scan,/local_costmap/costmap_raw,/local_costmap/published_footprint",
      "扫描 TF、包络或地图格式无效");
  }
  try {
    tf.lookupTransform(base_frame,d.footprint->header.frame_id,
      tf2_ros::fromRclcpp(rclcpp::Time(d.footprint->header.stamp)));
    tf.lookupTransform(d.costmap->header.frame_id,base_frame,tf2::TimePointZero);
  } catch (const tf2::TransformException &) {return failure("TF_UNAVAILABLE","/tf","包络或地图 TF 不可用");}
  // 保留最近一次失败输入证据，健康恢复后仍能解释本次停车。
  return {true,"NONE","定位、传感器与里程计就绪"};
}
void RecoveryRuntime::permit(bool allowed) {
  std_msgs::msg::UInt64 msg; msg.data=allowed && !fault ? action_sequence : 0;
  if (permit_pub_) {permit_pub_->publish(msg);}
}
void RecoveryRuntime::diagnostic(const std::string & phase,const std::string & reason) {
  DiagSnapshot snap;
  {
    std::lock_guard<std::mutex> lock(mutex_);
    if (phase+reason==last_diag_key_ && last_diag_!=TimePoint{} && seconds(last_diag_)<1) {return;}
    last_diag_=Steady::now(); last_diag_key_=phase+reason;
    snap.phase=phase; snap.reason=reason; snap.fault=fault; snap.epoch=epoch;
    snap.navigation_uuid=navigation_uuid; snap.previous_navigation_uuid=previous_navigation_uuid;
    snap.backup_used=backup_used;
    snap.observe_replans_used=observe_replans_used;
    snap.max_observe_replans=max_observe_replans;
    snap.recovery_elapsed=recovery_active?seconds(recovery_started):0;
    snap.recovery_deadline=recovery_timeout; snap.last_bt_tick=last_bt_tick_;
    snap.motion=motion;
    snap.failed_topic=failed_input_topic_;
    snap.failed_reason=failed_input_reason_;
    snap.stamp_age=failed_stamp_age_;snap.receive_age=failed_receive_age_;
    diag_snapshot_=snap;
  }
  emit_recovery_status(std::move(snap));
}
void RecoveryRuntime::publish_recovery_status() {
  DiagSnapshot snap;
  {
    std::lock_guard<std::mutex> lock(mutex_);
    if (last_bt_tick_==TimePoint{} || diag_snapshot_.phase.empty()) {return;}
    snap=diag_snapshot_;
    snap.last_bt_tick=last_bt_tick_;
  }
  emit_recovery_status(std::move(snap));
}
void RecoveryRuntime::emit_recovery_status(DiagSnapshot snap) {
  diagnostic_msgs::msg::DiagnosticStatus msg;
  msg.name="RecoverySupervisor"; msg.hardware_id="carcar_nav_bt_nodes";
  msg.level=snap.fault?2:0; msg.message=snap.phase;
  auto add=[&](std::string key,std::string value) {
    diagnostic_msgs::msg::KeyValue kv; kv.key=key; kv.value=value; msg.values.push_back(kv);
  };
  add("phase",snap.phase); add("reason_code",snap.reason); add("epoch",std::to_string(snap.epoch));
  add("failed_input_topic",snap.failed_topic);
  add("input_trigger_reason",snap.failed_reason);
  add("failed_stamp_age_s",std::to_string(snap.stamp_age));
  add("failed_receive_age_s",std::to_string(snap.receive_age));
  add("input_max_age_s",std::to_string(data_age));
  add("input_wait_timeout_s",std::to_string(input_wait_timeout));
  add("input_healthy_duration_s",std::to_string(input_healthy_duration));
  add("recovery_destination",snap.phase=="INPUT_WAIT"?"WAIT_FOR_INPUT":
    (snap.phase=="INPUT_RECOVERED"?"REPLAN":snap.phase));
  add("navigation_uuid",snap.navigation_uuid);add("previous_navigation_uuid",snap.previous_navigation_uuid);
  add("backup_reserved",std::to_string(snap.backup_used));
  add("observe_replans_used",std::to_string(snap.observe_replans_used));
  add("max_observe_replans",std::to_string(snap.max_observe_replans));
  add("recovery_elapsed",std::to_string(snap.recovery_elapsed));
  add("recovery_deadline_s",std::to_string(snap.recovery_deadline));
  add("bt_tick_age_s",snap.last_bt_tick==TimePoint{}?"0":std::to_string(seconds(snap.last_bt_tick)));
  auto d=sensors()->snapshot();
  add("scan_count",std::to_string(d.scan_count)); add("costmap_count",std::to_string(d.costmap_count));
  add("footprint_count",std::to_string(d.footprint_count));
  if (snap.motion) {
    auto s=snap.motion->state(); add("action_uuid",s.uuid); add("action_elapsed",std::to_string(s.elapsed));
    add("action_revision",std::to_string(s.revision));
    add("response_remaining_s",std::to_string(s.response_remaining));
    add("result_remaining_s",std::to_string(s.result_remaining));
    add("cancel_remaining_s",std::to_string(s.cancel_remaining));
    add("cancel_state",s.cancel_requested?(s.cancel_ack?"ACKNOWLEDGED":"REQUESTED"):"NONE");
  }
  diag_pub_->publish(msg);
}
void RecoveryRuntime::fail(const std::string & reason) {
  fault=true; fault_reason=reason; permit(false); diagnostic("FAILED",reason);
}
void RecoveryRuntime::reset_for_new_task(const std::string & uuid) {
  permit(false);
  {
    std::lock_guard<std::mutex> lock(mutex_);
    failed_input_topic_.clear();failed_input_reason_.clear();
    failed_stamp_age_=failed_receive_age_=-1;
  }
  if (navigation_uuid!=uuid) {
    previous_navigation_uuid=navigation_uuid;
    navigation_uuid=uuid;
  }
  fault=false;fault_reason.clear();
  backup_used=0;forward_distance=0;spin_used=false;recovery_active=false;
  replan_required=true;preferred_spin_direction=0;escape_stage=0;observe_replans_used=0;
  observe_started=TimePoint{};recovery_started=TimePoint{};last_backup_at_=TimePoint{};
  last_backup_ok_=true;
  motion.reset();
  ++epoch;
  diagnostic("TASK_START_READY","NEW_TASK_RESET");
}
void RecoveryRuntime::begin_recovery() {
  if (!recovery_active) {recovery_active=true; recovery_started=Steady::now(); forward_distance=0;}
}
void RecoveryRuntime::forward_progress(double distance) {
  if (!std::isfinite(distance)) {return;}
  forward_distance=std::max(0.0,forward_distance+distance);
  if (forward_distance>=0.20) {
    backup_used=0; spin_used=false; escape_stage=0; observe_replans_used=0;
    preferred_spin_direction=0;
    observe_started=TimePoint{};
    forward_distance=0; recovery_active=false;
  }
}
bool RecoveryRuntime::reserve_backup(double distance) {
  if (!std::isfinite(distance) || distance<=0 ||
      distance>kMaxSingleBackupDistance+1e-6 ||
      backup_used+distance>kMaxBackupBudget+1e-6) {return false;}
  backup_used+=distance; forward_distance=0; return true;
}
void RecoveryRuntime::release_backup(double distance) {backup_used=std::max(0.0,backup_used-distance);}
void RecoveryRuntime::reconcile_backup(double reserved,double traveled,bool odom_reliable) {
  if (!std::isfinite(reserved) || reserved<=0) {return;}
  if (!odom_reliable || !std::isfinite(traveled) || traveled<0) {return;}
  backup_used=std::max(0.0,backup_used-reserved)+std::min(reserved,traveled);
}
void RecoveryRuntime::note_backup(bool succeeded)
{
  last_backup_at_=Steady::now();
  last_backup_ok_=succeeded;
}
bool RecoveryRuntime::backup_cooling() const {
  if (backup_cooldown<=0 || last_backup_at_==TimePoint{} || seconds(last_backup_at_)>=backup_cooldown) {
    return false;
  }
  // 成功或失败后都冷却：回到跟随后不要立刻再倒，改走绕行路径或受控转向。
  return true;
}
bool RecoveryRuntime::request_observe_replan()
{
  if (observe_replans_used>=max_observe_replans) {return false;}
  ++observe_replans_used;
  // 下一次若再次进入停车观察，重新给完整观察窗口；次数仍由上面的额度限制。
  observe_started=TimePoint{};
  return true;
}
}  // namespace carcar_navigation
