tfsvh69-blip/Nav2_car/src/carcar_camera/src/depth_target_window.cpp

#include <algorithm>
#include <array>
#include <chrono>
#include <cmath>
#include <filesystem>
#include <fstream>
#include <iomanip>
#include <memory>
#include <stdexcept>
#include <string>
#include <rclcpp/rclcpp.hpp>
#include <sensor_msgs/msg/point_cloud2.hpp>
#include <sensor_msgs/point_cloud2_iterator.hpp>
#include <tf2/LinearMath/Transform.h>
#include <tf2_geometry_msgs/tf2_geometry_msgs.hpp>
#include <tf2_ros/buffer.h>
#include <tf2_ros/transform_listener.h>

// 手动启动的只读小目标取证：记录原始/过滤点云同一车体ROI，不发布或控制硬件。
// 点数阈值只用于比较，必须结合空场基线、现场位置和独立健康窗口解释。
class DepthTargetWindow : public rclcpp::Node
{
  using Steady = std::chrono::steady_clock;
public:
  DepthTargetWindow() : Node("depth_target_window"), buffer_(get_clock()), listener_(buffer_)
  {
    output_ = declare_parameter<std::string>("output_dir", "/tmp/depth_target_window");
    duration_ = declare_parameter("duration_s", 60.0);
    center_x_ = declare_parameter("center_x", 0.65);
    center_y_ = declare_parameter("center_y", 0.0175);
    half_width_ = declare_parameter("half_width", 0.035);
    min_z_ = declare_parameter("min_z", 0.01);
    max_z_ = declare_parameter("max_z", 0.04);
    max_age_ = declare_parameter("max_age_s", 0.5);
    if (!std::isfinite(duration_) || duration_ < 10 || duration_ > 600 ||
      !std::isfinite(center_x_) || !std::isfinite(center_y_) ||
      !std::isfinite(half_width_) || half_width_ <= 0 || half_width_ > 0.2 ||
      !std::isfinite(min_z_) || !std::isfinite(max_z_) || min_z_ >= max_z_ ||
      !std::isfinite(max_age_) || max_age_ <= 0)
    {throw std::invalid_argument("Invalid target ROI or duration");}
    std::filesystem::create_directories(output_);
    if (!std::filesystem::is_empty(output_)) {
      throw std::invalid_argument("Use a new output directory");
    }
    file_.open(output_ + "/frames.csv");
    file_ << std::setprecision(12)
          << "phase,source,receive_s,stamp_sec,stamp_ns,age_s,gap_s,usable,roi_points,"
          << "min_z,max_z,processing_ms\n";
    for (size_t i = 0; i < streams_.size(); ++i) {
      subscriptions_[i] = create_subscription<sensor_msgs::msg::PointCloud2>(
        i == 0 ? "/camera/depth/points" : "/camera/navigation/obstacles",
        rclcpp::SensorDataQoS().keep_last(1),
        [this, i](sensor_msgs::msg::PointCloud2::ConstSharedPtr msg) {capture(i, *msg);});
    }
    initial_ = started_ = Steady::now();
    timer_ = create_wall_timer(std::chrono::milliseconds(100), [this]() {
        if (!armed_ && seconds(Steady::now(), initial_) >= 15) {
          finish();
          rclcpp::shutdown();
        } else if (armed_ && seconds(Steady::now(), started_) >= duration_) {
          complete_ = true;
          finish();
          rclcpp::shutdown();
        }
      });
  }
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
