tfsvh69-blip/Nav2_car/(commit log)

2026-09-02 初始提交：巡检小车工作空间
2026-09-02 底盘：实现控制板通信与电机驱动
    [carcar.urdf.xacro, motor_test.yaml]
2026-09-03 雷达：完成 Humble 驱动迁移与 RViz 测试
2026-09-06 底盘：完成四轮麦克纳姆硬件与模型整合
    新增 Rosmaster ros2_control 硬件组件、四轮安全测试入口和编码器反馈支持。
    按实测轮位与几何更新机器人描述、RViz 模型和第三方资源声明，并修正零速看门狗状态。
    整合中文硬件台账、历史测试、TF 测量要求及导航、D435 回充和 Web 产品化路线。
    [carcar.urdf.xacro, command_locked_controllers.yaml, diff_drive_test_controllers.yaml, four_motor_test_controllers.yaml, mecanum_wheel_left.stl, mecanum_wheel_right.stl, read_only_controllers.yaml, rosmaster_command_test.urdf.xacro]
2026-09-06 docs: 明确分阶段 IMU 融合策略
2026-09-08 底盘：配置电机底层驱动与闭环 PID 参数
    配置好了电机底层驱动，以及 PID 已经调节到一个合适的参数里面去。
    [camera_direct_mount.stl, camera_lower_mount.stl, carcar.urdf.xacro, carcar_chassis.xacro, carcar_dimensions.xacro, carcar_materials.xacro, carcar_sensors.xacro, carcar_upper_structure.stl]
2026-09-11 导航：完成 SLAM 建图与 Nav2 导航栈链路搭建 (V1.6)
    【与 V1.5 版本的区别】
    1. 轮式里程计与底盘标定 (ODOM-001 / ENCODER-004)：
    - 完成四轮各 10 圈编码器精确标定 (~1319 count/rev)，支持累计脉冲与正向航位推算；
    - 纯轮式里程计稳定发布 /wheel/odometry 与 odom->base_footprint TF，通过前进 1m、自转 360° 及静止零漂移验收。
    2. SLAM Toolbox 激光建图 (NAV-001 / NAV-002)：
    - 贯通 map->odom->base_footprint->base_link->laser_frame 完整 TF 树；
    - 完成实车受控低速建图与 360° 回访闭合验证（闭合误差 3.77 cm），生成并保存静态地图 nav002_20260909_164237。
    3. Nav2 静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
2026-09-14 导航：实现动态障碍物自动重规划避障，新增终端状态监控与会话录包系统 (V1.7)
    - 动态避障与路径重规划：开启实验全局代价膨胀层 (enabled: true, radius: 0.30m, scale: 5.0)，解决路径紧贴障碍边缘导致 26cm 车身无法通过的问题；原路径遇突发动态障碍物时自动向空旷侧重规划安全绕行路径；
    - 终端状态与会话归档系统：停用不稳定且依赖 GUI 的 Groot 1，实现 C++ nav_event_logger 1Hz 终端中文状态摘要、阶段流转即时告警及 log/nav_sessions/ 目录自动落盘（含 1GB 分卷 SQLite3 rosbag2、10GB/2GB 磁盘防护）；
    - 结构化诊断与分析工具：RearClear 节点向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
    [carcar_nav_bt_nodes.cpp, check_map_reload.cpp, check_nav_link.cpp, localization_monitor.cpp, nav_event_logger.cpp, nav_log_tool.cpp]
2026-09-17 整机：声光指示接口、统一 XML 启动体系与恢复监督/停车归因完善 (V2.0)
    以 Ubuntu 主机开发阶段的最后一次版本；此后代码转为适配主板实机联调。
    功能要点：
    1. 声光指示器（DRV-004）：新增 carcar_interfaces 包与 IndicatorCommand.msg，
    实现控制板板载蜂鸣器与外接 RGB 全彩灯带通信驱动，配套独立 C++ 测试节点
    与 XML Launch；实机通过（低亮度 30/255 稳定发光，100ms 蜂鸣与单色循环正常）；
    2. 导航声光提示（NAV-014）：操作员灯光收敛为 5 种（OFF、NAV_CYAN、NAV_CYAN_SLOW_FLASH、
    FAIL_RED、LOST_FLASH），到达与失败各短鸣一次，其余静音；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
    [bounded_action.hpp, carcar_nav_bt_nodes.cpp, goal_status_policy.hpp, motion_gate.hpp, nav012_nodes.cpp, nav_event_logger.cpp, nav_log_tool.cpp]
2026-09-17 联调：实验定位默认关闭板载 RViz，改为 Ubuntu 主机轻量显示
    V2.0 已冻结主机改为 Ubuntu 开发之前的最后一次快照。此后车上继续跑导航，
    电脑只负责 RViz。将 localization_experimental.launch.xml 的 use_rviz
    默认改为 false，并在操作手册第 19 节写明同一 Wi‑Fi、域号 31 与
    navigation_lite.rviz 的主机步骤。未改 x11vnc 服务、固件或串口。
2026-09-20 导航：形成基本可用的规划、避障与受保护恢复链路
    已具备建图定位、单点导航、动态重规划、受保护倒车、恢复监督和导航日志。最新实机多数任务能够成功到达，但突发障碍下仍可能出现重复转向、等待和倒车，相关流程仍有优化空间。
2026-09-20 导航：稳定突发障碍绕行并优化 RViz 与诊断
    实验行为树每秒检查路径并最多保持有效路径 5 秒，路径失效、目标变化或恢复结束后重新规划。ProgressGuard 使用固定参考窗口和轮式里程计前向进展，路径版本变化不再刷新转向预算。
    轻量 RViz 使用 0.04 m/0.05 m Billboard 路径；日志增加转向进展字段、按倒车 Action UUID 去重，并补全 rosbag2 序列化格式。同步更新操作手册、项目路线与 NAV-012-R7 离线测试记录。
    离线构建与测试通过；Hao 免密 SSH 和 RViz 配置加载已验证。突发障碍绕行效果仍待实机重复验收。
2026-09-21 文档：取消 RViz 修改前的逐项确认要求
    允许根据项目现状直接优化 RViz 配置，交付时仍需向用户列出显示组件、话题、Fixed Frame 与 QoS。
2026-09-21 文档：同步导航转向评审与 SSH 录包现状
    明确 90°/10 秒只限制恢复转向，实车复测前不调整；记录 RViz 配置管理方式、rosbag2 可读验证和 Hao 到 Jetson 免密 SSH 已完成。
2026-09-21 导航：持续录制证据并优化受保护恢复
    取消专项录包的默认总时长与总量上限，增加独立分卷和磁盘余量保护。受保护倒车按后方净空自适应选择短距离，恢复转向比较左右完整扫掠与转后前进空间，恢复结束强制重规划；实验地图和路径检查提升至 3 Hz。
2026-09-21 导航：增加 State Lattice 独立规划对照
    复用实验导航公共入口，只覆盖 Humble 1.1.20 的 SmacPlannerLattice 和官方差速样例原语。日常 Smac 2D、DWB、速度与恢复保持不变，反向扩展和平滑默认关闭。
2026-09-21 定位：准备轮速与陀螺仪 EKF 对照入口
    增加默认关闭的 robot_localization 配置、IMU 角速度 Z 零偏校准节点和统一里程计来源入口。同步记录持续录包、自适应恢复、State Lattice 与 EKF 的验证边界和分阶段实车流程；官方 EKF 包尚待现场安装。
2026-09-21 文档：记录 Lattice 合成规划证据
    补充全空闲合成地图上的真实插件激活与路径请求结果，并明确原地旋转结构已生成、DWB 闭环跟随仍待验证。
2026-09-21 文档：补充 Lattice 控制器接口验证
    记录真实 Rotation Shim 与 DWB 接受 Lattice 路径并输出起始旋转命令的离线证据，同时保留完整闭环跟随和实车效果待验证边界。
2026-09-21 文档：收敛导航 R8 当前入口与验证边界
    将文档索引切换到操作手册第 20 节，清理测试速览中的旧 NAV-013 重复项，并同步 Lattice 控制器接口证据、EKF 默认关闭状态和 R8 已实现内容。
2026-09-23 导航：优化恢复动作衔接并新增 0.30 m/s 实验档
    NAV-012-R9。功能框架与 V2.1 基本一致，主要调整导航行为与实车运行体验。
    改动集中在行为树、恢复监督节点及实验配置，不改变整体架构。
    1. 恢复动作衔接（修「左右摆头后才开始倒车」）
    - RecoverySupervisor 在旧故障判定前，先识别行为树从 IDLE 重新执行与新 Action UUID，
    作为新任务启动屏障：先撤销运动许可，等旧运动进入终态、取得 0.4 s 新鲜静止证据，
    并确认定位/里程计/雷达/代价地图/TF 健康，再清除旧故障并重置该任务的倒车、
    转向、观察重规划与 90 s 恢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
2026-10-01 D435 深度体素接入与 PCL 离群点影子对照
    - 独立 B Costmap 静止标障/清障：中央、左、右低盒各有有效样本
    - 新增 PCL RadiusOutlierRemoval 影子节点（手动启动、不接管地图）
    - 操作手册新增第 30.9/30.10 节；RViz 增加绿色影子预览
    - bao 主机 RViz 联调、深度灰度图显示、Fast DDS 域 31 跨机通信
    - 测试记录 R13 位置修正；15 项 carcar_camera 测试全部通过
    - 黄色体素偶现空地闪烁散点，根因待定位（缺逐帧蓝点/二维格证据）
    [camera_servo_left_foot.stl, camera_servo_right_foot.stl, camera_tilt_bracket.stl, carcar.urdf.xacro, carcar_chassis.xacro, carcar_dimensions.xacro, carcar_materials.xacro, carcar_sensors.xacro]
2026-10-08 D435接入Nav2：STVL基础障碍识别、局部代价地图与静止联调
    保留原生宽视场深度点云，加入多帧确认与STVL 2.3.4体素记忆，提供静止地图和Nav2双地图实验入口。
    补充C++感知监督、失联速度联锁、行为树等待恢复、离线审计和真实进程回归；修复导航后台线程退出竞争。
    完善XML启动、94档地面一致性候选及舵机下发记录，跨机RViz点云、等大三图和RGB配准参照，当前刷新上限固定100。
    同步中文操作手册、测试记录、硬件台账和现场评价：基本识别/体素/局部地图视觉效果较好，普通盒保持、自然撤障及600秒健康通过。
    保留空地误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
2026-10-20 完成了上位机及 UI，现在测试可以正常建图，巡检这边还没有测试。
